Alex-Electron/ZX_BulbuLator/README.md

# ZX BulbuLator

Languages: **English** · [Русский](README.ru.md)

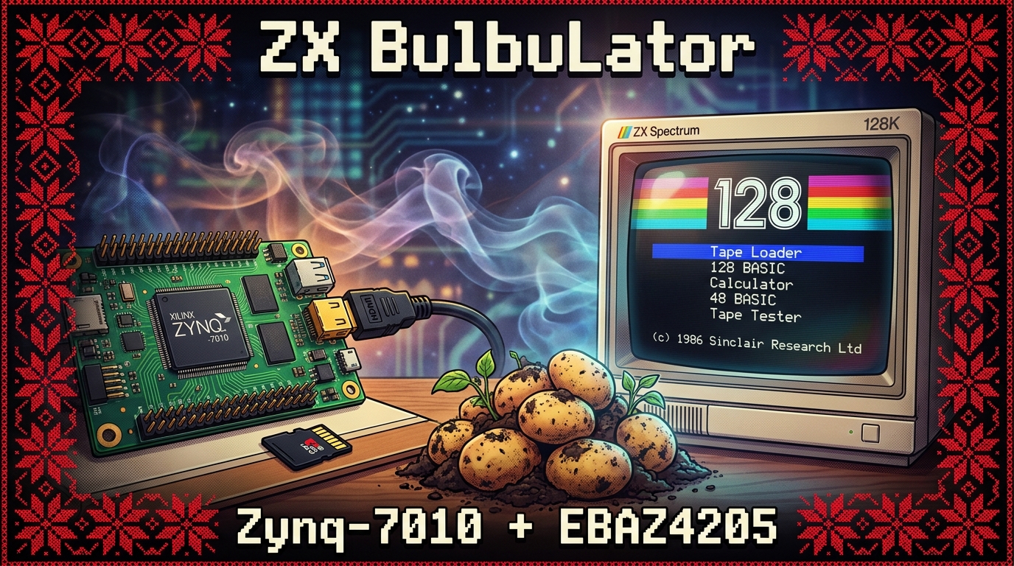
[picture p1: docs/images/splash.jpg]
ZX BulbuLator — ZX Spectrum on Zynq-7010 (EBAZ4205)


Developed by: Alexander Lavrinovich<br>
GitHub: https://github.com/Alex-Electron<br>
Email: lavrinovich.alex@gmail.com<br>
Co-author: AI<br>
Russian translation: DeepL<br>
Telegram: https://t.me/zx_bulbulator

If you've enjoyed the project, it would be really nice of you to buy me a cup of coffee:

 

A hardware ZX Spectrum emulator on a Xilinx Zynq SoC: bring up an open ZX Spectrum
core on the cheap, easy-to-find EBAZ4205 board, reworking it for the Xilinx
architecture along the way. All three Spectrum machines run on the open **Atlas `zx`**
core, reworked here; that is the core this project brings to perfection.

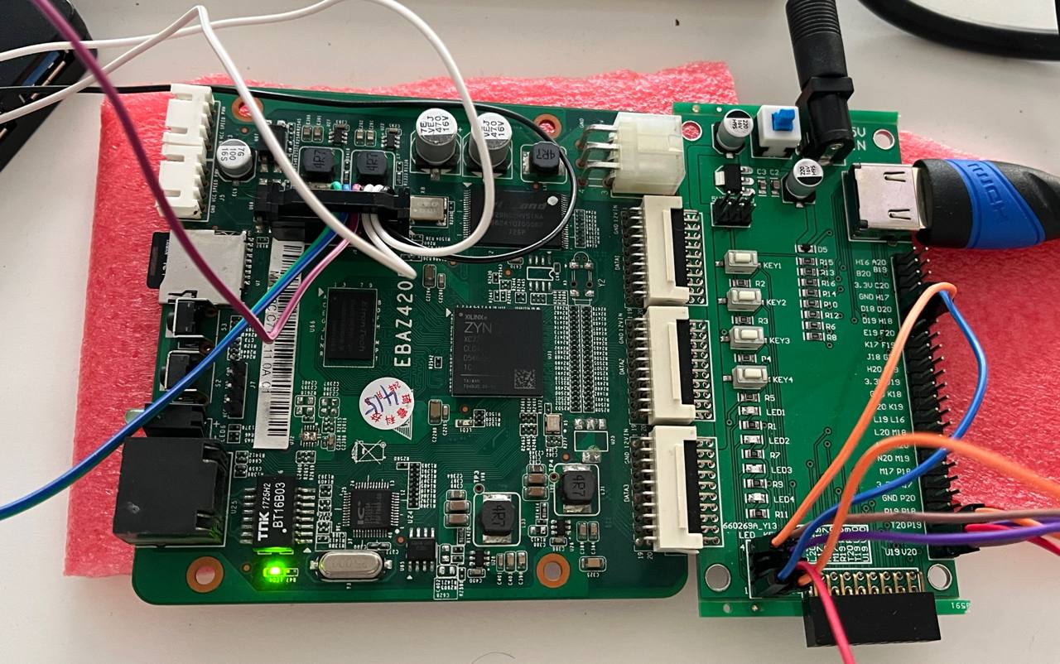
[picture p2: docs/images/board.jpg]
EBAZ4205 board wired to the HDMI/audio and buttons expansion shield


*The EBAZ4205 (Zynq-7010) next to the HDMI / audio + buttons shield, powered up
and running.*

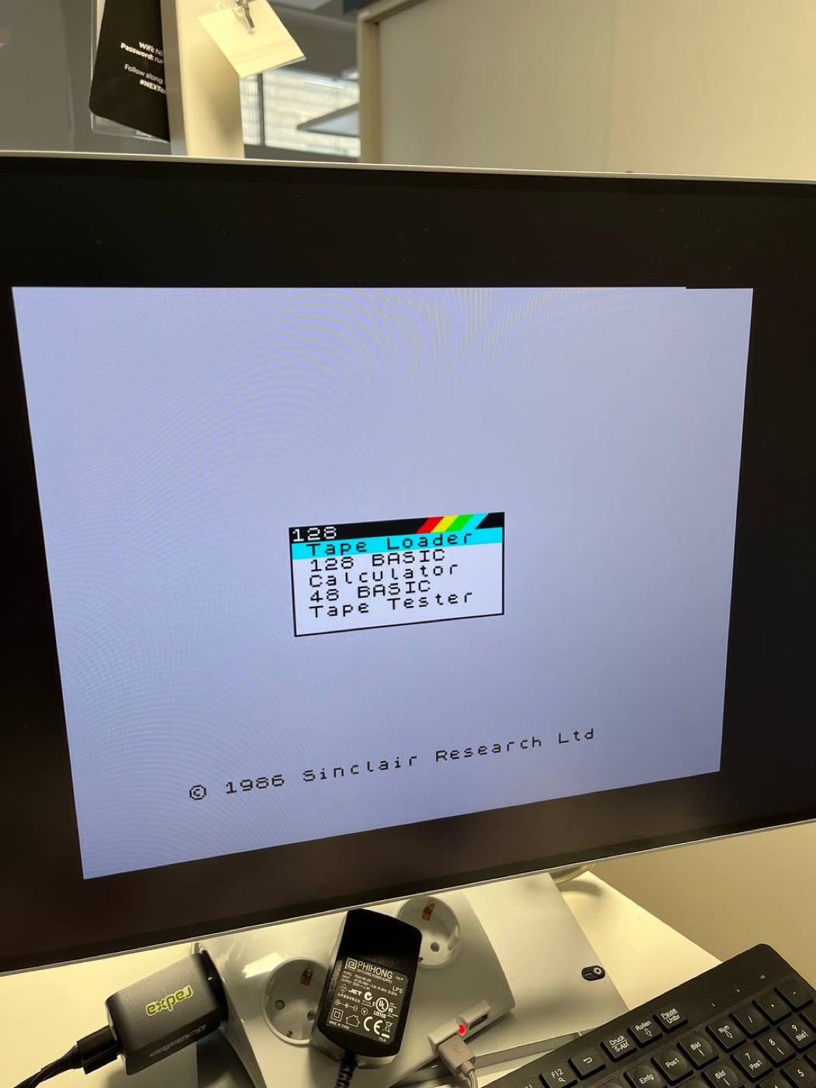
[picture p3: docs/images/spectrum-128-menu.jpg]
The ZX Spectrum 128 boot menu running on the board over HDMI


*And here it is working — the genuine © 1986 Sinclair ZX Spectrum 128 boot menu
(Tape Loader / 128 BASIC / Calculator / 48 BASIC / Tape Tester) on the EBAZ4205 over
HDMI. The full build is [Step 6](research/06-zx-spectrum-128/).*

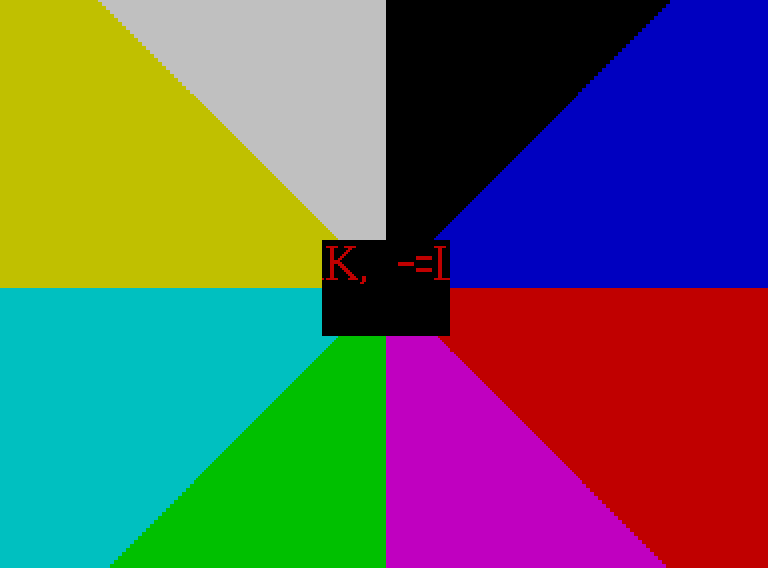
[picture p4: docs/images/demo-rage-pentagon.png]
The finale of the demo Rage on the Pentagon machine, read from the board's frame buffer


*The finale of the demo Rage on the Pentagon machine. The eight colour sectors run across the paper and the border alike, which makes this screen the check for the Pentagon's 2-pixel border step. The frame was read out of the board's frame buffer, not photographed off a monitor.*

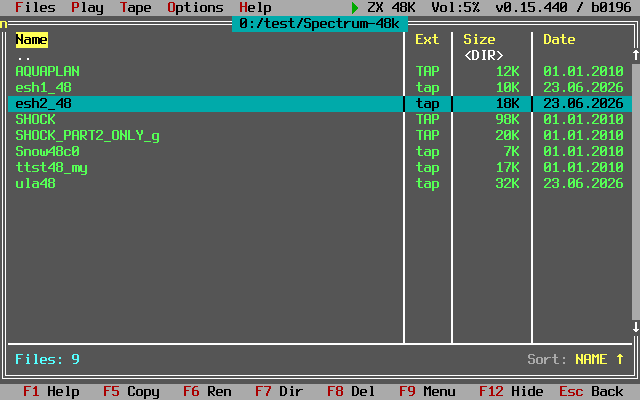
[picture p5: research/15-pentagon/images/nav-browser.png]
ZX BulbaNavigator, the file manager on the board


*ZX BulbaNavigator, the shell on the ARM side: a DOS Navigator-style file manager that loads tapes, snapshots, disk images and music from the SD card. More screenshots are in [Step 15](research/15-pentagon/).*

The biggest change from the original cores is memory. MiST drives an external
SDRAM controller; here the Spectrum's own 128 KB sits in on-chip BRAM wired straight
into the core, while the Pentagon's extended banks 8-63 live in the PS DDR3 and are
reached over AXI — which takes a lot of timing and routing pain off the table.

This repo is a working notebook and an idea record. It fills up as things get
checked on real hardware.

## Try it

You don't need to build anything to try it: the files are prebuilt in
[`research/15-pentagon/bitstreams/`](research/15-pentagon/bitstreams/). If you want to build it yourself,
the full instructions are in [`research/15-pentagon/BUILDING.md`](research/15-pentagon/BUILDING.md).

**Hardware.**

- An EBAZ4205 with the Zynq-7010, switched to boot from the microSD card. That takes one resistor, R2577.
  [Step 0](research/00-setup/) shows where it is and how to power the board (5 V or 12 V).
- HDMI and a PS/2 keyboard. The board has neither connector, so both are wired to FPGA pins; on mine they
  sit on a home-made shield. The pin map is in
  [`bulbulator_ddr.xdc`](research/15-pentagon/sources/bulbulator_ddr.xdc): HDMI TMDS on F19/F20 (clock),
  D19/D20, C20/B20 and B19/A20, PS/2 clock on G19 and data on H20. Sound goes out over HDMI.
- A microSD card formatted as FAT32.

**The card.** Only `BOOT.BIN` is required: without anything else the board boots with the ROM built into
the bitstream. The other files add machines and devices. Paths on the left are relative to
`research/15-pentagon/`.

| From the repo | To the card | What it is |
|---|---|---|
| `bitstreams/BOOT_B0200_v0.15.448.BIN` | `BOOT.BIN` | boot image: first-stage loader, ZX core and the shell firmware |
| `bitstreams/ATLAS_B0200.bit.bin` | `CORES/ATLAS.BIT.BIN` | the ZX core; the shell reloads it from here when you switch machines |
| `bitstreams/NES_CE29.bit.bin` | `CORES/NES.BIT.BIN` | NES / Dendy |
| `roms/*.ROM` | `ROMS/` | ROM sets, picked per machine with `ROM SET` |
| `roms/GS105B.ROM` | `GS/GS105B.ROM` | General Sound firmware |
| `roms/ESXMMC.ROM` | `ROMS/ESXMMC.ROM` | the DivMMC ROM; esxDOS also wants its own `SYS` and `BIN` folders from [esxdos.org](http://www.esxdos.org/) on the DivMMC card (the `DIVMMC/` folder or `DIVMMC.IMG`) |

Games, demos, disk images and music can go anywhere on the card. The full layout is in
[`docs/SDCARD.ru.md`](research/15-pentagon/docs/SDCARD.ru.md).

**First start.** Put the card in and power the board. The ZX Spectrum 128 comes up with the navigator
open over it. Pick a `.tap`, `.tzx`, `.z80`, `.sna`, `.trd`, `.scl` or a music file and press Enter.

| Key | What it does |
|---|---|
| `F12` | hide or show the navigator |
| `F9` | menu bar: machine, ROM, disks, display, tape, sound |
| `Enter` | open a folder, load a program, play music |
| `F5` / `F6` / `F7` / `F8` | copy / rename or move / make a folder / delete |
| `F10` | pause the machine |
| `F11` | hard reset, clears the RAM |
| `Ctrl+Alt+Del` | soft reset, keeps the RAM |
| `Ctrl+Alt+Ins` | NMI |
| `Num +` / `Num -` | volume |
| `Esc` | back or close |

Settings apply at once, but they reach the card only when you pick **Save config** in the menu.

## Target board

The board is the EBAZ4205 with the Zynq-7010 (`XC7Z010`), the most common version
of this board on the second-hand market. Everything here is built and tested
against it. There are also boards with a custom-soldered `XC7Z020` (more logic,
but pricier) — see [`docs/HARDWARE.md`](docs/HARDWARE.md) for details.

| | EBAZ4205 |
|---|---|
| SoC | Xilinx Zynq-7000 `XC7Z010` (`clg400`, built for the -1 speed grade) |
| Processor (PS) | dual-core ARM Cortex-A9, 666 MHz |
| FPGA fabric (PL) | Artix-7 class — 28K logic cells, 17,600 LUTs, 35,200 flip-flops, 80 DSP slices |
| Block RAM | 60 × 36 Kb = 2.1 Mb (~270 KB) on-chip |
| DDR3 (on the PS) | 256 MB |
| NAND flash | 128 MB |
| Ethernet | 10/100, IP101GA PHY |
| microSD | on-board slot — this project boots from it |
| Clocks | 33.33 MHz PS reference, 25 MHz for the Ethernet PHY; the PL runs at a 100 MHz fabric clock here |
| Power | 5–12 V |
| Factory boot | NAND; we strap it to boot from SD instead |

The memory layout is the interesting part on this board. The Spectrum's first 128 KB
lives in the on-chip Block RAM, which the current build all but fills (58.5 of 60
blocks), while the 256 MB DDR3 carries the Pentagon's extended banks and the
triple-buffered framebuffer the ARM and the video path share. The 7020 boards give
about three times the LUTs and flip-flops (53,200 LUTs, 220 DSP) but only a bit over
twice the Block RAM (140 blocks) — and Block RAM is the resource this design runs out
of first. The build still targets the 7010 everyone has.

## What works, and what is still planned

### Working on the board today

**Machines.** ZX Spectrum 48K, 128K and Pentagon 128–1024K on one core; NES/Dendy as a second platform on its own core. The two Sinclair machines are
measured rather than eyeballed — their timing suites pass in full (the 48K one with NEMO-IDE switched off, as on a real 48K: the card decodes ports loosely and answers the very ports the test probes). Pentagon's paging, ROM sets, disk
and its fine two-pixel border are all working and checked against reference screens, but its timing
acceptance has not been run yet.

**Sound.** Six sources, all of them audible: the beeper, AY-3-8912 / YM2149F, Turbo Sound (a second AY),
SAA1099 at exactly 8 MHz, SpecDrum, and **General Sound — a secondary Z80 with its own RAM and a
four-channel DAC, playing music**. Output goes out as HDMI audio, with a per-source peak meter, because
silence proves nothing. An external DAC is still on the wish list.

**Storage.** TR-DOS / Beta Disk through a WD1793 — reading, **writing** and `FORMAT` — with `.trd` and
`.scl` images; NEMO-IDE reading `.hdf` byte for byte; DivMMC / esxDOS as an image or a folder;
Z-Controller. Disk images can be browsed from the navigator.

**Input.** A PS/2 keyboard on two FPGA pins, the Kempston joystick, a Kempston mouse (including a
numeric-keypad mode for software that is mouse-only), and per-machine joystick mapping with a
button-capture wizard.

**Tape.** `.tap`, `.tzx`, `.wav` and `.mp3`. A standard 48K tape loads instantly: SMART LOAD doesn't play it at all, but reads the BASIC loader and CODE blocks from the file, builds the memory image and starts it like a snapshot. Anything else (turbo, custom loaders, 128K programs) plays as real pulses, at normal speed or 8×. On 128K and Pentagon, auto-start gets into loading through the 128 menu, `USR 0` or a locked 48 BASIC, whichever the program wants.

**Video.** HDMI 720p50 with per-machine integer upscale, per-side crop and pan, and optional CRT-style frame blending for demos that flip screens every frame.

### Planned

- **Real floppy drive** — routing the WD1793 signals out to GPIO through a 3.3 V → 5 V level shifter, so
  a physical drive can hang off the board. The part I most want to build.
- **ATM Turbo 2 and CP/M** ([Step 16](https://github.com/Alex-Electron/ZX_BulbuLator/issues/109)) — a new machine with an 80×25 text
  mode and RAM at `#0000`, so CP/M runs with a proper 80-column screen and Turbo Pascal runs on the board.
- **Networking** ([Step 17](https://github.com/Alex-Electron/ZX_BulbuLator/issues/82)) — a web remote panel with the live screen, keyboard
  and an SD file manager. The firmware side is written; this board's Ethernet hangs off FPGA pins rather
  than the processor's, so it needs a bitstream that routes the controller out to the PHY.
- **[ULAplus and the 64-colour palette](https://github.com/Alex-Electron/ZX_BulbuLator/issues/84)** —
  an exact optional replacement-ULA, isolated from the normal video path.
- **More machines** — C64 after the ATM Turbo 2.
- **More sound formats** — tracker and register-dump chiptunes, and the YM2203 of TurboSound-FM.
- **Sinclair Interface 2 and Sega / Dendy gamepads.**
- **Save states** — snapshots load today, but cannot yet be written back.

Where the references disagree with each other, the answer is a switch in the machine settings rather
than a decision made on your behalf: the SAA1099 gate on port `#FF`, the service ROM page under TR-DOS
and the port-contention phase are all switches for exactly that reason. What a Pentagon returns when
you *read* port `#FF` is next in line — the clones disagree, so it will become an option too.

The longer list, including the ideas pulled from MiST / MiSTer / TSConf (OSD
menu, save states, tape emulation, ROM switcher, soft-USB, fast-forward), is in
[`docs/CONCEPT.md`](docs/CONCEPT.md).

## Status

Where things stand right now:

The **ZX Spectrum 128 now runs on the board** ([Step 6](research/06-zx-spectrum-128/)):
the original 128 boot menu over 720p50 HDMI with sound, the four shield buttons
driving the menu, tape loading through an audio pin, and standalone SD boot — the
display checks out against ZEsarUX. It's built on the open-source Atlas `zx` core;
the dense bitstream loads over PCAP, since plain JTAG configuration trips a
`BAD_PACKET` bug on this setup. [Step 7](research/07-arm-control-plane/) then wakes up the
idle ARM with an AXI control plane — it can now **halt the Z80 and read/write the Spectrum's
memory live** (the ARM paints the screen while the CPU is frozen), the foundation for loading
games from SD. [Step 8](research/08-ddr-framebuffer/) then makes the video **tear-free** by
buffering the ZX frame in PS DDR — triple-buffered, swapped on the HDMI vblank — the first real
use of that AXI-HP path to DDR. [Step 9](research/09-ps2-keyboard/) adds a real PS/2 keyboard with
a normalised control-key map (reset / NMI, plus an Extended-mode key). [Step 10](research/10-osd-keyboard-gate/)
gives the ARM an **on-screen display over the live picture** and a **keyboard gate** — press `F1` for a
help menu while the Spectrum keeps running, `F12`/`Esc` to close. It's built machine-agnostic on purpose
(a scancode FIFO the ARM drains, a `MACHINE_ID` register), the MiSTer split where the fabric is the
machine and the ARM is the operator. [Step 11](research/11-file-browser/) builds that OSD menu out into
an SD file browser, an options menu that saves to the card, and an OSD panel you can move and fade.
[Step 12](research/12-snapshot-loader/) closes that loop: pick a `.z80` or `.sna` and the ARM cold-resets
the machine, streams the RAM in over the AXI back door, injects the whole Z80 register set, and lets the
core run from the snapshot's PC — the browser is now a real loader. [Step 13](research/13-music-player/)
adds a machine-agnostic music player and [Step 14](research/14-color-osd/) turns the OSD into a
true-colour DOS Navigator-style file manager.

[**Step 15**](research/15-pentagon/) is where the platform became a *family*: one core carries
**ZX Spectrum 48K, 128K and Pentagon 128–1024K**, and the two Sinclair machines were measured against the
real thing rather than eyeballed. Timing Tests pass in full on 48K (port tests included) and on 128K;
the Z80 passes `z80full`, `z80ccf` and `z80memptr`; contention, border timing and the interrupt
position match the hardware. Pentagon's timing acceptance is still to be run. Storage grew up — TR-DOS reads *and writes*, NEMO-IDE reads `.hdf` byte for byte, DivMMC /
esxDOS works — and General Sound plays music. Along the way four ROM dumps that have circulated for decades turned out to be corrupted — 18 bytes
rotted out of a TR-DOS page, one of which silently killed directory writes — and the sets here are
repaired, with every byte of the repair documented. Prebuilt cores ship in
[`research/15-pentagon/bitstreams/`](research/15-pentagon/bitstreams/) and the ROM sets, with full
provenance, in [`research/15-pentagon/roms/`](research/15-pentagon/roms/).

Step 15 also closed four tracker issues: [#43](https://github.com/Alex-Electron/ZX_BulbuLator/issues/43) (Pentagon 128/256/1024), [#52](https://github.com/Alex-Electron/ZX_BulbuLator/issues/52) (TR-DOS / Beta Disk), [#53](https://github.com/Alex-Electron/ZX_BulbuLator/issues/53) (esxDOS through DivMMC, `.hdf` through NEMO-IDE) and the umbrella [#51](https://github.com/Alex-Electron/ZX_BulbuLator/issues/51) (virtual disks). What's still open for the Pentagon is collected in [#96](https://github.com/Alex-Electron/ZX_BulbuLator/issues/96).

Next: **Step 16** is a new machine, the ATM Turbo 2. It has what CP/M needs and a plain Spectrum
lacks: RAM at `#0000` and an 80×25 text mode, so CP/M gets a real 80-column screen and Turbo Pascal
runs on the board. It will be a separate core, loaded from the SD card like the NES one.
**Step 17** is the network: a web remote panel with the live screen, keyboard and an SD file
manager in a browser. The firmware side already exists; the obstacle is physical, since this
board's Ethernet hangs off FPGA pins rather than the processor's, so it needs a bitstream that routes
the controller out to the PHY.

## Learning the board

I'm figuring this board out as I go — Zynq, the EBAZ4205, and FPGA work in
general are new ground for me — so this repo doubles as a lab notebook. Instead
of dropping a finished emulator, the plan is to bring the board up one small,
verified experiment at a time and write down what actually happened, dead ends
included. When something only works after three tries, that's the part worth
recording.

Each step is self-contained: sources, a ready-to-flash bitstream, and notes on
what it proves and what tripped me up. They live in [`research/`](research/).

So far:

- **[Step 0 — Setup & wiring](research/00-setup/).** Starting from a bare board:
  power, the SD boot-mode strap, hooking up a JTAG programmer (a normal cable or
  a Raspberry Pi Pico), installing Vivado, and flashing a bitstream — enough for
  someone with no FPGA background to get to a blinking LED.
- **[Step 1 — LED blink](research/01-board-bringup-blink/).** The smallest "is
  this board even alive" test: a counter on the chip's internal oscillator
  blinking two LEDs in anti-phase. It proved that power, JTAG, and PL
  configuration all work. Along the way I learned that dense bitstreams only
  flash cleanly with the patched ("soft edges") Pico firmware, and that a design
  clocked from the PS stays dark until FCLK0 is brought up over JTAG — which is
  exactly why the blink runs off the internal oscillator instead.
- **[Step 2 — Buttons drive the LEDs](research/02-buttons-and-leds/).** Adds
  input: the four shield buttons freeze the blink, force the LEDs on or off, or
  speed them up. Small lessons in active-low inputs, two-flop synchronizers, and
  gating a counter.
- **[Step 3 — Primitive HDMI: colour bars](research/03-hdmi-bars/).** First
  picture on the screen — eight 720p colour bars. The first design that needs the
  PS for a clean pixel clock, and the one where I learned FCLK0 only reaches the
  fabric after `ps7_post_config` enables the PS→PL level shifters.
- **[Step 4 — HDMI with button-switched patterns](research/04-hdmi-buttons/).** A
  bouncing square plus colour bars, gradient, and checkerboard, switched live with
  the four shield buttons.
- **[Step 5 — HDMI audio: the square beeps](research/05-hdmi-beep/).** First sound:
  the bouncing square plays a beep over HDMI audio every time it hits a wall,
  using the open-source hdl-util/hdmi core for the TMDS and audio packets.
- **[Step 6 — A ZX Spectrum 128](research/06-zx-spectrum-128/).** It all comes
  together: a real ZX Spectrum 128 on the board, built on the open-source Atlas
  `zx` core — 720p50 HDMI video and sound, the four shield buttons drive the boot
  menu, it loads games from tape through a pin, and it boots from SD on its own.
  The hard-won lessons are in the notes: an inverted keyboard `make` bit that made
  the menu run in circles, floating buttons that needed pull-ups, the original
  128 ROM (with Tape Tester) vs the +2 one, and a dense bitstream that only
  configures over PCAP, not plain JTAG.
- **[Step 7 — Waking up the ARM](research/07-arm-control-plane/).** The other half of
  the chip — the ARM — sat idle through Step 6. This adds an AXI register interface so the
  PS can **halt the Z80 and read/write the Spectrum's memory live**. Two milestones on
  hardware: the bare-metal AXI handshake (built and proven *first*, before integrating), then
  the ARM freezing the Z80 and painting its screen straight over the bus. It's the
  [speccy2010](https://github.com/mborik/speccy2010) blueprint on Zynq, and the foundation for
  loading games from SD. The bitstream is a clean superset of Step 6 — nothing regressed.
- **[Step 8 — Tear-free video](research/08-ddr-framebuffer/).** The single on-chip framebuffer
  tore on border-effect demos — the Spectrum's ~50.02 Hz and HDMI's 50.000 Hz aren't locked, so
  the read pointer drifts through the write pointer. This buffers the whole 51 KB ZX frame in PS
  DDR — a MiSTer-style triple buffer — and swaps the scanout only on the HDMI vblank, so the
  picture is tear-free everywhere, including bank-5/bank-7 shadow-screen flips. It's the first
  real use of the Step-7 AXI-HP path to PS DDR, and on-chip BRAM stays 60/60.
- **[Step 9 — A real PS/2 keyboard](research/09-ps2-keyboard/).** A PS/2 keyboard on two pins,
  muxed with the four buttons — the Atlas core already had the receiver and the matrix decoder,
  the buttons just faked the key-taps. Plus a normalised control-key map: `F11` = hard/cold reset
  (wipes RAM), `Ctrl+Alt+Del` = soft reset, `Ctrl+Alt+Ins` = NMI, plus Alt as a one-key Extended-mode shortcut.
  The lesson worth keeping: a
  reset must not reset the DDR video pipeline — an AXI-HP master reset mid-burst hangs and freezes
  the picture. The on-screen menu landed in Step 10, the file browser in Step 11, and the SD snapshot loader in Step 12.
- **[Step 10 — On-screen display + the keyboard gate](research/10-osd-keyboard-gate/).** The ARM
  finally has a voice: it draws a 1-bpp OSD panel over the live picture — a combinational mux on the
  pixel path, so the Z80 never stops — and takes the keyboard the moment the menu opens (`F1` for
  help, `F12`/`Esc` to close). The clever part is what's *not* there: the fabric decodes no function
  key. Every scancode is tapped into a clock-crossing FIFO the ARM drains, and a `MACHINE_ID`
  register tells it which core is loaded, so the same OSD and keyboard gate are meant to sit in front
  of a future NES or C64 core unchanged. A fabric deadman timer hands the keyboard back if the ARM
  ever stalls. This is the MiSTer division of labour: the fabric is the machine, the ARM is the operator.

- **[Step 11 — A file browser and a settings menu](research/11-file-browser/).** The ARM gets the SD
  card and somewhere to keep its settings. **F5** opens a file browser that reads the FAT card and walks
  its folders (sort, a scrollbar, long names that scroll); **F9** opens an options menu whose changes
  apply live and save to a `bulbulator.ini` on the card — the first time the project writes to the card
  at all. The OSD panel learned to **move and fade** from that menu, and under the hood the framebuffer
  moved off a BRAM copy to a per-line DDR reader, freeing about a dozen BRAM tiles for the colour panel
  to come. The honest gaps: the browser navigates but didn't yet load the file you pick (Step 12 closes that),
  and the ARM app now needs the SD stack (FatFs/xsdps), so it ships prebuilt while the clean-clone build
  catches up.

- **[Step 12 — Loading a snapshot](research/12-snapshot-loader/).** The browser becomes a loader. Press
  **Enter** on a `.z80` or `.sna` and the ARM parses it, cold-resets and wipes the machine, streams the
  RAM image into the core's memory over the Step-7 AXI back door, injects the whole Z80 register file into
  the T80 in one shot (a 212-bit DIRSet vector), and releases it to run from the snapshot's PC. Two things
  made it more than "write the bytes and go": every load resets+wipes first — through the same FSM as the
  F11 hard reset — so nothing leaks from the last program (no stale pages, no carried-over AY squeal), and
  the SD path is hardened to never trust the card, since the EBAZ has no card-detect line (one strike and
  it drops the volume, an **EJECT** in F9, trimmed `xsdps` timeouts). It handles `.z80` v1/v2/v3 and
  `.sna`, 48K and 128K; the format and loader detail is its own document,
  [`docs/LOADER_SPEC.md`](docs/LOADER_SPEC.md). The honest gaps: AY/TurboSound state isn't restored yet,
  only the standard 48K/128K bank maps, and the ARM app still ships prebuilt while the SD stack gets
  vendored. (`VERSION 0xB01B0009`.)
- **[Step 13 — Player: Universal ARM music synthesis over HDMI](research/13-music-player/).** A machine-agnostic 
  retro music player built into the ARM control plane. Press **Enter** on a `.psg` file in the F5 browser to play
  it over HDMI, while the ZX Spectrum core runs in the background. Uses the AYUMI soft-synth library. Requires D-Cache 
  (enabled via a custom `lscript.ld` for the Cortex-A9) for real-time 47996 Hz playback without audio underruns. 
  Audio is pushed via AXI to a new hardware FIFO in the PL, replacing the fabric audio when active.
- **[Step 14 — Colour OSD & the ZX-BulboNavigator](research/14-color-osd/).** The 1-bpp strip becomes a
  true-colour, 80×25 DOS Navigator-style file manager running on the idle ARM, over the live core: a
  browser with sort and mask-select, a full Copy/Move dialog, a machine-agnostic tape station
  (`.tap`/`.tzx`/`.wav`/`.mp3`, with a hardware tape-head reader model), the music player folded in
  (PSG/MP3/WAV, play modes, non-blocking pause), and a data-driven menu whose settings persist to
  `bulbulator.ini`.

- **[Step 15 — the Spectrum machine family, measured against the real thing](research/15-pentagon/).**
  One core carries ZX Spectrum 48K, 128K and Pentagon 128–1024K; NES/Dendy runs as a separate core. The point
  of this step is that acceptance is by numbers: Timing Tests pass in full on 48K and 128K, the Z80
  passes `z80full` / `z80ccf` / `z80memptr`, the captured frame is 384 real pixels with 64/64 borders,
  and Pentagon's border steps by 2 pixels like the real machine. Storage (TR-DOS read **and write**,
  NEMO-IDE, DivMMC/esxDOS, Z-Controller), six sound sources including a General Sound that plays music,
  and a tape station that no longer fools a demo's own 48K/128K detector. Ships with prebuilt cores and
  documented ROM sets.
- **Step 16 — ATM Turbo 2 and CP/M (planned).** A new machine for CP/M with 80-column text: the ATM
  paging with RAM at `#0000`, its 80×25 text, 640×200 and 320×200 modes, and the 7 MHz turbo. Tracked in
  [#109](https://github.com/Alex-Electron/ZX_BulbuLator/issues/109).
- **Step 17 — the network (planned).** A web remote panel for the board: live screen, keyboard and an SD
  file manager in a browser. The firmware side is written; what is missing is a bitstream that routes
  the Ethernet controller out to this board's PHY pins, because the Ethernet is wired to the FPGA rather
  than to the processor.

More steps get added as I get them working.

## Changelog
- **2026-09-25 — Pentagon checked against the real machine: core B0200, firmware v0.15.448.** The Pentagon finally has an automatic test. [PENTTEST](research/15-pentagon/tools/penttest/) is a self-checking tape in the spirit of the 48K Timing Tests, built on Jan Bobrowski's timing code: frame length, `EI`, INT length, the IM2 vector, port `#FF`, RAM size and the absence of contention in every bank. It passes 9 of 9. Two raster tapes step Bobrowski's stime and btime through T-states on their own, and a host script reads the results from frame snapshots. They agree with a real Pentagon to within half a T-state: btime 17762 (real 17762–17763), stime 17984 visible and 17985 not (the real machine flickers at 17984). Where the references disagree, the machine now has options instead of one hard-coded answer. *Pentagon INT length* is 36 T by default (Fuse, ZEsarUX), with 32 T (Sizif-512, MiSTer, Unreal) and 44 T (measured on a real board). *Port #FF read* returns `#FF` by default, like a stock Pentagon, or the current attribute like Sizif-512 and modified boards, for Sinclair games that sync on the floating bus. A frame counter tape also measured the CPU clock at 3.5416 MHz on every machine, about 1 % faster than a real 48K or Pentagon.

- **2026-09-24 — firmware v0.15.446.** *Load via (128K) = 48 LOCK* now really locks paging on the Pentagon. On a Pentagon 1024, bit 5 of `#7FFD` is a lock only in the standard 128K mode (`#EFF7` bit 2); after reset the machine is in 1024 mode, where the same bit selects a memory bank. Auto-start now switches to standard mode first and then locks, as the real machine does.

- **2026-09-24 — Step 15: frame blend, core B0198, firmware v0.15.445.** Demos that flip between the two screens every frame (the rotating shadow in Eklhaft SP2, gigascreen pictures) blend into a steady image on a CRT but flicker at 25 Hz on an LCD. *Display → Frame blend* now shows the average of the machine's last two frames on HDMI: OFF, AUTO (the default: on only while the machine flips screens almost every frame, so games and loading stripes stay sharp) or ON. The frame buffer grew from three to five, so the pair is always two consecutive machine frames, even when the 50.02 Hz machine gets a frame ahead of the 50.00 Hz HDMI. The machine and its timing are untouched: with blending off the output is pixel for pixel what it was, and Timing Tests pass 3/3 on 48K and 68/68 on 128K.

- **2026-09-23 — Step 15, firmware v0.15.444.** Switching machines in the menu now applies the new machine's own NEMO-IDE, General Sound and mouse settings. Before, they stayed as the previous machine had left them: 48K, 128K and Pentagon share one core, the switch doesn't reload the FPGA, and those three devices keep their own registers. The same hunt explained the Timing Tests 48K failures in tests 35-37. The 48K machine had NEMO-IDE switched on, and like the original card it decodes ports loosely (A1 = A2 = 0 is enough), so it answers a quarter of all ports, exactly the ones those tests read the floating bus through. With it off, the test passes three runs out of three. Tape speed is now NORMAL or FAST 8x; the 4x mode is gone, since everything loads at 8x. A new *Load via (128K)* option picks how auto-start gets into loading on 128K and Pentagon: the 128 menu, `USR 0` (48 BASIC with paging left open, for 128K demos that insist on `LOAD ""` from 48 BASIC) or a locked 48 BASIC. The copy dialog moves focus to OK once you pick a folder in the tree, and the menu calls the Pentagon just *PENTAGON*, because its memory size is a setting.

- **2026-09-18 — Step 15: the Spectrum machine family, measured against the real thing.** One core for
  ZX Spectrum 48K / 128K / Pentagon 1024. Timing Tests pass in full on 48K (ports included) and on 128K;
  `z80full` 152/152, `z80ccf` 152/152, `z80full 1.2a` 160/160, `z80memptr` all passed. Native capture
  geometry (384 real pixels, 64/64 borders) on both 48K and 128K, per-machine interrupt position,
  Pentagon's 2-pixel border step, and a frame tag that closed the top-edge artefact. Tape playback and
  CPU warp became separate permissions. Storage: TR-DOS read/write/FORMAT, NEMO-IDE byte-exact `.hdf`,
  DivMMC/esxDOS, Z-Controller. Sound: SAA1099 (which had been a stub in the bitstream) at exactly 8 MHz,
  TurboSound, SpecDrum, and General Sound playing music. The shell gained a window framework, per-side
  crop separated from pan, and a data-driven settings tree. Ships prebuilt cores
  (`research/15-pentagon/bitstreams/`) and the ROM sets with full provenance
  (`research/15-pentagon/roms/`). Core `0xB01B0196`, firmware v0.15.440.

- **2026-07-10 — Step 15 starts in dedicated tree.** All new work for multi-machine support (Pentagon first) moves to `research/15-pentagon/`. Development, builds and commits for v0.15.01+ are only in the step-15 folder. 14-color-osd is frozen.

- **2026-07-08 — Step 14: colour OSD & the ZX-BulboNavigator.** The 1-bpp strip is replaced by a true-colour 640×400 ARGB8888 DDR OSD (`osd_ddr_rd` over AXI-HP1 + a per-pixel alpha compositor), hosting a full DOS Navigator-style file manager on the idle ARM: a browser with `Ctrl+F3-6` sort, mask select, a 78×15 Copy/Move dialog (six conflict modes), rename / mkdir / recursive delete; a data-driven menu bar with options saved to `bulbulator.ini`; a machine-agnostic tape station (`.tap`/`.tzx`/`.wav`/`.mp3` with a hardware tape-head reader model, MP3/WAV-as-tape, Tape Sound, Mute-machine-on-load); the music player folded in (PSG/MP3/WAV, play modes, non-blocking pause, MP3 preload); a pause bitmask, boot-nav, and a transparent PAUSE sign. A clean clone reproduces the bitstream — the PS/2 watchdog patch is vendored in `third_party/atlas-zx-ps2-watchdog/` and overlaid at build time. (control-plane VERSION `0xB01B0017`, firmware v0.14.92).

- **2026-06-30 — Step 13: Universal ARM music player.** A machine-agnostic music player built into the ARM control plane. Press **Enter** on a `.psg` file in the F5 browser to play it over HDMI, while the ZX Spectrum core runs in the background. Uses the AYUMI soft-synth library. Requires D-Cache (enabled via custom `lscript.ld` for the Cortex-A9) for real-time 47996 Hz playback without audio underruns. Audio is pushed via AXI to a new hardware FIFO in the PL, replacing the fabric audio when active. (control-plane VERSION `0xB01B000B`).

- **2026-06-27 — Step 12: loading a snapshot.** The file browser becomes a loader: press **Enter** on a
  `.z80` or `.sna` and the ARM parses it, cold-resets and wipes the machine, streams the RAM in over the
  Step-7 AXI back door, injects the whole Z80 register file into the T80 in one shot (a 212-bit DIRSet
  vector), and runs from the snapshot's PC. Every load resets+wipes first — the same FSM as the F11 hard
  reset, on a new `CONTROL` bit 2 / `STATUS` bit 2 — so nothing leaks from the last program, and the SD
  path is hardened for a board with no card-detect (one-strike unmount, an **EJECT** in F9, trimmed
  `xsdps` timeouts). Handles `.z80` v1/v2/v3 and `.sna`, 48K and 128K; format reference in
  [`docs/LOADER_SPEC.md`](docs/LOADER_SPEC.md). Verified on hardware on the Atlas `zx` core (control-plane
  VERSION `0xB01B0009`). Not yet: AY state restore, non-standard bank maps, cycle-exact resume.
- **2026-06-25 — Step 11: a file browser and a settings menu.** The ARM gets the SD card: **F5**
  browses the FAT card (navigate, sort, scrollbar, long-name scroll), **F9** opens a data-driven options
  menu that applies live and saves to `bulbulator.ini` — the project's first write to the card. The OSD
  panel can now be moved and faded from that menu (new `OSD_POS` / `OSD_OP` registers, VERSION
  `0xB01B0008`), and the framebuffer moved to a per-line DDR reader, freeing about a dozen BRAM tiles.
  Verified on hardware on the Atlas `zx` core. The browser doesn't yet load the file you pick — that's Step 12.
- **2026-06-22 — Step 10: on-screen display + the keyboard gate.** The ARM draws a 1-bpp OSD over
  the live 720p picture without halting the Z80 (overlay, not halt), and a keyboard gate diverts the
  PS/2 keys to the ARM while the menu is open — `F1` opens a help / key-map page, `F12`/`Esc` close it.
  Built machine-agnostic on purpose: an always-tap scancode FIFO, the OSD compositor and a
  `MACHINE_ID` register, so the same control plane fits a future NES/C64 core; a fabric deadman frees
  the keyboard if the ARM stalls. Verified on hardware (control-plane VERSION `0xB01B0006`). Next: the
  navigable OSD file browser (Step 11) and the SD snapshot loader (Step 12).
- **2026-06-18 — Step 9: a real PS/2 keyboard.** A PS/2 keyboard on two pins, muxed with the four
  buttons (the Atlas core already shipped `ps2.v` + `keyboard.v`); a normalised key map — `F11`
  hard/cold reset with a RAM wipe, `Ctrl+Alt+Del` soft, `Ctrl+Alt+Ins` NMI, plus Alt for the Spectrum's Extended mode — and an SD-bootable
  image. The OSD menu (Step 10), file browser (Step 11) and SD snapshot loader (Step 12) are the next chapters.
- **2026-06-17 — Step 8: tear-free DDR framebuffer.** The ZX frame is triple-buffered in PS DDR
  over AXI-HP and swapped only on the HDMI vblank — no more tear seam on border demos or
  shadow-screen flips. Verified with the `ula128` timing test and the *Mescaline* / `esh2`
  border demos; on-chip BRAM unchanged at 60/60.
- **2026-06-16 — Step 7: waking up the ARM.** An AXI PS↔PL control plane — the ARM can now
  halt the Z80 and write the Spectrum's memory, proven live on HDMI (the ARM paints the
  screen while the CPU is frozen). The bare-metal handshake first, then halt + screen-poke.
  Zero edits to the Atlas core; the foundation for SD game loading.
- **2026-06-16 — Step 6: a ZX Spectrum 128.** The first real machine on the board —
  128 boot menu, 720p50 HDMI video + sound, the buttons driving the menu, tape
  loading through a pin, and standalone SD boot, on the Atlas `zx` core.
- **2026-06-15 — Steps 0–5: board bring-up.** Setup & wiring, LED blink, buttons,
  HDMI colour bars, button-switched patterns, and HDMI audio — the runway the
  Spectrum sits on.
- **2026-06-15 — Project start.** Idea recorded; targeting the EBAZ4205 (Zynq-7010).

## License

[GPL-2.0-or-later](LICENSE) © 2026 Alexander Lavrinovich

BulbuLator is free software under the GNU General Public License, version 2 or (at
your option) any later version. You may use, study, build, flash, modify and
redistribute it; if you distribute a modified version or a device based on it, keep
the source open under the GPL and credit the authors. For plain use and tinkering,
nothing is restricted.

It is GPL because it builds on GPL FPGA cores — the multi-board ZX 48K/128K core
(theexperimentgroup / UnAmigaReloaded, [Atlas `zx`](https://github.com/AtlasFPGA/zx)),
which bundles the JT49 AY core by Jose Tejada (GPL-3.0-or-later); linking JT49 makes
any distributed bitstream effectively GPL-3.0-or-later. Other components keep their own permissive
licences — [hdl-util/hdmi](https://github.com/hdl-util/hdmi) (Apache-2.0/MIT), AYUMI
(MIT), minimp3 (CC0), speexdsp (BSD). Full per-component attribution is in
[THIRD_PARTY.md](THIRD_PARTY.md); the pinned upstream sources fetched by `get_deps.sh`
are the corresponding source for any prebuilt binaries shipped here.

The tape input uses the *Tape Load Reader* front-end circuit from the
[Murmulator](https://murmulator.ru/) project
([schematics](https://github.com/AlexEkb4ever/MURMULATOR_classical_scheme), GPL-3.0) — an
external hardware add-on wired to the board, credited and linked here, not redistributed.
