Alex-Electron/ZX_BulbuLator/research/15-pentagon/arm/z80emu/ВЕНДОРЕНО.md

# z80emu — вендоренная копия

Источник: https://github.com/anotherlin/z80emu, версия 1.1.3, Lin Ke-Fong.
Лицензия (из шапки `z80emu.c`): «This code is free, do whatever you want with it.»
Скачано 06.08.2026 для General Sound на ARM.

Почему именно он: проходит `zexdoc` и `zexall`, эмулирует неописанные особенности Z80, и специально
сделан компактным — вместо switch по всем опкодам они приводятся к «обобщённым» инструкциям, чтобы код
влезал в кэш инструкций. Для голого ARM это существенно.

**Что мы изменили:** `z80user.h` из поставки ЗАМЕНЁН нашей привязкой (`arm/gs_z80user.h`) — штатный
сделан под тест `zexdoc` на плоской памяти CP/M, а нам нужны страничная память и внутренние порты GS.
Остальные файлы не тронуты; апстрим прямо пишет, что менять `z80emu.c` не требуется.

Не вендорим: `testfiles/` (образы zexdoc/zexall для теста на хосте).
