Alex-Electron/ZX_BulbuLator/research/15-pentagon/README.ru.md

# Шаг 15 — семейство машин Спектрума: точность по приборам

Языки: [English](README.md) · **Русский**

Боевое состояние: ядро **B0200**, прошивка **v0.15.448**. Всё, что ниже, проверено на живой плате.

ZX-BulboNavigator: файловый менеджер с полноцветным интерфейсом в стиле DOS Navigator, работающий на управляющей плоскости ARM поверх живого экрана Spectrum

*ZX-BulboNavigator поверх работающего ядра ZX Spectrum 128K. Полноцветное текстовое OSD размером 80×25, полностью отрисовываемое простаивающим ядром ARM, содержит файловый менеджер в стиле DOS Navigator, универсальную кассетную станцию и музыкальный плеер. За наложением видно собственное меню Spectrum 128 — ядро продолжает работать; OSD его не останавливает.*

Шаг 15 — это переход от «одна машина работает» к «машин несколько, и каждая ведёт себя как настоящая».
Одно ядро несёт три машины Спектрума — **48K, 128K и Пентагон 1024**, — плюс отдельными ядрами идут
MiSTer-48 и NES/Денди. Оболочка над ними машино-независима: браузер, кассетная станция и проигрыватель
про Спектрум не знают ничего и говорят с машиной через стабильный протокол на шине AXI.

Главное отличие этого шага от предыдущих — **приёмка числами, а не впечатлением**. Почти каждый пункт
ниже закрыт измерением: набором тестов таймингов, побайтовым сличением с эталоном, счётчиком в регистре
или прогоном на стенде. Там, где эталоны расходятся между собой, решение вынесено переключателем в
настройки машины, а не выбрано за владельца.

## Как это выглядит

Все снимки ниже сняты с живой платы: холст оболочки читается прямо из памяти по JTAG, поэтому это
ровно то, что видно на экране, без фотографирования монитора.

Файловый менеджер БульбаНавигатора на живой плате

*Файловый менеджер поверх работающей машины. Сверху — меню и строка состояния с машиной, громкостью
и версией ядра, снизу — подсказки клавиш. Спектрум под этим наложением продолжает исполняться.*

Диалог копирования файлов

*Диалог копирования: шесть способов разрешить совпадение имён, проверка свободного места, режим
перемещения и проверка записи. Каждое окно сохраняет свой фон в стеке — иначе за ним остаются
артефакты, и это выяснилось тремя разными жалобами, у которых была одна причина.*

Меню настроек

*Настройки описаны данными, а не кодом, и разложены по разделам: машина, ПЗУ, контроллеры дисков,
экран, навигатор, звук и лаборатория таймингов ULA.*

Настройки машины

*Настройки машины. Спорное вынесено переключателями: гейт SAA1099 на порту `#FF`, объём и частота
карты General Sound, фаза таймингов ULA, снег, интерфейс Kempston. Каждая опция объясняет, когда её
трогать, — опция без такого объяснения хуже, чем её отсутствие.*

Лаборатория таймингов ULA

*Лаборатория таймингов ULA: одиннадцать ручек прямо в меню — окна контеншена памяти и ввода-вывода,
плавающая шина, режим, фаза и задержка бордюра, задержка бумаги, фаза ULA и прерывания, источник
прерывания. Ими и подбирались числа, которые потом закреплялись в ядре.*

Кассетная станция

*Кассетная станция: три механизма загрузки разведены и вынесены наружу отдельными переключателями —
умная загрузка, разгон и синхронный загрузчик, — плюс MP3 и WAV как кассета.*

## Что сделано

### Машины и их точность

- **Timing Tests 48K проходят целиком**, включая тесты портов 35/36/37: «All Tests Complete 100% Pass».
- **Timing Tests 128K — все 34 теста.** Набор кончается на 34-м: строка 1350 содержит `STOP`, а
  приглашение «choose test 1-35» унаследовано от версии для 48K и врёт.
- **Положение прерывания у машин разное** — 48K = 4, 128K = 6. Правка, сделанная по прибору 48K,
  уехала вместе с общим ядром и на 128K валила уже тест 4.
- **Контеншен сведён с настоящей машиной:** таблица памяти каноническая `6,5,4,3,2,1,0,0`, якорь 14336,
  окно контеншена портов возвращено в ноль, прежняя фаза оставлена переключателем.
- **Запись в бордюр применяется после контеншена, а не до** — так делает настоящая машина, и это
  убирает чёрточку 8×1 точки слева от бумаги на первой строке, которой на живом 48K нет.
- **Процессор доведён до настоящего Z80:** Q-флаг и флаги прерванной блочной команды. Прогон на плате:
  `z80full` 152/152, `z80ccf` 152/152, `z80full 1.2a` 160/160, `z80memptr` — все тесты пройдены.
- **Пентагон 1024** получил настоящую страничность мегабайта: банки 0..7 в памяти ПЛИС, 8..63 в DDR.
  Объём ОЗУ стал опцией — 128, 256, 512 или 1024 КБ.
- **Штатные ПЗУ настоящих пентагонов работают:** страница адресуется парой признаков, и заводские
  наборы входят в свой файловый менеджер. Магическая кнопка вставляет сервисную страницу по NMI и
  снимает её по `RETN`, как это делает Multiface.

### Кадр

- **Родная геометрия захвата:** 384 настоящих точки, бордюры 64 и 64 — на 48K и 128K по одной формуле.
  Раньше захват брал 336 точек и добивал строку, **размножая крайнюю точку** по 24 раза с каждой стороны.
- **Правый край бумаги закрыт пиксель в пиксель** с эталоном.
- **Тонкий бордюр Пентагона:** шаг края 2 точки вместо 8. Два эталона расходятся (2 и 1), но наблюдаемо
  это одно и то же: цвет меняет `OUT (#FE),A`, а она ложится только на границу такта процессора.
- **Верхняя кромка кадра закрыта.** Две предыдущие правки убирали ровно по половине полосы, потому что
  лечили следствие. Причина была в одном такте на смене кадра: снимок адреса строки считался из ещё
  старой базы, а метку получал уже новую. Метка была честная, врал адрес.

### Накопители

- **TR-DOS / Beta Disk:** чтение и **запись**, включая `FORMAT`. Шесть дефектов закрыты; седьмым
  оказался гнилой дамп ПЗУ, а не наш код. Дисковод ускорен: оборот 200 → 10 мс, темп байта 32 → 4.6 мкс.
- **NEMO-IDE:** машина читает `.hdf` **байт в байт**.
- **DivMMC / esxDOS:** образы и режим «папка»; `.mkdir` ускорен с 35 с до 2-3 с.
- **Z-Controller:** пять программ приняты; на карте собран рабочий софт под него.
- Работа с образами прямо из навигатора: просмотр каталога дискеты, создание пустой, сведения о карте.

### Звук

Шесть источников: бипер, AY/YM, TurboSound, SAA1099, SpecDrum и **General Sound, который играет
музыку**. SAA1099 при этом оказался **заглушкой в битстриме** — в список чтения попадали два файла с
одним именем модуля, и побеждал прочитанный позже. Чипу вернули ровно 8 МГц вместо 8.0952.

### Лента

`.tap`, `.tzx`, `.wav`, `.mp3`; мгновенная загрузка стандартной ленты 48K (SMART LOAD читает файл и запускает его как снэпшот), разгон до 8× с автоматическим
выбором момента, распознавание пилот-тона в MP3 и WAV. **Разрешение проигрывать ленту отделено от
разрешения ускорять процессор** — из-за их слияния вторая часть демки SHOCK меряла между блоками чужую
длительность кадра и уходила не в ту ветвь.

### Оболочка

Холст ARGB8888 640×400 как 80×25 знакомест, шрифт CP866. Файловый менеджер в стиле DOS Navigator,
кассетная станция, проигрыватель (PSG, WAV, MP3 через один пересчётчик на 47996 Гц), настройки,
описанные данными. Каркас окон, где **каждое окно сохраняет фон в стеке** — три разные жалобы
оказались одной причиной. Кроп по сторонам разведён с панорамой: кроп режет свой край, панорама двигает
окно вывода.

### Приборы

Отдельная работа, без которой остального бы не было: честный снимок одного кадра машины по JTAG,
пик-метр звука по источникам, счётчики читателя строк, пульт к плате с хоста, стенды в симуляторе и
независимый оракул. Плюс правило, оплаченное дважды: **прибор, который меняет поведение измеряемого,
обязан быть отключаемым** — диагностическая трасса звуковой карты сама рвала музыку.

## Что в этом каталоге

| Каталог | Что внутри |
|---|---|
| [`bitstreams/`](bitstreams/) | **готовые ядра и загрузочный образ** — собирать ничего не нужно, файлы кладутся на карту |
| [`roms/`](roms/) | **наборы ПЗУ**, на которых машина проверялась, и [происхождение каждого файла](roms/PROVENANCE.md): кто автор, откуда взято, что мы меняли |
| [`docs/`](docs/) | описания: [оболочка](docs/NAVIGATOR.ru.md), [машины и каждая правка с доказательством](docs/MACHINES.ru.md), [возможности эмуляции](docs/EMULATION.ru.md), [раскладка карты памяти](docs/SDCARD.ru.md), [сверка трекера с кодом](docs/ISSUES_AUDIT.ru.md) |
| `sources/` | RTL: ядра машин, плоскость управления, видеотракт, устройства |
| `arm/` | прошивка оболочки |
| `tools/` | приборы: снимок кадра, разбор экрана, пульт к плате, заливка на карту, тест таймингов Пентагона (`tools/penttest/`) |
| `sim/` | стенды в симуляторе и измерительные программы на Z80 |
| `flash/` | сборка загрузочного образа и заливка по JTAG |

Журнал сборок с разбором каждой правки — [`BUILD_HISTORY.md`](BUILD_HISTORY.md), текущее состояние и
приборные правила — [`HANDOVER_CURRENT.md`](HANDOVER_CURRENT.md).

## Как запустить

Положить на карту памяти файлы из [`bitstreams/`](bitstreams/) и набор ПЗУ из [`roms/`](roms/).
Куда именно — в [`docs/SDCARD.ru.md`](docs/SDCARD.ru.md); там же главная мина: **обновляя ядро ZX,
менять надо оба файла** — и `0:/CORES/ATLAS.BIT.BIN`, и `0:/BOOT.BIN`, потому что у трёх машин имя
ядра одно, а холодный старт поднимает битстрим из загрузочного образа.

## Что осталось открытым

- Приёмка **Пентагона** по таймингам не прогонялась — это единственная машина без прогнанного набора.
- Не прогонялись демки на 128K.
- Ядро **MiSTer-48** на карте отстало от общего верхнего модуля.
- Порт `#FF` у Пентагона: мы отдаём `0xFF`, один из живых эталонов отдаёт атрибут. Клоны расходятся
  между собой — значит это опция машины, а не решение за нас.
- Сеть упирается не в прошивку: **Ethernet этой платы висит на выводах ПЛИС**, и нужен битстрим,
  выводящий контроллер на ноги микросхемы PHY.

Полный разбор — в [сверке трекера с кодом](docs/ISSUES_AUDIT.ru.md).

---

## OSD-холст с полным цветом

Старая панель с разрешением 1 бит на пиксель заменена на **ARGB8888-холст размером 640×400 пикселей, организованный в виде ячеек размером 80×25 символов** с VGA-шрифтом 8×16. Используется шрифт CP866 (Terminus, OFL): ASCII, полный набор символов для рисования окон в DOS и кириллица, так что навигатор может рисовать аутентичные двухстрочные рамки и русский текст.

- Холст находится в **окне DDR, выровненном по 1 МБ и не подлежащем кэшированию** по адресу `0x0F800000` (внутри области `NC_BASE`, зарезервированной файлом `lscript.ld`). Поскольку окно при запуске помечено как некешируемое, записи ARM согласуются с фабрикой без очистки кэша для каждого кадра.
- Новый считыватель фабрики, **`osd_ddr_rd`**, передаёт данные с холста по **AXI-HP1** и отдаёт пиксели **`osd_compositor`**, который выполняет альфа-смешивание пикселей с потоком HDMI в реальном времени. Тени окон полупрозрачные (альфа `0x80`), тела диалоговых окон — непрозрачные, а яркость/прозрачность и положение всего слоя можно настроить в меню «Options».
- **`OSD_CTRL`, бит 1** включает цветной слой; **F8** переключает его, а **F12** показывает/скрывает навигатор.
- Золотое правило всего OSD: **только инкрементальная перерисовка.** Полная перерисовка экрана вызывает мерцание, поэтому перерисовываются только те строки, которые изменились (`dn_draw_file_row`); полная перерисовка происходит только при закрытии модального диалога.

## Файловый браузер BulboNavigator

Браузер очень похож на DOS Navigator. Колонки: **Имя / Расширение / Размер / Дата**; в заголовке выделяется активное поле сортировки и отображается стрелка направления вверх/вниз. В правой колонке рамки находится полоса прокрутки в стиле Turbo Vision (стрелки + пропорциональный ползунок). Папки можно оформлять с помощью скобок, значка или косой черты в конце, а курсор выделяет любую строку, которая не помещается целиком.

- **Сортировка** (горячие клавиши DOS Navigator): `Ctrl+F3` — по имени, `Ctrl+F4` — по расширению, `Ctrl+F5` — по размеру, `Ctrl+F6` — по дате. Повторное нажатие на то же поле меняет порядок на обратный. В диалоге `Files → Sort` те же поля + флажок «По убыванию».
- **Навигация**: стрелки, `PgUp`/`PgDn`, `Home`/`End` (переход к первой/последней записи), строка `..` перемещает вверх. `Enter` открывает папку или запускает файл в зависимости от расширения — снэпшот `.z80`/`.sna` (загрузчик из шага 12), кассету `.tap`/`.tzx`/`.wav`/`.mp3` или мелодию `.psg`/`.mp3`/`.wav`.
- **Маркировка группы**: клавиша `Insert` помечает запись (желтым) и перемещает курсор вниз. `Пробел` зарезервирован для паузы проигрывателя, поэтому больше не используется для маркировки.
- **Выбор группы по маске** (серые клавиши `+`/`-`/`*` в DOS Navigator, здесь на `Shift`+цифровая клавиатура, чтобы основные клавиши цифровой клавиатуры оставались свободными для регулировки громкости): `Shift+KP +` добавляет теги ко всем элементам, соответствующим маске, `Shift+KP -` снимает теги, `Shift+KP *` инвертирует выделение. Механизм масок представляет собой практичный поднабор DN — `*` и `?`, без учета регистра, списки с запятыми/точками с запятой (`*.tap,*.tzx`), начальный `-` для отрицания (`*.* -*.tmp`), а `*.*` также подходит к именам без расширений.

Клавиши теперь работают надёжно: главный цикл и все диалоговые окна читают данные из одной общей таблицы состояний клавиш, а линия PS/2 имеет сторожевой таймер, который пересинхронизируется при таймауте в середине байта. Старое поведение «неотзывчивые клавиши, для горячей клавиши нужно три попытки» исчезло.

## Работа с файлами и диалог «Копировать/Переместить»

Панель выполняет реальные операции на SD-карте (FatFs, длинные имена файлов до 255 символов, D-cache включён):

- **`F5` Копировать**, **`F6` Переименовать/Переместить** (в стиле Total Commander — поле заранее заполняется полным путём выбранного элемента; измени имя, чтобы переименовать, или папку, чтобы переместить), **`F7` MkDir** (создаёт целую цепочку каталогов), **`F8` / `Delete`** (рекурсивно, с двойным подтверждением для непустой папки).
- Полное **окно диалога «Копировать/Переместить»** в стиле DOS Navigator (78×15) заменяет старый однострочный запрос: поле целевого пути, группа переключателей для разрешения конфликтов с шестью режимами (**Перезаписать / Добавить / Возобновить / Пропустить / Обновить / Спросить**) и флажки опций (проверить свободное место, удалить исходный файл = превратить «Копировать» в «Переместить», проверить запись). Одно линейное кольцо табуляции, `Пробел` устанавливает переключатель или включает/выключает флажок, `Enter` = «ОК», `Esc` = «Отмена». `Спросить» открывает поддиалог для каждого файла.
- И `F5`, и `F6` подают данные в общий механизм разрешения путей в стиле `cp`: `0:/dir/file` — абсолютный путь, `/dir` — относительный по отношению к корню диска, простое имя попадает в текущую папку; конечный символ `/`, существующий каталог или группа из нескольких файлов означают «каталог, сохранить исходные имена», в остальных случаях последний компонент становится новым именем.

Каждое диалоговое окно полностью повторяет внешний вид DOS Navigator — серый фон, белая двойная рамка, чёрные поля ввода, зелёные кнопки, красные буквы горячих клавиш и полностью непрозрачный курсор (ничто с игрового экрана не просвечивает через модальное окно, и ничего с панели под ним — например, прокручивающееся длинное имя — тоже не просвечивает). Поля ввода используют стандартную раскладку клавиатуры США, так что ты можешь вводить пути, имена и маски напрямую (`Shift`+`8` даёт `*` и так далее).

## Панель меню и система настроек

Нажатие `F9` (или щелчок по зелёному заголовку) вызывает **панель меню** DOS Navigator: **Files · Play · Tape · Options · Help** (пункты на экране английские). Стрелки влево/вправо перемещают между верхними меню; `Enter`/стрелка вправо открывает выпадающее меню; у **Options** есть вложенное подменю **Settings**. Прямо в меню живут «динамические пункты» — параметры, у которых значение показано тут же в строке. Поведение продумано:

- **Стрелки «влево»/«вправо» позволяют настраивать числовые (диапазонные) параметры на месте** — громкость, затемнение OSD, положение окна, чувствительность MP3 — с мелким шагом, при этом ты не выходишь из меню.
- **Выбор (НЕТ/ДА, режим воспроизведения и т. д.) переключается только с помощью клавиш `Пробел` или `Enter`**; клавиши «Влево»/«Вправо» при выборе перемещают тебя между верхними меню, так что ты всегда можешь выйти из него.
- **Чувствительность MP3** имеет широкий диапазон (0–4096), поэтому вместо того, чтобы пролистывать его, клавиши `Пробел`/`Enter` открывают специальный **диалог ввода чисел с встроенным пояснением** того, за что отвечает этот параметр.

Все настройки сохраняются в файле **`0:/bulbulator.ini`**, который записывается при нажатии `Options → Save`. Среди них: скорость/задержка прокрутки, стиль папок, отображение скрытых файлов, режим воспроизведения, пауза при воспроизведении музыки, поведение при запуске, навигатор при загрузке, громкость, затемнение OSD и координаты окна (X/Y).

## Кассетная станция — независимый от платформы загрузчик PULSE

На шаге 14 добавляется настоящая кассетная станция. Она загружает **`.tap` / `.tzx`** (стандартные блоки ПЗУ и турбо-/пользовательские загрузчики), а также **оцифрованные кассетные записи в форматах `.wav` и `.mp3`** — именно над этим пришлось потрудиться больше всего.

Конструкция соответствует независимому от аппаратной платформы **классу PULSE** в контракте загрузчика. ARM хранит всю информацию о форматах и отправляет поток импульсов `{уровень, продолжительность в T-состояниях}` в асинхронный FIFO; модуль фабрики **`tape_player.v`** воспроизводит их, синхронизуясь по сигналу разрешения T-состояния самого процессора (`pe3M5_core`). Поэтому лента и процессор работают в **точной синхронизации** — пауза (HALT) останавливает их обоих, так что циклы синхронизации ROM, турбо-режима или пользовательского загрузчика измеряют импульсы точно так же, как если бы они поступали с настоящей ленты. Фабрика просто измеряет фронты; она понятия не имеет, что такое «пилотный сигнал».

- **Считыватель — это точная модель физической магнитной головки**, а не эквалайзер: разделительный конденсатор (мягкий фильтр верхних частот — снимает постоянное смещение, но пропускает каждый быстрый фронт), компаратор Шмитта с гистерезисом и субсэмпловая интерполяция пересечения нуля для точного тайминга турбо. Именно это и позволяет прочитать MP3-запись кассеты, снятую хоть на телефон.
- **Автоопределение пилота** решает, кассета это или музыка, сканируя начало записи на пилот-тон. **`MP3/WAV as tape`** принудительно включает кассетный путь — для турбо-рипов или обрезанного пилота, который детектор мог бы пропустить.
- При загрузке MP3 станция сначала **пропускает разминочный кадр декодера и сводит постоянную составляющую считывателя** ещё до первого импульса, так что пилот-тон начинается чисто — без щелчка в начале.
- **`Tape Sound`** включает/выключает звук загрузки (монитор ленты). **`Mute machine on load`** — отдельная опция: глушит *собственный* звук машины на время загрузки (ULA Спектрума воспроизводит сигнал EAR через свой бипер — так и на живой машине, но теперь это можно выключить), переводя аудио-мукс на плеер. **`MP3 sens`** настраивает гистерезис детектора фронтов.
- Маркер **`T`** появляется в строке состояния (там, где находится значок режима воспроизведения музыки), как только аудио распознается как кассета.
- Быстрая остановка (`Backspace`) **очищает FIFO импульсов**, поэтому немедленный перезапуск всегда начинается с начала файла, а не с оставшегося импульса.

## Музыкальный плеер

Плеер из шага 13 был интегрирован и расширен. Он воспроизводит **`.psg`** (AYUMI с программным синтезом AY-3-8910), **`.mp3`** (minimp3) и **`.wav`** (PCM), передискретизируя их до частоты HDMI 47996 Гц (speexdsp), а также передаёт PCM в аудио-FIFO через мультиплексор плеера (`AUDIO_CTRL`).

- **Неблокирующий кольцевой буфер** обеспечивает непрерывное воспроизведение музыки даже во время длительного копирования или удаления файлов.
- **Режимы воспроизведения** (`F2` или `Play → Mode`): FOLDER, FILE, FOLDER LOOP, FILE LOOP, RANDOM.
- **Неблокирующая пауза/возобновление** работает с битовой точностью (регистры AY, огибающая и LFSR шума сохраняются во время паузы — никаких щелчков). Функция **запуска с приостановкой** возвращает мультиплексор системе, сохраняя при этом позицию трека.
- **Предварительная загрузка MP3** (в меню «Воспроизведение») загружает весь файл в DDR, благодаря чему воспроизведение не прерывается при остановках из-за сборки мусора на SD-карте.
- **Громкость** регулируется в реальном времени с помощью клавиш `+`/`-` на цифровой клавиатуре (и в меню «Options»): коэффициент усиления 0..255 на выходе HDMI, отображается как `Vol:NN%` в верхней строке.
- **Строка состояния** (строка 22) показывает воспроизводимый трек с пиктограммой воспроизведения/паузы и текущим режимом воспроизведения; в верхней панели всегда отображается тип машины и зелёный/красный индикатор работы/паузы.

## Управление машиной и координация звука

- **Пауза** (`F10` / PS/2 Pause) замораживает Spectrum, не захватывая экран. Маска остановки (ручная пауза / остановка из-за музыки / заморозка на SD-операции) владеет тактами машины и снимается только вручную.
- **`Pause on music`** останавливает машину, пока играет музыка; **`On launch (music)`** выбирает MACHINE (приглушить музыку, звук машины слышен) или MUSIC (оставить музыку, машина без звука), когда программу запускают поверх играющей музыки; **`Boot nav`** выбирает, показывать ли навигатор при включении или машина стартует сразу (войти позже — `F12`).
- Большой прозрачный знак **PAUSE** (символ-полоска и слово одной высоты, в правом верхнем углу, на прозрачном фоне, без прямоугольника позади) появляется, когда машина заморожена — на отдельном баннер-слое.
- **`F11`** — это полный сброс машины; видеосигнал не зависит от сброса ядра.

## В OSD

Встроенная справка по клавише F1: полный список горячих клавиш ZX-BulboNavigator, с возможностью прокрутки, отображаемый поверх браузера

*Нажми F1, чтобы открыть справочник встроенных горячих клавиш.*

| Клавиша | Действие |
|---|---|
| `↑ ↓ ← →`, `PgUp`/`PgDn` | Перемещение по списку / настройка числового параметра в меню |
| `Home` / `End` | Переход к первой / последней записи |
| `Enter` | Открыть папку, запустить файл или подтвердить диалог |
| `Пробел` | Приостановить/возобновить воспроизведение (заморозить/разморозить загрузку кассеты); переключать значения в меню |
| `Insert` | Пометить запись (и перейти на строку ниже) |
| `Shift`+цифровая клавиатура `+` / `-` / `*` | Выбрать / отменить выбор по маске / инвертировать выбор |
| `Backspace` | Остановить проигрыватель / кассету |
| `F1` | Справка (прокручиваемый список горячих клавиш) |
| `F2` | Диалог режима воспроизведения |
| `Ctrl`+`F3…F6` | Сортировка по имени / расширению / размеру / дате (повтор — в обратном порядке) |
| `F5` | Копировать |
| `F6` | Переименовать / Переместить |
| `F7` | Создать папку |
| `F8` / `Delete` | Удалить (рекурсивно) |
| `F9` | Панель меню |
| `F10` / Пауза | Поставить машину на паузу |
| `F11` | Жесткий сброс машины |
| `F12` | Показать / скрыть навигатор |
| `Esc` | Назад / закрыть диалоговое окно |
| цифровая клавиатура `+` / `-` | Громкость |

## Регистры плоскости управления

Управляющая плоскость AXI прирастает регистрами полноцветного OSD и кассетной станции; версия фабрики поднимается до **`0xB01B0017`**:

| Адрес | Название | R/W | Значение |
|---|---|---|---|
| `0x00` | `VERSION` | R | `0xB01B0017` |
| `0x04` | `IJ_CTRL` | W | бит 0 = HALT (заморозка тактов машины) |
| `0x08` | `IJ_STAT` | R | бит 0 = HALT_ACK, бит 1 = RAM_BUSY |
| `0x48` | `OSD_CTRL` | W | бит 0 = включение OSD с разрешением 1 бит на пиксель, бит 1 = включение цветного OSD с DDR |
| `0x54` | `KBD_DATA` | R | `{break[9], empty[8], code[7:0]}`; чтение опустошает FIFO PS/2 |
| `0x5C` | `KBD_HB` | W | сигнал «deadman» (любая запись); шлюз перенаправляет нажатия клавиш на Z80, если ARM перестаёт реагировать |
| `0x60` | `MACHINE_ID` | R | идентификатор загруженного ядра |
| `0x6C` / `0x70` | `OSD_OP` / `OSD_POS` | W | непрозрачность / положение OSD (1 бит на пиксель) |
| `0x74` | `VOL` | W | коэффициент усиления громкости на выходе HDMI 0..255 |
| `0x78` | `AUDIO_CTRL` | W | бит 0 = 1 — мультиплексировать PCM с ARM-плеера на HDMI, 0 = аудио из фабрики/машины |
| `0x7C` / `0x80` | `AUDIO_FIFO` / `AUDIO_STAT` | W/R | отправка образца PCM `{R,L}` / флаги «пусто» и «заполнено» |
| `0x84`–`0x90` | `BANNER_*` | W | наложение независимого баннера состояния/PAUSE (включение / адрес / данные / позиция) |
| `0x94` | `OSD_DDR_BASE` | W | байтовый адрес DDR для цветового холста ARGB8888 |
| `0x98` | `DDR_OSD_POS` | W | положение цветного холста OSD (независимо от `OSD_POS`) |
| `0x9C` | `TAPE_CTRL` | W | бит 0 — воспроизведение, бит 1 — ear_mux, бит 2 — отключение звука |
| `0xA0` | `TAPE_FIFO` | W | добавление `{level[31], duration[23:0] в T-состояниях}` |
| `0xA4` | `TAPE_STATUS` | R | бит 0 = FIFO заполнен, бит 1 = воспроизведение |

## Сборка, прошивка, запуск

Готовые файлы лежат в [`bitstreams/`](bitstreams/); куда их класть на карту, написано в главном
[README](../../README.ru.md#как-попробовать). Чтобы собрать всё самостоятельно и поставить на плату, следуй инструкции
[`BUILDING.ru.md`](BUILDING.ru.md), проверенной целиком на чистом клоне. Вкратце, из корня репозитория:

```sh
./get_deps.sh                                              # third-party cores, pinned commits
research/15-pentagon/build.sh                              # ZX core -> sources/build/bulbulator_zx_loader.bit
research/15-pentagon/flash/bit2bin.sh <core.bit>           # .bit.bin for 0:/CORES/
research/15-pentagon/arm/bsp/make_bsp.sh                   # Vitis platform + BSPs (once)
research/15-pentagon/arm/build_loader.sh                   # ARM shell -> arm/loader.elf
research/15-pentagon/flash/mkboot_zx.sh <core.bit> BOOT.BIN
```

Ядро ZX и прошивка, собранные таким образом, совпадают с опубликованными байт в байт.

## Файлы

```
sources/osd_ddr_rd.v               DDR->HDMI true-colour OSD reader (AXI-HP1)
sources/osd_compositor.v           per-pixel alpha compositor + independent banner (transparent PAUSE)
sources/tape_player.v              machine-agnostic PULSE tape replay (T-state lock-step, FIFO drain-on-stop)
sources/bulbulator_zx_ddr_top.v    top level: shell + machine wiring (VERSION 0xB01B0200)
sources/axi_ctl.v                  control plane: DDR-OSD, tape, machine and video registers
arm/loader_main.c                  the ZX-BulboNavigator (browser, dialogs, menus, tape station, options)
arm/player.c                       universal music player (AY/PCM, mux, non-blocking ring)
arm/mp3dec.c                       shared MP3 source (music + tape), with whole-file RAM preload
arm/vga866.h                       CP866 VGA 8x16 font (ASCII + box-drawing + Cyrillic)
arm/lscript.ld                     linker script: D-cache + non-cacheable DDR canvas window
arm/loader.elf                     prebuilt ARM app (firmware tag v0.15.448)
BUILDING.md                        how to build everything from source and put it on the board
bitstreams/                        prebuilt cores and the boot image
arm/tv_ui.c                        declarative Turbo Vision / DOS Navigator window framework
arm/gs_arm.c                       General Sound: secondary Z80 card service
arm/divmmc_card.c                  DivMMC / esxDOS card and folder mode
arm/nes_rom.c                      NES cartridge parser
arm/rom_ident.c                    ROM set identification by page content
arm/net_kvm.c                      web remote panel (blocked on Ethernet pinout)
sources/atlas_core/video.v         machine video: frame geometry, blanking, border latch, INT position
sources/fb_line_disp.v             HDMI line reader with the frame tag (top-edge fix)
docs/NAVIGATOR.ru.md               shell: full feature description
docs/MACHINES.ru.md                machines: every fix with its evidence
docs/EMULATION.ru.md               what the emulation can do today
docs/ISSUES_AUDIT.ru.md            tracker vs. code
flash/mkboot_zx.sh                 boot image: FSBL + bitstream + firmware -> BOOT.BIN
flash/bit2bin.sh                   .bit -> .bit.bin for 0:/CORES/
flash/fsbl.bin                     first-stage boot loader (same as Step 14)
tools/put_retry.tcl                safe file upload to the card over JTAG
tools/card_ls.tcl                  card directory listing over JTAG (size check)
tools/card_mv.tcl                  rename on the card over JTAG
tools/penttest/                    Pentagon timing test tapes (PENTTEST, stime/btime sweeps, frame rate) + host scripts
```

## Благодарности

- **AYUMI** — точная эмуляция AY-3-8910 / YM2149 от **Peter Sovietov** ([true-grue/ayumi](https://github.com/true-grue/ayumi), MIT).
- **minimp3** — MP3-декодер, находящийся в общественном достоянии, автор **lieff** ([lieff/minimp3](https://github.com/lieff/minimp3), CC0).
- **speexdsp** — ресамплер от Xiph.Org / Жан-Марка Валина (BSD).
- **zxtests** — точный до такта замерный код в тестовых лентах Пентагона написал **Ян Бобровский** (GPL/LGPL).
- Внешний вид OSD, диалоговые окна и клавиатура повторяют стиль **DOS Navigator** (RIT Research Labs); шрифт CP866 — **Terminus** (OFL).
