Alex-Electron/ZX_BulbuLator/research/02-buttons-and-leds/README.ru.md

# Шаг 2 — Кнопки управляют светодиодами

Languages: [English](README.md) · **Русский**

В шаге 1 мы убедились, что поток битов проходит по плате. В этом шаге добавляем *вход*: четыре кнопки на шилде теперь управляют работой двух светодиодов. Принцип тот же, что и раньше — тактовая частота поступает от внутреннего генератора микросхемы (`STARTUPE2` / `CFGMCLK`), без PS и внешнего тактового сигнала — так что светодиоды мигают и работают точно так же, как в шаге 1.

## Как работают кнопки

Кнопки имеют режим **активного низкого уровня** с внутренними подтяжками: в ненажатом состоянии читается как 1, при нажатии вывод переходит в состояние 0. Битпоток привязывает каждый **вывод FPGA** к определённой функции; удержи кнопку, и:

| Вывод FPGA | Сеть  | Удержи и… |
|---|---|---|
| P19 | btn0 | мигание **зависает** (счётчик останавливается, светодиоды сохраняют своё состояние) |
| T19 | btn1 | **оба светодиода горят** |
| U20 | btn2 | **оба светодиода гаснут** |
| U19 | btn3 | мигание происходит **быстрее** |

Если ничего не нажато, светодиоды мигают в противофазе, как в шаге 1. Это светодиоды D18 и H18 — те же два, что и в шаге 1.

> **Примечание.** Вышеуказанное сопоставление сделано по **контактам FPGA**, именно это и фиксирует битстрим
> . Какая физическая кнопка (с надписью KEY1–KEY4) подключена к какому выводу,
> зависит от того, как подключена твоя плата расширения, поэтому ориентируйся по выводам — подключи
> кнопки к P19/T19/U20/U19, и они будут вести себя так, как указано.

## Как это работает

Несколько мелких моментов, о которых стоит знать:

- **Вход с активным низким уровнем.** Нажатие — это 0, поэтому код переводит каждый вывод в
  сигнал «нажато» с активным высоким уровнем (`~btn`).
- **Синхронизаторы с двумя триггерами.** Кнопки работают асинхронно по отношению к тактовому сигналу, поэтому каждая
  из них проходит через два триггера, прежде чем будет использована. Это стандартная мера защиты
  от метастабильности.
- **Управление счетчиком.** «Заморозка» — это не отдельный режим: KEY1 просто останавливает
  инкрементацию счетчика мигания (`if (!k1) cnt <= cnt + 1`), поэтому светодиоды остаются
  в том положении, в котором были.
- **Мультиплексор приоритетов** определяет выходной сигнал: приоритет «ВКЛ» преобладает, затем — «ВЫКЛ»,
  в остальных случаях (возможно, «замороженный») сигнал мигания управляет светодиодами.

Здесь намеренно **не предусмотрена дебаунс-обработка**. Каждое действие активируется при удержании кнопки, поэтому несколько миллисекунд дребезга при нажатии или отпускании вызывают лишь кратковременное мерцание и не имеют значения. Для действий с пограничным запуском (переключение при каждом нажатии) понадобится подавление дребезга — это стоит добавить на более позднем этапе.

См. [`buttons_leds.v`](buttons_leds.v) и [`buttons_leds.xdc`](buttons_leds.xdc).

## Сборка

Vivado 2023.1, компонент `xc7z010clg400-1`:

```
vivado -mode batch -source build_buttons_z010.tcl
```

Ты получишь файл `buttons_leds_z010.bit` размером примерно 2 083 863 байт — это фиксированная длина конфигурации микроконтроллера 7010, такая же, как в шаге 1. Готовая копия прилагается здесь.

## Прошивка

Всё точно так же, как в шаге 1 — полную инструкцию смотри в [шаге 0](../00-setup/). Самый быстрый способ: открой битстрим в Vivado Hardware Manager и запрограммируй `xc7z010`, либо воспользуйся вспомогательным скриптом:

```
bash ../01-board-bringup-blink/jtag_flash.sh buttons_leds_z010.bit
```

Ищи `Состояние по завершении запуска: HIGH`.

## Ожидаемый результат

Если ничего не нажимать, D18 и H18 будут мигать поочерёдно. Удержи KEY1 — они застынут; KEY2 заставит оба загореться; KEY3 заставит оба погаснуть; KEY4 ускорит мигание. Сигналы поступают в фабрику и меняют её поведение — это следующий шаг, чтобы плата стала полезной.
