Alex-Electron/ZX_BulbuLator/research/03-hdmi-bars/README.ru.md

# Шаг 3 — Простой HDMI: цветные полосы

Languages: [English](README.md) · **Русский**

Первое изображение на экране. Восемь статичных вертикальных цветных полос с разрешением 1280x720, выводимых через HDMI. Никакой анимации, никакого меню — самое простое, что доказывает, что весь видеотракт работает.

Это первый шаг, для которого нужен **PS** (сторона ARM), и именно он оказался самым сложным. Шаги 1 и 2 полностью выполнялись в PL на внутреннем генераторе чипа. HDMI требует чистого и точного тактового сигнала пикселей (74,25 МГц для 720p), а единственный стабильный тактовый сигнал на этой плате поступает из PS, генерируемый кварцем 33,333 МГц.

**Почему бы не подключить кварц напрямую?** На EBAZ4205 кварц 33,333 МГц подключён только к тактовому входу PS — от него нет трассы на плате к выводу PL, способному принимать тактовый сигнал. PLL-цепи PS генерируют все тактовые сигналы, а PL получает их по линиям FCLK0–3. Так что «тактовая частота от кварца» *и есть* то, что здесь происходит: кварц → IO-PLL → FCLK0 → PL. Внутренний генератор (CFGMCLK), используемый на шагах 1–2, не нуждается в кварце, но для видеосигнала он слишком сильно дрейфует. Единственный способ подать на PL чистый тактовый сигнал от кварца без использования PS — подключить внешний генератор к выводу PL, поддерживающему тактовую частоту (некоторые выводы разъема DATA являются MRCC) — это аппаратная модификация.

## Как устроено видео

```
crystal 33.333 MHz → PS (IO-PLL) → FCLK0 100 MHz
   → PS7 stub (clkgen.v) → clk_wiz / MMCM
       ├─ 74.25 MHz  (pixel)  → pattern_gen (bars) + rgb2dvi
       └─ 371.25 MHz (×5)     → rgb2dvi (TMDS serialiser)
   → TMDS out → HDMI → monitor
```

- [`pattern_bars.v`](pattern_bars.v) — синхронизация 720p и восемь цветных полос фиксированных цветов
  (белый, желтый, голубой, зеленый, пурпурный, красный, синий, черный). Также мигает
  `led_heart` (H18) синхронно с тактовой частотой пикселей, ~1 Гц, как знак того, что «часы работают».
- [`clkgen2.v`](clkgen2.v) — простой примитив `PS7`, который просто отводит сигнал FCLK0.
- MMCM `clk_wiz` и `rgb2dvi` от Digilent взяты из IP (см. раздел «Сборка»).

Контакты TMDS подключены по схеме **«семейства B»** для этого щитка — тактовый сигнал на **F19/F20**. Другая распиновка, встречающаяся в природе («семейство A», H16/H17), в данном случае приводит к появлению пустого экрана, так как H16/H17 на этой плате занимает UART. Полная распиновка и нюансы описаны в [справочнике по расширительной плате — шаг 0](../00-setup/#expansion-board-reference).

## Урок: для FCLK0 нужны преобразователи уровней

На это ушло несколько попыток. Прошивка PL и даже установка FCLK0 на 100 МГц с помощью `ps7_init` приводила к **пустому экрану** — тактовый сигнал пикселей просто не доходил до фабрики (индикатор H18 оставался тёмным).

Не хватало **`ps7_post_config`**, который включает **преобразователи уровней** PS→PL (`LVL_SHFTR_EN`). FCLK0 генерировался всё это время, но без включённых преобразователей уровней он так и не переходил из PS в PL. Порядок действий такой же, как и у FSBL при загрузке: запустить тактовые сигналы, загрузить PL, а потом включить преобразователи уровней.

[`flash_stripes.sh`](flash_stripes.sh) делает это через JTAG в два надежных этапа:

1. **Запрограммируй PL с помощью `vivado_lab`** (`program_hw_devices`, с повторными попытками). Это
   самый надёжный способ. В более ранней версии использовалась команда xsdb `fpga -file`, но она
   периодически давала сбой при работе с плотным битстримом (`DONE PIN is not HIGH`), поэтому её убрали.
2. **Запусти такт PS с помощью `xsdb`:** `ps7_init` (FCLK0 = 100 МГц из
   [`ps7_init_fclk.tcl`](ps7_init_fclk.tcl)), а затем `ps7_post_config` (преобразователи
   уровня). Уже загруженный MMCM перенастраивается на новый тактовый сигнал, и на экране
   появляются полосы.

При обычной загрузке с SD-карты FSBL сам выполняет всю часть 2 за тебя, так что тебе останется только загрузить PL.

## Сборка

Требуется Vivado 2023.1 и IP-блок **rgb2dvi** от Digilent. Сначала загрузи все зависимости из корневого каталога репозитория, а затем запусти сборку:

```
../../get_deps.sh        # fetches rgb2dvi into deps/vivado-library, pinned (once for the whole repo)
./build.sh               # → hdmi_stripes_z010.bit
```

Скрипт `build.sh` указывает Vivado на загруженную папку `deps/vivado-library` и запускает сборку. Целевой чип `xc7z010clg400-1`, размер выходного файла — около 2 083 867 байт. В комплект входит готовый файл `hdmi_stripes_z010.bit`.

## Прошивка

```
bash flash_stripes.sh hdmi_stripes_z010.bit
```

Ты должен увидеть сообщение `End of startup status: HIGH` из части 1, а затем `PS7_INIT_DONE` и `PS7_POST_CONFIG_DONE` из части 2. (Подойдет любой JTAG-кабель, поддерживаемый Vivado; смотри [Шаг 0](../00-setup/). Скрипт написан для настройки Pico/xvc-pico.)

## Ожидаемый результат

Экран заполняют восемь вертикальных цветных полос, которые стоят ровно (тактовая частота генерируется кварцем, поэтому монитор синхронизируется четко). **H18 мигает с частотой ~1 Гц** — это пульс пиксельного тактового генератора, самый явный признак того, что тактовая частота прошла в структуру.

> На тестовой плате светодиод синхронизации **D18** оставался погасшим, хотя всё остальное
> работало — это просто косметическая особенность этого выхода, а не проблема с тактовой частотой (стабильное,
> синхронизированное изображение и мигающий H18 уже доказывают, что MMCM синхронизирован).
