Alex-Electron/ZX_BulbuLator/research/11-file-browser/README.ru.md

# Шаг 11 — Чтение SD-карты: файловый браузер

Languages: [English](README.md) · **Русский**

Файловый браузер F5, отображающий содержимое карты на работающем Spectrum

*Браузер F5, отображающий содержимое SD-карты. Прокрутка вверх/вниз, Enter открывает папку, `..` возвращает назад; длинные имена прокручиваются, папки выделяются, а полоска справа показывает, где ты находишься в длинном списке.*

Цель этого шага — то, что нужно каждому загрузчику в первую очередь: смонтировать настоящую файловую систему с SD-карты и вывести её файлы на экран. На шаге 10 мы дали ARM голос (OSD поверх живого изображения) и руку на клавиатуре, но нечего было читать. На этом этапе он получает доступ к карте: **файловый браузер F5**, который монтирует карту FAT и просматривает её папки; **меню настроек F9**, изменения в котором применяются в режиме реального времени и сохраняются обратно в файл конфигурации на карте; а также панель OSD, которую теперь можно **перемещать и делать полупрозрачной** из этого меню.

Это по-прежнему браузер, а не загрузчик. Ты можешь перемещаться по карте и читать её содержимое; сама загрузка файла, на котором ты остановился (`.z80` / `.sna` через плоскость управления AXI), — это следующий шаг. Суть этого шага — в «обвязке» под капотом: стек SD, переиспользуемое меню и файл конфигурации, на основе которого проект может развиваться.

## Браузер файлов

Нажми **F5** — и на экране появится корневой каталог карты. ARM считывает файловую систему FAT через библиотеку FatFs от ChaN, работающую поверх драйвера SD `xsdps` от Xilinx, и перемещается по ней с помощью `f_opendir` / `f_readdir`:

- **Навигация.** Клавиши «Вверх»/«Вниз» перемещают курсор, Enter открывает папку, `..` возвращает на уровень выше. (Исправлена ошибка, из-за которой
  не удавалось выйти из папки — раньше при переходе на уровень выше в конце пути оставалась косая черта, и
  следующее чтение застревало на ней.)
- **Сортировка** с помощью **F3**: по имени, дате, размеру или расширению. Папки всегда сортируются в начало списка, `..`
  закреплён первым, а порядок сортировки логичен для каждой ключевой категории — от A до Z для имён и расширений,
  по дате — от самой новой к старой, по размеру — от самого большого к самому малому. Текущий режим отображается в заголовке.
- **Длинные имена** прокручиваются (в виде бегущей строки), как только курсор на них наводится, после короткой настраиваемой паузы, чтобы
  список не дергался.
- **Полоса прокрутки** справа показывает твое положение в списке, если он длиннее панели.
- **Папки помечены** так, чтобы их можно было сразу распознать — в стиле Total Commander `[в скобках]`,
  с помощью значка папки или конечного символа `/`, что можно настроить в параметрах.

Браузер работает **только в режиме чтения**: он отображает список и позволяет перемещаться по нему, но никогда не открывает файлы для записи, поэтому физически не может повредить карту, пока ты в ней копаешься. (Единственное, что всё-таки записывает данные — сохранение настроек — описано ниже.)

## Подключение SD-карты

Браузер считывает карту через **FatFs** от ChaN, работающий на драйвере SD-хоста **`xsdps`** от Xilinx — оба на «голом железе», без ОС. Об этом стеке стоит сказать пару слов: это первый раз, когда проект сталкивается с хранилищем, и тут было немало сложностей.

`xsdps` управляет SD-контроллером Zynq (слот microSD на EBAZ) и перемещает секторы с помощью DMA по стандарту ADMA2; FatFs работает поверх него и преобразует эти секторы в файловую систему FAT. Приложение монтирует диск `0:` один раз при загрузке (`f_mount`), просматривает каталоги с помощью `f_opendir` / `f_readdir` и читает или записывает файл конфигурации с помощью `f_open` / `f_read` / `f_write` / `f_close`. Ничего сложного.

**D-кеш специально отключен — именно этот нюанс обошёлся дороже всего.** Операции чтения `xsdps` проходят через ADMA2: SD-контроллер с помощью DMA копирует секторы прямо в буфер ОЗУ, минуя процессор. Если D-кеш ARM включен, драйверу приходится аннулировать строки кеша, охватывающие этот буфер, чтобы процессор видел байты, переданные по DMA, а не устаревшую копию, а стандартная процедура аннулирования округляет длину таким образом, что повреждает байты в конце буфера. Вместо того чтобы исправлять драйвер, приложение запускается с **отключенным D-кешем** (`Xil_DCacheDisable()` — это первое, что делает `main`). Это действительно снижает производительность ARM, но делает работу с SD-картами корректной и предсказуемой, а браузер не ограничивается пропускной способностью. (Именно поэтому вопрос «может ли ARM эмулировать целую машину» имеет предварительное условие, связанное с кэшем — это отдельная тема.)

**FAT32 и почему.** BootROM Zynq загружается только с FAT16/FAT32, так что загрузочная карта в любом случае должна быть в формате FAT32. FatFs скомпилирован с поддержкой длинных имён файлов и кодовой страницы 437, чтобы настоящие имена файлов игр отображались читаемо. exFAT встроен для *чтения* больших карт, но правило такое: **читать exFAT, записывать только на FAT32**: exFAT не ведёт зеркальную FAT, поэтому запись, прерванная из-за выдернутого шнура питания, с гораздо большей вероятностью приведёт к повреждению тома, а всё, что записывает проект, всегда попадает только на FAT32.

**Только чтение при просмотре.** При просмотре карты файлы никогда не открываются для записи (только `f_opendir` / `f_readdir`), поэтому браузер физически не может повредить карту, что бы ты в нём ни делал. Единственное исключение — **SAVE** в меню настроек: он открывает `0:/bulbulator.ini` с параметрами `FA_CREATE_ALWAYS | FA_WRITE`, записывает несколько строк и закрывает файл. Это первая и единственная запись на карту в рамках проекта, и именно поэтому FatFs собирается с параметром `FF_FS_READONLY=0`. Если карты нет, она заполнена или защищена от записи, открытие завершается сбоем, приложение переходит в режим «не смонтировано», а в меню отображается `FAIL` вместо `SAVED` — оно никогда не зависает.

**Сборка — это самая сложная часть.** Стек SD — первое, что тянет за собой BSP от Xilinx, а команда `platform-generate`, которая должна архивировать FatFs + `xsdps` в `libxil.a`, не работает в этой цепочке инструментов, поэтому приложение напрямую линкует объекты BSP и поставляется в готовом виде. Следующий шаг — добавление `xsdps` + FatFs в список зависимостей для сборки с чистым клоном `gcc` (см. честное примечание в разделе о сборке).

## Меню настроек

Меню настроек F9 — сортировка, прокрутка, стиль папок, а также размер и яркость самой панели OSD, с кнопкой SAVE

*Меню настроек F9. Ключ сортировки, скорость и задержка выделения, способ маркировки папок, а также положение и прозрачность самой панели OSD — всё это можно менять в режиме реального времени, а изменения сохраняются на карту с помощью кнопки SAVE.*

Нажми **F9** — откроется меню настроек. В его основе лежит небольшой **механизм меню, управляемый данными**: меню представляет собой таблицу элементов `menu_item` с типом (выбор из нескольких вариантов, действие, числовой диапазон), а один фрагмент кода отвечает за отображение и навигацию по этой таблице. Он призван поддерживать все будущие страницы настроек без написания нового кода для рисования. (Обзор файлов — это отдельный, написанный вручную список; он лишь заимствует ту же идею прокрутки и курсора.)

На данный момент доступны следующие пункты:

- **SORT** — ключ сортировки в обзоре (тот же, что переключается с помощью F3).
- **SCROLL** / **SCRL DLY** — скорость прокрутки длинного названия и время ожидания перед началом прокрутки.
- **FOLDERS** — как помечаются папки (`[скобки]` / символ / `/`).
- **OSD DIM**, **OSD X**, **OSD Y** — сама панель OSD (см. ниже).
- **SAVE** — запись настроек на карту.

Кнопки «Влево/Вправо» или «Enter» изменяют значение, и изменения вступают в силу **мгновенно** — ты видишь их сразу. Ничего не записывается на карту, пока ты не нажмёшь **SAVE**, что записывает файл `bulbulator.ini` в корневую папку карты и показывает `SAVED` или `FAIL`. Это первый раз, когда проект вообще записывает что-либо на SD-карту: FatFs переходит из режима «только для чтения» в режим «чтение-запись» (`FF_FS_READONLY=0`) именно для этого одного файла. Конфигурация считывается при загрузке, поэтому компьютер запускается в том состоянии, в котором ты его оставил. Файл специально сделан небольшим, чтобы в будущем можно было добавить больше ключей и разделов.

## OSD, которое можно перемещать и затемнять

Панель браузера, наложенная на загрузочное меню работающего ZX Spectrum 128 — это наложение, а не остановка

*Панель, наложенная на загрузочное меню работающего 128. Spectrum продолжает работать под ней — панель представляет собой полупрозрачное темно-синее окно, которое ты можешь перемещать и делать полупрозрачным прямо из меню, а не экран, для рисования которого компьютер был остановлен.*

Три из этих пунктов меню управляют самой панелью OSD в режиме реального времени через новые регистры управляющей плоскости:

- **OSD X** / **OSD Y** перемещают панель в любую точку экрана (`OSD_POS`, регистр `0x70`).
- **OSD DIM** задаёт степень прозрачности (`OSD_OP`, регистр `0x6C`) — от едва заметной дымки, сквозь которую можно разглядеть
  игру, до полностью непрозрачной панели.

Композитор делает это, смешивая цвет фона с видеосигналом в реальном времени с помощью альфа-коэффициента: `bg·a + video·(255−a)` для каждого пикселя, комбинационно на пути вывода, так что Z80 ни на секунду не останавливается, а синхронизация изображения не меняется. Аппаратный фиксатор удерживает панель в пределах кадра 1280×720 независимо от значения в регистре, поэтому неверная координата не сможет вытолкнуть её за пределы экрана. Положение представляет собой многобитовое значение, переходящее от тактовой частоты ARM к тактовой частоте пикселей, поэтому композитор фиксирует его только после совпадения двух отсчётов. Это не даёт полуобновлённой координате мигать мусорным положением в течение одного цикла.

Это по-прежнему **текстовая панель с разрешением 1 бит на пиксель** (кремовый текст на полупрозрачном темно-синем поле), но она в два раза выше, чем в шаге 10 (256×128 вместо 256×64), так что туда помещается браузер или меню из 15 строк. Цвет и скины специально оставлены на потом; здесь панель учится перемещаться и менять прозрачность, а не рисовать в цвете.

## Освобождаем место: фреймбуфер перемещен в линейный буфер

В этом битстриме есть ещё одно, менее заметное изменение, на которое опирается браузер. Начиная с шага 8, весь кадр ZX масштабировался из копии кадра в BRAM. Этой копии больше нет: `fb_line_disp` теперь считывает кадр из PS DDR **по одной исходной строке за раз** в пару крошечных строчных буферов LUTRAM и выводит их с разрешением 720p50. Выход ZX байт за байтом идентичен старому пути, но освобождает около дюжины тайлов BRAM — это запас, который понадобится позже для цветного OSD.

Он также реализован как **параметрический** масштабатор — геометрия, масштаб, кадрирование и количество бит на пиксель являются параметрами, а палитра — единственный этап, зависящий от конкретного ядра. Это сделано специально: тот же путь вывода должен будет выводить изображение будущего ядра NES или C64, а не только этого Spectrum.

У считывателя DDR построчно установлен жесткий срок в реальном времени: одна строка каждые 26,7 мкс, в то время как сторона захвата записывает следующий кадр в тот же DDR. Поэтому перед фиксацией конфигурации путь AXI-HP был протестирован на аппаратном обеспечении в условиях полной нагрузки записью. Задержка чтения в худшем случае не превышала ~770 нс, а выборка всей строки легко укладывается в лимит 26,7 мкс (примерно 10-кратный запас по времени выборки). Именно эти результаты позволили приступить к работе над цветным OSD.

## Согласование рамки с ZEsarUX

Область символов на Spectrum составляет 256×192, но картинка, которую люди запоминают, включает в себя **рамку** вокруг неё — а демо-ролики с рамкой полностью разворачиваются именно там. Чтобы передать полную рамку по HDMI, совместимую с ZEsarUX в качестве эталона, потребовалось несколько взаимосвязанных исправлений.

**Сначала исправили прокрутку.** Для потоковой передачи кадра в DDR требуется одинаковое количество слов в каждом кадре, в растровом порядке. Строки vblank в ULA не содержат видимых пикселей, поэтому простой упаковщик выдаёт меньше слов в этих строках, и всё изображение медленно **прокручивается**. `fb_capture_rr` исправляет это с помощью буфера строк типа «пинг-понг»: он захватывает реальные пиксели каждой строки, а затем выдает **ровно 360 пикселей на строку** (захваченные пиксели, дополненные чёрным цветом). В результате каждый кадр состоит ровно из `lines × 360` слов с фиксированной геометрией — никакой прокрутки, что бы ни делала демо-программа с краями.

**Измерение реального кадра.** Чтобы обрезать края, нужно знать, где они на самом деле находятся, а это зависит от конкретной машины и синхронизации. Поэтому крошечный **`cap_geom`-зонд** (считывается по AXI `0x64`) в каждом кадре подсчитывает общее количество строк, а также первую и последнюю *видимую* (непустую) строку. При считывании через JTAG в ZEsarUX он показал реальный PAL-кадр: 311 строк, причём изображение с рамкой начинается со 8-й строки.

**Обрезка, которая поставляется.** Захват отбрасывает первые 8 строк после vsync (`SKIP = 8`) — это хвост vsync, и при повторной растризации там появляется смещённый мусор — а затем захватывает 302 строки (`FB_H = 302`, видеостроки 8…309). Это полная радужная рамка сверху и снизу, центрированная в кадре 720p, без полосы мусора вверху. По горизонтали захват имеет ширину 360, но последний *исправный* столбец — 356: комбинационное гашение ULA на фоне его регистрового цвета оставляет пару случайных белых пикселей на крайнем правом крае (столбцы 357–358) плюс чёрный заполнитель на 359, поэтому обрезка изображения заканчивается на столбце 356, а остальное остаётся в зоне оверскана.

**Кадр, длина которого не является целым числом.** 302 строки × 360 ÷ 16 = **6795 слов**, что не кратно 16-тактному бёрсту AXI. Поэтому `fb_wr_axi` записывает кадр в виде 424 полных 16-тактных бёрста плюс **один заключительный неполный бёрст из 11 тактов** — именно это и позволяет кадру состоять из 302 строк, а не быть принудительно сведённым к кратному числу 32.

## Регистры плоскости управления

Файл регистров AXI (`axi_ctl.v`, в `M_AXI_GP0` по адресу `0x4000_0000`) пополнился четырьмя записями с 10-го шага, а версия изменилась на `0xB01B0008`:

| Адрес | Название | Ч/З | Значение |
|---|---|---|---|
| `0x64` | `cap_geom` | Ч | зонд геометрии кадра: количество строк в захваченном кадре и первая/последняя видимая строка — используется для настройки кадрирования по эталону |
| `0x68` | `OSD_BG` | Ч/З | Цвет фона панели OSD (RGB). Он используется при наложении; выбор цвета для него — это более поздний шаг, посвящённый цветам |
| `0x6C` | `OSD_OP` | Ч/З | Прозрачность панели OSD, альфа `0..255` (255 = полностью непрозрачно, 0 = полностью прозрачно). Управляется **OSD DIM** |
| `0x70` | `OSD_POS` | Ч/З | Положение панели OSD, `[10:0]` = X0, `[26:16]` = Y0. Управляется **OSD X** / **OSD Y** |

(`0x54`–`0x60` остались без изменений по сравнению с шагом 10: FIFO сканирующих кодов, сигнал «deadman» и `MACHINE_ID`. Регистры OSD по адресам `0x48`–`0x50` остались на прежних адресах, но буфер за ними увеличился: панель удвоилась до 256×128, поэтому буфер пикселей теперь составляет 1024 слова, а `OSD_ADDR` — это 10-битный указатель.)

## Как всё это устроено

```mermaid
flowchart LR
    SD["microSD card"] --> XSDPS["xsdps + FatFs<br/>(ARM)"]
    XSDPS --> APP["ARM browser_main.c<br/>F5 browser / F9 options<br/>config on the card"]
    KBD["PS/2 keyboard"] -->|"scancode FIFO"| AXI["axi_ctl<br/>GP0 0x4000_0000"]
    AXI <--> APP
    APP -->|"OSD pixels + enable"| COMP["osd_compositor<br/>+ position / opacity"]
    APP -->|"OSD_POS / OSD_OP"| COMP
    CORE["Atlas ZX core"] --> CAP["fb_capture + DDR<br/>triple buffer"]
    CAP --> DISP["fb_line_disp<br/>per-line DDR read"]
    DISP --> COMP
    COMP --> HDMI["HDMI 720p"]
```

## Сборка, прошивка, запуск

Есть три способа, как и в предыдущих шагах: собрать всё с исходников, записать готовый битстрим через JTAG или просто загрузить готовый образ с SD-карты.

**Сборка битстрима.** Сначала загрузи ядра из корня репозитория (`../../get_deps.sh`), а затем запусти `./build.sh`. RTL-изменения для этого шага находятся в `sources/`: `osd_compositor.v` (позиция + прозрачность), новый файл `fb_line_disp.v` (отображение линейного буфера), переработанные файлы `fb_capture_rr.v` / `fb_wr_axi.v`, `axi_ctl.v` с четырьмя новыми регистрами, верхний уровень и ограничения. Скрипт `sources/assemble.sh` подбирает неизменённый связующий код из шага 6 и цепочку DDR из шага 8 вокруг него, а Vivado записывает файл `bulbulator_zx_browser.bit`.

**Прошивка через JTAG и запуск.** Скрипт `./browser_run.sh` настраивает битстрим через PCAP (это тот самый «бронированный поезд», как в шагах 6–10), а затем загружает и запускает готовое приложение-браузер на Cortex-A9 № 0. Spectrum включается через HDMI, и клавиши F5, F9 и F1 работают сразу же.

**Загрузка с SD-карты (без хоста, без JTAG).** Скопируй `flash/BOOT.BIN` в раздел `boot` файловой системы FAT на карте, переключи плату на загрузку с SD (перемычка R2577 — см. шаг 0) и включи питание. FSBL загружает битстрим и запускает браузерное приложение; нажатие F5 выводит список с этой же картой. Чтобы самостоятельно пересобрать этот образ, скрипт `flash/build_boot.sh` объединяет FSBL, битстрим этого шага и браузерное приложение в новый файл `BOOT.BIN` без виртуальной машины (см. заголовок скрипта для обходного решения bootgen-on-modern-glibc).

**Приложение для ARM — честное замечание по поводу его сборки.** До шага 10 приложение для ARM было написано на «голом» C и скомпилировано с помощью простого `arm-none-eabi-gcc` без каких-либо дополнительных инструментов, полностью из чистого клона. Шаг 11 — первый, для которого нужна SD-карта, поэтому приложение подключает драйвер SD от Xilinx `xsdps` и FatFs от ChaN. Сейчас оно собирается под Vitis BSP (скрипт `build_browser.sh` напрямую подключает объекты FatFs и `xsdps`, так как неработающий `platform-generate` не архивирует их в `libxil.a`), поэтому сборки приложения с помощью `gcc` из чистого клона пока нет — для этого нужно, чтобы `xsdps` и FatFs были добавлены в репозиторий в качестве внешних библиотек, что и станет следующим шагом (работа над файловой системой SD). Поэтому на этом этапе поставляются **исходный код** приложения (`arm/browser_main.c`), его **скрипт сборки** и **готовый файл `arm/browser.elf`**; файл `BOOT.BIN` для SD и битстрим собираются и запускаются так же, как описано выше.

## Файлы

```
sources/osd_compositor.v          1-bpp OSD panel + live position/opacity blend (CHANGED)
sources/fb_line_disp.v            per-line DDR display, replaces the whole-frame BRAM (NEW)
sources/fb_capture_rr.v           frame capture, crop tuned vs ZEsarUX (CHANGED)
sources/fb_wr_axi.v               DDR frame writer, partial final burst for the new crop height (CHANGED)
sources/axi_ctl.v                 control plane + OSD position/opacity/bg + cap_geom (VERSION 0xB01B0008)
sources/bulbulator_zx_ddr_top.v   full top: the Step 10 design with fb_line_disp + the new registers
sources/bulbulator_ddr.xdc        constraints (CDC false-paths for the new line-disp need_row crossing)
sources/assemble.sh + build.tcl   gather the delta + the Step 6/8 sources into build/, then synth
arm/browser_main.c                the ARM app: F5 browser + F9 options + config (FatFs/xsdps)
arm/build_browser.sh              builds browser.elf against the Vitis BSP (see the honest note above)
arm/browser.elf                   prebuilt ARM app
build.sh                          build the bitstream
browser_run.sh                    PCAP-flash the bitstream + load/run the browser app over JTAG
flash/BOOT.BIN                    ready SD image (FSBL + this step's bitstream + the browser app)
flash/build_boot.sh + bif + fsbl.bin + browser.bin   rebuild BOOT.BIN yourself
flash/pcap_load.tcl + ps7_init_fclk.tcl              PCAP loader + PS7/FCLK/level-shifter init (reused since Step 8)
bulbulator_zx_browser.bit         prebuilt bitstream — flash over JTAG
```

## Что ещё не сделано

Это же записная книжка, так что незавершённые моменты — часть записи:

- **Следующий шаг — загрузка файла.** Браузер переходит по ссылке, но пока не вставляет файл `.z80` /
  `.sna`, на который ты попадаешь. Путь в плоскости управления для этого уже есть (шаг 7), так что осталось только соединить их.
- **На клавиатуре по-прежнему иногда пропадают нажатия** — иногда нажатие не регистрируется с первого
  раза, как в меню, так и в играх, что указывает на общий PS/2-приёмник, а не на ARM.
  Сторожевой таймер для пересинхронизации уже есть, но основной причиной, скорее всего, является пропущенный кадр make/break; эту проблему
  ещё пытаются устранить.
- **Цвет и скины отложены на потом.** OSD может перемещаться и менять прозрачность, но пока это однобитовый кремовый текст на тёмно-синем фоне.
  Указанное выше изменение линейного буфера — это основа, которая освобождает BRAM, необходимую для цветовой панели.

Стек SD — это [FatFs](http://elm-chan.org/fsw/ff/) от ChaN на `xsdps` от Xilinx; ядро ZX — это ядро [Atlas `zx`](https://github.com/AtlasFPGA/zx), а композитор OSD, шлюз клавиатуры и цепочка отображения DDR — это работа Step 8/10, на которой всё это основано.
