Alex-Electron/ZX_BulbuLator/research/09-ps2-keyboard/README.ru.md

# Шаг 9 — Настоящая клавиатура PS/2

Languages: [English](README.md) · **Русский**

Набор текста на работающем ZX Spectrum 128 с помощью клавиатуры PS/2

*`VSEM PRIVET OT BulbuLatora`, набрано на работающем 128 с помощью настоящей клавиатуры PS/2, подключённой к плате.*

В шагах 6–8 мы настроили управление меню загрузки с помощью четырёх кнопок на щитке. Этого хватало для выбора пункта меню, но *печатать* было нельзя. В этом шаге мы подключаем настоящую **клавиатуру PS/2** к плате, чтобы Spectrum вел себя как настоящий Spectrum. Кроме того, здесь назначаются управляющие клавиши (reset, NMI) в соответствии с де-факто раскладкой эмуляторов Speccy, а неудобная комбинация клавиш расширенного режима Spectrum сводится к одной клавише: Alt.

## Клавиатура уже была наполовину готова

Ядро Atlas уже поставляется с готовым трактом клавиатуры. `ps2.v` — это PS/2-приёмник (он синхронизируется по 11-битному фрейму и проверяет четность), а `keyboard.v` сопоставляет сканирующие коды набора 2 PS/2 с матрицей клавиш ZX 8×5. На этапах 6–8 просто не использовался файл `ps2.v` — вместо этого четыре кнопки синтезировали фиктивные нажатия клавиш прямо в `keyboard.v`. Так что до настоящей клавиатуры оставалось всего два контакта и один мультиплексор.

## Подключение — что к чему подключается

Клавиатура PS/2 использует 6-контактный разъём mini-DIN. Входная часть — от **Murmulator**: каждая линия подтянута к 3,3 В через резистор 4,7 кОм, а +5 В — для питания клавиатуры. Это тот же проект, чью схему загрузки с ленты использовали в шаге 6. Схема: [murmulator.ru/mm2-0](https://murmulator.ru/mm2-0).

| Контакт разъёма PS/2 mini-DIN | Линия | Подключается к |
|---|---|---|
| **5** | **CLK**  | Подтяжка на 3,3 В через резистор 4,7 кОм → FPGA **G19** (разъём DATA2-07) |
| **1** | **DATA** | Подтяжка 4,7 кОм до 3,3 В → FPGA **H20** (разъём DATA2-08) |
| **4** | VCC | **+5 В** |
| **3** | GND | GND |
| 2, 6 | CLK / DATA мыши | пока не используется — зарезервировано для будущей мыши PS/2 (разъём Murmulator — это клавиатура **+** мышь) |

Фронт-энд клавиатуры и мыши PS/2 (Murmulator)

*Фронт-энд PS/2 из проекта [Murmulator](https://murmulator.ru/mm2-0). Мы используем пару для клавиатуры — CLK KBD (контакт 5) → G19, DATA KBD (контакт 1) → H20 — а пару для мыши оставляем свободной на будущее.*

Короче говоря: тактовая частота PS/2 **→ G19**, **данные → H20** (оба вывода подтянуты резистором 4k7 до 3,3 В), с +5 В и землёй от платы. Тактовая частота PS/2 низкая (~12 кГц), поэтому ни одной из линий не нужен специальный тактовый вывод (clock-capable) — обе проходят через синхронизатор с двумя триггерами в тактовую линию Spectrum и передаются в `ps2.v`, чей выход `{strb, make, code}` мультиплексируется с четырьмя кнопками щитка (при одновременном нажатии приоритет у PS/2) в ядро. Таким образом, кнопки продолжают нормально работать параллельно с клавиатурой.

## Сначала запустим изолированно

Тот же подход, что и при установке связи на этапе 7 и фазах DDR на этапе 8: прежде чем приступать к полному проекту объёмом 1,1 МБ, небольшой автономный битстрим подтвердил, что клавиатура считывается. `standalone-tests/` — это `PS7 (FCLK0 + GP0)` + файл ядра `ps2.v` + небольшой AXI-ведомый в режиме «только чтение», который фиксирует последний сканирующий код и счетчик байтов в регистре. Прошей его, нажми клавиши, прочитай регистр через JTAG с помощью `xsdb`:

```
VERSION 0xB01B0009
PS2 scancode=0x29   <- Space
PS2 scancode=0x1C   <- A
PS2 scancode=0x5A   <- Enter
```

Пробел = `0x29`, A = `0x1C`, Enter = `0x5A` — именно те коды из набора 2, которые ожидает файл `keyboard.v`. Стоит обратить внимание на одну особенность: по умолчанию `xsdb` блокирует чтение адресного пространства PL / GP0, поэтому тебе понадобится `configparams force-mem-accesses 1` (та же строка, что использует загрузчик PCAP), прежде чем `mrd` сможет обратиться к `0x4000_0000`.

## Раскладка клавиш

Набор текста, курсор и две клавиши сдвига взяты прямо из `keyboard.v`:

- буквы, цифры, **Enter**, **Пробел**, **Backspace** (= DELETE), **Esc** (= BREAK) и
  клавиши курсора **↑ ↓ ← →**;
- **Shift** = Caps Shift (CS), **Ctrl** = Symbol Shift (SS) — то есть `Ctrl`+клавиша вызывает красные
  символы и токены BASIC;
- **Alt** = одноклавишное сочетание для расширенного режима Spectrum (зелёные и красные ключевые
  токены) — смотри ниже.

Клавиши управления соответствуют де-факто стандарту эмуляторов Speccy (Murmulator / ESPectrum / MiSTer):

| Клавиша | Действие |
|---|---|
| **`F11`** | жёсткий / холодный сброс — очищает все 128 КБ ОЗУ, затем перезагружается (настоящая загрузка с включением питания) |
| **`Ctrl`+`Alt`+`Del`** | мягкий сброс — перезагрузка в меню, ОЗУ сохраняется |
| **`Ctrl`+`Alt`+`Ins`** | NMI |

Зарезервировано для шагов OSD / загрузчика, пока не подключено: `F1` = справка, `F5` = загрузчик файлов, `F12` = меню OSD, `Ctrl`/`Shift`+`F1…F10` = слоты для снимков.

## Alt — клавиша расширенного режима

Зелёные и красные токены, напечатанные над и под каждой клавишей Spectrum, относятся к «расширенному режиму». На реальном оборудовании в него попадаешь с помощью комбинации двух сдвигов: удерживай Caps Shift и Symbol Shift одновременно, пока курсор не станет `E`, отпусти, а затем нажми любую клавишу. Alt выполняет всю эту комбинацию одним движением: удержи её и нажми любую клавишу для красного токена под клавишей, или нажми Alt отдельно, а затем любую клавишу для зелёного токена над ней.

Это не переназначение клавиш. Когда нажимается Alt, ПЛИС посылает в поток клавиатуры короткий синтетический аккорд Caps+Symbol Shift, который активирует режим `E` в ПЗУ, а затем удерживает Symbol Shift до тех пор, пока Alt остаётся нажатой, так что следующая клавиша регистрируется как красный расширенный токен. Аккорд длится около 60 мс — этого достаточно, чтобы сканирование клавиатуры ПЗУ с частотой 50 Гц успело его уловить. Ничто из этого не затрагивает ядро Atlas: синтетические коды проходят через тот же мультиплексор `{strb, make, code}`, что и клавиши с кнопками, поэтому `Ctrl+Alt+Del` и остальные комбинации по-прежнему декодируются точно так же, как и раньше.

## Два уровня сброса

Два уровня сброса и несколько моментов, о которых стоит упомянуть:

- **Мягкий сброс (`Ctrl+Alt+Del`)** подаёт импульс на сброс ядра → 128 перезагружается в своё меню, ОЗУ остаётся нетронутым.
  **Жёсткий (`F11`)** дополнительно обнуляет все 128 КБ ОЗУ (небольшая машина состояний,
  которая замораживает Z80, записывает 0 по всей ОЗУ и в теневую область экрана, а затем выполняет сброс) — это
  настоящая «холодная» перезагрузка.
- На 128 то, что на самом деле делает сброс «полным», — это очистка защелки страничной организации памяти `0x7FFD`,
  включая её бит блокировки, и `main.reset` уже это делает — так что даже мягкий сброс — это полноценный
  сброс, и ты не застрянешь в режиме 48K. Очистка ОЗУ — это дополнительная функция, благодаря которой жёсткий сброс
  ощущается как нажатие на выключатель питания.
- **Ловушка, из-за которой пришлось переделывать код:** сброс во время работы *не* должен сбрасывать видеоконвейер DDR.
  При первой попытке сброс затронул всю цепочку «захват → DDR → загрузчик» вместе с ядром; мастер AXI-HP
  был сброшен посреди передачи, порт PS DDR завис в ожидании оставшейся части передачи, и
  изображение зависло навсегда. Решение: оставлять видеоконвейер включенным только при сбросе при включении питания и подавать импульс
  *только ядро* при нажатии горячей клавиши — модуль захвата самостоятельно синхронизируется с видеосигналом ядра, поэтому
  изображение остаётся на месте. (Кстати: как и на любом настоящем Spectrum, сброс в любом случае
  гасит экран (делает его чёрным) — программный и аппаратный сброс выглядят одинаково; разница только в ОЗУ.)

**NMI** (`Ctrl+Alt+Ins`) генерирует импульс на `/NMI` Z80. На «голом» 128 с заводской ПЗУ (без Multiface или ПЗУ-фризера Gluk) обработчик NMI просто переключается на 48 BASIC — это аутентичное поведение «голой» машины. Полезная версия (заморозка / мгновенный снимок) появится позже, как только ARM перехватит NMI или будет загружена ПЗУ в стиле Multiface.

## Чего *нет* в этом шаге

Здесь речь идёт только о клавиатуре и раскладке клавиш — и ничего больше. Экранное меню (`F12`), загрузчик файлов/снимков с SD-карты (`F5` + слоты для сохранения/загрузки) и сохранение состояний — это тема следующей главы: ARM выводит OSD на экран и загружает игры с карты, как в MiSTer. Эта архитектура уже проработана, но это отдельный этап.

## Как клавиатура подключается к матрице

```mermaid
flowchart LR
    KBD["PS/2 keyboard<br/>Murmulator front-end<br/>(4k7 pull-ups, +5V)"] --> PINS["G19 / H20<br/>DATA2 header"]
    PINS --> SYNC["2-flop sync<br/>to spclk"]
    SYNC --> PS2["ps2.v<br/>11-bit frame + parity<br/>to {strb,make,code}"]
    BTN["4 shield buttons<br/>kbd_buttons.v"] --> MUX{"key mux<br/>synthetic / PS/2 / buttons"}
    PS2 --> MUX
    PS2 --> ALT["Alt chord gen<br/>synthetic Caps+Symbol Shift<br/>(Extended mode)"]
    ALT --> MUX
    MUX --> KEYB["keyboard.v<br/>scan-code to 8x5 matrix"]
    KEYB --> CORE["Atlas core (main)"]
    PS2 --> HOT["hotkey decoder<br/>F11 / Ctrl+Alt+Del / Ctrl+Alt+Ins"]
    HOT --> RST["reset / cold-wipe / NMI"]
    RST --> CORE
```

## Сборка, прошивка, запуск

Есть три способа использовать это, в зависимости от того, сколько ты хочешь сделать сам.

**Скомпилируй битстрим.** Алгоритм такой же, как в шаге 8 — это проект из шага 8 плюс клавиатура. Сначала загрузи ядра из корня репозитория (`../../get_deps.sh`), а потом запусти `./build.sh` (или `./build.sh nosnow`). Единственное изменение на этом этапе — верхний уровень (`bulbulator_zx_ddr_top.v`) и его ограничения; `sources/assemble.sh` извлекает цепочку DDR из шага 8 и базовый связующий модуль из шага 6, собирает всё в `sources/build/`, а Vivado записывает туда файл `bulbulator_zx_kbd.bit` (то же имя, что и у готового битстрима, который прошивает этот шаг). Автономный тест чтения собирается самостоятельно из папки `standalone-tests/`.

**Прошивка через JTAG.** PCAP «бронированный поезд», как в шагах 6–8: настройте `bulbulator_zx_kbd.bit` через PCAP (он устойчив к BAD_PACKET, в отличие от обычного JTAG на этой плате). На HDMI появится меню 128, и клавиатура сразу же заработает.

**Прошивка с SD-карты (без JTAG, без хоста).** Скопируй `flash/BOOT.BIN` в раздел `boot` с файловой системой FAT на карте, настрой плату на загрузку с SD (перемычка R2577 — см. шаг 0), включи питание — и keyboard-128 загрузится самостоятельно. Чтобы самостоятельно собрать этот образ, воспользуйся скриптом `flash/build_boot.sh`, который собирает его (FSBL + файл клавиатуры `bulbulator_zx_kbd.bit` + режим ожидания) без использования VM — смотри заголовок скрипта, там описан обходной путь для bootgen на современной glibc; `fsbl.bin` / `idle.bin` — это готовые загрузочные разделы, взятые без изменений из шага 8.

## Файлы

```
sources/bulbulator_zx_ddr_top.v   full top: Step-8 design + ps2 + key mux + hotkey decoder + Alt Extended-mode chord + reset logic
sources/bulbulator_ddr.xdc        the .xdc, now with PS2_CLK=G19 and PS2_DATA=H20
standalone-tests/                 the PS/2 read-test: ps2_test_top.v + ps2_axi.v + .xdc + build_ps2_test.tcl + ps2_test_run.sh (flash+read) / ps2_read_only.sh (re-read)
bulbulator_zx_kbd.bit             prebuilt bitstream (keyboard + the normalised key map) — flash over JTAG
flash/BOOT.BIN                    ready SD-card image (FSBL + this step's keyboard bitstream + idle) — copy to the card's FAT boot partition
flash/build_boot.sh + bulb_ddr_*.bif + fsbl.bin + idle.bin   rebuild BOOT.BIN yourself (the .bif packages bulbulator_zx_kbd.bit)
flash/pcap_load.tcl + ps7_init_fclk.tcl   PCAP loader + PS7/FCLK/level-shifter init (reused from Step 8; used by JTAG and SD boot)
images/                           the board typing on the live 128 + the PS/2 wiring (Murmulator)
```

PS/2-приёмник (`ps2.v`) и матричный преобразователь (`keyboard.v`) взяты из ядра [Atlas `zx`](https://github.com/AtlasFPGA/zx). Схема интерфейса клавиатуры взята из проекта [Murmulator](https://murmulator.ru/mm2-0) — это внешнее аппаратное дополнение, ссылка на которое приведена здесь с указанием авторства; оно не распространяется.
