Alex-Electron/ZX_BulbuLator/research/15-pentagon/bitstreams/README.md

# Готовые битстримы

Здесь лежит то, что реально работает на плате на момент публикации шага 15. Собирать ничего не
нужно: файлы кладутся на карту памяти и поднимаются сами. Как собрать всё это из исходников — в
[`../BUILDING.md`](../BUILDING.md).

| Файл | Куда класть | Что это |
|---|---|---|
| `BOOT_B0200_v0.15.448.BIN` | `0:/BOOT.BIN` | загрузочный образ: начальный загрузчик, ядро ZX и прошивка оболочки. Этим плата поднимается с холодного старта |
| `ATLAS_B0200.bit.bin` | `0:/CORES/ATLAS.BIT.BIN` | ядро ZX: **одно на три машины** — Spectrum 48K, Spectrum 128K и Пентагон 1024. Оболочка перезагружает его с карты при смене машины в меню |
| `ATLAS_B0200.bit` | — | то же ядро в исходном формате Vivado, для заливки по JTAG |
| `NES_CE29.bit.bin` | `0:/CORES/NES.BIT.BIN` | ядро NES / Денди |

## Тонкость, которая стоила полдня

Оболочка перезагружает ПЛИС с карты **только при смене ИМЕНИ ядра**, а у 48K, 128K и Пентагона имя
одно — `ATLAS`. Холодный старт вообще поднимает битстрим из `BOOT.BIN` и перезагрузку ПЛИС не делает.
Значит при обновлении ядра ZX надо менять **оба** файла: иначе либо холодный старт останется на
старом ядре, либо поход в другую машину и обратно молча вернёт прежний `ATLAS.BIT.BIN`.

Полная раскладка карты памяти — в [`../docs/SDCARD.ru.md`](../docs/SDCARD.ru.md).

## Запись на карту

Проще всего — кардридером. Если писать с хоста через почтовый ящик прошивки, обязательны три
правила, оплаченные испорченным загрузочным образом и незагружающейся платой:

1. писать во **временный** файл;
2. сверять его размер **листингом каталога**, а не полем «записано» и тем более не признаком
   «готово»: при нехватке места служба отчитается успехом, записав обрезок;
3. только потом переименовывать поверх боевого.

## Что в этом ядре

`B0200` = B0198 плюс две опции машины Пентагон: длина INT (36/32/44 T) и чтение порта `#FF` (`#FF` или атрибут, как у Sizif-512). При умолчаниях машина ведёт себя как B0198.

`B0198` = B0196 плюс смешение кадров на выводе (Display → Frame blend, пять буферов кадра; машина и её тайминги не тронуты). B0196 несёт накопительно: родная геометрия захвата 48K и 128K (384 настоящих точки, бордюры 64/64),
раздельное положение прерывания по машинам (48K — 4, 128K — 6), тонкий бордюр Пентагона с шагом
2 точки, разведённые разрешения «проигрывать ленту» и «ускорять процессор», метку кадра у строк
читателя и у снимка адреса строки (верхняя кромка кадра).

Разбор каждой правки с числами — в `../BUILD_HISTORY.md`, текущее состояние — в
`../HANDOVER_CURRENT.md`, описания — в `../docs/`.
