Alex-Electron/ZX_BulbuLator/research/15-pentagon/roms/README.md

# Наборы ПЗУ

Здесь лежат наборы ПЗУ, на которых машина проверялась, и описание того, как они устроены.

**Ничего из этого не написано нами.** Кто автор каждого файла, что в нём внутри и что именно мы в
нём меняли — в [`PROVENANCE.md`](PROVENANCE.md). Там же контрольные суммы и команды, которыми любое
утверждение оттуда проверяется за минуту.

## Что нужно машине

ПЗУ грузится **с карты памяти**, а не зашито в битстрим: четыре страницы по 16 КБ пишет процессор
платы во внутреннюю память ПЛИС вторым портом. Наборы кладутся в `0:/ROMS/`, выбор — опция машины
`ROM SET`, ключи файла настроек `<тег>.romset` (строка) и `<тег>.svcrom`.

Размер файла набора: **65 536** Б (четыре страницы), либо 49 152 (три), 32 768 (две), 16 384 (одна).

### Каноническая раскладка страниц — наша, а не общепринятая

| Слот | Что в нём |
|---|---|
| 0 | меню 128 |
| 1 | 48 BASIC |
| 2 | TR-DOS |
| 3 | сервисная страница |

**Порядок страниц в самом файле — любой.** Прошивка раскладывает их **по содержимому**: у
пентагоновских заводских наборов порядок обычно `[сервис, TR-DOS, 128, 48]`, и он тоже понимается.

Распознаватель — `../arm/rom_ident.c`. Подписи не придуманы, а сняты с реальных файлов: пять наборов
PentoGraf, четыре одиночных ПЗУ с карты Z-Controller и корпус Sizif-512. Прогон-доказательство —
`../arm/rom_ident_host_test.c`.

**Гоча, которая стоила бы половины подписей:** у строк в ПЗУ Спектрума последний знак слова помечен
битом 7 (так устроены таблицы токенов и сообщений у Sinclair), а сервисные ПЗУ печатают свои строки
то так, то так. Поэтому сравнение байт-в-байт ловит подпись через раз — искать надо с допуском на
старший бит в любом знаке.

**Подпись TR-DOS обязана быть строгой — `TR-DOS Ver`.** Слово `TR-DOS` встречается и в сервисных ПЗУ
(сообщения вида «No disk»), и по слабой подписи в слот TR-DOS уезжает сервисная страница. На этом
однажды был поставлен ложный диагноз целому набору.

## Как отличить гнилой дамп

Признак деградации, а не чьего-то патча: **одиночные не-`FF` байты внутри длинных прогонов `FF`** в
неиспользуемых областях. Патч так не выглядит — он лежит в коде, а не в заполнителе.

### Дамп «TR-DOS 5.04 / 1990» — это испорченная 5.03

Разбор со всеми смещениями, доказательствами и тем, что мы восстановили, — в
[`PROVENANCE.md`](PROVENANCE.md).

## Если карта пуста

Плата поднимется и без файлов: в битстрим зашит запасной набор (`ROM SET = BUILT-IN`). Но **залитое с
карты ПЗУ не восстанавливается ни железным сбросом, ни пунктом RESET в меню** — вайп трогает только
ОЗУ машины. Вернуть встроенное можно только перезагрузкой ядра, то есть выбором `ROM SET = BUILT-IN`.

## Сервисная страница

У настоящего Пентагона страница ПЗУ адресуется **парой** признаков: трап дискеты и бит порта. В нашей
нумерации `{DOS=1, порт=1}` — TR-DOS, а `{DOS=1, порт=0}` — **сервисная страница**; именно этим
заводские наборы входят в свой файловый менеджер. Это опция машины `Service page under TR-DOS` с
умолчанием «автоматически»: признак поднимается только когда в наборе действительно найден механизм
входа, иначе окно уехало бы в незаписанную память.

Проверять пару можно **только кодом, который остаётся в окне ПЗУ**: тест, возвращающийся в ОЗУ, сам
снимает защёлку и врёт.

## Чего у нас нет

Часов. Сервисные ПЗУ Gluk обращаются к микросхеме часов по портам с младшим байтом `#F7`, а у нас из
всех таких декодируется только один порт страничности. Чтения возвращают плавающую шину, отсюда мусор
в верхней строке, где у Gluk статус и часы. Это отсутствующая возможность, а не поломка ПЗУ: батарейки
на плате нет вовсе.
