Alex-Electron/ZX_BulbuLator/research/15-pentagon/tools/penttest/README.ru.md

# PENTTEST: тест таймингов Пентагона

Языки: [English](README.md) · **Русский**

Самопроверяющийся тест для машины Пентагон 128/1024 в духе Timing Tests 48K. Каждая строка печатает
измеренное значение, а за ним PASS или FAIL, последняя строка — итог. Тест запускается на BulbuLator,
но ничего своего для BulbuLator в нём нет, поэтому той же лентой можно проверить любой Пентагон или
его эмулятор.

Части, которым нужна точность до такта, взяты из zxtests Яна Бобровского (`minfo`): `DELAY`,
`ALIGNINT`, `FRAME_TIME`, `INT_TIME` и `EI_PREFIX`, лицензия GPL/LGPL. Единственное изменение — где
лежат таблица IM2 и обработчик (`instint.asm`): тест подключает по адресу #C000 другие банки.

## Запуск

Загрузи `penttest.tap` из 128 BASIC или 48 BASIC и дай ему поработать. Это несколько секунд, в конце
печатается `Result: N passed, M failed`. Программа занимает память начиная с #6000, поэтому
загрузчик на BASIC делает `CLEAR 24575`.

## Что проверяется

| Строка | Что должно быть у Пентагона | Откуда число |
|---|---|---|
| Frame time | 71680 T (320 строк × 224 T) | Sizif-512, MiSTer, Unreal и Fuse сходятся |
| Stable | восемь кадров подряд одинаковой длины | |
| EI is prefix | yes: INT не срабатывает сразу после `EI` | поведение Z80, `minfo` |
| INT time | 32, 36 или 44 T | это опция машины, см. ниже |
| IM2 vector #FF | во время подтверждения прерывания на шине данных #FF | у Пентагона нет плавающей шины |
| Port #FF | `always #FF` или `attributes N` в режиме ATTRIBUTE | опция машины, см. ниже |
| RAM banks | 128K, 256K, 512K или 1024K — как выставлено | страничность `{7FFD[5], 7FFD[7], 7FFD[6], 7FFD[2:0]}` |
| No contention @6000 | 71680 | `FRAME_TIME` работает из банка 5 |
| Banks @C000 | all 71680 | `FRAME_TIME` копируется в каждый банк по #C000, кроме 2 и 5 |

Тест ОЗУ пишет подпись сначала в банк 63, а последней — в банк 0. На машине с меньшей памятью верхние
банки зеркалят нижние, поэтому настоящий банк всегда записывается последним. Объём — это первый
банк, который прочитал чужую подпись. Каждый банк выше него обязан в точности повторять банк
`k & (N-1)`, иначе тест не проходит.

## Почему в двух строках годится больше одного ответа

Эталоны расходятся, и софт писали под каждый из них. Поэтому в BulbuLator это опции машины, а не
один выбранный за пользователя ответ.

Длина INT: 36 T — у Fuse, ZEsarUX и ep4spectrum Потапова, это наше умолчание. Sizif-512, MiSTer,
Unreal Speccy, ZX-Evo и TS-Conf используют 32 T. `minfo` намерил 44 T на живой плате: там длину
задаёт RC-цепочка, и от платы к плате она разная. Тест проходит на любом из трёх значений и печатает
то, что увидел, так что видно, сработала ли настройка.

Порт #FF: MiSTer и наше умолчание отдают #FF, потому что плавающей шины у Пентагона нет. Sizif-512
(`cpld/rtl/video.sv`) отдаёт последний выбранный атрибут, пока рисуется бумага, и часть живых клонов
ведёт себя так же. Синклеровские игры, которые синхронизируются по плавающей шине через `IN A,(#FF)`
(Arkanoid, Cobra и похожие), без этого виснут или мерцают. В режиме ATTRIBUTE тест сначала строит
таблицу всех значений атрибутов на экране. Затем требует, чтобы каждое чтение, давшее не #FF,
совпало с одним из них, и печатает, сколько чтений вернули атрибут.

## Растровые тесты: rastime и rasbord

PENTTEST растр не видит, поэтому на вопрос «где INT относительно картинки» отвечают ещё две ленты.
Это `stime` и `btime` Бобровского, тело кадра в них сохранено байт в байт, так что `T` значит ровно то
же, что там. Разница одна: программа перебирает `T` сама, а не ждёт Q/A.

- `rastime.tap` (stime): каждый кадр пишет #00 в 16384, а затем #FF на такте `T`. Клетка (0,0) —
  красные чернила на жёлтой бумаге, так что красное значит: запись успела раньше, чем ULA выбрала байт.
- `rasbord.tap` (btime): на такте `T` бордюр становится красным, а через 12 T — снова белым.

На каждое `T` приходится 16 кадров и свежий `ALIGNINT`. Текущее `T` рисуется 16-битной полоской в
строках знакомест 1 и 22, рядом с флажком, который помечает кадр как измерительный. Хост читает их по
снимкам кадра (`host/rsweep.py`, команда мейлбокса 14). Кадр засчитывается, только если обе полоски
совпали и флажок стоит: так отсеиваются рваные буферы и кадры между двумя значениями `T`.

Намерено на BulbuLator B0200 (Пентагон, INT H 327), в сравнении с живым Пентагоном:

| Тест | BulbuLator | Живой Пентагон |
|---|---|---|
| stime | 17984 виден, 17985 нет | 17983 виден, 17984 мерцает с частотой 25 Гц, 17985 нет |
| btime | 17762 | 17762–17763 |

Живая машина стоит ровно на полтакта между двумя нашими ближайшими настройками. При INT H 328 stime
становится 17983/17984, зато btime опускается до 17761. Процессор видит INT только на границе такта,
поэтому две единицы INT H составляют один такт, и из двух значений 327 лучше. Оставшиеся полтакта
меньше разброса между живыми платами.

## Частота кадров: fcount

`framerate/fcount.tap` раз в кадр копирует системную переменную FRAMES в верх экрана.
`host/frate.py <секунд> <тактов в кадре>` дважды читает её вместе с глобальным таймером ARM. На
BulbuLator процессор любой машины работает на 56,667 МГц / 16 = 3,5416 МГц: замер дал 50,673 Гц на
48K и 49,409 Гц на Пентагоне. Настоящие 48K и Пентагон работают на 3,5000 МГц, так что наши
быстрее на 1,2 %. На слух этого никто не заметит. Но машина и HDMI с его ровными 50,00 Гц расходятся,
поэтому раз в 1,5–1,7 секунды один кадр пропускается или повторяется.

## Сборка

`build.sh` нужны `pasmo` (с `--alocal`, чтобы метки, начинающиеся с `_`, были локальными) и Python 3:

```
./build.sh      # -> penttest.tap, rastime.tap, rasbord.tap, framerate/fcount.tap
```

`mktap.py` пишет однострочный загрузчик на BASIC и блок кода по адресу 32768.
