Alex-Electron/ZX_BulbuLator/docs/LOADER_SPEC.ru.md

# Форматы файлов снэпшотов (.z80 / .sna) и как BulbuLator их загружает

Languages: [English](LOADER_SPEC.md) · **Русский**

Этот документ — полное руководство по двум форматам снэпшотов ZX Spectrum, которые может загружать BulbuLator — `.z80` и `.sna` — и о том, как именно прошивка BulbuLator с ними работает. Он написан так, чтобы быть самостоятельным руководством: ты можешь использовать его, чтобы изучить оба формата с нуля, а также понять, отладить или переписать загрузчик BulbuLator. Если опубликованный формат допускает что-то, чего реализация BulbuLator *не* делает, оба варианта явно указываются: **«формат допускает X; BulbuLator делает Y».**

---

## 1. Введение

### 1.1 Что такое снэпшот

*Снэпшот* — это «замороженная» копия работающего ZX Spectrum: всё содержимое ОЗУ плюс полное состояние процессора (все регистры Z80, триггеры прерываний, режим прерываний), а также небольшая часть состояния системы, находящаяся за пределами процессора и ОЗУ — цвет бордюра и, на машине с 128K, защелка страничной организации памяти (порт `0x7FFD`). Восстановление снэпшота означает запись всего этого обратно в компьютер и продолжение работы процессора с той самой инструкции, которую он собирался выполнить. В отличие от кассеты (`.tap`/`.tzx`), снэпшот не «загружается» через загрузчик из ПЗУ; он вводится целиком и возобновляет работу.

Два формата, о которых здесь идёт речь, — это те, что важны на практике:

* **`.sna`** — более старый, простой формат. Фиксированный размер, без сжатия и с
  известной особенностью: в 48K-версии *нет поля PC*, и программный
  счётчик восстанавливается путём извлечения его из сохранённого стека. Существует в вариантах на 48K и 128K.
* **`.z80`** — де-факто стандарт, более функциональный формат. Три версии заголовка
  (v1/v2/v3), опциональное сжатие RLE, явный байт режима аппаратного управления и
  страничная организация памяти, масштабируемая от 48K до 128K и далее.

### 1.2 Как BulbuLator с ними работает

BulbuLator запускает настоящее ядро ZX Spectrum (Atlas, клон T80 / Z80) в PL (структуре FPGA) Zynq-7000, при этом ARM (PS) выступает в роли управляющей плоскости — OSD, файловая служба SD-карты, шлюз клавиатуры и загрузчик снэпшотов. Загрузчик — это C-программа, работающая «с нуля» на ARM (`arm/loader_main.c`). Когда пользователь выбирает файл `.z80` или `.sna` в файловом браузере, ARM:

1. **Выполняет полный сброс и очистку** всей системы (Z80, AY, ULA, страничную память, всю ОЗУ).
2. Анализирует заголовок снэпшота в DRAM.
3. **Распаковывает и передаёт** образ ОЗУ в память ядра через
   «бэкдор» AXI, по одному банку объёмом 16 КиБ за раз.
4. Устанавливает защелку страничной организации (`0x7FFD`) и бордюр, а затем фиксирует их.
5. Вставляет полный файл регистров Z80 прямо в ядро T80 через
   специальный вектор «DIRSet».
6. Освобождает ядро, которое возобновляет работу с точки выполнения (PC) снэпшота.

Это намеренно *деструктивная* загрузка: предыдущее состояние машины теряется. Это сделано специально и лежит в основе одного из важнейших поведений загрузчика (холодный сброс, см. §7.2).

### 1.3 Целевое оборудование и спецификация

* SoC: Zynq-7000 (EBAZ4205, XC7Z010).
* Ядро: Atlas ZX Spectrum 128 (процессор T80).
* Канал управления: AXI GP0, карта регистров в `sources/axi_ctl.v`.
* Регистр AXI `VERSION` для сборки, описанной в данной спецификации, принимает значение `0xB01B0009`.
* Регистр AXI `MACHINE_ID` принимает значение `0x00805A58` (метка «ZX»).

Все многобайтовые значения в обоих форматах файлов имеют порядок **little-endian (младший байт первым)**, если явно не указано иное. Исключением являются пары регистров `AF` и `AF'` в формате `.z80`, которые хранятся в порядке *A, затем F* (см. §2.2).

---

## 2. Формат `.z80`

Файл `.z80` состоит из заголовка, за которым следует память. Существует три версии заголовка. Важно помнить, что **исходный 30-байтовый заголовок версии v1 предшествует всем остальным версиям** — v2 и v3 не заменяют его, а *дополняют*. Поэтому сначала всегда нужно проанализировать базовый 30-байтовый заголовок, а уже потом решать, следует ли за ним ещё какой-то заголовок.

```
            ┌─────────────────────────────┐  offset 0
            │  30-byte base header (v1)    │
            ├─────────────────────────────┤  offset 30
  v1 only ─▶│  memory (raw or RLE, 48K)    │
            └─────────────────────────────┘

            ┌─────────────────────────────┐  offset 0
            │  30-byte base header         │
            ├─────────────────────────────┤  offset 30
            │  2-byte extended-header len  │  (= 23 / 54 / 55)
            ├─────────────────────────────┤  offset 32
  v2/v3  ──▶│  extended header (len bytes) │
            ├─────────────────────────────┤  offset 32 + len
            │  memory blocks (paged, RLE)  │  repeat to EOF
            └─────────────────────────────┘
```

### 2.1 Определение версии — правило «PC по смещению 6»

> Прочитай 16-битное слово по **смещению 6** (поле PC базового заголовка).
> * **PC ≠ 0** → это файл **v1**. Память начинается сразу по смещению 30.
> * **PC == 0** → это **расширенный** (v2 или v3) файл. Настоящий PC находится по
>   смещению 32, а 2-байтовое слово *длины расширенного заголовка* по смещению 30 указывает,
>   какой именно: **23 → v2.01**, **54 → v3.0**, **55 → v3.0x** (вариант +3
>   с одним дополнительным байтом).

Это самый важный этап определения, и он однозначен: PC версии v1 никогда не может быть равным нулю в настоящем снэпшоте.

**BulbuLator делает именно это:** `pc0 = d[6] | d[7]<<8`. Если значение не равно нулю, программа переходит по пути v1/48K; если равно нулю, она считывает `extlen = d[30] | d[31]<<8`, а настоящий PC — из `d[32]|d[33]<<8`.

### 2.2 30-байтовый базовый заголовок (v1) — полная таблица байтов

| Позиция | Длина | Поле | Примечания |
|----:|----:|---|---|
| 0  | 1 | **A** | Старший байт AF, сохраняется *первым*. |
| 1  | 1 | **F** | Так что байты 0–1 — это **A,F** — *не* слово AF в формате little-endian. |
| 2  | 2 | **BC** | Сначала младший бит (C на 2-м, B на 3-м). |
| 4  | 2 | **HL** | L на 4-м, H на 5-м. |
| 6  | 2 | **PC** | Сначала младший бит. **== 0 ⇒ v2/v3**, тогда реальный PC находится со смещением 32. |
| 8  | 2 | **SP** | Сначала младший бит. |
| 10 | 1 | **I** | Регистр вектора прерываний. |
| 11 | 1 | **R** | Регистр обновления — **здесь действительны только биты 0–6**; бит 7 берётся из бита 0 байта 12. |
| 12 | 1 | **FLAGS / информационный байт** | Поле битов, см. ниже. **Действует особенность 0xFF.** |
| 13 | 2 | **DE** | E @13, D @14. |
| 15 | 2 | **BC'** | теневая копия, C' @15, B' @16. |
| 17 | 2 | **DE'** | теневая копия. |
| 19 | 2 | **HL'** | тень. |
| 21 | 1 | **A'** | тень A. |
| 22 | 1 | **F'** | тень F (то есть 21–22 — это A', F'). |
| 23 | 2 | **IY** | Сначала младший бит. |
| 25 | 2 | **IX** | Сначала младший бит. |
| 27 | 1 | **IFF1** | 0 = DI (прерывания отключены), не нуль = EI. |
| 28 | 1 | **IFF2** | сам по себе редко имеет значение. |
| 29 | 1 | **FLAGS2** | Поле битов, см. ниже. |

**Конец заголовка v1 находится по смещению 30.** В файле v1 сразу же следуют 48 КиБ ОЗУ (`0x4000`–`0xFFFF`, 49152 байта) — в исходном виде или сжатые, в зависимости от бита 5 байта 12.

#### 12-й байт — битовое поле информации/флагов

| Бит(ы) | Значение |
|---|---|
| 0 | **7-й бит регистра R** (т. н. «трюк с 7-м битом R»). |
| 1–3 | Цвет бордюра (0–7). |
| 4 | 1 = включена базовая SamRom. |
| 5 | 1 = блок данных в памяти **сжат** (v1 RLE). |
| 6–7 | Без значения. |

**Особенность 0xFF:** если *весь* байт 12 равен `0xFF`, перед декодированием битов рассматривай его как `0x01`. Это нужно исключительно для совместимости с очень старыми файлами. Применяй это *в первую очередь*. (Результирующее состояние: бордюр 0, R-бит 7 установлен, несжато.)

#### Байт 29 — битовое поле FLAGS2

| Бит(ы) | Значение |
|---|---|
| 0–1 | Режим прерываний (IM 0, 1 или 2). |
| 2 | 1 = эмуляция Issue-2. |
| 3 | 1 = удвоенная частота прерываний. |
| 4–5 | Видеосинхронизация (1 = высокая, 3 = низкая, 0/2 = нормальная). |
| 6–7 | Джойстик: 0 = Cursor/Protek/AGF, 1 = Kempston, 2 = Sinclair-2-Left / пользовательский (v3), 3 = Sinclair-2-Right. |

#### Восстановление 7-го бита регистра R

7-й бит регистра R *не* хранится в байте 11. Восстанови полное значение:

```
R = (byte11 & 0x7F) | ((byte12 & 0x01) << 7)
```

Если использовать только 11-й байт, то примерно в половине всех снэпшотов получается неверное значение R (с погрешностью `0x80`). **BulbuLator делает это правильно:** `R = (d[11]&0x7F) | ((d[12]&1)<<7)`.

#### Что BulbuLator считывает из заголовка v1

`A=d0, F=d1, BC=d2/3, HL=d4/5, PC=d6/7, SP=d8/9, I=d10`, `R=(d11&0x7F)|((d12&1)<<7)`, `бордюр=(d12>>1)&7`, `DE=d13/14, BC'=d15/16, DE'=d17/18, HL'=d19/20, A'=d21, F'=d22, IY=d23/24, IX=d25/26`, `IFF1 = d27?1:0`, `IFF2 = d28?1:0`, `IM = d29 & 3`.

Обрати внимание: BulbuLator считывает `IFF1` и `IFF2` **независимо** из байтов 27 и 28 (в отличие от `.sna`, где есть только IFF2 — см. §3). BulbuLator **не** считывает бит SamRom, поля issue-2/double-interrupt/video-sync/joystick, а также не применяет ограничение `0xFF`→`0x01` к байту 12 (он считывает биты бордюра и сжатия напрямую; на практике байт 12 == 0xFF в современных файлах практически никогда не встречается, но это отклонение от строгой спецификации).

### 2.3 Сжатие памяти версии 1 (RLE)

Оперативная память версии 1 представляет собой либо необработанные 49152 байта (бит 5 в 12-м байте сброшен), либо сжатые по алгоритму RLE (бит 5 установлен). Схема RLE:

* Последовательность из **≥ 5 одинаковых байтов** кодируется как 4-байтовая последовательность
  **`ED ED xx yy`** = «байт `yy`, повторяющийся `xx` раз» (`xx` = количество, `yy` =
  значение).
* `xx` — это один байт, поэтому **максимальная длина последовательности на один код — 255**; для более длинных последовательностей
  требуется несколько кодов `ED ED`.
* **Исключение для ED:** последовательность даже из **двух** байтов `0xED` кодируется
  (`ED ED 02 ED`), так как в противном случае буквальная пара `ED ED` могла бы быть ошибочно
  принята за префикс экранирования.
* **Пропуск одиночного `ED`:** байт, следующий сразу за *одиночным* (неэкранированным)
  `0xED` никогда не объединяется в последовательность. Пример: `ED`, за которым следуют шесть `0x00`,
  кодируется как `ED 00` (буквальный ED, буквальный 00), а затем `ED ED 05 00` (остальные
  пять нулей) — т. е. `ED 00 ED ED 05 00`, **а не** `ED ED ED 06 00`. Декодер
  должен учитывать это, иначе у него возникнут проблемы с синхронизацией.
* **Маркер конца:** сжатый блок версии v1 заканчивается 4-байтовым маркером
  **`00 ED ED 00`**. Этот маркер есть **только в v1**.

**Путь v1 в BulbuLator:** один блок, начиная со смещения 30; сжимается, если `d[12] & 0x20`, в противном случае копируется без сжатия. Он распаковывается в буфер размером 49152 байта, а затем этот плоский буфер записывается в банки 5, 2, 0 в таком порядке (§5).

### 2.4 Расширенный заголовок версий v2/v3

После базового заголовка длиной 30 байт начинается расширенный заголовок:

| Смещение | Длина | Поле | Примечания |
|----:|----:|---|---|
| 30 | 2 | **Длина расширенного заголовка** | Подсчитывает байты, **начиная со смещения 32**; не включает слово длины и первые 30 байт. **23 → v2.01, 54 → v3.0, 55 → v3.0x (+3).** |
| 32 | 2 | **PC** (реальный) | Сначала младший бит. |
| 34 | 1 | **Аппаратный режим** | См. таблицу в §2.5. |
| 35 | 1 | **Порт 0x7FFD** (128K) / защелка 74LS259 (SamRam) / порт 245 (Timex). | Последнее значение, выведенное на порт страничной организации памяти 128K. |
| 36 | 1 | `0xFF`, если ПЗУ интерфейса I работает в режиме страничной организации памяти. (Timex: последнее значение, выведенное в порт 255.) |
| 37 | 1 | **FLAGS3** — смотри ниже. |
| 38 | 1 | Последнее значение, выведенное в порт `0xFFFD` = выбранный номер регистра AY (0–15). |
| 39 | 16 | **Дамп регистров AY** — регистры 0–15, так что регистр AY N находится по смещению 39+N (смещения 39–54). |

**v2 заканчивается здесь** (23 байта от смещения 32 = смещения 32–54). Для v2 блоки памяти начинаются со смещения **55**.

v3 продолжается:

| Смещение | Длина | Поле |
|----:|----:|---|
| 55 | 2 | Счётчик нижнего T-состояния (только v3). |
| 57 | 1 | Счётчик верхнего T-состояния (mod 4) (только v3). |
| 58 | 1 | Флаг «зрителя» (эмулятор QL) — игнорируется при загрузке, записывается как 0. |
| 59 | 1 | `0xFF`, если ПЗУ MGT (DISCiPLE/Plus-D) странично организовано. |
| 60 | 1 | `0xFF`, если ПЗУ Multiface странично организовано. **Должно всегда быть 0** — ОЗУ Multiface не сохраняется, и снэпшот, сделанный при его страничной организации, скорее всего, приведёт к сбою при возобновлении работы. |
| 61 | 1 | `0xFF`, если `0x0000`–`0x1FFF` — это ПЗУ, `0`, если ОЗУ. |
| 62 | 1 | `0xFF`, если `0x2000`–`0x3FFF` — это ROM, `0`, если RAM. (Байты 61/62 зависят от байтов 34, 59, 60, 83.) |
| 63 | 10 | 5 СЛОВ пользовательского сопоставления джойстика с клавиатурой (младший байт = строка 0–7, старший = маска столбца). |
| 73 | 10 | 5 ASCII-слов (старший байт = 0), определяющих названия клавиш «Влево», «Вправо», «Вниз», «Вверх», «Огонь». |
| 83 | 1 | Тип MGT: 0 = DISCiPLE+Epson, 1 = DISCiPLE+HP, 16 = Plus-D. |
| 84 | 1 | Состояние кнопки блокировки DISCiPLE (0 = отключено, 0xFF = включено). |
| 85 | 1 | Флаг блокировки DISCiPLE (0 = страница ROM доступна, 0xFF = недоступна). **Последний байт 54-байтового заголовка версии 3.0.** |
| 86 | 1 | **(только если длина слова == 55)** Последний выходной сигнал на порт `0x1FFD` — вторичный порт страничной организации памяти +3/+2A. Добавлено XZX-Pro. |

Для версии v3.0 (длина 54) память начинается со смещения `32 + 54 = 86`; для версии v3.0x (длина 55) — со смещения `32 + 55 = 87`. Некоторые эмуляторы не принимают 55-байтовые заголовки.

> **Расчёт начала заголовка, в общем случае:** общее количество байтов до первого блока памяти
> = `30 (база) + 2 (слово длины) + extlen` = `32 + extlen`. Слово длины
> со смещением 30 является частью *расширенного* заголовка, который находится после базового
> 30 байтов; никогда не пропускай базовый заголовок.

#### Байт 37 — битовое поле FLAGS3

| Бит(ы) | Значение |
|---|---|
| 0 | Эмуляция R-регистров включена. |
| 1 | Эмуляция LDIR включена. |
| 2 | Регистры AY используются / всегда сохраняются (даже на 48K, по соглашению XZX-Pro/Fuller). |
| 6 | (вместе с битом 2) Эмуляция Fuller Box. |
| 7 | **Флаг «Модифицированное аппаратное обеспечение»** — переинтерпретация байта 34: 48K→16K, 128K→+2, +3→+2A (Spectaculator). |

#### Что BulbuLator считывает из расширенного заголовка

Только `extlen` (d[30]/d[31]), `PC` (d[32]/d[33]), `hw` (d[34]) и `p7ffd` из источника `d[35]`. **Всё остальное игнорируется** — счётчики T-состояний, дамп регистра AY (d38–54), поля джойстика/раскладки клавиш, флаг модифицированного аппаратного обеспечения, SamRam, флаги Interface I / MGT / Multiface. См. §8, чтобы узнать, к чему это приводит (самое заметное: состояние звука AY не восстанавливается).

### 2.5 Байт 34 в аппаратном режиме — полная таблица

> **Значение байтов 3–6 МЕНЯЕТСЯ между версиями v2 и v3.** Перед интерпретацией байта 34 нужно знать
> версию (по слову длины).

| Значение | Значение в v2.01 | Значение в v3.0x |
|---:|---|---|
| 0 | 48K | 48K |
| 1 | 48K + IF1 | 48K + IF1 |
| 2 | SamRam | **48K + MGT** |
| 3 | **128K** | **SamRam** |
| 4 | **128K + IF1** | **128K** |
| 5 | (не используется) | **128K + IF1** |
| 6 | (не используется) | **128K + MGT** |

Расширенные коды / коды, установленные эмуляторами (де-факто в эпоху v3):

| Значение | Машина |
|---:|---|
| 7 | Spectrum +3 (XZX-Pro записывает 7 и добавляет байт 86 #1FFD) |
| 8 | тоже +3 (особенность XZX-Pro — рассматривается как +3) |
| 9 | Pentagon 128K (страничная организация памяти ≈ стандартный 128K) |
| 10 | Scorpion 256K (снэпшот имеет **16** страниц ОЗУ) |
| 11 | Didaktik-Kompakt |
| 12 | Spectrum +2 |
| 13 | Spectrum +2A |
| 14 | Timex TC2048 |
| 128 (0x80) | Timex TS2068 (Warajevo) |

**Вариант с модифицированным аппаратным обеспечением (бит 7 байта 37 установлен):** интерпретируй идентификатор 48K как 16K, идентификатор 128K как +2, а идентификатор +3 (7/8) как +2A.

**Сдвиг с v2 на v3 (коды 2–4):** в v3 на код 2 вставляется **48K+MGT**, из-за чего SamRam сдвигается на код 3, а 128K — на код 4; в v2 SamRam остаётся на 2, а 128K — на 3. Канонический порядок nvg / FUSE в v3: `2 = 48K+MGT, 3 = SamRam` — так что всегда читай байт 34 вместе с версией. (Байты 61/62 тоже были неправильно описаны в документации до версии v3.04.)

#### Решение BulbuLator по поводу 128K против 48K (зависит от версии!)

```c
is128 = (extlen == 23) ? (hw >= 3) : (hw >= 4);
p7ffd = is128 ? (d[35] & 0x3F) : 0x30;
```

Это соответствует таблице: в файле **v2** (extlen 23) режимы 128K начинаются с кода 3; в файле **v3** (extlen 54/55) они начинаются с кода 4 (коды 2 и 3 — это 48K+MGT и SamRam, оба относятся к классу 48K). Поэтому `hw == 3` в файле v3 трактуется как **48K**, что правильно. Обрати внимание на `& 0x3F`: BulbuLator маскирует сохраненное значение 7FFD до 6 битов, потому что аппаратный регистр `PORT_7FFD` имеет разряды только `[5:0]` (см. §6/§7). Для режима 48K он принудительно устанавливает `0x30` (банк 0 по адресу `0xC000`, выбран 48K ROM, экран = банк 5, страничная организация памяти заблокирована).

> **Предупреждение:** BulbuLator *не* учитывает особые случаи для Scorpion (16 страниц → банки
> 8–15), страничной организации дисков +2/+2A/+3 или Timex. Любой из кодов 7–14/128 просто выбирает
> путь 128K с `hw >= 4` и отображается по *стандартной* схеме банков 128K
> (§5). Для подлинного контента Pentagon-128 / стандартного 128K это верно; для
> Scorpion или специфической для +3 страничной организации памяти — нет. См. §8.

### 2.6 Формат блоков памяти v2/v3

В v2/v3 память представляет собой последовательность блоков, **повторяющихся до конца файла (EOF) без поля счёта и без маркера конца.** Каждый блок:

```
byte 0–1 : length of the (possibly compressed) data, WORD, LSB first
           — NOT counting this 3-byte header.
byte 2   : page number (which logical 16 KiB page this is).
byte 3.. : the data.
```

* **Специальный маркер:** если слово длины == **`0xFFFF`**, то объем данных составляет ровно
  **16384 байта в несжатом виде (raw)**.
* В противном случае данные сжаты по алгоритму RLE с использованием **той же схемы `ED ED xx yy`, что и
  в версии v1, но БЕЗ конечного маркера `00 ED ED 00`** — их границей служит слово длины.
* Каждый блок всегда распаковывается в полную **страницу размером 16 КиБ (16384 байта)**.

Парсер считывает `(3-байтовый заголовок + данные)` повторно до конца файла (EOF). Парсер версий v2/v3, ищущий маркер конца v1, переполнит память; парсер v1, игнорирующий длину и считающий до 49152, неправильно обработает v2/v3.

**Цикл страниц от BulbuLator:**

```c
off = 32 + extlen;
while (more) {
    clen = d[off] | d[off+1]<<8;
    pg   = d[off+2];
    data = &d[off+3];
    if (clen == 0xFFFF) { raw 16384 } else { z80_unrle(...) }
    // map pg -> bank (see §5), wr_bank if bank != -1
    off += 3 + (clen == 0xFFFF ? 16384 : clen);
}
```

`z80_unrle` распознает экранирующую последовательность `ED ED`, считывает сначала счетчик, а затем значение, расширяет последовательность и дополняет любой недостающий хвост до 16384 нулями. Сентинел `0xFFFF` копирует 16384 байта в исходном виде.

### 2.7 Сопоставление идентификатора страницы → логического блока

Номер страницы в 2-м байте **имеет разное значение в разных режимах работы машины.** Вот в чём заключается тонкость.

**«Режим 48»** (идентификатор страницы → область адресов или ПЗУ):

| Страница | Значение |
|---:|---|
| 0 | 48K ПЗУ |
| 1 | ПЗУ IF1 / DISCiPLE / Plus-D |
| 4 | `0x8000`–`0xBFFF` |
| 5 | `0xC000`–`0xFFFF` |
| 8 | `0x4000`–`0x7FFF` |
| 11 | ПЗУ Multiface |

**Режим «128»** (идентификатор страницы → **номер банка** 128K ОЗУ, по формуле `банк = страница − 3`):

| Страница | Значение | Страница | Значение |
|---:|---|---:|---|
| 0 | ПЗУ (Basic/редактор) | 7 | Банк ОЗУ 4 |
| 1 | ПЗУ IF1/DISCiPLE/PlusD | 8 | Банк ОЗУ 5 |
| 2 | ПЗУ (сброс/48-Basic) | 9 | Банк ОЗУ 6 |
| 3 | Банк ОЗУ 0 | 10 | Банк ОЗУ 7 |
| 4 | Банк ОЗУ 1 | 11 | ПЗУ Multiface |
| 5 | Банк ОЗУ 2 | | |
| 6 | Банк ОЗУ 3 | | |

**Режим SamRam:** страница 0 = 48K ROM, 2 = SamRam ROM (Basic), 3 = ПЗУ SamRam (монитор), 4 = обычный `0x8000`–`0xBFFF`, 5 = обычный `0xC000`–`0xFFFF`, 6 = теневой `0x8000`–`0xBFFF`, 7 = теневой `0xC000`–`0xFFFF`, 8 = `0x4000`–`0x7FFF`.

**Какие страницы сохраняются:**

| Режим | Сохраняемые страницы | Блоки |
|---|---|---:|
| 48K | 4, 5, 8 | 3 |
| SamRam | 4–8 | 5 |
| 128K | 3–10 (все 8 банков ОЗУ 0–7) | 8 |
| Scorpion 256K | (16 страниц) | 16 |

> **Ключевое семантическое различие:** *один и тот же числовой идентификатор страницы* означает разные
> вещи в режимах 48K и 128K. Страница 8 — это «адрес `0x4000`–`0x7FFF`» в 48K, но «банк ОЗУ
> 5» в 128K. Страница 4 — это «`0x8000`–`0xBFFF`» в 48K, но «банк ОЗУ 1» в
> 128K. Загрузчик должен перейти в машинный режим перед отображением. См. §5, чтобы узнать, как
> BulbuLator справляется с этим и с **предупреждением о коллизии**.

---

## 3. Формат `.sna`

`.sna` — более старый и простой формат: фиксированный 27-байтовый заголовок регистров, а затем необработанный (несжатый) дамп ОЗУ. Сжатия нет, поэтому размер файла фиксирован, а сортировка по размеру работает надёжно. Все значения в формате little-endian; `AF` и `AF'` хранят **F в младшем байте, A — в старшем** (частая причина ошибок «off-by-one»).

### 3.1 48K `.sna` — ровно 49179 байт

`49179 = 27 (заголовок) + 49152 (RAM)`.

| Смещение | Длина | Поле | Примечания |
|----:|----:|---|---|
| 0x00 | 1 | **I** | |
| 0x01 | 2 | **HL'** | тень |
| 0x03 | 2 | **DE'** | тень |
| 0x05 | 2 | **BC'** | тень |
| 0x07 | 2 | **AF'** | F' @0x07, A' @0x08 |
| 0x09 | 2 | **HL** | |
| 0x0B | 2 | **DE** | |
| 0x0D | 2 | **BC** | |
| 0x0F | 2 | **IY** | |
| 0x11 | 2 | **IX** | |
| 0x13 | 1 | **Байт прерывания** | **Определен только бит 2 = IFF2** (1 = EI, 0 = DI). Маскируй с помощью `& 0x04`; не проверяй весь байт. |
| 0x14 | 1 | **R** | все 8 битов |
| 0x15 | 2 | **AF** | F @0x15, A @0x16 |
| 0x17 | 2 | **SP** | как сохранено — указывает на PC, помещённый в стек (см. ниже) |
| 0x19 | 1 | **IM** | 0/1/2 |
| 0x1A | 1 | **Бордюр** | 0–7, младшие 3 бита |

Область ОЗУ: байты **27..49178** (49152 байта) = плоская дампа `0x4000`–`0xFFFF`. Первые `0x4000` → **банк 5** ОЗУ (`0x4000`–`0x7FFF`, содержит экран в диапазоне `0x4000`–`0x5AFF`, т. е. смещение файла 27..27+0x1AFF). Следующие `0x4000` → банк 2 (`0x8000`–`0xBFFF`). Последние `0x4000` → банк, страничный доступ к которому начинается с `0xC000` (банк 0 на обычном 48K).

#### Хитрость с PC в стеке (характерная особенность файла `.sna`)

В файле `.sna` для 48K **нет поля PC.** При сохранении эмулятор фактически выполняет команду `PUSH PC`: он уменьшает SP на 2 и записывает два байта PC в `[SP]` (младший) и `[SP+1]` (старший). Поэтому сохранённый SP указывает на это помещённое в стек значение.

**Процедура загрузчика для восстановления PC:**

```
PC_low  = memory[SP]
PC_high = memory[SP+1]
PC      = PC_low | (PC_high << 8)
SP      = SP + 2          // pop it back off
```

**Почему это работает — RETN:** исходный снэпшот памяти объёмом 48K был сделан из подпрограммы, работающей в режиме NMI. Этот снэпшот предназначен для возобновления работы с помощью команды `RETN` («возврат из немаскируемого прерывания»), которая одновременно извлекает адрес возврата (реальный PC) *и* восстанавливает IFF1 из IFF2. Именно поэтому сохраняется только **IFF2**: `RETN` восстанавливает IFF1 на его основе.

**Последствия (неизбежные, заложенные в конструкции, а не ошибки):**

* Два байта, расположенные непосредственно ниже исходного SP в образе ОЗУ,
  **перезаписываются** на сброшенный PC. После загрузки + RETN SP восстанавливается, но
  эти два байта остаются перезаписанными. Это соответствует реальному аппаратному обеспечению на момент создания снэпшота
  и неизбежно в 48K `.sna`.
* IFF1 не сохраняется; стандартная практика — **IFF1 := IFF2**.

#### Крайний случай со стеком в ПЗУ

Если сохраненный `SP < 0x4000`, байты PC, помещённые в стек, оказались в пространстве ROM (`0x0000`–`0x3FFF`), которое `.sna` **не** сохраняет — поэтому PC невозможно восстановить из файла, и снэпшот для этого пути будет некорректным. `SP = 0xFFFF` тоже вызывает проблемы (`SP+1` переходит в `0x0000`, ROM). Чтобы всё работало надёжно, и `[SP]`, и `[SP+1]` должны находиться в сохранённой RAM, т. е. **`0x4002 ≤ SP ≤ 0xFFFE`** (некоторые реализации допускают диапазон `0x4000`–`0xFFFE`).

**BulbuLator** контролирует это: он извлекает PC из `ram[SP-0x4000] | ram[SP-0x4000+1]<<8` **только когда `SP` находится в диапазоне `0x4000..0xFFFE`**, тогда `SP = (SP+2) & 0xFFFF`, и страничная организация памяти 48K принудительно устанавливается на `0x30`. Если защита сбивается, PC детерминированно возвращается к **0** — оба байта PC предварительно инициализированы на 0 *и* структура регистров инициализирована нулями (`zregs z = {0}`). Правильно сформированный файл `.sna` для 48K всегда имеет SP, указывающий в ОЗУ, поэтому на практике проверка никогда не срабатывает.

### 3.2 Файл `.sna` для 128K — 131103 или 147487 байт

Передний блок (байты 0..49178) имеет **идентичную структуру** с файлом `.sna` размером 48K: 27-байтовый заголовок + 49152 байта. Но три блока по 16 KiB со смещением 27 — это: **банк 5, затем банк 2, затем банк, который в данный момент находится в памяти по адресу `0xC000`** (согласно битам 0–2 кода `7FFD`) — даже если этот банк сам по себе является банком 5 или 2.

Затем **4-байтовый трейлер** со смещением 49179:

| Смещение | Длина | Поле |
|----:|----:|---|
| 49179 | 2 | **PC** (явно указан — 128K **не** использует трюк со стеком) |
| 49181 | 1 | Последнее значение, записанное в порт `0x7FFD` |
| 49182 | 1 | Флаг страничной организации TR-DOS / Beta-disk ROM (1 = страничная) — расширение Pentagon/Beta |

Затем **остальные пять банков**, начиная со смещения 49183: остальные банки по 16 КиБ в **восходящем порядке (0, 1, 2, ..., 7)**, *пропуская* три, уже записанных в первом блоке (банк 5, банк 2 и банк с страничной организацией `7FFD`). Это `5 × 16384 = 81920` байт.

Расчёт размера: `49179 + 4 + 5×16384 = 131103 байт` — канонический файл `.sna` размером 128K.

```
 offset 0       27                       49179  49181  49183                131103
 ┌────────────┬───────────────────────┬──────┬─────┬─┬───────────────────────┐
 │ 27-byte    │ 49152 bytes:          │ PC   │7FFD │T│ 5 remaining banks      │
 │ register   │ bank5, bank2, paged   │ (2B) │(1B) │R│ ascending 0..7,        │
 │ header     │ (3×16 KiB)            │      │     │D│ skipping {5,2,paged}   │
 │            │                       │      │     │S│ (5×16 KiB = 81920)     │
 └────────────┴───────────────────────┴──────┴─────┴─┴───────────────────────┘
                                       └──── 4-byte trailer ────┘
```

#### Вариант размером 147487 байт

`147487 = 131103 + 16384` — ровно **один дополнительный банк по 16 КиБ** (шесть конечных банков вместо пяти). Это происходит, когда банк, выгруженный по адресу `0xC000`, сам является **банком 5 или банком 2**: тогда в первом блоке размером 49152 находятся только **два разных** банка (5 и 2, а третий фрагмент — дубликат), поэтому в конечной списке идут **шесть** банков — все, кроме 5 и 2 — вместо пяти. (Список всех *восьми* банков в конце должен был бы составлять `27 + 49152 + 4 + 8×16384 = 180255`, а не 147487, так что «все 8 в списке» — это ошибка в прочтении.) Дополнительные 16 КиБ — это **не** образ ПЗУ TR-DOS. Внимательный читатель возьмёт `8 − (количество уникальных передних банков)` конечных банков; смотри §5.2, чтобы узнать, как именно BulbuLator это делает.

#### Страничная организация памяти объёмом 128K, начиная с байта `7FFD` в конце списка (смещение 49181)

| Бит(ы) | Значение |
|---|---|
| 0–2 | Банк ОЗУ, страничный при `0xC000` |
| 3 | Отображаемый экран: 0 → банк 5 (обычный), 1 → банк 7 (теневой) |
| 4 | Выбор ПЗУ: 0 = 128K ПЗУ редактора, 1 = 48K ПЗУ BASIC |
| 5 | Отключение страничной организации / фиксация блокировки |

> **Отображаемый экран не зависит** от банка, странично организованного по адресу `0xC000`: он определяется
> битом 3 (банк 5 или банк 7), а биты 0–2 выбирают только то, что сопоставлено по адресу
> `0xC000`. Рендерер должен считывать банк 5 или банк 7 в зависимости от бита 3, а не страничный банк.

#### Что BulbuLator считывает из `.sna`

Заголовок: `I=d0, HL'=d1/2, DE'=d3/4, BC'=d5/6, F'=d7, A'=d8, HL=d9/10, DE=d11/12, BC=d13/14, IY=d15/16, IX=d17/18`, `IFF2 = (d19 & 0x04)?1:0` **где `IFF1 := IFF2`**, `R=d20, F=d21, A=d22, SP=d23/24, IM = d25 & 3, бордюр = d26 & 7`.

* **48K-путь** (`len < 131000`): банки 5, 2, 0 из 49152 байт после
  заголовка; PC снят со стека (с проверкой, §3.1); `p7ffd = 0x30`.
* **Путь 128K** (`len >= 131000`): `PC = ram[49152] | ram[49153]<<8`,
  `p7 = ram[49154]`, `paged = p7 & 7`; банки 5, 2, `paged` из первых 49152;
  остальные банки 0..7 пропускают `{5, 2, paged}`, начиная со смещения
  `27 + 49152 + 4`; `p7ffd = p7 & 0x3F`. `+4` — это конечный фрагмент (PC 2B + 7FFD
  1B + 1 байт TR-DOS).

> BulbuLator выполняет обработку исключительно по пороговому значению `len < 131000` — **а не** по
> точным размерам 49179/131103/147487. Флаг TR-DOS в формате на 49182 считывается как
> часть 4-байтового промежутка, но никак не обрабатывается. Затем он считывает ровно **пять**
> конечных банков — цикл проходит по `b = 0..7`, пропуская `{5, 2, paged}`, по одному блоку размером 16 КиБ
> фрагмент на каждый не пропущенный банк — что точно соответствует схеме 131103, поэтому **131103
> обрабатывается правильно**. Однако файл **147487** хранит *все восемь* банков в
> конечной части списка (банк с страничной организацией дублируется, а не пропускается); чтение только пяти
> фрагментов со смещениями 131103 приводит к тому, что неправильные 16 КиБ попадают в неправильные банки,
> **повреждая верхнюю часть ОЗУ**. Так что формат 147487 *не* поддерживается правильно, несмотря на то, что
> он проходит проверку `len >= 131000`. См. §8.

---

## 4. Программное распознавание — формальные правила и как работает BulbuLator

### 4.1 Формальное распознавание

* **Формат:** `.z80` и `.sna` обычно определяются по расширению файла (ни один из форматов
  не имеет магического числа; `.sna` распознаётся по фиксированным размерам, а `.z80` — по
  правилу «PC-at-6»).
* **Распределение по размеру `.sna`:** `49179` → 48K; `131103` или `147487` → 128K;
  всё остальное → не `.sna`.
* **Версия `.z80`:** PC со смещением 6 ≠ 0 → v1; == 0 → расширенная, затем слово длины
  23/54/55 → v2.01/v3.0/v3.0x.
* **Машина `.z80`:** байт 34, интерпретируется в зависимости от версии (§2.5).

### 4.2 Что на самом деле делает BulbuLator

Вызов осуществляется **исключительно по расширению файла без учёта регистра** — `.sna` → `load_sna`, **всё остальное** → `load_z80`. Анализ содержимого не производится. Внутри каждого:

```
                       ┌───────────────────────────┐
                       │ file extension (lowercased)│
                       └─────────────┬──────────────┘
                          ".sna"?     │   else
                  ┌──────────────────┘└────────────────────┐
                  ▼                                          ▼
          ┌───────────────┐                          ┌───────────────┐
          │   load_sna    │                          │   load_z80    │
          └──────┬────────┘                          └──────┬────────┘
       len<131000│  len>=131000                  pc0=d[6|7]  │
        (48K)    │   (128K)                    pc0!=0│  pc0==0│
        ┌────────┘└────────┐                  (v1)  │  (v2/v3)
        ▼                  ▼                   ┌─────┘└──────────┐
  stack-pop PC       explicit PC               ▼                ▼
  banks 5,2,0        banks 5,2,paged     48K flat block   extlen=d[30|31]
  p7ffd=0x30         + remaining 0..7    banks 5,2,0      PC=d[32|33] hw=d[34]
                     p7ffd=p7&0x3F       p7ffd=0x30       is128 = (extlen==23)
                                                            ? hw>=3 : hw>=4
                                                          p7ffd = is128
                                                            ? d[35]&0x3F : 0x30
                                                          page loop (§2.6)
```

Два особенности BulbuLator, которые не учитываются в формальных правилах:

* **Разделение файлов `.sna` на 48K и 128K определяется пороговым значением `len < 131000`**, а не точными
  размерами. Файл размером 49179 байт и любой другой файл меньше 131000 обрабатываются как
  48K; 131103 и 147487 — оба считаются 128K.
* **Тест `.z80` на 128K зависит от версии:** `(extlen==23) ? (hw>=3) : (hw>=4)`.
  Правило «hw 3 или 4 → 128K независимо от версии» **неверно** для v3,
  где hw 3 — это SamRam (машина класса 48K), а не 128K.

---

## 5. Сопоставление памяти / страницы → физический банк

Ядро имеет 8 банков ОЗУ по 16 KiB (0–7). Загрузчик записывает каждый банк, устанавливая `RAM_ADDR = bank << 14` и передавая 16384 байта (§7.3).

### 5.1 Сопоставление для конкретной машины (формальное)

* **Идентификатор страницы 48K → область адресов:** страница 8 → `0x4000`, страница 4 → `0x8000`,
  страница 5 → `0xC000` (а страницы 0/1/11 — это ПЗУ). На машине с 128K-банками эти
  три области адресов соответствуют **банкам 5, 2, 0** соответственно.
* **Идентификатор страницы 128K → номер банка:** `банк = страница − 3` (страница 3 → банк 0 … страница 10
  → банк 7).

### 5.2 Точное сопоставление BulbuLator

| Источник | Сопоставление |
|---|---|
| `.z80` v1 / плоский образ 48K | последовательное разделение: байты 0..16383 → **банк 5**, 16384..32767 → **банк 2**, 32768..49151 → **банк 0**. |
| `.z80` v2/v3 **128K** | `pg` в диапазоне `[3..10]` → банк `pg-3`; **любая другая страница без предупреждения отбрасывается** (`банк = -1`, запись не выполняется). |
| `.z80` v2/v3 **48K** | `pg5 → банк 5`, `pg4 → банк 2`, `pg8 → банк 0`; **все остальные страницы без предупреждения игнорируются**. |
| `.sna` 48K | банки 5, 2, 0 из 49152 байт после 27-байтового заголовка. |
| `.sna` 128K | банки 5, 2, `paged(=p7&7)` из первых 49152; остальные банки 0..7, исключая `{5,2,paged}`, в порядке возрастания, начиная со смещения `27+49152+4`. |

### 5.3 Предупреждение о коллизии — не делай слепо `pg − 3`

Пространства идентификаторов страниц `.z80` для 48K и 128K пересекаются числово, но означают разное (§2.7). BulbuLator использует **правильное** сопоставление для каждого режима — для 48K он сопоставляет страницы 4/5/8 банкам 2/5/0, *а не* `pg-3` (что дало бы банки 1/2/5 и повредило бы образ). Урок для любой повторной реализации: **сначала выбери режим машины**, а потом уже делай сопоставление. Применение `pg − 3` к странице 8 снэпшота в режиме 48K приведёт к записи в банк 5 вместо банка 0; применение адресной таблицы 48K к снэпшоту в режиме 128K приведёт к его искажению.

Также обратите внимание на поведение **page-drop** в BulbuLator: в режиме 128K любая страница за пределами диапазона 3–10 (например, страницы ПЗУ 0/1/2, Multiface 11 или страница Scorpion с номером > 10) игнорируется; в режиме 48K игнорируются все страницы, кроме 4/5/8. Для стандартного содержимого это правильно (страницы ПЗУ не загружаются в банки ОЗУ), но означает, что банки Scorpion с 8 по 15 никогда не записываются (§8).

---

## 6. Восстановление регистров и состояния процессора

### 6.1 Полный набор восстанавливаемых данных

Из снэпшота BulbuLator восстанавливает: `AF, BC, DE, HL` и их теневые копии `AF', BC', DE', HL'`, `IX, IY, SP, PC, I, R`, режим прерываний `IM`, оба триггера прерываний `IFF1`/`IFF2`, цвет бордюра и защелку страничной организации памяти объёмом 128K `0x7FFD`. Он **не** восстанавливает регистры AY и положение T-состояния (§8).

* `.z80` считывает IFF1 и IFF2 по отдельности (байты 27/28).
* `.sna` сохраняет только IFF2 (байт 0x13, бит 2) и **устанавливает IFF1 := IFF2**.
* `.sna` 48K восстанавливает PC с помощью трюка со сбросом стека (§3.1, с проверкой);
  `.sna` 128K и все файлы `.z80` имеют явный PC.

### 6.2 Вектор DIR T80 — слово за словом

Регистры вставляются прямо в ядро T80 с помощью механизма «DIRSet»: загрузчик записывает широкий вектор состояния регистров в `DIR0..DIR6` (смещения AXI `0x20..0x38`), а затем подаёт импульс на 1-й бит `COMMIT`, чтобы зафиксировать весь вектор во внутренних регистрах T80 за один раз. Вектор имеет **ширину 212 бит**; он передаётся **7 словами**. Седьмое слово (DIR6) соответствует **верхним 20 битам 212-битного вектора**: фабрика фиксирует `ctl_dir[211:192] <= s_wdata[19:0]` и игнорирует верхние 12 битов записываемого слова. Загрузчик записывает обычное 32-битное слово для DIR6, в котором заполнены только нижние 20 битов (верхние биты равны нулю), что не представляет опасности.

| Слово | Смещ. AXI | Упаковка (битовые поля в пределах 32-битной записи) |
|---|---|---|
| DIR0 | 0x20 | `A \| F<<8 \| A'<<16 \| F'<<24` |
| DIR1 | 0x24 | `I \| R<<8 \| SP<<16` |
| DIR2 | 0x28 | `PC \| BC<<16` |
| DIR3 | 0x2C | `DE \| HL<<16` |
| DIR4 | 0x30 | `IX \| BC'<<16` |
| DIR5 | 0x34 | `DE' \| HL'<<16` |
| DIR6 | 0x38 | `IY \| IM<<16 \| IFF1<<18 \| IFF2<<19` (используются только младшие ~20 бит) |

Итак, расположение битов в DIR6 таково: биты 0–15 = IY, биты 16–17 = IM, бит 18 = IFF1, бит 19 = IFF2.

### 6.3 Как остальные биты соотносятся с записью в AXI

* **Бордюр** → `PORT_FE` (`[2:0]`). Источник: `.z80` v1 `(d[12]>>1)&7`; `.sna`
  `d[26]&7`.
* **Страничная организация** → `PORT_7FFD` (`[5:0]`). Источник: маскированное значение `p7ffd`, вычисленное в
  §2.5 / §3.2 (`0x30` для 48K).
* Оба порта фиксируются битом 0 `COMMIT` (port-commit) *до* того, как
  вектор DIR будет зафиксирован.

---

## 7. Аппаратный конвейер загрузки BulbuLator

### 7.1 Таблица регистров AXI GP0 (важно для загрузчика)

| Офф | Название | Используемые биты | Значение |
|----:|---|---|---|
| 0x00 | VERSION | r/o | `0xB01B0009` |
| 0x04 | CONTROL | бит 0 HALT, **бит 2 RESET+wipe** | управление FSM ядра |
| 0x08 | STATUS | бит 0 — HALT_ACK, бит 1 — RAM_BUSY, **бит 2 — reset_busy** | состояние ядра |
| 0x0C | COUNTER | — | (диагностика) |
| 0x10 | RAM_ADDR | 17-битный, автоинкремент | адрес записи в «бэкдор»-ОЗУ |
| 0x14 | RAM_DATA | байт | данные записи в «бэкдор»-ОЗУ (адрес автоинкрементируется) |
| 0x18 | SCRATCH | — | (диагностика) |
| 0x20–0x38 | DIR0..DIR6 | 212-битный вектор (DIR6 = верхние 20 бит) | ввод данных в регистр T80 |
| 0x3C | PORT_7FFD | `[5:0]` | защелка страничной организации памяти на 128 К |
| 0x40 | PORT_FE | `[2:0]` | бордюр |
| 0x44 | COMMIT | бит 0 — подтверждение порта, бит 1 — DIRSet | импульсы защелки |
| 0x60 | MACHINE_ID | r/o | `0x00805A58` |

> **Примечание к комментарию в заголовке Verilog:** комментарий к карте регистров в файле `axi_ctl.v`
> описывает только CONTROL bit0 / STATUS bit0/bit1. **Бит 2 в обоих регистрах
> используется функцией `machine_reset()`, но не упомянут в этом комментарии** — он действительно
> существует и играет важную роль (ФСМ холодного сброса/очистки). (Регистры OSD/клавиатуры
> 0x48–0x5C тоже есть, но они здесь не рассматриваются.)

### 7.2 Фаза 1 — сброс при загрузке (очистка), затем HALT

Это выполняется в **начале как** `load_z80`, так и `load_sna`, *до* любых записей, зависящих от синтаксического анализа. `machine_reset()`:

```
1. CONTROL = 0x4              // pulse RESET+wipe (the F11 cold-reset FSM)
2. wait STATUS bit2 == 1      // reset_busy ASSERTS  (up to 500000 iters)
3. wait STATUS bit2 == 0      // reset_busy CLEARS   (up to 8000000 iters)
                              //   — the wipe+reset is now complete
4. CONTROL = 1                // assert HALT to the T80 core
5. wait STATUS bit0 == 1      // HALT_ACK
```

Ожидание **0 → 1 → 0** на сигнале `reset_busy` сделано специально: загрузчик сначала ждет, пока сигнал `busy` *поднимется*, и никогда не считает начальное значение 0 как «завершено». На старых битстримах, где отсутствует бит 2 CONTROL, это сводится к небольшой задержке + HALT (без аппаратной очистки).

**Почему важен полный сброс с очисткой.** Без него ядро по-прежнему будет хранить *прежнюю* программу в ОЗУ, состояние AY, состояние ULA и настройки страничной организации памяти. Наложение нового снэпшота поверх этого оставляет устаревшие байты в страницах, в которые снэпшот не записывается, и — что особенно заметно — приводит к тому, что **AY-3-8912 продолжает издавать тот тон, на который он был запрограммирован в последний раз**, так что новая загрузка может начаться с непрерывного визга. «Холодный» сброс обнуляет ОЗУ, сбрасывает AY/ULA и возвращает страничную организацию в известное состояние, давая каждой загрузке чистый лист. (Обратная сторона: см. §8 — поскольку AY сбрасывается, а регистры AY из снэпшота *не* перезаписываются, музыка объёмом 128K может звучать неверно, пока запущенная программа не инициализирует AY заново.)

### 7.3 Этап 2 — Потоковая запись в ОЗУ

Для каждого банка, в который нужно записывать (согласно §5):

```
RAM_ADDR = bank << 14;             // 16 KiB-aligned
for (i = 0; i < 16384; i++) {
    RAM_DATA = data[i];            // write byte; address auto-increments
    while (STATUS & 0x2) {}        // poll RAM_BUSY AFTER the write, spin until clear
}
```

> Опрос RAM_BUSY происходит только **после** записи каждого байта — опроса перед записью
> нет.

### 7.4 Этап 3 — инициализация порта и фиксация состояния порта

```
PORT_7FFD = p7ffd;     // §2.5 / §3.2 (masked to [5:0]; 0x30 for 48K)
PORT_FE   = border;    // [2:0]
COMMIT    = 0x1;       // port-commit pulse — latches 7FFD + FE
```

### 7.5 Этап 4 — запись в регистр (DIRSet)

```
write DIR0..DIR6 (7 words) to GP0 + IJ_DIR0 + 4*k   // §6.2
COMMIT = 0x2;          // DIRSet pulse — latches the whole 212-bit vector
                       //   into the T80's registers
```

### 7.6 Этап 5 — продолжение

```
CONTROL = 0;           // release HALT; the core runs from the injected PC
```

Отдельного шага «сброса» нет — `CONTROL = 0` *и есть* возобновление работы. Порядок действий между фазами **обязателен**: порты должны быть зафиксированы (бит 0) до того, как будет зафиксирован вектор DIR (бит 1), а `CONTROL = 0` — это заключительное действие.

### 7.7 Фактические данные

* Браузер запускает `load_snapshot` только для файлов с расширениями `.z80`/`.sna`.
* `load_snapshot` считывает в DRAM не более `sizeof(snapbuf)` = **160 КиБ (163840 байт)**
  и **отбрасывает файлы короче 30 байт**.
* Перед вставкой OSD отключается, а управление экраном передаётся игре
  (чтобы пользователь видел снэпшот, а не меню, когда ядро возобновит работу).

---

## 8. Нюансы, крайние случаи и ограничения

В этом разделе перечислены реальные, заметные пользователю ограничения текущей реализации. Некоторые из них важны при повседневном использовании; другие дают сбой только при некорректных данных.

### 8.1 Нюансы форматирования, которые должен учитывать каждый парсер

* **7-й бит R** находится в бите 0 байта 12 заголовка `.z80`, а не в байте 11.
  Объедини их. BulbuLator так и делает.
* **`.z80` AF / AF'** хранятся в порядке A-F, *а не* как слово в формате little-endian.
* **Ограничение значения байта 12 == 0xFF до 0x01** — это настоящая историческая особенность `.z80`;
  BulbuLator её не применяет (в современных файлах это несущественно, но является строгим
  отклонением).
* **Маркер окончания RLE в v1 и v2/v3:** в v1 — `00 ED ED 00`; в v2/v3 его нет (разделителем служит
  слово длины). Если их перепутать, произойдёт переполнение или усечение.
* **Пропуск одиночного ED** и **2-байтовый сеанс ED** — самые тонкие
  правила сжатия; декодер, игнорирующий их, теряет синхронизацию.
* **Счётчик RLE занимает один байт** (максимальный сеанс — 255 на код).
* **12-битовые биты 4 и 5 в первом байте файлов `.z80` версий v2/v3 (SamRom/сжатые) не имеют значения** —
  сжатие по блокам подразумевается словом длины блока (`0xFFFF` = необработанные данные).
* **55-байтовые заголовки `.z80` версии 3.0x** (с байтом 86 #1FFD) отклоняются некоторыми
  эмуляторами; только слово длины (23/54/55) надёжно указывает на вариант.
* **Сдвиг аппаратных кодов на 3–6 между v2 и v3** (§2.5). Коды 7 и 8 оба означают
  +3; код 9 = Pentagon; код 10 = Scorpion (16 страниц, а не 8).
* **Счётчики T-состояний `.z80`:** младший счётчик отсчитывает *вниз* от 17471 (17726 в версии 128K), старший
  отсчитывает *вверх* по модулю 4; вместе они определяют твоё положение в пределах 69888 (70908 в 128K)
  T-состояний кадра. (В старом тексте nvg было указано 17472 — исправлено на 17471.)
* **Байт прерывания `.sna`:** определён только бит 2 (IFF2) — маска `& 0x04`.
* **`.sna` не сжимается**, поэтому работает диспетчеризация по размеру.

### 8.2 Крайний случай со стеком `.sna` в 48K (с защитой)

Если `SP` не находится в диапазоне `0x4000..0xFFFE`, то байты PC, помещённые в стек, отсутствуют в сохраненной ОЗУ (они были в ПЗУ или произошёл перенос `SP+1`). **BulbuLator защищает чтение**, поэтому он никогда не извлекает PC из-за пределов образа ОЗУ, и PC детерминированно возвращается к **0** (байты PC заранее обнулены, а `zregs z = {0}` инициализирует структуру регистра нулями). Для любого корректно сформированного 48K-файла `.sna` эта защита никогда не срабатывает. Кроме того, два байта, расположенные непосредственно ниже исходного SP, действительно перезаписываются помещённым в стек PC в каждом 48K-образе ОЗУ `.sna` — это сделано специально, а не является ошибкой.

### 8.3 Блокировка страничной организации памяти 48K

При любой загрузке 48K BulbuLator принудительно устанавливает `p7ffd = 0x30`: банк 0 по адресу `0xC000`, 48K BASIC ROM (бит 4 = 1), экран = банк 5, **страничная организация памяти заблокирована (бит 5 = 1)**. Это эмулирует фиксированную карту памяти объёмом 48K и не даёт запущенной программе случайно перенастроить страничную организацию.

### 8.4 Состояние AY / TurboSound НЕ восстанавливается

Это самое важное ограничение, заметное пользователю. `inject_finish` **не записывает регистры AY**, а `machine_reset` **выполняет полный сброс AY** перед каждой загрузкой. Расширенный заголовок `.z80` *действительно* содержит 16 регистров AY (смещения 39–54) и выбранный регистр (смещение 38), но BulbuLator их игнорирует. **Последствие:** на снэпшоте объёмом 128K, где раньше играла музыка или звуковые эффекты, AY запускается в тихом состоянии/сброшенным; звук будет неверным, **пока запущенная программа сама не инициализирует AY заново** (большинство программ это делают в течение одного-двух фреймов, так как перезаписывают AY при каждом прерывании). Программы, которые настраивают AY один раз и больше не возвращаются к этому, потеряют звук.

### 8.5 Нереализованные / планируемые режимы работы

BulbuLator реализует ровно две схемы банков: **стандартная 48K** (страницы 4/5/8 → банки 2/5/0) и **стандартная 128K** (страницы 3–10 → банки 0–7). Всё остальное подпадает под схему 128K без каких-либо исключений:

* **Scorpion 256K (hw 10):** имеет 16 страниц → банки 8–15. BulbuLator **не**
  поддерживает страницы выше 10; эти банки просто игнорируются. Не поддерживается.
* **+2 / +2A / +3 (hw 7/8/12/13):** вторичный порт страничной организации памяти +3/+2A `0x1FFD`
  (байт 86) никогда не считывается; страничная организация памяти для диска и специальных устройств не моделируется. Рассматривается как
  общий 128K.
* **Interface I / DISCiPLE / Plus-D / Multiface:** их флаги страничной организации ПЗУ и страницы ПЗУ
  страницы игнорируются (правильно — это не ОЗУ — но снэпшот, зависящий от IF1,
  не будет отражать состояние IF1).
* **Pentagon 128 (hw 9):** страничная организация памяти ≈ стандартная 128K, так что в целом всё работает.
* **Timex (hw 14/128):** не моделируется.

### 8.6 `.sna` 131103 и 147487 оба загружаются правильно (ограниченное чтение)

Загрузчик на 128K проходит по `b = 0..7`, пропускает `{5, 2, paged}` и записывает по одному конечному банку размером 16 KiB на каждый не пропущенный индекс — т. е. `8 − (количество уникальных начальных банков)` банков. Это **5** для файла 131103 (paged ∉ {2,5}) и **6** для файла 147487 (paged ∈ {2,5}), что точно соответствует нужному количеству для каждого, поэтому оба размера загружаются правильно. Каждое последующее чтение теперь **ограничено длиной файла** (`if (ex+16384 > d+len) break;`), поэтому короткий или некорректно сформированный файл никогда не заставит цикл читать данные за пределами снэпшота. (Это ограничение отсутствовало в более ранней версии — см. §8.11.)

### 8.7 Игнорируемые расширенные поля `.z80`

За пределами `p7ffd` (d[35]) BulbuLator не считывает ни одного из следующих полей: T-состояние lo/hi (d55–58), флаги Spectator/MGT (d58–60), регистр выбора AY/звукового чипа (d38) и дамп AY (d39–54), слова джойстика/раскладки клавиш (d63–82), байты DISCiPLE (d83–85), байт +3 #1FFD (d86), флаг модифицированного оборудования (бит 7 в d37) или SamRom.

### 8.8 Ограничение по размеру и отклонение файлов

* Файлы **больше 160 KiB без предупреждения обрезаются** до размера `snapbuf` (163840 байт). Канонический
  файл `.sna` размером 147487 байт (128K) помещается; гипотетический снэпшот большего размера —
  нет. Пользователь об этом не узнает.
* Файлы **меньше 30 байт отбраковываются**.

### 8.9 Отсутствие возобновления с точностью до цикла

PC вставляется, а ядро сразу же освобождается. **Отсутствует выравнивание по T-состоянию, синхронизация с конкурентной памятью и точное до цикла положение кадра**. Счётчики T-состояний `.z80` v3 не используются. Для подавляющего большинства игр и демо это незаметно; для редких эффектов с точным растровым отображением, которые зависят от положения T-состояния в пределах подкадра на момент создания снэпшота, первый кадр может отличаться.

### 8.10 Загрузка является деструктивной (по замыслу)

Каждая загрузка — это полный холодный сброс + очистка + повторная инжекция. Нет ни «слияния», ни «возобновления работы предыдущей машины». Это сделано специально и именно благодаря этому загрузки повторяются и не содержат устаревших состояний.

### 8.11 Чрезмерное считывание 128K `.sna` в страничном банке 5/2 — ИСПРАВЛЕНО

Когда биты `[2:0]` кода `7FFD` выбирают банк **5 или 2** в качестве страничного банка `0xC000`, набор пропусков `{5, 2, paged}` сводится к двум различным значениям, поэтому цикл записи в конце файла записывает **шесть** банков — это правильно для настоящего файла 147487 (который содержит шесть конечных банков). Прежний код считывал эти шесть фрагментов без условий, поэтому файл *131103*, в котором страничный банк ∈ {2,5} (короткий/некорректно сформированный файл), считывал 16 КиБ за пределами его данных. Теперь цикл **ограничивает каждое чтение длиной файла** и вызывает `break`, если банк выходит за пределы EOF, поэтому он загружает только то, что есть, и никогда не считывает лишнего.

### 8.12 Ограничения декодера RLE — ИСПРАВЛЕНО

Встроенный декомпрессор версии v1 и `z80_unrle` ранее проверяли границы только для пары экранирующих символов `ED ED` (`i+1 < len`), а затем считывали байты счётчика и значения (`d[i+2]`, `d[i+3]`) без их проверки — поэтому урезанный блок, у которого заключительная пара `ED ED` находилась в самом конце, мог считывать до двух байтов за пределами проанализированной области. Теперь проверка эскейпа выполняется по условию `i+3 < len` (а в `z80_unrle` — `i+3 < clen`), что гарантирует, что байты счисления и значения находятся в допустимом диапазоне. В корректном блоке всегда присутствуют все четыре байта, поэтому на правильно сформированные файлы это не влияет.

### 8.13 Сброс/очистка тихо пропускаются при работе со старым битстримом

`machine_reset` ждёт сигнала `reset_busy` (бит 2 STATUS) с ограниченным количеством повторений (≈500 тыс., затем ≈8 млн итераций), а затем продолжает работу независимо от результата. На битстриме, где не реализован бит 2 CONTROL/STATUS, `reset_busy` никогда не активируется: первый цикл заканчивается таймаутом, второй сразу завершается, и загрузка **незаметно ухудшается до «кратковременной задержки + HALT» без очистки ОЗУ и сброса AY/ULA**. В сборке `0xB01B0009`, о которой идёт речь в этом документе, бит 2 реализован, и полная очистка выполняется; ухудшение качества работы имеет значение только в том случае, если этот образ загрузчика запускается на более старом ядре.

---

## 9. Матрица верификации / тестирования

| № | Формат / режим | Свойства файла | Что проверять |
|--:|---|---|---|
| 1 | `.z80` v1, 48K, raw | PC@6≠0, байт 12, бит 5=0 | Загружается; бордюр = `(d12>>1)&7`; банки 5/2/0 верны; PC возобновляет работу. |
| 2 | `.z80` v1, 48K, RLE | байт 12, бит 5 = 1, маркер конца `00 ED ED 00` | Распаковывается ровно до 49152; обрабатываются последовательности ED и одиночный проход ED. |
| 3 | `.z80` v1, R-бит7 установлен | байт12 бит0 = 1 | Восстановленное R имеет установленный бит 7 (проверь с помощью программы, которая считывает R). |
| 4 | `.z80` v2, 48K | extlen=23, hw=0 | 3 блока (страницы 4/5/8 → банки 2/5/0); обработан необработанный блок `0xFFFF`. |
| 5 | `.z80` v2, 128K | extlen=23, hw=3 | `is128` true (hw≥3 для v2); 8 блоков (страницы 3–10 → банки 0–7); 7FFD = `d[35]&0x3F`. |
| 6 | `.z80` v3, hw=3 | extlen=54, hw=3 | Рассматривается как **48K** (v3 hw=3 = SamRam, класс 48K) — `is128` false (hw≥4 для v3). Подтверждает тест, зависящий от версии. |
| 7 | `.z80` v3, 128K | extlen=54, hw=4 | `is128` true; 8 банков; страничная организация памяти от `d[35]`. |
| 8 | `.z80` v3.0x | extlen=55 (+3) | Загружается по общему пути 128K; байт-86 #1FFD игнорируется (в документации указано такое отклонение). |
| 9 | `.z80` Scorpion | hw=10, 16 страниц | Банки 8–15 отброшены — **известно, что не поддерживаются**; убедись, что программа хотя бы не вылетает. |
| 10 | `.sna` 48K | размер 49179 | `len<131000` → 48K; PC снят со стека; SP += 2; два байта на старом SP — это байты PC. |
| 11 | `.sna` 48K, SP в ROM | SP < 0x4000 | Срабатывает защита → чтение за пределами RAM не происходит; PC детерминированно возвращается к **0** (инициализация нулем). |
| 12 | `.sna` 128K | размер 131103 | `len≥131000`; явное значение PC@49179; 7FFD@49181 с маской `&0x3F`; банки 5/2/страничный + оставшиеся пропускаются по возрастанию {5,2,страничный}. |
| 13 | `.sna` 128K, страничная организация∈{2,5} | размер 147487 | Загружается правильно: шесть конечных банков (8 − {5,2}) считываются в порядке возрастания, ограниченном длиной файла. |
| 14 | 128K теневой экран | 7FFD бит 3 = 1 | Отображается экран из банка 7, независимо от страничного банка `0xC000`. |
| 15 | Снэпшот музыки AY | 128K с воспроизведением AY | Звук отсутствует/искажён при возобновлении **до тех пор, пока программа не инициализирует AY заново** — подтверждает §8.4. |
| 16 | Холодный сброс/очистка | загрузка на фоне шума и визга AY | Визг прекращается при загрузке (machine_reset сбрасывает AY); страницы ОЗУ, не входящие в снэпшот, считываются как 0. |
| 17 | Отказ/усечение | файл <30 байт; файл >160 КиБ | файл <30 байт отклоняется; файл >160 КиБ усекается (документ, не обязательно исправлен). |
| 18 | Бордюр + IFF | любой снэпшот с EI и цветным бордюром | Бордюр совпадает; прерывания включены (`.sna`: IFF1 = IFF2). |

---

*В этом документе описана сборка BulbuLator `VERSION 0xB01B0009`. Если форматы файлов допускают поведение, которое BulbuLator не реализует (банки Scorpion, страничная организация диска +3, восстановление AY, точное по циклам синхронизация, ограничение 0xFF в 12-м байте, SamRom, Timex), то это отмечено выше как отклонения или ограничения, а не просто молчаливо опущено.*
