Alex-Electron/ZX_BulbuLator/docs/CONCEPT.ru.md

# Концепция

Languages: [English](CONCEPT.md) · **Русский**

> Разработчик: Александр Лавринович · GitHub: https://github.com/Alex-Electron · Электронная почта: lavrinovich.alex@gmail.com

BulbuLator запускает открытое ядро ZX Spectrum на плате EBAZ4205 (Zynq-7000). Опубликованная сборка работает на ядре Atlas `zx`; ядра MiST / MiSTer остаются в качестве резервного варианта для машин, которые не поддерживает Atlas. Главное архитектурное отличие от оригинальных ядер — это память: вместо внешнего контроллера SDRAM оперативная память Spectrum размещена в встроенной BRAM и доступна через AXI. Уже одно это устраняет целый ряд проблем с синхронизацией и трассировкой на этой плате.

## Ядра

Для начала три: ZX Spectrum 48K, ZX Spectrum 128K и Pentagon 128. Для Pentagon требуется точная синхронизация INT, а это значит — 320 строк на кадр.

## Устройства ввода

Сначала клавиатура PS/2. Она подключается к двум выводам FPGA с диодами 1N4148 и подтяжкой 10 кОм до 3,3 В. Далее идут джойстики (Kempston на разъёме DB9, Sinclair) и геймпады Dendy / Sega, считываемые либо через сдвиговые регистры 74HC165, либо напрямую.

## Звук

Четыре источника. AY-3-8912 / YM2149F — это стандартный чип на 128K. Turbo Sound добавляет второй AY для FM. General Sound может работать либо как эмулированный GS Z80 с памятью сэмплов внутри FPGA, либо переключаться на ARM Cortex-A9 с выводом через I²S. Звуковой сигнал — это обычный 48K-динамик.

## Хранение данных и файловая система

Сначала виртуальные диски: VG93 / WD1793 TR-DOS, где ARM считывает образы `.trd` и `.scl` с SD-карты и передаёт их в FPGA по AXI. DivMMC / ESXDOS обеспечивает современный путь загрузки с эмулируемой внутри SD-картой.

Часть, которую я больше всего хочу собрать, — это физический дисковод для дискет. Если вывести сигналы WD1793 (`STEP`, `DIR`, `WDATA`, `WGATE` и остальные) на GPIO через преобразователь уровней 3,3 В → 5 В, то можно будет напрямую подключить настоящий 3,5-дюймовый или 5,25-дюймовый дисковод.

## Видео

VGA и HDMI. Расширительная плата для этого уже собрана и работает. Сканирующие линии воспроизводят вид ЭЛТ-монитора.

## Масштабируемость

Расширительная плата с кросс-шиной (ZX BUS / Nemo Bus), чтобы можно было использовать физические периферийные карты Spectrum.

## Идеи, заимствованные из MiST / MiSTer / TSConf

1. Меню OSD. Полупрозрачный файловый выборщик, накладываемый на изображение Spectrum. FPGA
   его рисует; ARM отправляет текст меню по AXI.
2. Сохранение состояний. Останови игру, сохрани состояние Z80 и всю оперативную память на SD-карту
   через ARM, а потом продолжи с того места, где остановился.
3. Эмуляция кассеты. Загружай файлы `.tap` / `.tzx`, перехватывая процедуры загрузки из ПЗУ
   или воспроизводя аудиосигнал в порт кассеты. Вывод аудиовхода позволяет
   подключить телефон или кассетный плеер для подачи реального сигнала.
4. Переключатель ПЗУ. Переключай ПЗУ на лету: Classic 48, 128, +3e, OpenSE BASIC, Gluk
   Reset Service.
5. Soft-USB. Если PS/2 окажется слишком ограничивающим, встройте хост-контроллер USB 1.1
   в логику FPGA без дополнительного PHY-чипа и считывай современные клавиатуры и геймпады
   таким образом.
6. Ускорение. Сними ограничение на частоту Z80 в 3,5 МГц и запусти FPGA на частоте до 56 МГц, чтобы
   пропускать экраны загрузки и длительные вычисления.
7. Сеть. На плате есть физический Ethernet, так что запусти FTP-сервер на ARM
   и копируй игры по сети, не прикасаясь к SD-карте.
