Alex-Electron/ZX_BulbuLator/PROJECT_RULES.md

# BulbuLator / EBAZ4205 — правила проекта

> Этот файл — свод постоянных правил и «гоч», каждая из которых оплачена временем: ложным
> диагнозом, испорченным файлом или сорванной сборкой. Он писался как рабочая памятка, а не
> как документация, поэтому тон резкий и местами повторяющийся — так надёжнее. Ссылки вида
> `файл:строка` указывают на исходники в этом же репозитории.

## Где что живёт

| Что | Где |
|-----|-----|
| **Истина по коду** | ThinkPad `~/bulb-v13`, ветка `master` (гранулярная история) |
| Mac-репозиторий | `BulbuLator/`, ветка `step-15-wip` — **отстаёт**, не пушить без владельца |
| Хэндовер (читать первым) | `research/15-pentagon/HANDOVER_CURRENT.md` |
| Сборка, прошивка, JTAG | только ThinkPad: `ssh thinkpad`, `hw_server` на `:3121` |
| **Тестовый софт и дампы** | `~/Yandex.Disk.localized/DIY/ZX/ZX-Soft/` (в т.ч. `tests/`, `Border/`, `Sinclair/`) |
| Заливка на SD по JTAG | ThinkPad: `research/15-pentagon/tools/put_files.tcl` и `put_big.tcl` |

## 🥇 Точность машин: спорное — в опцию, а не в спор (задание владельца 12.08.2026)

Приоритет номер один — **довести Пентагон до идеала**, то есть убрать расхождения с настоящей машиной.
Правило на все такие работы:

**Если эталоны противоречат друг другу — не выбирать за владельца, а выносить ПЕРЕКЛЮЧАТЕЛЬ в настройки
машины.** И обязательно записывать, ГДЕ и В КАКОЙ СИТУАЦИИ каждая опция нужна: опция без объяснения,
когда её трогать, бесполезна и хуже отсутствия опции.

Живой пример: порт `#FF` у Пентагона. У нас `atlas_core/main.v:883` отдаёт `0xFF` (вслед за MiSTer
`mZX ? ff_data : 8'hFF`), а Sizif-512 `cpld/rtl/video.sv:255-260` отдаёт **атрибут**. Правильного
ответа «вообще» нет — клоны Пентагона расходятся между собой, и софт бывает написан под оба. Значит
это опция машины, а не решение агента.

**Куда класть:** слово `MACHINE_CFG` (`0xBC`). Заняты биты 0-2 (модель, фаза ULA), 4 (снег), 8 (трап
TR-DOS), 9 (сервисная страница), 10, 11-12 (гейт SAA), 13 (NMI), 14-16 (объём ОЗУ). **Биты 0..6
занимать НЕЛЬЗЯ** — у NES там region/palette/sprlimit того же слова. Свободны **17..31**.

**Эталоны для сверки** (правило «сверяться с ЖИВЫМ апстримом» действует и здесь):
- Sizif-512 — `github.com/UzixLS/zx-sizif-512`, каталог `cpld/rtl/` (Pentagon/128/48/+3e, ULAplus,
  всё влезает в CPLD на 1270 макроячеек, то есть по ресурсам он нам не помеха);
- MiSTer ZX-Spectrum — `cores/zx-mister/rtl/`, но копия СТАРШЕ живого апстрима.

## Гочи по железу (оплачены временем)

- **🥇 `stop` по JTAG БЕЗ гарантированного `con` = «оболочка зависла» на ровном месте (оплачено ложным
  диагнозом 20.08).** Мой диагностический скрипт остановил Cortex-A9, упал на неверной команде и до
  `con` не дошёл — процессор остался стоять. Машина в ПЛИС продолжала работать (она тактируется сама),
  поэтому картина была ровно как у зависшей прошивки: интерфейс не отзывается, мейлбокс молчит,
  счётчики главного цикла не растут, а звук и видео живы. Признак, отличающий это от настоящего
  отказа: `stop` отвечает **`Already stopped`**. Правила: состояние читать НЕРАЗРУШАЮЩЕ (`mrd -force`
  работает на живом ядре, останавливать незачем); если `stop` всё же нужен — только `catch {stop}` и
  `con` в конце скрипта, включая пути с ошибкой. Не путать с полуоткрытым бёрстом в S_AXI_HP0
  (замёрзший кадр при живом звуке) — там нужен настоящий POR, это другой отказ.
- **🥇 БУФЕР МЕЙЛБОКСА `FS_BUF (0x0F900000)` — ОБЩИЙ С ФАЙЛОВОЙ СЛУЖБОЙ ПРОШИВКИ; данные в нём живут
  до первой же её операции (оплачено испорченным `BOOT.BIN` и незагружающейся платой 20.08).**
  `dow` образа идёт минуты, потом команда записи может ждать свободного интерфейса ещё минуты — и за
  это время прошивка читает в ТОТ ЖЕ буфер свой файл. У меня это был набор ПЗУ (ровно 65536 Б,
  читается при сбросе машины и смене набора): на карту легли 64 КБ кода Z80 плюс остаток образа.
  **Размер файла правильный, `done=1`, `n` = полный размер — и при этом файл негодный.** BootROM
  такой заголовок не принимает: плата не грузится И запирает отладочный доступ (ядра видны как
  `Running`, но память по JTAG не читается вовсе, включая SLCR; лечится только холодным старом, а
  дальше — только кардридером). Правила: заливать `tools/put_retry.tcl` (он сверяет буфер по точкам,
  включая НАЧАЛО, перед КАЖДОЙ попыткой, а после записи читает файл обратно командой 12 и сверяет);
  никогда не считать буфер своим, пока команда не принята; размер сверять листингом каталога.
  **Признак этой порчи:** первые 65536 байт не совпадают, дальше файл верен; начало выглядит как
  `f3 c3 …` (`DI : JP` — код Z80), а не как таблица векторов ARM (`fe ff ff ea …`).
- **Каждое окно оболочки обязано сохранять свой фон в СТЕКЕ (`box_push`/`box_pop`), исключений быть
  не должно.** Слоты, расписанные по договорённости, дважды дали артефакты (подменю, оставшееся на
  фоне; обрывки настроек от визарда), а окно копирования, закрывавшееся полной перерисовкой канвы,
  дало «окно исчезло, а прогрессбар бежал» — через раз, потому что это вопрос момента. Сторож:
  `tools/audit_boxes.py` (запускать после добавления любого окна). Диагностика на плате — счётчики
  `g_bst_leak` (каркас починил сам), `g_bst_over` (глубже стека), `g_bst_under` (лишнее закрытие).
- **Мейлбокс молчит, пока владелец работает в интерфейсе, и это НЕ поломка.** `fs_service` зовётся
  только из главного цикла, а открытое меню или модальное окно до него не доходят (bg_pump под
  модальным намеренно не трогает файловую службу). Одиночная попытка заливки в такой момент даёт
  `done=0, err=0` — то же, что при настоящем отказе. Заливать `tools/put_retry.tcl`: данные уходят
  ОДИН раз (`dow` больших образов идёт минуты, терять их нельзя), а команда повторяется, пока
  прошивка её не возьмёт. Перед долгой заливкой просить владельца выйти в навигатор.
- **НИКОГДА не делать `rst -system` на живой плате.** Работающий PL продолжает писать в S_AXI_HP0,
  пока PS в сбросе → полуоткрытый бёрст залипает в PS-овом AFI-FIFO → `hpw` (0x43C000AC, старшие 16 бит)
  застревает на 1, кадр в DDR замерзает при живом звуке. Не лечится ни PCAP-перепрошивкой, ни
  `FPGA_RST_CTRL`, ни level-shifter'ами — **только холодный старт (POR)**.
- Смена ядра — штатным `pl_reload` (fs cmd 9): он делает QUIESCE (`GP0+0x114`, ждёт STATUS bit3) и
  изоляцию `SLCR_LVLSHFT=0`. QUIESCE спасает только пока PL-мастера живы.
- Горячий ARM по JTAG: **только** `rst -system` + `ps7_init` + `ps7_post_config` + `dow` + `con`
  (тёплый `dow` ненадёжен) — и помнить про гочу выше.
- **Ввод NES:** `joypad_clock` (`nes.v:387`) — это УРОВЕНЬ на весь такт чтения CPU, а не импульс.
  Сдвигать регистр джойпада **только по спаду** (как `nestang_top.sv:452`). Сдвиг по фронту = процессор
  получает уже сдвинутое значение: все кнопки съезжают на бит, а 8-е чтение отдаёт вдвинутую `1'b1` =
  фантомная зажатая кнопка (в меню мультикарта = вечное листание). Исправлено в CE20.
- **Нельзя проверять ввод по SMB после титульника** — аттракт-демо само ведёт Марио вправо по 1-1
  с обычным HUD. Проверять тем, чего в демо не бывает: Select на титуле (курсор 1P↔2P) или пауза.
- fs-мейлбокс `0x0F700000`: `cmd` +4, `done` +8, `err` +C, `len` +10, `n` +14, путь +0x200, путь2 +0x400,
  вывод +0x800, буфер `0x0F900000`.
  Команды: 1 LIST, 2 WRITE, 3 DELETE, 4 RENAME, 5 MKDIR, 6 COPY, 7 APPEND, 9 PL RELOAD, 10 NES LOAD,
  11 KEY INJECT (обслуживается даже из модального ожидания клавиши), **12 READ файла → буфер** (v0.15.170), 13 WRITE-AT (v0.15.428), **14 FRAME SNAPSHOT (v0.15.435): три буфера кадра машины → FS_BUF с шагом 0x10000 за ~3 мс** — единственный честный способ получить ОДИН кадр по JTAG: прямое чтение `0x0FF00000` длится ~15 с и даёт смесь сотен кадров (тройной буфер вращает роли каждый кадр), а `CONTROL bit0 HALT` морозит только процессор, не ULA. Инструмент `snap14.py`.
- **🥇 `mrd -force -value` ОТДАЁТ ДЕСЯТИЧНОЕ ЧИСЛО, а не шестнадцатеричное (оплачено 18.09 ложным
  «в ПЛИС не B0196»).** Разбор вывода через `int(x, 16)` даёт правдоподобный мусор: `2954559894` —
  это `0xB01B0196`, а не `0x2954559893`. Признак промаха: значение версии длиннее 32 бит или
  `MACHINE_CFG` не похож на известный. Разбирать `int(x, 10) & 0xFFFFFFFF`.
- **🥇 ПУТЬ В МЕЙЛБОКС ПИСАТЬ ТОЛЬКО БАЙТАМИ (`mwr -force -size b`), и это НЕ косметика.** По умолчанию
  `mwr` пишет СЛОВО; запись слова по невыровненному адресу xsdb округляет к выровненному, поэтому все
  символы ложатся в одно слово и в буфер уходит ПУСТОЙ путь. Пустой путь FatFs читает как корень —
  значит сломанный инструмент «работает» на `0:/` и падает с `err=5` (FR_NO_PATH) на КАЖДОМ
  подкаталоге. Образец верной записи — `proc wstr` в `tools/put_retry.tcl`.
- **Сборки ядер живут в `/tmp/bNNNN-build/`** (самодостаточная копия `sources/build` со ссылками на
  `cores/zx` и `cores/hdmi`), а НЕ в `sources/build` — там дерево от 11.09. Заводить новую так:
  `cp -a /tmp/b<прошлая>-build /tmp/b<новая>-build`, снести `*.bit *.log *.jou`, положить правленые
  файлы, `vivado -mode batch -source build.tcl`. ⚠ **`research/15-pentagon/assemble.sh` — ОСТАТОК ОТ
  ШАГА 13 и не работает** (считает корень репозитория на уровень выше, падает «Cores missing. Run:
  /home/<пользователь>/get_deps.sh»). Боевой — `research/15-pentagon/sources/assemble.sh`. И помнить:
  он делает `rm -rf build`, то есть затирает дерево сборки.
- **Регистры дисплея только на запись:** `SCR_POS` (0xD0) и `SCR_SCALE` (0x118) читаются как `DEADBEEF`.
  Живые значения смотреть по символам ELF: `arm-none-eabi-nm loader.elf | grep opt_mscr` → `mrd` по адресу.
  Адреса символов **сдвигаются при каждой сборке** — брать из свежего elf, иначе прочитаешь мусор.
- **fs cmd 12 (READ): `len` — это ЗАПРОШЕННЫЙ ЛИМИТ, а не размер файла** (в прошивке: «up to g_fs_len
  bytes»). Не выставил — прочитаешь столько, сколько осталось в поле с прошлой операции, и получишь
  ОБРЕЗАННЫЙ файл; возвращаемый `len` тоже равен лимиту, а не числу прочитанных байт. Перед чтением
  писать `len` = 65536 (или 0 — тогда прошивка сама возьмёт 65536). **Сколько байт прочитано
  ФАКТИЧЕСКИ — лежит в поле `n` (+0x14)**, гадать по содержимому не нужно (это уточнение снято
  советом 02.08; именно гадание испортило `bulbulator.ini` 31.07: прочитал 630 Б из 2 КБ и записал
  обрезок назад).
- ❌ **ОТМЕНЕНО 02.08: «`err` не обнуляется при успехе» — ЭТО НЕВЕРНО.** Прошивка ставит `g_fs_err = 0`
  в начале КАЖДОЙ команды (`loader_main.c:1463`, с 25.07). Я записал эту гочу 31.07 по ложному следу:
  «пропавшие» 20 файлов на самом деле записались, а ложный FAIL давал таймаут поллинга в 45 с на
  многомегабайтной записи — то есть лечится увеличением таймаута по размеру, а не обнулением `err`.
  Обнулять самому не вредно, но искать причину надо в таймауте и в гонке на `done`.
- **🥇 Состояние клавиатуры НЕ проверять на плате после тёплой перезагрузки.** Клавиатура питается
  независимо от ПЛИС (свои 4k7 и +5 В), поэтому `rst -system` / загрузка с карты перезапускают плату,
  но НЕ её — лампы и внутреннее состояние переживают перезагрузку. Симптом (07.08): NumLock «срабатывал
  только со второго раза»; после ХОЛОДНОГО старта лампа загорелась сама и всё пошло с первого нажатия,
  то есть дефекта в прошивке не было. Сам переключатель (`loader_main.c:9438`) верен, и стартовое
  зеркалирование лампы из ini уже сделано в v0.15.215. Правило: любые странности ввода сначала
  перепроверять НА ХОЛОДНОМ СТАРТЕ, иначе диагноз ставится по чужому состоянию. (Тем же может
  объясняться и невоспроизведённый отказ загрузки TAP от 06.08 — не доказано, но правдоподобно.)
- **Имя файла в мейлбоксе и в браузере обрезается на 96 символах (`NAMELEN`), МОЛЧА.** Файл при этом
  записывается с ПОЛНЫМ именем и читается по нему нормально (проверено: имя 99 символов, cmd 12 отдаёт
  ровно те же байты), но в листинге (cmd 1) видно только 96 знаков — у TOSEC-имён отрезает как раз
  расширение, и вывод выглядит как «файла нет». Я на этом уже построил ложный диагноз. Следствие: длинные
  имена **непригодны в навигаторе** (открывать он будет обрезанное имя) — такие файлы переименовывать
  (cmd 4) при заливке. Не путать с `FF_MAX_LFN`: у FatFs предел 255, обрезает НАШ буфер.
- **Правка ini с хоста только целиком и с проверками:** склеивать «прочитанное + своя строка» нельзя —
  обрезок без перевода строки слипается с твоим ключом (`pent10\0\0region=2`, прошивка законно
  игнорирует). Разбирать в ключ=значение, отбрасывать строки без `=` и байты вне ASCII, проверять
  число ключей и размер, писать целиком, читать обратно и сверять байт-в-байт.
- **🥇 ПОСЛЕ ЗАГРУЗКИ С КАРТЫ НАВИГАТОР УЖЕ ОТКРЫТ (`showbrowser at boot` = YES по умолчанию), а канва
  `0x0F800000` после тёплой перезагрузки НЕСВЕЖАЯ — показывает прошлый сеанс.** Оплачено 11.09: «первый F12
  не срабатывает» — на деле он ЗАКРЫВАЛ навигатор, стрелки уходили в машину, а снимок канвы врал. Состояние
  оболочки читать по её переменным через `arm-none-eabi-nm loader.elf` + `mrd`: `browser_on`, `osd_on`,
  `bcursor`, `fcount`, имя под курсором `flist[bcursor]` (шаг `NAMELEN+1`, адрес выравнивать по 4 — `mrd -bin`
  с невыровненного адреса отдаёт пустоту). Инструменты на ThinkPad: `/tmp/nav.py <клавиши>` (нажать и доложить
  состояние), `/tmp/open_nav.py` (открыть навигатор с проверкой, не жать F12 вслепую).
- **Не инжектить клавиши (cmd 11), пока владелец работает в интерфейсе:** в режиме захвата визарда
  маппинга ЛЮБАЯ клавиша = назначение кнопки, то есть инжект молча перепишет его настройку.
- **С ядра CE28 кадр клавиатуры собирает ФАБРИКА, а не ARM.** `KBD_DATA` бит10 = «расширенная» (была
  последовательность `E0`), префиксы `E0`/`F0` наружу не идут (`E1` идёт — на нём матчер Pause), а
  байты-ответы устройства (`FA` ACK, `AA` BAT, `EE`, `FE`) в FIFO скан-кодов не попадают вовсе: они
  уходят в ящик `0x13C`. Признак умения — `LOAD_CAPS` бит3; прошивка держит старый программный путь
  для ядер без него, поэтому **кэш возможностей обязан сбрасываться при каждой смене ядра**.
- **`0x13C` = собственный регистр диагностики PS/2 оболочки** (машино-независимый):
  `{счётчик ответов[31:24], последний ответ[23:16], ошибки чётности[15:0]}`. Читать PS/2-диагностику
  ТОЛЬКО отсюда. `0xB8` остаётся сырым машинно-зависимым словом (на NES там отладка памяти ядра) —
  на нём уже дважды строились неверные выводы.
- **Инжект (cmd 11) идёт В ОБХОД свёртки префиксов PS/2:** `kbd_data_read` отдаёт значение из очереди
  ДО разбора `E0`/`F0`. Инжектить надо уже свёрнутый код (`0xF4` = стрелка вправо), а не пару
  `E0`+`0x74` — иначе в таблицу зажатых лягут две отдельные «клавиши» `E0` и `74`. Следствие:
  **свёртку префиксов инжектом проверить нельзя в принципе**, только настоящей клавиатурой.
- **cmd 10 (NES LOAD) = `nes_load()`, а не `nes_launch()`:** он только стримит ром в BRAM и НЕ отдаёт
  экран машине (`OSD_CTRL&=~3; osd_on=browser_on=0`) и **не чистит ОЗУ консоли**. При открытом
  навигаторе `joymap_eval` законно держит джойстик в нуле — со стороны выглядит как «игра висит,
  Start не работает». Состояние прошлого запуска (режим 2 игроков, позиция курсора) переживает
  перезагрузку рома. Чистый старт = `cmd 9` (PCAP-перезагрузка ядра) → `cmd 10`.
- **Ввод проверять только тем, чего не делает аттракт-демо.** «Кадр изменился» не доказывает ничего:
  у Tank 1990 за 1.5 с покоя БЕЗ ввода накопилось 8219 различающихся байт. Доказывает курсор меню
  (Select двигает его на строку — видно как сдвиг диапазона строк в дампе кадра).
- **Кадр ZX в DDR — 4bpp, 384×302** (у NES 8bpp, 256×240): один байт = ДВА пикселя, палитра ZX 16 цветов.
  Общий адрес тот же `0x0FF00000`. Перепутать форматы = «каша» вместо картинки.
- **ini пишется ТОЛЬКО ручным «Save config»** (единственный вызов `config_save`) — ручной сейв владельца
  перетирает правки хоста. Править конфиг с хоста: cmd 12 (прочитать) → патч → cmd 2 (записать).
- **FatFs регистронезависим:** `smb.nes` откроет `SMB.NES`. Имена ромов на карте сверять листингом
  (cmd 1), а не додумывать — иначе ложный `err=0xC3` (bad `NES\x1A`) на «отсутствующем» файле.
  Мейлбокс молчит, если процессор не дошёл до главного цикла (открытое OSD-меню, крэш) — проверять
  `state`/`PC` через xsdb: `Xil_ExceptionNullHandler` = ARM упал в исключение.
- Диагностика видео: `0x43C000AC` = `{hpw, nes_act}` (hpw растёт = запись в DDR доходит),
  `0x43C000B8` = счётчик nametable-записей + sticky-биты. Кадр NES: 61440 Б (256×240, 8bpp) @ `0x0FF00000`.
- **🥇 ДВА ФАЙЛА С ОДНИМ ИМЕНЕМ МОДУЛЯ = МОЛЧАЛИВАЯ ПОДМЕНА (оплачено немым SAA1099 много сборок).**
  В `build.tcl` читались и настоящий `zx/src/saa1099.sv`, и `zx/src/saa.v` — ЗАГЛУШКА с тем же именем
  (`out_l=out_r=0`). Побеждает прочитанный ПОЗЖЕ, и звук был выведен в ноль. Лог не молчал:
  `CRITICAL WARNING [Synth 8-9873] overwriting previous definition of module` плюс у всех портов чипа
  `unconnected or has no load`. **После КАЖДОЙ сборки грепать лог на `8-9873` и на `has no load` у
  портов.** Правку общего файла из `cores/` (его копируют шаги 06-14) делать только форком в
  `sources/` (образец — `turbosound_bulb.v`) И выкидывать апстримный из списка чтения, иначе получится
  ровно эта же подмена.
- **🥇 «Софт ведёт себя странно» — СНАЧАЛА проверить режим машины, а не железо.** «Щелчки и обрывы в
  SAA-тесте» и «ETUNES показывает квадраты и висит» объяснялись тем, что машина стояла в **ZX 128K**,
  а софту нужен мегабайт (ETUNES пишет это своим же скроллом). Приборный признак: `MACHINE_CFG` бит0 = 0
  и в `MACH_DBG` «запросов в DDR» = 0. A/B двух ядер снял ложный след до того, как я начал его копать.
- **SAA1099 сидит на `#FF`, где A8 выбирает регистр:** `#01FF` = адресный, `#00FF` = данные (проверено
  по коду ETUNES: `OUT #01FF,#1C` затем `OUT #00FF,#02` = регистр 0x1C Sound enable/Reset). Тот же
  младший байт — системный регистр Beta Disk, поэтому порт делится ПО ВРЕМЕНИ: опция машины
  `MACHINE_CFG [12:11]` AUTO/ON/OFF, и AUTO глушит SAA только при вставленной странице ПЗУ TR-DOS ИЛИ
  живой активности дисковода. **Глушить по липкой `bdi_session` НЕЛЬЗЯ** — она держится до сброса, и
  любой SAA-пак, загруженный с дискеты, замолчал бы на весь сеанс. Чтения `#FF` конфликта не имеют:
  SAA write-only. И **`wd_prepare` в признак активности брать нельзя**: при `EDSK=0` это `img_mounted`,
  уровень на всё время вставленного образа.
- **SAA1099 хочет РОВНО 8 МГц** (на них сходится и формула тона `f = 15625·2^oct/(511−freq)`). Деление
  `spclk 56.6667/7` давало 8.0952 = +20.3 цента на всём. Сделано фазовым аккумулятором. Сам чип
  (`saa1099.sv`, Sorgelig по SAASound) сверен с datasheet в xsim и ВЕРЕН — стенд `tb_saa1099.sv`.
- **Селект чипа TurboSound — только значения `#F8..#FF`** (`d[7:3]` все единицы), как в эталоне
  `cores/zx-mister/rtl/turbosound.sv`. Условие «есть бит `d[4]`» ловило лишнее: ETUNES делает
  `OUT #FFFD,#F6` и уводил второй AY без ведома программы.
- **`0x170 AUD_DBG`** — пики звука по источникам: `{SAA[31:24], AY2[23:16], AY1[15:8], SpecDrum[7:2],
  бипер[1]}`, окно 74 мс. Правило владельца: **не объявлять музыку рабочей без пик-метра.** Ноль на
  тишине ничего не доказывает — нужен положительный отсчёт.
- **TS-FM у нас ЕСТЬ, и это YM2203 (OPN), а не OPL3:** `cores/zx-mister/rtl/turbosound.sv` +
  дерево `jt12/` с `jt03.v`. Не влезает по LUT — сначала пункт бэклога «буферы оболочки LUTRAM→BRAM».
- **Формат SCL** (проверен на 400 образах): `"SINCLAIR"`, байт числа файлов N, N записей по 14 байт
  (имя[8], тип, адрес[2], длина[2], **секторов**[1]), затем данные подряд, хвост 0/4/8 байт.
  Число секторов брать ТОЛЬКО из каталога — по размеру файла проверять нельзя, часть образов имеет
  лишний хвост. SCL = дефрагментированный TRD: каталог синтезируется, данные читаются из файла.
- **Страничность Пентагона 1024:** `банк[5:0] = {7FFD[5], 7FFD[7], 7FFD[6], 7FFD[2:0]}`. Расширенные
  биты — ОТДЕЛЬНАЯ защёлка: уход в стандартный режим (`EFF7[2]=1`) её НЕ обнуляет. Бит 5 блокирует
  страничность только при `EFF7[2]=1`. `EFF7` сбрасывается в 0 → машина стартует в мегабайтном режиме;
  его декодирование неполное (`A15..A12=1110`, `A3=0`). Банки 0..7 в BRAM, 8..63 в PS DDR (`0x0FE00000`).
- **Такты ожидания памяти вставлять в `pc3M5`/`nc3M5` (обе фазы), а НЕ в `cpu_ten`:** `cpu_ten` — только
  экспорт наружу для тейпового счётчика, T80 тактируется от `pc3M5`/`nc3M5`. Проверка правильности:
  `VGEOM` старшие 12 бит остаются 320 при активной работе с DDR (стоит процессор, а не ядро).
- **🥇 CDC-правило (оплачено битой памятью Пентагона, ядро B0074): нагрузку ДЕРЖАТЬ, синхронизировать
  ТОЛЬКО флаг, и флаг отдавать НА ТАКТ-ДВА ПОЗЖЕ данных.** Если данные и тоггл меняются одним фронтом, а
  у флага 3 триггера против конвейера данных из 2, у флага остаётся ОДИН такт запаса — совпадение фронтов
  (окно ~0.5 нс на 10 нс ≈ 5 %) его съедает, и приёмник берёт значение ПРЕДЫДУЩЕЙ транзакции. Так
  машина получала чужой байт в 5-10 % чтений расширенных банков; измеренный перекос на пути запроса был
  0.572 нс при шаге фазовой сетки 0.588 нс. Эталон приёма — `inject_cdc.v` (нагрузка держится, берётся
  напрямую). Однотактовый импульс запроса ещё и ЗАЩЁЛКИВАТЬ: потерянный вне `S_IDLE`, он оставлял
  `mwait` поднятым и морозил Z80 насмерть.
- **🥇 Приёмку памяти машины проходит САМА МАШИНА, а не ARM.** В приёмке Пентагона 1024 писала машина, а
  читал и сверял ARM — у ARM-овской стороны мастера CDC нет вовсе, поэтому она была чиста, а машинный
  путь чтения не проверялся ни разу. И читать надо ВСЕ восемь байтовых линий (два крайних байта банка —
  это линии 0 и 7) в темпе настоящего софта (`PUSH`/`LDIR`), а не по одному байту с паузами.
- **Тест, который затирает банк со своим же кодом, даёт ложные числа.** Инжектируемый код живёт в банке 2
  (окно 0x8000) — заливать банк 2 нельзя, иначе программа сходит с рельсов и печатает «ошибки» на
  исправном железе (у меня дважды: «56 расхождений в каждом банке»). UMT по той же причине щадит банк 5.
- **`MEM_STAT` (0x14C) до B0074 собирался из 34 бит в 32-битный провод** — старшие два срезались молча,
  и все поля читались со сдвигом на 2. Расшифровки диагностики до B0074 недостоверны.
- **Мина: окно памяти машины `0x0FE00000` лежит ВНУТРИ 6-МБ диапазона fs-буфера (`FS_BUF 0x0F900000`).**
  Файл больше ~5 МБ, прочитанный мейлбоксом, затрёт расширенные банки Пентагона.
- **Тест памяти без ЗАТРАВКИ не доказывает ничего:** если записать то же значение, что уже лежит,
  «прочитал верно» не отличить от «прочитал старое». Перед каждым прогоном писать заведомо другой байт.
  Оплачено ложным «отказом», который потом не воспроизвёлся.
- **`0x150 MACH_DBG`** — машино-агностичный слот отладки (оболочка даёт слот, машина наполняет).
  ZX/Пентагон: `{запросов в DDR[31:24], EFF7[21:14], 7FFD[11:6], банк[5:0]}`. Счётчик запросов
  8-битный и НАСЫЩАЕТСЯ на 255 — дельту по нему после этого не мерить.
- **Исполнить свой код на Z80 по JTAG** (без файлов и без набора клавиш): `CONTROL=4` (сброс+очистка,
  ждать ~2 с) → `CONTROL=1` (HALT) → `RAMADDR 0x10` = адрес, байты в `RAMDATA 0x14` (автоинкремент) →
  `P7FFD 0x3C` + `PFE 0x40` + `COMMIT 0x44 = 1` → слова `DIR0..DIR6` (`0x20..0x38`) + `COMMIT = 2` →
  `CONTROL=0`. Раскладка DIR — как в `inject_finish` прошивки. RAM-адрес 17 бит = `банк*16384 + смещение`.
- **Читать ТЕКСТ с экрана машины:** зеркало экрана по JTAG (`mrd -bin -file 0x40008000 1728`), клетки
  8×8 сверить со шрифтом ПЗУ (`rom128.hex`, смещение `0x7D00`) — видно, какое меню открыто. Инжект в
  матрицу Z80 — регистр `0xA8` `{отпускание(бит8), скан-код}`, он минует гейт OSD. В 128-меню курсор
  двигает скан-код `0x72` (ядро мапит его в CS+6), а клавиша «6» — НЕ двигает.
- **ПЗУ ГРУЗИТСЯ С КАРТЫ (ядро ZX B0073, прошивка v0.15.207).** 4 страницы по 16 КБ в BRAM, вторым
  портом их пишет ARM. **Каноническая раскладка задана НАМИ: 0 = 128-меню, 1 = 48 BASIC, 2 = TR-DOS,
  3 = сервисное.** Порядок страниц В ФАЙЛЕ любой — ARM раскладывает ПО СОДЕРЖИМОМУ (у пентагоновских
  BIOS порядок `[сервис, TR-DOS, 128, 48]`). Наборы лежат в `0:/ROMS/`, выбор — опция машины `ROM SET`,
  ini-ключи `<тег>.romset` (строка!) и `<тег>.svcrom`.
  - Регистры: `0x154` ROM_LD (байт + addr++), `0x158` ROM_LDCTL (bit0 loading = машина в СБРОСЕ,
    bit3 rewind), `0x15C` ROM_LDADDR (R/W), **`0x144` ROM_LDCNT = сколько байт ФАКТИЧЕСКИ легло в BRAM**.
    Сверять заливку по `0x144`, а НЕ по адресу: адрес — намерение, счётчик — факт.
  - `LOAD_CAPS` (0xC0) **бит4** = порт заливки есть. Кэш возможностей сбрасывать при смене ядра.
  - `MACHINE_CFG` (0xBC): **бит8 = трап TR-DOS, бит9 = сервисная страница.** Биты 0..6 занимать нельзя —
    у NES там region/palette/sprlimit того же слова. Чтение 0xBC теперь отдаёт ЦЕЛОЕ слово.
  - **`$readmemh("rom128.hex")` остаётся дефолтом** — без файлов на карте плата поднимается. НО:
    залитое ПЗУ **не восстанавливает ни F11, ни RESET из меню** (вайп трогает только ОЗУ) — только
    перезагрузка ядра через PCAP (`pl_reload`, в меню это выбор `ROM SET = BUILT-IN`).
  - **`mem_zx.v` — ОБЩИЙ файл**, его копируют себе assemble.sh шагов 06..14, где топ инстанцирует его
    БЕЗ параметра. Поэтому `parameter ROM_PAGES = 2` (старое поведение) — дефолт, а 4 страницы шаг 15
    запрашивает ЯВНО. Менять дефолт нельзя: у тех деревьев своя страничность и ПЗУ уедет в нули.
  - Трап Beta Disk: M1 по `0x3Dxx` при вставленной странице 48 BASIC → страница 2; выход — M1 вне окна
    ПЗУ. Гейт ОБНУЛЯЕТ защёлку (иначе снятие бита8 при вставленном TR-DOS морозит окно на странице 2).
  - **Подпись TR-DOS обязана быть строгой — `"TR-DOS Ver"`**: слово `TR-DOS` есть и в сервисных ПЗУ
    (сообщения «No disk»), по слабой подписи в слот TR-DOS уезжает сервисная страница.
  - `MACH_DBG` (0x150) у ZX теперь: `{запросов в DDR[31:24], страница ПЗУ[23:22], EFF7[21:14],
    DOS[13], 0[12], 7FFD[11:6], банк[5:0]}`. Защёлку DOS опросом не поймать (у промпта TR-DOS
    исполняется 48 BASIC) — доказывать содержимым экрана.
  - На старте прошивка СЛЕДУЕТ за прошитым в BOOT.BIN ядром (`loader_main.c` ~8016) — для проверок ZX
    нужен ЗАГРУЗОЧНЫЙ ОБРАЗ С ZX-ЯДРОМ, иначе `defmachine=pent1024` молча исправится на NES.
  - Сервисное ПЗУ Gluk на холодном старте экран НЕ рисует (его вход — NMI/«магия»); из холодного
    старта работают только образы вида ZX Diagnostics.
  - **NMI проверять ТОЛЬКО на `PENTDIAG.ROM`** (`SERVICE ROM = YES` → сброс → `Ctrl+Alt+Ins` даёт тест
    клавиатуры; без NMI — обычный тест). Gluk для этого не годится: его сервисная страница лезет к
    CMOS-часам Mr Gluk по портам с младшим байтом `#F7` (`0x11AE LD BC,#DFF7 : OUT (C),H`, плюс
    `#0FF7`/`#3FF7`), а у нас из всех `#xxF7` декодируется только `EFF7`, и то по `A15..A12=1110`,
    `A3=0`. Чтения возвращают плавающую шину → мусор в верхней строке, где у Gluk статус и часы.
    У `PENT611Q` страница 0 такая же: четыре прямых `IN/OUT (#F7)` в никуда. Часов у нас нет вообще
    (у Zynq нет батарейки) — это отдельная фича, а не поломка ПЗУ.
  - **NMI в фабрике — только импульс на вход Z80** (`bulbulator_zx_ddr_top.v:190`), страницу ПЗУ он не
    меняет. Поэтому в 128-меню и 48 BASIC он попадает в заглушку на `0x0066` и выглядит как «просто
    перезагрузка». Настоящая магическая кнопка = вставить сервисную страницу по M1 на `0x0066` и снять
    по опкоду `RETN` (`ED 45`), как это делает Multiface. Правило трапа TR-DOS («снять по M1 вне окна
    ПЗУ») здесь НЕ работает: фризер и возвращается в ПЗУ, флаг не снялся бы никогда.
- **Приём «читать текст с экрана по шрифту из `rom128.hex`» верен, только пока в странице 1 стоит
  48 BASIC.** После заливки чужого набора шрифт брать из файла набора (смещение страницы 1 + `0x3D00`).
- **🥇 ОЖИВЛЕНИЕ ПЛАТЫ, когда ядра исчезли из JTAG (без снятия питания).** Признак: `targets` отдаёт
  только `DAP (APB AP transaction error, DAP status 0x30000021)` и `xc7z010`, Cortex-ов нет, память
  через DAP не читается («Context does not support memory read»), то есть и QUIESCE не записать.
  Помогает **`rst -system`, поданный на цель `DAP`** → ядра возвращаются, BootROM берёт образ с карты
  (`sources/jtag_revive_dap.tcl`). НЕ работают: `rst -por` («por not supported for target» — на
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
