Alex-Electron/ZX_BulbuLator/research/15-pentagon/BUILD_HISTORY.md

# История сборок

## 2026-09-11 вечер — B0184 irqBeg 4/8 (лаборатория, не боевой)

| дата | что | сборка | суть |
|---|---|---|---|
| 2026-09-11 | Ядро **B0184** (`/tmp/atlas_b0184.bit.bin` 1 160 992 Б; на карте `0:/CORES/ATL184T.BIN` PCAP; боевой `ATLAS.BIT.BIN` остался B0181) | 0 ERROR, тайминг закрыт **WNS +0.051 нс**, настоящих `8-9873` нет. На плате `VERSION=0xB01B0184`. | 🥇 **`irqBeg` 2/6 → 4/8** (MiSTer `hc_next==4/8`). На живой плате Timing Tests: занятые 2, 3, 17, 18, 22, 27 и RST 18 (34) — эталон. Тест сам «3 tests failed» вместо 10. Остаток 35_0 / 36_1 / 37_1 — плавающая шина (стенд с тем же RTL их проходит; 36 на плате даёт тройку 35). Боевой файл не обновлять. |

## 2026-09-02 — исправление provenance B0157; B0158 только подготовлена

| Дата/время | Вариант | Проверенные артефакты и результат |
|---|---|---|
| 01.09 ~15:29 | **B0157 SAFE LAB**, v0.15.433 | `sources/build/bulbulator_zx_loader.bit`: 1 167 063 Б, SHA-256 `1a7878d3ef771d23238ad9e0d235029eeb37014aa72426fc74b0c3bc4764b084`; PCAP на момент создания: 1 166 944 Б, SHA-256 `1d621a0d3b72caa29bee83390d28bc42c5f1737cd3d9854c093c220ca3a21930`. Vivado ERROR/CRITICAL=0, WNS +0.242, WHS +0.026, LUT 15116, FF 12715, BRAM 58.5/60. Волатильная загрузка и write/readback `0x1C0/0x1C4` прошли. Обычный PCAP-файл позднее перезаписан. |
| 01.09 16:59 | **B0157 AGENT POTAPOV DEFAULTS**, без INTACK-правки | Текущие обычные имена: `.bit` 1 167 063 Б, SHA-256 `ca7b2375c5ef7849d9d1310d269f8d2ed9719ca1a3ae32fe0702ba4b46294fb2`; `.bit.bin` 1 172 832 Б, SHA-256 `cdd6e1b0609c115908df9c9b4a4a58d0b0dec49f5dbfc09d8e0d278bd49422e1`; BOOT 1 811 924 Б, SHA-256 `20d8ac8cf9171de185adde0d05532b65bb4c5313dc8a6943630eebcce923698a`. В source baked paper=9/border-delay=3/phase=4. |
| 01.09 17:17 | **B0157 AGENT POTAPOV+INTACK+NO_SNOW** | `sources/build/bulbulator_zx_loader_nosnow.bit`: 1 167 063 Б, SHA-256 `410f60114cc01674bf4f3ac23c9af2abdba1ee596136ec819ce983af87ac80ad`. Включает более поздние `m1`-гейты INTACK; не совпадает с двумя вариантами выше. |
| 01.09 17:31 | **research/17-ep4potapov**, также VERSION B0157 | `bulb_zx_potapov.bit` 1 032 167 Б; `.bit.bin` 1 032 064 Б. Отдельный core, но VERSION не уникален, поэтому чтение `0xB01B0157` не идентифицирует PL. |
| 02.09 | **B0158 / v0.15.434 — только staging** | `/private/tmp/b0158-work`: ранняя SAFE LAB + `m1`-гейты INTACK, версия повышена. Ещё не перенесена на ThinkPad, не собрана, не загружена. Архивирующая shell-команда упала до первой копии; состояние файлов не менялось. |

**Стоп-гейт:** не проводить и не записывать визуальные выводы ESH/SHOCK на текущей
`VERSION=B0157`, пока PL не заменена однозначной B0158. Не менять постоянный BOOT до CPU +
визуальной приёмки.

## 2026-09-01 — аудит параллельных B0155/B0156

| Дата | Сборка | Проверки | Результат |
|---|---|---|---|
| 2026-09-01 | Ядро **B0157** (Atlas) + прошивка **v0.15.433** | Артефакты: `.bit` 1 167 063 Б, `.bit.bin` 1 166 944 Б, `BOOT_B0157_v433.BIN` 1 811 924 Б. Записан в `0:/BOOT.BIN` и `0:/CORES/ATLAS.BIT.BIN` через put_retry.tcl, тёплый ребут warm_sd_reboot.tcl: POST VERSION=0xB01B0157, FIFO_OVERFLOW=0 | Внедрён аппаратный эталон Потапова (ep4spectrum beedeb5): pap_delay=9 px, bord_delay=3 px, bord_phase=4/8 по умолчанию для 48K/128K. Регистры ULA_TUNE (0x43C001C0) и ULA_TUNE2 (0x43C001C4) активны для оверрайда. Зашит в 0:/BOOT.BIN и 0:/CORES/ATLAS.BIT.BIN. **ГОТОВО К ПРИЁМКЕ ТЕСТОВ И SHOCK.** |
| 2026-09-01 | Ядро **B0155** (только Atlas), создано параллельным агентом; прошивка не повышена | Артефакты: `.bit` 1 132 483 Б, `.bit.bin` 1 132 352 Б. Отчёты синтеза/тайминга, CPU-тесты и визуальная приёмка не приложены | Фиксированные `pap_tap=9` для Sinclair и прежняя ранняя I/O contention-фаза по умолчанию. Промежуточная, **невалидированная** сборка; не использовать как базу. |
| 2026-09-01 | Ядро **B0156** (только Atlas) + оболочка **v0.15.432**, созданы параллельным агентом | Артефакты: `.bit` 1 130 115 Б, `.bit.bin` 1 129 984 Б; `loader.elf`/`BOOT.BIN` собраны. Волатильная загрузка: `VERSION=b01b0156`, `MACHINE_CFG=0001c002`. Запись `0x80000005` в `GP0+0x114` читается как `DEADBEEF`; полных отчётов и приёмки нет | Добавлены пять live-ручек ULA в BulbaNavigator, но `IDX_ULATUNE=7'h45` конфликтует с `IDX_QUIESCE=7'h45` на том же `0x114`; ручки не работают и запись может задеть safe reload. Fallback также перевернул смысл bit27. **Сборка отвергнута для экспериментов.** Следующая исправляющая версия — B0157/v0.15.433. |

## 2026-08-12 ночь: ГЕОМЕТРИЯ ПЕНТАГОНА СОШЛАСЬ (ядро **B0126** на плате, **B0127** собран)

🥇 **ПОДТВЕРЖДЕНО ВЛАДЕЛЬЦЕМ: `PENT INT H = 326` + `PAPER H OFF = 2` — бордюр сошёлся с центральным
экраном, разрыв полоски в тайминговой демке ушёл. «Теперь у меня всё на этой прошивке хорошо».**
Оба числа запечены значениями по умолчанию (`arm/loader_main.c:1612,1613`).

**326 — это ЭТАЛОННОЕ число** (MiSTer `ula.sv:170`, Sizif то же). Прежние 318 = 326 − 8, ровно один
старый восьмипиксельный квант бордюра: значение когда-то подбиралось под грубую сетку, которой после
B0121 больше нет. И важное: **до правки геометрии эталонное 326 НЕ работало** — владелец прошёл свип
и подходящего значения не нашёл вовсе. Работать оно стало только после B0126.

### B0126 — центровка кадра

Жалоба: «левый бордюр шире правого, всё сдвинуто вправо». Измерено по кадру в DDR: бумага на
столбцах 77..332, слева 77 px, справа 51 — картинка на 13 px правее центра.
Причина: гашение стояло по СЫРОЙ растровой координате, без поправки на конвейер ULA (бумага
ВЫВОДИТСЯ на hUla 12..267). Sizif компенсирует это явной константой `SCREEN_DELAY = 13`.

Сдвинуты `hBlank` и `hsync` на **+12** (не +13): `hBlank` 332..395, `hsync` 332..363. Ширина гашения
не изменилась, в строку по-прежнему набирается ровно 384 пикселя, `CAP_W` не тронут.
**Почему +12, а не +13:** видимая область 384 минус бумага 256 = 128, число ЧЁТНОЕ, поэтому достижимы
ровные 64/64. У Sizif остаток нечётный (363−256 = 107), и там симметрия только до пикселя: константы
`54 − SCREEN_DELAY` и `53 + SCREEN_DELAY` дают на экране 54 слева и 53 справа — то есть эталон тоже
предкомпенсирует задержку, просто его геометрия не позволяет сойтись в ноль. Поймано вопросом
владельца «а идеальная ли симметрия у Sizif?» — до него было записано +13.

### B0127 — Pan X / Pan Y стали круговыми (собран, на плату не ставился)

Положение бумаги считается ОТНОСИТЕЛЬНО её начала **по модулю длины строки** (`hCountEnd`), а не
прямым сравнением `hUla >= start && hUla < start+256`, которое переполнялось и схлопывало окно в
пустоту. Ловушка: 9-битное вычитание завернулось бы по 512, а строка 448 — наивный вариант нарисовал
бы бумагу в двух местах сразу. Диапазоны в меню расширены до 0..447 и 0..319, пункты заворачиваются
на границах (`loader_main.c`, гейт по `onchange == apply_paper`; остальные пункты по-прежнему
упираются — у них края это настоящие пределы).
Владельцу отрицательный сдвиг в итоге НЕ понадобился (хватило +2), но ручка теперь двусторонняя.

### Гоча дня по сборкам

🥇 **Лесенка директив выбирает первую, которая РАЗЛОЖИЛА, а не ту, что закрывает тайминг.**
На одном нетлисте `ExtraTimingOpt` даёт **+0.095**, а `Explore` — **−0.421**. Логика идентична,
разница только в раскладке. Порядок в `build.tcl` возвращён: `ExtraTimingOpt` первым, остальные —
спасение от «не разложилось вовсе». Правильное решение (не сделано): проверять тайминг после
трассировки и брать следующую директиву при минусе.

**Итоги сборок:** B0126 WNS +0.026, B0127 WNS **+0.104**, LUT 89.54 %, BRAM без перебора.

## 2026-08-12 вечер: РАЗГРУЗКА КРИСТАЛЛА, тайминг закрыт (ядра **B0122..B0125**, на плате B0125 + v0.15.332)

`BOOT_B0125_v332.BIN` и `B0125.bit.bin` записаны на карту со сверкой (второе — в `0:/CORES/ATLAS.BIT.BIN`),
тёплая перезагрузка прошла, `PL VERSION = 0xB01B0125`. Владелец: «вроде бы сейчас всё хорошо идёт».
Резервы на карте: `BOOT_B0121_V332.BAK`, `CORES/ATLAS_B0119.BAK`.

**Итог: WNS +0.095, ноль нарушенных путей, LUT 89.69 % (было 91.09), BRAM без перебора.**
Путь дня: −0.654 → −0.319 → −0.099 → **+0.095**, каждый шаг предсказан числами.

### 🥇 Главный урок дня: на забитом кристалле директивы не работают, потому что виноваты ПРОВОДА

Разведённый критический путь целиком: **9.405 нс, из них логика 2.365 нс (25 %), трассировка
7.040 нс (75 %)**, 9 уровней. Отсюда: `phys_opt` четырьмя директивами и переразводка не сдвинули
−0.219 нс **ни на пикосекунду** — двигать нечего. Лечится ТОЛЬКО сокращением числа уровней.
Потеряно на этом полтора часа и один трёхчасовой тупик (`SpreadLogic_high` разместил, но развести
оказалось нельзя: перекрытия колебались 25..49 тысяч вместо схождения к нулю).

### Что сделано

- **B0122** — гейт тонкого бордюра Пентагона переведён с флага `videoEnable` на КООРДИНАТНОЕ окно
  (`video.v:184`), буквально условие MiSTer `hc<12 | hc>267 | vc>=192`. Прежний гейт брал окно
  ВЫБОРКИ вместо окна ПОКАЗА и красил цветом бордюра последние 3 колонки бумаги в каждой строке.
- **B0123** — тождество альфа-смешивания `bg*a + video*(255−a)` → `video*255 + a*(bg−video)`:
  шесть умножителей 8×8 вместо двенадцати, результат бит-в-бит прежний. Плюс FIFO ленты 4096→2048
  дескрипторов (две плитки BRAM вместо четырёх) — этим снят перебор `Used=121, Available=120`,
  из-за которого синтезатор выдавливал буферы в LUT-RAM.
- **B0124** — адрес строки у `ddrdisp` в регистр вместе с тегом (`fb_line_disp.v`): сняты два
  последовательных сумматора из комбинационного пути (отчётные `CARRY4=5`). −0.319 → −0.099.
- **B0125** — разрез конуса решения `RD_IDLE` у `osddr`: желаемые строки и биты попадания тега в
  регистры, 9 уровней → 2-3. Добавлен **счётчик покоя** (в разборе его не было): регистровые биты
  попадания отстают на такт от `buf_valid`/`buf_row`, и без него автомат затребовал бы только что
  заполненную строку повторно. −0.099 → **+0.095**.

### Гочи, оплаченные этой пачкой

- 🥇 **Параметр правится там, где ЗАДАН, а не там, где объявлен дефолт.** `AW` у тейпового FIFO
  задаётся в `bulbulator_zx_ddr_top.v` при подключении `tape_player`, а не дефолтом в
  `tape_bram_fifo.v`. Правка дефолта компилируется, выглядит применённой и не делает НИЧЕГО —
  поймано только по строке перебора BRAM, а не по факту «сборка прошла».
- 🥇 **`0:/CORES/ATLAS.BIT.BIN` надо обновлять ВМЕСТЕ с `BOOT.BIN`.** Смена машины в меню
  перезагружает ПЛИС ядром С КАРТЫ; там лежал B0119, и часть тестов владельца шла на ядре БЕЗ
  наших правок. Обнаружено случайно, по `PL VERSION = 0xB01B0119` при записи файла.
- **Лесенка директив размещения** в `build.tcl` (`Explore`, `ExtraTimingOpt`, `AltSpreadLogic_high`,
  `SpreadLogic_high`) плюс контрольная точка после трассировки и откат при отказе битстрима.
  Признак больной трассировки: перекрытия не падают, а колеблются и растут — снимать сразу.

### Не сделано (следующая сборка)

Сдвиг гашения на +13 (картинка на 13 px правее центра, справа срезается ~2 px), круговые Pan X/Y,
ручка длины импульса `/INT` (задача #64), удержание бордюра на паузе (#60), перенос трёх буферов
оболочки в BRAM (ещё ~1900 LUT, нужен упреждающий адрес).

## 2026-08-12: тонкий бордюр Пентагона (ядро **B0121** + прошивка v0.15.332) — НА ПЛАТЕ

`BOOT_B0121_v332.BIN` (1 806 036 Б) записан на карту со сверкой, тёплая перезагрузка прошла,
`PL VERSION = 0xB01B0121`, переполнений очереди нет. Прошлый образ сохранён на карте как
`0:/BOOT_B0120_V330.BAK`.

**Что исправлено.** `sources/atlas_core/video.v`: цвет бордюра защёлкивался вместе с атрибутом, по
`h_addr[2:0]==4`, то есть раз в 8 пикселей (4 такта Z80). Для Синклера это верно, у Пентагона нет —
любой бордюрный эффект рассыпался на блоки. Наследие Atlas, не наша регрессия: та же строка в
`cores/zx/atlas.cyc`, `atlas.max`, `zx/src`. Теперь у Пентагона бордюр обновляется каждый пиксель,
цвет кладётся в ОБА поля (бумага и чернила), как делают оба эталона:
MiSTer `rtl/ula.sv:184` («1T update for border in Pentagon mode») и
Sizif-512 `cpld/rtl/video.sv:186` (`border_update = screen_update || (machine == MACHINE_PENT && ck7)`).

**Итог сборки:** WNS **+0.092**, все ограничения выполнены, 0 нарушенных концов из 50073,
LUT 91.12 % (без роста), BRAM 60/60, дублей модулей 0.

🥇 **ГОЧА, ОПЛАЧЕННАЯ ДВУМЯ ПРОГОНАМИ ПО 35 МИНУТ: форма записи решает.** Сначала правка была
написана двумя присваиваниями подряд в одном `always` с расчётом на «последнее побеждает»:

    always @(posedge clock) if(ce) begin
        if(attrOutputLoad)           attrOutput <= ...;
        if(pentagon && !videoEnable) attrOutput <= ...;   // так НЕЛЬЗЯ
    end

Логически верно, но два прогона подряд дали разводку с недотрассированной цепью питания
(`Vcc Source -> SLICEL.CLK`, 4 открытых связи) → `ERROR: [DRC RTSTAT-9] Partially routed
physical-only nets ... GLOBAL_LOGIC1` → битстрим не пишется. У B0120 такого не было ни в одном из
трёх прогонов, то есть виновата была именно форма. Починить `route_design -physical_nets` НЕЛЬЗЯ по
построению: тактовый вход не проводят по сети VCC. Переписано ОДНИМ присваиванием с явным
разрешением (`wire borderFine`) — собралось с первого раза.

**Заодно в `sources/build.tcl`:** контрольная точка `bulbulator_zx_loader_routed_prephys.dcp` сразу
после трассировки и `catch` вокруг `write_bitstream` с откатом на неё. Полировка после трассировки —
это только тайминг, а он сходится и до неё; терять 35 минут сборки из-за неё больше не будем.

**ПОДТВЕРЖДЕНО ВЛАДЕЛЬЦЕМ 12.08 на B0121: гладкость бордюрной волны ЕСТЬ.** Восьмипиксельная
лесенка ушла, то есть диагноз (квантование цвета бордюра раз в 8 пикселей) и оба эталона верны.
Правый край на B0121 судить нельзя - там живёт дефект гейта, чинится в B0122.

**Было не проверено:** гладкость бордюрной волны. Тест — `0:/test/Pentagon/across_the_edge_by_demarche_fix_0.trd`.

## 2026-08-12: прибор «где карта теряет звук» (прошивка **v0.15.332**, ядро B0120 без изменений)

Собрано: `flash/BOOT_B0120_v332.BIN` (1 901 332 Б). На плате НЕ проверено.

**Что это.** Счётчики исполнения ключевых мест прошивки карты gs105b, повешенные на выборку опкода
в `z80emu.c` (все 8 мест: основной цикл + продолжения префиксов). Адреса сняты СКАНОМ
`assets_gs105b.rom` по сигнатурам из исходников прошивки, а не по догадке:

| место | Z80-адрес | что значит |
|---|---|---|
| `HSEND`  | `0xC25D` | карта ждёт, пока машина ЗАБЕРЁТ байт; главный цикл стоит, `ENGINE` не зовётся |
| `HGET` | `0xC251` | карта ждёт байт ОТ машины |
| `HTAIL2` | `0xC26B` | хвост обмена |
| `QTFAULT`| `0x13B9` (и `0x93B9`) | кольцо квантов пусто, `RET` БЕЗ `EI` — сэмплы не защёлкиваются |
| `QTPLAY` | `0x14CC` (и `0x94CC`) | проигрывание возобновлено (`IM 1`/`EI`) |

ПЗУ карты видно в двух окнах: нижние 16 КБ по `0x0000` (там прерывание) и страница 0 по `0x8000`
(там главный цикл), поэтому у мест из нижней половины проверяются оба адреса.

Мейлбокс `KMB+0x5A64..0x5A88`: HSEND/HGET/HTAIL2/QTFAULT/QTPLAY, число дыр, **самая длинная дыра
в сэмплах ЦАП** (делить на 47.996 = мс), сумма дыр, выдано сэмплов, слово обнуления. Снятие —
`arm/gs_diag2.tcl` (`gs2_reset` / `gs2_read`).

**Что уже доказано этим прибором НА ХОСТЕ** (`gs_host_fx_test.c`, `GS_ZP=1`, плата не нужна):
имитация окна трекера Z-Player 50 Гц (`#62` + `#63` + `#64`; последние две отдают по 4 байта и после
каждого зовут `HSEND`) при разной цене круга рукопожатия, модуль `2-3song6`:

| круг, мкс | дыра max, мс | времени в дырах |
|---:|---:|---:|
| без опроса (контроль = игра/TR-DOS) | 0.0 | 0.0 % |
| 25 (≈ настоящая GS) | 0.0 | 0.0 % |
| 100 | 0.0 | 0.0 % |
| 250 | 0.4 | 2.4 % |
| 1000 | 4.9 | 7.6 % |
| 2000 | 9.9 | 29.2 % |
| 5000 | 39.0 | 52.6 % |

То есть опрос плеера сам по себе безвреден, а дыру создаёт ЦЕНА НАШЕГО КРУГА. Порог здоровья —
около **100 мкс**; замеренный хвост главного цикла оболочки (1077 проходов >1 мс, худший 134 мс)
лежит на три порядка выше, и липкий `sgap` 1.74e6 тактов ≈ 145 мс с платы этому соответствует.

**Побочно найден латентный тупик:** восемь невычерпанных байт данных во входной очереди держат бит7
внутреннего порта карты (`gs_inq_head_is_data() || gs_outp`, `gs_arm.c`), и `HSEND` перестаёт
выходить вовсе — на стенде карта встала на 12 с, плеер не дождался ответа. На плате не проверено.

**Дерево:** исходники `arm/` возвращены к состоянию `b00a13c` (v0.15.331 — то, что соответствует
плате), AMP-хак v0.15.350 сохранён в `~/amp-v350-backup-20260812/`, ничего не коммичено.

## 2026-08-08: READ TRACK и трап NEMO-IDE (ядра **B0111**, **B0112**)

**B0112** - NEMO-IDE в машине: трап портов (`sources/nemo_ide.v`), регистры AXI 0x184/0x188, буфер
сектора 512 Б. Стоит РАНЬШЕ kempston в мультиплексоре шины данных (тот ловит `a[5]==0`) и давит
запись в `#FE` на всё окно `ebl` (все командные порты NEMO чётные, иначе `OUT (#10)` мигает
бордюром). Выключен, пока оболочка не поднимет бит разрешения.
WNS +0.181, ноль несошедшихся точек, LUT 89.89%, **BRAM 60/60 - занят последний блок**.
Регрессии нет: General Sound играет, звук через 0.8 с после выбора модуля.

**B0111** - READ TRACK (команда 0xE): дорожка синтезируется пофазно, данные секторов идут штатной
выборкой. WNS +0.090. Реализована, но НЕ проверена: софта, который её выдаёт, не нашли - кольцо
трассировки BDI показало, что Z-Player её не использует вовсе.

**Прошивки v0.15.281-282**: опция `GS memory` (128K/512K/1M/4M) и прибор «снять кольцо BDI»
(команда мейлбокса 4, результат в `KMB+0x3100/0x3140`).

## 2026-08-08 ночь: GENERAL SOUND ИГРАЕТ МУЗЫКУ (ядро **B0110** + прошивка **v0.15.279**)

Защёлкиваний сэмплов ~145 тыс/с (ровно 4 канала на 37480 Гц), пик 44..58 из 127 и меняется по
музыке, громкости живут по нотам, принятый поток модуля **байт-в-байт равен файлу**.

**B0110** - извлечение из FIFO гейтится тем же признаком «пусто», который ушёл в данные. Байт,
пришедший в окно между защёлкиванием `s_rdata` и импульсом извлечения, пропадал БЕССЛЕДНО: 71
одиночная потеря на 22 КБ потока, длина потока плавала от прогона к прогону. Та же болезнь была у
клавиатурного FIFO («пропала клавиша» без следов) - вылечена той же правкой.
Тайминг: WNS +0.257, ноль несошедшихся точек, `8-9873` нет.

**v0.15.275** - команда не обгоняет данные (найдено на хостовом стенде за секунды).
**v0.15.276..279** - трасса протокола, целостность потока, дамп потока в память, приборы карты.

## 2026-08-07/08: GENERAL SOUND - обмен закрыт, заливка без потерь (ядра **B0107-B0109**, прошивки **v0.15.265-274**)

Итог честный: **рукопожатие и передача данных работают, музыка ещё не играет** (счётчик защёлкиваний
сэмплов после загрузки модуля замирает - подробности в HANDOVER_CURRENT.md, раздел 23).

| Сборка | Что | Итог |
|---|---|---|
| **B0107** | флаг ОДИН, фабрика ЗЕРКАЛИТ состояние эмулятора (было: снимала флаг за карту, софт вис на `WC`); байт отдаётся на 2 такта раньше флага (0x174 идёт в AXI без синхронизатора); суммирование ARM-ноги с машиной (0x78 бит1); свой пик-метр 0x17C | тайминг закрыт, WNS +0.024, LUT 89.7% |
| **B0108** | упругая очередь записей #B3 на 256 байт + точный пик-метр | **ПРОВАЛИЛ setup пиксельного домена (WNS -0.223, 22 точки), на плату НЕ ставился** |
| **B0109** | то же, но очередь 32 байта и дешёвый пик-метр (старший байт и обратный код вместо четырёх 16-битных сумматоров) | **WNS +0.112, ноль несошедшихся точек**, LUT 15696 (89.18%), BRAM 59/60, `8-9873` нет |

| Прошивка | Что |
|---|---|
| v265 | насос флагов на зеркале + очередь GS в звуковом тракте + опция `Machine → General Sound` + приборы в мейлбоксе |
| v266 | вычерпывание упругой очереди, продолжение очереди 32 КБ на стороне ARM |
| v267 | 🥇 обращение к внутреннему порту #02 ГАСИТ и «есть байт от карты» - я разнёс один флаг апстрима на два и потерял связь; X-Player вис на `WD` после команды 0xD1 |
| v268 | объём ОЗУ карты 2 МБ -> 512 КБ (штатная база); от объёма зависит и ответ команды #23, и длительность цикла пересчёта сэмплов |
| v269-v272 | приборы: переключения страниц, регистры процессора карты, `NUMPG`, `SMPS`, защёлкивания сэмплов, громкости, каналы |
| v273 | проба базовых 128 КБ (`NUMPG=3`, как в руководстве и как требует Mod Player) |
| v274 | возврат 512 КБ: X-Player адресует сэмплы индексом 3, которого у 128 КБ нет - на них в микшер идёт шум |

### 🥇 Урок: строка «All user specified timing constraints are met» бывает ТОЛЬКО ПРО HOLD

В логе B0108 она есть - и относится к `report_timing_summary -delay_type min` (в шапке той таблицы
нет колонок WNS/TNS). Настоящий setup-итог в том же логе: `Timing constraints are not met`.
Правило: искать ПЕРВЫЙ `Design Timing Summary` и смотреть колонку WNS.

### 🥇 Урок: один прибор не доказывает работу

«GS играет» было объявлено по положительному отсчёту пик-метра. Счётчик ЗАЩЁЛКИВАНИЙ сэмплов
показал, что пик 31 - это залипший постоянный уровень (-128 x 63 = -8064), а не музыка. Мерить надо
ПРОЦЕСС (чтения окна 0x6000..0x7FFF), а не следствие.

## 2026-08-07: КЛАВИША БОЛЬШЕ НЕ ЗАЛИПАЕТ В МАШИНЕ (ядра **B0102-B0104**)

Владелец: «все хорошо, теперь все работает» — **проверено на железе** по трём пунктам: зажатая стрелка
при открытии навигатора, стрелки внутри навигатора, загрузка ленты.

Симптом был такой: работаешь в навигаторе, а машина в фоне листает своё меню, как от зажатой клавиши.

**Где живёт состояние — установил ВЛАДЕЛЕЦ, а не я.** Его наблюдение «залипание уходит, если закрыть
навигатор и нажать любую клавишу» доказало, что матрицу держит ФАБРИКА и машина хранит ПОСЛЕДНЕЕ
состояние, пока гейт закрыт. До этого я потратил попытку на прошивку (v0.15.256, `zx_release_all()`
через `KBD_INJECT`) — эффекта ноль, потому что однократная запись перекрывается фабрикой.

Понадобились ДВЕ связанные правки, а не одна:

- **B0102** — гейт OSD подавляет только НАЖАТИЯ, отпускания идут в матрицу всегда. Лечит залипание
  после отпускания. 🥇 Правильное поведение уже было в этом же файле, но применено только к гейту
  NumLock, и над строкой стоял комментарий «Always pass BREAK data to the matrix» — у гейта OSD его
  просто не применили.
- **B0103** — по фронту ЗАКРЫТИЯ гейта матрица очищается: счётчик прогоняет отпускание по всем 256
  кодам за ~73 мкс, то есть заведомо раньше следующего скана ПЗУ на 50 Гц. Лечит случай «клавиша зажата
  физически в момент открытия навигатора» — именно его владелец и просил.
- **B0104** — исправлена МОЯ перевёрнутая полярность в B0102.

### 🥇 Урок: полярность сверять по ДВУМ независимым местам, а не по имени сигнала

`make` здесь ИНВЕРТИРОВАН: 0 = нажата, 1 = отпущена. Я написал `~ps2_make`, имея в виду «пропускать
отпускания», и получил обратное — гейт пропускал НАЖАТИЯ. Следствия: стрелки навигатора залипали в
машине, лента перестала грузиться, оболочка застревала в модальном окне и мейлбокс молчал. Обе
подсказки о полярности лежали в том же файле в двадцати строках друг от друга (эмиттер аккорда Alt:
`syn_make=0` это down; гейт NumLock: подавление при `~ps2_make`). Владелец нашёл ошибку за одну
попытку, потому что проверял ПОВЕДЕНИЕМ; я её написал, потому что доверился НАЗВАНИЮ.

Тайминг закрыт во всех трёх сборках, `8-9873` нет, LUT 15539 (88.3%), BRAM 59/60 — без роста.

## 2026-08-07: переключение ПЗУ больше не перезагружает ядро (прошивка **v0.15.254**)

Владелец: «перехожу на встроенный ром без ребута платы» - **проверено на железе**.

Асимметрия была физической: заводское ПЗУ жило ТОЛЬКО в битстриме (`$readmemh`), и вернуть его можно
было лишь перезаливкой ядра через PCAP, то есть перезагрузкой всего. Теперь оно лежит на карте файлом
`0:/ROMS/BUILTIN.ROM` (32 КБ, две страницы) и грузится тем же портом заливки, что любой набор - ядро не
трогается вовсе. PCAP остался ЗАПАСНЫМ путём: файла нет - поведение прежнее, плата поднимается без карты.

Страницы раскладывает существующий классификатор по подписям: `1986 Sinclair` в слот 0 (128-меню),
`1982 Sinclair` в слот 1 (48 BASIC). TR-DOS и сервисной страницы у заводского набора нет физически -
это свойство самого ПЗУ, а не способа загрузки.

## 2026-08-06: МАГИЧЕСКАЯ КНОПКА (ядро **B0101** + прошивка **v0.15.252**)

NMI в фабрике был только импульсом на вход Z80 и страницу ПЗУ не менял, поэтому на обычном ПЗУ он
попадал в заглушку `0x0066`, прыгал по адресу из `NMIADD` и выглядел как «просто перезагрузка с
артефактами». Теперь сервисная страница вставляется по NMI и снимается по опкоду `RETN` (`ED 45`) -
так пейджится наружу настоящий Multiface.

**Ключевое решение: защёлку ставит САМ ИМПУЛЬС, а не выборка команды по `0x0066`.** По адресу страница
переключилась бы уже ПОСЛЕ этой выборки: машина исполнила бы один опкод из обычного ПЗУ (в 48К там
`PUSH AF`), а следующая выборка пришла бы из сервисной страницы - в середину чужой инструкции. Импульс
приходит заметно раньше (держится 31 такт 56 МГц, а процессору до `0x0066` нужно дожить текущую
инструкцию плюс 11 T-состояний). Правило выхода трапа TR-DOS («снять по M1 вне окна ПЗУ») здесь не
годится: фризер возвращается тоже в ПЗУ, и защёлка не снялась бы никогда.

`MACHINE_CFG` **бит13** = магическая кнопка (8 трап TR-DOS, 9 сервисная страница, 10 BDI A/B, 11-12
SAA). Опция `SERVICE ROM` стала трёхпозиционной: **OFF / NMI / ALWAYS**. `ALWAYS` - прежнее поведение,
и оно честно нужно диагностическим ПЗУ: `PENTDIAG` рисует свой тест с холодного старта только так.

Тайминг закрыт: «All user specified timing constraints are met», WNS +0.069 нс, WHS +0.031, ноль
отказавших точек. Ресурсы не выросли: LUT 15554 (88.4%), BRAM 59/60 - как в B0100.

### Заодно закрыты четыре дефекта, найденных прибором

1. **Alt+буква съедала нажатие**, даже когда меню по этой букве нет (моя правка v249: `continue` стоял
   безусловно). Пока Alt зажат, любая буква молча пропадала.
2. **`opt_snow` и `g_dbg_ferate` сидели на одном адресе** `KMB+0x38` - классификатор ленты писал свой
   счётчик поверх настройки снега. Счётчик уехал на `KMB+0x40`.
3. **Набор ПЗУ без страницы 128-меню молча уезжал в слот 0.** Слот 0 - загрузочный (в режиме 128/1024
   машина стартует из него), а «остаток в порядке файла» ставил туда неопознанную страницу: машина
   грузилась не в BASIC и молчала. Теперь слот 0 заполняется ТОЛЬКО по содержимому, а в статус идёт
   `ROM SET HAS NO 128 MENU`.
4. **`SMP_CNT` (0xB0) читается как `DEADBEEF`** - счётчик чтений порта FE в этом ядре недоступен, то
   есть авто-определение кастомного загрузчика по темпу слепо. Зафиксировано, не исправлено.

### Что доказано на железе

`VERSION = 0xB01B0101`, тёплая перезагрузка с карты прошла, мейлбокс отвечает (`LIST` 46 файлов),
тракт бита13 живой (запись `MACHINE_CFG|0x2000` читается назад). Сам вход по NMI приборно проверить
нельзя: комбинацию `Ctrl+Alt+Ins` декодирует ФАБРИКА из потока PS/2, до ARM она не доходит, поэтому
инжектом (cmd 11) её не подать - нужна настоящая клавиатура.

### Проверено владельцем

**06.08: работает** (владелец: «вроде работает»). Порядок проверки:
`ROM SET = PENTDIAG.ROM`, `SERVICE ROM = NMI`, сброс - на экране обычный BASIC (не тест!), дальше
`Ctrl+Alt+Ins` даёт тест клавиатуры ZX Diagnostics. Это и есть разница с `ALWAYS`, где тест стоял в
окне постоянно и 48 BASIC был выбит.

## 2026-08-06: навигатор - Alt и сортировка по-DN'овски (ядро **B0100** + прошивка **v0.15.250**)

Три просьбы владельца по навигатору, все по следам его же наблюдений.

- **v248** - убрана метка примонтированного образа из правого нижнего угла: строка подсказок снова
  занята целиком подсказками. Имя образа и так видно на экране машины рядом со значком дисковода.
- **v249** - **Alt в навигаторе ожил.** Режим подсказок был описан в комментарии как «0 обычный,
  1 Ctrl, 2 Alt», но переключатель читал только Ctrl, а ветки для режима 2 не было вовсе: переменная
  `kb_alt` присваивалась и нигде не читалась. Отсюда же не работал `Ctrl+Alt+Ins` (NMI) - владелец
  описал это как «нажатие NMI тоже как-то странно». Теперь удержание Alt показывает буквы меню, а
  `Alt+буква` его открывает; буквы берутся из разметки самих заголовков (`~F~iles`), поэтому подсказка
  не может разойтись с делом.
- **v250** - **буква режима сортировки в левом верхнем углу рамки панели**, как в DOS Navigator 2.11:
  строчная = прямой порядок, ЗАГЛАВНАЯ = обратный (`n` имя, `e` расширение, `s` размер, `d` дата).
  Плюс `Alt+B` открывает диалог сортировки - в DN эта же комбинация. Переключатели не тронуты: поле
  на `Ctrl+F3..F6`, направление повторным нажатием той же клавиши.

Буквы в документации DN не расписаны, поэтому взяты по названиям НАШИХ полей - буква совпадает с
подсвеченным заголовком колонки, и цвет у неё тот же (жёлтый заголовочный).

Открыто к проверке владельцем: расширенная матрица на B0100 + v250 (подсказки Alt, `Alt+буква`,
`Alt+B`, `Ctrl+Alt+Ins`, многосекторная запись `SAVE "big" CODE 32768,20000`).

## 🏁 2026-08-06: ДИСКОВОД РАБОТАЕТ И ПРОХОДИТ МАТРИЦУ (ядро **B0099** + прошивка **v0.15.246**)

Проверено владельцем на железе: `CAT` многократно, `SAVE`, `CAT`+`LIST`, повторное имя
(«File exists»), `ERASE`, `LOAD`+`RUN` записанного - **всё прошло, проблем не было**. Полный цикл
сохранения даёт корректные поля (свободно 2544→2543→2542, тип `0x16`, метка не портится, печатается
«OK»), а **Элизиум с нештатным трек-загрузчиком проходит целиком** - открытый пункт с начала работы
над дисководом.

### Шесть дефектов этого дня

| # | Дефект | Где | Как нашли |
|---|---|---|---|
| 1 | номер сектора для Read Address не связан с запросом машины → неверная геометрия («свободных 0») | B0095 | построчная сверка с ЖИВЫМ апстримом |
| 2 | записи процессора не доходили до буфера контроллера | B0094 | затравка `0xA5`: вычитанное = поданному байт-в-байт |
| 3 | в файл уходил ВЕСЬ буфер, примесь чужого сектора портила поля служебного блока | B0097 | журнал запросов + `SEEDTEST` найден внутри сектора данных |
| 4 | фантомные запросы переживали конец команды → запись по ЧУЖОМУ адресу | B0098 | консул (ревью RTL и обвязки) |
| 5 | Force Interrupt не поднимал INTRQ по биту «немедленно» → повторный `CAT` вешал машину | B0099 | кольцо BDI: команда `0xDF`, `PC=0x3D9C`, INTRQ=0 |
| 6 | неудача чтения блока превращалась в порчу (писали нули или прошлый сектор) | v246 | код-ревью своей же правки |

Дефекты 5 и 6 - не расхождения с эталоном: **в MiSTer бита I3 тоже нет**, это исправление по
документации на чип. Мы наткнулись раньше апстрима потому, что секторы подаёт ARM и TR-DOS чаще
выходит по своему таймауту на этот путь.

### Ускорение (B0098): тайминги у нас софтовые, физику вращения эмулировать незачем

Мысль владельца. Оборот диска 200 мс → **10 мс** (как в эталоне), темп байта 32 мкс → **4.6 мкс**,
медленный сохранён опцией `slow_disk` для трек-загрузчиков в ОЗУ. Приборы разбора убраны из горячего
пути (стоили 5-25 мс на сектор и САМИ провоцировали Force Interrupt), сброс метаданных FAT перенесён в
простой. Элизиум на быстрых таймингах прошёл - причём при ОТКЛЮЧЁННОМ побочном эффекте Read Address,
который когда-то добавляли «ради Элизиума»: значит та надстройка маскировала дефекты 1 и 4.

### 🥇 Четыре гнилых дампа ПЗУ (не наш дефект, но наша задержка на полдня)

`PENT128_504.ROM`, `ZX128_504.ROM`, `ZX48_504.ROM`, `TRDOS504.ROM` несли ОДНУ И ТУ ЖЕ испорченную
страницу TR-DOS: **18 байт**, осыпавшихся из единиц в нули, пять из них - в областях-заполнителях
`0xFF` (это и отличает деградацию дампа от чьего-то патча). Файл - дамп **5.03** с переписанной
строкой версии, выданный за «5.04 / 1990».

* `0x1BB7` `INC (HL)` → `JR NC` - **молча** убивал запись каталога (пропадал `PUSH HL`, парный `POP`
  снимал адрес возврата, переход на запись дескриптора не исполнялся; «OK» не печаталось);
* `0x03AE` - ломал путь `CAT`; `0x3FDE` - цикл ожидания DRQ писал байт в буфер на каждом опросе
  (источник мусора в служебном блоке); `0x17F6` - вешал каталог с 17-го файла; `0x07EA` - портил `ERASE`.

Все четыре починены из чистого `TRDOS503.ROM` и перезаписаны на карте под своими именами, дубли
удалены. Проверены ВСЕ десять наборов: остальные шесть целы. ⚠ Моя ошибка в самой проверке: первый
прогон объявил `PENT611Q.ROM` сломанным, потому что искал слабую подпись «TR-DOS», а она есть и в
сервисных ПЗУ - у нас на это записано правило про строгую `"TR-DOS Ver"`.

### Остаётся

* **Многосекторная запись** (`SAVE ... CODE` большого блока): диапазон `cpu_min`/`cpu_max` сбрасывается
  записью команды в `#1F`, а внутри многосекторной команды новой команды нет - диапазон НАКАПЛИВАЕТСЯ.
  Чинить ДО теста: сбрасывать ещё и по фронту `sd_wr`.
* Привод B на запись, защита от записи, запись на настоящий (не затравленный) образ.
* Мелкое: монтирование должно предлагать привод A, когда он свободен; автостарт жмёт ENTER вслепую и
  оставляет клавишу зажатой; у встроенного набора на странице TR-DOS не TR-DOS.

### 🥇 ГЛАВНОЕ 06.08: два дефекта записи закрыты сверкой с ЖИВЫМ апстримом

**Урок методики (стоил половины дня):** я сверял наш `wd1793.sv` с **вендоренной копией** в
`cores/zx-mister/` - а она СТАРШЕ живого апстрима, и нужной строки в ней уже нет. Скачал
`raw.githubusercontent.com/MiSTer-devel/ZX-Spectrum_MiSTer/master/rtl/wd1793.sv`, прогнал построчную
сверку - дефект нашёлся за минуты. **Правило: сверяться с живым апстримом, а не с копией в дереве.**

#### Дефект 1 (ядро B0095): геометрия дискеты - несвязанный номер сектора для Read Address

```
эталон:   A_SECTOR: if (!s_busy) {ra_sector, wdreg_sector} <= {din, din};
наш форк: A_SECTOR: if (!s_busy)             wdreg_sector  <= din;
```

Процессор записью регистра сектора задаёт И номер, который контроллер вернёт в ответе на **Read
Address**. У нас этот номер (`rot_id_sector`) вращался по таймеру и с запросом процессора не
связывался НИКОГДА. TR-DOS ищет сектор именно Read Address и по ответу считает геометрию.

**На железе:** до правки `LIST` показывал «свободных секторов 0» и мусорную метку; после -
**2544 и `SEEDTEST`**. Правка одним драйвером (предустановка в том же блоке, где вращение - из блока
портов был бы второй драйвер, Vivado законно не примет).

Заодно наша надстройка «после Read Address класть байт дорожки в регистр сектора» (добавлена ради
загрузчика Elysium) уведена под опцию `ra_trk_to_sec` и по умолчанию ВЫКЛЮЧЕНА, как в эталоне: на
дорожке 0 она делает регистр сектора нулём, а в расчёте смещения стоит `сектор - 1`.

#### Дефект 2 (ядро B0094): байты записи терялись в общем буфере

Записи процессора не доходили до памяти буфера контроллера (доказано: вычитанный сектор равнялся
поданному байт-в-байт при затравке `0xA5`). Лечение по построению: в обвязке своя **исходящая
память** 512 байт (LUTRAM, +117 LUT), в неё пишет и хост при подаче сектора, и процессор при записи
байтов; ARM забирает сектор оттуда.

**На железе:** программа владельца легла в образ побайтно верно (`10 PRINT "hello"`), а вторая
половина блока сохранила затравку - значит примесей нет.

#### Что осталось (сужено до факта)

TR-DOS просит запись только на **дорожку 0 сектор 9** (служебный блок) и на дорожку данных;
**записи в каталог он не просит вовсе** (доказано кольцом с номерами дорожки/сектора и журналом
отданных секторов). Записанный служебный блок структурно ПРАВИЛЬНЫЙ (нули в области каталога,
признак `0x10` на месте), но поля неверны: тип `0x80` вместо `0x16`, число свободных мусорное и
меняется, число файлов не увеличено, а на месте метки - имя файла. Следующая проверка по правилам
проекта - не приборы, а КОНФИГУРАЦИЯ: ПЗУ грузится с карты, и TR-DOS в чужом наборе может быть
другой версии. Проверить на `ROM SET = BUILT-IN`.

#### Наши отличия от эталона (список нужен: каждое - место возможного расхождения)

1. своя реализация Read Address с настоящим CRC (ради Elysium; в эталоне CRC = нули);
2. побочный эффект «дорожка в регистр сектора» - теперь под опцией, по умолчанию выкл;
3. темп DRQ 112 такта CE (~32 мкс/байт) вместо эталонных 15 - ради трек-загрузчиков в ОЗУ;
4. сторожевой таймер 28000 вместо 4096 (мягче);
5. своя эмуляция оборота диска (индексный импульс + вращающийся номер) вместо простого счётчика;
6. `buff_wr` и `spt_addr` вынесены из `generate`-блоков (Quartus терпит, Vivado - нет).

#### Свои ошибки методики за этот разбор

* **Первая находка вообще не про запись:** образ был в приводе **B**, а TR-DOS всегда начинает с
  **A** - отсюда «зависание с красными полосами» и бесконечные Seek с ответом «диска нет». Опция
  `MOUNT TO DRIVE` помнит прошлую букву; при свободном A она обязана предлагать A (в бэклог).
* Счётчик срабатываний записи мерил **копию выражения**, а не сам провод в память - «255
  срабатываний» ничего не доказывали. Теперь в память и наружу идёт один провод.
* Петлевая проверка буфера утроила время обслуживания сектора и подвешивала `CAT`; снята.
  ⚠ Но `CAT` подвисает и без неё - отдельная задача (владелец штатно пользуется `LIST`).
* Тест без затравки не доказывает ничего: первая петля сравнивала нули с нулями на пустом образе
  (заметил владелец). Сделан затравленный образ `0:/DISKS/SEED.TRD` (дорожка 0 - валидная пустая
  дискета с меткой `SEEDTEST`, остальное `0xA5`).
* `f_sync` после КАЖДОГО сектора (v236) - это десятки миллисекунд, TR-DOS может не дождаться
  завершения команды. Возвращено к каждому четвёртому (v242).

## 2026-08-06: ЗАПИСЬ НА ДИСКЕТУ - приборный разбор (ядра B0092/B0093, прошивки v235..v239)

Владелец у платы. Разбор шёл заменой догадок на замеры; ниже - что ДОКАЗАНО и что СНЯТО.

### 🥇 Первая находка: запись вообще не начиналась - TR-DOS говорил с ПУСТЫМ приводом

Образ был примонтирован в привод **B** (опция `MOUNT TO DRIVE` запоминает прошлую букву), а TR-DOS
всегда начинает с **A**. Кольцо BDI показало бесконечные Seek и Read Address по приводу A со статусом
`0x90` (не готов + ошибка поиска), команды записи `0xA0` не было ни одной, и в конце машина сорвалась
в чёрный экран с красными полосами. **Гоча: при свободном приводе A диалог монтирования обязан
предлагать A, а не помнить прошлую букву** (в бэклог).

### Что доказано приборно (после того, как образ поставили в A)

| Замер | Результат | Вывод |
|---|---|---|
| сверка записи файла перечитыванием ТЕМ ЖЕ дескриптором | **0 расхождений** | запись на карту исправна |
| счётчик `wren_b` в ПЛИС (B0092) | **255+ за команду** | запись процессора в буфер СРАБАТЫВАЕТ на каждый байт |
| кольцо BDI на записи | имя `test1` в порту `#7F`, длина убывает по 1, DRQ=1, потери данных нет | передачу двигает процессор, а не сторожевой таймер |
| сравнение поданного в буфер с вычитанным (затравка `0xA5`) | **0 отличий** при 512 ненулевых | вычитывание отдаёт РОВНО поданное хостом; записи процессора для него невидимы |
| лог синтеза о буфере | «recognized as a true dual port RAM template», Block RAM 2K x 8, W+R на обоих портах | память общая, порт процессора писать может |

### Снято с подозрения (проверено, не подтвердилось)

* **Размер сектора** - прошивка выставляет код 1 (256 Б) при монтировании, дефолт в ПЛИС тот же,
  а вычисленные LBA сходятся с логикой TR-DOS (LBA 8 = логическая дорожка 1, LBA 4 = служебный блок).
* **`wren_b`, защёлка адреса, `scan_active`, параметры экземпляра** - совпадают с апстримом побайтно.
  ⚠ И выяснилось, что **рабочего примера использования у нас нет**: в `cores/zx-mister/` модуль
  `wd1793.sv` лежит, но НИГДЕ не инстанцируется - вся обвязка (`beta_disk.v`) наша.
* **Два драйвера массива и потерянная запись в Vivado** - опровергнуто логом синтеза (см. таблицу).
* **Отложенная запись FatFs** - `f_sync` теперь после каждого сектора, картина не изменилась.
* **Невыровненные буферы** - буферы сектора сделаны статическими и выровненными на 32 (в шапке файла
  записано, что порча данных уже была вызвана этим), картина не изменилась.

### Твёрдый необъяснённый факт

Записей в **LBA 0**, то есть в сам каталог, **не было ни одной** - только данные файла (LBA 8) и
служебный блок (LBA 4). Поэтому `LIST` пуст при отсутствии ошибок, а TR-DOS показывает «0/0».

### Что мерит B0093

Последнее неизвестное - АДРЕСА двух сторон буфера: `{sd_block[1:0], byte_addr[10:0]}` уходят в слово
вычитывания. Если `sd_block` в момент отдачи сектора не ноль, ARM читает другую половину памяти -
это и объясняло бы всё при исправных обеих сторонах.

### Ошибки методики, свои (записаны, чтобы не повторять)

* **Петлевая проверка утроила время обслуживания сектора** (лишние ~1024 обращения по шине на сектор)
  и была снята. ⚠ НО: подвисание `CAT` осталось и БЕЗ неё, значит прибор тут не виноват - это
  отдельная задача (владелец штатно пользуется `LIST`, он работает).
* **Тест без затравки не доказывает ничего**: первая петля сравнивала нули с нулями на пустом образе.
  Владелец это заметил. Сделан затравленный образ `0:/DISKS/SEED.TRD` (дорожка 0 - валидная пустая
  дискета с меткой `SEEDTEST`, остальное залито `0xA5`).
* Статическая переменная, в которую только пишут и не читают, при `-O2` законно выбрасывается -
  все приборные счётчики обязаны быть `volatile` (потерян один цикл прошивки).

## 2026-08-05 (вечер): веб-КВМ на плате — сервер готов, провода нет

| Версия | Что | Состояние на железе |
|---|---|---|
| v0.15.233 | веб-КВМ `net_kvm.c` (страница, `/frame`, `/osd`, `/api/key`, `/info`), lwIP 2.1.3 из BSP второго ядра слинкован в образ нулевого; Ethernet ОПРОСОМ из главного цикла (`emacps_recv_handler`/`emacps_send_handler` вместо ISR) — ленточный ISR не тронут; `net_init` вызывался В ЗАГРУЗКЕ | ⛔ НЕ ПРОВЕРЕНА: тёплая загрузка по JTAG утащила отладочный APB, ядра исчезли из целей |
| v0.15.234 | то же, но сеть поднимается **только по fs-команде 13 (NET START)**, из загрузки убрана; + `emac_disable_intr()` (порт сам включает линию GEM0 в GIC, а обработчика нет → `Xil_ExceptionNullHandler`); + починка раздачи (`/frame` закрывал соединение после заголовка) | ✅ на карте, грузится, cmd 13 отдаёт `done=1`, порт 80 слушает, плата НЕ падает. ❌ адреса по DHCP нет — см. ниже |

**ПОЧЕМУ СЕТИ НЕТ (измерено, не угадано).** `frames_tx=0`, `frames_rx=0` при включённых приёме и
передаче; MDIO молчит на всех 32 адресах; живые MIO 16..27 и 52/53 стоят как GPIO; такты GEM0 идут из
EMIO. В проекте ПЛИС прежнего веб-КВМ (`ws/ebaz_kvm/hw/design_4_wrapper.xsa`) — `C_EN_EMIO_ENET0` и
выведенные наружу `ENET0_GMII_*`/`ENET0_MDIO_*` в наборе MII. **PHY платы висит на выводах ПЛИС**,
поэтому сеть невозможно поднять одной прошивкой: нужен битстрим. Разбор: `webkvm/WEBKVM_ONBOARD.md`.

**ТУПИК (не повторять).** Замуксовать MIO 16..27 на GEM0 и MDIO на 52/53 из ARM можно, `frames_tx`
даже становится 1, MDIO начинает читать `0xFFFF` вместо нулей — но провода не появляется, а MIO 24/25
это UART платы, и правка его ломает. Откатано, в прошивке этого кода нет.

**Плата оживлена дважды без снятия питания:** `rst -system` на цель `DAP` (`sources/jtag_revive_dap.tcl`).
`rst -por` на Zynq-7000 через xsdb не поддерживается. Отсюда правило: прошивку проверять с карты, а не
тёплым `dow`.

# BUILD HISTORY — Шаг 15 (Pentagon)

Строка на каждый билд: версия / что менялось / бит FPGA / статус на железе.

| Дата | ARM FW | FPGA VER | Что менялось | Статус на железе |
|---|---|---|---|---|
| 2026-07-15 | v0.15.112 | 0xB01B0039 | cpu_starve & warp_latch (инертен на 1×); memory.v force_7ffd&&model (48К); MACHCFG readback | CM 1× — СРЫВ (R Tape loading error); 48К — мусор. Оба фикса не решили |
| 2026-07-15 | v0.15.112 | 0xB01B003A | warp_nc = cpuw_active \| (trun_s[1]&tem_s[1]) — глушить 128К-контеншн на время загрузки ленты | CM 1× — СРЫВ (R Tape loading error 10:13). Контеншн-дрейф не причина. Полная доставка 805468, кастом-загрузчик отработал, финал в ROM |
| 2026-07-15 | v0.15.113 | 0xB01B003A | ARM: case 5 (пауза между блоками) откат push_pause→push_pulse (Шаг-14 поведение); FPGA без изменений | CM — СРЫВ; AUTO-START исключён как причина |
| 2026-07-15 | v0.15.124 | 0xB01B003F | EOT: EAR освобождается до UI; progress обновляется во время drain; block metadata + `sync_wait_popped`; восстановлен штатный contention; отключён ложный `cpu_starve` по raw FIFO empty | PASS: Critical Mass / BigThings / Deflektor, FAST 8× + SYNC, точные count/hash, GAPS=1, RESUMES=0, PC в RAM |
| 2026-07-16 | v0.15.124 | 0xB01B0040 | 4K×32 BRAM dual-clock tape FIFO + 4-word FWFT prefetch; Gray CDC / common POR; MP3 internal-pilot preflight RAW fallback; SD `FR_NO_FILE/FR_NO_PATH` больше не делают unmount | PASS: BigThings TAP FAST8+SYNC `492500/C84A8304`; Aliens MP3 FAST8 quant `606691/15983522`; Arkanoid2 MP3 FAST8 raw fallback `213832/AFD3C49C`; PCM WAV FAST8 `606048/0E676071`. Во всех GAPS=1, RESUMES=0, PC в RAM. QSPI не менялся |
| 2026-07-20 | v0.15.124 | 0xB01B0043 | FAST8 AUTO-ROM: exact existing `PC=056B` demand gate is automatic only for marked standard ROM blocks; removed failed B0042 CPU re-arm experiment. Turbo/custom/WAV/MP3 remain continuous. | Volatile PCAP only. CM FAST8 raw-SYNC-off AUTO-ROM R3/3 `805460/70C5A7AA`, PC `E724,E179,E721`; BigThings R3/3 `492500/C84A8304`, PC `BE63,BCEB,BCA0`; Deflektor R3/3 `958894/6FC55821`, PC `ADA8,ADA8,ADC9`. All gaps=1/resumes=0; screen=PEND; QSPI unchanged. |
| 2026-07-21 | v0.15.124 | 0xB01B0044 | Experimental WAV AUTO 8→4 (fmode=3): CPU-only FAST8 in ROM, phase-safe one-way whole-core SAFE4 after first RAM PC. Existing FAST/SAFE and TAP/TZX/MP3 unchanged. | Volatile PCAP only. EXOLON.wav R3/3 `245141/FA182E93`, gaps=1/resumes=0, PC `5B21,5B21,5B42`; owner visually confirmed game. QSPI unchanged. |
| 2026-07-21 | v0.15.127 | 0xB01B0045 | WAV FAST choice is a whole-core SAFE4 alias from tape start (no CPU-only prefix); MP3 quant policy is calibrated AUTO: force RAW / force quant / known-recording AUTO. MP3 FNV now reseeds per load; AUTO matches a name plus complete raw descriptor identity, never a global heuristic. | **ARM-only, volatile.** Aliens MP3 FAST8 AUTO R3/3: `606691/15983522`, gaps=1/resumes=0, qdbg `2/2`, PC `617B,6137,3C70`; prior forced-quant run owner-visible PASS, final AUTO screen=PEND. Raw Aliens had one owner-visible FAIL despite clean transport, so it is not a candidate default. `Ark2recon.mp3` remains a separate RAW/ROM-error investigation. QSPI unchanged. |

| 2026-07-20/21 | v0.15.12x | 0xB01B0046 | SAFE4: локальный EOT-выход (расследование SAFE4 FAIL на границе FAST/OFF re-arm) | Волатильный; следы top.v:627/634/644/789/936. Снапшот исходников НЕ сохранён (перезаписан). B0046 SAFE4 давал owner-FAIL → устранено в линии до 0x49 |
| 2026-07-20/21 | v0.15.12x | 0xB01B0047 | Диагностический whole-core 2× (`warp_safe2`) | Отвергнут как дефолт; логика в дереве, но выключена (`warp_safe2_active=1'b0` в B0049) |
| 2026-07-21 | v0.15.12x | 0xB01B0048 | Возврат whole-4×; IN-FE trace (fe_trace_count/hash/last на REG4-6 при ROMTRAP=off); map/ula-диагностика | Волатильный; следы top.v:656,1067-1068,1166; axi_ctl.v:126,439. Снапшот не сохранён |
| 2026-07-21 | **v0.15.127** | **0xB01B0049 (ФИНАЛ ночи)** | Кумулятив: BRAM PL4K (0x40) + AUTO-ROM (0x43, `sync_effective` top.v:602) + WAV-AUTO fmode3 (0x45) + fe-trace (0x48); финальная пересборка restored-дерева 21.07 14:36 | **ПРОВЕНАНС ЧИСТ: пересобирается из текущего sources/ (ThinkPad ≡ Мак байт-в-байт; routed DCP в sources/build/). `.bit.bin` SHA `5fa58f3d…ada991`, ARM `9faab201…d957e4`. HW 21.07 (verdict-протокол transport+PC+скрин, по 3 fresh): CM F8-OFF/F8-ON/S4-OFF, BigThings F8-OFF/S4-OFF, Deflektor F8-OFF/S4-OFF — все ✅ FULL PASS с побайтно детерминированными экранами; батч закрывает остальные ячейки. QSPI не менялся (0.14.92)** |
| 2026-07-21 | v0.15.127 | 0xB01B0050/0051 (отвергнуты) | Эксперименты phase-hold после ночи | ОТВЕРГНУТЫ; исходники откачены restore'ом до B0049 (13:53). Логи в `buildlogs/night-2026-07-20/` |

| 2026-07-21/22 | **v0.15.128→129** | 0xB01B0049 (PL без изменений) | **v128:** fs-мейлбокс cmd 7 = APPEND (чанковая дозапись на SD; снимает 7МБ-лимит WRITE — FS_BUF упирается в конец 256МБ DDR); проверен на железе (4 WAV 17-38МБ записаны байт-в-байт). **v129:** MP3-фикс по директиве владельца «MP3 на 8× как WAV» — гибрид-промоция `wavfast==1 → fmode3` распространена с WAV на MP3 (cur_fmode, 1 строка): скрин-верифицировано, что MP3 с кастом-загрузчиками на голом CPU-FAST8 залипают (ARKANOID2 0/3, PC=FF8x в собственном загрузчике) или флейкают (ALIENS ~2/3), а на гибриде проходят (ARK2 3/3+6/6, ALIENS 6/6+8/9). «MP3 remains true FAST8» эпохи B0045 признано ошибкой — прежние MP3-8× PASS были transport-only | ELF v129 `9ccd84ad…68c27`. Валидация 14/14: ARK2-детектор 3/3, ALIENS 6/6, dizzy-стандарт, TAP-регрессия CM/BT эталонные. Свип 199 MP3 на «8×» — batch6. QSPI/BOOT.BIN не менялись; persist-кандидат будет пересобран на v129 после зелёного свипа |

| 2026-07-23 | **v0.15.131 → ПРОШИТА** | 0xB01B0049 | Релиз эстафеты: v129 (MP3-гибрид) + меню NORMAL/FAST + бут-санация тейп-FIFO (60мс; хвосты убитых прогонов не переживают ресет); маркировка v130 выключена if(0) | **PERSIST: 0:/BOOT.BIN (бэкап 0.14.92=BOOT0148.BAK); холодный старт с SD + cold-smoke 4/4 байт-в-байт эталон (CM/BT/ALIENS/EXOLON)** |
| 2026-07-23 | **v0.15.132 → ПЕРЕПРОШИТА** | 0xB01B0049 | Единый SYNC по директиве владельца: AUTO/ON/OFF (дефолт AUTO = demand-гейт ВЕЗДЕ, все скорости/форматы; OFF = аварийный люк на NORMAL/4×, на 8× гейт зашит в бите) | Батарея 10/10: регрессия чистая; STARQUAK NORMAL+AUTO замирает на PAUSE (count=134873), +OFF проезжает (173341+) — семантика доказана счётчиками. BOOT_B0049_v132 → 0:/BOOT.BIN |
| 2026-07-23 | v0.15.133-134c | 0xB01B0049 | **SMART-фаза:** (v133) pd_decode_tap — декод g_pd-фронтов в байты с чексум-верификацией → виртуальный TAP (прототип: dizzy 6/6 блоков OK из PCM И lossy MP3; попутно раскрыт v130-фриз: ран 0xFF-данных = псевдо-пилот @537435). (v134) **Tier-0 «как снапшот»**: парсер TAP/TZX-структуры (хедеры→адреса, BASIC→CLEAR/USR/POKE, VAL "n"-идиома) → прямой инжект через снапшот-машинерию (machine_reset+wr_bank+inject_finish); мульти-USR отвергается (цепочки инициализации, BigThings). g_tier0_diag — телеметрия отказов | **HW: CAVE48K инжект ~1с (PC=C8xx, скрин-эталон 1d03cbb3); BigThings diag=0xB→пульсы+анимация; CM/dizzy/ALIENS фолбэк эталонный. НАХОДКА: fabric byte-feed (Tier-1) МЁРТВ на B0049 — smart-RTL был только в бите 0x3E; вызовы запаркованы (g_bytefeed_en=0). Идёт корпусной замер 199 MP3. Волатильно, в прошивку НЕ шито** |

| 2026-07-23 | v0.15.135-135d | 0xB01B0049 | Dizzy-класс: статический эмулятор цепочки загрузчиков (tier0_scan_loader: оп-таблица, DE/IX/BC/A/SP/OUT-7FFD, CALL 0556→блок, «первый JP после последнего CALL», рекурсия по вторичным лоадерам, банки 128К) + sysvars-донор 0x5B00-0x5CFF + last-bit recovery декодера | Скан ВЕРЕН по данным (dizzy: 4 блока/bank3/вход 0x6100 — сверено дизасмом), но рантайм-записи лоадеров статически невоспроизводимы (машинодетект 0x5C4B) → dizzy-инжект даёт чёрный экран → **ЗАПАРКОВАН диаг=17**, фолбэк в пульсы чист (эталон-меню). Дорога: bounded Z80-интерпретатор / fabric-трап |
| 2026-07-23 | **v0.15.136 → НА SD** | 0xB01B0049 | **«СПАСТИ КАК TAP»**: pd_rescue_tap — при SMART=YES чистый декод пишет `<имя>.res.tap` рядом с исходником (CREATE_NEW; диаг 1/2/3) | HW: dizzy3_cbr_pilot.mp3 → **dizzy3_cbr_pilot.res.tap 64845Б на SD** (реставрация 20-летней оцифровки!), повтор=exists-skip. Записана в 0:/BOOT.BIN (кандидат 27dbdda1…, бэкап цел); **ЖДЁТ power-cycle владельца + cold-smoke**. SMART остался опцией (дефолт NO — до корпусной статистики свипа) |

**Провенанс-аудит 21.07 (read-only агент):** ночные билды собирались в ОДНОМ дереве `sources/` с правкой VERSION на месте → снапшоты B0041–B0048/50/51 уничтожены перезаписью; воспроизводим полностью только B0049 (+ частично B0040 — базлайн-копия top.v в корне шага). Заявление «AUTO-ROM-слой не воспроизводим» неверно для финала: слой живёт в B0049-дереве. Хрупкие /tmp-логи заархивированы в `buildlogs/night-2026-07-20/`. Урок: перед persist каждого релиза фиксировать снапшот sources/ (или завести git).

## Ключевые находки CM (регрессия 14→15)

- CM грузит **99%**: стандартные блоки (ROM LD-BYTES), кастом-загрузчик (0xFB.., старт ~0xFA24), турбо-блоки, финальный 36818-байтный блок — вся доставка 805468 импульсов проходит, потом срыв.
- **НЕ широкая регрессия** — большинство лент грузится. Специфика тугого турбо CM.
- FPGA-тейп-путь 128К/1× исчерпывающе доказан идентичным Шагу 14 (ядро сводится к базе при pentagon=0/warp_nc=0; tape_player-consume не менялся; clocking MMCM идентичен).
- **Настоящее расхождение — в ARM** (v0.15.17 vs v112, 95 версий). `tape_pump` case 5 (пауза): Шаг 14 `push_pulse` (один фронт+toggle) → Шаг 15 `push_pause` (1мс + LOW, конец на LOW). Биты данных (case 1-4,6) идентичны. Гипотеза: пауза push_pause заканчивается LOW и сливается с первым LOW-пилот-импульсом следующего блока (нет граничного фронта) → тугой Durell-загрузчик теряет синк блока после паузы.
| 2026-07-30 | NES CE19 | nes_ce19.bit.bin | CHR 8К→32К + отдельный WRAM 8К (закрыта закладка MMC1/MMC3 «сейв затирает PRG-банк 0») | на железе: SMB/Tank/Contra OK, sticky «запись в PRG»=0 |
| 2026-07-30 | NES CE20 | nes_ce20.bit.bin | шифтер джойпада по СПАДУ joypad_clock (фронт = все кнопки съехали на бит, вечное «вправо») | на железе: меню мультикарта стоит, Select двигает курсор SMB |
| 2026-07-30 | NES CE21 | nes_ce21.bit.bin | SCR_SCALE 0x118: живой целочисленный масштаб (реципрок 14 бит), DSP 7→9 | на железе: NES ×3/×3=768×720, ZX не тронут |
| 2026-07-30 | NES CE22 | nes_ce22.bit.bin | ЕДИНЫЙ порядок бит джойпада для всех ядер (nes_order() — единственный адаптер) | на железе: bit6=Select, bit7=Start, bit0=Right подтверждены |
| 2026-07-30 | NES CE23 | nes_ce23.bit.bin | ps2_tx перенесён в NES-топ (INHIBIT пересчитан под 100 МГц): команды клавиатуре/лампочка NumLock | на железе: KBD_TXSTAT ACK=1 |
| 2026-07-30 | ZX ATLAS A (B01B0061) | atlas_base_a.bit.bin | ЭТАЛОН «до» для выноса control_plane (текущее дерево, без рефакторинга) | на железе: 128-меню, кадр md5 360a1b36, три буфера идентичны, TX ACK=1 |
| 2026-07-30 | ZX B01B0062 | atlas_cplane_b.bit.bin | ВЫНОС control_plane.v: оболочка одним модулем (топ 1715→1224 строк) | на железе: кадр 128-меню БАЙТ-В-БАЙТ с эталоном A во всех 3 буферах DDR, cap_geom совпал, TX ACK, LUT 72.60→73.04% |
| 2026-07-30 | NES CE24 | nes_ce24.bit.bin | тот же вынос со стороны NES (топ 500→~200 строк) | на железе: TV.NES байт-в-байт с CE23 на одной загрузке, LUT 81.25→80.98%, numpad/Space/NumLock проверены |
| 2026-08-03 | ZX B0071 | (не деплоилось) | ПЗУ 4 страницы + порт заливки от ARM, первая версия | СНЯТ состязательной проверкой до железа: дефолт ROM_PAGES=4 ломал сборки шагов 06-14, инкремент адреса не был загейтен по loading |
| 2026-08-03 | ZX B0072 | (не деплоилось) | + гейт инкремента, счётчик фактов 0x144, сторож заливки, бит8 вместо бита5, полное чтение 0xBC | СНЯТ: не хватало достижимости страницы 3 и $clog2 у ширины индекса |
| 2026-08-03 | ZX **B0073** | atlas_b0073.bit.bin | ПЗУ = 4 страницы по 16 КБ, записываемые ARM-ом с карты (0x154/0x158/0x15C + счётчик фактов 0x144 + сторож), трап входа в TR-DOS (MACHINE_CFG бит8), сервисная страница (бит9), LOAD_CAPS бит4 | **на железе:** кадр байт-в-байт с B0070 на ПЗУ по умолчанию (md5 4c33f177), пентагоновское ПЗУ исполняется (пункт TR-DOS в меню), TR-DOS 6.11Q поднялся и увидел мегабайт, ROM_LDCNT=65536; LUT 13438 (76.35 %), BRAM 58.5/60, тайминг закрыт |
| 2026-08-03 | ARM **v0.15.207** | loader.elf | ROM SET + SERVICE ROM в опциях машины (рантайм-список из 0:/ROMS/), раскладка страниц ПО СОДЕРЖИМОМУ, ini `<тег>.romset`/`<тег>.svcrom`, перезаливка набора после PCAP-смены ядра, попутно закрыта утечка `loading` в `nes_load` на путях ошибки | на железе: см. строку B0073 |
| 2026-08-03 | ZX **B0074** | atlas_b0074.bit.bin | 🔴 ПОЧИНЕНО ЧТЕНИЕ РАСШИРЕННЫХ БАНКОВ: в CDC мастера памяти флаг подтверждения обгонял данные (машина получала байт ПРЕДЫДУЩЕЙ транзакции в 5-10 % чтений) - подтверждение отдаётся через 2 такта после данных, байт снимается напрямую, `rd_byte` только для машины, запрос машины защёлкивается (потерянный импульс морозил Z80 насмерть), тоггл запроса тоже с форсажем; `MEM_STAT` собирался из 34 бит в 32-битный провод | **на железе:** свой тест на живом Z80 - было 14-26 расхождений в каждом из 56 расширенных банков, стало **0 из 14336**; заливка 16 КБ шаблоном `PUSH HL` (как у UMT) - **0 из 16384**, дважды; LUT 13432 (76.32 %), BRAM 58.5/60, тайминг закрыт |
| 2026-08-03 | ZX **B0075..B0077** | atlas_b0077.bit.bin | ДИСКОВОД: Beta Disk + WD1793 (наш экземпляр, RWMODE=1/EDSK=0) внутри ядра, порты #1F/#3F/#5F/#7F/#FF под гейтом страницы ПЗУ TR-DOS, мост подачи секторов от ARM (0x160/0x164/0x168) + перехват команд TR-DOS (0x16C). B0076 = фикс сдвига сектора на байт | **на железе:** TR-DOS читает каталог TRD, запускает boot (MAXBOOT v9.1), с образа загрузился и пошёл музыкальный пак ETUNES 7 (592 сектора); Elysium показывает титул (155 секторов) и встаёт - открыто. LUT 13980 (79.4 %), BRAM 59/60, тайминг закрыт |
| 2026-08-03 | ARM **v0.15.208/209** | loader.elf | монтирование TRD (`.trd` в навигаторе и в JTAG-автозапуске), служба подачи секторов из главного цикла, журнал последних 12 LBA в мейлбоксе. v209 = уровни FDC_CTL в теневой копии (команда больше не обнуляет «дискета готова») | на железе: см. строку B0077 |
| 2026-08-04 | ZX **B0082** (volatile) | atlas_b0082.bit.bin | `READ ADDRESS` переведён с синтетического `ra_sector` на свободно бегущую фазу 300 rpm / 16 ID; запись Sector Register больше не выбирает возвращаемый ID | на железе: прежний цикл SEEK↔READ ADDRESS после 25 секторов устранён, Elysium грузит 671–677 обслуживаний и иногда проходит лицо, но фазозависимо теряет звук/уходит в ROM либо глючит на второй точке; `MACHINE_CFG=0x101` неизменен |
| 2026-08-04 | ZX **B0083** (volatile PCAP, live) | atlas_b0083.bit.bin | Диагностическое кольцо 12 значимых BDI-событий в `beta_disk.v`; WD1793 функционально идентичен B0082. Dump: `/tmp/dump_b0083_ring.tcl` | PCAP done=1/err=0, VERSION B01B0083, MACHINE_CFG=0x101, ARM v214 жив. Первый живой прогон не был Elysium: read-only строки мейлбокса подтвердили `0:/loadtest/aliens.mp3`; экран `CRC summ of R0...R13 OK` относится к нему и не является результатом BDI. Ранний dump содержал `READ ADDRESS C0`, но не является crash-снимком; HOST во время/после dump изменился 6→584, поэтому путь выборки кольца ещё проверить на невмешательство. SHA `2d1af67a…7bbee8e`, 1,167,616 Б; LUT 14314 (81.33%), FF 13482, BRAM 59/60, WNS +0.377 нс, WHS +0.026 нс, 0 errors |
| 2026-08-04 | ZX **B0083 face-hang** | без новой сборки | Первый валидный crash-ring Elysium: `READ SECTOR` → Data=0F → `SEEK 18` → `READ ADDRESS C0` → одно чтение `#FF=3F`, затем ни одного Data `#7F` | Лицо зависло, `HOST=483`, `MEMWR` неподвижен, конечный FDC `INTRQ=1/DRQ=0/BUSY=0`. Артефакты `buildlogs/bdi-2026-08-04/{face_hang.png,face_hang_ring.log}`. Короткий следующий A/B без build: MACHINE_CFG bit10 (`bdi_always`), 0x101→0x501; если не поможет — логировать завершение READ ADDRESS/ready/lost-data/state |
| 2026-08-04 | ZX **B0083 bdi_always A/B** | без новой сборки | Выставлен существующий `MACHINE_CFG bit10`: `0x101→0x501`, BDI виден вне защёлки TR-DOS | Уже зависшее лицо за 15 с не ожило (`MEMWR=01D0E77C`, HOST=483), что не является verdict: C0 уже закончилась. Текущее железо оставлено на B0083/cfg501; нужен один свежий запуск Elysium, лицо + кубы |
| 2026-08-04 | ZX **B0083 fresh bdi_always A/B** | без новой сборки | Выявлено: cfg501 ломает ZX-клавиатуру, потому что частичный `sys_sel` BDI алиасит `#FE`; запуск поэтому выполнен при cfg101, после начала секторного потока переключено на cfg501 | `/tmp/start_elysium_then_bdi_always.tcl`: TR-DOS вошёл, RUN принят, новый host-counter=13, затем cfg501, MACH=FF802400. Владелец наблюдает лицо/звук/кубы; это чистый текущий A/B |
| 2026-08-04 | ZX **B0083 bdi_always REJECTED** | без новой сборки | cfg501 дал немедленный чёрный экран: частичный System decode алиасит каждый IN/OUT #FE, поэтому порт бордера/бипера меняет BDI sysreg | Тест невалиден как проверка WD1793. Немедленный откат cfg501→101 подтверждён (B0083, MACH=FF802441, HOST=38). Следующий B0084: точные #1F/#3F/#5F/#7F/#FF + отдельный bdi_session до reset; Kempston остаётся при session=0 |
| 2026-08-04 | ZX **B0084** (volatile PCAP, live) | atlas_b0084.bit.bin | Exact BDI decode #1F/#3F/#5F/#7F/#FF; bdi_session until reset; img_mounted level handshake; WD1793 unified rotation+index, READ ADDRESS CRC, HLT pin | VERSION B01B0084 CFG=101. session=1 after trdos=0 confirmed. ELYSIUM.TRD → title host~155. ELYSTATE.TRD → host~407 with READ ADDRESS C0 in ring; hang on READ SECTOR trk0 sec8 zero data; sometimes later BASIC. SHA bit.bin `f5fb7e03…4487b6` 1154720 B. timing OK. NOT full demo yet |
| 2026-08-04 | ZX **B0085** (volatile PCAP, live) | atlas_b0085.bit.bin | #FF readback SIDE/HLT/DS; DRQ ~32us; lost-data 8ms; sticky HLT; B0084 session+decode+CRC | ELYSTATE host=671 full load; demo runs MEMWR+Stardust OCR; pause@407 then continues; LBA OK. SHA b48e2730 1151488B. timing OK |
| 2026-08-04 | ZX **B0086** (volatile PCAP, live) | atlas_b0086.bit.bin | HDMI bottom-right BDI floppy activity icon (bdi_activity_icon.v); FDC_STAT busy/DRQ/sd_rd/sd_wr/sd_ack; hold 150ms blink LED R/W colours; outside machine window | VERSION B01B0086. SHA cd4d30e5…eb4f00 size bit.bin 1204288. timing met. night task also started: ROM audit + GS/OPL3/MIDI plan in notes Lichnoe/BulbuLator |
| 2026-08-05 | ZX **B0087** (volatile PCAP, live) | atlas_b0087.bit.bin | 🔴 SAA1099 В БИТСТРИМЕ БЫЛ ЗАГЛУШКОЙ: build.tcl читал ДВА модуля с именем saa1099 - настоящий zx/src/saa1099.sv и пустой zx/src/saa.v (out_l=out_r=0), второй перекрывал первый (лог B0086: CRITICAL WARNING [Synth 8-9873] + все порты чипа без нагрузки). Поэтому молчала ВСЯ SAA-музыка, в том числе ETUNES 7 (по коду образа доказано: OUT #01FF,#1C / OUT #00FF,#02 = регистр 0x1C SAA1099, а не TurboSound). Заглушка убрана. Арбитраж #FF между SAA и Beta Disk - опция машины MACHINE_CFG [12:11] AUTO/ON/OFF; AUTO глушит SAA только при вставленной странице ПЗУ TR-DOS ИЛИ живой активности дисковода (новый выход bdi_busy, хвост ~4.6 мс) - НЕ по липкой bdi_session, иначе пак с дискеты молчал бы весь сеанс. Селект TurboSound приведён к эталону (#F8..#FF вместо одного бита d[4]): ETUNES делает OUT #FFFD,#F6 и уводил второй AY. turbosound форкнут в sources/turbosound_bulb.v, чтобы не задеть шаги 06-14 | **на железе:** PCAP done=1/err=0, VERSION B01B0087, MACHINE_CFG=0x101 (AUTO), ARM v216 жив. SHA256 `21b89a25...cf471c`, 1161696 Б. LUT **15284 (86.84 %)** (+887 за настоящий SAA), FF 13911, BRAM 59/60, DSP 13, **WNS +0.328 / WHS +0.017, все констрейнты met**, 0 ERROR, 0 CRITICAL WARNING. ⏳ ЖДЁТ УШЕЙ ВЛАДЕЛЬЦА на ETUNES7.TRD - без пик-метра звук не объявляю рабочим |
| 2026-08-05 | ZX **B0088** (на карте, рабочее) | atlas_b0088.bit.bin | SAA1099 получает РОВНО 8 МГц: деление spclk 56.6667/7 давало 8.0952 МГц, то есть чип звучал на +1.19 % = +20.3 цента выше нормы. Замерено в xsim (стенд tb_saa1099.sv): 8 094 500 Гц против эталонных 8 000 000. Заменено фазовым аккумулятором inc=2368548/2^24 -> 7 999 995 Гц (-0.6 ppm). Арифметика САМОГО чипа сверена с datasheet и ВЕРНА: полупериод тона в тактах ce совпал до единицы на freq/oct = 0/3, 255/4, 200/5, 128/2; темпы шума 31248/15624/7812 против 31250/15625/7812.5; 0x1C бит0 глушит выход, бит1 замораживает генераторы. + новый машинно-агностичный слот **0x170 AUD_DBG**: пики по источникам {SAA[31:24], AY2[23:16], AY1[15:8], SpecDrum[7:2], бипер[1]}, окно 74 мс (бипер однобитный - мерим переключения). Ставилось ради правила владельца «не объявлять музыку рабочей без пик-метра» и как основа под General Sound | **на железе:** VERSION B01B0088, SHA `bf65db08...`, 1161728 Б. LUT **15340 (87.16 %)** (+56 к B0087), FF 13911, BRAM 59/60, DSP 13, **WNS +0.137 / WHS +0.024, все констрейнты met**, 0 ERROR, 0 CRITICAL WARNING. Закреплено как `0:/CORES/ATLAS.BIT.BIN` (откат `ATLASB78.BIN`); карта вычищена - в CORES ровно 4 файла. **ПРИЁМКА ЗВУКА ПРОЙДЕНА ПРИБОРНО:** на SAM-музыке (`SAMMUS1.TRD`) AUD_DBG даёт SAA=59..113 при AY1=AY2=0, экран машины по зеркалу цел (SAM coupe MUSIC, MELODY 04). A/B B0087 vs B0088 показал, что артефакты на 1099TEST от такта НЕ зависели - у них была другая причина (машина стояла в ZX 128K, а паку нужен мегабайт) | 
| 2026-08-05 | ARM **v0.15.217** | loader.elf | Опция машины **SAA1099 = AUTO / ON / OFF** (MACHINE_CFG биты 12:11) + ini-ключ `<тег>.saa` + пер-машинное хранение. Живая правка: меняются только биты 12:11 того же слова, ни ПЗУ, ни страничность, ни сброс не трогаются. Строка меню добавлена ТОЛЬКО В КОНЕЦ таблицы (индекс 52) и в сторож MENU_IX_EXPECT | собрана BUILD_OK; вошла в BOOT_ZX_B0088_V217.BIN, но на карте её заменил v218 (одного холодного старта хватит на обе фичи) |
| 2026-08-05 | ARM **v0.15.218** | loader.elf + BOOT_ZX_B0088_V218.BIN | **МОНТИРОВАНИЕ SCL** в тот же дисковод, БЕЗ правок RTL. SCL - это дефрагментированный TRD, поэтому дорожка 0 (каталог + инфо диска) синтезируется в ОЗУ (`scl_build`, буфер 4 КБ), а данные читаются прямо из файла со сдвигом на упакованный каталог (`disk_read_lba`); чтение за концом данных даёт нули = пустая часть дискеты. Образ опознаётся ПО СОДЕРЖИМОМУ (подпись `SINCLAIR`), а не по расширению. Число секторов берётся ТОЛЬКО из каталога: у 11 образов из 400 есть лишний хвост 4/8 байт, и проверка по размеру файла отвергла бы их зря. Контроллеру показывается полная дискета 80T/DS (655360), запись запрещена (формат упакованный). `.scl` добавлено в обе точки разбора расширений | **САМОПРОВЕРКА ДО ЖЕЛЕЗА:** из заведомо верного `1099test.trd` собран SCL, прогнан тот же алгоритм синтеза и сверен с ОРИГИНАЛЬНОЙ дорожкой 0 - все записи каталога и все 7 полей инфо-сектора (первый свободный 6/8, тип 0x16, файлов 2, свободно 2426, признак 0x10) совпали, первый сектор данных тоже. На карту положены `1099TEST.SCL` (тот же контент, что у TRD = идеальный A/B) и `GENS4.SCL` (сторонний упаковщик, хвост 4 Б). ⏳ ждёт холодного старта владельца |
| 2026-08-05 | ARM **v0.15.219** | loader.elf | **Имя вставленного образа видно в двух местах.** (1) У аппаратной иконки дисковода поверх работающей машины - через баннерный слой 256x64, который ARM растеризует сам; позиция (976,660), то есть правый край плоскости 1232 при иконке с 1240. Второй слой в фабрику НЕ добавлялся: баннер один, а паузы и вставленной дискеты одновременно не бывает - решает приоритет (пауза/глушение/лента важнее). (2) В нижней строке навигатора справа; чтобы подсказки F-клавиш не залезали под метку, в раскладку добавлен резерв колонок ДО расчёта, а не после | собрана BUILD_OK |
| 2026-08-05 | ARM **v0.15.220** | loader.elf + BOOT_ZX_B0088_V220.BIN | **ЧЕТЫРЕ ПРИВОДА Beta Disk (A/B/C/D)** - владелец верно заметил, что при живом BDI приводов должно быть несколько. RTL не тронут: номер выбранного привода фабрика уже отдаёт в `FDC_STAT[1:0]` (`sysreg[1:0]`). Состояние стало пер-приводным (`g_dfil/g_dopen/g_dnm/g_dsz/g_dscl/g_dlv` + своя синтезированная дорожка 0 на привод), служба секторов читает номер привода из статуса и при смене перетолкивает ЕГО уровни (готовность/защита/геометрия) - у образов разный размер. Пустой привод отвечает пустым сектором, а не морозит контроллер. Опция меню **MOUNT TO DRIVE = A/B/C/D** (индекс 53, добавлена в конец таблицы и в сторож MENU_IX_EXPECT), метка в навигаторе показывает ВСЕ приводы (`A:ИМЯ B:ИМЯ`, длина имени сжимается под их число), у иконки - последний обслуженный привод с буквой. Одиночные `g_disk/g_disk_open/g_disk_name/g_disk_size` УБРАНЫ намеренно: компилятор их возврат не поймает, а чтение молча давало бы нули | собрана BUILD_OK, BOOT.BIN на карте сверен байт-в-байт (1626452 Б). **ПРОВЕРЕНО НА ЖЕЛЕЗЕ:** владелец смонтировал образы в A и B, оба обслужены. Доказательство из журнала мейлбокса, а не со слов: на один и тот же `LBA 8` (ПЕРВЫЙ БЛОК ДАННЫХ - инфо-сектор дискеты лежит в LBA 4, это моя неточность в первой редакции строки) контроллер получил РАЗНОЕ содержимое в двух наборах обращений (`b511=0x7F` против `0x36`), дальше читались разные места образов (LBA 135 против 66), 146 секторов отдано, зависаний нет. Риск, заявленный до проверки (импульс «образ вставлен» при смене привода может сбить контроллер, если TR-DOS переключится посреди операции), НЕ подтвердился. Дублирование записей в журнале - норма: сектор TRD 256 Б, блок LBA 512 Б, на два соседних сектора один запрос |
| 2026-08-05 | ARM **v0.15.221** | loader.elf + BOOT_ZX_B0088_V221.BIN | **Модальный выбор привода при вставке образа** (по образцу machine_select_dialog): радио-список A..D, и в КАЖДОЙ строке показано, что в этом приводе уже вставлено (иначе букву пришлось бы выбирать по памяти). Буквы A/B/C/D на клавиатуре выбирают привод напрямую, Esc отменяет вставку целиком. Предвыбор берётся из опции `MOUNT TO DRIVE`, и она же обновляется выбранной буквой - привычный путь «выставил букву в меню и монтируй» продолжает работать. Статус после вставки говорит букву: `DISK IN A:`. Диалогу нужно предварительное объявление: он определён рядом с прочими диалогами (~6700), а вызывается из `browser_enter` (~4880) | собрана BUILD_OK, BOOT.BIN на карте сверен байт-в-байт. ⏳ ждёт холодного старта |
| 2026-08-05 | ARM **v0.15.222** | loader.elf + BOOT_ZX_B0088_V222.BIN | Владелец уточнил: имена нужны в строке ВНИЗУ ЭКРАНА у иконки дисковода, а не в интерфейсе навигатора. Сделано: в баннерном слое **каждый привод на своей строке** (было - только последний обслуженный, одной строкой). Плоскость 64 px при масштабе 2 = 16 px на строку, то есть ровно четыре привода; блок прижат к низу плоскости, а плоскость к иконке (низ 704 = низ иконки, правый край 1232 при иконке с 1240). Пустые приводы не показываются. Приоритет прежний: пауза, глушение и лента важнее имён. Версия поднята с 221, хотя правка небольшая: на карте оказался бы другой образ под тем же номером | **ПРИБОРНЫЙ ИТОГ ПО ВСЕЙ ДИСКОВОЙ АРКЕ (замер состояния прошивки по символам ELF + журнал фабрики):** `A: 1099TEST.SCL (SCL=1)`, `B: ELYSTATE.TRD`, `C: ETUNES1.TRD`, `D: GENS4.SCL (SCL=1)` - **все ЧЕТЫРЕ привода заняты одновременно**, выбран привод D (`sysreg=0x7`), 167 секторов отдано, зависаний нет. Этим же замером доказано, что **SCL работает на железе**: два образа из четырёх - SCL, и читается прямо сейчас именно SCL (синтезированный каталог в LBA 0/4 плюс последовательные данные LBA 197..203 со сдвигом на упакованный каталог). Оба формата сосуществуют в одном дисководе. FatFs это выдерживает штатно: в BSP `FF_FS_LOCK = 0`, то есть лимита на число открытых файлов нет (единственный неочевидный риск - образы держим открытыми постоянно) |
| 2026-08-05 | ZX **B0089** (на карте, рабочее) | atlas_b0089.bit.bin | **ЗАПИСЬ НА ДИСКЕТУ СТАЛА ВОЗМОЖНА.** Контроллер писать умел и раньше (`RWMODE=1` -> `s_readonly = wp`), но наша обёртка ВЫБРАСЫВАЛА провод, которым он отдаёт содержимое своего буфера наружу: `.sd_buff_din (wd_buff_din_unused)`. То есть ARM физически не мог прочитать сектор, записанный машиной - моя первая оценка «это только прошивка» была НЕВЕРНА, и я её снял до начала работы. Сделано без новых AXI-регистров: свободный **бит11 `FDC_CTL`** = режим вычитывания (строб `FDC_DATA` шагает адресом буфера НЕ записывая - иначе затёрли бы ровно те данные, которые отдаём), а `FDC_STAT2` (0x16C) в этом режиме отдаёт `{адрес[8:0], байт[7:0]}` вместо отладочного кольца (кольцо при записи не нужно). Флаг синхронизирован в домен машины 2 триггерами | **на железе НЕ проверено (ждёт холодного старта).** 0 ERROR, 0 CRITICAL WARNING, LUT **15363 (87.29 %)** (+23 к B0088), FF 14085, BRAM 59/60, DSP 13. ⚠ **ТАЙМИНГ СО ВТОРОГО ЗАХОДА:** на дефолтных директивах вышло **WNS -0.157 / TNS -0.413**, причём падали НЕ мои пути, а пиксельный тракт OSD (`osd_i/pos_q_reg[3]` -> `rgb24_osd_q`) в домене `clk_pix_raw`: из 13.2 нс задержки **9.8 нс разводка**, то есть дизайн упёрся в тесноту при 87 %. Лечится усиленными проходами в `build.tcl` (`place/route -directive Explore` + два `phys_opt_design`) -> **WNS +0.108 / WHS +0.016 / TNS 0, 0 нарушенных путей, met в обоих отчётах**. Вывод на будущее: перенос буферов оболочки LUTRAM->BRAM (~2.3k LUT) переехал из бэклога на КРИТИЧЕСКИЙ ПУТЬ - он же нужен под TS-FM |
| 2026-08-05 | ARM **v0.15.223…226** | loader.elf + BOOT_ZX_B0089_V226.BIN | **v223 запись:** опция `DISK WRITE = READ ONLY / WRITE`, дефолт только чтение и **намеренно НЕ сохраняется в ini** (защита должна заново встать на каждом включении). SCL не пишется никогда. Вопрос владельца «а как ARM отработает запись?» вскрыл настоящий баг: образ открывался `FA_READ`, и `f_write` вернул бы `FR_DENIED` - запись не работала бы ВООБЩЕ; теперь `FA_READ|FA_WRITE` с честным откатом на чтение (флаг `g_dro`, защита остаётся поднятой) + проверка границ образа, чтобы кривой LBA не удлинил файл. `f_sync` раз в 16 секторов и на извлечении. **v224 безопасное извлечение:** `disk_eject_safe` ждёт простоя контроллера (`sd_rd/sd_wr/BUSY/DRQ`), ДООБСЛУЖИВАЯ начатое, и лишь потом `f_sync`+`f_close`; за 2 с не освободился - честный отказ, образ не тронут. Диалог получил кнопку `Eject` (клавиша `E`; `K_F8` в перечислении нет) и режим управления без вставки, в меню пункт `DISK DRIVES`. Строка `Mount to drive` убрана из подменю (роль забрал диалог), но запись в таблице ОСТАВЛЕНА: индексы прибиты как `&opt_items[N]`, сдвиг сломал бы ссылки. **v225:** F1 показывает справку только при открытом навигаторе - раньше он сам открывал окно и выдёргивал работающую машину из полного экрана. **v226 (баг, найденный владельцем):** при смене машины дискеты теперь ИЗВЛЕКАЮТСЯ, и обязательно ДО перезагрузки ядра - у NES дисковода нет вовсе, и незаписанный сектор потерялся бы молча | собраны BUILD_OK. На карте `BOOT.BIN` = B0089+v226 и `ATLAS.BIT.BIN` = B0089, оба сверены байт-в-байт обратным чтением. ⏳ ждёт холодного старта: проверять запись из TR-DOS (`SAVE`), извлечение при активном обмене, F1 при закрытом навигаторе, смену машины на NES |
| 2026-08-05 | **ЗАПИСЬ НА ДИСКЕТУ: НЕ РАБОТАЕТ** (ядро B0089 + прошивка v0.15.228, на железе) | — | Итог приборной проверки: **на карту не легло ни одного значащего байта.** Прочитан ВЕСЬ образ `test.TRD` (655360 Б): ненулевых байт 13, и все — инфо-сектор, который записал `trd_create` при создании. Каталог пуст, `Free Sector 2544` не изменилось. TR-DOS при `SAVE` показывает файл с длиной `0/0` и сообщает об ошибке, второй `SAVE` подвешивает машину. **Что при этом ИСПРАВНО (проверено):** разрешение записи (`opt_diskwr=1`, `g_dro=0`), защита снята (`g_dlv[A]=0xA0000060` -> `wp=0`), запись в файл идёт (`g_disk_wrn=6`, `g_disk_err=0`), мой путь возврата буфера B0089 работает (пассивный тест: адрес в `FDC_STAT2` шагает 0..239 точно, режим бита11 доезжает, мультиплексор верен). **КОРЕНЬ:** в `RWMODE=1` команда записи СНАЧАЛА просит хост прочитать целевой блок (`sd_rd`), мы отдаём его из файла (пустой образ = нули), затем процессор должен вписать свои байты через порт B (`wren_b = wre & buff_wr & (addr==A_DATA) & ~scan_active`), и лишь потом блок возвращается нам по `sd_wr`. Байты процессора в буфер НЕ попадают, поэтому мы возвращаем на карту тот же сектор, что сами подсунули - на пустом образе это выглядит как «ничего не произошло». Согласуется с `drq=0` в замере и с тем, что темп DRQ в B0085 настраивался ТОЛЬКО под чтение. **Следующий шаг:** кольцо отладки BDI (B0083, доступно при снятом бите11) во время `SAVE` -> увидеть, чем кончается команда (`s_lostdata` / `s_wrfault`), затем править путь записи в wd1793/beta_disk и пересобирать. | ⚠ **ЧЕТЫРЕ МОИХ ТУПИКА, НЕ ПРОХОДИТЬ ЗАНОВО:** (1) «`sd_wr` не появляется, значит защита» — НЕВЕРНО, опрос раз в 50 мс пропускает запросы, которые ARM обслуживает за микросекунды; (2) «гонка на входе в режим вычитывания» — НЕВЕРНО, тест показал точный шаг адреса; (3) «`sd_block` уезжает под нами во время вычитывания» — НЕВЕРНО, `sd_busy` снимается по СПАДУ `sd_ack` (`if(ack[5:4]=='b10)`), то есть блок инкрементируется только после закрытия окна; (4) мой первый пассивный тест буфера дал нули не из-за поломки, а потому что окно открывалось ВНЕ реальной передачи, когда `sd_block` остался единицей после прошлой операции - тест был поставлен неверно. **Безопасность:** `DISK WRITE` держать в `READ ONLY` до закрытия бага; запись возвращает в сектор его прежнее содержимое, и `err=0` об этом не предупреждает |
**Гоча записи на карту: НИКОГДА не запускать два мейлбокс-писателя одновременно.** Я оставил висеть
второй прогон `put_card.tcl` на тот же файл - он отчитался «прочитано 0, РАСХОЖДЕНИЕ», и состояние
файла стало недостоверным. Мейлбокс один, очереди у него нет. Вылечено одним чистым прогоном с
побайтной сверкой обратного дампа против эталона (`cmp`), а не только сверкой длины.

**⚠ B0091 НА ЖЕЛЕЗЕ НЕ ПРОВЕРЕНО.** Смена ядра через PCAP не состоялась: `cmd 9` с путём
`0:/CORES/ATLAS.BIT.BIN` не выставил `done` за 90 с, `VERSION` остался `B01B0090`. Файл на карту
записан и сверен обратным чтением (1206176 Б), то есть дело не в записи. Карта возвращена в безопасное
состояние (`ATLAS.BIT.BIN` = B0090), B0091 лежит рядом отдельным файлом. Плата после этого здорова
(VERSION B0090, кадр живой). Разбираться в следующий заход: почему `pl_reload` не завершается на этом
файле - смотреть, доходит ли он до PCAP (счётчики DevC) или встаёт раньше, на чтении с карты или на
QUIESCE. Первая попытка того же теста провалилась по МОЕЙ ошибке (не записал путь в мейлбокс, получил
`err=0xB004` = `0xB000|FR_NO_FILE`) - это уже исправлено и не является причиной второго отказа.

| 2026-08-05 | ZX **B0091** | atlas_b0091.bit(.bin) | **Ethernet процессора НАСКВОЗЬ к ногам PHY.** На этой плате PHY (IP101GA) висит на выводах ПЛИС, а не на MIO, поэтому сеть GEM0 выходит через EMIO. В ПЛИС это ПРОВОДА: 15 выводов насквозь, 2 тактовых буфера на такты от PHY, 2 триггера делителя опорных 25 МГц на U18 и один двунаправленный MDIO. Правка в `control_plane.v` (Ethernet машино-агностичен = оболочка), ноги восстановлены по документации платы - в наших файлах их не было. Программную сторону менять не пришлось: `GEM0_RCLK_CTRL`/`CLK_CTRL` уже стояли на EMIO, а порт lwIP при источнике EMIO сам не трогает делители (`if (... == SLCR_GEM_SRCSEL_EMIO) return;`) - в MII такт передачи даёт PHY | **цена: +1 LUT** (15364 -> 15365, 87.30 %), +2 триггера, +2 BUFG (5 -> 7), BRAM 59/60 без изменений. **WNS +0.014 / WHS +0.019, все ограничения выполнены** (запас упал с +0.157: добавились тактовые домены Ethernet). Подмены модулей (8-9873) нет, портов без нагрузки нет. ⚠ Поймано расстановкой: **U15 (TX_CLK) - N-сторона дифференциальной тактовой пары**, одиночным тактовым входом Vivado её не даёт (`ERROR [Place 30-876]`); лечится `set_property CLOCK_DEDICATED_ROUTE FALSE` на цепи до буфера - нога задана платой, выбора нет. И вторая: правка `sources/*` без `assemble.sh` в сборку НЕ попадает (собирается из `build/`) - потерян один прогон |
| 2026-08-05 | ZX **B0090** (на карте, рабочее) | atlas_b0090.bit.bin | Кольцо BDI инструментировано под разбор ЗАПИСИ. (1) В `word1` вместо дорожки/сектора идёт внутреннее состояние контроллера `{data_length[10:0], DRQ, BUSY, lost_data, write_fault, 0}` - дорожка и сектор НЕ потеряны, их пишет сам процессор, и эти записи попадают в кольцо как события портов `#3F`/`#5F`. (2) Повторные записи в `#FF` больше не вытесняют историю: TR-DOS дёргает системный регистр в тесном цикле (наблюдалось девять записей подряд из `PC=0x02C0` с чередованием `0x3C`/`0x34`), и за микросекунды они сжигали все 12 слотов - именно это сорвало первый замер записи. Теперь не больше двух таких записей на команду. | **на железе:** VERSION B01B0090, дамп кольца работает. LUT **15364 (87.30 %)**, BRAM 59/60, **WNS +0.157 / WHS +0.012, 0 нарушенных путей**. Закреплено как `0:/CORES/ATLAS.BIT.BIN`. ⚠ Поймано ДО синтеза: (а) `assign` попал внутрь `always`-блока (некомпилируемо), и там же выяснилось, что `write_data`/`read_data`/`sd_busy` - ЛОКАЛЬНЫЕ переменные блока и снаружи не видны (та же причина, по которой `buff_wr` и `spt_addr` в этом файле вынесены из блоков); (б) `assign` стоял выше объявления `data_length` |
| 2026-08-05 | ARM **v0.15.230** | loader.elf | **Версия ядра на экране.** Владелец: «в навигаторе есть версия, но она с битстримом не связана». Так и было: `version_str()` показывал только прошивку с комментарием «core ID never changes build-to-build» - НЕВЕРНЫМ, потому что регистр VERSION меняется на КАЖДОЙ сборке RTL (за один день B0086 -> B0090). Теперь строка вида `v0.15.231 / b0090`, ядро читается из живого регистра при каждом выводе, а не кэшируется: оно меняется на ходу (PCAP, смена машины), и кэш врал бы ровно тогда, когда это важно | собрана BUILD_OK |
| 2026-08-05 | ARM **v0.15.231** | loader.elf + BOOT_ZX_B0090_V231.BIN | 🥇 **АРТЕФАКТЫ ПОСЛЕ ЗАКРЫТИЯ ОКОН - НАЙДЕН КОРЕНЬ И ЗАКРЫТ КЛАСС.** Жалоба владельца («глюки после подменю и модальных окон») разобрана статическим аудитом всех 18 мест сохранения фона: `box_backup` **МОЛЧА обрезает** область по `BOXSAVE_W/H`, без ошибки и предупреждения. Найдено, что подменю машин выросло до **21 строки** (нужно 22-25 клеток с рамкой и тенью) против предела **22**, то есть нижние строки фона не сохранялись вовсе - и это я же и создал, добавив в него за день пять пунктов. **Лечение класса, а не случая:** буфер фона теперь накрывает ВСЮ канву (`BOXSAVE_W=OSDC_W`, `BOXSAVE_H=OSDC_H`, 1 МБ на слот, три слота = 3 МБ в DDR, линкуется). «Окно не влезло в буфер» стало невозможно по построению - больше канвы окно быть не может. До этого предел поднимали ДВАЖДЫ (48 -> 64 колонки), и оба раза он выстреливал снова. **Вторая часть:** подменю из 21 строки не влезало и НА ЭКРАН (канва 25 строк, `top>=1`), последние пункты уходили за нижний край и были недосягаемы. Прокрутку в движке делать не стал (правка `menubox_size`/`menubox_render`/`MenuState`/логики курсора, проверить без глаз владельца нечем) - исправлена РАСКЛАДКА: `Disk drives` и `Disk write` переехали из подменю машины в `Files`, где уже живут `View/New disk image` и `Info about card`. Это правильнее по смыслу (свойства ОБРАЗОВ, не машины), и подменю стало 19 строк. `SAA1099` оставлен в машине - он и есть свойство машины | аудит после правки: все 11 меню влезают (машинные 19 строк -> 23 клетки, Files 17 -> 21). Собрана BUILD_OK, BOOT.BIN на карте сверен байт-в-байт. ⏳ ждёт холодного старта. **Инструмент аудита оставлен**: скрипт проходит по всем `box_backup` и всем таблицам меню - запускать после КАЖДОГО добавления пунктов |
| 2026-08-05 | ARM **v0.15.232** | loader.elf + BOOT_ZX_B0090_V232.BIN | 🥇 **КАРКАС МОДАЛЬНОГО ОКНА** - требование владельца «по принципу Turbo Vision сделать абстракцию прорисовки элементов навигатора». Виджеты в проекте были (`dn_win_draw/dn_box/dn_shadow/dn_button/dn_radio/dn_check/dn_bar`), а слоя ОКНА не было: центрирование, сохранение и возврат фона, подмена и ВОЗВРАТ строки подсказок, ряд кнопок и обход фокуса были переписаны в 18 местах - отсюда расхождение инвариантов и полное отсутствие проверки вместимости фона (артефакты v229 и v231). Введены `Dlg` + `dlg_open` / `dlg_close` / `dlg_buttons` / `dlg_nav`: центрирование, проверка «окно не больше канвы» со счётчиком `g_dlg_clip` (уменьшает окно, а не портит экран молча), свой слот `BoxSave`, рамка с заголовком, единая геометрия кнопок, Tab/Shift+Tab. На каркас переведены три новых окна: информация о карте, просмотр образа, выбор привода (у последнего кнопки условные - оставлены свои, на каркас ушли геометрия/фон/подсказки). Декларативная форма (таблица элементов, как TDialog с потомками) СОЗНАТЕЛЬНО отложена: сначала все окна должны сесть на каркас, иначе переписывать пришлось бы дважды. Старые проверенные окна (`machine_select`, `romset_select`, `mp3_sens`, `dn_confirm`, `copy_move`) переводятся отдельными шагами по одному - ломать разом восемь работающих окон без глаз владельца плохая сделка | собрана BUILD_OK, BOOT.BIN на карте сверен байт-в-байт. ⏳ ждёт холодного старта. Поймано при сборке: каркас был вставлен ПОСЛЕ окна, которое его использует - перенесён за `box_backup`/`box_restore` и до всех диалогов |
| 2026-08-08 | ZX **B0114** + ARM **v0.15.288/289** | B0114.bit + BOOT_B0114_v289.BIN | **NEMO-IDE: чтение секторов стало байт-в-байт.** Два дефекта: (1) слово ctl_nemo и его тоггл менялись одним фронтом - домен машины ловил смесь битов двух записей (адрес от одной, данные от другой); лечение: тоггл на два такта позже данных + разнесение записей в прошивке; (2) 🥇 указатель чтения буфера двигался по НАЧАЛУ обращения, а Z80 берёт байт в конце цикла - младший байт каждого слова приезжал из следующего слова (та же болезнь, что у джойпада NES: работать по спаду). Доказано своим кодом на Z80: было 502/512, стало **512/512**. zxfdisk видит раздел FAT16, 63 Мб из 64 | **WNS +0.096, 0 нарушенных путей** (при Explore -0.411, закрылось на place_design ExtraTimingOpt). ⚠ стратегию править только в sources/build.tcl - assemble.sh перетирает копию в build/ |
| 2026-08-08 | ZX **B0115** (на карте, рабочее) | atlas_b0115.bit.bin | **ARM ПОЛУЧИЛ ПРАВО ПИСАТЬ РЕГИСТРЫ ATA + аппаратный BSY.** (1) Драйверы NEMO после `0x90 EXECUTE DEVICE DIAGNOSTIC` читают СИГНАТУРУ (`#50=01, #70=01, #90=00, #B0=00`), а регистры вёл только хост - у нас там были нули, и диск считался отсутствующим. Свободных БИТ в `nemo_ctl` не осталось, занято свободное СОСТОЯНИЕ: при `buf_we=0` поля адреса и данных не значат ничего, поэтому `buf_waddr[8:3]=101010` + номер регистра в `[2:0]`. 🥇 **Одного бита различия было бы мало:** маркер 101010 = адрес 336, то есть байты 336..343 обычного сектора дают ту же комбинацию, а смаз битов соседних слов у нас ИЗМЕРЕН (B0114). Добавлен `buf_arm_owns` (заливка при 0, запись регистра при 1) - состояния расходятся ДВУМЯ битами. (2) По ATA BSY обязан подняться в том же цикле, где хост записал `#F0`; у нас его ставил ARM на следующем обходе цикла, и драйвер успевал прочитать статус ПРОШЛОЙ команды. Теперь `cmd_busy` взводится стробом команды в домене машины, снимается любым словом от ARM или `#C8` бит2, **сторож 2^23 такта ≈ 148 мс** - мёртвый ARM обязан деградировать до старого поведения, а не морозить Z80 навсегда. (3) `nemo_stat2` младший байт = счётчик секторов `#50` (был дубль LBA0). (4) `LOAD_CAPS` **бит5** = ядро умеет запись регистров ATA; кэш возможностей сбрасывать при смене ядра | **на железе:** VERSION B01B0115, Proteus/FATALL/zxfdisk видят диск и каталог. **WNS +0.068 / WHS +0.049, 0 нарушенных концов из 49658**, подмены модулей (8-9873) нет. LUT **15923 (90.47 %)**, FF 14565, **BRAM 60/60 (100 %)**, DSP 13. ⚠ Тайминг закрылся только МАРШРУТИЗАТОРОМ: промах был 24 пс на ОДНОМ пути пиксельного домена (`osd_i/pos_q -> od_r`, 9.5 нс трассировки из 13.1), прогон Б `route_design -directive NoTimingRelaxation` - met; прогон А (`AggressiveExplore` + лишний `phys_opt`) сделал ХУЖЕ (−0.080, два пути). Стратегию править ТОЛЬКО в `sources/build.tcl` - `assemble.sh` перетирает копию в `build/`. Свободных BRAM больше НЕТ |
| 2026-08-08 | ARM **v0.15.291…293** | BOOT_B0115_v291.BIN, v293 | Прошивочная сторона B0115: `nemo_reg_write` (запись регистра ATA через свободное состояние слова, с обратным чтением и гейтом по `LOADCAP_IDEREG`), сигнатура после `0x90` и приём `0x91 INIT PARAMS`. **v292:** ini вырос за 4 КБ (пять машин × 25 числовых ключей + romset + две карты кнопок) - буфер поднят; NEMO-IDE стал ОБЫЧНОЙ машинной опцией и применяется живьём, как SAA1099 и ROM SET; окно информации о винчестере (какой образ и его размер); сторож высоты меню. **v293:** новый образ проверяется, ПОКА СТАРЫЙ ЕЩЁ РАБОТАЕТ (отдельный дескриптор: сначала убеждаемся, что файл годится, и только потом снимаем работающий); винчестер обслуживается и под модальным окном - команда ATA идёт с поднятым BSY, и оставить её висеть на время диалога значит подвесить машину; размер образа печатается как 32 бита БЕЗ знака (было `int` и семь цифр) | собраны BUILD_OK, образы в `flash/` и `artifacts/ZX_CPLANE/` |
| 2026-08-08 | ARM **v0.15.294** | BOOT_B0115_v294.BIN | **ТРАССА ОБРАЩЕНИЙ К ДИСКУ** (`IDE_TRC` = KMB+0x3200, **256 событий по 8 слов**, счётчик KMB+0x74, формат KMB+0x78). Причина: Proteus печатает «Error 00» и НОВЫХ обращений при этом не делает, то есть решение принимает по УЖЕ полученным ответам - хвоста в одно слово «последняя команда» не хватает, нужна вся последовательность. Поля: монотонный номер; `{команда, счётчик #50, head #D0, флаги}` (slave / образ 8-битный / ядро умеет регистры ATA / образ открыт / многосекторное); полный LBA; НАШ ОТВЕТ `{статус, err, отдано байт}`; метка времени в мс; `rptr` фабрики на момент строба (недобор = софт бросил чтение на середине сектора); сырые `nemo_stat`/`nemo_stat2` - страховка от моей же ошибки в разборе полей | собрана BUILD_OK. Первый же снимок (8 событий) показал, что последнее обращение Proteus - EXEC-DIAGNOSTIC к slave, и дальше он молчит |
| 2026-08-08 | ARM **v0.15.295** | BOOT_B0115_v295.BIN | 🥇 **СТАТУС ОДИН, А УСТРОЙСТВ ДВА - И ЭТО ЛОМАЛО ЧУЖОЙ СОФТ.** Регистр состояния в фабрике ОДИН на весь интерфейс, а на probe slave прошивка отвечает нулём («устройства нет») - и ноль оставался в регистре НАВСЕГДА: следующее чтение статуса УЖЕ ДЛЯ MASTER отдавало 0x00, то есть DRDY снят. Измерено на Proteus (читает MBR, строит `E:hd2,0 (0:FAT32)`, щупает slave, печатает «Error 00»); восстановление статуса master прямо по JTAG (`NEMO_CTL = 0x1410`) НЕМЕДЛЕННО дало каталог диска. Лечится в прошивке: она видит выбранное устройство (бит4 регистра `#D0` в старшем байте `NEMO_STAT2`) и держит в регистре статус ИМЕННО ЕГО (`g_ide_mstat`) | **на железе: Proteus File Manager листает каталог образа.** Правило на будущее: ответ «устройства нет» - это ещё и СОСТОЯНИЕ, остающееся после команды; вернул ли ты состояние существующего устройства - проверять отдельно |
| 2026-08-08 | ARM **v0.15.296** | BOOT_B0115_v296.BIN | Разбор «Proteus не показывает чужой образ Олега `0:/HDD16.HDF`, а FATALL тот же образ читает». Поставлен ОПЫТ (в релиз не идёт, включается `gs_ctl = 8`): подменять тип раздела `0x04/0x06` (FAT16 CHS) на `0x0E` (FAT16 LBA) в MBR, который мы отдаём машине - он отличает «Proteus не умеет FAT16» от «Proteus не берёт разделы без признака LBA». Своей пометки версия в коде не оставила, поэтому дальше её содержимое читать по образу и по флагу `g_ide_pthack` | собрана BUILD_OK. Опыт оставлен выключенным по умолчанию |
| 2026-08-08 | ARM **v0.15.297** | BOOT_B0115_v297.BIN | **ПОФАЗНЫЙ СЕКУНДОМЕР ГЛАВНОГО ЦИКЛА** (`PH_M_*` = KMB+0x5400, 12 фаз: дисковод, чтение SD, f_sync, Ethernet, GS, IDE, файловая служба, плеер, лента, навигатор, клавиатура, прочее). Причина: карта General Sound тактируется тем, что успевает посчитать ARM (очередь сэмплов 4096 = 85 мс при 47996 Гц), и пока цикл занят другим, эмулятор СТОИТ - в Z-Player это «9 МГц вместо 12», на слух замирание. `g_loop_max_us` говорит только ЧТО проход был долгим, а нужно КАКАЯ фаза его съела. Меряем **тактами CCNT (одна инструкция `mrc`)**, а не `XTime_GetTime`: глобальный таймер лежит в области устройств, отметок больше десятка на проход - секундомер искажал бы то, что меряет. Делений в горячем пути нет вовсе; накопители кэшируемые, в мейлбокс таблица переливается раз в 512 проходов, кольцо провалов (64 записи) пишется сразу. Там же счётчики тишины: `g_gs_under` (сэмплов) и `g_gs_ungap` (эпизодов) - по эпизодам виден период, по сэмплам длительность | собрана BUILD_OK. Временный прибор, не фича |
| 2026-08-08 | ARM **v0.15.298** | loader.elf | 🥇 **ЧЕСТНЫЙ ПРИБОР ТЕМПА КАРТЫ + ГОРЯЧИЙ ПУТЬ БЕЗ ЛИШНЕЙ РАБОТЫ** (`gs_m_*` = KMB+0x5A00; в оболочке `Options > Machine > GS speed`). **Часы для карты - это ЦАП:** фабрика вычерпывает очередь ровно 47996 раз в секунду в прерывании, поэтому время меряется ВЫЧЕРПАННЫМИ СЛОТАМИ, а не таймером; 47996 сэмплов/с = 12 МГц ровно, значит доля номинала и есть доля 12 МГц. Окно 1 с делится на восемь долей: наружу и средний темп, и ХУДШАЯ доля (провалы иначе усредняются в ничто). **Разница слотов и сэмплов стала ДОЛГОМ:** раньше пустая очередь означала, что виртуальное время карты не идёт вообще и назад не возвращается - карта отставала навсегда; догон ограничен +25 % к темпу за сэмпл и 0.25 с долга всего, иначе после паузы музыка выстреливала бы скороговоркой. Плюс горячий путь: **страница адресуется таблицей, а не арифметикой** (`gs_map` зовётся ~3 млн раз в секунду; теперь объём памяти карты в её темпе не участвует ВООБЩЕ), **деления убраны** (у Cortex-A9 нет делителя - период прерывания 12000000/37480 = 320 тактов и остаток 6400/37480, счётчик по Брезенхэму), **позиция ближайшей команды запоминается, а не ищется** (обход всей очереди шёл на каждом вызове, 120 тыс/с, и вхолостую - как раз когда карта чистит свою память), карта качается и в опросном запасном пути (`gsb_on`), а прогон инициализации прекращается ПО ДЕЛУ (счётчик чтений порта флагов), а не по часам | собрана BUILD_OK |
| 2026-08-08 | ARM **v0.15.299** | loader.elf | 🥇 **ОПРОС СОСТОЯНИЯ ОПЛАЧИВАЛСЯ ВРЕМЕНЕМ КАРТЫ + ПРЕРЫВАНИЕ ЭТО УРОВЕНЬ + «4 МБ» БЫЛО ЛОЖЬЮ.** (1) Наблюдение владельца: «когда закрыто окно трекера - музыка идёт БЕЗ СБОЕВ». Окно опрашивает карту десятки раз в секунду (`#60..#64`), и каждый запрос шёл через машинерию ПОТОКА: при одном невзятом байте впереди он ждал 2000 тактов (166 мкс) и ещё СХЛОПЫВАЛ данные. Запросы (`#20..#2F`, `#60..#6F`) пущены мимо очереди и без стойла - в железе регистров ДВА, запрос данных не трогает, порядок потока не переставляется. 🥇 Ячейку запроса надо ВЕРНУТЬ очереди, а не пометить «съедено»: пометки освобождает только голова, а она стоит за невзятым байтом - на стенде это дало **7501 запись за 5 с**, то есть за полминуты очередь на 32 тысячи переполнилась бы. (2) 🥇 `Z80Interrupt` при `DI` молча возвращает ноль, и прежний код прерывание ТЕРЯЛ; у настоящей GS INT висит на ноге. Цена прямая: сэмплы карта отдаёт ИМЕННО в обработчике (37480 Гц), значит каждое потерянное = дырка в звуке, и теряются они тем чаще, чем дольше карта в критических секциях - то есть ровно под опросом. Держим и повторяем; 13 тактов на приём теперь считаются (без них карта шла на **4 %** быстрее: 37480 × 13 = 487 тыс. тактов из 12 млн). Приборы: `gs_d_int` = ПРИНЯТЫЕ прерывания (прежнее число росло всегда и доказывало ничего), `gs_d_intheld` = сколько шагов держали. (3) Номер страницы карта задаёт ОДНИМ портом `#00`, и он **6-битный** (апстрим `gs.v`: `reg [5:0] port_00`, адрес 21 бит) - страниц 0..63, минус ПЗУ = **2016 КБ**. Хостовой стенд (карта МЕРИТ память сама, ячейка NUMPG 0x4080): объявили 128 КБ → 3, 512 КБ → 15, 1 МБ → 31, 2 МБ → 62, **4 МБ → ТОЖЕ 62**. Пункт меню `4M` заменён на `2M`, массив ужат (вернулись 2 МБ DDR). (4) Разбор очереди идёт кусками по 512 (сплошной обход 32 тыс ≈ 30 мкс против периода ЦАП 20.8 мкс) и страховочный запас звука: ниже него оболочка не занимается ничем, кроме сэмплов | собрана BUILD_OK |
| 2026-08-08 | ARM **v0.15.300** | loader.elf | 🥇 **МНОГОСЕКТОРНОЕ ЧТЕНИЕ NEMO-IDE + винчестер включён по умолчанию.** (1) Жалоба владельца «Z-Player не может проиграть ничего с образа HDD» при живых навигаторах. Причина в коде: на 0x20/0x21 отдавался РОВНО ОДИН сектор, а регистр #50 (счётчик секторов) игнорировался - навигатор читает каталог по сектору и не замечал, а плеер грузит модуль пачками и после первого сектора вычерпывал ТОТ ЖЕ буфер по кругу (указатель чтения 9-битный). Теперь буфер ПЕРЕЗАРЯЖАЕТСЯ на каждый сектор; момент «блок вычерпан» берётся из указателя чтения фабрики (`nemo_stat` биты 29..21), а не по таймеру. Гоча прибора: запись команды в #F0 ОБНУЛЯЕТ указатель, поэтому ноль засчитывается только после увиденного ненулевого и подтверждается перечитыванием (у `nemo_stat` нет синхронизаторов). Счётчик 0 = 256 секторов, как в ATA. DRQ снимается ПОСЛЕ последнего блока и после IDENTIFY - раньше висел до следующей команды. Пока служба ждёт машину, она качает звук (gs_pump/player_pump) и выходит сразу, как машина взялась за блок; сторож 2 с на брошенную передачу плюс потолок оборотов на случай, когда CCNT ещё не запущен. (2) `opt_ide` и профили машин 0..2 (ядро Atlas) по умолчанию ON, путь из ini (ключ `<тег>.idefile`, пусто = `0:/HDD.HDF`). Нет файла - служба МОЛЧИТ и настройку не гасит: раньше первый же промах выключал интерфейс, а «Save config» закреплял это в ini. Повтор открытия раз в 3 с | **на железе (карта: B0115 + v0.15.300).** Z-Player грузит модуль с образа. **Стресс опросом состояния своим кодом на Z80, 60 с / 121 проба:** темп средний **12.00 МГц**, худшая доля окна и за всё время **12.0**, **замираний 0**, опросов **318/с** (ARM видел 19085 команд, машина насчитала 19084 - не потеряно ничего), `drop`=0, `ovr`=0, слоты ЦАП 48003..48494 при номинале 47996, защёлкиваний 177664/с, пик 22..62. 318/с - ПОТОЛОК корректного рукопожатия (его задаёт наш круг через ARM, ~3 мс на опрос), а окну трекера нужно ~250/с. Запас снят слепой стрельбой в `#BB` без ожиданий: до ARM дошло 1193 / 6104 / 12181 / 23884 / **32206** команд/с (машина выдавала до 48495/с) - на всех частотах темп 12.00, худшая доля 12.0, замираний 0, музыка играет. С ~1200/с излишек выбрасывает очередь (`drop` 16 тыс → 927 тыс, липкий `ovr`), то есть за перегруз платит ПРОТОКОЛ, а не звук. **Приёмка пройдена, запас ≥100× от нагрузки окна трекера.** ⚠ Прибор `gs_m_poll` (KMB+0x5A18) при этом показывал 0: он считает только запросы, ОБОГНАВШИЕ повисшие данные - число опросов брать из `gs_d_acc` (KMB+0xA4) |
| 2026-08-08 | ARM **v0.15.302** | loader.elf | 🥇 **ЯВНЫЕ СЛОТЫ ПЗУ (Options > ROM) + ВЫБОР СТРАНИЦЫ СТАРТА.** Две жалобы владельца: «одиночное ПЗУ на 16 КБ (FATAL) вообще не грузится» и «надо более простое, очевидное переключение банков». Причина первой в коде: единицей выбора был НАБОР целиком, одиночный файл уезжал в слот ПО ПОДПИСИ, а у FATAL нет ни одной из наших подписей - он попадал в слот 3 (сервисный), а сервисная страница без настоящей магической кнопки недостижима. Сделано: (1) четыре пункта-слота, в каждый назначается ЛЮБОЙ файл 16 КБ из `0:/ROMS/` (список - обходом каталога, показываются только ОДНОстраничные файлы; пункт «(FROM SET)» снимает назначение), ini-ключи `<тег>.rom0..rom3` (строки); (2) «Boot machine from» = AUTO / SLOT 0..3, ini `<тег>.rombus` (0 AUTO, 1..4 = слот 0..3). **Номер стартовой страницы зашит в ЯДРЕ** (`atlas_core/memory.v`: `romPage = trdos?2 : service_en?3 : (model ? {1'b0,7FFD[4]} : 2'b01)`, а 7FFD после сброса = 0 → 128/Пентагон стартуют со страницы 0, 48К - со страницы 1), поэтому выбор сделан ПЕРЕКЛАДКОЙ СОДЕРЖИМОГО: копия выбранного слота дополнительно кладётся в стартовую страницу, сам слот остаётся на месте (иначе сломались бы трап TR-DOS = страница 2 и сервисная = 3, их номера тоже зашиты); (3) «Whole ROM set» сохранён и после него слоты показывают, ЧТО РЕАЛЬНО ЛЕГЛО (`g_pg_file`, заполняется только после сверки), а не намерение; (4) заливка набора и слотов идёт ОДНИМ окном `loading=1` (каждое окно = отдельный сброс машины), проверка по ФАКТУ `ROM_LDCNT`, отказ называет НОМЕР слота. Старые ключи `romset`/`svcrom` работают как раньше. Меню: ПЗУ вынесено в собственную группу `Options > ROM` (7 строк) - третьего уровня движок не держит (menu_open_sub работает с st[0]/st[1]), подменю машины стало 10 строк | собрана BUILD_OK. Сторож: g_menu_toohigh = 0, g_menu_trunc = 0, индексы opt_items целы (62..66 дописаны в MENU_IX_EXPECT). На железе НЕ проверялась - плата занята другим прогоном |
| 2026-08-08 | ARM **v0.15.304** + ядро **B0116** | loader.elf | 🖱 **МЫШЬ KEMPSTON, УПРАВЛЯЕМАЯ ЦИФРОВОЙ КЛАВИАТУРОЙ.** Причина: браузер Z-Player 4.1 (и весь мышиный софт) без мыши не запускается, а физической мыши у нас нет. (1) RTL `sources/kempston_mouse.v`: порты #FADF (кнопки, активный ноль), #FBDF (X), #FFDF (Y) - различаются СТАРШИМИ битами A10/A9/A8 при общем младшем байте #DF. Карта сверена по ЖИВОМУ апстриму MiSTer (`rtl/mouse.v` + верхний уровень: `.addr(addr[10:8])` при `addr[5:0]==6'h1F`), а не по вендоренной копии. **Отличие от апстрима сделано сознательно:** MiSTer декодирует только `a[5:0]==6'h1F` и на время работы мыши ГЛУШИТ джойстик целиком; у нас `IN A,(#1F)` кладёт на A15..A8 содержимое A, то есть старшие биты при чтении джойстика случайны - поэтому декодируем полный младший байт #DF, и мышь с джойстиком живут одновременно. В мультиплексоре шины блок стоит СТРОГО раньше kempston (тот ловит одно условие a[5]=0) - та же мина, что у NEMO-IDE. Выход `sup` не нужен: у #DF бит A0=1 (это не окно ULA #FE) и портов Beta Disk он не задевает. Стартовые X=128, Y=0: несовпадение координат и есть признак живой мыши для драйверов. Слово от ARM (0x190) `{en[31], кнопки[18:16], Y[15:8], X[7:0]}` идёт через тоггл с флагом НА ДВА ТАКТА ПОЗЖЕ данных - правило CDC проекта. LOAD_CAPS **бит6** = ядро умеет мышь; кэш возможностей сбрасывается при смене ядра. (2) Прошивка: 8 направлений на цифровом блоке (8/2/4/6 плюс диагонали 7/9/1/3), левая кнопка KP0 и KP5, правая KP-Enter и KP-точка; координаты 8-битные со сворачиванием. **Ускорение двухфазное, как тайпматик:** короткое нажатие = РОВНО один шаг (не зависит от темпа главного цикла), удержание дольше 220 мс = повтор каждые 8 мс с шагом, растущим от 1 до 8 за 800 мс (потолок около 1000 точек/с - столько же даёт настоящая мышь). Опция машины `Kempston mouse` = OFF / ON / KEYPAD (`opt_items[67]`, ini-ключ `<тег>.kmouse`), строка добавлена в подменю zx128/pent1024/zx48. **У цифрового блока остался ОДИН владелец:** мышь старше джойстика (её раскладка жёсткая, а карта джойстика переназначаема), блок забирается только пока фокус в машине, и JOY_STATE бит31 поднимается теперь и от мыши - иначе клавиши двигали бы курсор И одновременно сыпались в матрицу Z80. KP+/KP-/KP* (громкость, мьют) не тронуты | BUILD_OK. Тайминг ЗАКРЫТ: setup WNS **+0.189 нс**, 0 нарушенных из 49836; hold WHS +0.012 нс, 0 нарушенных (стратегия без изменений: place ExtraTimingOpt + route NoTimingRelaxation). LUT 15964/17600 = **90.7 %**, регистры 14641 (41.6 %), BRAM **60/60 = 100 %**, DSP 13. 0 CRITICAL WARNING, подмены модулей (8-9873) нет, порты `kempston_mouse` все с нагрузкой. Бит `artifacts/ZX_CPLANE/B0116.bit`, образ `flash/BOOT_B0116_v302.BIN` (1817940 Б). На железе не проверялось: плата занята другим прогоном |
| 2026-08-08 | ARM **v0.15.306** + ядро **B0116** | loader.elf | 🔀 **СВЕДЕНИЕ ПАРАЛЛЕЛЬНЫХ ПРАВОК (мышь Kempston + правки по совету).** Два агента правили `arm/loader_main.c` одновременно: один добавил мышь Kempston (v304), другой - фильтр списка ПЗУ по содержимому (`rom_file_probe`), отложенное применение разрушительных пунктов по Enter (`defer` + `menu_pend_revert`/`menuitem_pending`), честные тексты и путь `0:/GS/` (v305). Сверка построчная (git HEAD = v301, бэкапы v302 и v303): все добавления v302 (четыре слота ПЗУ, `rombus`) и v303 (рецензия слотов - возврат стартовой страницы при уходе в AUTO через `g_boot_alien`, снятие мёртвого назначения, охрана порта заливки по `LOADCAP_ROM`, построчный писатель конфига) присутствуют в текущем файле, ни одна не потеряна. Шесть строк v302 отсутствуют дословно, но каждая заменена более поздней версией той же логики (`CH_ROMBUS` с живой строкой AUTO вместо константы, список слотов с метками типа ПЗУ, `defer=1` у ROM BOOT SLOT) - это не потеря, а развитие. Потеря нашлась ровно одна: пункт `[67] KEMPSTON MOUSE` был вписан в таблицу пунктов и в три подменю машин, но строки в `MENU_IX_EXPECT` не получил - сторож дрейфа индексов молчал бы при сдвиге последнего пункта. Дописана. Спорных мест при сведении не осталось | BUILD_OK. Образ `flash/BOOT_B0116_v306.BIN` (1817940 Б), бит `artifacts/ZX_CPLANE/B0116.bit` (тот же B0116, WNS +0.189 нс). На железе не проверялось |
| 2026-08-09 | ARM **v0.15.307** + ядро **B0117** | loader.elf + bit | 🥇 **DRQ СНИМАЕТ ФАБРИКА ПО ФАКТУ ВЫЧЕРПЫВАНИЯ БЛОКА, А НЕ ARM СЛОВОМ СОСТОЯНИЯ.** Измеренный дефект (свой код на Z80, два прогона): при многосекторном чтении машина забирала 512 байт и видела DRQ ВСЁ ЕЩЁ поднятым - снять его мог только ARM, а он узнаёт об окончании блока лишь на следующем обходе службы. В эту щель машина успевала прочитать НАЧАЛО СТАРОГО буфера (указатель 9-битный, за 512 байт приходит в ноль): прогон 1 - 105 битых байт (сектора 1, 17, 22, 36), прогон 2 - 87 байт (сектор 23), позиции плавают = гонка. Обход «сперва BSY, потом DRQ» давал 0 расхождений, но так читает только наш код - штатный драйвер по ATA ждёт именно DRQ. (1) `nemo_ide.v`: три состояния - `drq_hw` (в буфере лежит блок), `gap_busy` (блок вычерпан, передача не окончена: машина видит BSY, пока ARM не подложит следующий), пусто (передача окончена). DRQ снимается в ТОТ ЖЕ такт, что и последнее чтение (`blk_done = спад чтения данных & rptr==510`), щели не остаётся физически. Указатель при снятом DRQ НЕ ДВИГАЕТСЯ - иначе чужие чтения после конца блока выглядели бы для службы ARM как «машина взялась за новый блок». Заодно закрыта дыра поменьше: DRQ теперь поднимает только «чистое» слово состояния (`arm_plain`), а слова ЗАЛИВКИ несут статус 0x58 с уже поднятым DRQ - до B0117 машина имела право забрать полупустой буфер прямо посреди наполнения. (2) **Про последний блок фабрика узнаёт от ARM, а не из счётчика #50** - метка в бите 1 слова состояния (IDX, устаревший с ATA-4, машине не показывается). Счётчик не годится принципиально: его пишет хост и по ATA положено декрементировать, то есть фабрике пришлось бы вести теневой счётчик и повторять разбор команды, а у IDENTIFY регистр #50 к делу не относится вовсе - там мусор от прошлой команды, и фабрика повесила бы BSY на ровном месте. (3) Сторож 2^23 такта (148 мс) распространён и на окно между блоками и ВЗВОДИТСЯ ЗАНОВО на каждое окно: раньше счётчик обнуляла только запись команды, и второе окно начиналось бы с брошенного значения. (4) Наружу (`nemo_stat` биты 20/19) отданы DRQ и «жду блок»: прошивка узнаёт о конце блока ФАКТОМ, а не гаданием по указателю (ноль указателя означает и «вычерпано», и «только что записана команда»). (5) Прошивка: метка последнего блока (`ide_drq_st`), `ide_push_sector(lba, last)`, детект конца блока по флагам фабрики при `LOADCAP_IDEDRQ` (старый путь по указателю сохранён для ядер без бита), из запомненного статуса master вырезаны DRQ и метка - переиздать их значило бы своими руками отдать старый блок. LOAD_CAPS **бит7** | BUILD_OK. Тайминг ЗАКРЫТ: setup WNS **+0.125 нс**, hold WHS +0.035 нс, 0 нарушенных из 49839. LUT 15979/17600 = **90.8 %** (+15), регистры 14644 (+3: ровно `drq_hw`/`gap_busy`/`last_blk`), BRAM 60/60, DSP 13. 0 CRITICAL WARNING, подмены модулей (8-9873) нет. **Стенд `sources/tb_nemo_ide.sv` (xsim): 20 проверок, пройдены все; на СТАРОМ ядре тот же стенд валит 8, включая 512 расхождений во втором блоке** - то есть стенд ловит именно тот дефект, ради которого написан. Бит `artifacts/ZX_CPLANE/B0117.bit`, образ `flash/BOOT_B0117_v307.BIN` (1784020 Б). На железе НЕ проверялось |
| 2026-08-09 | ARM **v0.15.310** + ядро **B0119** | loader.elf + bit | 🥇 **БИТ7 ПОРТА #BB ЗНАЧИТ РОВНО «У КАРТЫ ЕСТЬ БАЙТ», А ОБРАТНОЕ ДАВЛЕНИЕ УШЛО В ТАКТЫ ОЖИДАНИЯ.** Концептуальный дефект B0118, найденный приёмкой: `gs_b7_m` собирался как ИЛИ из «очередь почти полна» и «у карты есть байт» - ДВА СМЫСЛА НА ОДНОМ БИТЕ. У настоящей карты этот бит - флаг одного двунаправленного регистра данных, и плеер ждёт его циклом `IN A,(#BB) / RLCA / JR NC`: наше «занято» он читал как «пришёл ОТВЕТ», забирал из #B3 протухший байт и лил дальше. То есть переполнение, от которого мы защищались, мы же и провоцировали (7 эпизодов потери данных при 88 паузах оболочки длиннее 1 мс). (1) **`gs_b7_m = gs_outp`** - только «у карты есть байт», больше ничего. (2) **Новый модуль `sources/gs_flow.v`: медленная периферия ДЕРЖИТ процессор, а не врёт ему флагами.** Байт в очередь принимаем всегда, а цикл записи в #B3 растягиваем, гася `pc3M5`/`nc3M5` (обе фазы, штатное место тактов ожидания рядом с `mem_wait`; в `cpu_ten` вставлять нельзя - это экспорт наружу). Требование удержания РЕГИСТРИРУЕТСЯ: комбинационный путь «дешифратор порта + порог очереди» в разрешение такта с его разветвлением - худший путь для тайминга, а цикл записи Z80 длится ~40 тактов 56.7 МГц, так что один такт задержки бесплатен. (3) **Сторож 2^19 тактов ПРОЦЕССОРА (~150 мс) взводится заново на каждый вынутый оболочкой байт** (`drain_w` из очереди, третья ступень синхронизатора указателя чтения): смысл - «оболочка умерла», а не «ждём слишком долго», иначе законная пауза наполнения звукового кольца (134 мс) снимала бы давление посреди работы. Сработал - давление снимается СОВСЕМ до первого признака жизни: 148 мс на байт хуже, чем деградация до старого поведения с потерей, а потеря теперь считается поштучно. (4) **ПРИБОР (0x194/0x198): потерянные БАЙТЫ, а не эпизоды** (в приёмке B0118 «7 эпизодов» не давали понять, семь это байт или семьсот), плюс число удержаний и их цена в тактах процессора - чтобы видеть, не платим ли мы корректностью за скорость машины. Прошивка читает эти слова ДВАЖДЫ и принимает только совпавшее (AXI отдаёт их из домена 56.7 МГц без синхронизатора), раз в 512 проходов службы, и говорит `GS: BYTES LOST xN  SHELL STALLED xM`. (5) **Очередь 128 -> 64, резерв 32 -> 8:** резерв держался под записи, которые гость делает БЕЗ опроса флага, а теперь таких нет вовсе - шина держит машину прямо в цикле записи. Глубина осталась только плавностью. **Стенд `sources/tb_gs_backpressure.sv` (xsim):** гость ЛЬЁТ БЕЗ ЕДИНОЙ ПРОВЕРКИ ФЛАГА (темп 4.7 мкс), оболочка вычерпывает рывками с паузами 1.25 и 2 мс. Фаза 1: **1500 из 1500 байт байт-в-байт, 0 потерь**, 26 удержаний, 118613 тактов процессора в ожидании, самое долгое удержание 169113 тактов, пик очереди ровно 56 = верхний порог. Фаза 2 (оболочка мертва): сторож сработал, машина ЖИВА, 336 байт потеряно и ПОСЧИТАНО - это и есть негативный контроль. Фаза 3: давление вернулось само после первого же вынутого байта. Стенд же поймал мой промах в его собственной настройке: сторож короче паузы оболочки снимает давление на каждом такте ожидания, и очередь переполняется ровно как без него. | BUILD_OK со второй попытки. **Первая НЕ РАЗМЕСТИЛАСЬ:** 16117 LUT (91.57 %) - не хватило 16 слайсов из 4400 («unplaced instances require 2852 slices»); широкие насыщающиеся счётчики (16/16/24 бита) урезаны до 12/12/20 без насыщения, сторож переведён на такты процессора (19 бит вместо 23), очередь ополовинена. Тайминг ЗАКРЫТ: setup WNS **+0.026 нс**, hold WHS **+0.009 нс**, **0 нарушенных из 50074** (у B0118 было +0.189 / +0.022 / 0 из 49968). Критический путь прежний и НЕ наш - пиксельный домен `shell/osd_i/pos_q -> od_g`, 74 % задержки трассировка. LUT **16032/17600 = 91.09 %** (+7 к B0118), регистры 14730 (-31), BRAM 60/60, DSP 13. Единственное CRITICAL WARNING - промежуточное [Route 35-39], снятое финальным `phys_opt_design`. Подмены модулей (8-9873) нет. Бит `artifacts/ZX_CPLANE/B0119.bit`, образ `flash/BOOT_B0119_v310.BIN` (1781268 Б). **На железе НЕ проверялось** |
| 2026-08-09 | ARM **v0.15.308** + ядро **B0118** | loader.elf + bit | 🥇 **ОБРАТНОЕ ДАВЛЕНИЕ НА ПОТОКЕ #B3 GENERAL SOUND: БАЙТ БОЛЬШЕ НЕ ТЕРЯЕТСЯ.** Дефект: Z-Player 4.1 льёт драйвер потоком OUTI, флаг проверяет ПОСЛЕ записи, а на перевороте счётчика делает ДВЕ записи подряд без проверки вовсе. Наша очередь на 32 байта = 150 мкс, а пофазный секундомер меряет паузы оболочки до 134 мс (фаза gs_service) и 1.25 мс (чтение сектора): любая длиннее 150 мкс = молчаливая потеря (срыв на 816-м байте из 4260, липкий gs_ovr7, вечное зависание машины в 0x843C). Глубиной это не закрыть в принципе - 134 мс это 28 тыс. байт. (1) **`sources/gs_wq_fifo.v` (новый модуль, своё имя: общий `async_fifo` шага 08 править нельзя):** очередь с ЗАНЯТОСТЬЮ В ДОМЕНЕ ЗАПИСИ и гистерезисным признаком «занято». `gs_b7_m` теперь = верхний порог, а не полнота: 96 из 128, резерв **32 места** под записи, которые гость делает слепо (у Z-Player их 2 - запас 16x, покрывает и развёрнутые блоки OUTI); снятие на 32, то есть после паузы гость получает пачку в 64 байта. Указатель чтения приходит через синхронизаторы, значит занятость ЗАВЫШЕНА - для обратного давления это правильный знак ошибки. (2) **Глубина 32 -> 128, а не 256:** вариант 256 собрался (91.28 % LUT) и **провалил тайминг пиксельного домена, WNS -0.081 нс** на буферах OSD - ровно как B0108. Корректность теперь держит не глубина, а порог, поэтому глубина осталась только плавностью, и ею можно торговаться. (3) **Длинные фазы:** 134 мс фазы gs_service - это наполнение пустого кольца ЦАП (4096 сэмплов = 85 мс звука); насос флагов внутри него шёл раз в 16 сэмплов, то есть раз в ~0.5 мс, и байты терялись ВНУТРИ расчёта звука, а не в файловых операциях. Шаг стал 2 сэмпла (~65 мкс), плюс `gs_wq_kick()` сразу после чтения сектора образа. Звать здесь `gs_pump` нельзя (он сам стоит десятки мс), звать только выборку данных тоже нельзя (переставит команды и данные местами) - поэтому именно насос флагов. (4) **Переполнение больше не молчит:** прошивка считает эпизоды, СНИМАЕТ липкий признак зеркалом (бит25) и говорит `GS: QUEUE OVERFLOW - BYTE LOST xN` удержанным сообщением; `gs_d_ovr` = состояние + счётчик<<8. **Стенд `sources/tb_gs_wq_fifo.sv` (xsim):** гость с темпом 4.7 мкс и слепой парой на каждом 256-м байте, оболочка рывками с паузами 1.25 и 2 мс - 1200 из 1200 байт байт-в-байт, 0 потерь, «занято» с 96, снято с 31. Негативный контроль (резерв 0) на том же стенде теряет ровно слепую пару, то есть стенд ловит именно тот дефект, ради которого написан. Он же поймал мой собственный промах: серый->двоичный через `always @(*)` не исполняется, пока указатель чтения не ИЗМЕНИТСЯ, поэтому до первого вычерпывания занятость была X и порог не срабатывал - переписано непрерывными присваиваниями | BUILD_OK. Тайминг ЗАКРЫТ: setup WNS **+0.189 нс** (у B0117 было +0.125), hold WHS +0.022, 0 нарушенных из 49968. LUT 16025/17600 = **91.05 %** (+46), регистры 14664 (+20), BRAM 60/60, DSP 13. 0 CRITICAL WARNING, подмены модулей (8-9873) нет, `gs_wq_afull` без нагрузки не висит. Бит `artifacts/ZX_CPLANE/B0118.bit`, образ `flash/BOOT_B0118_v308.BIN` (1823188 Б). **На железе НЕ проверялось** |
| 2026-08-09 | ARM: новый модуль **`arm/divmmc_fs.c`** (версия прошивки НЕ менялась) | loader.elf собран в частном APPDIR (`/tmp/dmfs_app/loader_divmmc.elf`); **`arm/loader.elf` в репозитории НЕ тронут** - на плате шла чужая приёмка | 💾 **ПЕРВЫЙ ШАГ DivMMC: СИНТЕЗ ТОМА FAT16 ИЗ ПАПКИ `0:/DIVMMC/` НА ЧТЕНИЕ.** Файловая половина проброса папки, отдельной единицей трансляции (loader_main.c не раздували, приём как у `gs_arm.c`). Отдаёт сектор по номеру: MBR (раздел типа 06), загрузочный сектор с BPB, две копии таблицы размещения, корневой каталог, данные. Ничего не хранится - всё вычисляется на лету из дерева папки; **кластеры раздаём сами и ПОДРЯД**, поэтому «сектор -> кусок файла» это двоичный поиск пробега плюс вычитание, а таблица генерируется из тех же пробегов. FAT16 выбран не по привычке: у него корень - область фиксированного размера (не нужна цепочка) и нет FSInfo, который при записи пришлось бы держать согласованным. Имена: 8.3 с флагами регистра (байт 12) там, где отличие только в регистре, иначе записи длинного имени; не-ASCII честно не переносим - такой файл виден под мангляцией. **Запись отвергается с РАЗБОРОМ причины:** MBR / загрузочный сектор / таблица - это переразметка (`DIVMMC: FOLDER SHARED - FORMAT REFUSED`), каталог и данные - `READ-ONLY FOR NOW` (там будет свой код). Форматирование ловится ПО ПОСТРОЕНИЮ: служебные структуры наши, значит запись в них не может быть сохранением файла. **Хостовой стенд `arm/divmmc_fs_host_test.c`** (обычный gcc, плата не нужна, образец - `gs_host_fx_test.c`): НЕЗАВИСИМЫЙ разборщик FAT16, написанный в нём с нуля, плюс посторонний судья `fsck.vfat`. **Стенд поймал три дефекта:** (1) хвоста `~1..~99` не хватает - у TOSEC-имён первые 8 знаков совпадают у сотен файлов, сотый получал ЧУЖОЕ имя 8.3 (`fsck` увидел «Duplicate directory entry»); сделан приём Windows NT - два знака основы + четыре шестнадцатеричных знака хэша + `~1`; (2) 512 записей корня кончаются на сотне длинных имён - поднято до 2048 (предел есть ТОЛЬКО у корня, каталог подпапки это цепочка кластеров); (3) на настоящей папке репозитория за пределом вложенности осталось 10 записей, а счётчик пропущенных показывал НОЛЬ - оболочка доложила бы «проброшено всё»; теперь брошенное поддерево пересчитывается | BUILD_OK (ARM), предупреждений у модуля нет. **Стенд: три прогона, 0 отказов.** Раскладка esxDOS 24 файла / 5 папок / 447278 Б - сверено байт-в-байт всё, потерянных цепочек 0, повторяемость 400/400, `fsck.vfat` код 0. Нагрузочная папка 302 файла с TOSEC-именами - 302 в томе, 0 пропущено, `fsck` код 0. Настоящая папка `sources/` 490 файлов / 58 папок / 14.4 МБ - сверено всё, 10 записей за пределом вложенности честно попали в «пропущено». **На железе НЕ проверялось: нет ни RTL карты SPI, ни пункта в меню - это следующие шаги** |
| 2026-08-09 | ARM **v0.15.311** + ядро **B0119** (без пересборки ядра) | loader.elf + BOOT_B0119_v311.BIN | 🩺 **ГИПОТЕЗА ПРО ПОРТ #33 NeoGS ПРОВЕРЕНА И НЕ ПОДТВЕРДИЛАСЬ + ЗАКРЫТЫ ПЯТЬ ОТСТУПЛЕНИЙ ПО ATA.** (0) Проверка гипотезы (О-14) сделана дизассемблированием САМОГО плеера, а не догадкой: в `~/gsfiles/ZPLAYER4.1_DIVMMC.TAP` (блок 3, грузится по 0x6D00, 34914 Б) во всём коде РОВНО ДВА `OUT (#33),A` - 0xE54D и 0xE55C, и значения там #10 и #00. Это рамка вокруг опознания модели карты для строки `GS:` (строки `Classic`/` ZXM-GS`/`  NeoGS` по 0xE48A/0xE492/0xE49A), причём ветка с #33 берётся, только если `IN A,(#B3)` вернул НОЛЬ. Заливки прошивки через #33 в плеере нет вовсе: последовательности NGSLOAD `LD A,#80 : OUT (#33)` в коде не встречается ни разу, а байты #55/#AA уходят не в загрузчик, а в ШТАТНУЮ команду #10 (`OUT to port` карты) - это проверка порта 3 на запись-чтение. Опознание NeoGS плеер делает своим 64-байтным кодом, который заливает в карту (0xE4AE, три записи в порт карты #0F с обратным чтением); наша карта на неизвестные внутренние порты отдаёт 0xFF (`gs_arm.c` `gs_port_read` default), поэтому вторая проверка (#DF) не сходится и мы честно опознаёмся как classic GS. Дополнительно: зависание Z-Player уже локализовано трассой Z80 в цикле `0x843C: IN A,(#BB)/RLCA/JR NC` - это порт, который мы ОБСЛУЖИВАЕМ. Прибор на живой прогон всё равно заведён и стоит даром: `gs_d_ngs` (KMB+0x5A2C) считает команды #55 и #AA, пришедшие в #BB - опознавательную пару NGSLOAD; ненулевое значение = софт всё-таки пошёл дорогой загрузчика. Счётчика обращений к самому #33 НЕТ: порт в фабрике не декодируется вовсе (`nemo_ide.v:81` `ebl` требует a[1]=0, у #33 a[1]=1), а завести его = пересборка ядра при 91.09 % LUT и запасе тайминга +0.026 нс - цена не стоит ответа, который уже получен. (1) **О-7: файл регистров ATA продвигается.** После передачи прошивка пишет в регистры адрес ПОСЛЕДНЕГО отданного сектора и остаток счётчика (`ide_regs_publish`), в LBA - разложением по #70/#90/#B0/#D0[3:0], в CHS - обратным переводом (сектор с ЕДИНИЦЫ, головка и цилиндр делением с остатком). Пишем ОДИН раз на конец передачи, а не между блоками: канал записи односторонний, каждая запись квитируется обратным чтением и требует BSY, а хост по ATA читает регистры при снятых BSY/DRQ. У IDENTIFY признак публикации снят - адреса у неё нет, и опубликовать g_ide_rd_lba от ПРОШЛОЙ команды значило бы соврать чужим адресом. (2) **О-2: режим адресации берётся из бита 6 регистра #D0** (иначе продвижение по CHS не имеет смысла). CHS считается по эталону (LSIDE ide.c:645-726) на объявленной нами же геометрии; выход за неё = ABRT|IDNF. Прежнее прощающее поведение для LBA (за концом образа - нули) НЕ тронуто. (3) **О-1: восьмибитный образ разворачивается правильно** - 256 байт из файла в чётные байты сектора, нечётные 0xFF (LSIDE ide.c:446-457). Раньше читались 512 байт подряд, то есть машина получала два сектора образа, слепленных в один. (4) **О-3: геометрия берётся из заголовка образа** (слова 1/3/6 блока IDENTIFY по 0x16), если она там ненулевая, головок ≤16, секторов ≤255 и произведение не выходит за размер файла; иначе прежний дефолт 16×63. Слова 57/58 стали ёмкостью по CHS (произведение геометрии), 60/61 остались полным числом секторов. (5) **О-13: подпись проверяется целиком** - `RS-IDE` плюс 0x1A, плюс версия и вменяемость смещения данных; та же проверка перенесена в `ide_probe`, иначе навигатор принимал бы то, что служба потом не откроет. (6) **О-9/О-10: неизвестная команда даёт ERR И ABRT**; туда же уехала 0xC6 SET MULTIPLE MODE - квитировать успехом то, чего нет, значит пригласить драйвера на 0xC4 READ MULTIPLE, которой у нас нет. Новые слова прибора: `ide_hgeom` (KMB+0x30F0) - принятая геометрия, `ide_regs` (KMB+0x30F4) - что легло в регистры, флаги трассы б5 (хост пришёл в CHS) и б6 (адрес вне геометрии) | BUILD_OK, предупреждений в изменённом коде нет. Ядро НЕ пересобиралось (B0119 без изменений). Образ `artifacts/ZX_CPLANE/BOOT_B0119_v311.BIN` (1781268 Б). **На железе НЕ проверялось: живой прогон Z-Player/Wild Player за этой правкой ещё предстоит** |
| 2026-08-10 | ARM **v0.15.312** + ядро **B0119** (без пересборки ядра) | loader.elf + BOOT_B0119_v312.BIN | 🥇🥇 **ЗАЛИПАНИЕ ТРАКТА NEMO-IDE НАЙДЕНО И ЗАКРЫТО: МЫ САМИ ЗАТИРАЛИ АДРЕС ХОЗЯИНА.** Найдено своим кодом на Z80: 12 одиночных чтений подряд, причём машина ДО каждой команды читает файл регистров ОБРАТНО. Первое чтение проходит, со второго машина, записав #70/#90/#B0/#D0, читает оттуда ЧУЖОЙ адрес (в прогоне 0x0B0021E5), он за концом образа, f_read отдаёт ноль байт, хвост обнуляется - и софт получает НУЛИ на законные адреса до перемонтирования. Виновник - `ide_regs_publish` (О-7 из v311): пять записей в файл регистров с обратным чтением, десятки микросекунд, и делались они ПОСЛЕ передачи. А конец передачи прошивка узнаёт на СЛЕДУЮЩЕМ обходе главного цикла (служба выходит, как только машина взялась за буфер), фабрика же снимает DRQ и BSY в такте последнего байта - то есть хозяин по ATA уже вправе программировать следующую команду и именно это делает. Наши пять записей ложились ровно поверх его пяти OUT-ов. **ЛЕЧИМ ОКНОМ, А НЕ ГОНКОЙ: публикация переехала в разбор команды**, где занятость держит сама фабрика (B0115 поднимает её в такте записи #F0) - в это окно хост в файл регистров не лезет и лезть не может; значение известно заранее (адрес последнего сектора пачки, остаток 0). Три записи в `ide_rd_service` (конец, отказ чтения, сторож) убраны. **(2) ЗА КОНЦОМ ОБРАЗА - ЧЕСТНАЯ ОШИБКА.** Было «512 нулей и успех» (f_lseek упирается в размер файла, f_read даёт br=0 без ошибки), то есть софт не мог отличить пустой диск от бессмысленного запроса. Стало: вся пачка проверяется в 64 битах (`lba+nsec > g_ide_secs`), ответ ERR с кодом ABRT|IDNF = 0x14 ДО первого блока - как настоящий диск (ATA-6 разрешает на выход за носитель именно ABRT; в фабрику уходит младший полубайт, машина видит ERR|ABRT, полный код виден в трассе). **(3) ПРИБОР `IDE_RW` (KMB+0x3180, 32 слова, счётчик KMB+0x7C)** - кольцо ЗАПИСЕЙ в файл регистров ATA: {регистр, попыток, что писали, что прочли обратно, вышло}. Без него спор «чья запись легла последней» не разрешить: `ide_regs` хранит только последнюю публикацию. Им и доказано, что после правки ARM пишет регистры ровно 5 раз на команду и всегда с первой попытки. | BUILD_OK. **Приёмка на железе (B0119 + v312, образ HDD.HDF, 573552 сектора):** (а) 200 одиночных чтений LBA 0..199 - **подмен адреса 0, потерь данных 0**, непустыми пришли ровно 0/63/64/69/70/95, то есть MBR, загрузочный сектор FAT32, FSInfo, их копии и начало таблицы - раскладка настоящего тома, а не мусор; (б) решающая проба на залипание: 200 чтений, ЧЕРЕДУЯ законный LBA 0 и запредельный 0x310000 - **подмен адреса 0, испорченных секторов 0, неверных ответов 0**: каждый запредельный дал ERR, каждый законный - MBR с контрольной суммой 0x3D. Сто запредельных запросов подряд не испортили ни одного следующего законного чтения. (в) Контрольные опыты, разведшие виновных ДО правки: ARM в одиночку (1024 пробы регистров без записей машины) файл регистров не портит; машина в одиночку (запись узнаваемых 5A/A5/3C/E0/11 до команды, сразу после передачи и с паузой 5 мс) читает их обратно байт-в-байт. **Смещение на два байта НЕ воспроизвелось:** MBR приходит байт-в-байт (запись раздела по 0x1BE, подпись 55 AA по 0x1FE), а 3211264 = 0x00310000 - это в точности двойное слово по MBR+0x1C8, то есть уехал ЧИТАТЕЛЬ, а не наш буфер; самое вероятное объяснение - тот же клоббер (публикация писала #50 = 0 между `OUT (#50),1` хоста и его командой, а cnt = 0 у нас значит 256 секторов). Проверять на самом Wild Player - за владельцем. **Открытый хвост:** мой ПЕРВЫЙ стенд (со стеком и таблицей в памяти) показывает подмену адреса и на v312, тогда как три других программы дают 0 подмен на 400+ командах; объяснения пока нет, ошибка теперь безопасна (честный ERR вместо нулей), лид записан |
| 2026-08-10 | ARM **v0.15.313** + ядро **B0119** (без пересборки ядра) | loader.elf + BOOT_B0119_v313.BIN | 🥇🥇 **ГОСТЬ НАЧИНАЛ КАЧАТЬ БЛОК РАНЬШЕ, ЧЕМ ОН ГОТОВ: BSY СНИМАЛСЯ В НАЧАЛЕ ЗАЛИВКИ БУФЕРА.** Заглушка перед чтением файла (`nemo_push(0x80,1,...)`) держала занятость через `buf_arm_owns`, но ПЕРВОЕ ЖЕ слово заливки сбрасывало owns в 0 и несло статус 0x58, у которого бита BSY нет. Настоящий диск снимает BSY и поднимает DRQ ОДНИМ движением, когда данные уже в буфере. Драйвер, который ждёт снятия BSY (а Wild Player делает ровно это: 9AF3 = `OUT (#F0),#20` + `JP 9C09` «ждать снятия BSY», и сразу INI-цикл), уходил качать при снятом DRQ: указатель фабрики стоит (он двигается только при DRQ), в буфер гостя ложился `sbuf[0]` вперемешку с застрявшей защёлкой старшего байта. Когда заливка кончалась и DRQ вставал, указатель шёл с нуля - сектор приезжал сдвинутым, а последние байты не приезжали вовсе, ПОДПИСЬ 55 AA ТЕРЯЛАСЬ. Отсюда и «плеер программирует LBA 573489»: разбор у него ВЕРЕН, это НАШ сдвиг, увиденный его правильным кодом. Правка на один OR: слова заливки несут статус с BSY, завершающее «чистое» слово отдаёт настоящий 0x58. | BUILD_OK. **Доказано своим кодом на Z80 (три чтения LBA 0 одной программой, до и после правки):** ДО - ждал DRQ: статус на выходе 0x58, 512/512, подпись 55 AA; ждал только снятия BSY: статус на выходе **0x50** (BSY снят, DRQ ещё нет), сдвиг **+16 байт**, совпало 496 из 496, подпись потеряна, мусор в начале `00 AA 00 AA` (= `sbuf[0]` плюс байт 511 ПРОШЛОГО сектора). ПОСЛЕ - все три чтения дают статус 0x58 и **0 расхождений из 512**, подпись на месте. **На железе:** Wild Player впервые доходит до тома - трасса `LBA 0 -> 63 (загрузочный сектор раздела) -> 64 -> 1213 x4 (корневой каталог)`, показывает `HDD:NO NAME` и открывает FAT32. Музыка играет (пик AY `0x170` с 0x00E0 до 0xFFE0, ARM-микс `0x17C` живой 0x0E..0x5C, темп 120 = 12.0 МГц, замираний 0), но модуль пришёл С ДИСКЕТЫ: в трассе IDE нет ни одного чтения данных, а 91 имя в панели - это каталог `WILDPL.SCL` (сверено по образу). Панель HDD у плеера пуста ЗАКОННО: он показывает только играбельные файлы ТЕКУЩЕГО каталога, а в корне обоих образов (`HDD.HDF` FAT32 и `HDD16.HDF` FAT16) лежат только 8 папок, музыка - в `MUSIC/`. Наш тракт до неё доходит: каталог `MUSIC` (LBA 97701..97703) читается со всеми `.stc`, а данные `Again.stc` (LBA 97709) разбираются как настоящий Sound Tracker (`SONG BY ST COMPILE`, задержка 6, указатели 1512/1557/1722 внутри 4734 Б). **Не закрыто: как в UI Wild Player спуститься в каталог образа** (Right = активировать панель дискеты, Space = вниз, Enter = играть; Down и Left роняют плеер) |

| 2026-08-10 | ARM **v0.15.314** + ядро **B0120** | loader.elf + bit + `BOOT_B0120_v314.BIN` | 🥇 **ОБЪЁМ ОЗУ СТАЛ ОПЦИЕЙ МАШИНЫ, И ЭТО НЕ ТО ЖЕ САМОЕ, ЧТО «ВЫБРАТЬ ZX 128K».** Wild Player при выборе страницы делает `OR #40`, а другим путём пишет `7FFD=#20`; у Пентагона 1024 бит5 и бит6 - это биты банка, поэтому буферы уезжали в разные банки. Очевидное лечение «снять бит0 MACHINE_CFG = честные 128К» ПРОВЕРЕНО НА ЖЕЛЕЗЕ И НЕ ГОДИТСЯ: без бита0 бит5 порта снова становится БЛОКИРОВКОЙ страничности, плеер пишет `#20` и намертво замораживает окно - 400 опросов подряд дали `7FFD=0x20` без единого изменения, картинка развалилась. Правильная модель - не блокировка, а ОТСУТСТВИЕ микросхемы: недостающего старшего бита у машины просто нет, запись проходит, банк не меняется. (1) `MACHINE_CFG [16:14]` = маска ОТСУТСТВУЮЩИХ старших бит банка, поле ИНВЕРТНОЕ (000 = все три есть = 1024К), поэтому прошивка, не знающая про поле, получает ровно прежнюю машину. (2) Маску считает ARM (`RAMSIZE_CFG`), а не фабрика: три готовых бита складываются в ту же LUT6, что и условие окна 0xC000 (`bankHi[i] = pent_ext & a15 & a14 & page_hi[i] & ~nobit[i]`), и правка ядра стоит НОЛЬ LUT. Первые две попытки собрать с мультиплексором объёма В ФАБРИКЕ (16032 и 16035 LUT) НЕ РАЗМЕСТИЛИСЬ - при 91 % занятости лишние три LUT решают. (3) Меню: «Machine -> RAM size» 128K/256K/512K/1024K (`opt_items[68]`), ini-ключ `<тег>.ramsize`, применение через холодный старт (HALT -> защёлкнуть слово -> сброс с очисткой -> отпустить): меняется КАРТА ПАМЯТИ под работающим Z80. | BUILD_OK с третьей попытки. LUT **16035/17600 = 91.11 %**, регистры 14737, BRAM 60/60, DSP 13. Тайминг ЗАКРЫТ: setup WNS **+0.027 нс**, hold WHS **+0.020 нс**, **0 нарушенных из 50073**. Подмены модулей (8-9873) нет. **Приёмка на железе (образ `0:/WPROOT.HDF`, 162 файла в корне, A/B на ОДНОМ И ТОМ ЖЕ образе):** 1024К - плеер РАЗВАЛИВАЕТСЯ на клавише панели (экран в мусор); 512К - то же; **128К - плеер жив**, панель HDD берёт фокус, счётчик показывает **162** (то есть весь корневой каталог прочитан), `7FFD` живой (0x13/0x16, не заморожен), Enter и пробелы больше не роняют плеер. **НЕ ЗАКРЫТО: ИМЕНА в панели жёсткого диска по-прежнему не рисуются** - панель пуста при верном счётчике. Кадр для приёмки брать из DDR `0x0FF00000` (4bpp, 384 пикселя, **шаг строки 192 Б**, 302 строки, на остановленном Z80 и двумя совпавшими чтениями): зеркало экрана `0x40008000` под этим плеером ЛЖЁТ - он пишет в банк 7, а зеркало сваливает банки 5 и 7 в один буфер |

| 2026-08-12 | ARM **v0.15.333** + ядро **B0128** | bit + `flash/BOOT_B0128_v333.BIN` + `artifacts/ZX_CPLANE/bulb_zx_B0128.bit.bin` | 🥇 **(1) ВАРП ОТПУСКАЕТСЯ ПО МОЛЧАНИЮ ЛЕНТЫ, А НЕ ПОРТА `#FE`.** Жалоба владельца: `SHOCK.TAP` (демка с порционной загрузкой) просит нажать пробел, чтобы продолжить, а выходит BREAK — «1 раз из 10 и только очень быстрым тычком»; окно навигатора при этом закрыто, то есть пауза транспорта ни при чём. Разбор ленты написанным ради этого инструментом `tools/tap_inspect.py`: 20 блоков, стандартный загрузчик ПЗУ, каждая часть отдаёт управление МГНОВЕННО — `LD A,$7F / IN A,($FE) / RRA / JP C,… / IM 1 / EI / RET`, ни такта на ожидание отпускания. Дальше BASIC идёт в `LOAD`, а `LD-SAMPLE` ПЗУ (0x05ED) читает ТОТ ЖЕ полуряд `0x7FFE` и ТОТ ЖЕ бит 0 — зажатый пробел рвёт загрузку на любом настоящем Спектруме, демка ни при чём. Запас у человека тут БОЛЬШОЙ: `USR 25150` — не возврат в BASIC, а `shock.0`, который делает два `HALT` и две полные очистки экрана (`LDIR` 6911 байт = 145126 тактов = 41.5 мс каждая) = **83 мс** детерминированно плюс кадровые ожидания и BASIC (четыре `VAL`, `STR$ f`, печать 32 знаков) ≈ **120 мс**. У нас он складывался вчетверо: сторож простоя варпа перевзводился по `smp_edge` — ЛЮБОМУ чтению `#FE`, а часть опрашивает пробел раз в кадр (~70000 тактов) при пороге `0xDC WARP_HOLD` = 0x200000 (~600 мс), то есть перевзводила вечно и держала 8× всю часть; 83 мс под 8× = 10 мс, плюс `HALT` (варпом не сжимается — варп процессорный) → **~30 мс вместо 120**. **Корень глубже симптома: у ВКЛЮЧЕНИЯ и ВЫКЛЮЧЕНИЯ одного латча были РАЗНЫЕ предикаты, и победил более грубый** — детектор захвата давно умный (`sampling_active` = плотный цикл ИЛИ корреляция с краями), а сторож отпускания остался грубым, поэтому умный решал только, когда включить. Правка: `tape_alive = (edge_age < 12'hFFF)`, `load_confirmed = warp_guard & sampling_active & tape_alive`, `load_activity = tape_edge \| corr_read` (было `\| smp_edge`). `corr_read` уже существовал и уже использовался захватом — критерий стал один на оба конца; во время настоящей загрузки каждое чтение таково по построению, поэтому для лент не меняется ничего. 🥇 **(2) NMI ПОДТВЕРЖДАЕТСЯ ЗА 11 ТАКТОВ, А НЕ 13** (проверка утверждений товарища владельца, симуляция xsim на файлах из битстрима). `Auto_Wait` вставляет два такта ожидания в `M1` цикла подтверждения — реальный Z80 делает это ТОЛЬКО для маскируемого прерывания (устройству нужно успеть выставить вектор), у NMI вектора нет. Наш форк Atlas тянул в то же условие `NMICycle`. Правка сделана **ФОРКОМ** `sources/t80_bulb/T80.vhd`, а `build.tcl` выкидывает одноимённый `zx/src/T80/T80.vhd` из списка чтения ПО ИМЕНИ и проверяет, что файлов ровно 6 (`zx` — симлинк на `cores/zx`, который делят шаги 06..14; правка на месте молча сменила бы процессор и им — та же болезнь, что дала немой SAA1099). **Заодно опровергнуто: IM 2 у нас 19 тактов, а не 21** — число 21 берётся из стока-T80 0242, где живы две строки `TStates <= "100"` на PUSH'ах цикла IM 2; у нас закомментированы, и трогать их НЕЛЬЗЯ. Семантика NMI вся верна (`IFF1` сброшен, `IFF2` сохранён, `RETN` восстанавливает, NMI во время `HALT` кладёт адрес следующей команды). | BUILD_OK. LUT **15784/17600 = 89.68 %**, регистры 14793 (42.03 %), BRAM **58/60** (перебора нет), DSP 13. Тайминг ЗАКРЫТ: setup WNS **+0.140 нс**, hold WHS **+0.027 нс**, **0 нарушенных из 50076**. Критических предупреждений **0**; подмены модулей (8-9873) нет — в логе `module 'T80' declared at .../t80_bulb/T80.vhd bound to instance 'u0'`, а `T80_MCode` апстримный; «has no load» ровно 100, как в B0127 (отдельные биты внутренних портов, не немой чип). **НЕ ПРОШИТО, НЕ ЗАКОММИЧЕНО** — ждём владельца. Проверять после заливки: `SHOCK.TAP` в режиме FAST обычным (не судорожным) тычком пробелом на переходе между частями — должна пойти следующая часть, а не `BREAK`; лента-регрессия (Critical Mass, Big Things, Deflektor, EXOLON) обязана остаться зелёной, правка не трогает ни дескрипторы, ни уровни EAR. Обходной приём без прошивки: режим **NORMAL (1×)** |
| 2026-08-12 | ARM **v0.15.333** + ядро **B0129** | bit + `flash/BOOT_B0129_v333.BIN` + `artifacts/ZX_CPLANE/bulb_zx_B0129.bit.bin` | 🥇 **ПОКА ЖДЁМ СЛЕДУЮЩИЙ БЛОК — МАШИНА ИДЁТ В РОДНОМ ТЕМПЕ (идея владельца, точнее моего сторожа из B0128).** В B0128 варп отпускался по СТОРОЖУ: 600 мс без краёв ленты. То есть конец загрузки УГАДЫВАЛСЯ, и оставался хвост в 600 мс — для SHOCK.TAP неважно (часть играет минуту), но у демки с короткой паузой между блоками сторож не успел бы сработать вовсе. Владелец предложил переключать явно: на время ожидания следующего блока — 1×, на блоке — снова 8×. Точный признак для этого уже был: `(~sync_effective \| ~tape_sync_rom \| sync_hold \| sync_state==SYNC_CUSTOM)` — тот самый предикат, что гейтит `tape_advance`. При демандовой ленте между блоками поток заморожен (`SYNC_WAIT`, дескриптор пилота взведён, `sync_hold` снят), машина в это время не грузится, а работает своим кодом — разгонять её там незачем. Правка: предикат вынесен из выражения на месте в именованный провод `tape_streaming` (чтобы у ленты и у скорости процессора не могло разъехаться понимание «идёт загрузка или нет» — ровно это расхождение и стоило нам SHOCK.TAP), и `cpuwarp_req` домножен на него. 🥇 **Почему это не возвращает дребезг, который когда-то давал ~50 % зависаний:** `warp_latch` НЕ тронут (он отвечает на вопрос «мы внутри загрузки» и обязан держаться через паузы), а `sync_hold` меняется ТОЛЬКО на границе блока — внутри блока `SYNC_ACTIVE` держит его поднятым («never truncate a started block»). То есть скорость переключается ровно тогда, когда лента заведомо стоит, а не между двумя чтениями бита; плюс сама смена уже защёлкивается на границе такта (`if (ne_sel) cpuw_active <= cpuwarp_req`). **Область действия узкая намеренно:** только процессорный FAST (fmode=1) на ПОМЕЧЕННЫХ стандартных блоках ПЗУ; у турбо и кастомных загрузчиков `tape_sync_rom`=0 или SYNC_CUSTOM → `tape_streaming` всегда 1, поведение не меняется. Целоядерные режимы (fmode 2/3, только через JTAG) НЕ трогаем: там смена темпа тянет за собой ULA и видеотакт и есть рукопожатие `warp_ack`. Сторож по `corr_read` из B0128 ОСТАВЛЕН — он чинит ту же асимметрию в общем виде и работает там, где демандовой ленты нет. Всё остальное из B0128 (NMI за 11 тактов форком T80) на месте. | BUILD_OK. LUT **15788/17600 = 89.70 %** (+4 к B0128), регистры 14793, BRAM **58/60**, DSP 13. Тайминг ЗАКРЫТ и ЛУЧШЕ B0128: setup WNS **+0.320 нс** (было +0.140), hold WHS **+0.042 нс**, **0 нарушенных из 50076**. Критических предупреждений **0**, подмены модулей нет, `T80` по-прежнему из `t80_bulb/`. Размер битстрима отличается от B0128 (1129343 против 1164183) — в xdc включено `BITSTREAM.GENERAL.COMPRESS`, размер зависит от содержимого, это норма. **НЕ ПРОШИТО, НЕ ЗАКОММИЧЕНО.** Проверять: SHOCK.TAP в FAST — обычный тычок пробелом на переходе между частями должен вести к следующей части, а не к `BREAK`; лента-регрессия (Critical Mass, Big Things, Deflektor, EXOLON) обязана остаться зелёной — правка не трогает ни дескрипторы, ни уровни EAR, ни латч варпа. B0128 остаётся собранным как запасной вариант |
| 2026-08-13 | ARM **v0.15.338** + ядро **B0130** | bit + `flash/BOOT_B0130_v338.BIN` + `artifacts/ZX_CPLANE/bulb_zx_B0130.bit.bin` | 🥇 **(1) ЗАТЫКИ GS ЗАКРЫТЫ: ПОРТ 3 — РЕГИСТР, А НЕ ПОТОК.** `HSEND` карты крутится, пока Спектрум не заберёт байт; у нас байт стоил ≥2 прохода главного цикла (худший 134 мс), карта не звала `ENGINE`, кольцо квантов (54.6 мс) таяло, срабатывал `QTFAULT` — а он кончается `RET` БЕЗ `EI`, поэтому ЦАП держал уровень. Первая версия очереди ответов ломала карту: прошивка законно пишет в порт 3 мусор, который никто не должен читать (следующая запись его затирает), а очередь превращала затирание в лишние записи и СДВИГАЛА поток ответов навсегда — команда объёма памяти вместо `0x07C000` отдавала `0x000F00`, номер сэмпла вместо 1 приезжал 192; за 6 с инициализации, до единой команды, карта пишет туда дважды. **Решение: байт забирается не на ЗАПИСИ, а на ПЕРВОМ ОПРОСЕ** — когда карта читает свой регистр флагов, то есть ровно когда `HSEND` начинает ждать. Мусорный байт карта либо гасит своим `IN A,(2)`, либо затирает, и флаг при этом не читает НИ РАЗУ (455 записей за сеанс, мусорных 3, опросов у них 0); настоящий ответ опрашивается следующей же инструкцией, выход из ожидания 11 тактов. Плюс **очистка очереди на любую запись в `#BB`** (обрыв выдачи новой командой штатен — `JP 026B`, сверено по байтам ПЗУ; залежавшийся хвост сдвинул бы следующий ответ и навесил бы хост в `WD`, где таймаута нет). Глубина 16: **глубина 1 НЕ достаточна** (804 QTFAULT при 1 мс — `#63`/`#64` отдают по 4 байта); глубина 0 = прежнее поведение байт-в-байт. 🥇 **(2) ЧАСТОТА КАРТЫ — ОПЦИЯ `GS CLOCK` 12/14/18/24 МГц, УМОЛЧАНИЕ 12.** Свипы, обещавшие выигрыш от 18 МГц, мерились на файле ДО очереди; после починки тот же стенд даёт 0 аварий и на 12, и на 18 — платить 31 % процессорного времени за недоказанное нельзя. Закрыта мина: потолок догона `tcy > 4000` был вшит числом и на повышенной частоте молча обрезал бы работу вдвое. 🥇 **(3) `OUT (#E3),#80` ПОДМЕНЯЛ ОКНО ПЗУ НА ЖИВОЙ МАШИНЕ.** Защёлка `#E3` не была загейтована, а `map = mapForce \|\| (mapAuto && mapper)` пускал `mapForce` при `mapper=0` (топ инстанцирует именно так): `0x0000` уезжал на 48 BASIC, `0x2000` — в мёртвый esx-регион С РАЗРЕШЁННОЙ ЗАПИСЬЮ. Стало `map = (mapForce \|\| mapAuto) && mapper` + гейт защёлки. **`OUT (#E3),#E4` в EFF7 оставлено намеренно:** у настоящего Пентагона 1024 неполная дешифрация такая же (адрес `0xE4E3` попадает в окно `EFF7`), это не наш дефект; терм `a[4]` заведён, но загейтован `mapper` — обезврежено только для будущего DivMMC. **Гейтовать порт по `!m1` НЕЛЬЗЯ** (у T80 активен нулём — порт умер бы), запрет записан в коде. **(4)** Ширина диалогов по содержимому + убраны ТРИ молчаливые обрезки (путь к образу винчестера рубился на 33 знаках, путь DivMMC на 36, имя образа в шапке каталога на 30); честные `SYNC LOADER` (форсируется режимом FAST в фабрике) и `ULA SNOW` (бит4 читает только Atlas). | BUILD_OK. LUT **15776/17600 = 89.64 %** (−12 к B0129), регистры 14788 (−5), BRAM **58/60**, DSP 13. Тайминг закрыт: setup **+0.044 нс**, hold **+0.034 нс**, **0 нарушенных из 50061**, критических **0**, подмены модулей нет, `has no load` ровно 100 как в B0129. ⚠ **Запас честно тоньше B0129 (+0.320):** проверено, что это НЕ регрессия логики (LUT меньше, критический путь в пиксельном домене и страничности не касается) и НЕ директива (пересборка способом B0129 дала +0.068) — лотерея размещения при 89.6 %. **Приёмка звука** (`arm/gs_gap_bench.c`, перепроверена лично на файле из дерева): база при задержке 2 мс — 120 дыр, худшая 5.2 мс, 6 % времени, QTFAULT 478, карта в ожидании 74 % времени; при 5 мс — 218 дыр, 18.5 мс, 40 %. **Почин: 0 дыр и 0 QTFAULT на ВСЕХ задержках вплоть до 134 мс.** На настоящем модуле база даже при НУЛЕВОЙ задержке даёт худшую дыру 2016 мс и 49 QTFAULT, почин — 3.0 мс и 0. Доказано, что карта не ждёт круга: опросов «забрали?» ровно столько же, сколько забранных байтов (16290 = 16290), у базы тех же опросов 37 314 439 и худший простой 2.17 с. Зависаний хоста в `WD` у почина 0, у базы 1. **Микростенд страничности** (xsim на самом `memory.v`, 25 утверждений): B0129 — 6 FAIL, B0130 — **0 FAIL**. **НЕ ПРОШИТО, НЕ ЗАКОММИЧЕНО.** Проверять после заливки: SHOCK.TAP в FAST обычным тычком пробелом; лента-регрессия (Critical Mass, Big Things, Deflektor, EXOLON); музыка через Z-Player на смене паттернов; запись на дискету; NEMO-IDE |
| 2026-08-13 | ядро **B0131** (MiSTer-48), прошивка не менялась | `artifacts/ZX_CPLANE/mister48_b0131.bit.bin` → на карте `0:/CORES/MISTER48.BIT.BIN` | 🥇 **ПЕРЕСБОРКА МАШИНЫ MiSTer-48 НА БАЗЕ B0130: правки ленты живут в ОБЩЕМ верхнем модуле и до этой машины просто не доезжали.** Владелец подтвердил починку пробела на Atlas (B0130), переключился на MiSTer-48 — не работает. Причина не в процессоре и не в логике: на карте лежало ядро **B0059**, отставшее на семьдесят сборок, а смена машины в меню перезагружает ПЛИС именно с карты. `bulbulator_zx_ddr_top.v` — один файл на все ZX-машины (`build.tcl` собирает Atlas / MiSTer-48 / гибрид разными `-tclargs`), поэтому отпускание варпа по молчанию ЛЕНТЫ (B0128 `load_activity = tape_edge \| corr_read`, B0129 `cpuwarp_req &= tape_streaming`) в исходнике уже было — не хватало сборки. **Процессор здесь MiSTer-овский T80pa 0250** (`build.tcl` форсирует `MISTERT80=1`, `mister_t80` — симлинк на `cores/zx-mister/rtl/T80`), и он проверен по коду: `Auto_Wait <= '1' when IntCycle = '1' and MCycle = "001"` без `or NMICycle` → **NMI 11 тактов**, обе строки `TStates <= "100"` циклов PUSH в `T80_MCode.vhd:891,897` закомментированы → **IM 2 = 19 тактов**. То есть наш форк `sources/t80_bulb/T80.vhd` сюда НЕ подставляется и не нужен. Отдельный `BUILD_VERSION` ветки `MISTER48_CORE` поднят B01B0059 → **B01B0131**. Собрано в ИЗОЛИРОВАННОЙ копии `/tmp/m48build` от чистого состояния B0130: живое дерево в этот момент правили исполнители DivMMC, и первая попытка сборки из него упала на их незаконченной строке (`ASYNC_REG=TRUE` без кавычек) — гоча на будущее: пересобирать боковые ядра только из зафиксированного снимка. | BUILD_OK. LUT **12721/17600 = 72.28 %**, BRAM 48/60, setup WNS **+0.173 нс**, **0 нарушенных из 40505**, критических предупреждений **0**. **ПОДТВЕРЖДЕНО ВЛАДЕЛЬЦЕМ НА ЖЕЛЕЗЕ 13.08: SHOCK.TAP на машине MiSTer 48К — пробел работает.** Ранее в тот же день подтверждено на Atlas (B0130): «пробел работает корректно». Заливка на карту — через временный файл со сверкой размера по каталогу и переименованием (см. аварию ниже). ⚠ **АВАРИЯ ПРИ ЗАЛИВКЕ, оплачена перезагрузкой платы:** запись B0130 поверх `ATLAS.BIT.BIN` дала `done=1, err=0`, но по полю `n` записалось **11947 байт из 1215552** — на карте кончилось место, ядро стало обрезком. Дальше JTAG потерял процессорные ядра (`DAP APB AP transaction error`), вылечилось перезагрузкой владельцем. Восстановлено: удалены `B0130.BIT.BIN`, `ATLAS_B0119.BAK`, `B0116T.BIN`; `ATLAS.BIT.BIN` = 1215552 (B0130), `MISTER48.BIT.BIN` = 1115616 (B0131), оба сверены листингом каталога |
| 2026-08-14 | ARM **v0.15.366** + ядро **B0139** | `flash/BOOT_B0139_v366.BIN` + `artifacts/ZX_CPLANE/bulb_zx_B0139.bit(.bin)` | 🥇 **(1) МУСОР У WILD PLAYER - ЭТО СНЕГ ULA, И У ПЕНТАГОНА ЕГО БЫТЬ НЕ ДОЛЖНО.** Зеркало экрана снимается С ВЫБОРКИ ULA, то есть показывает картинку: за 2 с различаются 2831 байт при снеге и 61 без него. В профиле у всех пяти машин стоял `.snow = 1`, а строки в меню Пентагона не было - снег включён, выключить нечем. Дефолт OFF, глобальный ключ `snow=` Пентагона больше не поднимает, подсказка честно называет ON отступлением от оригинала. Мина по дороге: **меню ссылаются на таблицу опций ПО НОМЕРУ, а подписи в ней сдвинуты на единицу** - я взял `[38]` вместо 39 и строка показывала EARLY/LATE от `ULA TIMING`; проверены ВСЕ ссылки счётом элементов, расхождение было одно. 🥇 **(2) ДЕМКА ВИСНЕТ С ПАПОЧНОГО ТОМА: `DMFS_ROOTENT` 2048 -> 512.** Найдено делением пополам НА ЖЕЛЕЗЕ (v345 идёт, v347 виснет, v354 виснет; B0136 и B0138 отказывают одинаково - ядро ни при чём). Откатить нельзя: 512 требует LFN-браузер. Переключатель `DivMMC root entries`, умолчание 2048. ⚠ ПОЧЕМУ 512 ломает - НЕ ДОКАЗАНО: стенд на копии структуры карты не находит ничего, `fsck.vfat` даёт 0. 🥇 **(3) FAT32 ДЛЯ ПАПОЧНОГО ТОМА** в четыре шага с проверкой FAT16 на каждом; корень стал цепочкой кластеров (узел 0 получает кластер 2), резерв 32 сектора с FSInfo и запасным загрузочным, тип раздела 0x0C. Кластер 4 КБ, а не 32: у FAT32 жёсткая граница 65525 кластеров, ниже неё том читается как FAT16. Опция `DivMMC folder FS`. 🥇 **(4) DivMMC ЗАВОДИТСЯ САМ.** Две неудачные попытки записаны в код: v356 ломала карту, потому что вместе со сбросом ПЕРЕПРОГРАММИРОВАЛА её; промежуточный вывод «метки в ОЗУ нет» был ошибкой измерения (стёр 128 КБ, проверил 8). Настоящая причина найдена отметками в памяти: признак взводился НУЛЁМ, потому что в той точке загрузки профиль машины ещё не применён. Защёлка переехала внутрь службы. **(5)** Запись в папку с хоста пересобирает том и даёт машине чистый старт. **(6)** Голый `Ins` не уходит в машину при открытом навигаторе (B0139, ноль LUT). **(7)** Своё окно Z-диска; починен `Eject`, который гасил только DivMMC. **(8)** HDF в DivMMC: работал и раньше, закрыта дыра с 8-битными образами. Мины в инструментах: `put_files.tcl` не тянет файлы больше буфера (написан `put_big.tcl`, куски 4 МБ), у `mrd` счётчик В СЛОВАХ. | BUILD_OK. LUT **14800/17600 = 84.09 %** (столько же, сколько B0138 - гейт `Ins` бесплатен), тайминг закрыт: setup WNS **+0.168 нс**, hold WHS **+0.033 нс**, 0 нарушенных. Критических предупреждений 0, подмены модулей (8-9873) нет. **Приёмка приборами:** DivMMC после перезагрузки заводится сам (51 команда, 40 чтений без вмешательства); перемонт после записи пойман на счётчиках (48/36 -> 51/40 через секунду); том FAT32 принят `fsck.vfat` (код 0) и вычитан `mtools` побайтово равным исходной папке (95 файлов, `diff -r` пуст). **НЕ ЗАКОММИЧЕНО - ждём владельца.** Проверять на железе: наборы ПЗУ PentoGraf (`PGFATALL`/`PGPROTEU` в `0:/ROMS/`), окно Z-диска, `Ins` при открытом навигаторе, Elysium State на умолчании FAT16+2048 |
| 2026-08-18 | Ядра **B0140 / B0141 / B0142 / B0143** + прошивки v0.15.379…v0.15.382 (записаны задним числом 19.08 — в истории их не было) | залиты на карту 18.08, `POST VERSION` проверялся после каждой | B0140 полярность card detect ZC (`#77` отдаёт `{7'b0, ~sd_cd}`); B0141 порт `#57` отдаёт живой сдвиговый регистр, а `#EB` сохраняет конвейер esxDOS; B0142 движок SPI переведён на `spclk` (28.33 МГц, 282 нс на байт) и у модели карты `.ce(ne7M0)` заменён на `.ce(1'b1)` — **это и внесло латентную регрессию Standard-режима**; B0143 бит20 `MACHINE_CFG` = переключатель Turbo/Standard + пункт в диалоге ZC. Ни одна из четырёх сборок Z-Controller не оживила: причина была не в SPI, а в приоритете шины (см. B0144). |
| 2026-08-19 | Ядро **B0144** (`bulb_zx_B0144.bit`, 1 120 347 Б; `.bit.bin` 1 120 224 Б) + прошивка **v0.15.383** (`loader.elf` 2 803 796 Б, образ `flash/BOOT_B0144_v383.BIN` 1 814 356 Б) | LUT **14839 / 17600 = 84.31 %**, FF 12254, BRAM **58.5 / 60**, тайминг **закрыт**: setup WNS **+0.207 нс**, hold WHS **+0.026 нс**, 0 нарушенных из 45927; 0 ERROR, ни одного `8-9873`. На плату НЕ залито (владелец работал на ней) | 🥇 **ПОЧЕМУ Z-CONTROLLER НЕ ЧИТАЛ НИЧЕГО: чтение порта `#57` перехватывал джойстик Kempston.** `atlas_core/main.v:688` декодирует кемпстон ОДНИМ условием `a[5]=0`, а `0x57 = 0101_0111` попадает в этот конус; в мультиплексоре шины В процессор ветка `joy1|joy2` стояла ВЫШЕ ветки ZC, поэтому на каждый байт данных карты машина получала ноль. Запись идёт мимо мукса, а `#77` (`0111_0111`, `a[5]=1`) не задет — отсюда наблюдаемая подпись «карта видит команды, ответов нет». Приборно на живой плате ДО правки: `DMMC_DBG` = команд **255** (насыщено) при **0** чтений, `DMMC_STAT` last_cmd = 0 (вечный CMD0), state = 3 (RESP). Владелец независимо описал то же: FATALL и Proteus читают FAT через NEMO-IDE и не читают ничего через ZC. **Та же мина уже поднимала выше кемпстона NEMO-IDE, мышь Kempston и дисковод** (в коде стоят комментарии «СТРОГО раньше kempston»); из четырёх жертв бита 5 забыли ровно ZC, а DivMMC уцелел случайно — у `#EB`/`#E7` бит5 = 1. Лечение: ветка `!ioZC ? usdQ` поднята выше `!ioDF`. **Прошивка v0.15.383:** бит20 (скорость SPI) ставился только внутри ветки ZC, поэтому конфигурация «DivMMC вкл / ZC выкл» уезжала в режим Standard, где модель карты сэмплирует УРОВЕНЬ `sck` (`.ce(1'b1)` с B0142) и байт вырождается — то есть esxDOS был под латентной регрессией с B0142. Бит передан общему движку. **Открыто:** сам режим Standard SPI неработоспособен (импульс запроса `tx/rx` промахивается мимо `cen`; xsim на настоящем RTL: 545 импульсов → **0** запусков движка, в Turbo 549/549) — правится защёлкой pending и выверкой фронта выборки в модели карты, наугад не трогал. |
| 2026-08-19 | Прошивка **v0.15.384** (`loader.elf` 2 803 964 Б, образ `flash/BOOT_B0144_v384.BIN` 1 814 356 Б; ядро прежнее **B0144**) | записана на карту поверх `0:/BOOT.BIN` (temp + сверка листингом), **тёплая перезагрузка НЕ делалась** — владелец работал на плате | 🥇 **Z-CONTROLLER ЗАРАБОТАЛ НА ЖЕЛЕЗЕ (подтвердил владелец): Proteus 2.31 видит содержимое карты, WDC 1.62 видит её и играет с неё музыку.** Приборно после B0144: команд 76, **чтений сектора 30**, рассинхронов 0, `last_cmd = 17` (CMD17) — до правки было «команд 255 при нуле чтений». **Остаточный отказ и его причина: FATALL v0.26 вис на «Find first free cluster Please wait...».** Разделение по приборам: последний запрошенный сектор `DMMC_LBA = 2049`, и за три секунды машина не запросила НИ ОДНОГО нового — то есть вис не в транспорте и не в ожидании карты, а в разборе прочитанного. Сектор 2049 — это **FSInfo** нашего тома FAT32 (раздел с LBA 2048, резерв 32, FSInfo первый), и мы отдавали в нём `0xFFFFFFFF` «неизвестно» по обоим полям. Спецификация это разрешает, но тогда чужая сторона обязана искать свободный кластер сама — FATALL на этом и встал. 🥇 Прежний комментарий в коде («считать свободные кластеры на синтезируемом томе честно нечем») был неверен ровно наоборот: **кластеры раздаём МЫ и раздаём ПОДРЯД**, поэтому и число свободных, и первый свободный известны точно. `arm/divmmc_fs.c` `sec_fsinfo` теперь отдаёт `clusters - clusters_used` и `clusters_used + 2`. **Проверено стендом, а не на глаз:** старый `divmmc_fs_host_test.c` умеет только FAT16 и FSInfo не проверяет вовсе, поэтому написан точечный стенд `arm/fsinfo_probe.c` (обычный gcc) — он читает том глазами чужой стороны: тип раздела `0x0C`, `RootClus = 2`, FSInfo найден по полю загрузочного сектора и лежит **ровно в LBA 2049** (совпало с показанием платы), подписи `RRaA`/`rrAa`/`55AA` на месте, свободных 65511 из 65600, первый свободный 91 — сошлось с тем, что синтезатор говорит про том. Регрессия FAT16 зелёная: `divmmc_fs_host_test` — отказов 0, `fsck.vfat` код 0. **ПРИНЯТО НА ЖЕЛЕЗЕ (владелец, 19.08): FATALL 0.26 загрузился и показал содержимое карты; приборно команд 46, чтений 22, рассинхронов 0, last_cmd = 17, последний запрошенный сектор 10979 - чтение ушло в область ДАННЫХ, а не встало на служебной. Итог приёмки Z-Controller: Proteus, WDC (с музыкой), FATALL - три из трёх** — нужна перезагрузка платы. Плюс в v0.15.383 бит20 (скорость SPI) передан общему движку карты. |
| 2026-08-19 | Прошивка **v0.15.386** (`loader.elf` 2 878 140 Б, образ `flash/BOOT_B0144_v386.BIN` 1 830 740 Б; ядро прежнее **B0144**) + новые модули `arm/rom_ident.c/.h`, стенды `arm/rom_ident_host_test.c` и `arm/fsinfo_probe.c` | записана поверх `0:/BOOT.BIN` (temp + сверка листингом), тёплая перезагрузка: `POST VERSION = 0xB01B0144`, `FIFO_OVERFLOW = 0`; стенд распознавателя прогнан на 9 настоящих файлах ПЗУ | 🥇 **ФОРМАТ ТОМА БРАЛСЯ НЕ У ТОГО ТРАНСПОРТА (жалоба владельца: «Proteus показал FAT16, хотя у Z-Controller стоит FAT32»; второй симптом - Wild Player не видел карту вовсе).** Носитель у ZC и DivMMC ОДИН, а `divmmc_service` открывал и пересобирал том всегда через `divmmc_open()`, то есть по настройкам DivMMC (`opt_dmmode`/`opt_dmfat32`/`opt_dmroot`, умолчание FAT16). Настройка ZC (`zc_open`, умолчание FAT32) жила ровно до первого вмешательства службы - а она монтирует том лениво при старте платы и пересобирает после правки папки. Владелец подтвердил механизм обходом: выключил и включил Z-Controller - Wild Player сразу увидел карту и заиграл. Лечение: `dm_media_open()` (`loader_main.c:8309`) выбирает путь по владельцу носителя (DivMMC главный - esxDOS стартует раньше и живёт в странице ПЗУ), служба зовёт его вместо `divmmc_open()` (`:8485`, `:8516`). **Плюс задание владельца по меню ПЗУ** («показывать какие банки или содержимое в ром файле и выбирать из разных вариантов любого ром файла»): новый распознаватель `rom_page_ident()` даёт человеческую метку страницы 16 КБ вместо четырёх видов - проверено стендом на настоящих файлах: `PGFATALL` = [FATALL v0.25, TR-DOS 6.11Q, 128 MENU, 48 BASIC], `PGPROTEU` = [PROTEUS SVC, TR-DOS 6.11Q, 128 MENU, 48 BASIC], `PGCLASSC` = [ZX ROM (?), **TR-DOS 5.03**, 128 MENU, 48 BASIC], `PENTGLUK`/`PGGLUK66` = [GLUK SERVICE, TR-DOS 6.11Q, 128 MENU, 48 BASIC], одиночные страницы `FATALL26.ROM` = FATALL v0.26, `WDC126.ROM` = WDC SETUP, `MINIBOOT.ROM` = SD BOOT. `rom_page_kind` НЕ тронут - раскладка по слотам прежняя бит-в-бит. **Приёмка Z-Controller на железе за этот день (владелец): FATALL 0.26, Proteus 2.31, WDC 1.62 (играет музыку с карты), Demeter 1.20 (видит карту, докладывает FAT32), Wild Player 0.333 (видит и играет) - пять программ.** Открыто: **Z-Player 4.1** видит диск, но содержимое не читает и висит - приборно команд 80, чтений 72, **desync 4**, `last_cmd = 18` (мультиблок), стоп на LBA 2049, дельта за 4 с нулевая; мультиблок сам по себе жив (у Wild Player тот же CMD18 при desync 0), то есть расхождение в ОБРЫВЕ мультиблока (CMD12) - разбор идёт. |
| 2026-08-19 | Ядро **B0145** (`bulb_zx_B0145.bit` 1 122 135 Б, `.bit.bin` 1 122 016 Б) + прошивка **v0.15.387** (образ `flash/BOOT_B0145_v387.BIN` 1 832 532 Б) | LUT **14877 / 17600 = 84.53 %**, BRAM 58.5 / 60, тайминг **закрыт**: WNS **+0.389 нс**, 0 нарушенных из 45964; 0 ERROR, ни одного `8-9873`. Залито на карту (temp + сверка листингом), тёплая перезагрузка: `POST VERSION = 0xB01B0145`, `FIFO_OVERFLOW = 0`. Откаты `0:/BOOTV386.BAK`, `0:/CORES/ATLAS144.BAK` | 🥇 **НАША КАРТА НЕ ОТВЕЧАЛА НА КОМАНДУ «СТОП» (вис Z-Player 4.1).** Два дефекта одного узла. (1) CMD12, пойманная в паузе между блоками (`S_MBGAP`), уводила автомат в IDLE молча — без R1b: `divmmc_card.v:593-598` не ставил ни `resp`, ни `rcnt`, ни `after`. SD Physical Layer Spec §7.2.8 прямо требует обратного: «в отличие от протокола SD-карты, в режиме SPI карта ВСЕГДА отвечает на команду», и Figure 7-5 показывает response после стоп-команды. (2) В остальных случаях ответ приходил только после ДОСДАЧИ ЦЕЛОГО блока (406 байт), поэтому драйвер принимал байт данных за R1b, считал остановку выполненной и стрелял следующей командой прямо в поток — а такой кадр у нас молча ВЫБРАСЫВАЛСЯ со `desync++`. Отсюда наблюдаемые на плате `desync = 4` при `state = 0` и нулевой дельте счётчиков. Лечение: исполнение стоп-команды вынесено в ОДНУ общую точку (`divmmc_card.v:418-443`), срабатывает на следующем байте после кадра, где бы тот ни пришёл; ветки остановки убраны из `S_TXCRC` (`:617-630`) и `S_MBGAP` (`:640-645`). `rq_rd` НЕ снимается односторонне — ack приезжает по своему `seq` (иначе получился бы полуоткрытый хэндшейк, тот же класс, что стоил нам GS и клавиатуры). Зеркало в исполняемой спеке `arm/divmmc_card.c:641-664, :723, :800-808`. 🥇 **Плюс закрыт режим Standard SPI 3.5 МГц, сломанный с B0142 (два дефекта):** стартовому импульсу `tx`/`rx` возвращён медленный гейт (`usd_bulb.v:63,65` — до правки движок не выдавал НИ ОДНОГО фронта `ck`), а модель карты переведена с выборки по УРОВНЮ `sck` на выборку по ФРОНТУ (`divmmc_card.v:265-266, 362-363`, режим 0 SPI; в Turbo поток байт-в-байт прежний). Форсаж Turbo из v383 снят (`loader_main.c`, `machine_cfg_word`) — выбор владельца снова действует. **ДОКАЗАТЕЛЬСТВА (сценарии-регрессии, падавшие ДО и проходящие ПОСЛЕ):** хостовой стенд `divmmc_card_host_test.c:212-254, :568-700` — было 10 отказов, стало 0; RTL-стенд `sources/tb_divmmc_stop.sv` (29 проверок) — было 10 отказов, стало ALL PASS, причём сценарий B воспроизвёл ПОБАЙТНО снимок с платы (стоп на LBA 2049, `last_cmd = 18`, ответа нет); `sources/tb_usd_bulb_speed.v` — turbo=0 было «ckedges 0, cmds 0», стало R1 = 01; DPI-сверка RTL против исполняемой спеки на пути esxDOS — 1 043 776 байт, расхождений 0 (она же поймала первую версию правки спеки: модель отвечала на байт раньше железа). 🥇 **Старый стенд эту дыру не видел, потому что ЗАКРЕПЛЯЛ ДЕФЕКТ КАК ТРЕБОВАНИЕ:** `tb_divmmc_card.sv` сам дотактовывал 408 байт «остатка блока» и лишь потом ждал R1 — проверка снята (`:121, :525-533`). **На плате НЕ проверено:** сам Z-Player (нужны глаза владельца), регресс FATALL/Proteus/WDC/esxDOS после смены битового движка, режим Standard на настоящем Z80. Побочно в логе: порт `ce` у `divmmc_card` остался в интерфейсе без нагрузки (выборка больше не по уровню) — убрать при следующей правке модуля. |
| 2026-08-19 | Ядро **B0146** (`artifacts/ZX_CPLANE/bulb_zx_B0146.bit` 1 162 367 Б, `.bit.bin` 1 162 240 Б) + прошивка **v0.15.388** (`arm/loader.elf` 2 881 472 Б, образ `flash/BOOT_B0146_v388.BIN` 1 872 724 Б) | LUT **14863 / 17600 = 84.45 %**, FF 12258 (34.82 %), BRAM **58.5 / 60 = 97.50 %**, DSP 13; размещение с первой директивы `ExtraTimingOpt`; тайминг **закрыт**: setup WNS **+0.229 нс** (TNS 0), hold WHS **+0.017 нс** (THS 0), «All user specified timing constraints are met»; **0 ERROR**, ни одного настоящего `8-9873` (две строки в логе - это эхо комментариев самого `build.tcl`), новых `has no load` у портов нет (прежние: `memRf`/`vmmCe` у `mem_zx`, `ce`/`bufa_in[]` у `divmmc_card`). Лог `/tmp/b0146_atlas.log`. **НА КАРТУ НЕ ЗАЛИТО, плата не перезагружалась** - владелец в это время гонял на ней регресс B0145 | 🥇 **НАБОРЫ ПЗУ С НАСТОЯЩИХ ПЕНТАГОНОВ (FATALL, Proteus) «НЕ ГРУЗИЛИСЬ» ИЗ-ЗА ОДНОГО БИТА В ВЫБОРЕ СТРАНИЦЫ ПЗУ.** У Пентагона-1024 с 64-КБ BIOS блок ПЗУ адресуется **парой** `{A15,A14} = {~DOS, 7FFD[4]}` при порядке блоков `[сервис, TR-DOS, 128, 48]` - это доказано самими дампами пяти наборов с живых машин (`/tmp/romget/`: у всех пяти порядок страниц в файле совпал с формулой 4/4). Значит `{DOS=1, 7FFD[4]=0}` даёт **сервисную** страницу, и именно этим штатный BIOS входит в свой файловый менеджер: пункт меню → `0x2831` → стаб в ОЗУ `0x4000` (`F3 3E 10 01 FD 7F ED 79 …`) ставит 7FFD[4]=1 → `JP #3D30` → трап Beta Disk вставляет TR-DOS → `0x3D30 = C9 RET` → помощник `0x3FF0` в странице TR-DOS = `ED 79` (`OUT (#7FFD),A` при A=0) → бит4 падает при DOS=1 → окно уходит на менеджера, где по `0x3FF0` стоит поле из 12 нулей, а `0x3FFC` = `DI; JP <вход>`. У нас `atlas_core/memory.v` при взведённой защёлке отдавал страницу 2 **безусловно**, поэтому машина исполняла третий байт помощника (`C9`) и делала RET по чужому стеку - со стороны «поднялось 128-меню, менеджер не открывается». **Правка (одна строка + один вход):** `memory.v:228` `romPage = trdos ? {1'b1, dos_svc_en & ~rom48} : …`; `rom48` уже учитывает модель, поэтому 48К не меняется вообще, а при `dos_svc_en = 0` выражение сворачивается в `2'd2` - **бит-в-бит B0145**. Цена - один терм в `romPage[0]`, `romPage[1]` не тронут (конус `memA` тесный). **⚠ Сделано ОПЦИЕЙ, а не молча** (правило «спорное - в переключатель»): у двухстраничных наборов и у заводского `rom128.hex` слота 3 нет вовсе, и тот же сброс 7FFD[4] увёл бы окно в незаписанную BRAM - поле `0x00` = NOP-склон вместо машины. Новый бит **MACHINE_CFG 25** (свободен по счёту: в топе слово разбирается только в строках 295-302, 319, 325, 328, 337-342 - заняты 0-4 в `axi_ctl`, 5/6 у NES, 8-24 и 26 у нас; 27..31 сознательно оставлены целым диапазоном под будущие поля). CDC - свой двухтриггерный конвейер `dossvc_s` (`bulbulator_zx_ddr_top.v:290,303,316`), подключение внутри `ifndef MISTER48_CORE`/`ifndef HYBRID_CORE` (`:1483`); у гибрида новый вход прибит в ноль (`hybrid_zx_core.sv:126`) тем же приёмом, что `svc_nmi_en` - висящий вход пустил бы X в номер страницы. **Прошивка v0.15.388:** пункт машины `SVC PAGE UNDER TR-DOS` (OFF / AUTO / **ON**), `opt_items[77]` (добавлен В КОНЕЦ, сторож `MENU_IX_EXPECT` заодно закрыт на хвосте 73..77 - раньше он не проверял вовсе), строки в меню Пентагона и в подменю ROM, per-machine ключ ini `<тег>.dossvc`, поле `mach_params.dossvc` (дефолт задан ИМЕНОВАННО `.dossvc = 1` - позиционные инициализаторы `g_mp[]` до него не доходят), `apply_dossvc` (сброс машины: меняется карта ПЗУ под живым PC), бит ставится в `machine_cfg_word` только при `g_trdos_ok && g_svc_ok` (тот же сторож, что у битов 9 и 13) и гасится вместе с ними при DivMMC. **Дефолт AUTO обоснован признаком МЕХАНИЗМА, а не именем программы:** `rom_load_set` замеряет в слоте 3 поле из 12 нулей `0x3FF0..0x3FFB` и вход `0x3FFC = F3 C3` (`g_svc_entry`), а он есть ровно у FATALL и Proteus; у Gluk/PGCLASSC/двухстраничных наборов и у заводского ПЗУ там `FF` или страницы 3 нет - значит на всём прежнем содержимом карты поведение остаётся прежним, а наборы с настоящих пентагонов начинают работать сами. **Проверка на плате (ещё НЕ делалась):** `MACH_DBG 0x43C00150` - при `[13]=1` (DOS) и упавшем бите 10 (7FFD[4]) поле `[23:22]` обязано стать **3** (было 2). Проверять НЕЛЬЗЯ при включённом DivMMC: `memory.v` `trdos_en_eff = trdos_en & ~mapper` гасит трап, а слот 2 занят `ESXMMC.ROM`. **Побочно найдено (НЕ мною сломано, НЕ правил):** цели `MISTER48_CORE` и `HYBRID_CORE` не синтезируются с работ по Z-Controller/DivMMC - в топе связи `.zc_en`, `.zc_turbo`, `.dm_opt`, `.dm_pagein_off` (`:1511-1515`) стоят ВНЕ `ifndef`, а у `mister48_core`/`hybrid_zx_core` таких портов нет: `ERROR: [Synth 8-11365] … named port connection 'zc_en' does not exist` (логи `/tmp/b0146_mister48.log`, `/tmp/b0146_hybrid.log`). Новый бит до этих целей не доходит по построению (у них `ROM_PAGES=2` и своя память; `mister48_core` модуль `memory` вообще не инстанцирует), но сама сборка обеих ветвей сломана и это отдельный пункт бэклога. |
| 2026-08-19 | Ядро **B0146** без изменений (`artifacts/ZX_CPLANE/bulb_zx_B0146.bit.bin`) + прошивка **v0.15.389** (`arm/loader.elf` 2 880 860 Б, образ `flash/BOOT_B0146_v389.BIN` 1 872 724 Б) | Только ARM, ядро НЕ пересобиралось (числа сборки — строка B0146 выше). `BUILD_OK`, в образе есть `v0.15.389`, `SVC PAGE UNDER TR-DOS`, `SD CARD: DIVMMC / Z-DISK`. Сторож меню теперь проходит все 76 проверенных индексов из 78 без расхождений (скрипт-сверка ярлыков). НА ПЛАТУ НЕ ЗАЛИВАЛОСЬ. | 🥇 **СОСТЯЗАТЕЛЬНОЕ РЕВЬЮ B0146/v388 — пять правок, все в прошивке.** (1) 🥇 **Подсказки пунктов меню и отказы `apply_*` с v0.15.369 НЕ РИСОВАЛИСЬ ВООБЩЕ.** v369 добавил в пять рисовальщиков строки 22 общий запрет `g_modal_level || g_menu_open` — чтобы фоновые маляры не лезли под открытый диалог, — и заодно погасил два переднеплановых: `dn_status_msg` (все `vwhy` механизма v0.15.334, «ENTER = APPLY» и КАЖДЫЙ отказ `apply_*`, потому что Enter жмут внутри выпадашки) и `dn_draw_status`, которым меню возвращает строке обычное содержимое. То есть требование владельца «опция обязана говорить, КОГДА её трогать» с v369 на экран не попадало ни разу, а новый пункт `SVC PAGE UNDER TR-DOS` уехал бы туда же. Из `dn_status_msg` условие `g_menu_open` снято (это НЕ периодический маляр), у `dn_draw_status` добавлен обход `g_status_force`, который ставит сам движок меню в двух своих местах. (2) **Сторож `MENU_IX_EXPECT` ломался на индексе 71 и хвост не проверял.** Ярлык `[71]` переименован в v353 в `SD CARD: DIVMMC / Z-DISK`, а в таблице ожиданий осталось `DIVMMC CARD`: сравнение строгое, цикл выходит по `break` — то есть на каждом старте висело ложное `!!! MENU INDEX DRIFT`, а дописанные в v388 проверки 72..77 не исполнялись НИ РАЗУ. Ярлык исправлен, теперь сверка доходит до конца. (3) **`apply_dossvc` переписывал выбор владельца на OFF.** У `apply_svcrom` такой откат безобиден (там OFF и есть дефолт), а у этого пункта дефолт AUTO: один Enter при `ROM SET = BUILT-IN` или на двухстраничном наборе оставлял в профиле `dossvc=0` навсегда, а «Save config» уносил нуль в ini — после чего FATALL/Proteus снова «не грузятся», причём молча (сообщение об отказе, см. пункт 1, тоже не рисовалось). Слово владельца теперь сохраняется, а безопасность держит то место, которое её и держало: бит25 поднимается в `machine_cfg_word` только при `g_trdos_ok && g_svc_ok`. Машина в этой ветке больше не сбрасывается — слово `MACHINE_CFG` от такой правки не меняется. (4) **Пометка пункта врала на ядре без DivMMC.** `note_dossvc`/`why_dossvc` смотрели на голый `opt_divmmc`, а трап гасит `machine_cfg_word` только при `opt_divmmc && opt_defmachine != 4 && (LOAD_CAPS_R & LOADCAP_DIVMMC)`: на MiSTer-48 с оставленной галкой пометка обещала «trap off» там, где трап жив и бит25 никто не гасил. Условие сведено к одному предикату `dossvc_dm_gates()`, порядок причин исправлен — сначала «набора нет». (5) `rom_msg_set("ROM: BUILT-IN (с карты)")` — UTF-8 кириллица в строке состояния при шрифте оболочки CP866, на экране каша; заменено на `ROM: BUILT-IN (FROM CARD)`. **Проверено чисто и подтверждено по коду/логу, а не по отчёту:** при `dos_svc_en = 0` выражение `romPage` сворачивается в `2'd2` (бит-в-бит B0145); `rom48 = model ? port7FFD[4] : 1'b1`, поэтому 48К не меняется; бит25 действительно свободен (счёт по `bulbulator_zx_ddr_top.v:295-348` = 8..24,26, `axi_ctl.v:244-248` = 0..4, у NES слово собирается заново); `opt_items` = 78 элементов, все ссылки `&opt_items[N]` из всех меню бьются с ярлыками; отпечаток входа менеджера (12 нулей `0x3FF0` + `F3 C3` по `0x3FFC`) независимо проверен по пяти дампам `/tmp/romget/` — есть ровно у `PGFATALL`/`PGPROTEU`, страница 0 файла уезжает в слот 3 у всех пяти; лог `/tmp/b0146_atlas.log`: LUT 14863/17600, BRAM 58.5/60, WNS +0.229 / WHS +0.017, 0 CRITICAL WARNING, набор предупреждений `has no load` **побайтно совпадает** с B0145 (новых висящих цепей нет). |
| 2026-08-19 | Ядро **B0147** (`bulb_zx_B0147.bit` 1 206 519 Б, `.bit.bin` 1 206 400 Б) + прошивка **v0.15.389**, образ `flash/BOOT_B0147_v389.BIN` 1 916 884 Б | LUT **14878 / 17600 = 84.53 %**, BRAM 58.5 / 60, тайминг **закрыт** («All user specified timing constraints are met»), 0 ERROR, ни одного `8-9873`. Залито, `POST VERSION = 0xB01B0147`. Откаты `0:/BOOTV387.BAK`, `0:/CORES/ATLAS145.BAK` | 🏁 **ШТАТНЫЕ ПЗУ НАСТОЯЩИХ ПЕНТАГОНОВ РАБОТАЮТ: FATALL и Proteus запускаются ИЗ ПЗУ и видят карту.** Проверено мной на плате без владельца, двумя способами и с повторами. **FATALL (`PGFATALL.ROM`)**: 128-меню → пункт «Fatall 0.25» → Enter → менеджер рисует обе панели, слева `A:TR-DOS` («Disk error» — дискеты нет), справа **`E:ZC SDC:FAT32` со содержимым нашего тома** (BIN, GAMES, MUSIC, PLAYERS, SYS, TMP, TRD). Два прогона из двух — воспроизводимо. **Proteus (`PGPROTEU.ROM`)**: тот же путь → диалог «Select drive» с A:FDD…D:FDD и **`E:sd6,0 (1:FAT32)`**. Экраны снимались зеркалом `0x40008000` и рендерились в PNG (`tools/zxscr.py`) — то есть смотрел ГЛАЗАМИ, а не текстовой сверкой по шрифту: у менеджеров свои шрифты, и текстовое чтение там слепо. 🥇 **ПРИБОР, без которого разбор стоял: липкие счётчики трапа Beta Disk в новом регистре `0x1BC ROM_DBG` = {взводов[31:24], снятий[23:16], адрес последнего взвода[15:0]} плюс липкий бит12 в `MACH_DBG` («слот 3 хоть раз стоял в окне»).** Мгновенный `DOS` (бит13) на вопрос «взводился ли трап» не отвечает: защёлка уходит на первом же M1 за окном ПЗУ, а софт из ОЗУ такой M1 делает сразу, поэтому опрос почти всегда попадает ПОСЛЕ снятия — на этом два моих опыта дали противоречащие выводы. Прибор сразу показал `взводов=39, снятий=39, адрес=0x3D2F, слот3 был=1`, то есть пара {DOS, 7FFD[4]} из B0146 работает, а машина просто ушла дальше. Счётчики НАСЫЩАЮТСЯ на 255. Тракт: `memory.v` → `main.v` → топ → `control_plane.v` (два триггера CDC) → `axi_ctl.v` (`IDX_ROMDBG = 7'h6F`). 🥇 **Метод, который закрыл задачу: воспроизвести отказ СВОИМ кодом на Z80 по JTAG.** Инжектом (`CONTROL=4` → `HALT` → `RAMADDR/RAMDATA` в банк 2 → `DIR0..DIR6` → `CONTROL=0`) я исполнил точную копию стаба BIOS (`OUT #7FFD,#10; XOR A; LD HL,#3FF0; PUSH HL; JP #3D30`) и получил БИТ-В-БИТ то же состояние, что при нажатии Enter в меню (`romPage=1, DOS=0, 7FFD=0x10`) — то есть управляемый эксперимент вместо гадания по одному нажатию. Первая версия теста возвращалась в ОЗУ и тем самым САМА снимала защёлку — из-за этого дала ложный вывод; урок: проверять пару {DOS, 7FFD[4]} можно только кодом, который остаётся В ОКНЕ ПЗУ. **Что оказалось причиной «чёрных экранов» владельца:** вход в менеджер (B0146, пара защёлок) плюс формат тома. Пока служба носителя монтировала том по настройкам DivMMC (FAT16), FATALL 0.25 из ПЗУ вис на «Поиск первого свободного кластера»; после правки службы (v0.15.386, `dm_media_open`) том поднимается FAT32 по настройке Z-Controller, и менеджер читает каталог. **Опровергнуто, копать не надо:** «трап опаздывает на такт и первый байт берётся из 48 BASIC» — защёлка успевает в том же цикле выборки (прибор: 39 взводов при живом TR-DOS), и вход по 0x3D2F работает; «старт прямо со слота 3» (`ROM BOOT SLOT = SLOT 3`) как обход НЕ годится в принципе — экран пуст целиком (0 ненулевых байт из 6912), менеджер рассчитан на вызов из поднявшегося 128-меню, своего обработчика прерываний у этой страницы нет. **Открыто:** ветви `MISTER48_CORE` и `HYBRID_CORE` не синтезируются с 14.08 (порты `.zc_en`, `.zc_turbo`, `.dm_opt`, `.dm_pagein_off` в топе стоят ВНЕ `ifndef`, а у этих ядер таких портов нет) — на карте лежит ядро MiSTer-48, отставшее на девять сборок. |
| 2026-08-20 | Прошивка **v0.15.391** (счётчики команд GS + фильтр опроса #60..#6F) и **v0.15.392** (выключатель трассы, умолчание ВЫКЛ); ядро прежнее **B0147** | образы `flash/BOOT_B0147_v391.BIN` и `BOOT_B0147_v392.BIN` по 1 916 884 Б, залито поверх `0:/BOOT.BIN` со сверкой листингом, `POST VERSION = 0xB01B0147` | 🥇 **ПРИБОР САМ БЫЛ ТОРМОЗОМ: диагностическая трасса GS ломала Z-Player.** Жалоба владельца: плеер начинает трек и через доли секунды перескакивает на следующий, и так до последнего (тот играет нормально); плюс рвётся его интерфейс полосами. **Опровергнуто приборно:** залипшая клавиша (таблица зажатых пуста все 90 с, единственный код 0x15 — живое нажатие), джойстик (`JOY_STATE` = 0 всё время), мышь Kempston (выключена, `KMOUSE=0x00000080`, значение стабильно) — и главное, ОПЫТ ВЛАДЕЛЬЦА: отказ был при выключенной мыши и пропал тоже при выключенной, то есть мышь не переменная. Моя версия про конус джойстика на адресах мыши (`#FADF` имеет `a[5]=0`) осталась ВЕРНОЙ ПО МЕХАНИЗМУ, но этот отказ объясняет не она. **Настоящая причина:** каждое событие протокола GS писалось в НЕКЭШИРУЕМУЮ память мейлбокса (кольцо трассы + счётчик событий, две записи по сотни наносекунд), а фильтр опроса ловил только `#60..#64`, тогда как плеер зовёт и `#67..#69` — их ответы шли в кольцо. Эти записи стоят в горячем цикле эмуляции карты, то есть крадут время у наполнения звуковых квантов. Расширение фильтра до `#60..#6F` (v391) прекратило перескоки НЕМЕДЛЕННО — владелец подтвердил, что это случилось ДО того, как он тронул мышь. Лечение по построению (v392): трасса включается флагом `gs_trc_en` (`KMB+0x4408`), умолчание НОЛЬ — ни одной записи в мейлбокс из горячего цикла; включённый флаг обязан возвращать отказ, это и есть A/B. **Заодно намерено приборами:** плеер НЕ пользуется быстрым потоком (`#D1 Open Stream` ни разу, `#D2` дважды — закрытие без открытия), модуль льёт `#19`/`#1B` (2060 пар) и нетабличными `#EE`/`#FF` (по ~1025 раз, в официальном описании GS их нет — расширение NeoGS); всего 68 154 байта данных в карту и 31 535 байт ответов машине; `#31 Play module` один раз. Ещё одна мина, найденная на себе: **чтение регистра `0x180 GS_RQ` ИЗВЛЕКАЕТ байт из очереди** — мой прибор украл три байта и рассинхронизировал протокол («GS не найден»); в приборы этот регистр больше не брать. |
| 2026-08-20 | Прошивка **v0.15.393** (снимок данных GS под битом 1 того же флага; ядро прежнее **B0147**) | образ `flash/BOOT_B0147_v393.BIN` 1 916 884 Б, залито со сверкой листингом, `POST VERSION = 0xB01B0147` | 🏁 **Z-PLAYER ИГРАЕТ ТРЕК ДО КОНЦА - ПРИНЯТО ВЛАДЕЛЬЦЕМ 20.08: «сейчас доиграл трек до конца, слушаю следующий», то есть плейлист идёт штатно, по естественному окончанию песни. Причина обрыва треков доказана ЗАВИСИМОСТЬЮ ОТ ДОЗЫ: виновата была диагностическая трасса GS.** v390 и раньше (трасса включена, фильтр опроса `#60..#64`) - обрыв через доли секунды; v391 (трасса включена, фильтр расширен до `#60..#6F`) - «играет намного дольше»; v392/v393 (трасса ВЫКЛЮЧЕНА по умолчанию) - трек проходит целиком. Механизм: каждое событие протокола писалось в НЕКЭШИРУЕМУЮ память мейлбокса (кольцо + счётчик, две записи по сотни наносекунд) прямо в горячем цикле эмуляции карты, который наполняет звуковые кванты; плеер опрашивает анализатор сотни раз в секунду, и на этом карта голодала. **Приборно после лечения:** позиция в песне идёт ровно (~4 с на позицию, 43 позиции ≈ 170 с), удержаний прерываний 0, худший разрыв 520 виртуальных тактов, пики звука 0x0D..0x33, простой процессора из-за карты 0 тактов за 3 с. 🥇 **Опровергнуто по дороге, копать не надо:** залипшая клавиша (таблица зажатых пуста), джойстик (`JOY_STATE`=0), мышь Kempston (отказ был и пропал при ОДНОМ и том же выключенном состоянии мыши - владелец проверил сам), потеря модуля при заливке (снимок 68 154 байт разобран по формату: модуль `2-3song6`, 43 позиции, 22 паттерна, 6 сэмплов, по заголовку обязан быть 55 466 Б - принято 57 334 Б, то есть ЦЕЛИКОМ), и «побайтная заливка `#19`/`#1B` как узкое место» (это донастройка, а модуль идёт пачками `#EE`/`#FF`). 🥇 **Две мины в своих же приборах:** чтение `0x180 GS_RQ` ИЗВЛЕКАЕТ байт из очереди (украл три байта, получил «GS не найден»); и слово позиции `gs_ram4(0x415A)` надо разбирать по байтам (`0x415A` строка 0..63, `0x415B` позиция в песне) - я сложил два байта в одно число и получил три ложных «смены трека» через ровные 45 с. **Открыто:** нетабличные команды `#EE` (отдаёт ~11 байт состояния) и `#FF` - в официальном описании GS их нет, что мы на них отвечаем, не выверено. |
| 2026-08-20 | Прошивка **v0.15.394** (ядро прежнее **B0147**) | образ `flash/BOOT_B0147_v394.BIN` 1 916 884 Б, залито со сверкой листингом, `POST VERSION = 0xB01B0147`; проверено мной инжектом клавиши и чтением канвы оболочки, затем **ПРИНЯТО ВЛАДЕЛЬЦЕМ** («ф11 теперь и генерал саунд ребутит») | 🥇 **ДВЕ КЛАВИШИ СБРОСА, И РАЗНИЦА МЕЖДУ НИМИ ТЕПЕРЬ ЧЕСТНАЯ (просьба владельца).** F11 = «железная кнопка»: фабрика сбрасывает машину с очисткой ОЗУ (`hard_combo = f11_h`), а прошивка добивает то, до чего фабрика не достаёт - ВИРТУАЛЬНЫЕ приборы: карта General Sound перезапускается штатным `gs_boot()` + `gs_meter_reset()`. До этого карта переживала F11 со своим прежним состоянием, а её драйвер в машине начинал с нуля - расхождение, которое выглядело как «GS не найден» или как молчащая музыка. Ctrl+Alt+Del = «мягкая»: фабрика даёт короткий сброс с СОХРАНЕНИЕМ ОЗУ (`soft_combo = ctrl&alt&del`), виртуальные приборы прошивка НЕ трогает намеренно - в этом и смысл аккорда. Разделение уже было в ЖЕЛЕЗЕ (обе комбинации декодирует фабрика по отдельным условиям), не хватало только прошивочной половины - RTL не тронут. Сделано СЛУЖБОЙ главного цикла (`hard_reset_service`), а не обработчиком клавиши: `gs_boot()` читает ПЗУ карты с SD, а `kbd_note` зовут из любого контекста, включая ожидание клавиши внутри модального окна (то же правило, по которому том DivMMC пересобирает служба, а не обработчик команды мейлбокса). Приборная проверка без владельца: `g_gs_live = 1`, инжект F11 командой мейлбокса 11, флаг `g_hard_rst_req` снят службой, на канве оболочки прочитано её сообщение «F11: GENERAL SOUND RESTARTED WITH THE MACHINE». **Открыто:** добавить в F11 перепрограммирование SD-карты (DivMMC/Z-Controller) и переоткрытие образа NEMO-IDE - решение владельца, потому что это стирает ОЗУ карты и заставляет esxDOS инициализироваться заново. |
| 2026-08-20 | Прошивка **v0.15.395 → v0.15.396** (ядро прежнее **B0147**) | образы `flash/BOOT_B0147_v395.BIN` и `BOOT_B0147_v396.BIN` по 1 916 884 Б, залито со сверкой листингом, `POST VERSION = 0xB01B0147`; сторож `tools/audit_tv_dialogs.py` — все диалоги влезают; **ПРИНЯТО ВЛАДЕЛЬЦЕМ** («теперь всё хорошо») | 🥇 **ДЕРЕВО КАТАЛОГОВ НЕ ДОРИСОВЫВАЛОСЬ ДО КОНЦА — ЭТО БЫЛ МОЛЧАЛИВЫЙ ПРЕДЕЛ КЭША, А НЕ ОТРИСОВКА.** Жалоба владельца: «сканирование проходит, дерево показано полностью раскрытым, но не выводится целиком». В коде: дерево сканировалось РЕКУРСИВНО и целиком в массив `TREE_MAX = 128` (`tv_ui.c`), каталогов на карте больше — сканер добирал до предела и МОЛЧА останавливался. Плюс он платил окном ожидания при каждом открытии и тащил кэш со счётчиком мутаций ФС. **Решение владельца («не сканировать заранее, а сделать навигацию»), сделано в два шага:** v395 — чтение только текущего уровня (как файловый режим этого же диалога делал всегда); v396 — по просьбе владельца полноценное ДЕРЕВО С ЛЕНИВЫМ РАСКРЫТИЕМ: **вправо** раскрывает ветку и читает её каталог ИМЕННО В ЭТОТ МОМЕНТ, **влево** сворачивает; на раскрытом вправо — к первому ребёнку, на свёрнутом влево — к родителю; Enter/пробел берут подсвеченную папку. Метки ветки `+` / `-` / пробел («детей нет, уже смотрели»), настоящие линии дерева по признаку `is_last` предков. Предела на дерево больше нет — в памяти живёт только раскрытое; остался предел на число раскрытых узлов (512) и он **НЕ МОЛЧИТ** (строка «tree limit reached» под списком). 🥇 Полный путь хранится У КАЖДОГО узла намеренно: индексы родителей уехали бы при сдвиге массива на вставке/удалении ветки — классический источник тихих дефектов. Удалены как мёртвые: рекурсивный сканер, окно прогресса сканирования, кэш дерева (счётчик мутаций ФС оставлен — он машино-агностичный признак «на карте что-то изменилось»). **Честный компромисс:** «есть ли внутри подпапки» узнаётся только при раскрытии, поэтому у нераскрытых ветвей стоит `+` даже если внутри пусто — иначе пришлось бы заранее заглядывать в каждый каталог, то есть вернуть скан. |
| 2026-08-20 | Ядро **B0148** во ВСЕХ ТРЁХ ветвях: Atlas (`bulb_zx_B0148.bit` 1 173 503 Б), MiSTer-48 (`mister48_b0148.bit` 1 161 539 Б), гибрид (1 163 275 Б); прошивка прежняя **v0.15.396**, образ `flash/BOOT_B0148_v396.BIN` 1 883 860 Б | Atlas: LUT **14870 / 17600 = 84.49 %**, тайминг закрыт, 0 ERROR. MiSTer-48: LUT **11189 (63.57 %)**, тайминг закрыт, 0 ERROR. Гибрид: LUT **15822 (89.90 %)**, тайминг закрыт, 0 ERROR. Залито на карту: `0:/BOOT.BIN`, `0:/CORES/ATLAS.BIT.BIN` и **`0:/CORES/MISTER48.BIT.BIN`** (там лежало ядро, отставшее на девять сборок), всё через временные файлы со сверкой ЛИСТИНГОМ каталога; откаты `0:/BOOTV396.BAK`, `0:/CORES/ATLAS147.BAK`. `POST VERSION = 0xB01B0148` | 🥇 **ВЕТВИ MISTER48_CORE И HYBRID_CORE НЕ СИНТЕЗИРОВАЛИСЬ С 14.08, И ПАДАЛИ МОЛЧА.** Связи `.zc_en`, `.zc_turbo`, `.dm_opt`, `.dm_pagein_off` работами по Z-Controller/DivMMC (B0132/B0138/B0143) добавили в общий топ ВНЕ условной компиляции, а таких портов у этих ядер нет: `ERROR: [Synth 8-11365] named port connection does not exist` по 7 ошибок на ветвь. Собирали только Atlas, поэтому шесть дней никто не знал, а на карте лежало ядро MiSTer-48 девятисборочной давности - и любое переключение машины в меню его поднимало. Связи убраны под тот же `ifndef`, под которым живёт всё остальное про карту; в коде оставлено объяснение. **Это ТРЕТИЙ случай мины «правка общего верхнего модуля касается всех машин» за два дня** (первые два - порт `#57` и адреса мыши в конусе джойстика), и первый, который бьёт по СБОРКЕ, а не по поведению. Правило: правку общего топа проверять сборкой ВСЕХ ветвей, а не той, что тестируешь. |
| 2026-08-20 | Прошивка **v0.15.397 → v0.15.404** (ядро прежнее **B0148**), образы `flash/BOOT_B0148_v397..v404.BIN` по 1 883 860 Б | На карте `0:/BOOT.BIN` = v404, резервы `BOOTV397/399/400/402/403.BAK`; `POST VERSION = 0xB01B0148`; сторожа `tools/audit_boxes.py` (все окна на каркасе) и `tools/audit_tv_dialogs.py`; приборные прогоны с хоста (инжект клавиш + чтение канвы оболочки). **ПРИНЯТО ВЛАДЕЛЬЦЕМ** («ну вроде как всё ок») | 🥇 **КАРКАС ОКОН ПРИВЕДЁН К ОДНОМУ ПРАВИЛУ.** Требование владельца: «поведение всего фреймворка должно быть всегда правильным, как в турбовижн, чтобы не надо было каждый раз для каждого меню что-то индивидуальное писать». **Фон под окнами — СТЕК** (`box_push`/`box_pop`) вместо трёх слотов `g_bs[0..2]`, расписанных по договорённости: те же номера брали себе диалоги (`[1]` — выбор машины, набор ПЗУ, редактор чувствительности и ВСЕ окна на `dlg_open(&d, 1, …)`; `[0]` — окна tv_ui, сообщения, прогресс, сортировка), и окно поверх подменю затирало его сохранённый фон. Одним механизмом объяснились ТРИ жалобы: «подменю не стёрлось, осталось артефактом»; «закрываю настройки дискового контроллера — выпадаю из меню» (обходом было ЗАКРЫТЬ меню — в коде стояли два `g_menu_close = 1` с комментарием «слот 1 был занят модальным окном над подменю»); старые обрывки настроек от визарда маппинга (лечили выдачей ему отдельного слота). Добавлено САМОИСЦЕЛЕНИЕ: в навигаторе без меню и окон стек обязан быть пуст, непустой чинится и попадает в счётчик (`g_bst_leak`, `g_bst_over`, `g_bst_under`). **Escape из окна = на один уровень назад**, включая ВЛОЖЕННОЕ подменю (Options → Disk controllers): условие — признак каркаса (`g_modal_seq`, счётчик показов в `dn_win_draw`), СПИСКИ команд убраны (в v398 список был, и это была та же неединообразность). **Все пункты-выборы ведут себя как RAM size** (стрелки, звёздочка, Enter) — правило в движке, 38 выборов; 17 диапазонов намеренно ЖИВЫЕ (владелец: «положение на экране, затемнение должны быть вживую»). **Tab по СЕКЦИЯМ** (просьба владельца): границы из разметки окна — подпись-заголовок, смена типа, другая радиогруппа; в радиосекцию Tab встаёт на ВЫБРАННУЮ кнопку (как Win32/Qt), `Enter` = кнопка по умолчанию откуда угодно, `End`/`Home`. Разбор традиций: TurboVision (кластер = одна остановка) и современные движки (ARIA composite widget + roving tabindex, Win32 WS_GROUP) согласны; **регресс приехал с новым декларативным каркасом** — `TV_Dialog` объявлял своей группой КАЖДУЮ галочку (`2000+n`) и КАЖДОЕ поле (`4000+n`), а рукописные `Dlg`-окна были правы изначально (`FOC_RADIO` = одна остановка). Окно копирования — ПОСЛЕДНЕЕ исключение: не сохраняло фон и закрывалось полной перерисовкой канвы, отсюда «окно исчезло, а прогрессбар бежал» ЧЕРЕЗ РАЗ (между перерисовкой и открытием прогресса на экране нет ни одного окна); причина исключения устарела с v0.15.231 (буфер накрывает всю канву). Имя машины в шапке теперь несёт РЕАЛЬНЫЙ объём ОЗУ. 💣 **Мина, оплаченная незагружающейся платой: буфер мейлбокса `0x0F900000` ОБЩИЙ с файловой службой прошивки.** `dow` образа шёл 12 минут, команда записи ждала свободного интерфейса ещё 34 попытки (владелец работал в меню), и прошивка успела прочитать в тот же буфер набор ПЗУ — на карту лёг образ правильного размера с испорченными первыми 65536 байтами (начало `f3 c3 48 01` = `DI : JP`, код Z80), при `done=1` и полном `n`. BootROM образ не принял: плата не грузится И не отдаёт доступ к памяти по JTAG (ядра `Running`, `mrd` не работает даже по SLCR; `rst -por` на Zynq-7000 недоступен) — вылечилось только кардридером. Заливщик `tools/put_retry.tcl` переписан: сверка буфера по точкам (включая НАЧАЛО) перед КАЖДОЙ попыткой + чтение файла с карты ОБРАТНО (cmd 12) после записи. Опровергнуто по дороге: «кончилось место» (свободно 48 ГБ), «зависла прошивка» (это мой же JTAG-`stop` без `con`), «виноват новый стек фонов» (все счётчики на плате нулевые). Отдельно найдено и НЕ лечено без разрешения владельца: `fsck` показывает дефект каталога `/NES/Hacks` («записи за концом каталога»), к загрузке не относится. |
| 2026-08-21 | Прошивка **v0.15.405 → v0.15.412** (ядро прежнее **B0148**) | На карте `0:/BOOT.BIN` = v411 (v412 собрана, ждёт заливки), резервы `BOOTV410.BAK`, `BOOTV409.BAK`; сторожа `audit_boxes.py`, `audit_dialogs.py`, `audit_tv_dialogs.py` — все проходят | 🏁 **ЗАПИСЬ НА КАРТУ ДОКАЗАНА НА ЖЕЛЕЗЕ (шаг 1 плана владельца).** Проверку выполнила САМА МАШИНА: инжектом по JTAG в неё загружена программа Z80 (`tools/../zcwrite.asm`, 191 Б, собрана pasmo), которая проходит настоящий вход в карту (CMD0, затем CMD55+ACMD41 до готовности) и выдаёт CMD24 — запись блока в сектор 8 через порты Z-Controller `#77`/`#57`. Приборы совпали по всей цепочке: `R1 = 0x00` на CMD24, счётчик команд карты 13 → 21, счётчик записей карты 0 → 1, прошивка обслужила ровно одну запись без ошибок (`g_dm_c_wr = 1`, `g_dm_c_werr = 0`). **Доказательство по файлу:** образ прочитан с карты обратно (cmd 12) и сверён с эталоном ПОСЕКТОРНО — изменился ТОЛЬКО сектор 8, в нём подпись `Z80-WROTE-SEC08.` и 496 байт заполнителя `0x5A`, остальные 127 секторов не тронуты. Тестовый образ был ПОДПИСАН посекторно намеренно: на однородной заливке «прочитал верно» не отличить от «прочитал старое». 🥇 **Дефект моей же v397, найденный по дороге: опция записи существовала ТОЛЬКО как переменная** (`opt_dmwrite = 1`, ни пункта меню, ни ключа ini) — то есть выключить запись было нечем, а компилятор свернул её в константу (в символах elf её нет вовсе). На плате был ВКЛЮЧЁН непроверенный путь записи. Заведена настоящая опция, умолчание OFF. 🥇 **Первый прогон программы дал ЛОЖНЫЙ УСПЕХ:** все ответы карты были `0x00`, и наивная проверка «не 0xFF» его бы приняла — у машины был выключен Z-Controller, и чтение порта `#57` провалилось в КОНУС ДЖОЙСТИКА Kempston (`a[5]=0`), а тот отдаёт нули. Живая иллюстрация к необходимости опции `KEMPSTON DECODE`. 🥇 **Мина в моём инструменте: `mrd -bin -file` считает СЛОВА, а не байты** — дамп ini оказался в четыре раза длиннее файла, и за его концом в буфере лежали строки с `=`; я чуть не записал владельцу конфиг, частично собранный из мусора. Поймано до записи: обрезка по полю `n`, сохранение структуры файла (`#`, `[browser]` — парсер прошивки их пропускает, строка 9127), сверка числа ключей (263 → 264). **По просьбам владельца в этих же версиях:** разрешение записи РАЗДЕЛЕНО по контроллерам и живёт ВНУТРИ окна своего контроллера (галочка «Allow writes», у дисковода ещё и горячая `W`), а в меню осталось только видимое СОСТОЯНИЕ справа (`OFF` / `R/O` / `NO IMG` / `HDF R/O` / `DIR R/O` / `IMG R/W`) — механизм каркасный (`st_txt` у любого пункта меню), метка-галочка слева убрана как дублирующая состояние; состояние подключено также к `Machine` (машина и её объём ОЗУ), `Play` (PLAYING/PAUSED) и `Tape` (LOADING), для чего отрисовка строки меню переделана: правый край делится, треугольник подменю и подпись клавиши больше не вытесняют состояние; в окнах карты и винчестера в подписи и фильтре появились `.HDF` и `.IMG` (принимать HDF прошивка умела с v397, врал именно интерфейс); разделители в меню дисковых контроллеров убраны — «невидимая логика в интерфейсе не считается». **Карта убрана:** удалены 24 файла (мои временные + 21 устаревшая резервная прошивка, ~40 МБ) и 19 испытательных образов HDF (~1.28 ГБ); `OLEG32.HDF` сохранён — он настроен у машины Пентагон (`pent1024.idefile`). **Открыто:** независимость записи двух транспортов карты требует гейта в RTL (одна модель карты, активный транспорт прошивке не сообщается) и пересборки всех трёх ветвей; запись в NEMO-IDE отсутствует в ФАБРИКЕ (запись машины в регистр данных только двигает указатель, `sbuf` пишет только ARM) и в прошивке (обслуживаются `0xEC`, `0x20/0x21`, `0x90`, прочее — честный отказ ATA). |
| 2026-08-21 | Ядро **B0149** (Atlas/MiSTer-48/гибрид) + прошивка **v0.15.413 → v0.15.416**, образ `flash/BOOT_B0149_v416.BIN` 1 844 500 Б | На карте `0:/BOOT.BIN` = v416, откат `BOOTV414.BAK`; `0:/CORES/ATLAS.BIT.BIN` = B0149 (1 117 600 Б), откат `ATLAS148.BAK`; MiSTer-48 на карте ещё B0148 (bin B0149 готов локально). POST VERSION = 0xB01B0149, FIFO_OVERFLOW=0, строка `v0.15.416` в памяти прошивки. LUT Atlas 84.54 %, MiSTer-48 63.57 %, гибрид 89.88 %, тайминг закрыт, 0 ERROR, нет 8-9873 на модулях | **WRITE TRACK** больше не заглушка: команда 0xF идёт тем же путём, что запись секторов, с флагом `format` (нули с первого сектора до конца дорожки). 🥇 При возобновлении сессии найдено: ARM отбрасывал эти сектора, потому что запись в файл требовала `g_push_lba == lba_w` (LBA только что читали). FORMAT не читает сектор заранее — каталог остался бы цел, а команда бы «успешно» закончилась. Сторож чужого хвоста уже был (накладка только `[cpu_min..cpu_max]` на свежее чтение файла); запрет снят в v416. Файл образа не удаляется и не усекается. Окно BDI из F9 — поле пути на каждую букву + дерево; Enter на кнопке дерева открывает дерево. |
| 2026-08-21 | Прошивка **v0.15.423** (ядро прежнее **B0149**), образ `flash/BOOT_B0149_v423.BIN` 1 844 500 Б | На карте `0:/BOOT.BIN` = v423, откат `BOOTV422.BAK`; `POST VERSION = 0xB01B0149`, `FIFO_OVERFLOW=0`, строка `v0.15.423` @ `0x189184` | 🥇 **`.mkdir` 36 с после очереди 422: ACK раз за цикл ПОСЛЕ `gs_service`.** esxDOS пишет сектор, ждёт WRACK, пишет следующий — в FPGA пачка не копится, очередь бесполезна. Насос держат, пока карта просит, плюс 20 мс после последнего запроса (`dmmc_drain` до GS и в `bg_pump`). Порог сброса очереди на SD 5 мс → 100 мс: иначе `f_write` попадал между секторами кластера. **ВЛАДЕЛЕЦ 21.08 ВЕЧЕР: всё равно долго.** Не закрыто. Продолжение — HANDOVER §0.0 (сначала прибор, не следующая догадка). |
| 2026-08-22 | Прошивки **v0.15.424 → v0.15.427**, ядро **B0150** (три ветви в сборке; `divmmc_card.v` + версии) | Стенд `tb_divmmc_card.sv` (RTL против C-эталона через DPI, режимы SPEC и FAST): 1 056 996 обменов, 1 043 787 сверенных байт, **0 расхождений**; `divmmc_card_host_test.c`: 0 отказов; новый бенч `arm/esx_loop_bench.c`: **SPEC = 12 807 чтений/сектор, FAST = 7** | 🥇 **`.mkdir` 35 с — ПРИЧИНА В САМОМ esxDOS, НАЙДЕНА ПРИБОРОМ, ЛЕЧЕНИЕ — ОПЦИЯ КАРТЫ.** Задача владельца: «все виртуальные диски максимально быстро во всех режимах». Ход: сначала факты — кластер образа `DIVMMC.IMG` **1 сектор** (BPB через мейлбокс; MBR → раздел с 2048) — гипотезы «кластер шире очереди 96» и «десятки нулей на кластер» отпали; разность за один `.mkdir`: записей **+264**, чтений **+23**; кольцо провалов: ритм «FS 20 023 мкс каждые 134 мс» (linger насоса + круг GS), 264 × 134 = 35,4 с. **v424** (poke карты внутри расчёта звука) и **v425** (linger убран; приборы `g_dm_gap_*` пауза esxDOS между секторами, `g_dm_where` кто обслужил, `g_dm_drain_max`) — 35 с без изменений: средняя пауза 128,7 мс при минимуме 4,1; drain 288 из 310, poke 22. **v426** (гистограмма пауз, poke на каждом сэмпле) — снова 35 с, но гистограмма ответила: **263 из 310 пауз в окне 128–256 мс, между 8 и 128 — ничего** = фиксированный таймаут esxDOS, не наша реакция. **Дизассемблер `ESXMMC.ROM` (esxDOS 0.8.9):** запись `1E6D`, ожидание занятости `1EC2: CALL 1E55 / OR A / JR Z`, где `1E55` = `LD BC,#0032 / IN A,(#EB) / CP #FF / RET NZ / DJNZ / DEC C / JR NZ` — «первый байт ≠ FF, иначе 12 800 чтений». По спеке SD после занятости идёт только `0xFF` → цикл ВСЕГДА до таймаута: 12 800 × 36 тактов = **132 мс/сектор**; `.mkdir` обнуляет **256 секторов подряд** (LBA 24865… сплошным блоком) → 35 с; файл = 2–3 сектора = 0,4 с — «быстро». Наводка владельца «файл быстро, mkdir медленно» была ключом. На настоящем DivMMC с 0.8.9 — тот же таймаут. **Лечение (B0150):** `DMMC_CTL[15] = cfg_fast` → в `S_BUSY` четвёртый байт занятости **`0x01`** вместо `0x00` (esxDOS выходит на 5-м чтении; KOE «ждать ≠0» и NedoOS «ждать ≠FF» принимают). Отход от буквы спеки → **опция** в окне DivMMC «Fast write ack (esxDOS; off = strict SD spec)», `opt_dmfast`, ini `dmfast`, умолчание ВКЛ, применение через `apply_cardwr` (карта заново). 🥇 **Стенд поймал мою ошибку до железа:** `nxt_byte` — байт СЛЕДУЮЩЕГО обмена, `0x01` уходил пятым; исправлено (`wcnt == 2`), первую сборку Atlas перезапустил. **Мины среды:** `xsc` 2023.1 не линкует системный `libm` (`.relr.dyn`) — DPI собирать системным gcc в `xsim.dir/work/xsc/dpi.so`; `xelab -svlog tb` трактует топ как ФАЙЛ; хост-тесту карты нужен `divmmc_fs.c`, бенчу — нет. **Открыто:** заливка B0150+v427, `.mkdir` владельцем, проверка FATALL/WDC/TR-DOS с байтом `0x01`. |
| 2026-08-22 | Ядро **B0150** во ВСЕХ ТРЁХ ветвях: Atlas (`bulb_zx_B0150.bit.bin` 1 165 664 Б), MiSTer-48 (`mister48_b0150.bit.bin` 1 117 600 Б), гибрид (`hybrid_b0150.bit.bin` 1 207 296 Б); прошивка **v0.15.427**, образ `flash/BOOT_B0150_v427.BIN` 1 892 564 Б | Atlas LUT **14877 / 17600 = 84.53 %**, MiSTer-48 **11189 (63.57 %)**, гибрид **15872 (90.18 %)**; у всех тайминг закрыт, 0 ERROR, ни одной настоящей `8-9873` (две строки в логе Atlas — комментарии из `build.tcl`). На карте `0:/BOOT.BIN` = v427, `0:/CORES/ATLAS.BIT.BIN` = B0150 (размеры сверены листингом до/после), откаты `BOOTV426.BAK`, `CORES/ATLAS149.BAK`; `POST VERSION = 0xB01B0150`, `g_dm_ctl = 0x8005` (бит15 FAST включён). Стенд `tb_divmmc_card.sv` после добавления CMD24-FAST и **CMD25 (два блока + стоп) в обоих режимах**: 1 059 118 обменов, 1 043 835 сверенных байт, **0 расхождений с эталоном** | Содержимое B0150 (все ветви): (1) `WRITE TRACK` у `wd1793.sv` подключён к механизму `format` — форматирование дискеты (B0149, теперь и в MiSTer-48/гибриде); (2) `divmmc_card.v`: `cfg_fast = ctl[15]`, четвёртый байт занятости после записи `0x01` (см. запись выше). 🥇 Стенд поймал по дороге ещё одну особенность: после стоп-токена CMD25 первым уходит байт `0xFF` из конвейера `nxt_byte`, и лишь потом занятость — так вели себя и RTL, и эталон до B0150, путь просто не был покрыт; для NedoOS («ждать не-FF до busy») это штатно. Зафиксировано проверкой в стенде. **Открыто:** `.mkdir` владельцем на v427; `MISTER48.BIT.BIN` на карте заливается (`M48NEW.BIN` → переставить); гибрид на карте не живёт (в меню его нет), файл в `artifacts/`. |
| 2026-08-22 | Прошивки **v0.15.428 → v0.15.429** (ядро прежнее **B0150**), образы `flash/BOOT_B0150_v428.BIN` 1 810 644 Б, `v429` | На карте `0:/BOOT.BIN` = v428 → v429, откаты `BOOTV427.BAK`, `BOOTV426.BAK`; `POST VERSION = 0xB01B0150`; образ `0:/DIVMMC.IMG` починен командой 13, резерв до правки `0:/DIVMMC_PRE428.BAK` (полные 50 331 648 Б - поле `n` у cmd 6 COPY показывает ЧАСТЬ, размер сверять листингом) | 🏁 **`.mkdir` ВЛАДЕЛЕЦ: 2–3 с вместо 35 (v427, B0150 FAST).** Прибор подтвердил числом: гистограмма пауз esxDOS между секторами переехала из окна 128–256 мс (263/310) в окно 2–4 мс (257/310); записей ровно 264, ошибок 0. **cmd 13 WRITE-AT** (v428): запись `g_fs_len` байт из FS_BUF в файл `p1` по смещению из `p2` (десятичная строка), без CREATE, без удлинения за EOF — точечная правка больших файлов с хоста, раньше только кардридером. 🥇 **Образ `DIVMMC.IMG` был дефектным от `mkfs.fat`:** корень — один кластер (512 Б = 16 записей), а `FAT[2] = 0x0` («свободен») вместо признака конца цепочки. Метка + 15 каталогов заполнили корень на `T3`; для `T4`/`T5` esxDOS выделил и обнулил кластеры, а корень расширял, читая `FAT[2]=0` как «следующий кластер = 0» → писал записи в LBA 3560 = предпоследний сектор ВТОРОЙ копии FAT (текст `T4 `/`T5 ` найден в FAT2 дампом). `.ls` их показывал (читал оттуда же), в корне на карте их не было, FAT2 подпорчена. **Не связано с FAST** (`T4` создавался в SPEC). Починка cmd 13 в безопасном порядке: новый кластер корня 21146 = копия LBA 3560 (записи T4/T5), `FAT[21146]=EOC` в обеих копиях, LBA 3560 = копия сектора FAT1 (нули), последним `FAT[2]=21146` в обеих копиях. После: цепочка корня `[2, 21146]` с EOC, расхождений FAT1/FAT2 0, `.ls` показывает T4/T5 из настоящего корня, `.mkdir /TMP/T7` быстрый. **v429:** галочка «Fast write ack» в окне DivMMC добавлена ПОСЛЕ блока FS (обход фокуса в TV_Dialog идёт по порядку добавления, не по координатам — владелец увидел перескок), окно H 20→22 с пустой строкой над кнопками. 🥇 **Мина прибора:** адреса символов после КАЖДОЙ сборки прошивки сдвигаются — снимок по адресам v427 на плате с v428 дал мусор (`0xF2555555`, счётчики 4 млрд); перечитывать `arm-none-eabi-nm` перед каждым замером. **Открыто:** FATALL «Copy disk on FAT-device» с `.SCL` в A: вешает машину (см. HANDOVER §0.0); шаг 3 (Z-Controller запись файл→карта) не подтверждён; шаги 4–5 (FORMAT, выключатель FAST в обе стороны) не пройдены. |
| 2026-08-22 | Прошивка **v0.15.430** (ядро прежнее **B0150**), образ `flash/BOOT_B0150_v430.BIN` 1 810 644 Б | На карте `0:/BOOT.BIN` = v430, откат `BOOTV429.BAK`; образ `0:/DIVMMC.IMG` откачен из `DIVMMC_PRE428.BAK` и починен заново (цепочка корня `[2, 21146]`, FAT1=FAT2), испорченный сохранён как `0:/DIVMMC_BAD.BAK` (разбор) | 🥇 **Z-Controller: путь образа, режим и скорость НЕ переживали перезагрузку** (владелец: «сохранился режим включён, но не образ»). Три машинных поля `zcfile`/`zcmode`/`zcturbo` ЧИТАЛИСЬ из ini как `<тег>.zc*`, но не ПИСАЛИСЬ: `zcmode` уходил мёртвым глобальным ключом, `zcfile`/`zcturbo` не писались вовсе; окно ZC клало `zcmode` только в `opt_zcmode`, не в профиль. Теперь пишутся рядом с `dmfile=`, `zcmode` кладётся в `g_mp[m]`, чтение `zcturbo` добавлено. У DivMMC тот же путь проверен — режим в профиль кладётся (`apply_divmmc`), дефекта нет. **FATALL «Copy disk on FAT-device → New TRD» переписал корень образа** (в корне остались только его `FATALL.TRD`/`FATALL.!B`/`777.SCL`, `FAT[0]=0xA0F`) — см. HANDOVER §0.0; откат + повторная починка cmd 13, потерян только `/TMP/T7`. Запись через Z-Controller при этом РАБОТАЕТ — владелец положил два файла руками (**шаг 3 подтверждён**). Воспроизведение: `mkfs.fat 4.2 -F32` на 48 МБ ставит `FAT[2]=EOC` — исходный `FAT[2]=0` образа не от mkfs, источник не установлен. 🏁 **ФОРМАТИРОВАНИЕ ДИСКЕТЫ ПРИНЯТО ВЛАДЕЛЬЦЕМ (шаг 4):** `FORMAT "test"` на `0:/DISKS/FMTTEST.TRD` — «прошло успешно, размер файла 640 КБ». Сверено байтами (файл прочитан с карты cmd 12): служебный сектор тип 0x16, файлов 0, **свободно 2544**, метка `test`, первый свободный трк/сек (1,0); каталог (дорожка 0, секторы 1–8) — **0 ненулевых байт**; дорожки 1..159 — **0 ненулевых из 651 264**. То есть WRITE TRACK (B0149/B0150) обнулил дорожки, а не только сменил метку. 🏁 **ШАГ 5 ПРИНЯТ — ВЫКЛЮЧАТЕЛЬ РАБОТАЕТ В ОБЕ СТОРОНЫ:** с галочкой OFF `.mkdir T6` снова ~35 с, с ON `.mkdir T8` снова 2–3 с (владелец: «всё как и планируется»). Гистограмма за оба прогона в одном снимке — **двугорбая**: 263 паузы в окне 128–256 мс (T6) и 257 в окне 2–4 мс (T8), записей 528 = 2 × 264. Ускорение даёт именно байт 0x01, а не что-то попутное. **Все пять шагов проверки закрыты владельцем.** Открыто: зависание FATALL на потрековом чтении `.SCL`; `DIVMMC_BAD.BAK` на карте до разбора. |
| 2026-08-28 | Ядро **B0151** — только ветвь Atlas (`artifacts/ZX_CPLANE/bulb_zx_B0151.bit` 1 211 211 Б, `.bit.bin` 1 211 104 Б, sha256 5225d130…); на карте `0:/CORES/ATLAS151.BIN` (размер сверен листингом), загружено по PCAP (временно), `VERSION=B01B0151`; `ATLAS.BIT.BIN` на карте = B0150 | 🥇 **Q-флаг Zilog для SCF/CCF** в форке `sources/t80_bulb/T80.vhd` (бэкап `.b0150.bak`): XF/YF = A \| (F & ~Q), Q поднимают все места, где флаги вычисляются (коммит ALU, SCF/CCF/CPL, IN r,(C), LD A,I/R, блочные), `POP AF`/`EX AF,AF'` — нет; перенос ep4spectrum `a949930`. Причина: z80full (RAXOFT) на плате давал **2/152 — 001 SCF (CRC 45FC79B5, ожид. D841BD8A), 002 CCF (A206B5E3 / 3FBB71DC)**; стенд `sim/timing/t80` до правки $01/$29, после — $29/$29, CCF F=$29 → $38 (Zilog), IM1/IM2/NMI 13/19/11 без изменений. Сборка: LUT **14875 (84.52 %)**, FF 12359, BRAM 58.5/60; тайминг закрыт **WNS +0.342 / WHS +0.010**, все констрейнты met; T80 привязан к `t80_bulb/T80.vhd` (ровно один), `8-9873` нет, `has no load` 100 (как B0150). MiSTer-48 и гибрид не пересобирались — они читают `mister_t80`, Q там нет (отдельная задача). **НЕ ЗАКОММИЧЕНО.** Приёмка: z80full на B0151 (см. журнал волта) |
| 2026-08-31 | Ядро **B0152 → B0153 → B0154** (только ветвь Atlas); прошивка **v0.15.431** собрана, НЕ залита | **Процессор: z80full 1.0 152/152, z80ccf 1.0 152/152, z80full 1.2a 160/160, z80memptr 1.2a «all tests passed»** (владелец на плате). **Фазы 48K: три эталонных числа сошлись** — порог stime 14335, данные плавающей шины 14340..14343, CONTP занят с 14339 (измерено в xsim на ЖИВЫХ исходниках, `/tmp/ula1/live/logs/`). Сборка Atlas: LUT **14996 / 17600 = 85.20 %**, FF 12379, BRAM 58.5/60, DSP 13; тайминг закрыт (**все констрейнты met**, WHS +0.013, WPWS +0.538, 0 отказавших точек), 0 ERROR, ни одной настоящей `8-9873`, прочитан ровно один `t80_bulb/T80.vhd`. На карте `0:/CORES/ATLAS154.BIN` 1 171 360 Б (размер сверен ЛИСТИНГОМ до переименования), загружено по PCAP: `VERSION = B01B0154`. Откат на карте `ATLAS153.BIN`; `ATLAS151/152` удалены | **B0152:** Q-флаг доведён по z80ccf (SET/RES не ставят Q, LDI/LDD/LDIR/LDDR и CPI/CPD ставят). **B0153:** флаги ПРЕРВАННОЙ блочной команды — лишний M-цикл повтора на 5 T ставит YF←PC.13, XF←PC.11 у всех, а INxR/OTxR вдобавок пересчитывают HF/PF от B и ставят MEMPTR=PC+1 (David Banks 2018); закрыло 089/090/102/103 в z80full 1.2a. **B0154 — ФАЗЫ:** (1) плавающая шина отдаётся на такт позже (`video.v`, ещё один регистр на пути `q`) — READP из ulatest3 на живом 48K даёт данные на 14340..14343, у нас были 14339..14342; (2) окно контеншена ПОРТОВ — тоже на такт позже (`main.v`, `vduC` через два триггера `ne7M0`) — CONTP даёт занятость с 14339, у нас было 14338. 🥇 **Порог stime задаёт НЕ выборка, а окно контеншена, и у памяти с портами окна РАЗНЫЕ:** у памяти строб падает на T1, у портов IORQ только на T2, поэтому сдвиг окна портов на такт НЕ шевелит порог stime (проверено: 14335 в обоих положениях), а сдвиг общего окна `cn` или всего растра ломает его сразу (14336). Ни одна одиночная ручка во все три эталона не попадает — только эти две вместе. Старая фаза портов возвращается битом27 `MACHINE_CFG` (диагностический, в меню не выведен — эталоны здесь друг другу не противоречат; A/B с хоста поком 0xBC). Плюс экономия логики в T80: `bq` 3 бита, MEMPTR прерванной INxR/OTxR через уже имеющийся вычитатель `PC-1` вместо второго 16-битного инкрементора. **Стенды до платы:** `sim/timing/t80` (SCF/CCF $29/$29/$81/$38, IM1/IM2/NMI 13/19/11 без изменений), `/tmp/blkfix` (12 проверок блочных, FAIL=0), `/tmp/ula1` (5 прогонов фаз). MiSTer-48 и гибрид НЕ пересобирались — они читают `mister_t80`, ни Q, ни блочных флагов там нет (отдельная задача); фазы `video.v`/`main.v` их тоже не касаются, у них свои ядра. **НЕ ЗАКОММИЧЕНО.** Открыто: растр/бумага (приёмка SHOCK часть 2), 8 отказов Timing Tests 48K (3, 15, 20, 32 — длительности команд; 36, 37 — контеншен), прошивка v0.15.431 собрана и ждёт заливки, снег (гейт «только 48K» по MiSTer, фаза hc, защёлкнутые MREQ/RFSH) |
| 2026-09-01 | Ядра **B0155**, **B0156**, **B0157** (только ветвь Atlas) и прошивки **v0.15.432**, **v0.15.433** — собраны параллельными агентами, строк в этом журнале не было; строка написана 02.09 по факту | B0155 `.bit` 1 132 483 Б / `.bit.bin` 1 132 352 Б; B0156 `.bit` 1 130 115 Б / `.bit.bin` 1 129 984 Б; B0157 — **четыре РАЗНЫХ битстрима под одним номером** (см. ниже). Полных отчётов сборки и приёмки по B0155/B0156 нет | B0156 добавлял в навигатор пять live-ручек таймингов, но **не работал**: `ULA_TUNE` делил индекс `7'h45` / адрес `0x114` с `QUIESCE` (меню ничего не крутило и могло задевать безопасную перезагрузку PL), слово управления не доводилось через `control_plane` до ядра, а fallback бита27 был перевёрнут. B0157 перенёс тюнер на `0x1C0`/`0x1C4` с отдельным frame-atomic CDC и 11 ручек. 🥇 **ГЛАВНАЯ МИНА ЭТОГО ДНЯ: под номером B0157 существуют ЧЕТЫРЕ разных битстрима** — ранняя лаборатория (15:29), стандартный артефакт (16:59), `NO_SNOW`+INTACK (17:17) и отдельный клон Потапова (17:31), — и по `VERSION` они неразличимы, поэтому ни один снятый кадр нельзя приписать ядру. Копии разведены 02.09 по уникальным именам с хешами в `artifacts/ZX_CPLANE/AMBIG_B0157/`. Правило на будущее: **уникальный `BUILD_VERSION` и строка в этом журнале — до заливки, а не после.** |
| 2026-09-02 | Ядро-**ЭТАЛОН B0900** — клон `ep4spectrum` Потапова (`research/17-ep4potapov`), серия 09xx = чужое ядро, НЕ наша линия сборок. `bulb_zx_potapov.bit` 1 022 843 Б, `b0900.bit.bin` 1 022 720 Б (sha256 `c51005696554980e`) | LUT **11707 / 17600 = 66.52 %**; **тайминг закрыт: WNS +0.147, WHS +0.037**; 0 ERROR; подмены модуля больше нет | Его T80se с его флагами, его `video.v` (растр 28 МГц, задержки 9 px / 3 px, фаза 4), его память и ПЗУ, наша обвязка (HDMI-захват, звук, PS/2). Вопрос, на который отвечает этот битстрим (задание владельца): проходит ли ЕГО ядро на НАШЕМ железе `stime`/`btime`/`ulatest3` и рисует ли SHOCK верно — если да, дефект в нашем Atlas и появляется цель для сравнения; если нет, дефект в общей части (захват кадра, геометрия, `paper_h`), и ULA копали напрасно. 🥇 **Две мины в его сборке, найденные при пересборке:** (1) `build_potapov_full.tcl` **вообще не проверял тайминг** — писал битстрим не глядя, и hold-нарушение **WHS = −0.318 нс** ушло бы в «эталон» (у другого агента в журнале стоял только `WNS +0.531`); теперь скрипт пишет отчёты, печатает оба числа и дожимает hold через `phys_opt_design -directive AggressiveExplore` + повторный роут. (2) Топ `bulbulator_zx_ddr_top.v` лежал и в `source/`, и в `build/` — молчаливая подмена по имени модуля (`Synth 8-9873`), побеждал прочитанный позже; копия из `source/` теперь исключается из чтения по имени. |
| 2026-09-02 | Ядро **B0158** (только ветвь Atlas) — ВОЗВРАТ К ИЗМЕРЕННОМУ. Правки в дереве, сборка на момент записи не запущена | Приёмка стендом `/tmp/ula1` по живому коду: три эталонных числа обязаны вернуться к принятым 31.08 значениям (порог `stime` 14335, данные плавающей шины 14340..14343, первый занятый такт CONTP 14339) | 🥇 **Три эталонных числа, потерянные в B0157, потеряла ОДНА строка.** Умолчание источника прерывания было прибито к `2'd1` (Late, сырой `vduI` без переопроса) вместо «следовать опции машины» (`ula_late ? 1 : 0`). Шкала тестов Бобровского привязана **К ПРЕРЫВАНИЮ**, поэтому прерывание на такт раньше читается как «всё на такт позже»: измерено стендом по живому коду — `stime` 14335 → **14336**, плавающая шина 14340..14343 → **14341..14344**, окно контеншена памяти +1 такт. Побочно от этого **опция машины `ULA timing` перестала на что-либо влиять** — ядро всегда было Late, а настройка `EARLY (TYPE 1)` не делала ничего. Прочее в B0158: окно контеншена ПОРТОВ вернулось на такт позже (наша C2, приёмка `CONTP = 14339`), **бит27 `MACHINE_CFG` снова живой** (в B0157 вход `io_cont_early` остался, топ его подавал, а в логике он не использовался нигде — диагностический A/B был мёртв), задержки бумаги и бордюра вернулись в **НОЛЬ** (9 px / 3 px / фаза 4 — числа с ЧУЖОЙ платы; в блоке B0154 стоит прямое предупреждение мерить перекос выходных путей своим стендом, а не копировать; приёмки на нашей плате у них нет, поэтому они стали положениями ручки `pic_lab`). **Оставлены** гейты `m1` на Kempston/ULA/AY/SAA — порты не должны отвечать при `!M1 && !IORQ`, то есть в цикле подтверждения прерывания, иначе портится вектор IM2. Бэкапы: `main.v.b0157_lab.bak`, `video.v.b0157_lab.bak`. |
| 2026-09-02 | Прошивка **v0.15.437** (ядро B0159), образ `flash/BOOT_B0159_v437.BIN` 1 806 036 Б — **СОБРАНА, НА КАРТУ НЕ ПИСАЛАСЬ** (запас) | loader.elf | Главный цикл: `if(!g_tape_on) fs_service(); else fs_snapshot_only_service();` — при играющей ленте обслуживается ТОЛЬКО команда 14 (снимок кадра, чистый memcpy без FatFs), остальное ждёт конца ленты как раньше. Тело cmd 14 вынесено в `fs_frame_snapshot()`. Причина: SHOCK — многочастная лента, пока она играет, мейлбокс молчит и кадры снять нельзя. Бэкап исходника `loader_main.c.pre_v437.bak` | не на плате |
| 2026-09-02 | Прошивка **v0.15.436** (ядро **B0159**), образ `flash/BOOT_B0159_v436.BIN` 1 806 036 Б — на карте `0:/BOOT.BIN` (откат `BOOTV435.BAK`) | loader.elf | **cmd 14 FRAME SNAPSHOT: инвалидация L2 (`Xil_L2CacheInvalidateRange`) перед копией и `Xil_L2CacheFlushRange` после.** ARM читает буферы кадра через L2, а `Xil_DCacheInvalidateRange` трогает только L1: после первого снимка строки кадра оседали в L2, и все дальнейшие снимки отдавали один старый кадр (esh1 при идущем SHOCK). Тот же эффект видит и JTAG-зонд через ядро. Добавлен `#include "xil_cache_l.h"`. Бэкап исходника `loader_main.c.pre_v436.bak` | записано и сверено put_retry; перезагрузка — по слову владельца |
| 2026-09-02 | Прошивка **v0.15.435** (ядро **B0159**), образ `flash/BOOT_B0159_v435.BIN` 1 806 036 Б — на карте `0:/BOOT.BIN`, тёплая перезагрузка `QUIESCED_WARM_SD_REBOOT_OK`, оболочка показывает `v0.15.435 / b0159`; откаты `BOOTV434.BAK` (B0159+v434), `BOOTV433.BAK` | `cmd 14` на плате: `done=1 err=0 n=3`, три копии на статичном экране совпали байт-в-байт | 🥇 **Команда мейлбокса 14 FRAME SNAPSHOT** — ARM копирует три буфера кадра (`fb_bufmgr3`: `0x0FF00000/0x0FF10000/0x0FF20000`) в `FS_BUF` с тем же шагом за ~3 мс (инвалидация кеша до, сброс после). Причина: кадр по JTAG читался ~15 с и был СМЕСЬЮ сотен кадров — тройной буфер вращает роли каждый кадр; всё, что дрейфует от кадра к кадру, выглядело как пространственная периодика (ложный «период 96 строк» у CONTINT). `HALT` (CONTROL bit0) не годится: морозит процессор, ULA рисует дальше с последним бордюром. Также в v0.15.434: `Pan X/Y` двигает окно вывода на машинах, где фабрика `paper_h` игнорирует (все, кроме Пентагона). |
| 2026-09-03 | Ядро **B0163** (`sources/build/bulbulator_zx_loader.bit` 1 168 803 Б) — ЧИСТЫЙ ОТКАТ четырёх непроверенных правок B0162 | LUT **15158 / 17600 = 86.13 %**, BRAM 58.5 / 60, тайминг **закрыт**: WNS **+0.310 нс**, WHS **+0.019 нс**, TNS/THS 0, 0 ERROR, ни одного настоящего `8-9873`. На карту НЕ залито. | 🥇 **B0162 ломал приёмку и демку SHOCK, и это измерено стендом на живых исходниках.** Числа: READP уехал на такт (14341..14344 вместо эталонных 14340..14343), CONTP укоротился (14339..14340 вместо 14339..14344). Причины — `int_sel_req` прибит к `2'd2` (зеркало мины B0157, где его прибили к `2'd1`) и окно контеншена сдвинуто на 3 T (`h_cn = hUla + 2; cn = h_cn[3:1] < 6`). Третья правка — снятие 8-пиксельной квантовки бордюра у 48K (`borderFine` на `!model`) — ПРЯМО против эталона: у Потапова (`ep4spectrum/source/video.v:590-600`) это пройдено и описано словами «a real 48K cannot do that: its ULA takes the border once per 8-pixel group», лечится ФАЗОЙ группы (`BORD_PHASE=5`, `BORD_DELAY=2`, снято btime на живой машине). Четвёртая — гейт `rfsh` на контеншене памяти — без приёмки. **Приборный итог на демке SHOCK ч.2** (стенд, образ из `SHOCK_PART2_BORDER.SNA`, монитор BORDER): у B0162 из 121 записи бордюра на кадр только 55 попадали в гашение, 53 уезжали в бумагу; после отката — **117-118 из 121 в гашении, 4 видимых**, что совпадает с эталоном ZEsarUX (113-115 смен, 0-3 строки-исключения). ⚠ Побочно у B0163 МЁРТВЫ ручки лаборатории `ula_tune` для бордюра/бумаги (`b_phase`, `b_delay`, `pap_delay`, `ula_tune2[5]`) — их конвейер чужая сессия удалила, в логе это видно как 100 предупреждений `8-7129 has no load` на битах `ula_tune` модуля `video`. Вернуть в B0164 вместе с точным окном гашения 48K (`hBlank = hUla >= 316 && hUla < 412`: правый бордюр 268..315 = 48 px, левый 412..447 + 0..11 = 48 px — как у настоящей машины и у ZEsarUX) и добивкой строки захвата цветом бордюра (машина даёт 352 px, `CAP_W` просит 384). |
| 2026-09-03 | Ядро **B0164** (`artifacts/ZX_CPLANE/bulb_zx_B0164.bit.bin` 1 158 912 Б, образ `flash/BOOT_B0164.BIN` 1 803 860 Б) | LUT **15206 / 17600 = 86.40 %**, тайминг закрыт: WNS **+0.026 нс** (тесно), WHS +0.012, TNS/THS 0, 0 ERROR. Залито и проверено на плате. | Три правки: (1) хвост строки захвата добивается цветом бордюра вместо чёрного — жёсткий шов на `x=352` был у 249 строк из 302, стало 10; (2) снят выдуманный проброс записи процессора прямо в выборку ULA (`cpu_scr_wr`), которого нет ни в одном бэкапе и нет у настоящей ULA; (3) фаза 8-px группы защёлки бордюра выведена живой ручкой `ULA_TUNE2` бит8 = включить, биты 11:9 = фаза. ⚠ **Ручка сделана НЕВЕРНО и это выяснилось позже (вторым агентом, 07.09):** `border_upd` ДОБАВЛЕН к разрешению записи рядом с `attrOutputLoad`, а не заменяет его, поэтому старая точка защёлки на фазе 4 продолжает срабатывать всегда. Следствие: свип восьми фаз 03.09 на живой плате давал одну и ту же гистограмму (`x = 5,13,21,29,37`) НЕ потому, что фаза не лечит, а потому что ручка ничего не заменяла. Вывод «фазу вычеркнуть» СНЯТ, вопрос открыт заново. |
| 2026-09-07 | Ядро **B0165** (`artifacts/ZX_CPLANE/bulb_zx_B0165.bit.bin` 1 166 432 Б, образ `flash/BOOT_B0165.BIN` 1 811 412 Б) + прошивка v0.15.437 | Собрано и залито (плата отвечает `VERSION = 0xB01B0165`). | Две правки: (1) **окно гашения 48K приведено к машинному** — `hBlank = hUla >= 316 && hUla < 412`, то есть 96 тактов гашения и 352 видимых пикселя (48 левый бордюр + 256 бумага + 48 правый), плюс симметричная добивка захвата по 16 px с каждой стороны → в буфере 384 получается ровно 64/256/64; прежнее окно `320..416` было по ширине верным, но на 4 счёта мимо. (2) 🥇 **Импульс /INT больше не растягивается контеншеном.** Ресемплер `irq <= vduI` тактировался `pc3M5`, а он гейтится `contend`: пока процессор стоял в контеншене, снятие /INT откладывалось и импульс жил **46..48 T вместо 32**. Теперь фронт прихода по-прежнему берётся на `pc3M5`/`nc3M5` (сохраняя приёмочные `stime` 14335, READP 14340..14343, CONTP 14339..14344), а снятие — на свободных `pe3M5`/`ne3M5`. |
| 2026-09-08 | Ядро **B0169** (`sources/build/bulbulator_zx_loader.bit.bin` 1 168 224 Б, образ `flash` -> `0:/BOOT.BIN` 1 813 204 Б, откат `BOOT168.BAK`; на карте `0:/CORES/ATLAS.BIT.BIN`, откат `ATLAS168.BIN`) | Тайминг **закрыт** (`All user specified timing constraints are met`), 0 ERROR, настоящих `8-9873` нет. Залито и проверено на плате: `VERSION = 0xB01B0169`. | 🥇 **ПРАВЫЙ КРАЙ БУМАГИ: бордюрная ветка гейтится ОКНОМ ПОКАЗА бумаги, а не флагом `videoEnable`.** Жалоба владельца: «правый край бумаги не полностью прорисовывается, будто бордюр на него наложился». Причина — регрессия B0168: добавленный там принудительный взвод защёлки (`border_start`) срабатывал по `videoEnable`, а этот флаг обновляется только в окне `h_addr[3]=1` и падает на `h_addr` 264, тогда как сдвигатель домалывает последний байт бумаги до 268. Итог — последние 4 пикселя бумаги в КАЖДОЙ строке красились цветом бордюра. Числа: стенд `tb_pap` (xsim, живой `video.v`) до правки **252 px**, после **256 px**, у Пентагона 256 в обоих случаях; на плате честный кадр (cmd 14) против ZEsarUX — **188 строк бумаги из 188 совпали пиксель в пиксель по всем 256 столбцам, расхождений ноль** (до правки в каждой строке промахивались три последних столбца). Окно взято у эталонов: MiSTer `rtl/ula.sv:185` (`hc_next<12 | hc_next>267 | vc>=192`), Sizif `cpld/rtl/video.sv:184,264-267`. `dataOutputLoad` намеренно оставлен на `videoEnable` — там разница недостижима. **Что этой сборкой НЕ починено и измерено отдельно:** верхняя бордюрная полоса esh2_48 стоит на 8 px правее эталона (края 41/73/105 вместо 33/65/97). Полный построчный диф кадра с эталоном: расходятся **20 строк из 304, и это ровно верхняя полоса**; бумага и нижняя полоса совпадают. Вычеркнуты измерениями: фаза защёлки (свип всех восьми на плате), положение INT (свип −12..+4 px: на −5 верхняя встаёт на 33, но нижняя уезжает на +24 — совместить нельзя), фаза контеншена портов (бит27 MACHINE_CFG, эффекта нет), длины команд (стенд: `ED 71/41/79` = 12 T, `D3 FE` = 11, `NOP` = 4, `JR taken` = 12, `LD BC,nn` = 10 — точное совпадение с числами Потапова с живого 48K), момент записи в порт (`IORQ`+`WR` на T2/TW/T3 своего цикла), приём прерывания (трасса: цикл подтверждения 7 T + два стековых по 3 T = **IM1 13 T**, эталон). **Остаётся один механизм:** между верхней и нижней полосой лежит вся бумага, и наш кадр набирает там на 4 такта меньше настоящей машины — поэтому к нижней полосе ошибка стирается, а на бордюрных строках (контеншена нет) видна. Это та самая ось «СКОЛЬКО тактов стоит контендед-доступ», которую Потапов отметил как никем не сверенную с железом. |
| 2026-09-08 | Ядро **B0170** (`/tmp/b0170.bit.bin` 1 170 272 Б; на карте `0:/CORES/ATLAS.BIT.BIN`, откат `ATLAS169.BIN`) | Тайминг закрыт, 0 ERROR, настоящих `8-9873` нет. Залито и проверено: `VERSION=0xB01B0170`, `MACHINE_CFG=0x0001C102` (бит27 снят — раннее окно теперь ПО УМОЛЧАНИЮ). | 🥇 **УМОЛЧАНИЕ ОКНА КОНТЕНШЕНА ПОРТОВ ВЕРНУЛОСЬ В НОЛЬ, И ЭТО УБРАЛО СДВИГ ВЕРХНЕЙ ПОЛОСЫ КВАДРАТОВ В esh1/esh2.** Жалоба владельца: «сдвиг верхнего бордюра вправо». **Найдено бисектом по ядрам на карте, а не теорией** — подсказка владельца «раньше esh1 и esh2 шли правильно» оказалась ключом: B0153 даёт ОДНУ пару переходов (правильно), B0154 — ДВЕ, разошедшиеся на 8 px; владелец подтвердил глазом, что на B0153 esh1 идёт правильно. Виновата правка B0154 `io_cont_tap` 0 → 2 (окно портов на такт позже ради приёмочного CONTP 14339). Механизм: бордюрные строки контеншена не имеют, но общий заряд за кадр меняется, вход в HALT уезжает, а выход из HALT квантован по 4 такта — весь код после него прыгает на 8 px. **Числа:** A/B битом 27 на живой плате, три цикла — позднее окно 11 правильных строк + 10 сдвинутых, раннее 21 правильная и НИ ОДНОЙ сдвинутой (число строк сохраняется); esh2 честным кадром против ZEsarUX — позднее окно **20 расходящихся строк из 304**, раннее **0 из 304, совпадение 100 %**. **Внешнее подтверждение:** у Потапова (`vertohod/ep4spectrum`, `source/video.v:542-545`) `io_base = 0` на ВСЕХ машинах, а прежние 32 counts на 48K/128K он называет ротацией окна ввода-вывода и убрал как дефект. **Цена, записанная честно:** CONTP становится 14338 вместо принятого 14339 (стенд, зонд MODE 1, NT=1). Прежняя фаза осталась переключателем — `MACHINE_CFG` бит27. **Вычеркнуто измерениями по дороге (не искать там):** заряд контеншена памяти и порта — канонический 6,5,4,3,2,1,0,0 (8 прогонов на карту, по одному доступу в кадре); длины всех команд провалившихся тестов; момент записи в порт (T2/TW/T3); приём прерывания IM1 = 13 T; квантование выхода из HALT = 4 T; btime расходится с эталоном на 1 px; сдвиг прерывания демку НЕ двигает (съедается квантованием HALT); сдвиг растра и фаза защёлки двигают ВСЮ картинку. ⚠ **Осталось:** чёрная чёрточка 8×1 px в левом верхнем квадрате esh2 (строка 54, x 57..64) — это «dash» Потапова, у него не решён; FUSE и ZEsarUX её показывают, живой 48K нет. |
| 2026-09-08 | Ядро **B0171** (не заливалось как рабочее) | Тайминг закрыт. | Возвращена раздельная задержка путей бордюра и бумаги (была в B0157, удалена в B0158 без приёмки). ⚠ ДЕФЕКТ ПРАВКИ, пойман прибором сразу: селектор «бумага/бордюр» взят по окну ЗАГРУЗКИ сдвигателя (h_addr 12..267) вместо окна ПОКАЗА (13..268) — последний столбец бумаги в каждой строке отдавался бордюру. Числа: 21 расходящаяся строка с эталоном, ВСЕ расхождения на одном столбце 303. |
| 2026-09-08 | Ядро **B0172** | Тайминг закрыт, LUT 85.9 %. | Селектор исправлен на окно показа; пара ручек сведена к ОДНОЙ (`bord_early` = на сколько пикселей раньше закрывается защёлка, компенсация автоматическая). Контрольная точка прошла: при нуле 0 расходящихся строк. ⚠ Ненулевые значения двигали всю картинку (232 строки) — задерживались цвет и гашение, а синхросигналы нет. |
| 2026-09-08 | Ядро **B0173** (на карте `ATLAS173.BIN`, был в `BOOT173.BAK`) | Тайминг закрыт. | hsync/vsync добавлены в тот же конвейер задержки. Диагностика показала главное: картинка НЕ сдвигается (лучшее совмещение dx=0, dy=0), меняются ~2 % пикселей — то есть ручка делает именно то, что должна. Но полосы при этом расщеплялись обратно: задерживать надо было ТОЛЬКО бордюр, а сдвинулась защёлка, не растр. Ручка оставлена, умолчание 0. |
| 2026-09-09 | Ядро **B0174** (`/tmp/b0174.bit.bin` 1 207 104 Б; на карте `0:/CORES/ATLAS.BIT.BIN` и `0:/BOOT.BIN`, откаты `ATLAS173.BIN`, `BOOT173.BAK`) | 0 ERROR, тайминг закрыт, настоящих `8-9873` нет. Залито и проверено: `VERSION=0xB01B0174`. | 🥇 **ЧЁРТОЧКА УБРАНА — МЫ ТОЧНЕЕ FUSE И ZEsarUX.** Правка в ОДНО условие: к защёлке порта бордюра добавлен `contend`, то есть значение берётся на первом НЕОСТАНОВЛЕННОМ такте цикла записи (s+d), а не на первом такте цикла (s). **Причина, найденная разбором первоисточников:** цикл ввода-вывода занимает [s, s+3+d], где d — штраф контеншена; у настоящей машины положение цвета = КОНЕЦ КОМАНДЫ МИНУС ТРИ = s+d (правило WoS «48K reference»), а FUSE/ZEsarUX/Spectrusty применяют запись ДО начисления штрафа (в FUSE это соседние строки `periph.c:368-373`). Такт **14335** — единственный в строке, где одновременно красится последняя 8-пиксельная группа бордюра и начисляется максимальный штраф 6; запись, попавшая на него, у эмулятора ложится вплотную слева к бумаге, у железа уезжает на 6 тактов внутрь бумаги. **Проверка на плате, три числа:** (1) строка 54, столбцы 57..64 = `4,4,4,4,4,4,4,4` (красный, чёрточки нет); (2) края квадратов 33/65/97/129 не тронуты; (3) расхождений с ZEsarUX ровно ОДНА строка и ровно 8 пикселей — сама чёрточка, которую эталон показывает, а мы больше нет. Контроль на esh1: 21 строка, одна пара (33,353) — как на B0153. **Побочно из разбора кристалла** (полный вентильный нетлист emu-russia/ula + книга Chris Smith): выходная защёлка настоящей ULA стоит на фазе **C[2:0]==5**, у нас 4 — отдельный пункт, отдельная сборка. |
| 2026-09-09 | Ядро **B0175** (`sources/build/bulbulator_zx_loader.bit` 1 168 207 Б, `.bit.bin` 1 168 096 Б; на карте `0:/CORES/ATL175T.BIN`, загружено PCAP-ом, `VERSION=0xB01B0175`) + прошивка **v0.15.438** (`arm/loader.elf`, собрана, НЕ залита) | LUT **15164 / 17600 = 86.16 %**, тайминг закрыт: **WNS +0.415 нс**, TNS 0, 0 нарушений, 0 ERROR, настоящих `8-9873` нет. На карту как боевое ядро НЕ ставилось (`ATLAS.BIT.BIN` и `BOOT.BIN` = B0174). | 🥇 **TIMING TESTS 48K ТЕПЕРЬ ГОНЯЮТСЯ НА СТЕНДЕ, И СЧЁТ ПОДНЯТ С 50/74 ДО 64/74.** Настоящий тест на живом RTL в xsim (образ памяти + точка входа + остановка машины после сбора результата; `sim/timing/ports/`, `mkimg.py`, `ttcheck.py`, `ttsweep.sh`). Три правки: **(1) джойстик Kempston стал ОПЦИЕЙ** (`MACHINE_CFG` бит28, умолчание 0 = интерфейса нет — решение владельца; конус `a[5]=0` отдавал `0x00` вместо плавающей шины на ПОЛОВИНЕ портов, измерено: из 1659 чтений за кадр 831 забирал джойстик). В прошивке v0.15.438 добавлен пункт меню «Kempston joystick» (переменная, профиль машины, ini-ключ `kempston`, три подменю). **(2) плавающая шина на такт раньше** (ступени задержки считаются от `fb_lat`, нулевая комбинационная; прежняя фаза — ручка). Тесты 35/36/37 встали на эталон ТОЧНО, все три: 54/237/23300, 49/237/23337, 124/236/23321. **(3) 🥇 прерывание без переопроса тактом процессора** (`vduI`, зарегистрированный МАСТЕР-тактом, вместо `irq <= vduI` по `pc3M5`). Переопрос стоил РОВНО 4 такта на выходе из HALT: сигнал активен с T=0, ближайшая граница сетки NOP на T=1, опоздавший на такт `irq` её промахивал и брал следующую. Разложение цепочки монитором TMON: подтверждение INT 7, обработчик F5F5 24, пусковая C0F3 59, тело DDDD 253 при эталонных 247..249; обработчик ровно 35 T и пусковая ровно 194 T — то есть промах весь в первом звене. Закрыт весь класс «сдвиг t0». ⚠ Заодно РАЗВЯЗАНЫ две разные вещи: вариация Ferranti Early/Late — это сдвиг РАСТРА (`ulaShift`), а переопрос прерывания к ней отношения не имеет; раньше опция `ULA timing` дёргала оба. **Что осталось:** пять ЗАНЯТЫХ тестов (2, 3, 17, 18, 27) расходятся на 1..2 — фаза доступа ULA к памяти на 2 такта позже эталона (доказано посписочным сравнением штрафов монитором CMON: заряды совпадают один в один, времена на +3, и модель со сдвигом окна +2 даёт ровно наши числа). Правится в B0176. **Гочи:** `run.sh` стенда пишет ошибки сборки в отдельный лог и после падения прогон идёт на СТАРОМ образе — проверять код возврата; тройки теста зависят от ФАЗЫ вызывающего кода по модулю 4 такта, поэтому длину харнеса менять только кратно четырём; порядок полубайтов в буфере кадра — НИЗКИЙ первым. |
| 2026-09-09 | Ядро **B0176** — **ЗАБРАКОВАНО НА ПЛАТЕ**, файл с карты удалён | Собралось чисто, тайминг закрыт, тесты молчали. | ❌ **СЛОМАЛО КАРТИНКУ: СИМВОЛЫ УДВОИЛИСЬ.** Стробы загрузки сдвигателя переведены на сдвинутую фазу доступа, а `dataOutputLoad` (фаза 4) остался — он стал брать байт УЖЕ СЛЕДУЮЩЕЙ колонки. Кадром прочитано: вместо «© 1982 Sinclair Research Ltd» шло «9922SSnnllii eeeerrhhLLdd». 🥇 **Тесты таймингов такую поломку НЕ ВИДЯТ ВООБЩЕ** — отсюда сторож `scrdiff.py` (кадр против эталона `/tmp/ref_basic_screen.bin`). Номер сожжён намеренно, чтобы в истории осталось, что сборка была и была плохой. |
| 2026-09-09 | Ядро **B0177** (на карте `0:/CORES/ATL177T.BIN`, PCAP, `VERSION=0xB01B0177`) | Тайминг закрыт **WNS +0.217 нс**, 0 ERROR, настоящих `8-9873` нет (две строки `8-9873` в логе — это комментарии `build.tcl`). | Промежуточные регистры `fetHoldD`/`fetHoldA`: читаем РАНЬШЕ, а в сдвигатель перекладываем в ПРЕЖНИЙ момент. Картинка починена — кадр совпал с эталоном **бит-в-бит, все три буфера**; стенд не изменился (7 из 8, тот же единственный «нож»). ❌ **Но сломалось ЗЕРКАЛО ЭКРАНА** (прибор чтения текста по JTAG): адрес `a` уехал на фазу выборки, а строб `scr_we` остался на прежней — в зеркале обнулилась каждая вторая колонка, заголовок ленты читался как «T i i g 4 k» вместо «Timing 48k». 🥇 **Зеркало (0x40008000) и кадр в DDR — ДВА РАЗНЫХ ПУТИ, `scrdiff.py` этого не видит.** Заведён второй прибор `fbocr.py` — чтение текста прямо из КАДРА; сетка знаков вымерена: **x0 = 65, y0 = 54**. ❌ **И сломались демки** (нашёл владелец, esh1/esh2): верхняя полоса вместо ровных 40 строк на `33,65,97,129,161,193` расщепилась на 21 строку `25,57,…` и 19 `41,73,…` — дрожание 16 px. |
| 2026-09-09 | Ядро **B0178** (на карте `0:/CORES/ATL178T.BIN`, PCAP, `VERSION=0xB01B0178`) | Тайминг закрыт, 0 ERROR. | Строб зеркала переведён на фазу выборки — зеркало починено, текст читается. Все ТРИ проверки прошли: кадр бит-в-бит, текст через зеркало, текст из кадра. Демки по-прежнему расщеплены — правка по существу та же, что в B0177. Полезен тем, что фаза стала **ручкой** (`ula_tune[29:26]`): при нуле поведение точно как у B0175, и это позволило мерить обе фазы на живой плате БЕЗ пересборки и без сброса машины. |
| 2026-09-09 | Ядро **B0179** | — | 🥇 **У ОКНА ЗАНЯТОСТИ ШИНЫ ДЛЯ ПАМЯТИ ТЕПЕРЬ СВОЯ ФАЗА, У ВВОДА-ВЫВОДА ПРЕЖНЯЯ.** По общему окну живут ДВЕ разные вещи: контеншен ПАМЯТИ (его требуют Timing Tests) и контеншен ВВОДА-ВЫВОДА, по которому **с B0174 защёлкивается бордюр**; B0176/B0177 двигали оба разом. `cn` остался прежним, добавлено `cn_mem` со своей фазой (умолчание 4 счёта = 2 такта), питает ТОЛЬКО `vduC_mem` в `main.v`; выборка, адрес и плавающая шина возвращены на прежнюю фазу, промежуточные регистры выброшены, `scr_we` вернулся на прежний строб. **Стендом доказано попутно: Timing Tests СЛЕПЫ к сдвигу прерывания** (тесты 2,3,17,18,27 дают одни и те же R/loop/sp при INT +0 и +2 такта) — значит ручка INT свободна; но полосу она не сводит (свип девяти положений: группы едут вместе). Первый прогон: тест 3 занятый совпал ТОЧНО — R=50, loop=405, sp=23316. |
| 2026-09-10 | Ядро **B0180** (на плату НЕ собиралось) | Стенд собирается чисто. | 🥇 **ОЖИВЛЁН `ula_tune2` (0x1C4) В ВЕРХНЕМ МОДУЛЕ** — до сих пор вход висел и ВСЕ 32 бита ручек были мертвы на плате (CDC + защёлка по кадру, как у `pent_int`). Добавлена своя фаза штрафа для ВЫБОРКИ КОМАНДЫ (`ula_tune2[20]` = ручка задана, `[19:16]` = смещение). ⚠ **Гипотеза, ради которой она делалась, ОПРОВЕРГНУТА этой же ручкой:** фаза выборки КАК У ДАННЫХ → 9 верных из 14, 1 такт → 4, 3 такта → 1 (отклонения до dR=+114). Окно должно быть ОДНО. Ручка оставлена как ПРИБОР. **Две мины, найденные по дороге:** (1) 🥇 `run.sh` стенда пересобирался ТОЛЬКО если снимка нет вообще — после любой правки RTL молча гонял СТАРЫЙ образ, поэтому **все прогоны стенда после B0177 на самом деле были B0177**; признак — ручка, доходящая до симулятора, не меняет ни одного числа даже на крайних значениях; починено сторожем по времени файлов. (2) 🥇 `contend` комбинационно питает `pc3M5`, тактирующий процессор: выход процессора, заведённый обратно напрямую, замыкает кольцо, и xsim падает невнятным «Failed to compile generated C file …xsim_5.c» БЕЗ HDL-сообщений — заводить только через регистр (`m1_d`). |
| 2026-09-10 | Ядро **B0181** (`/tmp/b0181.bit.bin` 1 132 928 Б; **БОЕВОЕ**: `0:/CORES/ATLAS.BIT.BIN` и `0:/BOOT.BIN` с прошивкой v0.15.438; откаты `ATLAS179.BIN`, `BOOT179.BAK`) | 0 ERROR, тайминг закрыт **WNS +0.204 нс**, LUT **14995 / 17600 = 85.20 %**, настоящих `8-9873` нет. Проверено ТЁПЛОЙ ПЕРЕЗАГРУЗКОЙ С КАРТЫ: `v0.15.438 / b0181`. | 🥇 **УМОЛЧАНИЕ ФАЗЫ ОКНА ПАМЯТИ ВЕРНУЛОСЬ В НОЛЬ — И ЭТО ИЗМЕРЕНО, А НЕ ВЫБРАНО.** Полный прогон 74 тестов на ЧЕСТНОЙ сборке: **фаза 0 → 64 верных, настоящих расхождений 6** (тесты 2, 3, 17, 18, 22, 27 занятые); фаза 4 → 59 из 71, настоящих 9 (1, 9, 11, 15, 23, 24, 33 и 35 обе части). То есть сдвиг на 2 такта, введённый в B0176 и доживший до боевого B0179, **тестам не помог, а навредил**: чинит четыре теста, ломает восемь. Прежнее «7 из 7 при сдвиге» снято на СТАРОМ образе. Плата подтверждала лишь половину картины: A/B ручкой действительно чинил 2, 3, 17, 27, но ломал восемь других, и испорченный стенд этого показать не мог. **Картинка не пострадала:** при фазе 0 окно памяти тождественно окну ввода-вывода. Проверено всеми ЧЕТЫРЬМЯ сторожами: кадр бит-в-бит с эталоном, текст через зеркало, текст прямо из кадра, верхняя полоса esh2 — **40 однородных строк** на `33, 65, 97, 129, 161, 193`. **Найден дефект модели (записан, не исправлен):** занятые ПОРТЫ штрафуются по правилам ПАМЯТИ — признак `memC` читает шину адреса, а во время цикла ввода-вывода там адрес порта; доказано тестом 35, тело которого целиком в незанятой памяти, но результат зависит от фазы окна памяти. |
| 2026-09-15 | Ядро **B0188** (`artifacts/ZX_CPLANE/B0188.bit`; карта `0:/CORES/ATL188T.BIN` 1 167 936 Б) | 0 ERROR, setup WNS +0.141 нс, hold WHS +0.036 нс, все ограничения выполнены. | **ГЕОМЕТРИЯ ЗАХВАТА 48K.** B0186 захватывал 336 настоящих пикселей и ДОБИВАЛ строку до 384, РАЗМНОЖАЯ крайний пиксель по 24 раза с каждой стороны — отсюда первый столбик квадратов esh2_48 шириной 47 px вместо 32 и бумага на x=47..302. Дефект в ЗАХВАТЕ, поэтому TIMING48 его не видел. B0187 (352 настоящих + по 16 чёрных столбцов) владельцем отвергнут. B0188: родное окно 48K `hUla 397..447 + 0..332` = 384 настоящих пикселя, бумага x=64..319, гашение 333..396; размножение краёв убрано, короткие строки добиваются ЧЁРНЫМ. CPU/ULA/INT/контеншен не тронуты (стенд: равенство с B0186 на 2 121 678 мастер-тактах). TIMING48 на плате 100 % Pass. |
| 2026-09-16 | Ядро **B0189** (`artifacts/ZX_CPLANE/B0189.bit`; карта `0:/CORES/ATL189T.BIN` 1 164 640 Б) | 0 ERROR, все тайминговые ограничения выполнены. | 🥇 **ШОК ч.2 ЛОМАЛО УСКОРЕНИЕ ЗАГРУЗКИ, А НЕ ULA.** Демка вызывает `USR 62CE` МЕЖДУ блоками ленты, меряет там длительность кадра и выбирает ветку 48K/128K. Записанная пауза непомечена (`tape_sync_rom=0`), а разрешение варпа висело на `tape_streaming`, который непомеченное пропускает → процессор шёл 8×, детектор уходил в 128K-ветку: 228-тактовый цикл бордюра на 224-тактовом растре = 8 px сползания на строку плюс шов слева x24. Правка (только верхний модуль): `sync_standard_context` помнит класс блока через его паузу, `cpuwarp_tape_allowed` гасит ТОЛЬКО ускорение процессора, лента продолжает идти. `video.v`/`main.v`/`fb_capture_rr.v` совпадают с B0188 по SHA256. Стенд: 84 проверки политики PASS + интеграция с настоящим `tape_player` (пауза 45 T: старый FAST 90 мастер-тактов, новый 715; хеш дескрипторов тот же). **Приёмка на плате: FAST 8×, все три буфера кадра чистые** — 0 неоднородных строк сверху/слева/справа/снизу, 8 цветов, чёрных столбцов нет. Гоча стенда: xsim возвращает 0 даже при `$fatal` — сторож требует явной строки PASS. |
| 2026-09-16 | Ядро **B0190** — **БОЕВОЕ** (`artifacts/ZX_CPLANE/B0190.bit`; карта `0:/CORES/ATLAS.BIT.BIN` 1 165 760 Б и `0:/BOOT.BIN` 1 810 708 Б с прошивкой v0.15.438; откаты `ATLAS181.BIN`, `BOOT181.BAK`, `BOOTB181.BAK`, на диске `flash/BOOT_B0181_v438.BIN`) | 0 ERROR, все тайминговые ограничения выполнены, LUT **15053 / 17600 = 85.53 %**, настоящих `8-9873` нет. Проверено ТЁПЛОЙ ПЕРЕЗАГРУЗКОЙ С КАРТЫ: `POST VERSION = 0xB01B0190`, кадр живой, оболочка показывает `v0.15.438 / b0190`. | **ОКНО 128K ПО ТОЙ ЖЕ ФОРМУЛЕ + ПЕРЕВОД В БОЕВОЕ.** B0188 убрал размножение краёв, но окно 128K осталось широким (`326..438`, 112 тактов гашения) — в строке 456 тактов это 344 настоящих пикселя из 384, то есть на 128K вылезли бы чёрные поля по 20 точек (ровно то, что владелец отверг на B0187). B0190: `model ? (hUla >= 333 && hUla < 405)` — гашение 72 такта, 384 настоящих пикселя, бордюры 64/64. Пентагон (`332..396`) не тронут. Проверено на плате: чёрных боковых столбцов 0. 🥇 **Почему пришлось менять И `BOOT.BIN`:** `apply_machine` грузит ядро с карты ТОЛЬКО при смене ИМЕНИ ядра (`if(tgt && cicmp(tgt, g_cur_core) != 0)`), а у 48K/128K/Пентагона имя одно — `ATLAS`; холодный старт поднимает битстрим из `BOOT.BIN` и PCAP на старте не делает. Менять надо ОБА файла: иначе либо холодный старт остаётся на старом ядре, либо поход в MiSTer/NES и обратно молча вернёт старый `ATLAS.BIT.BIN`. **ОТКРЫТО:** на 128K вместе с ядром приехал `irqBeg` 6 → 8 (правка B0184 под 48K, на 128K не проверялась) — прибор `0:/test/Timing_Tests-128k_v1.0.tap`, откат в одну строку `model ? 6 : 4`. |
| 2026-09-16 | Ядро **B0191** (`artifacts/ZX_CPLANE/B0191.bit`, bin 1 210 240 Б; карта `0:/CORES/ATL191T.BIN`) | 0 ERROR, все тайминговые ограничения выполнены, LUT **15047 / 17600 = 85.49 %**. | 🥇 **У 128K СВОЁ ПОЛОЖЕНИЕ ПРЕРЫВАНИЯ.** Правка B0184 (`irqBeg` 2/6 → 4/8) делалась по прибору 48K и на 128K не проверялась — и уехала вместе с ядром. Измерено на плате прибором `0:/test/Timing_Tests-128k_v1.0.tap`: при `irqBeg` 8 тест 4 занятый даёт `R=6 loop=174 sp=23305` против эталона `R=4 loop=173 sp=23301` — машина успевает на ЦЕЛУЮ итерацию больше, то есть прерывание приходит позже. A/B со старым ядром с карты (`ATLAS181.BIN`, у него 128K на 6) — тест 4 проходит, и весь набор 1..34 тоже. B0191: `irqBeg = model ? 9'd6 : 9'd4` — 48K остаётся на 4 (TIMING48 100 %), 128K возвращён на 6. Остальное от B0190 без изменений. 🥇 **Ручкой это проверить нельзя:** `video.v:46` `tune_en = ula_tune[31] && !model && !pentagon` — лаборатория прерывания закрыта на 128K и Пентагоне по построению, только A/B ядрами. Гочи прибора 128K: он требует режим **48 BASIC** (иначе `** MUST RUN IN 48k MODE **`), а после теста 34 печатает `9 STOP statement, 1350:1` — это ШТАТНЫЙ конец: строки пронумерованы по тестам (1010 = тест 1), значит 1350 = тест 35, и тесты портов 35/36/37 в набор для 128K не включены. |
| 2026-09-18 | Ядро **B0196** (`artifacts/ZX_CPLANE/B0196.bit`) | 0 ERROR, все тайминговые ограничения выполнены, LUT **15007 / 17600 = 85.27 %** (у B0195 было 15047), настоящих `8-9873` нет. Карта: `0:/CORES/ATLAS.BIT.BIN` 1 172 096 Б и `0:/BOOT.BIN` 1 817 044 Б (прошивка v0.15.440); откаты `ATLAS195.BIN`, `BOOT195.BAK`. Проверено ТЁПЛОЙ ПЕРЕЗАГРУЗКОЙ С КАРТЫ: `POST VERSION = 0xB01B0196`, кадр живой, переполнений FIFO нет. | 🥇 **ВЕРХНЯЯ КРОМКА: СНИМОК АДРЕСА СТРОКИ НЕ ЗНАЛ, ИЗ КАКОГО КАДРА ЕГО БАЗА.** Остаток после B0194/B0195 (владелец: «полоса шириной в один спектрумовский пиксель, только на мерцающих демках, кропом не лечится»). Механизм такт за такт на `clk`: на такте `fk_d` (K+2) `frame_base` и `base_epoch` ещё СТАРЫЕ, и именно из старой базы считается `addr0_q` (блок снимка работает каждый такт, без разрешения); на K+3 база и метка уже НОВЫЕ, а `addr0_q` лежит посчитанный по старой. На K+3 обе строки негодны по метке (`!have0`), читатель стоит в `RD_IDLE` — в гашении ему делать нечего — и срабатывает В ТОТ ЖЕ ТАКТ: `ar_addr <= addr0_q` (адрес в буфере ПРОШЛОГО кадра), а метка `tgt_epoch <= base_epoch` (НОВАЯ). Сторож `row0_q == want0` проверял свежесть номера строки, но не свежесть базы кадра, поэтому первая исходная строка картинки приезжала из прошлого кадра **с честной меткой «свежая»** — проверка метки на пиксельной стороне (B0195) пропустить её не могла в принципе. Правка (`fb_line_disp.v`, ~15 строк): метка кадра `fbe_q` кладётся РЯДОМ со снимком адреса, пуск чтения разрешён только при `base_fresh = (fbe_q == base_epoch)`. Цена — один такт простоя раз в кадр, внутри гашения. Метка однобитная намеренно: 32-битное сравнение баз в конус `RD_IDLE → ar_addr` класть нельзя (история тайминга B0124). Заодно выведен прибор: **`0x1C8 DISP_DIAG` = {отложенных пусков[31:16], недогрузок[15:0]}**, оба насыщаются на `0xFFFF` (`ld_underrun` висел дангling-проводом с B0124; попутно убрана и вторая мина — счётчик недогрузок присваивался из ДВУХ always-блоков). **Машина не тронута:** `atlas_core/video.v` и `atlas_core/main.v` идентичны B0195 по diff, значит приёмка таймингов 48K и 128K и тонкий бордюр Пентагона остаются в силе по построению. Почему диагноз сходится со всеми наблюдениями владельца: только сверху (перезакачка по смене метки достаётся первой строке, остальные читаются много позже), только на мерцающих демках (иначе `disp_base` от кадра к кадру не меняется и подмены не видно), кропом не лечится (промах привязан к «первой строке, какая бы ни была»), и в снимке кадра отсутствует (дефект в читателе, а снимок отдаёт готовый буфер). Прибор приёмки: `/tmp/dispdiag.py` — на 50 Гц ждём порядка 50–100 отложенных пусков в секунду и НОЛЬ недогрузок. | **ПРИНЯТО ВЛАДЕЛЬЦЕМ НА ПЛАТЕ 18.09: «сейчас хорошо, нет того дефекта на мерцающих вещах, что видел ранее» — верхняя кромка закрыта (4 строки → 2 → 1 → 0).** **ПРИЁМКА ПРИБОРОМ (0x1C8, 5 с на живой плате): отложенных пусков +253 = 51/с при 50 Гц, то есть РОВНО ОДИН НА КАДР — щель срабатывала на каждом кадре без исключения; недогрузок 0/с, значит вторая гипотеза («читатель не успевает донести строку») закрыта.** |
| 2026-09-23 | Прошивка **v0.15.441** (ядро B0196 без изменений) | собрано, `0:/BOOT.BIN`, откат `BOOT440.BAK` | **Смена машины в меню внутри одного ядра (48K/128K/Пентагон = ATLAS) не применяла периферию новой машины.** NEMO-IDE, GS и мышь живут в своих регистрах (NEMO_CTL/GS_CTL/KM_CTL), `MACHINE_CFG` их не несёт, PCAP при такой смене нет — устройства оставались от прежней машины. `apply_machine` теперь зовёт `apply_ide(); apply_gs(); apply_kmouse();` (без `apply_divmmc`: он сбрасывает машину). Попутно найдено: провалы Timing Tests 48K 35/36/37 = включённый NEMO-IDE у машины 48K (`zx48.ide=1`): неполная дешифрация оригинала (A1=A2=0) забирает четверть портов, тест читает плавающую шину через порты. Подтверждено владельцем: IDE выкл — проходит, вкл — валится. | на плате: загрузка, смена машины применяет её профиль |
| 2026-09-23 | Прошивка **v0.15.442** | собрано, `0:/BOOT.BIN`, откат `BOOT441.BAK` | Диалог Copy/Move: после выбора каталога деревом фокус сразу на **OK** (раньше оставался на кнопке дерева, до OK — несколько Tab). Отмена в дереве фокус не трогает. | **проверено на плате** по канве: F5 → Tab → Enter → выбор → фокус на OK |
| 2026-09-23 | Прошивка **v0.15.443** | собрано, `0:/BOOT.BIN`, откат `BOOT442.BAK` | (1) **TAP/TZX SPEED: только NORMAL / FAST 8x** (владелец: «все хорошо грузится на 8х»); старое 2 (4x) из ini/KVM молча = FAST 8x (`cur_fmode`, разбор ini). (2) **Новая опция Tape → «Load via (128K)»** (`opt_items[92]`, ini `tape128=`): как автостарт входит в загрузку на 128K/Пентагоне. `128 MENU` — как было (Enter на Tape Loader); `USR 0` — 48 BASIC с незапертой страничностью (`#7FFD=#10`), для 128K-демок, которым нужен LOAD из 48 BASIC; `48 LOCK` — как пункт «48 BASIC» живого 128K (`#7FFD=#30`), для 48K-софта, который пишет в #7FFD. Вход инжектом PC=0, а не навигацией по меню ПЗУ (у пентагоновских BIOS меню разные). На 48K опция не влияет. Сторож индексов меню дополнен 91 и 92. | **проверено на плате** (ZX 128K, ttst48_my.tap): USR 0 → `MACH_DBG` 7FFD=0x10 rompage=1, 48 LOCK → 7FFD=0x30 rompage=1, программа грузится и идёт; меню Tape показывает FAST 8x и новый пункт. Timing Tests 48K на v0.15.442: 3 из 3 «All Tests Complete 100% Pass». |
| 2026-09-23 | Прошивка **v0.15.444** | собрано, `0:/BOOT.BIN`, откат `BOOT443.BAK` | Имя машины в меню: **PENTAGON (Atlas)** вместо зашитого «PENTAGON 1024K (Atlas)» (владелец: имя врало при RAM size 128K/512K). Живой объём по-прежнему в шапке навигатора (`machine_type`: «PENT 128K»). Ключи ini `pent1024.*` не тронуты. | **проверено на плате**: меню показывает PENTAGON (Atlas), шапка — PENT 128K |
| 2026-09-24 | Ядро **B0198** (`artifacts/ZX_CPLANE/B0198.bit`) + прошивка **v0.15.445** | 0 ERROR, тайминг закрыт (clk_pix setup 0.124 нс против 0.044 у B0196, fclk100 0.412 против 0.333), LUT **15348 / 17600 = 87.20 %** (+341), BRAM 58.5/60 без изменений, настоящих 8-9873 нет. На карте `0:/BOOT.BIN` 1 816 916 Б и `0:/CORES/ATLAS.BIT.BIN` 1 171 968 Б; откаты `BOOT444.BAK`, `ATLAS196.BIN`. | 🥇 **СМЕШЕНИЕ КАДРОВ НА ВЫВОДЕ (Display → Frame blend: OFF / AUTO / ON, умолчание AUTO).** Среднее кадров машины N и N-1 на HDMI - эмуляция послесвечения ЭЛТ для демок, которые каждый кадр переключают экран 5/7 (Eklhaft SP2, gigascreen): на ЖК они мерцали с 25 Гц. (1) `fb_bufmgr5.v` вместо `fb_bufmgr3.v`: пять буферов, вывод получает пару СОСЕДНИХ кадров машины, писатель не трогает ни одну из четырёх ролей (disp, dprev, ready, older) - при 50.02 против 50.00 Гц пара не рвётся. (2) `fb_line_disp.v`: при включённом смешении к строке дочитывается та же строка кадра N-1 во второй буфер, метка `buf_hasp`; смешение на той же ступени конвейера - задержка пикселя не изменилась. При OFF запросы AXI, адреса и вывод ровно прежние. (3) AUTO в `control_plane.v`: 6 переключений экрана за последние 8 кадров, один признак на оба конца; вход `scr_sel_i` (ZX: 7FFD[3], NES: 0). (4) Регистр `0x1CC FRAME_BLEND`; снимок кадра cmd 14 копирует 5 буферов, если 0x1CC отвечает (у старых ядер DEADBEEF). | **ПРИНЯТО:** стенды `sim/tb_bufmgr5.v` (400 тыс. тактов, 884 совпадения событий, испорченные версии валит) и `sim/tb_line_disp_blend.v` (OFF = старый читатель пиксель в пиксель, задержка 2 такта в обоих режимах, ON = точное среднее, переключение на лету без половинчатых строк, недогрузок 0) - PASS. На плате: Timing Tests 48K **3/3 «All Tests Complete 100% Pass»**, Timing Tests 128K **68/68 Pass**, приборы 0x1C8 (недогрузок 0), E2 со смешением - владелец: «работает хорошо, мне нравится». NES с новой оболочкой собирается, тайминг закрыт (8-9873 только старые из nes_core/compat.v). Rage на Пентагоне на B0198 - владелец: «все хорошо». |
| 2026-09-24 | Прошивка **v0.15.446** (ядро B0198 без изменений) | `0:/BOOT.BIN` 1 816 916 Б, откат `BOOT445.BAK` | **«48 LOCK» на Пентагоне теперь запирает.** У Пентагона 1024 бит 5 `#7FFD` запирает страничность только в стандартном режиме (`#EFF7` бит2 = 1), а после сброса машина в режиме 1024, и бит 5 там - номер банка; одной записи `#7FFD=#30` было мало. Теперь автостарт кладёт в `#5B00` программу из 17 байт (`OUT (#EFF7),4`, затем `OUT (#7FFD),#30`, `JP 0`), как это делает настоящая машина. На 128K путь прежний. | **проверено прибором `tools/lock_test.tcl`** (программа пытается `OUT (#7FFD),#17`): 128K - 48 LOCK `#30` держит (2 из 2), USR 0 `#10→#17` (2 из 2); Пентагон - 48 LOCK `EFF7=04`, `#30` держит (2 из 2), USR 0 `EFF7=00`, `#10→#17`. Лента грузится, экран «0 OK». |
| 2026-09-24 | Ядро **B0199** (`artifacts/ZX_CPLANE/B0199.bit`) + прошивка **v0.15.447** | тайминг закрыт, LUT 15377 / 17600 = 87.37 %, настоящих 8-9873 нет; на карте откаты `ATLAS198.BIN`, `BOOT446.BAK` | 🥇 **ДЛИНА INT ПЕНТАГОНА — ОПЦИЯ МАШИНЫ** «Pentagon INT length»: 36 T (умолчание; Fuse, ZEsarUX, Потапов) / 32 T (Sizif-512, MiSTer, Unreal, ZX-Evo, TS-Conf) / 44 T (minfo на живой плате, RC-цепочка). В ядро через `PENT_INT[14:9]` (`video.v` `pentIrqW`; 0 = 36 T для старой прошивки), ini-ключ `pint_w`. Заодно новый прибор **PENTTEST** (`tools/penttest/`, `0:/test/Pentagon/penttest.tap`). | **ПРИНЯТО:** PENTTEST намерил ровно выставленное — 36/32/44, каждый раз 9 passed, 0 failed. |
| 2026-09-24 | Ядро **B0200** (`artifacts/ZX_CPLANE/B0200.bit`) + прошивка **v0.15.448** | тайминг закрыт, LUT 15368 / 17600 = 87.32 %, настоящих 8-9873 нет, предупреждений по новым сигналам нет; `0:/BOOT.BIN` 1 851 092 Б, `0:/CORES/ATLAS.BIT.BIN` 1 206 112 Б; откаты `ATLAS199.BIN`, `BOOT447.BAK` | 🥇 **ЧТЕНИЕ ПОРТА #FF У ПЕНТАГОНА — ОПЦИЯ МАШИНЫ (#103)** «Port #FF read»: #FF (умолчание, как MiSTer) / ATTRIBUTE (как Sizif-512 `video.sv:283-289`: на бумаге последний выбранный атрибут, вне её #FF). `video.v` выход `qattr` (регистр `attrBus`, сброс в #FF вне `dataEnable`), `main.v` вход `ff_attr` — только младший байт #FF и только Пентагон; Beta Disk под TR-DOS стоит в мультиплексоре раньше, SAA1099 на #FF только пишет. `MACHINE_CFG` **бит29** (бит28 уже у Kempston), ini-ключ `port_ff`. PENTTEST v2 различает оба режима. | **ПРИНЯТО:** PENTTEST v2 на Пентагоне: #FF → «always #FF», ATTRIBUTE → «attributes 1791» (22 % из 8000 чтений, сходится с долей окна выборки при разной длине веток цикла), ни одного значения вне атрибутов экрана; оба раза 9/9 PASS. Timing Tests 48K на B0200 — «All Tests Complete 100% Pass», Fail 0. Timing Tests 128K не гонялись (правка гейтится `pentagon`). |
