Alex-Electron/ZX_BulbuLator/research/14-color-osd/images/player-step13.jpg

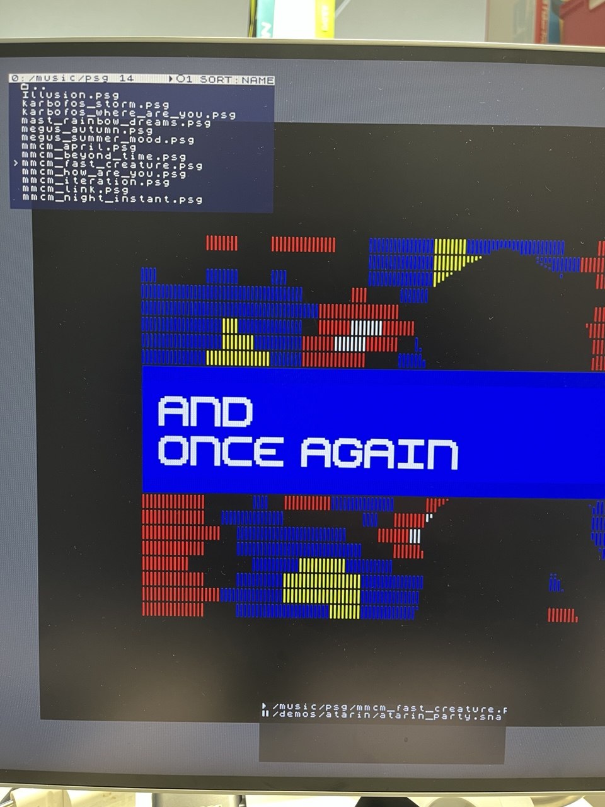
research/14-color-osd/images/player-step13.jpg
