Alex-Electron/ZX_BulbuLator/research/01-board-bringup-blink/README.ru.md

# Шаг 1 — Запуск платы: мигание светодиода с автосинхронизацией

Languages: [English](README.md) · **Русский**

Первое, что нужно сделать с новой платой EBAZ4205 (Zynq-7010), — это проверить сразу три вещи: плата включается, канал JTAG доходит до PL, и битстрим действительно запускается. В этом шаге для этого используется самый простой проект, в котором практически невозможно что-то испортить: счетчик на собственном внутреннем генераторе чипа, управляющий двумя светодиодами в противофазе.

Никакого кода PS, никакого внешнего тактового сигнала, никакого DDR. Если два светодиода мигают поочерёдно — значит, плата и весь инструментарий для записи в флэш работают нормально.

## Необходимые условия

### Режим загрузки: SD-карта

Плату нужно настроить на загрузку с SD-карты. Это важно, потому что PL программируется через JTAG при включённом PS, а чистая загрузка с SD-карты оставляет PS в исправном состоянии.

EBAZ4205 выбирает источник загрузки с помощью одного перемычки-резистора на 0 Ом рядом с контактами MIO. По умолчанию он загружается с NAND. Чтобы загрузиться с SD:

* Припаяй разъем MicroSD, если он не установлен (многие платы поставляются без него).
* Перемести резистор выбора загрузки в положение **SD**. На этой плате это
  **R2577** (перемещен из положения NAND, R2584). Это переводит перемычку загрузки MIO[5:4]
  в положение SD.

Обозначения резисторов зависят от версии платы (в зависимости от партии могут встречаться R2577, R2584 или R2585), поэтому сверь надписи на печатной плате с твоей моделью. Принцип тот же: один резистор на 0 Ом, положение «NAND» или «SD».

Зелёный светодиод питания на плате загорается при подаче напряжения 5 В.

### JTAG-программатор

Тебе понадобится JTAG-программатор, с которым может взаимодействовать Vivado. Подойдет любой кабель, совместимый с Vivado — адаптер Digilent или Xilinx, кабель на базе FTDI или, как я использую здесь, Raspberry Pi Pico с прошивкой xvc-pico через XVC. Это всего лишь один из вариантов.

Если выберешь вариант с Pico, используй прошивку с патчем «soft edges» (медленная скорость нарастания сигнала + ток вывода 2 мА); без него плотные битстримы завершаются ошибкой BAD_PACKET. Тогда стек будет выглядеть так: `xvcd-pico` (сервер XVC на порту :2542) → `hw_server` (:3121) → `vivado_lab` — именно это запускает скрипт `jtag_flash.sh`. С любым другим кабелем ты можешь пропустить это и просто использовать Vivado Hardware Manager напрямую.

## Как это работает

`blink.v` создаёт экземпляр `STARTUPE2` и подключается к его выходу `CFGMCLK` — внутреннему генератору конфигурации (примерно 50–65 МГц). На этом тактовом сигнале работает 27-битный счётчик; 24-й бит управляет `led0`, а его инверсия — `led1`. Два светодиода мигают в противофазе с частотой около 1–2 Гц.

Поскольку тактовый сигнал поступает изнутри микросхемы, эта схема не зависит ни от каких внешних факторов. В этом и весь смысл: она отделяет вопрос «можем ли мы настроить и запустить PL» от всех остальных переменных.

| Сигнал | Вывод | Сеть на шилде |
|---|-----|---|
| led0 | D18 | Светодиод (противофаза A) |
| led1 | H18 | Светодиод (противофаза B) |

Это те же самые светодиоды на шилде, что и в демонстрации HDMI (`led_lock` / `led_heart`).

## Сборка

Vivado 2023.1, компонент `xc7z010clg400-1`:

```
vivado -mode batch -source build_blink_z010.tcl
```

В результате получается файл `blink_z010.bit` размером примерно 2 083 856 байт. Этот размер соответствует фиксированной длине конфигурации микроконтроллера 7010, так что он также служит проверкой на то, что сборка была выполнена именно для этого устройства.

Здесь прилагается готовый файл `blink_z010.bit`.

## Прошивка

Когда плата загружается с SD-карты, а Pico подключен:

```
bash jtag_flash.sh /path/to/blink_z010.bit
```

Скрипт при необходимости перезапускает стек `xvcd-pico` + `hw_server`, открывает целевое устройство XVC, находит `xc7z010` и записывает на него данные. Успешный результат выглядит так:

```
End of startup status: HIGH
PROGRAMMED=1
```

## Ожидаемый результат

D18 и H18 чередуются с частотой примерно 1–2 Гц: один горит, пока другой гаснет, и так несколько раз в секунду. Это подтверждает наличие питания, работоспособность цепочки JTAG, правильную настройку PL и работу тактового генератора — всё это является основой для всех последующих шагов.

## Примечание к следующему шагу

Это мигание специально работает от внутреннего генератора. Проекты, которым нужен тактовый сигнал PS (в HDMI-демо пиксельный такт синхронизируется по FCLK0), не зажгутся при простой загрузке с SD-карты, потому что FSBL оставляет частоту FCLK0 на уровне 50 МГц, а демо ожидает 100 МГц. Повышение частоты FCLK0 до 100 МГц через JTAG с помощью `ps7_init` — это отдельный этап запуска.
