Alex-Electron/ZX_BulbuLator/research/15-pentagon/sim/timing/border/RESULT.md

# Бордюр и `OUT (#FE)`: где ложится полоса относительно записи и бумаги (xsim, шаг 0 — только измерения)

Дата: 28.08.2026. Каталог: `research/15-pentagon/sim/timing/border/`. RTL под `sources/` и `cores/` не тронут,
плата не трогалась, git-операций не было. Стенд — копия харнеса целой машины (`../harness/tb_zx.sv`) плюс монитор
бордюра; программа Z80 генерируется байтами (ассемблер не нужен). Полные таблицы всех прогонов — `TABLES.md`
(генерируется `make_tables.sh` из `logs/`), сырые логи — `logs/run_*.log`.

| файл | что это |
|---|---|
| `bm_monitor.sv`, `make_tb.py` → `tb_border.sv` | монитор бордюра, вставляемый в копию харнеса перед `endmodule` (харнес не правится) |
| `run_border.sh` | сборка/запуск (список файлов = `harness/run.sh` = `build.tcl` цели Atlas), `--wd=<имя>` для параллельных прогонов |
| `gen_prog.py` | программа Z80 для заданного паддинга `k` (описание ниже) |
| `sweep.sh`, `run_batch.sh`, `run_batch2.sh`, `batch1.txt`, `batch2.txt` | свипы по `k` (16 параллельных xsim) |
| `parse.py`, `make_tables.sh` → `TABLES.md` | разбор логов в таблицы |
| `sergey/tb_bpix.v`, `sergey/run_bpix.sh`, `sergey/logs/` | стенд на НЕТРОНУТОМ `/tmp/ep4/video.v` (Потапов) с воспроизведённой сеткой процессора — для сравнения |

## 0. Программа, единицы, определения

**Программа** (`gen_prog.py <out.bin> <k>`, ORG 0x8000 — неконтендящееся ОЗУ, банк 2): `DI; LD SP,7FF0h; XOR A; OUT (FE),A`;
атрибуты 0x5800..0x5AFF = 0x28 (бумага 5 = cyan, чернила 0, битмап нули → вся бумага cyan); `LD A,81h; LD I,A; IM 2; EI;
loop: HALT; JR loop`. Таблица IM2 по 0x8100 (257 байт 0x84) → вектор 0x8484. ISR: `XOR A; OUT (FE),A` (запись №1, чёрный);
паддинг ровно `k` T (NOP'ы + один остаток `LD A,I`=9 / `INC HL`=6 / `LD A,n`=7); `LD A,7; OUT (FE),A` (запись №2, белый);
`LD A,2; INC HL; OUT (FE),A` (запись №3, красный, фронт записи ровно через 24 T после белого); хвост, доводящий длину ISR
до кратного 4 T (иначе фаза HALT-цикла гуляла бы от кадра к кадру); `EI; RETI`.

**Единицы и точки отсчёта** (стенд `tb_border`, все события на posedge мастера 56.667 МГц, значения — «старые», действовавшие до фронта):

| величина | определение |
|---|---|
| `E_int` | первый фронт мастера, на котором `dut.Video.irq` = 0 (сырой /INT ULA) |
| `E_wr` | первый фронт, на котором `iorq=0 & wr=0 & a[0]=0` (запись в окно `#FE`) |
| **T_pc** | число импульсов `dut.pc3M5` в полуинтервале `[E_int, E_wr)` — такты, которые реально прошёл T80 (импульс, выставивший `iorq&wr`, входит) |
| T_pe | то же по `pe3M5` (такты «без контеншена»); `T_pe − T_pc` = удержание процессора |
| **hc(wr)** | `Video.hc` пикселя, начавшегося на том же фронте `ne7M0`, что и `E_wr` (запись всегда видна на `ce=10`, т. е. через 2 такта мастера после `pe3M5` на `ce=8` — внутри этого пикселя) |
| **колонка** | `Video.hc` (старое) пикселя, который ПЕРВЫМ несёт новый цвет на выходах `{i,r,g,b}` модуля `main`; строка — `Video.vc` |
| Δpx | колонка − hc(wr) (с учётом перехода строки, 448/456 px) |
| кол−бумага | колонка минус первая колонка бумаги той же строки |
| E1 | первый импульс `pc3M5`, на котором T80 видит `cpu_irq=0` (у нас = `pc3M5` №2 после `E_int`, см. ниже); n = T_pc − 2 — номер такта от E1 |

**Геометрия стенда** (измерено по переходам чёрный→cyan на выходе): 48K и 128K — бумага колонки **12..267**, строки 0..191;
Пентагон (`paper_h=2`, `paper_v=60` как в прошивке) — колонки **14..269**, строки **60..251**. Сырой /INT (`E_int`): 48K строка 248
`hc=1 ce=11`; 128K строка 248 `hc=5 ce=11`; Пентагон строка `pent_int_v` `hc=325 ce=11`. `cpu_irq` (пересэмпл на `pc3M5`,
`main.v:190`) виден ровно через 1 T: `hc=3 / 7 / 327`.

**Хронология ISR в тактах T_pc от `E_int`** (48K и Пентагон; у 128K на 1 больше из-за другой фазы HALT): запись №1 при
T_pc = **35** = 1 (пересэмпл /INT) + 3 (фаза HALT-цикла) + 19 (приём IM2) + 4 (`XOR A`) + 8 (`OUT`: M1 4 + чтение n 3 + T1 цикла IO);
первый M1 обработчика — импульс №23. Запись №2: **T_pc = k + 53** (128K: k + 54); запись №3: +24 T без контеншена.
`IORQ&WR` у T80pa выставляются на `CEN_p` при `TState=1` (`T80pa.vhd:162-165`), то есть в начале T2 цикла IO — то же, что `T2Write=1`
у Сергея; держатся 2 T (WREND через 5 px после `E_wr`: `ce=10` → `ce=2` пикселя hc+5).

## 1. 48K (model=0): свипы `k` в четырёх местах кадра

Полные таблицы — `TABLES.md`. Здесь — записи №2 (белый) и №3 (красный), кадр после установления фазы (см. §3).

### 1.1 Верхний бордюр, строка 258 (k = 2240..2263, 24 значения подряд)

Запись №2 (T_pc = k+53); №3 — то же +24 T и +48 px, ложится в ту же схему (см. `TABLES.md`).

| k | T_pc от /INT | запись строка/hc | hc mod 8 | виден строка/кол | Δpx | кол mod 8 |
|---|---|---|---|---|---|---|
| 2240 | 2293 | 258/107 | 3 | 258/108 | **1** | 4 |
| 2241 | 2294 | 258/109 | 5 | 258/116 | 7 | 4 |
| 2242 | 2295 | 258/111 | 7 | 258/116 | 5 | 4 |
| 2243 | 2296 | 258/113 | 1 | 258/116 | 3 | 4 |
| 2244 | 2297 | 258/115 | 3 | 258/116 | **1** | 4 |
| 2245 | 2298 | 258/117 | 5 | 258/124 | 7 | 4 |
| 2246 | 2299 | 258/119 | 7 | 258/124 | 5 | 4 |
| 2247 | 2300 | 258/121 | 1 | 258/124 | 3 | 4 |
| 2248 | 2301 | 258/123 | 3 | 258/124 | **1** | 4 |
| … 2249..2263 | k+53 | 258/(2·T_pc−4475) | период 4 | ступени 132, 140, 148, 156 | 7,5,3,1 | 4 |

Все 24 значения: колонка = ближайшее число ≡ 4 (mod 8), строго большее hc(wr); Δpx ∈ {1,3,5,7}, никакого другого значения.

### 1.2 Слева от бумаги, конец строки 311 → начало строки 0 (k = 14267..14298)

| k | T_pc | n = T_pc−2 | запись строка/hc | виден строка/кол | кол−бумага | примечание |
|---|---|---|---|---|---|---|
| 14267..14270 | 14318..14321 | 14316..14319 | 311/413..419 | 311/420 | — | группа 420 |
| 14271..14274 | 14322..14325 | 14320..14323 | 311/421..427 | 311/428 | — | группа 428 |
| 14275..14278 | 14326..14329 | 14324..14327 | 311/429..435 | 311/436 | — | |
| 14279..14282 | 14330..14333 | 14328..14331 | 311/437..443 | 311/444 | — | последняя группа строки 311 |
| 14281 (кадр 0) | **14334** | 14332 | 311/445 | **0/4** | **−8** | |
| 14282 (кадр 0) | **14335** | 14333 | 311/447 | **0/4** | **−8** | |
| 14283 | **14336** | 14334 | 0/1 | **0/4** | **−8** | |
| 14284 | **14337** | 14335 | 0/3 | **0/4** | **−8** | Δpx = 1 |
| 14285..14288 | 14338..14341 | 14336..14339 | 0/5..11 | — (бумага) | (0) | следующая группа = колонка 12 = первый пиксель бумаги, белого не видно; красный виден на 268 (конец бумаги) |
| 14289.. | ≥14342 | | 0/13.. | — (бумага) | | |

То есть **запись с T_pc ∈ [14334..14337] от сырого /INT (n ∈ [14332..14335] от E1) — последняя, которая ещё видна в бордюре (колонка 4,
на 8 px левее бумаги); с T_pc = 14338 (n = 14336) полоса уходит под бумагу** (её левый край совпал бы с колонкой 12).

Контеншен IO: записи №3 этих же `k`, попадающие на строку 0 (бумага) при hc = 49..79: `T_pe − T_pc` = 6,5,4,3,2,1,0,0 — все записи
с T_pe 14361..14366 удержаны до 14367 и ложатся на один и тот же hc = 63; свободные такты T_pe ≡ 7, 0 (mod 8) (14367, 14368, 14375, 14376).
Это порт `#FE` из НЕконтендящегося ОЗУ (случай N:1,C:3 в терминах FUSE); сам узор — предмет стенда контеншена, здесь зафиксирован попутно.

### 1.3 Справа от бумаги, строка 0 (k = 14412..14427)

| k | T_pc | запись hc | виден кол | Δpx | кол−бумага |
|---|---|---|---|---|---|
| 14412 | 14465 | 259 (бумага) | 268 | 9 | 256 = первый пиксель правого бордюра |
| 14413..14416 | 14466..14469 | 261..267 (бумага) | 268 | 7,5,3,1 | 256 |
| 14417..14420 | 14470..14473 | 269..275 | 276 | 7,5,3,1 | 264 |
| 14421..14424 | 14474..14477 | 277..283 | 284 | 7,5,3,1 | 272 |
| 14425..14427 | 14478..14480 | 285..289 | 292 | 7,5,3 | 280 |

Та же сетка ≡ 4 (mod 8) — правый край бумаги (268) сам лежит на ней.

### 1.4 Нижний бордюр, строка 195 (k = 58013..58036)

24 значения подряд: T_pc = k+53, запись hc = 101..147 (нечётные), виден 108, 116, 124, …, 148 — Δpx = 7,5,3,1 повторяется шесть раз, все колонки ≡ 4 (mod 8).
Ничем не отличается от верхнего бордюра (§1.1) при том же hc mod 8.

## 2. Пентагон (model=1, pentagon=1)

### 2.1 Бордюр, строка 280 (k = 9000..9009, PINTV=239)

| k | T_pc | запись hc | виден кол | Δpx |
|---|---|---|---|---|
| 9000 | 9053 | 63 | 64 | 1 |
| 9001 | 9054 | 65 | 66 | 1 |
| 9002 | 9055 | 67 | 68 | 1 |
| 9003 | 9056 | 69 | 70 | 1 |
| … 9009 | 9062 | 81 | 82 | 1 |

Запись №3 (+24 T): hc 111..129 → виден 112..130, Δpx = 1. **Каждый такт даёт свою колонку (2 px на T), задержка всегда 1 px** — попиксельная ветка `borderFine` работает.

### 2.2 У левого края бумаги, строка 60 (k = 17928..17937, PINTV=299 — как в прошивке, 81 строка от /INT до бумаги)

Сырой /INT: строка 299 hc=325 ce=11; `cpu_irq` через 1 T (hc=327); бумага строки 60 начинается на колонке 14 (переход чёрный→cyan).

| k | T_pc от /INT | n = T_pc−2 | запись строка/hc | виден строка/кол | Δpx | кол−бумага |
|---|---|---|---|---|---|---|
| 17928 | 17981 | 17979 | 59/447 | 60/0 | 1 | −14 |
| 17929 | 17982 | 17980 | 60/1 | 60/2 | 1 | −12 |
| 17930 | 17983 | 17981 | 60/3 | 60/4 | 1 | −10 |
| 17931 | 17984 | 17982 | 60/5 | 60/6 | 1 | −8 |
| 17932 | 17985 | 17983 | 60/7 | 60/8 | 1 | −6 |
| 17933 | 17986 | 17984 | 60/9 | 60/10 | 1 | −4 |
| 17934 | 17987 | 17985 | 60/11 | 60/12 | 1 | **−2** |
| 17935 | 17988 | 17986 | 60/13 | — (кол. 14 = первый пиксель бумаги) | (1) | (0) |
| 17936 | 17989 | 17987 | 60/15 | — (бумага) | | |
| 17937 | 17990 | 17988 | 60/17 | — (бумага) | | |

Запись №3 (+24 T) у всех десяти ложится в бумагу (hc 47..65) и видна на колонке 270 = первый пиксель правого бордюра.
Итог для Пентагона: **2 px на такт, задержка 1 px, последняя видимая в бордюре запись — n = 17985 (T_pc = 17987), на 2 px левее бумаги;
n = 17986 легла бы ровно на первый пиксель бумаги.**

## 3. Джиттер: одно и то же `k` в 11 кадрах подряд (RUNUS = 220 мс)

| k | кадры | T_pc записи №2 / №3 | колонка №2 / №3 | разных значений |
|---|---|---|---|---|
| 2241 (верхний бордюр) | 0..10 | 2294 / 2318 во всех | 258/116 / 258/164 во всех | **1** |
| 14284 (край бумаги, №3 в бумаге под контеншеном IO) | 1 | 14337 / 14361 (удержание 6 T, hc 63) | 0/4 / 0/268 | |
| | 2..11 | **14335 / 14359** (удержание 0, hc 47) | 0/4 / 0/268 | 1 после первого кадра |

Аппаратного джиттера нет: при отсутствии контеншена все 11 кадров тождественны. Единственное различие — **детерминированная
перестройка фазы HALT**: если запись ISR удержана контеншеном IO на число тактов, не кратное 4 (здесь 6 T), длина ISR в реальном
времени меняется, и следующий HALT-цикл оказывается сдвинут на 2 T относительно /INT; в новом положении удержание равно 0,
и дальше всё стоит. Это свойство программы (HALT-цикл 4 T + кадр, кратный 4), а не растра; в таблицах §1.2 такие `k` имеют две строки (кадр 0/1 и 1/2).
Проверка стабильности по кадрам в `parse.py` не нашла ни одного `k`, где записи №2/№3 расходились бы после установления фазы.

## 4. Выводы (1)–(5)

**(1) Разрешение отклика.** 48K и 128K: полоса встаёт ТОЛЬКО на колонки ≡ 4 (mod 8) — ступени по 8 px = 4 T; четыре подряд
идущих такта записи дают одну и ту же колонку. Пентагон: каждая T своя колонка (2 px на T), ступеней нет.

**(2) Фаза ступени.** Перескок на следующую группу происходит между hc(wr) mod 8 = 3 и 5, т. е. запись, чей пиксель имеет
hc ≡ 3 (mod 8), видна уже со следующего пикселя (Δpx = 1), а запись на hc ≡ 5 ждёт 7 px. В тактах: 48K — T_pc ≡ 1 (mod 4) от сырого /INT
даёт Δpx = 1 (последний такт группы), T_pc ≡ 2 — первый такт следующей группы (Δpx = 7); от E1 (n = T_pc − 2): n ≡ 3 → Δ1, n ≡ 0 → Δ7.
128K: T_pc ≡ 3 (mod 4) → Δ1 (k=2241: 2295 → hc 35 → 36), т. е. в 128K сетка групп сдвинута на 2 T относительно сырого /INT по сравнению с 48K
(/INT там на hc=5, а не 1). Для программы `gen_prog.py`: 48K k ≡ 0 (mod 4) → Δ1; 128K k ≡ 1 (mod 4) → Δ1.

**(3) Джиттер** — нет (см. §3).

**(4) Задержка.** От пикселя, начавшегося на фронте записи (`iorq&wr` видны на его `ce=10`), до первого пикселя нового цвета:
48K/128K — **1, 3, 5 или 7 px** (0.5..3.5 T) в зависимости от фазы; Пентагон — **всегда 1 px**. `WR` держится 2 T = 4 px (снимается
на `ce=2` пикселя hc+5), поэтому при Δpx = 1 или 3 цвет на экране меняется **до снятия `WR`** (на 4 или 2 px раньше), при 5 — в момент
снятия, при 7 — через 2 px после. Цепочка внутри: `border` защёлкивается на первом `pe7M0` того же пикселя (`ce=12`, монитор видит
новое значение на `ce=14` — строки `BM LATCH`), `attrOutput` берёт его на ближайшем `ne7M0` с `hCount[2:0]==4`, выход `r/g/b` комбинационный.

**(5) Соответствие RTL.** `main.v:227` — защёлка `{speaker,mic,border} <= q[4:0]` по `pe7M0` при `!ioFE && !wr` (первый `pe7M0`
после выставления записи — середина того же пикселя); `video.v:190` `attrOutputLoad = h_addr[2:0]==4` — раз в 8 px, поэтому колонка
≡ 4 (mod 8); `video.v:226` `borderFine` (Пентагон) — каждый такт `ce` в бордюрных клетках, поэтому 1 px. Бумага: первая клетка
грузится в сдвигатель тем же стробом на `h_addr = 12` (`dataOutputLoad`, `video.v:186`), поэтому **сетка групп бордюра совпадает с левым
краем бумаги (12) и с правым (268)** — это измерено (§1.2, §1.3). Замер 13.08 «бумага 4 px, бордюр 1 px, разница 3 px» согласуется:
байт бумаги берётся на `h_addr[3:0]==9/13` (`dataInputLoad`) и выходит на 12/20, а цвет бордюра берётся в самом пикселе записи и выходит
на той же сетке — разница в том, ГДЕ взяты входы, а не в сетке выхода.

## 5. Сравнение с моделью Сергея (`/tmp/ep4/video.v`, не правился)

Числа Сергея взяты из `../reference/REFERENCE_SERGEY.md` и дополнены своим стендом `sergey/tb_bpix.v` на его `video.v`:
процессора у него в xsim нет (нужны Altera-примитивы), поэтому сетка процессора воспроизведена по `clocks.v` платы —
`counter` идёт по negedge 28 МГц, `CLKEN_VID` регистрируется из `counter[0]==1`, `CLKEN_CPU` (SPEED=0) из `counter[2:0]==6`,
то есть фронт процессора лежит между двумя шагами `hcounter`, на `hcounter[1:0]==3` (проверено и для фаз 0, 1, 2 — вывод не меняется).
`T80se #(.T2Write(1))` выставляет `IORQ_n/WR_n` на фронте с `TState=1`, `ula_port` регистрирует `BORDER_OUT` на следующем такте 28 МГц →
`BORDER_IN` видео меняется через 2 такта после фронта процессора. E1 в обоих стендах — первый фронт процессора, на котором /INT уже низкий.

### 5.1 Что напечатал его `video.v` (`sergey/logs/bpix_*.log`)

| машина | сырой nIRQ | E1 | бумага видна (строка 0) | n ∈ … → полоса на 8 px левее бумаги | n → под бумагой | задержка WR→видно |
|---|---|---|---|---|---|---|
| 48K | стр. 248 `hcounter=6` | стр. 248 `hcounter=7` | `hcounter=26`, px 13 | **14333..14336** (px 5) | ≥ 14337 | 3, 7, 11, 15 count = 1.5, 3.5, 5.5, 7.5 px |
| 128K | стр. 248 `hcounter=10` | стр. 248 `hcounter=11` | `hcounter=26`, px 13 | **14360..14363** (px 5) | ≥ 14364 | те же |
| Пентагон | стр. 239 `hcounter=630` | стр. 239 `hcounter=631` | `hcounter=8`, px 4 | n=17985 → px 1 (бумага−3); **17986 → px 3 (бумага−1)** | ≥ 17987 | 7 count = 3.5 px всегда |

(48K, фаза фронта процессора 0/1/2 вместо 3: граница 14336/14337 та же.)

### 5.2 Наша машина в тех же координатах (n = T_pc − 2 от E1)

| машина | сырой /INT | E1 | бумага видна | n → полоса на 8 px левее бумаги | n → под бумагой | задержка |
|---|---|---|---|---|---|---|
| 48K | стр. 248 hc=1 | стр. 248 hc=5 (`pc3M5` №2) | кол. 12 | **14332..14335** (кол. 4) | ≥ 14336 | 1, 3, 5, 7 px |
| 128K | стр. 248 hc=5 | стр. 248 hc=9 | кол. 12 | **…14361** (кол. 4; измерено 14361 → 4, 14362 → бумага) | ≥ 14362 | 1, 3, 5, 7 px |
| Пентагон (PINTV=299) | стр. 299 hc=325 | стр. 299 hc=329 | стр. 60, кол. 14 | n=17985 → кол. 12 (бумага−2); n=17986 → кол. 14 = бумага+0 (не видна) | ≥ 17986 | 1 px |

От E1 до первого видимого пикселя бумаги: 48K — у нас 28679 px = **14339.5 T**, у Сергея 57363 count = **14340.75 T**;
128K — 28731 px = **14365.5 T** против 57471 count = **14367.75 T**; Пентагон — 35973 px = **17986.5 T** против 71953 count = **17988.25 T**.

### 5.3 Оценка смещения полосы (наша машина относительно модели Сергея, одна и та же программа)

| машина | до квантования | после квантования по группам |
|---|---|---|
| 48K | наша бумага на **1.25 T** раньше относительно E1, наш путь бордюра на 0.5 px короче → полоса ложится на **+1 T = +2 px правее** относительно бумаги | граница групп у нас на **1 T раньше** (14335/14336 против 14336/14337): для n ≡ 0 (mod 4) наша полоса встаёт на **8 px правее** (под бумагу там, где у него ещё бордюр), для остальных трёх фаз — в ту же группу (0 px) |
| 128K | **+2 T = +4 px** правее | граница на **2 T раньше** (14361/14362 против 14363/14364): для двух из четырёх фаз полоса на **8 px правее**, для двух — та же группа |
| Пентагон | бумага на 1.75 T раньше относительно E1, но его путь бордюра длиннее на 2.5 px (3.5 против 1) → полоса на **+1 px правее** (при n=17986 у него бумага−1, у нас бумага−0) | квантования нет; **+1 px** |

Направление во всех трёх случаях одно: **у нас полоса ложится ПРАВЕЕ (позже) относительно бумаги, чем у Сергея** — на 1 T (48K),
2 T (128K), 1 px (Пентагон). Механизм — не задержка бордюрного пути (она у нас даже короче: 1..7 px против 1.5..7.5 у него для Синклера,
1 против 3.5 у Пентагона), а положение /INT относительно растра: наш E1 стоит раньше первого пикселя бумаги на 14339.5 T против
14340.75 T. Что из этого «правильно» — вопрос к эталонам растра (стенд `intgeo`), здесь только измерено.

Оговорка к сравнению: положение фронта процессора относительно `hcounter` у Сергея восстановлено по `clocks.v`, а не измерено на его
полном дизайне (`tb_top.v` в xsim не собирается); чувствительность проверена — все четыре фазы дают ту же границу 14336/14337 для 48K.

## 6. Что не измерено / оговорки

- 48K с `ULALATE=1` (Type 2/Late, `int_sel=1`, обход пересэмпла /INT) не гонялся — прошивка держит Type 1; по коду это сдвинуло бы E1 на 1 T раньше (ещё дальше от модели Сергея).
- Свип 128K короче (8 + 8 значений `k`); у левого края бумаги измерены T_pc 14363 (кол. 4) и 14364 (бумага), нижняя граница группы (14360) не измерена, а выведена из шага 4 T.
- Пентагон у левого края бумаги мерился при PINTV=299 (как в прошивке: 81 строка от /INT до бумаги); при умолчании харнеса PINTV=239 и `paper_v=60` между /INT и бумагой 141 строка, и группа k=17928..17937 легла в бордюр строки 0 (в `TABLES.md` оставлена как контроль попиксельного отклика).
- Смещения T_pc = k+53/k+54 — свойство ЭТОЙ программы (фаза HALT 3 T); у другой программы фаза 0..3 T другая, поэтому в выводах всё привязано к hc(wr) mod 8 и к n от E1, а не к `k`.
- Снег выключен (`SNOWOFF=1`), DDR без задержки, дисковод/GS/NEMO/мышь выключены — как в харнесе.
- Лог `logs/stale/run_..._k2240..._RUNUS=40000...log` — прогон старой версии `gen_prog.py` (без выравнивающего хвоста), в таблицы не входит.
- Бюджет: 76 мс машины ≈ 95 с при 16 параллельных xsim (≈ 230 с в первой волне, когда параллельно шли чужие прогоны); 220 мс ≈ 180 с. Всего 150 прогонов, `wd/` ≈ 150 копий снапшота по 12 МБ — удалять можно.
