Alex-Electron/ZX_BulbuLator/research/15-pentagon/sim/timing/contention/RESULT.md

# Контеншен памяти и портов: наша форма против опубликованной (шаг 0, только измерения)

Дата: 28.08.2026. Инструмент: xsim 2023.1, стенд целой машины Atlas `sim/timing/harness/tb_zx.sv`
(здесь — его копия `gen/tb_cont.sv` = тот же файл с `` `include "cont_instr.svh" `` перед `endmodule`;
харнес не правился). RTL под `sources/` и `cores/` не тронут, плата не трогалась, git-операций не было.

Каталог: `research/15-pentagon/sim/timing/contention/`.

| файл | что это |
|---|---|
| `cont_instr.svh` | приборы контеншена и сборка обработчика IM2 (см. шапку файла: плюс-аргументы) |
| `run.sh` | сборка (`--build`) и запуск, `--wd=<имя>` для параллельных прогонов |
| `wave1.sh` … `wave4.sh` | все прогоны этого отчёта (запускались параллельно, каждый в своём `wd/<имя>`) |
| `make_result.py` | собирает этот `RESULT.md` из фрагментов `RESULT_*.md` и разбора логов |
| `prog/im2sweep.asm` | каркас Z80: IM2, таблица 0x8100 = 0x83, `HALT`-цикл по 0x8360, компенсация фазы по 0x8370 |
| `prog/contrun.asm` | копия `contrun.hex` Сергея Потапова (`/tmp/ep4/simulation/modelsim/`): `LD A,(6100)/LD A,(6101)/LD (6102),A/4×NOP/JP 6000` в 0x6000 |
| `prog/contrun_rd.asm`, `prog/contrun_out.asm` | плотные циклы `LD A,(HL)/INC L/DJNZ` и `OUT (#FE),A/XOR 5/JP` в 0x6000 |
| `fuse_model.py` | опубликованная модель (узор, окно, четыре случая портов, плотные циклы) |
| `analyze.py` | разбор логов `logs/run_*.log`, сверка каждого доступа с моделью, таблицы этого отчёта |
| `logs/` | все логи; в каждом последняя строка `wall: N s` |

## 0. Единицы и якорь

| единица | определение |
|---|---|
| **k** | номер импульса `pe3M5` (шаг T80 «если бы не контеншен»), считая от детекции спада `Video.irq` (сырой /INT ULA); k=1 — первый импульс после спада |
| **потерянный такт** | posedge `clock` с `pe3M5=1` и `dut.contend=0` (то есть `pc3M5` погашен контеншеном; `cpu_hold`/`mem_wait` исключены явно) |
| **hUla** | координата `video.v` в момент импульса (`= hCount = hc+1`); окно `cn = dataEnable && (hUla[3]\|\|hUla[2])` |
| **kacc** | k импульса, начавшего T1 цикла подтверждения прерывания (`!m1 && !iorq`) |
| **t** | `t = k − 2` — такты от прерывания в единицах Fuse/FAQ |

Откуда `t = k − 2`. Спад `Video.irq` приходится на `ne7M0` с нечётным `hc` (48K: `hCount=2`, `hc=1`), а `pe3M5`
стоит на чётных `hc`, то есть /INT падает в СЕРЕДИНЕ такта k=0..1. На импульсе k=1 `irq <= vduI` (регистр
`main.v:180`), на импульсе k=2 T80 видит `INT_n=0` и, если это конец команды, начинает цикл подтверждения:
**самое раннее kacc = 2**. Измерено на 48K: kacc ∈ {2,3,4,5} (решётка `HALT` 4 T), минимум 2
(`SWEEP DONE ... kacc min/max` в логах; прогон без компенсации фазы дал 2,5,4,3; все свипы 48K шли при kacc=2).
На 128K решётка `HALT` во всех прогонах встала на kacc=4, минимум напрямую не измерен; якорь 2 взят по тому же
механизму (спад /INT у 128K тоже на нечётном hc: `hCount=6`, середина такта) и подтверждается тем, что при нём
край окна ложится ровно на опубликованные 14361 (при kacc_min=3 получилось бы 14360). У Fuse
прерывание принимается командой, кончившейся на t=0, и первая команда обработчика IM2 стоит на t=19; у нас
первая команда обработчика (M1 по 0x8383) начинается на k = kacc + 19 (`kentry` в строках `ISR`). Значит
момент «t=0» Fuse — это наш импульс k=2, и `t = k − 2`. Это соответствие через ПРИЁМ прерывания процессором,
как его видит программа (`EI; HALT`), а не через пиксели.

Такт с индексом k «начинается» на импульсе k и «заканчивается» на импульсе k+1. Потерянный импульс k+1
удлиняет такт k. Так «задержка перед тактом, начавшимся на t» (формулировка Fuse) у нас = число подряд
погашенных импульсов после импульса начала этого такта.

## 1. Где это живёт в RTL

| что | где | как |
|---|---|---|
| флаг «предыдущий такт был без MREQ и без обращения к #FE» | `main.v:149` `always @(posedge clock) if(pc3M5) mreqt23iorqtw3 <= mreq & ioFE;` (`mreq` активен нулём, `ioFE = !(!iorq && !a[0])`, `main.v:707`) | флаг = 1 на T1 любого цикла (после M1 — потому что MREQ рефреша снят в середине T4, `T80pa.vhd:190-192`; после чтения/записи — снят в середине T3, `T80pa.vhd:202-207`), = 0 на T2/T3 цикла памяти, = 0 на TW/T3 цикла ввода-вывода к порту с A0=0 |
| фаза `cpuck` | `main.v:152` `if(ne7M0) cpuck <= !(cpuck && contend);` | свободный тоггл на 7 МГц; при `contend=0` принудительно 1 (держится всё удержание), после снятия снова тоггл |
| гейт | `main.v:154` `contend = (pentagon \| warp_nc) ? 1 : !(vduC && cpuck && mreqt23iorqtw3 && (memC \|\| !ioFE))` | у Пентагона всегда 1 |
| разрешения процессора | `main.v:165-166` `pc3M5 = pe3M5 & contend & ~cpu_hold`, `nc3M5 = ne3M5 & contend & ~cpu_hold` | гасятся ОБЕ фазы; T80pa (`T80pa.vhd:153-208`) на погашенном `CEN_n` не выставляет MREQ/RD, поэтому на шине во время удержания MREQ ещё НЕ активен (в логе `LOST ... mreq=1`) |
| окно ULA по пикселям | `video.v:339` `assign cn = dataEnable && (hUla[3] \|\| hUla[2]);`, `dataEnable <= de` на `ce` (`video.v:135`), `de = h_rel < 256 && v_rel < 192` (`:134`; у Синклера `h_paper_start = 0`, `video.v:68`) | 12 из 16 пикселей группы, 16 групп на строку, строки 0..191 |
| контендуемый адрес | `memory.v:421-424` `addr01 = !a[15] && a[14]`, `cn = addr01 \|\| (model && addr11 && ramPage[0])` | 0x4000-0x7FFF; у 128K ещё 0xC000-0xFFFF при нечётном банке. Для портов проверяется ТОТ ЖЕ провод по адресу порта |
| порт #FE | `main.v:707` `ioFE = !(!iorq && !a[0])` | старший байт адреса порта в гейт не входит иначе как через `memC` |

Итого правило нашего гейта, выписанное по тактам (это выведено из кода и подтверждено измерениями ниже):
такт удерживается (пока `vduC=1`), если адрес на шине контендуемый (`memC`) ИЛИ идёт обращение к порту
с A0=0 (`!ioFE`), И на предыдущем такте не было ни активного MREQ, ни обращения к #FE. Это ровно
таблица FAQ: у цикла памяти платит T1; у порта с чётным адресом — T2 (`C:3`), T1 платит только если
старший байт контендуемый (`C:1`); у порта с нечётным адресом и контендуемым старшим байтом платит каждый
такт (`C:1 ×4`); у порта с нечётным адресом и обычным старшим байтом — никто (`N:4`).

## 2. Прямой прибор: форма окна независимо от программы

Программа: `harness/prog/marker_5000.bin` по 0x5000 (банк 5, контендуемое ОЗУ): `EI; HALT` в цикле, то есть
процессор непрерывно делает M1 по 4 T по контендуемому адресу. Прибор печатает строку растра по пикселям
(`cn` = `dut.Video.cn` на каждом `ne7M0`, индекс = `hc`) и по тактам (на каждом `pe3M5`: `vduC`,
`vduC && cpuck`, `contend==0`; индекс = номер `pe3M5` в строке, `pe3M5` стоят на чётных `hc`, индекс i ↔ hc = 2i).
Логи: `logs/run_MACHINE=48_PROG=..-marker_5000.bin_ORG=5000_FRAMESTAT=1_QUIET=1_WINLINE={0,100,191}_RUNUS=45000.log`,
то же для `MACHINE=128 WINLINE=0` и `MACHINE=PENT WINLINE=100`.

48K, строка 0 (строки 100 и 191 — байт в байт те же строки, только k другой):

```
по пикселям (индекс = hc, 448 px):
  cn    : ...############....############....############....############....############....############....############....############....############....############....############....############....############....############....############....############...(дальше 0 до конца строки)
  paper : ............PPPP…(256 px)…PPPP....…  бумага на выходе r/g/b с hc=12 по hc=267
по тактам (индекс = номер pe3M5 в строке, 224 T):
  vduC        : ..######..######..######..######..######..######..######..######..######..######..######..######..######..######..######..######................(96 свободных)
  contend==0  : ....####....####....####....####....####....####....####....####....####....####....####....####....####....####....####....####................
```

| измерение | 48K | 128K | Пентагон |
|---|---|---|---|
| `cn` по пикселям в группе 16 px (индекс `hc`) | hc 3..14 = 12 px из 16 | то же | то же (сигнал есть, в гейт не входит) |
| `cn` первый / последний пиксель строки (hc) | 3 / 254 | 3 / 254 | 3 / 254 |
| `vduC` на импульсах `pe3M5` в группе 8 T | индексы 2..7 = **6 из 8** (hc 4,6,8,10,12,14; hUla 5..15) | то же | то же |
| занято `vduC` за строку | **96 T из 224** (16 групп × 6) | 96 из 228 | 96 из 224 (не действует) |
| строки с `vduC` | 0..191 | 0..191 | — |
| первый импульс `pe3M5` с `vduC=1` после /INT: k (t = k−2) | **14338 (t 14336)**, hUla 5, vCount 0 | **14364 (t 14362)**, hUla 5, vCount 0 | 64 (vCount 240; окно есть, гейт выключен) |
| то же, строка 100 / 191 | 36738 / 57122 (= 14338 + 224·n) | — | 40384 |
| первый пиксель `cn=1` после /INT, px от спада (`ne7M0`) | 28675 (hCount 4, vCount 0) | — | 127 (vCount 240) |
| первый пиксель бумаги на видеовыходе (r=g=b=0 при !blank), px | 28684 (hCount 13, vCount 0) = **+9 px** после начала `cn` | — | 138 (paper_h=2: +2 px) |
| потеряно за кадр при `HALT` в 0x5000 (кадр 2, установившийся) | **12288 = 192 × 64** (`pe3M5` 69888, `pc3M5` 57600) | 13246 в кадре 1 (кадр 2 не уместился в 45 мс; ожидание 12288) | **0** (71680 / 71680) |
| потерянные такты `HALT`-цикла в группе 8 T | индексы 4..7: 4 из 8 (M1 по 4 T садится в фазу «T1 на hc 6» и платит 4) | то же | нет |

Как читать «+1» у 14338/14364: импульс k завершает такт k−1. Импульс 14338 (t=14336) — первый погашаемый,
он удлиняет такт, начавшийся на t=14335. По Fuse задержка 6 назначается такту, НАЧАВШЕМУСЯ на 14335. То есть
наше окно на импульсах стоит ровно там, где нужно, чтобы цикл с T1 на t=14335 получил 6, на 14336 — 5 и т. д.
(проверено программой в разделе 3). У 128K соответственно 14361.

Пиксель против окна: у нас бумага выходит на видеовыход на 9 px позже первого пикселя `cn` (hc 3 → hc 12).
У Сергея (`REFERENCE_SERGEY.md` §7.2) `CONTENTION` и `picture` поднимаются на одном count'е, а бумага дальше идёт
через 9 пиксельных стадий (`pap_tap = 9`) — тоже +9 px к выходу. Сопоставление «пиксель ↔ INT» в тактах — предмет
стенда intgeo, здесь только зафиксировано.

Гистограмма потерь по фазе `hUla[3:1]` за 45 мс `HALT` в 0x5000 (48K): фазы 0,1 (hUla 0..3) — 0 и 0; фазы 2..7 —
459, 900, 7171, 7457, 7539, 7548. Потери только внутри окна `hUla[3]||hUla[2]`; неравномерность — свойство
4-тактного цикла `HALT`, не окна.

### Сводка по всем свипам

| машина | команда | цель | доступов | совпало с моделью | расхождений | t мин..макс |
|---|---|---|---|---|---|---|
| 128K | OUTC | порт 7FFD (7FFD=00) | 90 | 90 | 0 | 14363..14631 |
| 128K | OUTC | порт FFFD (7FFD=00) | 54 | 54 | 0 | 14363..14580 |
| 128K | OUTC | порт FFFD (7FFD=01) | 54 | 54 | 0 | 14363..14623 |
| 128K | OUTFE | порт 02FE (7FFD=00) | 90 | 90 | 0 | 14363..14589 |
| 128K | RD | адрес 4000 (7FFD=00) | 216 | 216 | 0 | 14360..14783 |
| 128K | RD | адрес C000 (7FFD=00) | 0 | 0 | 0 | -..- |
| 128K | RD | адрес C000 (7FFD=01) | 90 | 90 | 0 | 14360..14563 |
| 48K | INCHL | адрес 4000 | 72 | 72 | 0 | 14332..14571 |
| 48K | INC | порт 7FFD | 90 | 90 | 0 | 14335..14609 |
| 48K | INFE | порт 02FE | 90 | 90 | 0 | 14335..14563 |
| 48K | OUTC | порт 40FE | 72 | 72 | 0 | 14335..14576 |
| 48K | OUTC | порт 7FFD | 90 | 90 | 0 | 14335..14609 |
| 48K | OUTC | порт FFFD | 54 | 54 | 0 | 14335..14552 |
| 48K | OUTFE | порт 02FE | 90 | 90 | 0 | 14335..14563 |
| 48K | RD | адрес 4000 | 234 | 234 | 0 | 14332..14753 |
| 48K | RD | адрес 4000 | 90 | 90 | 0 | 57116..57515 |
| 48K | WR | адрес 4000 | 180 | 180 | 0 | 14332..14646 |

## 3. (a)/(b) Таблицы «смещение T от INT → задержка» по командам

Метод. Программа `prog/im2sweep.asm` в НЕконтендуемом ОЗУ 0x8000 (банк 2): `IM 2`, `EI; HALT`. Обработчик по
0x8383 собирает стенд (`build_handler`): `JP` → паддинг PADT тактов (циклы `LD B,n/DJNZ` + `NOP/INC DE/LD E,n/LD R,A`,
всё в 0x83xx) → `LD A,AVAL; LD BC,PORT` → измеряемая команда по 0x8400 → ещё 8 блоков `LD A,AVAL; паддинг с остатком
j mod 8 (0,9,6,7,4,13,10,11 T); команда` → `NOP EI RET`. После задержки контеншена фаза выравнивается, поэтому блок j
попадает в фазу j+const — за один кадр снимаются все 8 фаз узора, а PADT растёт на 1 с каждым прерыванием и даёт
соседние t с шагом 1. Решётка `HALT` (4 T) удерживается: на `RET` стенд дописывает по 0x8370 компенсацию, чтобы путь
«приём INT → следующий HALT» был кратен 4 (kacc одинаков во всех кадрах свипа, `SWEEP DONE ... kacc min/max`).
Прибор (`ACCLOG=1`): каждый интервал шины с контендуемым адресом или циклом ввода-вывода — k импульса, начавшего его T1,
hUla/vCount в этот момент, длина в `pe3M5`, число погашенных импульсов и их k. Сверка: `fuse_model.expect_access`
(правила из задания) при t = k − 2. Полные таблицы всех доступов — `python3 analyze.py` в каталоге; здесь — зоны краёв
(начало окна, конец окна первой строки, начало следующей строки, строки 191/192) и сводка по фазам.

### 128K OUTC порт 7FFD (7FFD=00)

Лог: `run_MACHINE=128_PROG=prog-im2sweep.bin_ORG=8000_ISR=1_CHAIN=8_ACCLOG=1_QUIET=1_INSTR=OUTC_PORT=7FFD_PADT=14307_SWEEP=10_RUNUS=240000.log`; 90 доступов к цели, совпали с моделью: 90, расхождений: 0; диапазон t: 14363..14631; SWEEP DONE: 10 прерываний, 101 доступов; kacc min/max=4/4; потеряно всего 579 (в бумаге 579)

| t (T от INT) | k | hUla | vCount | потеряно (RTL) | ожидание (Fuse) | длина интервала RTL / ожид. | совп. | потерянные k |
|---|---|---|---|---|---|---|---|---|
| 14363 | 14365 | 7 | 0 | 10 | 10 | 14 / 14 | да | 14366 14367 14368 14369 14372 14373 14374 14375 14376 14377 |
| 14364 | 14366 | 9 | 0 | 9 | 9 | 13 / 13 | да | 14367 14368 14369 14372 14373 14374 14375 14376 14377 |
| 14365 | 14367 | 11 | 0 | 8 | 8 | 12 / 12 | да | 14368 14369 14372 14373 14374 14375 14376 14377 |
| 14366 | 14368 | 13 | 0 | 7 | 7 | 11 / 11 | да | 14369 14372 14373 14374 14375 14376 14377 |
| 14367 | 14369 | 15 | 0 | 6 | 6 | 10 / 10 | да | 14372 14373 14374 14375 14376 14377 |
| 14368 | 14370 | 17 | 0 | 12 | 12 | 16 / 16 | да | 14372 14373 14374 14375 14376 14377 14380 14381 14382 14383 14384 14385 |
| 14369 | 14371 | 19 | 0 | 12 | 12 | 16 / 16 | да | 14372 14373 14374 14375 14376 14377 14380 14381 14382 14383 14384 14385 |
| 14370 | 14372 | 21 | 0 | 11 | 11 | 15 / 15 | да | 14373 14374 14375 14376 14377 14380 14381 14382 14383 14384 14385 |
| 14371 | 14373 | 23 | 0 | 10 | 10 | 14 / 14 | да | 14374 14375 14376 14377 14380 14381 14382 14383 14384 14385 |
| 14372 | 14374 | 25 | 0 | 9 | 9 | 13 / 13 | да | 14375 14376 14377 14380 14381 14382 14383 14384 14385 |
| 14587 | 14589 | 455 | 0 | 6 | 6 | 10 / 10 | да | 14592 14593 14594 14595 14596 14597 |
| 14595 | 14597 | 15 | 1 | 6 | 6 | 10 / 10 | да | 14600 14601 14602 14603 14604 14605 |

Потери по фазе начала T1 (t − 14361) mod 8 внутри окна (RTL/модель, все встреченные пары): 0: 12/12, 1: 11/11, 2: 6/6/10/10, 3: 9/9, 4: 8/8, 5: 7/7, 6: 6/6/10/10, 7: 12/12

### 128K OUTC порт FFFD (7FFD=00)

Лог: `run_MACHINE=128_PROG=prog-im2sweep.bin_ORG=8000_ISR=1_CHAIN=8_ACCLOG=1_QUIET=1_INSTR=OUTC_PORT=FFFD_P7FFD=00_PADT=14307_SWEEP=6_RUNUS=160000.log`; 54 доступов к цели, совпали с моделью: 54, расхождений: 0; диапазон t: 14363..14580; SWEEP DONE: 6 прерываний, 61 доступов; kacc min/max=4/4; потеряно всего 12 (в бумаге 12)

| t (T от INT) | k | hUla | vCount | потеряно (RTL) | ожидание (Fuse) | длина интервала RTL / ожид. | совп. | потерянные k |
|---|---|---|---|---|---|---|---|---|
| 14363 | 14365 | 7 | 0 | 0 | 0 | 4 / 4 | да |  |
| 14364 | 14366 | 9 | 0 | 0 | 0 | 4 / 4 | да |  |
| 14365 | 14367 | 11 | 0 | 0 | 0 | 4 / 4 | да |  |
| 14366 | 14368 | 13 | 0 | 0 | 0 | 4 / 4 | да |  |
| 14367 | 14369 | 15 | 0 | 0 | 0 | 4 / 4 | да |  |
| 14368 | 14370 | 17 | 0 | 0 | 0 | 4 / 4 | да |  |
| 14485 | 14487 | 251 | 0 | 0 | 0 | 4 / 4 | да |  |
| 14486 | 14488 | 253 | 0 | 0 | 0 | 4 / 4 | да |  |
| 14487 | 14489 | 255 | 0 | 0 | 0 | 4 / 4 | да |  |
| 14488 | 14490 | 257 | 0 | 0 | 0 | 4 / 4 | да |  |
| 14489 | 14491 | 259 | 0 | 0 | 0 | 4 / 4 | да |  |

Потери по фазе начала T1 (t − 14361) mod 8 внутри окна (RTL/модель, все встреченные пары): 0: 0/0, 1: 0/0, 2: 0/0, 3: 0/0, 4: 0/0, 5: 0/0, 6: 0/0, 7: 0/0

### 128K OUTC порт FFFD (7FFD=01)

Лог: `run_MACHINE=128_PROG=prog-im2sweep.bin_ORG=8000_ISR=1_CHAIN=8_ACCLOG=1_QUIET=1_INSTR=OUTC_PORT=FFFD_P7FFD=01_PADT=14307_SWEEP=6_RUNUS=160000.log`; 54 доступов к цели, совпали с моделью: 54, расхождений: 0; диапазон t: 14363..14623; SWEEP DONE: 6 прерываний, 61 доступов; kacc min/max=4/4; потеряно всего 345 (в бумаге 345)

| t (T от INT) | k | hUla | vCount | потеряно (RTL) | ожидание (Fuse) | длина интервала RTL / ожид. | совп. | потерянные k |
|---|---|---|---|---|---|---|---|---|
| 14363 | 14365 | 7 | 0 | 10 | 10 | 14 / 14 | да | 14366 14367 14368 14369 14372 14373 14374 14375 14376 14377 |
| 14364 | 14366 | 9 | 0 | 9 | 9 | 13 / 13 | да | 14367 14368 14369 14372 14373 14374 14375 14376 14377 |
| 14365 | 14367 | 11 | 0 | 8 | 8 | 12 / 12 | да | 14368 14369 14372 14373 14374 14375 14376 14377 |
| 14366 | 14368 | 13 | 0 | 7 | 7 | 11 / 11 | да | 14369 14372 14373 14374 14375 14376 14377 |
| 14367 | 14369 | 15 | 0 | 6 | 6 | 10 / 10 | да | 14372 14373 14374 14375 14376 14377 |
| 14368 | 14370 | 17 | 0 | 12 | 12 | 16 / 16 | да | 14372 14373 14374 14375 14376 14377 14380 14381 14382 14383 14384 14385 |
| 14587 | 14589 | 455 | 0 | 6 | 6 | 10 / 10 | да | 14592 14593 14594 14595 14596 14597 |

Потери по фазе начала T1 (t − 14361) mod 8 внутри окна (RTL/модель, все встреченные пары): 0: 12/12, 2: 10/10, 3: 9/9, 4: 8/8, 5: 7/7, 6: 6/6/10/10, 7: 12/12

### 128K OUTFE порт 02FE (7FFD=00)

Лог: `run_MACHINE=128_PROG=prog-im2sweep.bin_ORG=8000_ISR=1_CHAIN=8_ACCLOG=1_QUIET=1_INSTR=OUTFE_PADT=14308_SWEEP=10_RUNUS=240000.log`; 90 доступов к цели, совпали с моделью: 90, расхождений: 0; диапазон t: 14363..14589; SWEEP DONE: 10 прерываний, 101 доступов; kacc min/max=4/4; потеряно всего 172 (в бумаге 172)

| t (T от INT) | k | hUla | vCount | потеряно (RTL) | ожидание (Fuse) | длина интервала RTL / ожид. | совп. | потерянные k |
|---|---|---|---|---|---|---|---|---|
| 14363 | 14365 | 7 | 0 | 3 | 3 | 7 / 7 | да | 14367 14368 14369 |
| 14364 | 14366 | 9 | 0 | 2 | 2 | 6 / 6 | да | 14368 14369 |
| 14365 | 14367 | 11 | 0 | 1 | 1 | 5 / 5 | да | 14369 |
| 14366 | 14368 | 13 | 0 | 0 | 0 | 4 / 4 | да |  |
| 14367 | 14369 | 15 | 0 | 0 | 0 | 4 / 4 | да |  |
| 14368 | 14370 | 17 | 0 | 6 | 6 | 10 / 10 | да | 14372 14373 14374 14375 14376 14377 |
| 14369 | 14371 | 19 | 0 | 5 | 5 | 9 / 9 | да | 14373 14374 14375 14376 14377 |
| 14370 | 14372 | 21 | 0 | 4 | 4 | 8 / 8 | да | 14374 14375 14376 14377 |
| 14371 | 14373 | 23 | 0 | 3 | 3 | 7 / 7 | да | 14375 14376 14377 |
| 14372 | 14374 | 25 | 0 | 2 | 2 | 6 / 6 | да | 14376 14377 |
| 14493 | 14495 | 267 | 0 | 0 | 0 | 4 / 4 | да |  |
| 14589 | 14591 | 3 | 1 | 5 | 5 | 9 / 9 | да | 14593 14594 14595 14596 14597 |

Потери по фазе начала T1 (t − 14361) mod 8 внутри окна (RTL/модель, все встреченные пары): 0: 5/5, 1: 4/4, 2: 3/3, 3: 2/2, 4: 1/1/5/5, 5: 0/0, 6: 0/0, 7: 6/6

### 128K RD адрес 4000 (7FFD=00)

Лог: `run_MACHINE=128_PROG=prog-im2sweep.bin_ORG=8000_ISR=1_CHAIN=8_ACCLOG=1_QUIET=1_INSTR=RD_HLV=4000_PADT=14308_SWEEP=12_PADT2=14436_SWEEP2=6_PADT3=14536_SWEEP3=6_RUNUS=520000.log`; 216 доступов к цели, совпали с моделью: 216, расхождений: 0; диапазон t: 14360..14783; SWEEP DONE: 24 прерываний, 241 доступов; kacc min/max=4/4; потеряно всего 385 (в бумаге 385)

| t (T от INT) | k | hUla | vCount | потеряно (RTL) | ожидание (Fuse) | длина интервала RTL / ожид. | совп. | потерянные k |
|---|---|---|---|---|---|---|---|---|
| 14360 | 14362 | 1 | 0 | 0 | 0 | 3 / 3 | да |  |
| 14361 | 14363 | 3 | 0 | 6 | 6 | 9 / 9 | да | 14364 14365 14366 14367 14368 14369 |
| 14362 | 14364 | 5 | 0 | 5 | 5 | 8 / 8 | да | 14365 14366 14367 14368 14369 |
| 14363 | 14365 | 7 | 0 | 4 | 4 | 7 / 7 | да | 14366 14367 14368 14369 |
| 14364 | 14366 | 9 | 0 | 3 | 3 | 6 / 6 | да | 14367 14368 14369 |
| 14365 | 14367 | 11 | 0 | 2 | 2 | 5 / 5 | да | 14368 14369 |
| 14366 | 14368 | 13 | 0 | 1 | 1 | 4 / 4 | да | 14369 |
| 14367 | 14369 | 15 | 0 | 0 | 0 | 3 / 3 | да |  |
| 14368 | 14370 | 17 | 0 | 0 | 0 | 3 / 3 | да |  |
| 14369 | 14371 | 19 | 0 | 6 | 6 | 9 / 9 | да | 14372 14373 14374 14375 14376 14377 |
| 14370 | 14372 | 21 | 0 | 5 | 5 | 8 / 8 | да | 14373 14374 14375 14376 14377 |
| 14371 | 14373 | 23 | 0 | 4 | 4 | 7 / 7 | да | 14374 14375 14376 14377 |
| 14374 | 14376 | 29 | 0 | 1 | 1 | 4 / 4 | да | 14377 |
| 14488 | 14490 | 257 | 0 | 0 | 0 | 3 / 3 | да |  |
| 14489 | 14491 | 259 | 0 | 0 | 0 | 3 / 3 | да |  |
| 14490 | 14492 | 261 | 0 | 0 | 0 | 3 / 3 | да |  |
| 14491 | 14493 | 263 | 0 | 0 | 0 | 3 / 3 | да |  |
| 14492 | 14494 | 265 | 0 | 0 | 0 | 3 / 3 | да |  |
| 14493 | 14495 | 267 | 0 | 0 | 0 | 3 / 3 | да |  |
| 14585 | 14587 | 451 | 0 | 0 | 0 | 3 / 3 | да |  |
| 14586 | 14588 | 453 | 0 | 0 | 0 | 3 / 3 | да |  |
| 14587 | 14589 | 455 | 0 | 0 | 0 | 3 / 3 | да |  |
| 14588 | 14590 | 1 | 1 | 0 | 0 | 3 / 3 | да |  |
| 14589 | 14591 | 3 | 1 | 6 | 6 | 9 / 9 | да | 14592 14593 14594 14595 14596 14597 |
| 14590 | 14592 | 5 | 1 | 5 | 5 | 8 / 8 | да | 14593 14594 14595 14596 14597 |
| 14591 | 14593 | 7 | 1 | 4 | 4 | 7 / 7 | да | 14594 14595 14596 14597 |
| 14592 | 14594 | 9 | 1 | 3 | 3 | 6 / 6 | да | 14595 14596 14597 |
| 14593 | 14595 | 11 | 1 | 2 | 2 | 5 / 5 | да | 14596 14597 |

Потери по фазе начала T1 (t − 14361) mod 8 внутри окна (RTL/модель, все встреченные пары): 0: 2/2/6/6, 1: 1/1/5/5, 2: 0/0/4/4, 3: 0/0/3/3, 4: 2/2/6/6, 5: 1/1/5/5, 6: 0/0/4/4, 7: 0/0/3/3

### 128K RD адрес C000 (7FFD=00)

Лог: `run_MACHINE=128_PROG=prog-im2sweep.bin_ORG=8000_ISR=1_CHAIN=8_ACCLOG=1_QUIET=1_INSTR=RD_HLV=C000_P7FFD=00_PADT=14308_SWEEP=4_RUNUS=120000.log`; 0 доступов к цели, совпали с моделью: 0, расхождений: 0; диапазон t: -..-; SWEEP DONE: 4 прерываний, 5 доступов; kacc min/max=4/4; потеряно всего 12 (в бумаге 12)

### 128K RD адрес C000 (7FFD=01)

Лог: `run_MACHINE=128_PROG=prog-im2sweep.bin_ORG=8000_ISR=1_CHAIN=8_ACCLOG=1_QUIET=1_INSTR=RD_HLV=C000_P7FFD=01_PADT=14308_SWEEP=10_RUNUS=240000.log`; 90 доступов к цели, совпали с моделью: 90, расхождений: 0; диапазон t: 14360..14563; SWEEP DONE: 10 прерываний, 101 доступов; kacc min/max=4/4; потеряно всего 197 (в бумаге 197)

| t (T от INT) | k | hUla | vCount | потеряно (RTL) | ожидание (Fuse) | длина интервала RTL / ожид. | совп. | потерянные k |
|---|---|---|---|---|---|---|---|---|
| 14360 | 14362 | 1 | 0 | 0 | 0 | 3 / 3 | да |  |
| 14361 | 14363 | 3 | 0 | 6 | 6 | 9 / 9 | да | 14364 14365 14366 14367 14368 14369 |
| 14362 | 14364 | 5 | 0 | 5 | 5 | 8 / 8 | да | 14365 14366 14367 14368 14369 |
| 14363 | 14365 | 7 | 0 | 4 | 4 | 7 / 7 | да | 14366 14367 14368 14369 |
| 14364 | 14366 | 9 | 0 | 3 | 3 | 6 / 6 | да | 14367 14368 14369 |
| 14365 | 14367 | 11 | 0 | 2 | 2 | 5 / 5 | да | 14368 14369 |
| 14366 | 14368 | 13 | 0 | 1 | 1 | 4 / 4 | да | 14369 |
| 14367 | 14369 | 15 | 0 | 0 | 0 | 3 / 3 | да |  |
| 14368 | 14370 | 17 | 0 | 0 | 0 | 3 / 3 | да |  |
| 14369 | 14371 | 19 | 0 | 6 | 6 | 9 / 9 | да | 14372 14373 14374 14375 14376 14377 |
| 14374 | 14376 | 29 | 0 | 1 | 1 | 4 / 4 | да | 14377 |

Потери по фазе начала T1 (t − 14361) mod 8 внутри окна (RTL/модель, все встреченные пары): 0: 6/6, 1: 5/5, 2: 4/4, 3: 3/3, 4: 2/2, 5: 1/1, 6: 0/0, 7: 0/0

### 48K INCHL адрес 4000

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

| t (T от INT) | k | hUla | vCount | потеряно (RTL) | ожидание (Fuse) | длина интервала RTL / ожид. | совп. | потерянные k |
|---|---|---|---|---|---|---|---|---|
| 14335 | 14337 | 3 | 0 | 5 | 5 | 9 / 9 | да | 14339 14340 14341 14342 14343 |
| 14336 | 14338 | 5 | 0 | 4 | 4 | 8 / 8 | да | 14340 14341 14342 14343 |
| 14337 | 14339 | 7 | 0 | 3 | 3 | 7 / 7 | да | 14341 14342 14343 |
| 14338 | 14340 | 9 | 0 | 2 | 2 | 6 / 6 | да | 14342 14343 |
| 14339 | 14341 | 11 | 0 | 1 | 1 | 5 / 5 | да | 14343 |
| 14340 | 14342 | 13 | 0 | 0 | 0 | 4 / 4 | да |  |
| 14341 | 14343 | 15 | 0 | 0 | 0 | 4 / 4 | да |  |
| 14342 | 14344 | 17 | 0 | 6 | 6 | 10 / 10 | да | 14346 14347 14348 14349 14350 14351 |
| 14343 | 14345 | 19 | 0 | 5 | 5 | 9 / 9 | да | 14347 14348 14349 14350 14351 |
| 14344 | 14346 | 21 | 0 | 4 | 4 | 8 / 8 | да | 14348 14349 14350 14351 |
| 14467 | 14469 | 267 | 0 | 0 | 0 | 4 / 4 | да |  |
| 14555 | 14557 | 443 | 0 | 0 | 0 | 4 / 4 | да |  |
| 14563 | 14565 | 11 | 1 | 1 | 1 | 5 / 5 | да | 14567 |

Потери по фазе начала T1 (t − 14335) mod 8 внутри окна (RTL/модель, все встреченные пары): 0: 5/5, 1: 4/4, 2: 3/3, 3: 2/2, 4: 1/1, 5: 0/0, 6: 0/0, 7: 6/6

### 48K OUTC порт 40FE

Лог: `run_MACHINE=48_PROG=prog-im2sweep.bin_ORG=8000_ISR=1_CHAIN=8_ACCLOG=1_QUIET=1_INSTR=OUTC_PORT=40FE_PADT=14281_SWEEP=8_RUNUS=200000.log`; 72 доступов к цели, совпали с моделью: 72, расхождений: 0; диапазон t: 14335..14576; SWEEP DONE: 8 прерываний, 81 доступов; kacc min/max=2/2; потеряно всего 249 (в бумаге 249)

| t (T от INT) | k | hUla | vCount | потеряно (RTL) | ожидание (Fuse) | длина интервала RTL / ожид. | совп. | потерянные k |
|---|---|---|---|---|---|---|---|---|
| 14335 | 14337 | 3 | 0 | 6 | 6 | 10 / 10 | да | 14338 14339 14340 14341 14342 14343 |
| 14336 | 14338 | 5 | 0 | 5 | 5 | 9 / 9 | да | 14339 14340 14341 14342 14343 |
| 14337 | 14339 | 7 | 0 | 4 | 4 | 8 / 8 | да | 14340 14341 14342 14343 |
| 14338 | 14340 | 9 | 0 | 3 | 3 | 7 / 7 | да | 14341 14342 14343 |
| 14339 | 14341 | 11 | 0 | 2 | 2 | 6 / 6 | да | 14342 14343 |
| 14340 | 14342 | 13 | 0 | 1 | 1 | 5 / 5 | да | 14343 |
| 14341 | 14343 | 15 | 0 | 0 | 0 | 4 / 4 | да |  |
| 14342 | 14344 | 17 | 0 | 6 | 6 | 10 / 10 | да | 14346 14347 14348 14349 14350 14351 |
| 14462 | 14464 | 257 | 0 | 0 | 0 | 4 / 4 | да |  |

Потери по фазе начала T1 (t − 14335) mod 8 внутри окна (RTL/модель, все встреченные пары): 0: 6/6, 1: 5/5, 2: 4/4, 3: 3/3, 4: 2/2, 5: 1/1, 6: 0/0, 7: 0/0/6/6

### 48K OUTC порт 7FFD

Лог: `run_MACHINE=48_PROG=prog-im2sweep.bin_ORG=8000_ISR=1_CHAIN=8_ACCLOG=1_QUIET=1_INSTR=OUTC_PORT=7FFD_PADT=14281_SWEEP=10_RUNUS=240000.log`; 90 доступов к цели, совпали с моделью: 90, расхождений: 0; диапазон t: 14335..14609; SWEEP DONE: 10 прерываний, 101 доступов; kacc min/max=2/2; потеряно всего 623 (в бумаге 623)

| t (T от INT) | k | hUla | vCount | потеряно (RTL) | ожидание (Fuse) | длина интервала RTL / ожид. | совп. | потерянные k |
|---|---|---|---|---|---|---|---|---|
| 14335 | 14337 | 3 | 0 | 12 | 12 | 16 / 16 | да | 14338 14339 14340 14341 14342 14343 14346 14347 14348 14349 14350 14351 |
| 14336 | 14338 | 5 | 0 | 11 | 11 | 15 / 15 | да | 14339 14340 14341 14342 14343 14346 14347 14348 14349 14350 14351 |
| 14337 | 14339 | 7 | 0 | 10 | 10 | 14 / 14 | да | 14340 14341 14342 14343 14346 14347 14348 14349 14350 14351 |
| 14338 | 14340 | 9 | 0 | 9 | 9 | 13 / 13 | да | 14341 14342 14343 14346 14347 14348 14349 14350 14351 |
| 14339 | 14341 | 11 | 0 | 8 | 8 | 12 / 12 | да | 14342 14343 14346 14347 14348 14349 14350 14351 |
| 14340 | 14342 | 13 | 0 | 7 | 7 | 11 / 11 | да | 14343 14346 14347 14348 14349 14350 14351 |
| 14341 | 14343 | 15 | 0 | 6 | 6 | 10 / 10 | да | 14346 14347 14348 14349 14350 14351 |
| 14342 | 14344 | 17 | 0 | 12 | 12 | 16 / 16 | да | 14346 14347 14348 14349 14350 14351 14354 14355 14356 14357 14358 14359 |
| 14343 | 14345 | 19 | 0 | 12 | 12 | 16 / 16 | да | 14346 14347 14348 14349 14350 14351 14354 14355 14356 14357 14358 14359 |
| 14344 | 14346 | 21 | 0 | 11 | 11 | 15 / 15 | да | 14347 14348 14349 14350 14351 14354 14355 14356 14357 14358 14359 |
| 14561 | 14563 | 7 | 1 | 10 | 10 | 14 / 14 | да | 14564 14565 14566 14567 14570 14571 14572 14573 14574 14575 |
| 14569 | 14571 | 23 | 1 | 10 | 10 | 14 / 14 | да | 14572 14573 14574 14575 14578 14579 14580 14581 14582 14583 |

Потери по фазе начала T1 (t − 14335) mod 8 внутри окна (RTL/модель, все встреченные пары): 0: 12/12, 1: 11/11, 2: 10/10, 3: 9/9, 4: 8/8, 5: 7/7, 6: 6/6, 7: 12/12

### 48K OUTC порт FFFD

Лог: `run_MACHINE=48_PROG=prog-im2sweep.bin_ORG=8000_ISR=1_CHAIN=8_ACCLOG=1_QUIET=1_INSTR=OUTC_PORT=FFFD_PADT=14281_SWEEP=6_RUNUS=160000.log`; 54 доступов к цели, совпали с моделью: 54, расхождений: 0; диапазон t: 14335..14552; SWEEP DONE: 6 прерываний, 61 доступов; kacc min/max=2/2; потеряно всего 12 (в бумаге 12)

| t (T от INT) | k | hUla | vCount | потеряно (RTL) | ожидание (Fuse) | длина интервала RTL / ожид. | совп. | потерянные k |
|---|---|---|---|---|---|---|---|---|
| 14335 | 14337 | 3 | 0 | 0 | 0 | 4 / 4 | да |  |
| 14336 | 14338 | 5 | 0 | 0 | 0 | 4 / 4 | да |  |
| 14337 | 14339 | 7 | 0 | 0 | 0 | 4 / 4 | да |  |
| 14338 | 14340 | 9 | 0 | 0 | 0 | 4 / 4 | да |  |
| 14339 | 14341 | 11 | 0 | 0 | 0 | 4 / 4 | да |  |
| 14340 | 14342 | 13 | 0 | 0 | 0 | 4 / 4 | да |  |
| 14456 | 14458 | 245 | 0 | 0 | 0 | 4 / 4 | да |  |
| 14457 | 14459 | 247 | 0 | 0 | 0 | 4 / 4 | да |  |
| 14458 | 14460 | 249 | 0 | 0 | 0 | 4 / 4 | да |  |
| 14459 | 14461 | 251 | 0 | 0 | 0 | 4 / 4 | да |  |
| 14460 | 14462 | 253 | 0 | 0 | 0 | 4 / 4 | да |  |
| 14461 | 14463 | 255 | 0 | 0 | 0 | 4 / 4 | да |  |

Потери по фазе начала T1 (t − 14335) mod 8 внутри окна (RTL/модель, все встреченные пары): 0: 0/0, 1: 0/0, 2: 0/0, 3: 0/0, 4: 0/0, 5: 0/0, 6: 0/0, 7: 0/0

### 48K OUTFE порт 02FE

Лог: `run_MACHINE=48_PROG=prog-im2sweep.bin_ORG=8000_ISR=1_CHAIN=8_ACCLOG=1_QUIET=1_INSTR=OUTFE_PADT=14282_SWEEP=10_RUNUS=240000.log`; 90 доступов к цели, совпали с моделью: 90, расхождений: 0; диапазон t: 14335..14563; SWEEP DONE: 10 прерываний, 101 доступов; kacc min/max=2/2; потеряно всего 154 (в бумаге 154)

| t (T от INT) | k | hUla | vCount | потеряно (RTL) | ожидание (Fuse) | длина интервала RTL / ожид. | совп. | потерянные k |
|---|---|---|---|---|---|---|---|---|
| 14335 | 14337 | 3 | 0 | 5 | 5 | 9 / 9 | да | 14339 14340 14341 14342 14343 |
| 14336 | 14338 | 5 | 0 | 4 | 4 | 8 / 8 | да | 14340 14341 14342 14343 |
| 14337 | 14339 | 7 | 0 | 3 | 3 | 7 / 7 | да | 14341 14342 14343 |
| 14338 | 14340 | 9 | 0 | 2 | 2 | 6 / 6 | да | 14342 14343 |
| 14339 | 14341 | 11 | 0 | 1 | 1 | 5 / 5 | да | 14343 |
| 14340 | 14342 | 13 | 0 | 0 | 0 | 4 / 4 | да |  |
| 14341 | 14343 | 15 | 0 | 0 | 0 | 4 / 4 | да |  |
| 14342 | 14344 | 17 | 0 | 6 | 6 | 10 / 10 | да | 14346 14347 14348 14349 14350 14351 |
| 14343 | 14345 | 19 | 0 | 5 | 5 | 9 / 9 | да | 14347 14348 14349 14350 14351 |
| 14344 | 14346 | 21 | 0 | 4 | 4 | 8 / 8 | да | 14348 14349 14350 14351 |
| 14467 | 14469 | 267 | 0 | 0 | 0 | 4 / 4 | да |  |
| 14555 | 14557 | 443 | 0 | 0 | 0 | 4 / 4 | да |  |
| 14563 | 14565 | 11 | 1 | 1 | 1 | 5 / 5 | да | 14567 |

Потери по фазе начала T1 (t − 14335) mod 8 внутри окна (RTL/модель, все встреченные пары): 0: 5/5, 1: 4/4, 2: 3/3, 3: 2/2, 4: 1/1, 5: 0/0, 6: 0/0, 7: 6/6

### 48K RD адрес 4000

Лог: `run_MACHINE=48_PROG=prog-im2sweep.bin_ORG=8000_ISR=1_CHAIN=8_ACCLOG=1_QUIET=1_INSTR=RD_PADT=14282_SWEEP=12_PADT2=14410_SWEEP2=8_PADT3=14506_SWEEP3=6_RUNUS=560000.log`; 234 доступов к цели, совпали с моделью: 234, расхождений: 0; диапазон t: 14332..14753; SWEEP DONE: 26 прерываний, 261 доступов; kacc min/max=2/2; потеряно всего 401 (в бумаге 401)

| t (T от INT) | k | hUla | vCount | потеряно (RTL) | ожидание (Fuse) | длина интервала RTL / ожид. | совп. | потерянные k |
|---|---|---|---|---|---|---|---|---|
| 14332 | 14334 | 445 | 311 | 0 | 0 | 3 / 3 | да |  |
| 14333 | 14335 | 447 | 311 | 0 | 0 | 3 / 3 | да |  |
| 14334 | 14336 | 1 | 0 | 0 | 0 | 3 / 3 | да |  |
| 14335 | 14337 | 3 | 0 | 6 | 6 | 9 / 9 | да | 14338 14339 14340 14341 14342 14343 |
| 14336 | 14338 | 5 | 0 | 5 | 5 | 8 / 8 | да | 14339 14340 14341 14342 14343 |
| 14337 | 14339 | 7 | 0 | 4 | 4 | 7 / 7 | да | 14340 14341 14342 14343 |
| 14338 | 14340 | 9 | 0 | 3 | 3 | 6 / 6 | да | 14341 14342 14343 |
| 14339 | 14341 | 11 | 0 | 2 | 2 | 5 / 5 | да | 14342 14343 |
| 14340 | 14342 | 13 | 0 | 1 | 1 | 4 / 4 | да | 14343 |
| 14341 | 14343 | 15 | 0 | 0 | 0 | 3 / 3 | да |  |
| 14342 | 14344 | 17 | 0 | 0 | 0 | 3 / 3 | да |  |
| 14343 | 14345 | 19 | 0 | 6 | 6 | 9 / 9 | да | 14346 14347 14348 14349 14350 14351 |
| 14346 | 14348 | 25 | 0 | 3 | 3 | 6 / 6 | да | 14349 14350 14351 |
| 14347 | 14349 | 27 | 0 | 2 | 2 | 5 / 5 | да | 14350 14351 |
| 14348 | 14350 | 29 | 0 | 1 | 1 | 4 / 4 | да | 14351 |
| 14455 | 14457 | 243 | 0 | 6 | 6 | 9 / 9 | да | 14458 14459 14460 14461 14462 14463 |
| 14460 | 14462 | 253 | 0 | 1 | 1 | 4 / 4 | да | 14463 |
| 14461 | 14463 | 255 | 0 | 0 | 0 | 3 / 3 | да |  |
| 14462 | 14464 | 257 | 0 | 0 | 0 | 3 / 3 | да |  |
| 14463 | 14465 | 259 | 0 | 0 | 0 | 3 / 3 | да |  |
| 14464 | 14466 | 261 | 0 | 0 | 0 | 3 / 3 | да |  |
| 14465 | 14467 | 263 | 0 | 0 | 0 | 3 / 3 | да |  |
| 14466 | 14468 | 265 | 0 | 0 | 0 | 3 / 3 | да |  |
| 14467 | 14469 | 267 | 0 | 0 | 0 | 3 / 3 | да |  |
| 14556 | 14558 | 445 | 0 | 0 | 0 | 3 / 3 | да |  |
| 14557 | 14559 | 447 | 0 | 0 | 0 | 3 / 3 | да |  |
| 14558 | 14560 | 1 | 1 | 0 | 0 | 3 / 3 | да |  |
| 14559 | 14561 | 3 | 1 | 6 | 6 | 9 / 9 | да | 14562 14563 14564 14565 14566 14567 |
| 14560 | 14562 | 5 | 1 | 5 | 5 | 8 / 8 | да | 14563 14564 14565 14566 14567 |
| 14561 | 14563 | 7 | 1 | 4 | 4 | 7 / 7 | да | 14564 14565 14566 14567 |
| 14562 | 14564 | 9 | 1 | 3 | 3 | 6 / 6 | да | 14565 14566 14567 |
| 14563 | 14565 | 11 | 1 | 2 | 2 | 5 / 5 | да | 14566 14567 |
| 14570 | 14572 | 25 | 1 | 3 | 3 | 6 / 6 | да | 14573 14574 14575 |

Потери по фазе начала T1 (t − 14335) mod 8 внутри окна (RTL/модель, все встреченные пары): 0: 6/6, 1: 5/5, 2: 4/4, 3: 3/3, 4: 2/2, 5: 1/1, 6: 0/0, 7: 0/0

### 48K RD адрес 4000

Лог: `run_MACHINE=48_PROG=prog-im2sweep.bin_ORG=8000_ISR=1_CHAIN=8_ACCLOG=1_QUIET=1_INSTR=RD_PADT=57066_SWEEP=6_PADT2=57290_SWEEP2=4_RUNUS=240000.log`; 90 доступов к цели, совпали с моделью: 90, расхождений: 0; диапазон t: 57116..57515; SWEEP DONE: 10 прерываний, 101 доступов; kacc min/max=2/2; потеряно всего 123 (в бумаге 123)

| t (T от INT) | k | hUla | vCount | потеряно (RTL) | ожидание (Fuse) | длина интервала RTL / ожид. | совп. | потерянные k |
|---|---|---|---|---|---|---|---|---|
| 57116 | 57118 | 445 | 190 | 0 | 0 | 3 / 3 | да |  |
| 57117 | 57119 | 447 | 190 | 0 | 0 | 3 / 3 | да |  |
| 57118 | 57120 | 1 | 191 | 0 | 0 | 3 / 3 | да |  |
| 57119 | 57121 | 3 | 191 | 6 | 6 | 9 / 9 | да | 57122 57123 57124 57125 57126 57127 |
| 57120 | 57122 | 5 | 191 | 5 | 5 | 8 / 8 | да | 57123 57124 57125 57126 57127 |
| 57121 | 57123 | 7 | 191 | 4 | 4 | 7 / 7 | да | 57124 57125 57126 57127 |
| 57340 | 57342 | 445 | 191 | 0 | 0 | 3 / 3 | да |  |
| 57341 | 57343 | 447 | 191 | 0 | 0 | 3 / 3 | да |  |
| 57342 | 57344 | 1 | 192 | 0 | 0 | 3 / 3 | да |  |
| 57343 | 57345 | 3 | 192 | 0 | 0 | 3 / 3 | да |  |

Потери по фазе начала T1 (t − 14335) mod 8 внутри окна (RTL/модель, все встреченные пары): 0: 6/6, 1: 5/5, 2: 4/4, 3: 3/3, 4: 2/2, 5: 1/1

### 48K WR адрес 4000

Лог: `run_MACHINE=48_PROG=prog-im2sweep.bin_ORG=8000_ISR=1_CHAIN=8_ACCLOG=1_QUIET=1_INSTR=WR_PADT=14282_SWEEP=12_PADT2=14410_SWEEP2=8_RUNUS=440000.log`; 180 доступов к цели, совпали с моделью: 180, расхождений: 0; диапазон t: 14332..14646; SWEEP DONE: 20 прерываний, 201 доступов; kacc min/max=2/2; потеряно всего 290 (в бумаге 290)

| t (T от INT) | k | hUla | vCount | потеряно (RTL) | ожидание (Fuse) | длина интервала RTL / ожид. | совп. | потерянные k |
|---|---|---|---|---|---|---|---|---|
| 14332 | 14334 | 445 | 311 | 0 | 0 | 3 / 3 | да |  |
| 14333 | 14335 | 447 | 311 | 0 | 0 | 3 / 3 | да |  |
| 14334 | 14336 | 1 | 0 | 0 | 0 | 3 / 3 | да |  |
| 14335 | 14337 | 3 | 0 | 6 | 6 | 9 / 9 | да | 14338 14339 14340 14341 14342 14343 |
| 14336 | 14338 | 5 | 0 | 5 | 5 | 8 / 8 | да | 14339 14340 14341 14342 14343 |
| 14337 | 14339 | 7 | 0 | 4 | 4 | 7 / 7 | да | 14340 14341 14342 14343 |
| 14338 | 14340 | 9 | 0 | 3 | 3 | 6 / 6 | да | 14341 14342 14343 |
| 14339 | 14341 | 11 | 0 | 2 | 2 | 5 / 5 | да | 14342 14343 |
| 14340 | 14342 | 13 | 0 | 1 | 1 | 4 / 4 | да | 14343 |
| 14341 | 14343 | 15 | 0 | 0 | 0 | 3 / 3 | да |  |
| 14342 | 14344 | 17 | 0 | 0 | 0 | 3 / 3 | да |  |
| 14343 | 14345 | 19 | 0 | 6 | 6 | 9 / 9 | да | 14346 14347 14348 14349 14350 14351 |
| 14346 | 14348 | 25 | 0 | 3 | 3 | 6 / 6 | да | 14349 14350 14351 |
| 14347 | 14349 | 27 | 0 | 2 | 2 | 5 / 5 | да | 14350 14351 |
| 14348 | 14350 | 29 | 0 | 1 | 1 | 4 / 4 | да | 14351 |
| 14455 | 14457 | 243 | 0 | 6 | 6 | 9 / 9 | да | 14458 14459 14460 14461 14462 14463 |
| 14460 | 14462 | 253 | 0 | 1 | 1 | 4 / 4 | да | 14463 |
| 14461 | 14463 | 255 | 0 | 0 | 0 | 3 / 3 | да |  |
| 14462 | 14464 | 257 | 0 | 0 | 0 | 3 / 3 | да |  |
| 14463 | 14465 | 259 | 0 | 0 | 0 | 3 / 3 | да |  |
| 14464 | 14466 | 261 | 0 | 0 | 0 | 3 / 3 | да |  |
| 14465 | 14467 | 263 | 0 | 0 | 0 | 3 / 3 | да |  |
| 14466 | 14468 | 265 | 0 | 0 | 0 | 3 / 3 | да |  |
| 14467 | 14469 | 267 | 0 | 0 | 0 | 3 / 3 | да |  |
| 14557 | 14559 | 447 | 0 | 0 | 0 | 3 / 3 | да |  |
| 14558 | 14560 | 1 | 1 | 0 | 0 | 3 / 3 | да |  |
| 14559 | 14561 | 3 | 1 | 6 | 6 | 9 / 9 | да | 14562 14563 14564 14565 14566 14567 |
| 14560 | 14562 | 5 | 1 | 5 | 5 | 8 / 8 | да | 14563 14564 14565 14566 14567 |
| 14561 | 14563 | 7 | 1 | 4 | 4 | 7 / 7 | да | 14564 14565 14566 14567 |
| 14562 | 14564 | 9 | 1 | 3 | 3 | 6 / 6 | да | 14565 14566 14567 |
| 14563 | 14565 | 11 | 1 | 2 | 2 | 5 / 5 | да | 14566 14567 |

Потери по фазе начала T1 (t − 14335) mod 8 внутри окна (RTL/модель, все встреченные пары): 0: 6/6, 1: 5/5, 2: 4/4, 3: 3/3, 4: 2/2, 5: 1/1, 6: 0/0, 7: 0/0

## 4. (c) Плотные циклы целиком в контендуемом ОЗУ 0x6000: начисление по циклам

Программа копирует тело цикла в 0x6000 и уходит туда навсегда (`DI`), стенд считает по кадрам `pe3M5`,
`pc3M5`, потерянные такты и число M1 (`FRAMESTAT=1`, харнесный счётчик `n_m1` = фронты `!m1 && !mreq`).
Модель — `fuse_model.py` (`run_loop` / `run_contrun_rd`): тот же поток команд, каждому циклу из таблицы
Fuse (`pc:4`, `pc+1:3`, `nn:3`, `pc+1:1×5`, `IO N:1,C:3`) задержка узора начисляется ОДИН раз в его начале.
Кадр 1 в обоих столбцах загрязнён стартом (`LDIR` в 0x6000, у RTL — ещё сброс 5 мкс), поэтому сравниваются
кадры 2..4. Логи: `logs/run_MACHINE={48,128}_PROG=prog-contrun*.bin_ORG=8000_FRAMESTAT=1_QUIET=1_RUNUS=*.log`.

| цикл (все команды в 0x6000) | машина | RTL: потеряно за кадр, кадры 2..4 | RTL: M1 за кадр | модель: потеряно | модель: M1 | T на итерацию RTL / модель / без контеншена |
|---|---|---|---|---|---|---|
| `contrun` Сергея: `LD A,(6100)` `LD A,(6101)` `LD (6102),A` `NOP×4` `JP 6000` (8 M1, 65 T) | 48K | **13902 / 13900 / 13902** | 6890 / 6890 / 6892 | **13902 / 13900 / 13902** | 6890 / 6892 / 6890 | 81.15 / 81.15 / 65 |
| то же | 128K | 14019 / 14017 / 14014 | 7002 / 7001 / 7001 | 14017 / 14015 / 14015 | 7001 / 7004 / 7002 | 81.02 / 81.02 / 65 |
| `contrun_rd`: `LD HL,4000` `LD B,0` ; `LD A,(HL)` `INC L` `DJNZ` ×256 ; `JP 6000` (24 T на внутреннюю итерацию) | 48K | 14039 / 14046 (кадры 2, 3) | 6983 / 6983 | 14046 / 14042 / 14041 | 6983 / 6983 / 6983 | 30.14 / 30.14 / 24 |
| `contrun_out`: `LD A,2` ; `OUT (#FE),A` `XOR 5` `JP 6002` (28 T) | 48K | 13979 / 13976 / 13979 | 5990 / 5991 / 5990 | 13978 / 13979 / 13976 | 5990 / 5991 / 5990 | 35.00 / 35.00 / 28 |

Числа кадров 2..4 у `contrun` 48K совпадают с моделью **до такта** (13902/13900/13902 против 13902/13900/13902,
разница только в том, на какой кадр приходится граница итерации); у 128K и `contrun_rd` расхождение
2..7 T на 14000 (0.05 %) — граничные эффекты кадра при разной стартовой фазе, не систематика.
Расхождения «в несколько процентов», которые означали бы начисление на каждый такт внутри окна или потерю
MREQ-терма, нет.

Что это значит про механику начисления (по коду `main.v:149-154` и по логам `LOST`/`ACC`):
- платит **один такт на цикл** — T1, пока `mreqt23iorqtw3=1` (MREQ на предыдущем такте не было); на T2/T3
  чтения и записи флаг = 0, потому что T80pa выставляет MREQ в середине T1 и он виден на импульсе конца T1;
- внутренние такты (`pc+1:1 ×5` у DJNZ, `hl:1` у `INC (HL)`) платят КАЖДЫЙ — у них MREQ нет и флаг стоит,
  а адрес на шине контендуемый; это и есть правило Fuse для 48K/128K (`contend_read_no_mreq`);
- удержание длится, пока `vduC=1`: это и даёт узор 6,5,4,3,2,1,0,0 по фазе начала такта;
- MREQ-терм есть: чтение/запись после начисления идут без остановок (в логе `ACC` длина интервала
  ровно 3 + задержка).

Ложный след, снятый по ходу: первая версия `contrun_out.asm` дала 2688 потерянных за кадр против 13978 по
модели (в 5 раз меньше) — переход `jp inner` был собран под `org 8000h` и после первого прохода уводил цикл в
исходную копию в 0x8000, где платил только цикл ввода-вывода (14 T на строку). Это гоча №7 харнеса (программа
обязана быть собрана под свой ORG); в теле теперь абсолютный `jp 6002h`. Диагностический прогон
`logs/run_MACHINE=48_PROG=prog-contrun_out.bin_ORG=8000_ACCLOG=1_CONTLOG=1_...` был снят ещё на старой
версии: в нём 3013 интервалов ввода-вывода (порты 02FE/07FE) и всего 18 интервалов памяти по 0x6000-0x6008 (по одному на байт: `LDIR` и первый проход) — цикл действительно жил в 0x8000.

## 5. (d) Фаза `cpuck`, чётность растра, нечётная остановка процессора

`cpuck` (`main.v:152`) — свободный тоггл на `ne7M0` (два раза за такт), при `contend=0` принудительно 1.
Механика по коду и по логам (`WINLINE`, строка `vduC&&cpuck`): в свободном ходу `cpuck=0` на импульсах
`pe3M5` и 1 на серединах тактов; удержание начинается на СЕРЕДИНЕ такта (там `cpuck=1`: гасится `nc3M5`,
T80pa не выставляет MREQ — отсюда `mreq=1` в строках `LOST`), с этого момента `cpuck` держится в 1, гасятся
`pe3M5`; окно `vduC` падает на середине такта (hc нечётный), там `contend=1` → `cpuck <= 0` → на следующем
импульсе снова 0. То есть после любого удержания фаза возвращается в одно и то же состояние.

| эксперимент (48K, `HALT` в 0x5000, строка 100) | потеряно за кадр 1 / 2 | `vduC` на импульсах | `contend==0` на импульсах | первый `vduC=1` / первый `contend=0` на строке 100, k |
|---|---|---|---|---|
| умолчание (`cpuck=0` с момента 0, `hc=0`) | 13154 / **12288** | `..######` ×16 | `....####` ×16 | 36738 / 36740 |
| `CPUCKINIT=1` ДО сброса (первый вариант) | 0 / 0 при `pc3M5` 56734 / 57600 — **не измерение**: `mreq=X` в сбросе → флаг X → `contend=X` → `cpuck=X` навсегда; прибор считал X не потерей, а T80 такты терял | (X) | (X) | — |
| `CPUCKINIT=1` ПОСЛЕ сброса (принудительно на hc=62, `contend=1`, до первого окна) | 13154 / **12288** | `..######` ×16 | `....####` ×16 | 36738 / 36740 |
| `HCINIT=1` (растр стартует с hc=1: чётность `hc` относительно `pe3M5` перевёрнута) | **12288** / — | `.######.` ×16 (импульсы на нечётных hc, hUla 4..14) | `...####.` ×16 | 36738 (hUla 4) / 36740 |
| `MWPULSE=24` (`mem_wait=1` на 24 такта мастера = 3 px = 1.5 T, раз за кадр) | 13154 / 12287 | `..######` ×16 | `....####` ×16 | 36738 / 36740 |

Выводы (измерено, не выведено):
- начальное значение `cpuck` на форму окна не влияет — после первого удержания фаза одна и та же
  (первый вариант с X — артефакт стенда: в железе флаг всегда 0/1; оставлен в таблице как предупреждение,
  что `cpuck` нельзя трогать, пока T80 в сбросе);
- `mem_wait` нечётной длины `cpuck` не трогает вовсе (тоггл идёт на `ne7M0` независимо от `cpu_hold`), форма
  окна и потери за кадр не меняются (12287 против 12288 — один импульс ушёл под `mem_wait`, а не в контеншен);
- перевёрнутая чётность растра сдвигает окно на импульсах на ОДИН импульс относительно начала строки, но
  относительно детекции /INT — те же k (36738/36740), потому что /INT и окно принадлежат одному счётчику
  растра и сдвигаются вместе. Меняется другое — момент, когда прерывание защёлкивается для T80:

Минимум kacc при разных фазах решётки `HALT` (фаза меняется длиной сброса RESETUS: 1 мкс = 3.5 T; `NOCOMP=1`, первый /INT):

| RESETUS, мкс | чётность hc | kacc первого прерывания |
|---|---|---|
| 6 | обычная (hc=0) | 3 |
| 7 | обычная (hc=0) | 3 |
| 8 | обычная (hc=0) | 3 |
| 9 | обычная (hc=0) | 3 |
| 6 | перевёрнутая (hc=1) | 2 |
| 7 | перевёрнутая (hc=1) | 2 |
| 8 | перевёрнутая (hc=1) | 2 |
| 9 | перевёрнутая (hc=1) | 2 |

Длина сброса фазу решётки НЕ сдвинула (все четыре значения дали одну фазу: T80 выходит из сброса в одной и той же фазе своей решётки относительно растра), но сравнение при РАВНОЙ фазе показательно: обычная чётность → kacc = 3/3/3/3, перевёрнутая → kacc = 2/2/2/2. При перевёрнутой чётности спад /INT совпадает с импульсом `pe3M5`, `irq` (`main.v:180`) защёлкивается на этом же импульсе и T80 принимает прерывание на импульс раньше: минимум kacc = 1 против 2. Окно на импульсах при этом осталось на тех же k (36738), то есть относительно программы, синхронизированной по /INT, контеншен встал бы на ОДИН ТАКТ ПОЗЖЕ (первый такт с задержкой t = 14336). В стенде по умолчанию (и, по коду, в железе) чётность обычная, и цифры разделов 3-4 сняты для неё.
- В железе чётность фиксирована конфигурацией (`hc` без сброса стартует с 0 из битстрима, `ce` — с 1 в
  `clock_zx.v`, стенд копирует оба), сброс машины `hc` не трогает — то есть половина такта между растром и
  решёткой T80 в железе такая же, как в стенде. Это утверждение по коду, на плате не проверялось.

## 6. Пентагон

`MACHINE=PENT`, `HALT` в 0x5000 (контендуемый адрес у Синклера), 45 мс: `pe3M5 = pc3M5 = 71680` в обоих полных
кадрах, потеряно 0, `contend` не падал ни разу (`WINLINE` строки 100: `contend==0` пуст при живом `vduC`
6 из 8). Гейт `main.v:154` отключён константой `pentagon`; окно ULA при этом продолжает вычисляться.
Лог: `logs/run_MACHINE=PENT_PROG=..-marker_5000.bin_ORG=5000_FRAMESTAT=1_QUIET=1_WINLINE=100_RUNUS=45000.log`.

## 7. Итог: наша форма против опубликованной

| что | опубликовано (Sinclair FAQ / Fuse) | у нас (измерено) | вердикт |
|---|---|---|---|
| первый такт с задержкой, 48K | t = 14335 (задержка 6) | цикл с T1 на t = 14335 (k = 14337) получает 6; на 14334 — 0 | **совпадает** |
| первый такт с задержкой, 128K | t = 14361 | T1 на 14361 → 6; 14360 → 0 | **совпадает** |
| узор по фазе (t − 14335) mod 8 | 6,5,4,3,2,1,0,0 | 6,5,4,3,2,1,0,0 для чтения и записи (все 8 фаз, строки 0, 1, 100 (по k), 191) | **совпадает** |
| длина окна в строке | 128 T из 224 (128K: из 228), 16 групп | 96 гашеных импульсов на строку в 16 группах по 6, последняя группа кончается на t = 14462 (48K), доступ на 14463 и дальше — 0 | **совпадает** |
| строки | 0..191 (192 строки) | `vduC` только на vCount 0..191; при `HALT` в 0x5000 потери ровно 192 × 64 = 12288 T/кадр | **совпадает** |
| контендуемые адреса | 0x4000-0x7FFF; 128K + 0xC000-0xFFFF при банке 1/3/5/7 | `memory.v:424`; 128K: `LD A,(HL)` по 0xC000 с банком 1 — задержки по узору, с банком 0 — ни одной | **совпадает** |
| `LD A,(HL)` / `LD (HL),A` | pc:4, hl:3 (задержка на T1 hl:3) | интервал шины 3 + задержка, задержка по узору от t начала T1 | **совпадает** |
| `INC (HL)` | hl:3, hl:1, hl:3 — три начисления | сумма трёх задержек ровно по модели во всех 72 доступах | **совпадает** |
| порт, старший байт обычный, A0=0 (`OUT (#FE),A`, `IN A,(#FE)`, порт 02FE) | N:1, C:3 | T1 свободен, задержка узора на T2 (`lost` = d(t+1)), интервал 4 + d | **совпадает** |
| порт, старший байт обычный, A0=1 (`OUT (C),A`, BC=FFFD, 48K и 128K с банком 0) | N:4 | 0 потерь во всех доступах (54 и 18) | **совпадает** |
| порт, старший контендуемый, A0=0 (`OUT (C),A`, BC=40FE) | C:1, C:3 | d(t) + d(t+d+1), интервал 4 + сумма | **совпадает** |
| порт, старший контендуемый, A0=1 (`OUT (C),A` / `IN A,(C)`, BC=7FFD; 128K FFFD с банком 1) | C:1, C:1, C:1, C:1 | четыре начисления подряд, каждое по узору от начала своего такта (12/11/10/9/8/7/6/12 по фазам 0..7) | **совпадает** |
| начисление за цикл | один раз на цикл памяти/ввода-вывода (плюс каждый внутренний такт по адресу) | плотные циклы целиком в 0x6000: потери за кадр совпадают с моделью до единиц T (13902 против 13902; 13979 против 13978; 14046 против 14046) | **совпадает** |
| Пентагон | контеншена нет | 0 потерянных тактов, `contend` не падает | **совпадает** |

Что при этом устроено НЕ так, как в описании, но даёт тот же счёт тактов (важно для того, кто будет читать
волны или сравнивать с плавающей шиной/снегом): у нас удлиняется не «пауза перед T1», а сам T1 — процессор
стоит с адресом на шине и ещё НЕ выставленным MREQ (T80pa выставляет его на середине T1, а эта середина
погашена вместе с `nc3M5`). Импульсы окна на строке стоят на t = 14336..14341 (+8n) — на один такт «позже»
таблицы Fuse (14335..14340), и ровно на столько же раньше начисляется наш гейт (по концу T1, а не по началу).
Для процессора это неразличимо: все таблицы выше сняты именно с процессора.

Что в этом отчёте НЕ измерено:
- положение первого ПИКСЕЛЯ относительно /INT в тактах (14336 у 48K) — только зафиксировано, что бумага на
  видеовыходе появляется на 9 px позже первого пикселя `cn` (hc 3 → hc 12), а `cn` — на 28675 px после спада
  /INT; это стенд intgeo/border;
- плавающая шина (`IN` с портов вида #FF во время окна) и снег — не в задании;
- 128K по строкам 100/191/192 (снят только край 14361, конец окна 14489 и начало строки 1 = 14589 по
  цепочке; строк 191/192 у 128K не снимали) — по коду окно то же (`video.v:339`, `vCount 0..191`), на 48K
  строка 191 проверена, строка 192 (t ≥ 57343) — 0 потерь во всех доступах;
- поведение при `snow_off=0` (в прошивке снег включён) и при `warp_nc=1` (гейт отключён по коду);
- ULA Type 2/Late (`ula_late=1`) и `ula_tune` — в стенде 0.

## 8. Оговорки и ложные следы

1. `CPUCKINIT` до сброса отравляет стенд X (см. §5) — не факт о железе, а правило для стенда.
2. Первая версия `contrun_out.asm` жила в 0x8000 из-за метки (гоча №7 харнеса), см. §4.
3. Первая версия компенсации фазы `HALT` держала (pad + lost) mod 4 постоянным, но константная часть обработчика
   не кратна 4 — решётка уезжала на 3 такта за кадр (kacc 2 → 5 → 4 → 3); теперь остаток берётся от
   измеренного пути «kacc → M1 команды RET» + 30 (RET, JP, JP).
4. Строки `ACC` до первого /INT (`kacc=-1`) исключены из сверки: там k считается от старта симуляции, а
   растр в стенде стартует с hc=vc=0 в момент 0, то есть строка 0 окна активна с первых микросекунд —
   стартовый `OUT (C),A` в 7FFD программы получает 12 T законной задержки, модель же по t=87 ждёт 0.
5. Во время всей работы на ThinkPad шли чужие xsim (17-20 процессов, load 18-30), поэтому кадр стоил 40-70 с
   вместо 14; для сравнения длительностей прогонов этот отчёт не годится.
6. Якорь t = k − 2 для 128K — по механизму, а не по прямому замеру минимума kacc (см. §0); для 48K измерен.
7. Числа Сергея (`reference/REFERENCE_SERGEY.md`) — про его `video.v` без процессора; прямого сопоставления
   «наш процессор против его процессора» здесь нет, только сопоставление обоих с таблицей FAQ/Fuse.
