Alex-Electron/ZX_BulbuLator/research/15-pentagon/sim/timing/intgeo/RESULT.md

# Геометрия прерывания: INT → первый пиксель бумаги, ширина и фаза /INT, программа-крест

Каталог: `research/15-pentagon/sim/timing/intgeo/` (ThinkPad). Дата: 2026-08-28. Шаг 0 — только измерения:
RTL под `sources/` и `cores/` не тронут, плата не трогалась, git-операций не было. Прибор — xsim 2023.1,
стенд-наследник `tb_intgeo.sv` = копия харнеса `../harness/tb_zx.sv` + один блок измерений (см. §9).
Все числа ниже взяты из логов `logs/run_*.log` (по 5 прерываний и 5 кадров на прогон, 110 мс машины).

## 1. Определения (одни и те же во всех таблицах)

| термин | что это |
|---|---|
| **posedge** | фронт мастера 56.6667 МГц; 16 posedge = 1 T, 8 posedge = 1 px (7 МГц). Значения регистров читаются ДО их обновления на этом фронте — ровно так их читает и T80 |
| **спад vduI** («сырой /INT ULA», `Video.irq`, `main.v:261`) | posedge, на котором регистры `hCount/vCount` приняли значение, делающее `irqActive=1` (`video.v:310-315`) = первый posedge, где `Video.irq` читается 0, минус один такт. Он приходится на такт **сразу после** `ce`-фронта видео (`hCount <= hc+1` обновляется тактом позже `hc`) |
| **спад cpu_irq** | то же для провода `cpu_irq` (`main.v:185-187`): при `ula_late=0` это регистр `irq <= vduI` на `pc3M5` (`main.v:180`); при `ula_late=1` (`int_sel=1`) это сам `vduI` |
| **событие A** («T80 видит INT») | первый posedge с `dut.pc3M5=1`, на котором `cpu_irq` читается 0. T80 читает `INT_n` на `CEN` напрямую, без синхронизатора (`t80_bulb/T80.vhd:1166`); этот posedge — первый, на котором прерывание может быть принято (если он же завершает команду). Это «T = 0 после INT» в смысле Fuse и тестов Бобровского |
| **событие B** («первый пиксель байта 0x4000») | первый в кадре posedge с `ne7M0=1`, на котором `dataOutputLoad=1` (`video.v:186`): `dataOutput <= dataInput`, и со следующего такта бит 7 этого байта стоит на выходе `r/g/b` (`dataSelect = dataOutput[7]`, `video.v:302,345-347`). В логе печатаются адрес последней выборки `Video.a` и байт: во всех прогонах `Video.a = 0000` (= Z80 `0x4000`), байт `A5` — маркер, записанный программой. Координаты B: `h_rel = 12, v_rel = 0` (загрузка сдвигателя на `h_addr[2:0]==4`, бумага выводится с `hUla = 12`, как и сказано в `video.v:278-279`) |
| **T** | 16 posedge; дроби `.5` означают, что событие лежит на середине T (posedge с `ne3M5`), `.438/.938` — что спад vduI стоит тактом позже `ce` |
| **pc3M5 в (A,B]** | число импульсов `dut.pc3M5` строго после A и до B включительно = целое число T процессора между событиями. В измеренных интервалах контеншена нет (HALT в банке 2, INT вне строк бумаги), поэтому `pc3M5 = pe3M5` |
| **px_in_frame** | число `ne7M0` от начала кадра (posedge с `ne7M0 && hc==0 && vc==0`, определение харнеса) |
| **φ** | фаза HALT: T80 под HALT делает M1 каждые 4 T, прерывание принимается на ближайшей границе команды, φ ∈ {0,1,2,3} T после A. За 5 кадров прогона встретились все четыре значения (обработчик сдвигает фазу каждый кадр) |

## 2. Итоговая таблица

«Опубликовано»: 48K/128K — 14336/14362 из задания (Fuse, техописание); ширина INT 32/36 T. Пентагон —
17988 T — константа эмуляторов (80 строк × 224 + 68), воспроизведена по памяти, документа под рукой нет; из файлов
под рукой: MiSTer `cores/zx-mister/rtl/ula.sv:169-173` (INT на `vc_next==239 && hc_next==326`, 72 тика 7 МГц = 36 T;
по геометрии его же RTL INT → бумага = 17987 T, см. §3.4) и таблица Sizif в комментарии `ep4/video.v:998-1002`
(INT line 239, pos 161 T, len 32 T). Ширина 32 T в столбце «опубликовано» — из таблицы Sizif. «Сергей» — из `../reference/REFERENCE_SERGEY.md`
(§2 `tb_intgeo`: 57346/57455/71953 count = 14336.5/14363.75/17988.25 T от спада `nIRQ` до `picture`; §7.2 ширина).
Пентагон у нас — конфигурация прошивки `PINTV=299 PAPERV=60 PAPERH=2` (она же даёт числа, тождественные
`PINTV=239 PAPERV=0`, см. §3.3).

| величина | опубликовано | Сергей | наш 48K | наш 128K | наш PENT | Δ (наш − опубл.) 48K / 128K / PENT |
|---|---|---|---|---|---|---|
| (a) A → B, «как видит процессор» (`cpu_irq` через ресемплер `pc3M5`, `ula_late=0`), T = posedge/16 | 14336 / 14362 / 17988 | 14336 (целая часть его 14336.5) / 14363 / 17988 | **14339.5** | **14365.5** | **17986.5** | **+3.5 / +3.5 / −1.5** |
| (a) то же, целых `pc3M5` в (A,B] (= `pe3M5`) | | | 14339 | 14365 | 17986 | +3 / +3 / −2 |
| (a) спад vduI → B, «по собственному фронту видео» (как `tb_intgeo` Сергея), px/2 | — | 14336.5 / 14363.75 / 17988.25 | 14341.5 (28683 px) | 14367.5 (28735 px) | 17988.5 (35977 px) | vs Сергей: +5.0 / +3.75 / +0.25 |
| (a) то же в posedge/16 | | | 14341.44 (229463) | 14367.44 (229879) | 17988.44 (287815) | |
| (a) спад cpu_irq → B | | | 14340.5 | 14366.5 | 17987.5 | |
| (b) ширина /INT: сырой vduI, px (ne7M0) / T | 64 px = 32 T / 72 = 36 / (32 T) | 128 count = 32 T / 144 = 36 / 128 = 32 | **64 px = 32 T** | **72 px = 36 T** | **72 px = 36 T** | 0 / 0 / **+4 T** |
| (b) ширина как видит процессор: выборок `pc3M5` с `INT_n=0` подряд | 32 / 36 / 32 | | **32** | **36** | **36** | 0 / 0 / +4 |
| (c) спад vduI → ближайший `pc3M5` / `nc3M5`, posedge | — | у него фронт «на такте выборки», дрожание | 15 / 7 | 15 / 7 | 15 / 7 | стабильно во всех кадрах и прогонах |
| (c) спад cpu_irq (регистр `irq`) → ближайший `pc3M5` / `nc3M5`, posedge | — | | 16 / 8 | 16 / 8 | 16 / 8 | спад РОВНО на фронте `pc3M5`; T80 читает старое значение, берёт на следующем — детерминированно, всегда ровно +1 T |
| (c) спад vduI → A, posedge (T) | | | 31 (1.94) | 31 (1.94) | 31 (1.94) | = 2 T от `ce`-фронта видео |
| (d) кадр, T (`pe3M5`) / строк / строка, T | 69888 / 312 / 224; 70908 / 311 / 228; 71680 / 320 / 224 | то же (`tb_geo2`) | **69888 / 312 / 224** | **70908 / 311 / 228** | **71680 / 320 / 224** | 0 (подтверждает харнес, все 5 кадров) |
| (e) A → защёлка бордюра `OUT (#FE)` первой командой IM2-обработчика из HALT, T | — | 29 T до IORQ&WR (IM2, HALT; фаза одна) | **27.25 + φ** (IORQ&WR: 27 + φ) | 27.25 + φ | 27.25 + φ | у Сергея 29 = наши 27 + φ при φ = 2 |
| (e) координата защёлки: строка / `hc` (`hCount = hc+1`) | | | 248 / **59 + 2φ** | 248 / **63 + 2φ** | INT-строка (299) / **383 + 2φ** | |

## 3. (a) INT → первый пиксель бумаги, по машинам

### 3.1 48K (`model=0`), `ula_late=0`, кадры 2..6 (5 измерений, все одинаковы)

| от чего | до чего | posedge | = T | px (`ne7M0`) | `pc3M5` | `pe3M5` |
|---|---|---|---|---|---|---|
| спад vduI: строка 248, `px_in_frame = 111104 = 248×448 + 0`, `hCount = 2` (`hc = 1`) | событие A: `px_in_frame = 111108`, `hCount = 5` | 31 | 1.938 | 4 | — | — |
| спад cpu_irq (регистр `irq`, тактом позже `pc3M5`, на котором vduI впервые низок) | A | 16 | 1.000 | | 1 | 1 |
| **A** | **B: строка 0, `px_in_frame = 11`, `hCount = 12` (`hc = 11`), `h_rel = 12`, байт `A5` с `Video.a = 0000`; B на posedge с `ne3M5`** | **229432** | **14339.500** | 28679 | **14339** | 14339 |
| спад vduI | B | 229463 | 14341.438 | 28683 | 14341 | 14341 |
| спад cpu_irq | B | 229448 | 14340.500 | | | |

Разложение: 64 строки × 448 px = 28672 px = 14336 T; плюс 11 px от начала строки 0 до B, минус 0 px
(INT на px 0 строки 248) = 28683 px. Иными словами, **у нас сырой /INT стоит в начале строки, а первый
пиксель бумаги — на 11-м пикселе строки**, и разница 11.5 px ≈ 5.7 T целиком уходит в число; ресемплер
`irq` на `pc3M5` съедает из них 1.94 T (2 T от `ce`), итог +3.5 T к 14336.

### 3.2 128K (`model=1`, `pentagon=0`), `ula_late=0`

| от чего | до чего | posedge | = T | px | `pc3M5` |
|---|---|---|---|---|---|
| спад vduI: строка 248, `px_in_frame = 113092 = 248×456 + 4`, `hCount = 6` | A: `px_in_frame = 113096`, `hCount = 9` | 31 | 1.938 | 4 | |
| спад cpu_irq | A | 16 | 1.000 | | 1 |
| **A** | **B: строка 0, `hCount = 12` (`hc = 11`), `h_rel = 12`, байт `A5` с `Video.a = 0000`** | **229848** | **14365.500** | 28731 | **14365** |
| спад vduI | B | 229879 | 14367.438 | 28735 | 14367 |

Разложение: 63 строки × 456 = 28728 px − 4 + 11 = 28735 px.

### 3.3 Пентагон (`model=1`, `pentagon=1`), `pent_int_h = 326`, четыре конфигурации ручек

`pent_int_v`/`paper_v`/`paper_h` — живые ручки от ARM; в RTL-топе умолчания 239/24/64, в прошивке
`loader_main.c:1799-1811` — 299/60/2, харнес по умолчанию берёт 239/60/2 (смесь). Спад vduI во всех
случаях на `hCount = 326` (`hc = 325`), `px_in_frame = pent_int_v × 448 + 324`; A через 31 posedge
(`hCount = 329`); B всегда на `h_rel = 12, v_rel = 0`, то есть `hc = paper_h + 11`, строка `paper_v`.

| `PINTV / PAPERV / PAPERH` | кто так ставит | B: строка / `hCount` | A → B, T (posedge) | `pc3M5` в (A,B] | спад vduI → B, px / T | геометрия: (320 − PINTV + PAPERV) строк × 448 − 324 + PAPERH + 11, px |
|---|---|---|---|---|---|---|
| **299 / 60 / 2** | **прошивка** (`opt_pintv=299`, владелец 12.08) | 60 / 14 | **17986.5** (287784) | **17986** | **35977 = 17988.5** | 81 × 448 − 311 = 35977 ✓ |
| **239 / 0 / 2** | эталон RTL `video.v:9` при бумаге с нуля | 0 / 14 | **17986.5** (287784) | 17986 | 35977 = 17988.5 | 81 × 448 − 311 = 35977 ✓ |
| 239 / 60 / 2 | **умолчание харнеса** (смесь) | 60 / 14 | 31426.5 | 31426 | 62857 = 31428.5 | 141 × 448 − 311 = 62857 ✓ |
| 239 / 24 / 64 | умолчания RTL-топа (до прошивки) | 24 / 76 | 23393.5 | 23393 | 46791 = 23395.5 | 105 × 448 − 249 = 46791 ✓ |

Вывод по Пентагону: **пары (299, бумага с 60) и (239, бумага с 0) — одна и та же машина**, 17988.5 T
по фронту видео и 17986.5 T как видит процессор, против 17988 опубликованных и 17988.25 у Сергея.
Умолчание харнеса `PINTV=239` при `PAPERV=60` (взято из задания шага) не соответствует ни прошивке, ни
эталону: /INT там приходит на 12 строк раньше конца бумаги (бумага 60..251, INT на 239), и INT → бумага
получается 31426 T — на 60 строк длиннее. **Для любых замеров Пентагона в этом стенде задавать
`PINTV=299` (при `PAPERV=60`) или `PAPERV=0` (при `PINTV=239`).** Длины кадра/строки от этого не
зависят (везде 1 146 880 / 143 360 / 71 680 / 320 — совпадает с харнесом).

### 3.4 Ориентир: геометрия MiSTer `ula.sv` (ВЫЧИСЛЕНО из RTL, не измерено)

Наш `video.v` унаследовал раскладку MiSTer (`cores/zx-mister/rtl/ula.sv`; копия в дереве старше живого апстрима,
см. правило проекта). Там /INT ставится регистром на `ce_7mn`-фронте (`ula.sv:169-170`): 48K `vc_next==248 &&
hc_next==4`, 128K `hc_next==8`, Пентагон `vc_next==239 && hc_next==326`; сдвигатель грузится на `hc_next[2:0]==4`
при `VidEN` (`ula.sv:175-177`), бумага показывается с `hc_next` 12 (`ula.sv:185`). Правило счёта то же, что у
нашего `R2B`: ce-фронты строго после момента установки /INT до фронта загрузки первого байта включительно.

| машина | MiSTer: строк × px + (11 − hc установки) | = px | = T | наш спад vduI → B, px (§3.1-3.3) | Δ наш − MiSTer |
|---|---|---|---|---|---|
| 48K | 64 × 448 + (11 − 3) | 28680 | 14340.0 | 28683 | +3 px = +1.5 T |
| 128K | 63 × 456 + (11 − 7) | 28732 | 14366.0 | 28735 | +3 px = +1.5 T |
| Пентагон (INT 239/326, бумага с 0/0 или 60/2) | 81 × 448 + (11 − 325) | 35974 | 17987.0 | 35977 | +3 px = +1.5 T |

Разница одна на все три машины, 3 px, и раскладывается так: 1 px у всех — у нас /INT считается от регистра
`hCount`, который обновляется тактом мастера ПОЗЖЕ ce-фронта (`video.v:75-76,310-314`), поэтому спад лежит ПЕРЕД
ce-фронтом с тем же номером, а у MiSTer `INT` — регистр на самом ce-фронте; ещё 2 px у Синклеров — `irqBeg` = 2 / 6
против `hc_next` 4 / 8 у MiSTer; ещё 2 px у Пентагона — `paper_h` = 2 (положение /INT 326 совпадает). Как MiSTer подаёт этот /INT процессору (`nINT = ~INT`, без
ресемплера, `ula.sv:82`) и в какой фазе там стоит такт T80 — здесь не считалось.

## 4. (b) Длительность импульса /INT

| машина | `irqWidth` (`video.v:58`), px | vduI низок: posedge / px / T | выборок `pc3M5` с `INT_n = 0` подряд (T процессора) | опубликовано | Сергей (`int_len`, `ep4/video.v:1241`) |
|---|---|---|---|---|---|
| 48K | 64 | 512 / 64 / 32.00 | 32 | 32 T | 128 count = 32 T |
| 128K | 72 | 576 / 72 / 36.00 | 36 | 36 T | 144 count = 36 T |
| Пентагон | 72 | 576 / 72 / 36.00 | 36 | 32 T (таблица Sizif в его комментарии) | 128 count = 32 T («32 на Sinclair-машинах, 36 на 228-тактных») |

Как видит процессор — ровно столько же T, сколько px/2: ресемплер сдвигает импульс на 1 T целиком, не
меняя ширины. **Расхождение по Пентагону (36 против 32 T) — не решать здесь:** `video.v:37-39` пишет,
что 72 такта сверены с MiSTer ula.sv / ZX-Uno / Speccy2010; у Сергея и в таблице Sizif — 32 T. Источник наших 72
подтверждается по копии в дереве: `cores/zx-mister/rtl/ula.sv:172` — `INTCnt` у Пентагона (`!mZX`, `m128`) считает
до 71, то есть 72 тика 7 МГц = 36 T. Эталоны расходятся между собой (MiSTer 36 T, Sizif/ep4 32 T) — по правилу
проекта это кандидат в опцию машины с записью, когда её трогать, а не в молчаливую правку. На живом
Пентагоне не мерилось. Для софта это заметно только программам, которые ждут снятия /INT (редкость).

## 5. (c) Фаза фронта /INT относительно такта выборки процессора

Стабильно во **всех** кадрах всех прогонов (по 5 прерываний в каждом из 10 прогонов, ни одного отклонения):

| путь | спад → ближайший `pc3M5`, posedge | спад → ближайший `nc3M5` | спад → A | что это значит |
|---|---|---|---|---|
| vduI (сырой) — 48K, 128K, PENT (все конфигурации) | 15 | 7 | 31 = 1.938 T | `hCount` меняется тактом позже `ce`-фронта; для `irqBeg` = 2 / 6 / 326 этот `ce`-фронт — фаза `pe3M5` (`ce = 8`); до следующего `pc3M5` 15 тактов |
| `cpu_irq` = регистр `irq` (`ula_late=0`) | 16 | 8 | 16 = 1 T | регистр переключается **ровно на posedge с `pc3M5`**; T80 на том же posedge читает ещё 1 и принимает на следующем `pc3M5`. Не гонка: обычный синхронный путь регистр → регистр с полным периодом мастера (17.6 нс) |
| `cpu_irq` = vduI (`ULALATE=1`, `int_sel=1`) | 15 | 7 | 15 = 0.938 T | без ресемплера: A наступает на 1 T раньше, чем при `ula_late=0` |
| vduI при `HCINIT=1` (гипотетическая противоположная чётность `hc`, см. ниже) | 7 | 15 | 23 = 1.438 T | A на пол-T раньше относительно видео; A → B = 14340.0 (B ложится на `pe3M5`) |

Про «фронт ровно на такте выборки, дрожание между двумя положениями» (Сергей): у нас vduI сформирован в
том же домене `clock` (комментарий `main.v:176-177` верен), поэтому дрожать нечему — во всех кадрах фронт
приходится на одно и то же место, и T80 берёт его детерминированно. Это доказано пятью одинаковыми кадрами
в каждом прогоне, но только для RTL: на плате это же гарантирует закрытый тайминг.

**Чётность `hc` относительно `pe3M5` — глобальная фаза машины.** `hc` шагает на каждом `ne7M0` (`ce = 0`
и `ce = 8`), а T80 — только на `ce = 8`; значит, чёт/нечет `hc` в момент `pe3M5` определяется только
начальными значениями (`hc = 0`, `ce = 1` при конфигурации ПЛИС; у `hc` нет сброса). Стенд повторяет их
и даёт: `ce`-фронт с чётным `hCount` = фаза `pe3M5`, поэтому B (`hCount = 12`) ложится на `ne3M5` и
A → B выходит с половинкой (14339.5). При `HCINIT=1` (нечётная чётность) A → B = 14340.0, спад vduI →
B = те же 14341.44. Смена фазы `ce` варпом (`clock_zx.v:55-66`, переход только при `ce == 0`) на чётность
не влияет по построению (за 16 тактов `ce` `hc` делает 2, 4 или 8 шагов — всегда чётное), но переходный
период сам не проверялся.

### 5.1 `ULALATE=1` (`int_sel=1`, обход ресемплера; `video.v:95` одновременно сдвигает `hUla` на 2 px)

| машина | A: `hCount` | B: `hCount` (`h_rel` = 12) | A → B, T | Δ к `ula_late=0` | спад vduI → B, T |
|---|---|---|---|---|---|
| 48K | 3 (было 5) | 14 (было 12) | **14341.5** (14339.5) | **+2.0** | 14342.44 (+1.0) |
| 128K | 7 (было 9) | 14 (было 12) | **14367.5** (14365.5) | **+2.0** | 14368.44 (+1.0) |

Ручка `ula_late` двигает два конца сразу: прерывание к процессору на 1 T раньше **и** растр (бумагу,
контеншен) на 1 T позже — итого INT → бумага длиннее на 2 T, а не на 1, как «Late» у Fuse (там 14337
против 14336). В сторону 14336 эта ручка не ведёт ни в одном положении. Для Пентагона топ её подавляет
(`bulbulator_zx_ddr_top.v:1437`: `ula_late_sp = ~pentagon_s[1] & ula_late_s[1]`, комментарий «never Pentagon»),
поэтому в стенде для PENT не гонялась — на плате это положение ручки недостижимо.

## 6. (d) Длина кадра и строки — подтверждено (кадры 2..5 каждого прогона, все одинаковы)

| машина | кадр: posedge / px / `pe3M5` / `pc3M5` | строк | строка: posedge / px / T | период спадов vduI, `pe3M5` |
|---|---|---|---|---|
| 48K | 1 118 208 / 139 776 / **69 888** / 69 888 | 312 | 3584 / 448 / **224** | 69 888 |
| 128K | 1 134 528 / 141 816 / **70 908** / 70 908 | 311 | 3648 / 456 / **228** | 70 908 |
| Пентагон (любые ручки) | 1 146 880 / 143 360 / **71 680** / 71 680 | 320 | 3584 / 448 / **224** | 71 680 |

Совпадает с харнесом и с опубликованным. В кадре 1 `pc3M5` меньше `pe3M5` на 7-8 (в него попал сброс).

## 7. (e) Программа-крест `prog/cross.asm`

Программа (ORG 8000h, весь код в банке 2 без контеншена): `DI`, бордюр 2, `(0x4000) = 0xA5`,
`(0x5800) = 0x38`, таблица IM2 0x9000..0x9100 = 0x91 → вектор 0x9191, обработчик скопирован по 0x9191,
`LD I,90h`, `IM 2` (или `IM 1` — `cross_im1.bin`, тогда стенду даётся `ISRPATCH=9191`: `JP 9191h` по
0x0038 страниц ПЗУ 0 и 1), `A = 5`, `EI`, `HALT` в цикле. Обработчик: **первая команда `OUT (#FE),A`**
(11 T: IORQ&WR с начала T2 цикла M3, см. `../t80/RESULT.md` §3), `XOR 7` (5 ↔ 2), `EI`, `RETI`.
Бордюр 2 → 5 → 2 … меняется каждый кадр; в логе видны все четыре фазы HALT.

Цепочка после A (одинакова у всех трёх машин; φ ∈ {0,1,2,3} T — фаза HALT):

| событие | от A, T | комментарий |
|---|---|---|
| спад M1 цикла подтверждения INT (вычислено: M1 обработчика − 19) | 0 + φ | граница команды HALT |
| спад IORQ (при низком M1) в цикле подтверждения | 2.5 + φ | |
| спад MREQ в M1 первой команды обработчика (сам M1 — на 0.5 T раньше) | 19.5 + φ | IM 2 = 19 T приёма ✓ (`t80/RESULT.md` §2); IM 1 (48K, `cross_im1`): 13.5 + φ, адрес 0038 |
| спад IORQ&WR команды `OUT (#FE),A` | 27.0 + φ | 19 + 4 (M1) + 3 (операнд) + 1 (T1 M3) = 27 ✓; IM 1 через `JP 9191h` в патче ПЗУ: 31 + φ (13 + 10 + 8) |
| **защёлка бордюра** (`main.v:230`: `pe7M0 & !ioFE & !wr`) | **27.25 + φ** | первый `pe7M0` через 4 posedge после начала T2; IM 1 + JP: 31.25 + φ |

Координаты защёлки бордюра (для стенда бордюра; `hc` — «старое» значение, `hCount = hc + 1`):

| машина | строка | `hc` при φ = 0 / 1 / 2 / 3 | `px_in_frame` | от спада vduI, T | от спада vduI, px |
|---|---|---|---|---|---|
| 48K, IM 2 | 248 | **59 / 61 / 63 / 65** | 111162 + 2φ | 29.19 + φ | 58 + 2φ |
| 48K, IM 1 + `JP` в ПЗУ | 248 | 67 / 69 / 71 / 73 | 111170 + 2φ | 33.19 + φ | 66 + 2φ |
| 48K, IM 2, `ULALATE=1` | 248 | 57 / 59 / 61 / 63 | 111160 + 2φ | 28.19 + φ | 56 + 2φ |
| 128K, IM 2 | 248 | **63 / 65 / 67 / 69** | 113150 + 2φ | 29.19 + φ | 58 + 2φ |
| 128K, IM 2, `ULALATE=1` | 248 | 61 / 63 / 65 / 67 | 113148 + 2φ | 28.19 + φ | 56 + 2φ |
| Пентагон, IM 2 (`PINTV` = 299 или 239) | строка INT | **383 / 385 / 387 / 389** | `PINTV`×448 + 382 + 2φ | 29.19 + φ | 58 + 2φ |

Число Сергея «IM 2 из HALT: 29 T от INT до IORQ&WR» (`tb_intack`, одна фаза) равно нашим 27 + φ при
φ = 2; разница IM2 − IM1 = 6 T и равенство HALT/NOP у нас воспроизводятся так же (`t80/RESULT.md`).

## 8. Откуда +3.5 T у 48K/128K и −1.5 T у Пентагона (арифметика, не рецепт)

Опубликованное 14336 = 64 строки × 224 T ровно: у настоящего 48K /INT стоит в строке на той же
горизонтальной позиции, где через 64 строки выходит первый пиксель бумаги. У нас:

| слагаемое | 48K | 128K | Пентагон (299/60 или 239/0) |
|---|---|---|---|
| строк от INT-строки до строки 0 бумаги × px в строке | 64 × 448 = 28672 px = 14336 T | 63 × 456 = 28728 px = 14364 T | 81 × 448 = 36288 px = 18144 T |
| − позиция спада vduI в строке, px | − 0 | − 4 | − 324 |
| + позиция B в строке 0 бумаги, px (`hc` = 11 при `paper_h` = 0; 13 при 2) | + 11 | + 11 | + 13 |
| = спад vduI → B, px (T) | 28683 (14341.5) | 28735 (14367.5) | 35977 (17988.5) |
| спад vduI → A: `ce`-фронт + 1 такт → регистр `irq` на следующем `pc3M5` → чтение на следующем | 31 posedge = 1.94 T | 1.94 | 1.94 |
| **A → B** | **14339.5** | **14365.5** | **17986.5** |
| опубликовано | 14336 | 14362 | 17988 |
| **Δ** | **+3.5** | **+3.5** | **−1.5** |

У Синклеров лишние 3.5 T = 11.5 px от начала строки до первого пикселя минус 2 T ресемплера; у
Пентагона владелец уже подобрал `INT H = 326` так, что число сошлось с точностью до тех же 1.5 T
(17988.5 по видео → 17986.5 для процессора). Как это делить между положением /INT, окном бумаги и
контеншеном — **вопрос следующих стендов** (контеншен и бордюр меряются отдельно; опубликованные 14335
для контеншена здесь не проверялись). Замечу только, что `pent_int_h` — живая ручка и умолчание топа
`0x00EF0146` = 239/326 совпадает с прошивкой по H.

## 9. Стенд-наследник: что добавлено и как запускать

`tb_intgeo.sv` генерируется скриптом `make_tb.py` из копии `tb_zx.orig.sv` (= `../harness/tb_zx.sv` на
28.08, харнес не менялся) — так видно ровно, что добавлено (каждая вставка помечена `// intgeo`):

| вставка | зачем |
|---|---|
| `module tb_intgeo` | своё имя снапшота, чтобы не мешать харнесу |
| плюс-аргумент `HCINIT=<n>` | начальное `hc/hCount` (0 = как в железе и харнесе); `1` — противоположная чётность `hc` относительно `pe3M5` (§5) |
| плюс-аргумент `ISRPATCH=<hex>` | `JP <hex>` по 0x0038 страниц ПЗУ 0 и 1 — обработчик IM 1 без своего ПЗУ |
| блок «ГЕОМЕТРИЯ ПРЕРЫВАНИЯ» в конце файла | свои счётчики `g_*` в одном `always`, события A/B/спады, цепочка ACK → M1 → IORQ&WR → защёлка бордюра; печать строк `INTGEO …`; во время сброса B не ловится |

Запуск: `./run.sh --build MACHINE=48 PROG=prog/cross_im2.bin ORG=8000 RUNUS=110000` (список исходников
— копия `harness/run.sh`; `gen/wd1793_xsim.sv` берётся готовый из харнеса). Параллельно — `--wd=<имя>`
(гоча харнеса №6). Все десять прогонов — `launch_all.sh` (≈ 3-5 мин wall при 10 параллельных; в логах
`wall:` 188-316 с). Программы: `prog/prog_build.sh` → `cross_im2.bin`, `cross_im1.bin` (pasmo, 61 байт).
Логи: `logs/run_MACHINE=…log` (10 файлов), сводка кадров в каждом.

Проверки в каждом прогоне: 5 спадов vduI = 5 спадов `cpu_irq` = 5 подтверждений INT; `x`-контроль 0/0;
байт первой выборки `A5` с `Video.a = 0000` (маркер программы) — то есть B действительно байт 0x4000.

## 10. Не измерено / оговорки

1. Положение узора контеншена и плавающей шины относительно /INT (опубликованные 14335 и т. п.) — не
   здесь; интервалы A → B у всех прогонов свободны от контеншена (`pc3M5 = pe3M5`), поэтому числа §3 —
   про геометрию, не про потери T.
2. Опубликованное значение для Пентагона (17988 = 80 × 224 + 68) — константа эмуляторов по памяти, не из документа
   под рукой; из файлов под рукой есть геометрия MiSTer (17987 T по вычислению из `ula.sv`, §3.4) и таблица Sizif
   (INT line 239 / pos 161 T в `ep4/video.v:998-1002`); число Сергея 17988.25 — измерено его стендом (`../reference/`).
3. Ширина /INT Пентагона 36 T против 32 T у Сергея/Sizif — зафиксировано как расхождение эталонов. Источник
   наших 72 px подтверждён по вендоренной копии MiSTer (`cores/zx-mister/rtl/ula.sv:172`); по ЖИВОМУ апстриму
   MiSTer, ZX-Uno и Speccy2010 не перепроверялся.
4. `ULALATE=1` для Пентагона не гонялся (топ его подавляет).
5. Чётность `hc` относительно `pe3M5` в железе принята равной стендовой (оба стартуют с `hc = 0`,
   `ce = 1`); переходный период смены расписания варпом на чётность не проверялся.
6. Все числа — RTL в xsim; на плате они верны в той мере, в какой закрыт тайминг (STA), что здесь не
   проверялось.
7. Умолчание харнеса `PINTV=239` при `PAPERV=60` — смесь двух систем (§3.3); в самом харнесе ничего не
   менялось, но его README стоит дополнить этим замечанием (правка харнеса — не в моём объёме).

## 11. Повторная сверка отчёта (28.08.2026, вторая проходка)

Все числа §2-§7 перечитаны из десяти логов `logs/run_*.log` (по каждому: строки `INTGEO RAWFALL/A/RAWLOW/CPULOW`
кадра 2, `INTGEO B/A2B/R2B/C2B` кадра 3, `INTGEO M1H/IOWR/BORDER` кадров 2-5, сводка «последний кадр /
прерываний / x-контроль»); расхождений с таблицами нет, у всех прогонов 5 спадов vduI = 5 спадов `cpu_irq` = 5
подтверждений INT, x-контроль 0/0. Ссылки на строки RTL перепроверены по живым файлам: `video.v` 58 (`irqWidth`),
75-81 (`hCount`/`hc`, `vCount`/`vc`), 95-103 (`ulaShift`/`hUla`), 162-163 (`videoEnable`), 173-174 (`dataInputLoad`),
186-188 (`dataOutputLoad`), 262-263 (адрес), 302 и 345-347 (`dataSelect` → `r/g/b`), 310-315 (`irqActive`);
`main.v` 165-166 (`pc3M5`/`nc3M5`), 178-187 (ресемплер `irq`, `int_sel`, `cpu_irq`), 230 (защёлка бордюра),
261 (`.irq(vduI)`); `t80_bulb/T80.vhd:1166` (`INT_n` читается напрямую, сигнала-синхронизатора в файле нет);
`bulbulator_zx_ddr_top.v:1437`; `arm/loader_main.c:1799-1811` (`opt_pintv=299, opt_pinth=326, opt_paper_h=2,
opt_paper_v=60`). `tb_intgeo.sv` пересобран `make_tb.py` из `tb_zx.orig.sv` (= `../harness/tb_zx.sv`, `diff` пуст):
39577 байт, 7 вставок `// intgeo` — совпадает с тем, что компилировалось в `xsim.dir/tb_intgeo` (11:01).
Определение B перепроверено по `video.v`: при `paper_h = 0` защёлка `videoEnable` на `h_rel[3]` в конце предыдущей
строки берёт `dataEnable = 0`, поэтому строб `h_rel = 4` первой строки бумаги сдвигатель НЕ грузит (там выводится
бордюр), первая загрузка — `h_rel = 12` байтом с адреса `a = 0` (`addrLoad` на `h_addr = 8`, `dataInputLoad` на 9);
это и есть напечатанное в логах `hCount=12, Video.a=0000, байт=a5`.

Что при сверке добавлено: §3.4 (геометрия MiSTer, вычислена из `ula.sv`, не измерена), ссылки на строки-источники
в §2, §4, §5.1, §10. Числа измерений не менялись.
