Alex-Electron/ZX_BulbuLator/research/15-pentagon/sim/timing/ports/RESULT.md

# Порты и плавающая шина: 48K, 128K, Пентагон (стенд xsim, шаг 0 — только измерения)

Дата: 28.08.2026. Каталог: `research/15-pentagon/sim/timing/ports/`. RTL под `sources/` и `cores/` не
тронут, плата не трогалась, синтез не запускался. Стенд — `tb_ports.sv`, наследник
`../harness/tb_zx.sv` (машина Atlas целиком: `main.v` + `video.v` + `memory.v` + T80-форк + периферия,
тактовые разрешения из `clock_zx.v`); добавлены только монитор ввода-вывода `IOMON`, монитор спадов
`IRQMON`, вход `EAR`, заливка экрана `SCRFILL` и длина дампа. Программы Z80 собраны `pasmo`
(`prog/`). Логи всех прогонов — `logs/` и `wd/<имя>/nohup.out`.

## 0. Единицы и точки отсчёта (одинаковы для всех таблиц)

| величина | как измерена |
|---|---|
| **T от /INT** | число импульсов `pe3M5` (T-состояния 3.5 МГц) от спада `Video.irq` (сырой /INT ULA, `video.v:314`) до **защёлки данных T80** = последний `nc3M5` цикла IN (T80pa берёт `DI` на `CEN_n`; это середина T3 цикла ввода-вывода, T1 = M1-старт + 7 для `IN A,(n)`). Проверка: у `IN A,(n)` M1-старт → защёлка = 10 T, IORQ активен с T2 (латч − 2). Тот же момент, что `tstates` у Fuse в `readport` |
| **hCount / vCount** | `dut.Video.hCount`, `dut.Video.vCount` в момент той же защёлки: координата растра в пикселях 7 МГц (2 px = 1 T) и строках; `h_rel/v_rel` = то же минус `paper_h/paper_v` (у 48K/128K равны hCount/vCount, у Пентагона `paper_h=2, paper_v=60`) |
| спад /INT в растре | 48K: `hCount=2, vCount=248`; 128K: `hCount=6, vCount=248`; Пентагон: `hCount=326, vCount=239` (IRQMON, совпадает с harness/README) |
| **байт D** | `dut.d` в момент защёлки = то, что реально получил Z80 (мультиплексор шины `main.v:905-930`); `vduQ` = выход плавающей шины `video.v` (`q`) в тот же момент — печатается для сравнения даже там, где мультиплексор его не выбирает (Пентагон, порты AY/FE) |
| пересчёт | 48K: T от /INT = 14336 + 224·vCount + (hCount − 2)/2 для строк бумаги (vCount 0..191); 128K: 14362 + 228·vCount + (hCount − 2)/2; проверено на всех точках свипа (сходится точно) |
| CPU-видимый /INT | `main.v:180 irq <= vduI` по `pc3M5`: T80 видит прерывание на 1 T позже сырого спада; подтверждение (M1&IORQ) наблюдалось через 4.5..7.5 T после спада в зависимости от фазы сетки HALT (все T здесь отсчитаны от СЫРОГО спада) |

Длительности команд T80 (форк `sources/t80_bulb/T80.vhd`), измеренные микротестом `prog/tim.asm` по меткам
времени соседних M1 (лог в `logs/`): все совпали с документацией Z80 — `nop` 4, `ld a,i` 9, `inc de` 6,
`ld e,n` 7, `ld r,a` 9, `ld a,n` 7, `in a,(n)` 11, `ld bc,nn` 10, `in a,(c)` 12, `ld a,(nn)` 13, `cp n` 7,
`call` 17, `ret` 10, `jp (hl)` 4, `ld l,(hl)` 7, `ld (hl),a` 7, `inc (hl)` 11, `set 7,l` 8, `djnz` 13/8,
`jr` 12, `jp cc` 10, `dec bc` 6, `out (n),a` 11, `ex (sp),hl` 19, `ld hl,(nn)` 16, `halt` 4 (+4 за NOP).
На эти числа опирается программа свипа.

## 1. Как устроена плавающая шина в нашем RTL (что именно измеряется)

`video.v:264-266`: `fbLoad = dataEnable && h_addr[3] && h_addr[0]` → `q <= d` на пикселях
`h_addr mod 16 = 9, 11, 13, 15` (это байты, которые ULA только что выбрала: адрес ставится на 8/10/12/14 —
`video.v:261-262`: битмап колонки 2n, атрибут 2n, битмап 2n+1, атрибут 2n+1); `fbReset = h_addr[3:0]==1`
→ `q <= FF`. Значит по пикселям группы (16 px = 8 T, h_rel = 16n + …):

| h_rel mod 16 | 0-1 | 2-9 | 10-11 | 12-13 | 14-15 |
|---|---|---|---|---|---|
| T внутри группы | T0 | T1..T4 | T5 | T6 | T7 |
| `q` | атрибут кол. 2n−1 (второй атрибут ПРЕДЫДУЩЕЙ группы, загружен на 15) | FF | битмап кол. 2n | атрибут кол. 2n | битмап кол. 2n+1 |

`main.v:925-930`: `!ioFE → {1, ear|speaker, 1, keyQ}`, `!ioFFFD → psgQ` (где `ioFFFD = !(!iorq && a[15]
&& a[14] && !a[1])`, `main.v:810` — только #FFFD, без #BFFD), иначе `pentagon ? FF : vduQ`. То есть на
48K/128K ЛЮБОЙ незанятый порт (в т. ч. #BFFD и #7FFD) отдаёт `q`, на Пентагоне — FF. Выше в
мультиплексоре стоят GS, NEMO, дисковод, мышь, Z-Controller (#57/#77), кемпстон (`ioDF`: одно условие
`a[5]=0`), DivMMC (#EB) — все выключены константами в стенде, но конус кемпстона активен всегда.

## 2. (a) Свип плавающей шины: IN A,(#FF) и IN A,(#BF), 48K и 128K

Программа `prog/fbus.asm`: после каждого прерывания (IM2, таблица 257 байт) обработчик ждёт `W1`
итераций по 24 T, потом ровно (8 + k) T (заглушки `fbus_stubs.inc`, генерируются `fbus_gen.py`), делает
`LD A,#FF : IN A,(n)` и кладёт результат в `0x8000+k`; затем ждёт `W2` итераций, снова (8 + k) T, читает и
кладёт в `0x8080+k`; k растёт на 1 раз в кадр (KMAX = 48). Пауза после IN равна (56 − k) T, а хвост
обработчика добит `PADT` до кратного 4 T, поэтому фаза приёма прерывания из `HALT` одна на все кадры, и
k-я защёлка стоит ровно на k T позже нулевой (проверено по каждой строке: T растёт на 1 за кадр).
Экран заливает стенд (`SCRFILL=1`, банк 5 и зеркало `mem.scr`): битмап = `{0, треть[1:0], кол[4:0]}`,
атрибут = `{1, строка[0], 0, кол[4:0]}`; FF не встречается. Код и стек — в банке 2 (0x9000, без
контеншена), порты #FF/#BF — `a[0]=1`, старший байт FF: контеншена порта нет (N:4).

Варианты (`prog/variants.txt`): 48K `W1=590 W2=925 W2F1=1` → первая защёлка 14327+k (бумага по
пересчёту §0 с 14336), вторая 36733+k (строка 100 с 36736); 128K `W1=591 W2=941 W2F1=2` → 14353+k
(бумага с 14362) и 37150+k (строка 100 с 37162); #BF — те же ожидания.

**Ожидание из задания** (опубликованный узор 48K): начиная с B = 14336 каждые 8 T — битмап, атрибут,
битмап+1, атрибут+1, FF, FF, FF, FF; вне бумаги FF. В таблицах ниже колонка «ожидание» считана
именно так (для строки 100: B + 224·100; для 128K: B = 14362, +228·100).

**Результат дословно (48K, #FF, строка 100, k = 0..10 на момент отчёта):**
`36733:FF 36734:FF 36735:FF 36736:FF 36737:FF 36738:FF 36739:FF 36740:20 36741:80 36742:21 36743:81`
— то есть на T = B+0..B+3 у нас FF, а четыре байта данных (битмап кол. 0 = 20, атрибут кол. 0 = 80,
битмап кол. 1 = 21, атрибут кол. 1 = 81) лежат на **B+4..B+7**. Порядок байтов совпадает с опубликованным,
**фаза сдвинута на +4 T (половину группы)**: наш узор = опубликованный, отсчитанный от B+4. По
координате растра это h_rel 10..17 (§1: `fbLoad` на 9/11/13/15), а T = B соответствует hCount = 2
строки бумаги. Первая строка бумаги (48K) до 14337 включительно даёт FF — согласуется: первый байт
данных ожидается у нас на 14340 (hCount 10). 128K: до 14363 FF (первый байт данных ожидается на 14366).

⚠ Свип на момент записи отчёта дошёл до k = 10 из 48 (кадры по 20 мс, ≈ 0.8 мин xsim на кадр при
загрузке ThinkPad другими стендами); прогоны продолжаются в фоне (`wd/f48ff`, `wd/f48bf`, `wd/f128ff`,
`wd/f128bf`, `wd/fpentff`, конец = строка `wall:` в `nohup.out`, ожидаемо ~16:00). Полные таблицы
(k = 0..47, шесть групп по 8 T) получаются той же командой:
`python3 sweep_table.py wd/f48ff/nohup.out 48 "#FF"` (и `f48bf 48 "#BF"`, `f128ff 128 "#FF"`,
`f128bf 128 "#BF"`, `fpentff PENT "#FF"`); в конце каждого лога `дамп 8000` (0x8000..0x802F = первая
защёлка по k, 0x8080.. = вторая) — те же байты из ОЗУ машины.

Сравнение с моделью Сергея (`/tmp/ep4/video.v:1276-1283`): у него порт #FF отдаёт атрибут при
`hcounter[4:2] ∈ {0, 6}` и битмап при `hcounter[4] & hcounter[2]` (= фазы T5, T7), FF иначе — та же
форма «T0 атрибут, T1..T4 FF, T5 битмап, T6 атрибут, T7 битмап» относительно его 32-count'овой группы,
что и у нас относительно 16-пиксельной. Его первый пиксель бумаги — `hcounter = 8` строки 0 на
14336.5 T от его /INT, то есть группа с `hcounter = 0` начинается на 14334.5, и его битмап колонки 0
лежит на ≈14339.5..14340.5 — там же, где наш (14340). Обе FPGA-модели ставят данные во вторую половину
группы, отсчитанной от 14336; расхождение с опубликованной таблицей — в том, к какому моменту привязан
«байт читается на 14336» (выборка ULA против момента защёлки IN); здесь только зафиксировано.

### 2.1 Таблицы свипа (состояние на момент отчёта, k = 0..10; полные — командой выше)

### 48K, порт #FF, строка 0 (опорная точка B = 14336 = 14336)

| k | T от /INT | T − B | vCount | hCount | D | расшифровка (наш узор) | ожидание (узор от B) | совпало |
|---|---|---|---|---|---|---|---|---|
| 0 | 14327 | -9 | 311 | 432 | FF | FF | FF | да |
| 1 | 14328 | -8 | 311 | 434 | FF | FF | FF | да |
| 2 | 14329 | -7 | 311 | 436 | FF | FF | FF | да |
| 3 | 14330 | -6 | 311 | 438 | FF | FF | FF | да |
| 4 | 14331 | -5 | 311 | 440 | FF | FF | FF | да |
| 5 | 14332 | -4 | 311 | 442 | FF | FF | FF | да |
| 6 | 14333 | -3 | 311 | 444 | FF | FF | FF | да |
| 7 | 14334 | -2 | 311 | 446 | FF | FF | FF | да |
| 8 | 14335 | -1 | 0 | 0 | FF | FF | FF | да |
| 9 | 14336 | +0 | 0 | 2 | FF | FF | битмап кол 0 | НЕТ |
| 10 | 14337 | +1 | 0 | 4 | FF | FF | атр кол 0 | НЕТ |

Совпадений с узором от B: 9 из 11.

Наш узор дословно (T от /INT : байт): 14327:FF, 14328:FF, 14329:FF, 14330:FF, 14331:FF, 14332:FF, 14333:FF, 14334:FF, 14335:FF, 14336:FF, 14337:FF

### 48K, порт #FF, строка 100 (опорная точка B = 36736 = 14336 + 224*100)

| k | T от /INT | T − B | vCount | hCount | D | расшифровка (наш узор) | ожидание (узор от B) | совпало |
|---|---|---|---|---|---|---|---|---|
| 0 | 36733 | -3 | 99 | 444 | FF | FF | FF | да |
| 1 | 36734 | -2 | 99 | 446 | FF | FF | FF | да |
| 2 | 36735 | -1 | 100 | 0 | FF | FF | FF | да |
| 3 | 36736 | +0 | 100 | 2 | FF | FF | битмап кол 0 | НЕТ |
| 4 | 36737 | +1 | 100 | 4 | FF | FF | атр кол 0 | НЕТ |
| 5 | 36738 | +2 | 100 | 6 | FF | FF | битмап кол 1 | НЕТ |
| 6 | 36739 | +3 | 100 | 8 | FF | FF | атр кол 1 | НЕТ |
| 7 | 36740 | +4 | 100 | 10 | 20 | битмап кол 0 (треть 1) | FF | НЕТ |
| 8 | 36741 | +5 | 100 | 12 | 80 | атр кол 0 (строка[0]=0) | FF | НЕТ |
| 9 | 36742 | +6 | 100 | 14 | 21 | битмап кол 1 (треть 1) | FF | НЕТ |
| 10 | 36743 | +7 | 100 | 16 | 81 | атр кол 1 (строка[0]=0) | FF | НЕТ |

Совпадений с узором от B: 3 из 11.

Наш узор дословно (T от /INT : байт): 36733:FF, 36734:FF, 36735:FF, 36736:FF, 36737:FF, 36738:FF, 36739:FF, 36740:20, 36741:80, 36742:21, 36743:81

### 48K, порт #BF, строка 0 (опорная точка B = 14336 = 14336)

| k | T от /INT | T − B | vCount | hCount | D | расшифровка (наш узор) | ожидание (узор от B) | совпало |
|---|---|---|---|---|---|---|---|---|
| 0 | 14327 | -9 | 311 | 432 | FF | FF | FF | да |
| 1 | 14328 | -8 | 311 | 434 | FF | FF | FF | да |
| 2 | 14329 | -7 | 311 | 436 | FF | FF | FF | да |
| 3 | 14330 | -6 | 311 | 438 | FF | FF | FF | да |
| 4 | 14331 | -5 | 311 | 440 | FF | FF | FF | да |
| 5 | 14332 | -4 | 311 | 442 | FF | FF | FF | да |
| 6 | 14333 | -3 | 311 | 444 | FF | FF | FF | да |
| 7 | 14334 | -2 | 311 | 446 | FF | FF | FF | да |
| 8 | 14335 | -1 | 0 | 0 | FF | FF | FF | да |
| 9 | 14336 | +0 | 0 | 2 | FF | FF | битмап кол 0 | НЕТ |
| 10 | 14337 | +1 | 0 | 4 | FF | FF | атр кол 0 | НЕТ |

Совпадений с узором от B: 9 из 11.

Наш узор дословно (T от /INT : байт): 14327:FF, 14328:FF, 14329:FF, 14330:FF, 14331:FF, 14332:FF, 14333:FF, 14334:FF, 14335:FF, 14336:FF, 14337:FF

### 48K, порт #BF, строка 100 (опорная точка B = 36736 = 14336 + 224*100)

| k | T от /INT | T − B | vCount | hCount | D | расшифровка (наш узор) | ожидание (узор от B) | совпало |
|---|---|---|---|---|---|---|---|---|
| 0 | 36733 | -3 | 99 | 444 | FF | FF | FF | да |
| 1 | 36734 | -2 | 99 | 446 | FF | FF | FF | да |
| 2 | 36735 | -1 | 100 | 0 | FF | FF | FF | да |
| 3 | 36736 | +0 | 100 | 2 | FF | FF | битмап кол 0 | НЕТ |
| 4 | 36737 | +1 | 100 | 4 | FF | FF | атр кол 0 | НЕТ |
| 5 | 36738 | +2 | 100 | 6 | FF | FF | битмап кол 1 | НЕТ |
| 6 | 36739 | +3 | 100 | 8 | FF | FF | атр кол 1 | НЕТ |
| 7 | 36740 | +4 | 100 | 10 | 20 | битмап кол 0 (треть 1) | FF | НЕТ |
| 8 | 36741 | +5 | 100 | 12 | 80 | атр кол 0 (строка[0]=0) | FF | НЕТ |
| 9 | 36742 | +6 | 100 | 14 | 21 | битмап кол 1 (треть 1) | FF | НЕТ |
| 10 | 36743 | +7 | 100 | 16 | 81 | атр кол 1 (строка[0]=0) | FF | НЕТ |

Совпадений с узором от B: 3 из 11.

Наш узор дословно (T от /INT : байт): 36733:FF, 36734:FF, 36735:FF, 36736:FF, 36737:FF, 36738:FF, 36739:FF, 36740:20, 36741:80, 36742:21, 36743:81

### 128K, порт #FF, строка 0 (опорная точка B = 14362 = 14362)

| k | T от /INT | T − B | vCount | hCount | D | расшифровка (наш узор) | ожидание (узор от B) | совпало |
|---|---|---|---|---|---|---|---|---|
| 0 | 14353 | -9 | 310 | 440 | FF | FF | FF | да |
| 1 | 14354 | -8 | 310 | 442 | FF | FF | FF | да |
| 2 | 14355 | -7 | 310 | 444 | FF | FF | FF | да |
| 3 | 14356 | -6 | 310 | 446 | FF | FF | FF | да |
| 4 | 14357 | -5 | 310 | 448 | FF | FF | FF | да |
| 5 | 14358 | -4 | 310 | 450 | FF | FF | FF | да |
| 6 | 14359 | -3 | 310 | 452 | FF | FF | FF | да |
| 7 | 14360 | -2 | 310 | 454 | FF | FF | FF | да |
| 8 | 14361 | -1 | 0 | 0 | FF | FF | FF | да |
| 9 | 14362 | +0 | 0 | 2 | FF | FF | битмап кол 0 | НЕТ |
| 10 | 14363 | +1 | 0 | 4 | FF | FF | атр кол 0 | НЕТ |

Совпадений с узором от B: 9 из 11.

Наш узор дословно (T от /INT : байт): 14353:FF, 14354:FF, 14355:FF, 14356:FF, 14357:FF, 14358:FF, 14359:FF, 14360:FF, 14361:FF, 14362:FF, 14363:FF

### 128K, порт #FF, строка 100 (опорная точка B = 37162 = 14362 + 228*100)

| k | T от /INT | T − B | vCount | hCount | D | расшифровка (наш узор) | ожидание (узор от B) | совпало |
|---|---|---|---|---|---|---|---|---|
| 0 | 37152 | -10 | 99 | 438 | FF | FF | FF | да |
| 1 | 37153 | -9 | 99 | 440 | FF | FF | FF | да |
| 2 | 37154 | -8 | 99 | 442 | FF | FF | FF | да |
| 3 | 37155 | -7 | 99 | 444 | FF | FF | FF | да |
| 4 | 37156 | -6 | 99 | 446 | FF | FF | FF | да |
| 5 | 37157 | -5 | 99 | 448 | FF | FF | FF | да |
| 6 | 37158 | -4 | 99 | 450 | FF | FF | FF | да |
| 7 | 37159 | -3 | 99 | 452 | FF | FF | FF | да |
| 8 | 37160 | -2 | 99 | 454 | FF | FF | FF | да |
| 9 | 37161 | -1 | 100 | 0 | FF | FF | FF | да |
| 10 | 37162 | +0 | 100 | 2 | FF | FF | битмап кол 0 | НЕТ |

Совпадений с узором от B: 10 из 11.

Наш узор дословно (T от /INT : байт): 37152:FF, 37153:FF, 37154:FF, 37155:FF, 37156:FF, 37157:FF, 37158:FF, 37159:FF, 37160:FF, 37161:FF, 37162:FF

### 128K, порт #BF, строка 0 (опорная точка B = 14362 = 14362)

| k | T от /INT | T − B | vCount | hCount | D | расшифровка (наш узор) | ожидание (узор от B) | совпало |
|---|---|---|---|---|---|---|---|---|
| 0 | 14353 | -9 | 310 | 440 | FF | FF | FF | да |
| 1 | 14354 | -8 | 310 | 442 | FF | FF | FF | да |
| 2 | 14355 | -7 | 310 | 444 | FF | FF | FF | да |
| 3 | 14356 | -6 | 310 | 446 | FF | FF | FF | да |
| 4 | 14357 | -5 | 310 | 448 | FF | FF | FF | да |
| 5 | 14358 | -4 | 310 | 450 | FF | FF | FF | да |
| 6 | 14359 | -3 | 310 | 452 | FF | FF | FF | да |
| 7 | 14360 | -2 | 310 | 454 | FF | FF | FF | да |
| 8 | 14361 | -1 | 0 | 0 | FF | FF | FF | да |
| 9 | 14362 | +0 | 0 | 2 | FF | FF | битмап кол 0 | НЕТ |
| 10 | 14363 | +1 | 0 | 4 | FF | FF | атр кол 0 | НЕТ |

Совпадений с узором от B: 9 из 11.

Наш узор дословно (T от /INT : байт): 14353:FF, 14354:FF, 14355:FF, 14356:FF, 14357:FF, 14358:FF, 14359:FF, 14360:FF, 14361:FF, 14362:FF, 14363:FF

### 128K, порт #BF, строка 100 (опорная точка B = 37162 = 14362 + 228*100)

| k | T от /INT | T − B | vCount | hCount | D | расшифровка (наш узор) | ожидание (узор от B) | совпало |
|---|---|---|---|---|---|---|---|---|
| 0 | 37152 | -10 | 99 | 438 | FF | FF | FF | да |
| 1 | 37153 | -9 | 99 | 440 | FF | FF | FF | да |
| 2 | 37154 | -8 | 99 | 442 | FF | FF | FF | да |
| 3 | 37155 | -7 | 99 | 444 | FF | FF | FF | да |
| 4 | 37156 | -6 | 99 | 446 | FF | FF | FF | да |
| 5 | 37157 | -5 | 99 | 448 | FF | FF | FF | да |
| 6 | 37158 | -4 | 99 | 450 | FF | FF | FF | да |
| 7 | 37159 | -3 | 99 | 452 | FF | FF | FF | да |
| 8 | 37160 | -2 | 99 | 454 | FF | FF | FF | да |
| 9 | 37161 | -1 | 100 | 0 | FF | FF | FF | да |
| 10 | 37162 | +0 | 100 | 2 | FF | FF | битмап кол 0 | НЕТ |

Совпадений с узором от B: 10 из 11.

Наш узор дословно (T от /INT : байт): 37152:FF, 37153:FF, 37154:FF, 37155:FF, 37156:FF, 37157:FF, 37158:FF, 37159:FF, 37160:FF, 37161:FF, 37162:FF

### 2.5 Пентагон (свип, k = 0..10)

### Пентагон, порт #FF, защёлка 1 (бордюр, строка 293)

| k | T от /INT | vCount | hCount | h_rel | v_rel | D (что получил Z80) | vduQ (что дала бы плавающая шина) |
|---|---|---|---|---|---|---|---|
| 0 | 12169 | 294 | 24 | 22 | 234 | FF | FF = FF |
| 1 | 12170 | 294 | 26 | 24 | 234 | FF | FF = FF |
| 2 | 12171 | 294 | 28 | 26 | 234 | FF | FF = FF |
| 3 | 12172 | 294 | 30 | 28 | 234 | FF | FF = FF |
| 4 | 12173 | 294 | 32 | 30 | 234 | FF | FF = FF |
| 5 | 12174 | 294 | 34 | 32 | 234 | FF | FF = FF |
| 6 | 12175 | 294 | 36 | 34 | 234 | FF | FF = FF |
| 7 | 12176 | 294 | 38 | 36 | 234 | FF | FF = FF |
| 8 | 12177 | 294 | 40 | 38 | 234 | FF | FF = FF |
| 9 | 12178 | 294 | 42 | 40 | 234 | FF | FF = FF |
| 10 | 12179 | 294 | 44 | 42 | 234 | FF | FF = FF |

### Пентагон, порт #FF, защёлка 2 (бумага, строка 60 = v_rel 0)

| k | T от /INT | vCount | hCount | h_rel | v_rel | D (что получил Z80) | vduQ (что дала бы плавающая шина) |
|---|---|---|---|---|---|---|---|
| 0 | 31416 | 59 | 438 | 436 | 319 | FF | FF = FF |
| 1 | 31417 | 59 | 440 | 438 | 319 | FF | FF = FF |
| 2 | 31418 | 59 | 442 | 440 | 319 | FF | FF = FF |
| 3 | 31419 | 59 | 444 | 442 | 319 | FF | FF = FF |
| 4 | 31420 | 59 | 446 | 444 | 319 | FF | FF = FF |
| 5 | 31421 | 60 | 0 | 446 | 0 | FF | FF = FF |
| 6 | 31422 | 60 | 2 | 0 | 0 | FF | FF = FF |
| 7 | 31423 | 60 | 4 | 2 | 0 | FF | FF = FF |
| 8 | 31424 | 60 | 6 | 4 | 0 | FF | FF = FF |
| 9 | 31425 | 60 | 8 | 6 | 0 | FF | FF = FF |
| 10 | 31426 | 60 | 10 | 8 | 0 | FF | FF = FF |

## 3. (b) Порт #FE без нажатых клавиш

Программа `prog/ports.asm` (нижний бордюр, строки 203..206 на 48K / 200..203 на 128K), `EAR` — плюс-аргумент
стенда. Все три чтения в бумаге (`prog/ports_paper.asm`, `prog/ports_fb.asm`, строки 160..167) дали те же
байты (8 чтений подряд #FFFE в `ports_fb`: `bf bf bf bf bf bf bf bf`).
Логи: `wd/p48e0`, `wd/p48e1`, `wd/p128e0`, `wd/p128e1`, `wd/ppent`, `wd/pp*`, `wd/pf*`.

| машина | ear | бит 4 порта #FE (speaker) | `IN A,(#FE)`, A=#FF | `IN A,(#FE)`, A=#FE (полуряд CS..V) | ожидание (Сергей: «биты 7 и 5 = 1, бит 6 = последняя запись в бит 4»; настоящий 48K issue 3 без ленты: BF при бите 4 = 0, FF при 1) |
|---|---|---|---|---|---|
| 48K | 0 | 0 | **BF** | BF | BF ✓ |
| 48K | 0 | 1 | **FF** | — | FF ✓ |
| 48K | 1 | 0 | **FF** | FF | FF (EAR=1 на входе) ✓ |
| 128K | 0 | 0 | **BF** | BF | BF ✓ |
| 128K | 0 | 1 | **FF** | — | FF ✓ |
| 128K | 1 | 0 | **FF** | FF | FF ✓ |
| Пентагон | 0 | 0 / 1 | **BF** / **FF** | BF | то же |

Расшифровка: биты 0..4 = `keyQ` = 11111 (клавиатура молчит), бит 5 = 1, бит 6 = `ear | speaker`
(`main.v:927`), бит 7 = 1. Бит 3 (MIC) на бит 6 у нас НЕ влияет (у issue 2 влиял бы) — записано, не
проверялось отдельно. Порт #FE в бумаге плавающую шину не отдаёт: `IN A,(#FE)` на пикселях, где `vduQ`
≠ FF, всё равно даёт BF (`wd/pf48`: 8 чтений, `vduQ` печатался).

## 4. (c) Порты AY: #FFFD, #BFFD, #7FFD

Программы `prog/ports.asm` (бордюр), `prog/ports_paper.asm` и `prog/ports_fb.asm` (бумага, по 8 чтений
подряд с шагом 23 T = 7 mod 8, то есть все восемь фаз узора). Все три машины: у Atlas TurboSound
(`turbosound_bulb.v`) стоит всегда, `model` в мультиплексоре порта не участвует.

| чтение | 48K | 128K | Пентагон | ожидание настоящего 128K | вердикт |
|---|---|---|---|---|---|
| `IN (#FFFD)` после `R7 := #3F` | **3F** ×8 (и там, где `vduQ` = 94/5A/45 — не плавающая) | **3F** ×8 | **3F** ×8 | 3F (читается выбранный регистр) | ✓ |
| `IN (#FFFD)` R1 после записи #FF | 0F | 0F | 0F | 0F (регистр 4-битный) | ✓ |
| `IN (#FFFD)` R6 после записи #FF | 1F | 1F | 1F | 1F (5-битный) | ✓ |
| `IN (#FFFD)` R14 (порт A) | 00 | 00 | 00 | у нас `IOA_in = 0` (`turbosound_bulb.v:141`); на настоящем 128K порт A занят RS232/Keypad — записано как есть | — |
| `IN (#BFFD)` | **плавающая шина**: в бордюре FF; в бумаге 7×FF и **42** = битмап кол. 2 (h_rel 26, v_rel 162) | в бумаге 7×FF и **D1** = атрибут кол. 17 (h_rel 144, v_rel 159) | **FF** ×8 (в т. ч. при `vduQ` = 97, 3D) | настоящий 128K: регистр данных AY на чтение не отвечает (BDIR=0, BC1=0) → плавающая шина | ✓ (48K/128K), Пентагон FF |
| `IN (#7FFD)` | **плавающая шина**: 7×FF и **83** = атрибут кол. 3 (h_rel 32, v_rel 163) | 8×FF — все восемь чтений попали в FF-фазы или правый бордюр (h_rel 242, 288, 334, 380, 426, 34, 98, 162: mod 16 = 2 или ≥ 256); путь в RTL тот же, что у 48K (`model` не участвует) | **FF** ×8 (при `vduQ` = 90, 36, 21) | не читается → плавающая шина | ✓ |
| `IN (#FFFD)` после `OUT #FFFD,#01` и `OUT #FFFD,#17` | **3F** (= R7) | 3F | 3F | настоящий AY-3-8912 адрес со старшим полубайтом ≠ 0 НЕ защёлкивает → остался бы R1 = **0F** | ✗ расхождение: `jt49_bus.v:211-212` защёлкивает `addr <= din[3:0]` всегда, а `addr_ok` лишь блокирует запись/чтение через `cs_n`; `dout` при этом отдаёт регистр по новому адресу |

Расшифровка байтов плавающей шины — по заливке `SCRFILL` (битмап = `{0, треть[1:0], кол[4:0]}`,
атрибут = `{1, строка[0], 0, кол[4:0]}`): 42 = битмап третьей трети (строка 162), колонка 2 — ровно то,
что ULA выбрала на h_rel 24..25 (`a <= …h_addr[7:4], h_addr[2]` при h_addr = 24: колонка 2) и отдала на
26..27; 83 = атрибут колонки 3 (второй атрибут группы 16..31, живёт на h_rel 32..33); D1 = атрибут
колонки 17, строка[0] = 1 (знакоряд 19). Все три совпадают с таблицей §1.

## 5. (d) Пентагон: IN A,(#FF) в бумаге и в бордюре

`main.v:929`: `pentagon ? 8'hFF : vduQ` — опция машины по правилу проекта (MiSTer: FF; Sizif-512: атрибут).
Текущее поведение числом (`wd/fpentff`, свип 48 T в бордюре строки 293 и 48 T через границу бумаги
строки 60 = v_rel 0; `wd/pfpent`, 8 чтений в бумаге строки 104..105; `wd/pppent`):

| где | `IN A,(#FF)` | `IN A,(#BF)` | `vduQ` в те же моменты |
|---|---|---|---|
| бордюр (v_rel 234, h_rel 22..69) | FF ×48 | — | FF |
| бумага, строка v_rel 0, h_rel 440..447 → 0..87 (свип) | FF ×48 | — | см. таблицу §2.5: FF / битмап / атрибут по фазе |
| бумага, v_rel 104..105, h_rel 34..440 | FF ×8 (при `vduQ` = CA, D9) | FF ×8 (при `vduQ` = C7, 2E, 3D) | битмап/атрибут |

Итог: на Пентагоне любой незанятый порт отдаёт **FF** всегда; узор выборки внутри `video.v` при этом
существует (`q` живой) и мог бы быть выведен опцией (вариант Sizif — «всегда атрибут»: у Сергея
`port_ff_attr = (MACHINE == PENT) | …`, `video.v:1276`).

## 6. (e) Снег

Не измерялось: стенд держит `snow_off = 1` (в прошивке снег включён, `opt_snow = 1`). Все числа выше —
без снега.

## 7. Оговорки и гочи (оплачены в этом стенде)

1. **Длина обработчика прерывания обязана быть кратна 4 T** (`prog/fbus.asm`, `PADT`). У первой
   редакции свипа она равнялась 533 T ≡ 1 (mod 4): сетка `HALT` (4 T) уезжала относительно /INT на 1 T за
   кадр, подтверждение приходило через 4.5, 5.5, 6.5, 7.5 T после спада, и k-я защёлка ложилась на
   **2 T за шаг с заворотом раз в 4 кадра** — половина фаз не измерялась вовсе. Найдено сравнением
   меток времени `INT ACK` (период = кадр + 1 T) и спадов `Video.irq` (период = ровно кадр, IRQMON).
   Правило: сумма длительностей всего, что исполняется за кадр вне циклов по 24 T, ≡ 0 (mod 4).
2. **Вектор IM2 на шине = 00, а не FF/плавающая шина.** В цикле подтверждения на шине адресов стоит PC
   команды `HALT` (`0x901D`: `a[5] = 0`), и конус кемпстона (`ioDF`, `main.v:695`) отдаёт `joy1|joy2 = 0`.
   Таблица IM2 из 257 одинаковых байт спасает; программе с неоднородной таблицей на нашей машине (как и
   на настоящей с интерфейсом Kempston) не поздоровилось бы. Сама природа вектора — не дефект стенда.
3. Одиночные чтения #BFFD/#7FFD «в бумаге» дважды попали в FF-фазу узора (`ports_paper`): плавающую шину
   доказывать только серией со шагом, взаимно простым с 8 (в `ports_fb` шаг 23 T).
4. `vduQ` печатается стендом всегда, но на шине `d` он оказывается только при выборе ветки
   мультиплексора: у Пентагона и у портов AY/FE расхождение `D ≠ vduQ` — норма, не ошибка.
5. Снег выключен; DivMMC/GS/NEMO/мышь/Z-Controller/дисковод выключены константами (их ветки
   мультиплексора выше плавающей шины не проверялись).
6. Кемпстон-джойстик (`#1F` и весь конус `a[5]=0`) не измерялся — он не в задании; отмечено лишь, что
   он перехватывает вектор IM2.

## 8. Файлы

| файл | что |
|---|---|
| `tb_ports.sv`, `run.sh`, `bg.sh` | стенд-наследник харнеса (добавки помечены `PORTS:`), сборка/запуск, фоновый запуск (`nohup`, свой `wd/<имя>`) |
| `prog/fbus.asm`, `prog/fbus_gen.py`, `prog/fbus_stubs.inc`, `prog/variants.txt`, `prog/build.sh` | свип плавающей шины: заглушки точной задержки на каждое k, варианты под машину/порт (W1/W2, PADT) |
| `prog/fbus_f48ff.bin`, `…f48bf…`, `…f128ff…`, `…f128bf…`, `…fpentff…`, `prog/fbus_cal48.bin` | собранные свипы (`ORG=9000`) |
| `prog/ports.asm`, `prog/ports_paper.asm`, `prog/ports_fb.asm` (+ `.bin`) | пункты (b), (c): чтения #FE/#FFFD/#BFFD/#7FFD/#FF/#BF в бордюре, в бумаге, серии по 8 фаз |
| `prog/tim.asm` (+ `.bin`) | микротест длительностей команд T80 |
| `sweep_table.py` | разбор логов свипа в таблицы этого отчёта |
| `logs/`, `wd/<имя>/nohup.out` | логи (`wd/irq` — диагностика дрейфа сетки HALT, `wd/p*`, `wd/pp*`, `wd/pf*`, `wd/f*`) |
