Alex-Electron/ZX_BulbuLator/research/15-pentagon/sim/timing/t80/RESULT.md

# Стенд процессора: наш T80 (T80pa + форк `t80_bulb/T80.vhd`) отдельно от машины

Каталог: `~/bulb-v13/research/15-pentagon/sim/timing/t80/` (ThinkPad). Дата: 2026-08-28. Шаг 0 — только измерения,
RTL не правился.

## Что стоит на стенде

- Объект: модуль `cpu` из `sources/build/zx/src/cpu.v` (обёртка над `T80pa`, `Mode=0`, внутри `IOWait=1`,
  `WAIT_n='1'`, `BUSRQ_n='1'`), набор VHDL **по правилу сборки** `build.tcl:20-46`:
  `zx/src/T80/{T80_Pack,T80_Reg,T80_MCode,T80_ALU,T80pa}.vhd` + **наш форк** `sources/t80_bulb/T80.vhd`
  (апстримный `zx/src/T80/T80.vhd` не читается).
- Тактование как в машине: мастер `clock` 56.667 МГц (период 17.647 нс), счётчик `ce` и разрешения
  воспроизведены из `sources/clock_zx.v:65-70` (ветка «normal»), регистрируются на **negedge** мастера:
  `ce==0` → `ne3M5`+`ne7M0`; `ce==4` → `pe7M0`; `ce==8` → `pe3M5`+`ne7M0`; `ce==12` → `pe7M0`.
  Процессору отданы `pe = pe3M5`, `ne = ne3M5` (то есть `contend=1`, `cpu_hold=0`: без контеншена и без
  тактов ожидания памяти — стенд процессора, а не машины).
- Единицы. **1 T = один импульс `pe3M5` = 16 мастер-тактов (282.4 нс).** «T начинается на pe» — posedge
  мастера при `pe3M5=1`; «середина T» — следующий posedge при `ne3M5=1` (через 8 мастер-тактов).
  Все наблюдения сняты на negedge мастера: там уже видны выходы процессора после posedge, а разрешения
  ещё показывают то значение, что действовало на этом posedge.
- Память: поведенческая 64 КБ, чтение комбинационное (`d = mem[a]`), запись по posedge при `MREQ&WR`.
  Порты: `IN` отдаёт либо константу, либо **счётчик мастер-тактов** (тогда по значению в A видно, на каком
  именно posedge процессор взял байт); в цикле подтверждения прерывания (`M1&IORQ`) на шину подаётся
  байт вектора. `OUT` защёлкивается по posedge при `IORQ&WR` (так же, как бордюр в `main.v`).
- Файлы: `tb_cpu.sv` (стенд), `prog_qflag.asm`, `prog_int.asm`, `prog_bus.asm`, `prog_dur.asm` (программы,
  pasmo), `bin2hex.py`, `run.sh` (сборка+прогон, `./run.sh HIER` включает иерархические зонды
  `dut.Cpu.TState/MCycle/DI_Reg`), `run.log` — полный протокол прогона, из которого взяты все числа ниже.
- Гоча xsim: `cpu.v` без `timescale` — нужен `xelab -timescale 1ns/1ps`; `%s` со строкой не-ASCII в
  `$display` печатает мусор (подписи тестов сделаны ASCII).

## 1. Q-флаг: SCF/CCF и недокументированные биты X (3) и Y (5)

Повторены случаи A и B стенда Сергея `tb_qflag.v` (вход через `POP AF` — «флаги не вычислялись»,
Q=0 у Zilog), плюс наши дополнительные. Результат — байт F после команды, снятый через `PUSH AF / POP BC /
LD A,C / OUT (n),A`.

| Случай | Подготовка | Команда | Zilog (Q-модель) | «XY только из A» (NEC-подобно) | **Наш T80** |
|---|---|---|---|---|---|
| A  | F=$28 A=$00 через POP AF | SCF | $29 | $01 | **$01** |
| B  | F=$00 A=$28 через POP AF | SCF | $29 | $29 | **$29** |
| A' | F=$28 A=$00 через POP AF | CCF | $29 | $01 | **$01** |
| B' | F=$00 A=$28 через POP AF | CCF | $29 | $29 | **$29** |
| D  | F=$29 A=$00 через POP AF | CCF | $38 | $10 | **$10** |
| C0 | A=0, B=$28, `CP B` (F до SCF) | — | $BB | — | **$BB** |
| C  | A=0, B=$28, `CP B`, затем | SCF | $81 (Q=F ⇒ (Q^F)\|A = A) | $81 | **$81** |

Вердикт по критерию `tb_qflag` (A и B оба $29 ⇒ Zilog): **NOT Zilog — X и Y после SCF/CCF берутся только
из A.** Это ровно то, что записано в `t80_bulb/T80.vhd:588-602`: `F(Flag_Y) <= ACC(5); F(Flag_X) <= ACC(3)`
и для CCF, и для SCF, регистра Q в ядре нет. Случай C ничего не различает (у Zilog при Q=F результат тоже
равен A) — приведён, чтобы показать, что модель «F|A без Q» у нас тоже не реализована: было бы $A9.
Ожидание из задания ($01/$29) **подтверждено измерением**.

## 2. Стоимость приёма прерывания

Метод (как в `tb_intack.v`, но в наших единицах): программа `DI; LD SP; LD A,$80; LD I,A; IM 1|2; EI; NOP…`
(слайд NOP) либо `HALT`; линия опускается сразу после спада M1 опорной команды (NOP по `$0014` или 3-я
итерация под HALT) и держится до M1 обработчика. Считаются спады `M1_n` (они всегда падают на pe) и число T
между ними. Цикл подтверждения INT опознаётся как M1, во время которого активен `IORQ`.

| Режим | Ожидание | От спада M1 опорной команды до спада M1 обработчика, T | Из них опорная команда, T | **Стоимость приёма (спад M1 цикла подтверждения → спад M1 первой команды обработчика), T** | Эталон Z80 |
|---|---|---|---|---|---|
| IM 1 | NOP-слайд | 17 | 4 | **13** | 13 |
| IM 1 | HALT | 17 | 4 | **13** | 13 |
| IM 2 | NOP-слайд | 23 | 4 | **19** | 19 |
| IM 2 | HALT | 23 | 4 | **19** | 19 |
| NMI  | NOP-слайд | 15 | 4 | **11** | 11 |
| NMI  | HALT | 15 | 4 | **11** | 11 |

Под HALT наш T80 продолжает выдавать M1 каждые 4 T по адресу PC (байт **после** HALT) — стоимость приёма из
HALT та же, что из NOP (как у настоящего Z80). Форк B0128 (NMI = 11, не 13) измерением подтверждён.

### 2б. На каком фронте и в каком T T80 читает `INT_n`

Опорный NOP по `$0014`: его спад M1 = posedge #0 (pe, начало T1); posedge #16 = pe начала T2, #32 — T3,
#48 — T4, **#64 — pe конца T4 = начала T1 следующей команды** (на нём T80 решает, принимать ли прерывание:
`T80.vhd:1166`, `INT_n` берётся напрямую, без синхронизатора). Линия опускалась на negedge после posedge
#off, то есть впервые видна процессору на posedge #(off+1).

| off (negedge после posedge #) | Первый posedge, где `irq_n=0` | Принято по опорному NOP? | M1 между опорой и обработчиком |
|---|---|---|---|
| 44, 47, 48, 55, 56, 60, 62 | ≤ #63 | да | 1 (только цикл подтверждения) |
| **63** | **#64 (сам pe конца T4)** | **да** | 1 |
| **64** | #65 | **нет — по следующему NOP** | 2 (лишний NOP + подтверждение) |
| 65, 66 | #66, #67 | нет | 1 (после следующего NOP) |

**Вывод: `irq` выбирается на pe (pc3M5 в машине), на том самом posedge, который завершает последний T
команды (= начинает T1 следующей), комбинационно; достаточно, чтобы линия была низкой на этом одном
posedge.** Опускание внутри T4 (off 48…63) ещё успевает — у настоящего Z80 `/INT` читается на фронте
последнего такта команды, то есть на 1 T раньше. Следствие для стенда INT-геометрии: в `main.v:177`
`irq <= vduI` перерегистрируется на `pc3M5`, значит для пути «Type 1/Early» `vduI` должен быть низким на pe
**за один T до** этого решающего pe (это следует из кода, на данном стенде не измерялось: `main.v` в стенд не
входит); путь `int_sel==1` (`ula_late`) отдаёт `vduI` напрямую и решающий pe у него тот же, что измерен здесь.

NMI (тот же метод, линия `nmi_n`):

| off | Первый posedge с `nmi_n=0` | Принято по опорному NOP? |
|---|---|---|
| 60, 62 | ≤ #63 | да |
| **63** | **#64** | **нет** — по следующему NOP |
| 64, 65, 66 | #65… | нет |

NMI детектируется по фронту на **каждом** мастер-такте (`T80.vhd:1099`, `OldNMI_n`, без CEN) в защёлку
`NMI_s`, а решение читает уже защёлку — поэтому NMI обязан упасть **хотя бы на один мастер-такт раньше**
решающего pe (виден на posedge ≤ #63), а не на самом pe как INT. Разница INT/NMI = 1 мастер-такт (17.6 нс),
не T.

## 3. Циклы записи: LD (HL),A, OUT (n),A, OUT (C),A

Трасса `prog_bus`, столбец «TS» — внутренний `TState` T80 (у него в I/O-цикле такт ожидания реализован
**повтором TState=1**, а не отдельным TW: внешняя нумерация в таблице — по шине, как у Z80).

### Память — `LD (HL),A`, цикл M2 (7 T всей команды, 3 T цикла)

| Момент (шина) | Фронт | `A` | `MREQ` | `WR` | `RD` | `D` (наш `q`) |
|---|---|---|---|---|---|---|
| начало T1 | pe | =HL уже валиден | 1 | 1 | 1 | старое |
| середина T1 | ne | | **↓0** | 1 | 1 | старое |
| начало T2 | pe | | 0 | 1 | 1 | **валиден** (`DO<=BusB` на pe конца T1) |
| середина T2 | ne | | 0 | **↓0** | 1 | валиден |
| начало T3 | pe | | 0 | 0 | 1 | валиден |
| середина T3 | ne | | **↑1** | **↑1** | 1 | держится до конца цикла |

`MREQ` активен 32 мастер-такта (2 T: сер. T1 → сер. T3), `WR` — 16 (1 T: сер. T2 → сер. T3). Настоящий Z80:
`/MREQ` T1↓ → T3↓, `/WR` T2↓ → T3↓, данные с конца T1 — **совпадает по всем фронтам.** Команда `LD (nn),A`
(M4) — та же картина, записанный байт ($AA) в памяти проверен.

### Порт — `OUT (n),A` (M3) и `OUT (C),A` (M2 после `ED`), 4 T цикла

| Момент (шина) | Фронт | `A` | `IORQ` | `WR` | `q` |
|---|---|---|---|---|---|
| начало T1 | pe | порт валиден ($55FE / $7FFD) | 1 | 1 | старое |
| середина T1 | ne | | 1 | 1 | старое |
| **начало T2** | **pe** | | **↓0** | **↓0** | **валиден (одновременно с IORQ)** |
| T2, TW (авто-ожидание), начало T3 | | | 0 | 0 | валиден |
| **середина T3** | **ne** | | **↑1** | **↑1** | держится |

`IORQ`/`WR` активны 40 мастер-тактов = 2.5 T (pe начала T2 → ne середины T3). Настоящий Z80: `/IORQ`,`/WR`
T2↑ → T3↓ при одном автоматическом TW — **совпадает.** Внутри T80: `T80pa.vhd:161-164` ставит `IORQ_n`,
`WR_n` на `CEN_p` при `TState=1`, снимает на `CEN_n` при `TState=3`; для памяти `WR_n` ставится на `CEN_n`
при `TState=2` (`T80pa.vhd:196`), снимается там же при `TState=3`.

Точка защёлкивания бордюра в `main.v:224` (`if(pe7M0) if(!ioFE && !wr) border <= q`): за время активного
`IORQ&WR` проходит **5 импульсов `pe7M0`**; первый — через **4 мастер-такта (¼ T) после pe начала T2**
(см. строки `** pe7M0 with IORQ&WR active` в `run.log`), то есть бордюр меняется на первом же из них.
Дальнейшие 4 повторяют тот же байт.

### Эквивалент `T2Write`

В нашей версии T80 (`t80_bulb/T80.vhd:85-95`) generic `T2Write` **отсутствует** — есть только `Mode`,
`IOWait`, `Flag_*`; `T80pa.vhd` (`Mode` единственный generic) формирует `WR_n` сам, как показано выше.
У `T80se` Сергея (`/tmp/ep4/T80/T80se.v:104,196-208`): `T2Write=0` → `WR_n` активен с **границы T2/T3**
(на весь T3), `T2Write=1` → с **границы T1/T2** (весь T2 и T3). Наш T80pa для памяти даёт `WR_n` с **середины
T2** — ровно между этими двумя вариантами и ровно как настоящий Z80 (T2↓). Для портов наш вариант совпадает с
`T2Write=1` по моменту включения (граница T1/T2) и снимается на полтакта раньше (сер. T3, а не граница T3/T4).
То есть: **наш T80pa ≠ ни `T2Write=0`, ни `T2Write=1` буквально; по фронтам шины он ближе к `T2Write(1)`
(тот, что использует Сергей), сдвинут на полтакта позже для памяти.**

## 4. Когда защёлкивается байт при `IN`

Измерено двумя способами: (а) шина в I/O-цикле несла счётчик мастер-тактов, и значение, попавшее в A,
указало posedge; (б) зонд `dut.Cpu.DI_Reg` (защёлка `T80pa.vhd:168-170`: `CEN_n and TState=3`).

| Команда | Цикл | `IORQ`,`RD` ↓ | Байт взят с шины | `IORQ`,`RD` ↑ | Совпадение (а)/(б) |
|---|---|---|---|---|---|
| `IN A,(n)` | M3, 4 T | pe начала T2 | **ne середины T3** (posedge при `ne3M5=1`, 4-й T цикла) | тот же posedge (неблокирующе — во время него `IORQ` ещё 0) | да ($80 = счётчик на этом posedge) |
| `IN A,(C)` | M2 после `ED`, 4 T | pe начала T2 | **ne середины T3** | тот же posedge | да ($10) |

Настоящий Z80 читает шину на спаде T3 — **совпадает.** Подтверждение для `main.v:83,709`
(`tape_sample_strobe = tape_sample & nc3M5`, «T80 latches DI here»): защёлка действительно на **`nc3M5`
(ne)**, но за один `IN #FE` строб срабатывает **три раза** — на ne середины T2, ne середины TW и ne середины T3
(`IORQ` низок на всех трёх) — и с защёлкой T80 совпадает только **третий**. Потребитель в
`bulbulator_zx_ddr_top.v:1653-1660` перезаписывает кандидата на каждом стробе и фиксирует его по спаду
`tape_sample`, то есть берёт последний — с процессором согласован. Любой другой потребитель строба должен
делать так же (или брать бит по спаду `IORQ`), одиночный «первый строб» опередит процессор на 1 T.

Чтение памяти (операнд, `LD A,(HL)`): `MREQ`,`RD` ↓ на ne середины T1, байт в `DI_Reg` на ne середины T3,
`MREQ`,`RD` ↑ там же. Опкод в M1: `RD`,`MREQ` ↓ ne сер. T1, опкод берётся **на pe начала T3** (`DInst`
напрямую, `T80.vhd:455`), `RD` ↑ там же; регенерация `RFSH` низок 2 T (начало T3 → начало T1 следующего
цикла), `MREQ` регенерации низок сер. T3 → сер. T4. Всё как у Z80.

## 5. Длительности команд (число pe между спадами M1)

| Команда | Эталон Z80, T | **У нас, T** |
|---|---|---|
| NOP | 4 | **4** |
| DI | 4 | 4 |
| LD A,(HL) | 7 | **7** |
| LD (HL),A | 7 | **7** |
| OUT (n),A | 11 | **11** |
| IN A,(n) | 11 | **11** |
| OUT (C),A | 12 (4+8) | **12** (4+8) |
| IN A,(C) | 12 (4+8) | **12** (4+8) |
| JP nn | 10 | **10** |
| DJNZ (переход / без) | 13 / 8 | **13 / 8** |
| LDIR (итерация / последняя) | 21 / 16 | **21 / 16** (4+17 / 4+12) |
| HALT (каждая итерация) | 4 | **4** |
| LD SP,nn; LD HL,nn; LD DE,nn; LD BC,nn | 10 | 10 |
| LD A,n; LD B,n | 7 | 7 |
| INC A; SCF | 4 | 4 |
| LD A,(nn); LD (nn),A | 13 | 13 |
| PUSH HL / POP HL | 11 / 10 | 11 / 10 |
| CALL nn / RET | 17 / 10 | 17 / 10 |
| LD IX,nn | 14 | 14 |
| LD (IX+d),A; LD A,(IX+d) | 19 | 19 |
| JR cc (без перехода / с переходом) | 7 / 12 | 7 / 12 |
| EX (SP),HL | 19 | 19 |
| ADD A,(HL) | 7 | 7 |

Ни одного расхождения по длительностям. Спад M1 всегда попадает на pe (стенд проверяет это на каждом спаде).

## Что не измерено / оговорки

- Стенд без контеншена и без `mem_wait`: поведение при гашении `pc3M5`/`nc3M5` (сколько T реально снимает
  ULA и совпадает ли это с узором 6,5,4,3,2,1,0,0) — предмет стенда машины, не процессора.
- Путь `irq <= vduI` на `pc3M5` из `main.v:177` в стенд не входит: «+1 T» для Early описан по коду, не
  измерен.
- `WAIT_n` не подавался (в машине он тоже привязан к '1'), поэтому вставка внешних ожиданий не проверялась.
- Момент появления данных `q` в записи в память (начало T2) сверен только с типовой диаграммой Z80 (данные
  валидны к T2), без пикосекундного сравнения — на стенде шаг наблюдения полтакта (8 мастер-тактов).
