Alex-Electron/ZX_BulbuLator/research/15-pentagon/docs/ISSUES_AUDIT.ru.md

# Сверка трекера с кодом — 2026-09-18

В трекере 93 открытых пункта и 10 закрытых, последнее закрытие — 9 июля. За два месяца сделано
много, но в трекере это не отражено. Ниже сверка: каждый вердикт проверен по коду прошивки и
ядра, а не по памяти.

## Сделано, можно закрывать

| Пункт | Чем закрыт |
|---|---|
| #5 Быстрая загрузка TAP/TZX | SMART LOAD (стандартная лента 48K запускается как снэпшот) плюс разгон 8× для остального |
| #8 Свой набор ПЗУ для Спектрума | ПЗУ грузится с карты, 4 страницы, выбор набора опцией машины |
| #9 Джойстик Kempston | есть; отдельно разобран конус портов этого интерфейса |
| #35 / #77 Ядро NES | играет чисто; #77 дублирует #35 |
| #43 Ядро Пентагон 128/256/1024 | Пентагон 1024 на плате: страничность, ПЗУ, дискета, тонкий бордюр |
| #51 Виртуальные накопители (зонтик) | закрыт своими частями: #52 и #53 |
| #52 TR-DOS / Beta Disk (.trd/.scl, WD1793) | чтение и **запись**, буква привода спрашивается при вставке |
| #53 DivIDE / esxDOS (.hdf, 8-битный IDE) | NEMO-IDE читает `.hdf` байт в байт; DivMMC/esxDOS монтирует `.img/.vhd/.mmc` и режим «папка» |
| #57 Маппер ввода с профилями на машину | визард захвата кнопок, ключи `<тег>.joymap1/2`, живая карта грузится на смене машины |
| #59 Кроп бордюра по сторонам, на машину | сделано в v0.15.440; заодно разведены кроп и панорама |
| #65 Быстрая загрузка ленты | ловушка плюс разгон; вторая часть SHOCK принята на 8× |
| #83 General Sound | играет музыку: свой Z80, память, 4-канальный ЦАП, пик-метр |
| #86 FORMAT в TR-DOS не форматирует | Write Track реализован (v0.15.416) |
| #101 Опознание ядра дескриптором | ядро опознаётся по имени из слова в битстриме, а не по номеру версии |
| #104 Запись на карту обрывается, отчитываясь успехом | причина установлена: кончилось место на карте, служба отчиталась успехом, записав обрезок. Правило записи — временный файл, сверка размера **листингом каталога**, потом переименование |

## Сделано частично

| Пункт | Что есть и чего нет |
|---|---|
| #18 Сохранение и загрузка состояния машины | загрузка `.z80`/`.sna` есть, сохранения нет |
| #41 Надёжность клавиатуры (зонтик) | кадр собирает фабрика, префиксы свёрнуты, есть свой регистр диагностики. Открытыми остаются #37 (редкие пропуски) и #38 (авторестарт по ошибке чётности) |
| #44 Очередь событий клавиатуры | очередь есть в фабрике, но развязка интерфейса от сырого регистра не сделана |
| #63 Масштабирование вывода | целочисленное увеличение на каждую машину есть; полноэкранного и вертикального режимов нет |
| #82 Веб-пульт платы | в прошивке реализован, не работает по причине вне прошивки: Ethernet платы висит на выводах ПЛИС, нужен битстрим с GEM0 на ногах PHY |
| #96 Пентагон до идеала | геометрия кадра и тонкий бордюр закрыты; приёмка таймингов не прогонялась, порт `#FF` (#103) ждёт опции |
| #100 Точка ловушки и режимы разгона переключателями | политика разгона разведена по смыслу (проигрывание отдельно, ускорение отдельно), но наружу переключателями не выведена |
| #105 Автотесты числами | стенды в симуляторе и матрица по фазам входа есть, приборы снимают числа с экрана машины; автоматического сторожа регрессий нет |

## Открыто, работы не начиналось

- **Машины**: #34/#54/#55 C64, #67 ATM Turbo, #66 общий режим разгона, #97 мастер-клок 56 МГц,
  #102 раздельные битстримы, #103 порт `#FF` Пентагона опцией.
- **Периферия**: #7 настоящая шина ZX-Bus, #12 внешний ЦАП, #13/#14 джойстики Денди и Sega,
  #33 вход ленты с разъёма, #84 ULAplus, #85 два джойстика Interface 2, #106 запись в образ IDE,
  #6 CP/M.
- **Звук**: #87 каркас чиптюн-движка и всё, что на него опирается — #47 трекеры Vortex,
  #88 дампы регистров, #89 TurboSound в плеере, #90…#92 редкие трекеры и `.ay`, #93 музыка SAA,
  #94 YM2203, #95 ZX-цифра, #48 консольные форматы, #49 MIDI, #50 форматы без потерь,
  #10 MOD, #11 SID, #45 окно плеера с анализатором, #46 расширение форматов, #62 перемотка,
  #99 микшер без насыщения.
- **Навигатор**: #22…#32 функции в стиле DOS Navigator (быстрый поиск, фильтр, дерево,
  рекурсивный поиск, информация о файле, атрибуты, режимы панелей, история путей, две панели,
  редактор, просмотрщик), #56 избранное и недавние, #58 правка образов дискет внутри навигатора,
  #79/#80 файловый менеджер и запуск через браузер, #78 поток бордюра, #81 автономная сеть,
  #4 картинка-подсказка с раскладкой.
- **Лента и мгновенная загрузка (дальние планы)**: #68…#76.
- **Прочее**: #60 заморозка кадра на паузе, #61 индикатор времени на WAV/MP3, #98 одновременные
  источники в клавиатурной матрице.

## Что предлагается сделать в трекере

1. Закрыть 16 пунктов из первой таблицы, вписав в каждый доказательство: номер ядра или версию
   прошивки и чем проверено на плате.
2. Пунктам из второй таблицы поправить заголовок под остаток работы, чтобы «частично» не читалось
   как «не начато».
3. #77 закрыть как дубль #35.
4. #43 закрыть вместе с публикацией шага 15 — это его зонтик.
