Alex-Electron/ZX_BulbuLator/research/15-pentagon/sources/loader_main.c

#include <stdint.h>
#include "xil_cache.h"   /* Xil_DCacheEnable / Xil_ICacheEnable */
#include "xil_mmu.h"     /* Xil_SetTlbAttributes + NORM_NONCACHE (carve the fabric-shared DMA window) */
#include "ff.h"          /* FatFs (xilffs) - BSP provides xsdps + ChaN FatFs */
#include "mp3dec.h"      /* shared minimp3 source: MP3 as music (player) AND as cassette (edge-detect) */
#include "xtime_l.h"     /* XTime / COUNTS_PER_SECOND - long-name marquee timing */
#include "xscugic.h"     /* Step 14.3b: GIC + private timer drive the 1 ms audio-consumer interrupt */
#include "xscutimer.h"
#include "xil_exception.h"

static const char* machine_name(void);
static const char* machine_type(void);

/* universal music player (player.c): machine-agnostic ARM soft-synth -> HDMI audio FIFO */
int  player_play_psg(const char* path);
int  player_play_wav(const char* path);   /* Step 14.3: stream a .wav (PCM) as music */
int  player_play_mp3(const char* path);   /* Step 14.3: stream an .mp3 (minimp3) as music */
int  player_fmt(void);                    /* 0=PSG 1=WAV 2=MP3 */
unsigned player_src_sr(void);             /* source sample rate (Hz), 0 for PSG */
unsigned player_src_ch(void);             /* source channels */
unsigned player_bitrate_kbps(void);       /* stream bitrate for the player info line */
void player_pump(void);
void player_isr_tick(void);               /* Step 14.3b: audio consumer (1 ms timer ISR feeds the fabric FIFO) */
void player_audio_irq(int ok);            /* tell the player whether the ISR is live (else it polls inline) */
int  player_active(void);
void player_stop(void);
void player_pause_toggle(void);   /* Space: pause/resume transport */
int  player_paused(void);         /* 1 = paused */
void player_suspend(void);          /* launch-suspend: pause + release the mux to the machine (position kept) */
void player_resume_suspended(void); /* re-engage the mux + fade back in from the held position */
int  player_suspended(void);        /* 1 = launch-suspended */
int  player_take_ended(void);     /* consume-once: 1 if the track just reached EOF (auto-advance) */
unsigned player_elapsed_s(void);  /* seconds played so far */
unsigned player_total_s(void);    /* total track duration (pre-scanned, ZXTune method) */
unsigned player_progress(void);   /* 0..100 playback progress */
// loader_main.c - BulbuLator OSD app (Step 13): snapshot loader (.z80/.sna) + F5 SD file browser +
// options + the universal music player (player.c) with a non-blocking pause and an independent status banner.
// Vitis standalone app: the BSP gives xsdps + FatFs; the OSD/keyboard code is the same GP0 MMIO as
// osd.c. F12 = title overlay, F1 = help, F5 = SD browser, Up/Down scroll, Enter enters a folder
// (".." goes up), Esc closes.
//
// D-cache ON (Step 13 foundation). The cache used to be OFF to dodge an "invalidate-length" SD
// corruption - but the real cause was our OWN unaligned f_read/f_write buffers, not the driver:
// modern xsdps already does all ADMA2 cache maintenance (invalidate/flush + descriptor flush) when
// IsCacheCoherent==0, and Xilinx 32-byte-aligns FatFs's own win/buf. FatFs streams multi-sector I/O
// straight into the CALLER's buffer, so any unaligned caller buffer loses a few bytes on an
// invalidate. Fix = enable D-cache (A9 ~10x faster -> real-time audio synth works) + 32-byte-align
// every DMA buffer (snapbuf/cfgbuf/g_buf/o). Plus a 1 MB-aligned NON-CACHEABLE window at the top of
// DDR (NC_BASE) for future fabric-shared buffers (colour-OSD framebuffer, image preview, SW-emu) -
// same coherency class as SD DMA, solved once, machine-agnostic. See vault STEP_13_14_PLAN.md.

#define GP0        0x40000000u
#define OSD_CTRL   (*(volatile uint32_t*)(GP0+0x48))
#define OSD_ADDR   (*(volatile uint32_t*)(GP0+0x4C))
#define OSD_DATA   (*(volatile uint32_t*)(GP0+0x50))
#define BAN_CTRL   (*(volatile uint32_t*)(GP0+0x84))  /* bit0 = banner panel enable (independent of OSD) */
#define BAN_ADDR   (*(volatile uint32_t*)(GP0+0x88))  /* banner LUTRAM word ptr (auto-inc on DATA write) */
#define BAN_DATA   (*(volatile uint32_t*)(GP0+0x8C))  /* 32 packed 1bpp banner px -> ban_buf[ptr], ptr++ */
#define BAN_POS    (*(volatile uint32_t*)(GP0+0x90))  /* banner window {Y0[26:16],X0[10:0]} */
#define OSD_OP     (*(volatile uint32_t*)(GP0+0x6C))  /* OSD panel opacity alpha 0..255 */
#define OSD_POS    (*(volatile uint32_t*)(GP0+0x70))  /* OSD panel position {Y0[26:16],X0[10:0]} */
#define VOL_REG    (*(volatile uint32_t*)(GP0+0x74))  /* HDMI volume gain 0..255 (PCM * vol / 256) */
#define KBD_DATA   (*(volatile uint32_t*)(GP0+0x54))  /* [9]=release_flag(1=break) [8]=empty [7:0]=code; read pops */
#define KBD_STATUS (*(volatile uint32_t*)(GP0+0x58))  /* bit0 = FIFO empty */
#define KBD_HB     (*(volatile uint32_t*)(GP0+0x5C))  /* any write = deadman heartbeat */
#define KBD_TX     (*(volatile uint32_t*)(GP0+0xB0))  /* Step 15: W byte -> PS/2 host TX (LEDs/typematic/resend) */
#define KBD_TXSTAT (*(volatile uint32_t*)(GP0+0xB4))  /* Step 15: R bit0=busy, bit1=last device-ACK */
#define KBD_DIAG   (*(volatile uint32_t*)(GP0+0xB8))  /* Step 15: R {resend_cnt[31:16], parity_err_cnt[15:0]} */
#define MACHINE_CFG (*(volatile uint32_t*)(GP0+0xBC))  /* Step 15: W bit0 = Pentagon timing (CDC'd to the core) */
#define PENT_INT    (*(volatile uint32_t*)(GP0+0xC4))  /* Step 15: W {v[24:16], hc[8:0]} = Pentium INT position tuner */
#define PAPER_H     (*(volatile uint32_t*)(GP0+0xC8))  /* live paper h start (left border) */
#define PAPER_V     (*(volatile uint32_t*)(GP0+0xCC))  /* live paper v start (top border) */
#define SCR_POS     (*(volatile uint32_t*)(GP0+0xD0))  /* live whole-frame HDMI position: {vmargin[15:0], hmargin[15:0]} (fb_line_disp) */
#define MACHINE_ID (*(volatile uint32_t*)(GP0+0x60))  /* loaded-core identity ([15:0]=code) */
/* Step 14: DDR-backed TRUE-COLOUR OSD (ARGB8888 canvas read by osd_ddr_rd over HP1; OSD_CTRL bit1=EN) */
#define OSD_DDR_BASE (*(volatile uint32_t*)(GP0+0x94))  /* DDR byte address of the ARGB canvas */
#define DDR_OSD_POS  (*(volatile uint32_t*)(GP0+0x98))  /* DDR OSD canvas position {Y0[26:16],X0[10:0]} - independent of the 1bpp OSD_POS (0x70) */
/* Step 14.2 tape station (machine-agnostic PULSE loader) */
#define TAPE_CTRL   (*(volatile uint32_t*)(GP0+0x9C))  /* bit0 run, bit1 ear_mux, bit2 mute */
#define TAPE_FIFO   (*(volatile uint32_t*)(GP0+0xA0))  /* push {level[31], duration[23:0] in T-states} */
#define TAPE_STATUS (*(volatile uint32_t*)(GP0+0xA4))  /* bit0 = FIFO full, bit1 = playing */
#define AUDIO_CTRL  (*(volatile uint32_t*)(GP0+0x78))  /* bit0: 1=player mux->HDMI, 0=fabric/machine. Also owned by player.c; we drive it only while a tape loads (player is stopped then) */
#define TAPE_HZ 3546900u   /* ZX128 T-state rate -> tape time in seconds = T_states / TAPE_HZ */
#define VZ_X 24         /* visualiser field (spectrum); reused for the load % (no spectrum during a load) */
#define VZ_Y 43
#define VZ_W 76
#define VZ_H 16
#define OSDC_ADDR 0x0F800000u   /* in the non-cacheable DDR window (NC_BASE+1MB): ARM writes are coherent, no flush */
#define OSDC_W    640   /* Step 14.4: DOS 80x25 canvas (VGA 8x16 font) */
#define OSDC_H    400
#include "vga866.h"             /* Step 14.4: CP866 VGA 8x16 font (ASCII+box-drawing+Cyrillic), Terminus OFL */
/* Step 12.1 snapshot-inject control plane (same registers the Step-7 injector uses) */
#define IJ_CTRL   (*(volatile uint32_t*)(GP0+0x04))  /* bit0 = HALT */
#define IJ_STAT   (*(volatile uint32_t*)(GP0+0x08))  /* bit0 HALT_ACK, bit1 RAM_BUSY */
#define IJ_RAMA   (*(volatile uint32_t*)(GP0+0x10))  /* RAM byte address (auto-inc) */
#define IJ_RAMD   (*(volatile uint32_t*)(GP0+0x14))  /* RAM data byte */
#define IJ_7FFD   (*(volatile uint32_t*)(GP0+0x3C))  /* 128K paging port */
#define IJ_FE     (*(volatile uint32_t*)(GP0+0x40))  /* border */
#define IJ_COMMIT (*(volatile uint32_t*)(GP0+0x44))  /* bit0 PORT_COMMIT, bit1 DIR_COMMIT */
#define IJ_DIR0   0x20u                               /* 0x20..0x38 = DIR0..DIR6 (T80 vector) */
#define OSD_W     256
#define OSD_H     128
#define OSD_WPR   (OSD_W/32)          /* 8 words per row */
#define OSD_WORDS (OSD_WPR*OSD_H)     /* 1024 words (256x128/32) */
#define BAN_W     256
#define BAN_H     64
#define BAN_WPR   (BAN_W/32)          /* 8 words per row, same packing as OSD */
#define BAN_WORDS (BAN_WPR*BAN_H)     /* 512 words (256x64/32) */

/* Non-cacheable DDR window for fabric-shared / DMA buffers (future colour-OSD framebuffer, image
   preview, SW-emu shared framebuffer). 1 MB-aligned at the top of the 256 MB DDR; lscript.ld caps
   ps7_ddr_0 below NC_BASE so the linker never places anything here. Marked NORM_NONCACHE at boot so
   ARM writes are coherent with the PL with no per-frame flush (the MiSTer write-combining pattern). */
#define NC_BASE  0x0F700000u   /* start of the reserved non-cacheable window (1 MB-aligned)       */
#define NC_MB    9u            /* size in 1 MB sections: 0x0F700000..0x0FFFFFFF = top 9 MB of DDR */

/* PS/2 set-2 scancodes for the keys the ARM owns (none of these are in the ZX matrix) */
#define SC_F1   0x05u
#define SC_F5   0x03u
#define SC_F12  0x07u
#define SC_ESC  0x76u
#define SC_UP    0x75u   /* PS/2 set-2: cursor up (E0-prefix stripped by ARM) / numpad 8 */
#define SC_DOWN  0x72u   /* cursor down / numpad 2 */
#define SC_ENTER 0x5Au
#define SC_SPACE 0x29u   /* PS/2 set-2 Space: player pause/resume (while OSD open) */
#define SC_F2    0x06u   /* PS/2 set-2 F2: cycle the music play mode (FOLDER / REPEAT-1 / REPEAT-ALL) */
#define SC_F3    0x04u   /* PS/2 set-2 F3: cycle the browser sort mode (only while browsing) */
#define SC_F4    0x0Cu   /* Ctrl+F4 = sort by extension (DN sort hotkey) */
#define SC_F9    0x01u   /* PS/2 set-2 F9: open/close the options (settings) menu */
#define SC_LEFT  0x6Bu   /* cursor left  (E0 prefix stripped by ARM) / numpad 4 */
#define SC_RIGHT 0x74u   /* cursor right (E0 prefix stripped by ARM) / numpad 6 */
#define SC_PGUP  0x7Du   /* Page Up   (E0 7D, prefix stripped) / numpad 9 - page scroll in the browser */
#define SC_PGDN  0x7Au   /* Page Down (E0 7A, prefix stripped) / numpad 3 */
#define SC_BACKSPACE 0x66u /* PS/2 set-2 Backspace: stop the player */
#define SC_F10   0x09u   /* Step 13.1 Pause bring-up fallback (not in the ZX matrix) */
#define SC_F8    0x0Au   /* Step 14: toggle the DDR-RGB true-colour OSD window (OSD_CTRL bit1) */
#define SC_F6    0x0Bu   /* F6: rename / move */
#define SC_F7    0x83u   /* F7: make directory (mkdir) */
#define SC_INS   0x70u   /* Insert (E0 70, prefix stripped): tag/untag current entry (= Space) */
#define SC_F11   0x78u   /* hard reset (fabric-decoded); ARM taps it to mark the loaded app STOPPED */
#define SC_KPPLUS  0x79u /* numpad + : volume up   (conflict-free; ZX has no numpad) */
#define SC_KPMINUS 0x7Bu /* numpad - : volume down */
#define SC_KPMUL   0x7Cu /* numpad * : Shift = invert selection */
#define SC_HOME    0x6Cu /* Home (E0 6C, prefix stripped) */
#define SC_END     0x69u /* End (E0 69, prefix stripped) */

/* ZX Spectrum 8x8 system font, chars 32..127, extracted from rom128.hex @ 0x7D00 */
static const uint8_t zxfont[96][8] = {
  {0x00,0x00,0x00,0x00,0x00,0x00,0x00,0x00}, // ' '
  {0x00,0x10,0x10,0x10,0x10,0x00,0x10,0x00}, // '!'
  {0x00,0x24,0x24,0x00,0x00,0x00,0x00,0x00}, // '"'
  {0x00,0x24,0x7E,0x24,0x24,0x7E,0x24,0x00}, // '#'
  {0x00,0x08,0x3E,0x28,0x3E,0x0A,0x3E,0x08}, // '$'
  {0x00,0x62,0x64,0x08,0x10,0x26,0x46,0x00}, // '%'
  {0x00,0x10,0x28,0x10,0x2A,0x44,0x3A,0x00}, // '&'
  {0x00,0x08,0x10,0x00,0x00,0x00,0x00,0x00}, // '''
  {0x00,0x04,0x08,0x08,0x08,0x08,0x04,0x00}, // '('
  {0x00,0x20,0x10,0x10,0x10,0x10,0x20,0x00}, // ')'
  {0x00,0x00,0x14,0x08,0x3E,0x08,0x14,0x00}, // '*'
  {0x00,0x00,0x08,0x08,0x3E,0x08,0x08,0x00}, // '+'
  {0x00,0x00,0x00,0x00,0x00,0x08,0x08,0x10}, // ','
  {0x00,0x00,0x00,0x00,0x3E,0x00,0x00,0x00}, // '-'
  {0x00,0x00,0x00,0x00,0x00,0x18,0x18,0x00}, // '.'
  {0x00,0x00,0x02,0x04,0x08,0x10,0x20,0x00}, // '/'
  {0x00,0x3C,0x46,0x4A,0x52,0x62,0x3C,0x00}, // '0'
  {0x00,0x18,0x28,0x08,0x08,0x08,0x3E,0x00}, // '1'
  {0x00,0x3C,0x42,0x02,0x3C,0x40,0x7E,0x00}, // '2'
  {0x00,0x3C,0x42,0x0C,0x02,0x42,0x3C,0x00}, // '3'
  {0x00,0x08,0x18,0x28,0x48,0x7E,0x08,0x00}, // '4'
  {0x00,0x7E,0x40,0x7C,0x02,0x42,0x3C,0x00}, // '5'
  {0x00,0x3C,0x40,0x7C,0x42,0x42,0x3C,0x00}, // '6'
  {0x00,0x7E,0x02,0x04,0x08,0x10,0x10,0x00}, // '7'
  {0x00,0x3C,0x42,0x3C,0x42,0x42,0x3C,0x00}, // '8'
  {0x00,0x3C,0x42,0x42,0x3E,0x02,0x3C,0x00}, // '9'
  {0x00,0x00,0x00,0x10,0x00,0x00,0x10,0x00}, // ':'
  {0x00,0x00,0x10,0x00,0x00,0x10,0x10,0x20}, // ';'
  {0x00,0x00,0x04,0x08,0x10,0x08,0x04,0x00}, // '<'
  {0x00,0x00,0x00,0x3E,0x00,0x3E,0x00,0x00}, // '='
  {0x00,0x00,0x10,0x08,0x04,0x08,0x10,0x00}, // '>'
  {0x00,0x3C,0x42,0x04,0x08,0x00,0x08,0x00}, // '?'
  {0x00,0x3C,0x4A,0x56,0x5E,0x40,0x3C,0x00}, // '@'
  {0x00,0x3C,0x42,0x42,0x7E,0x42,0x42,0x00}, // 'A'
  {0x00,0x7C,0x42,0x7C,0x42,0x42,0x7C,0x00}, // 'B'
  {0x00,0x3C,0x42,0x40,0x40,0x42,0x3C,0x00}, // 'C'
  {0x00,0x78,0x44,0x42,0x42,0x44,0x78,0x00}, // 'D'
  {0x00,0x7E,0x40,0x7C,0x40,0x40,0x7E,0x00}, // 'E'
  {0x00,0x7E,0x40,0x7C,0x40,0x40,0x40,0x00}, // 'F'
  {0x00,0x3C,0x42,0x40,0x4E,0x42,0x3C,0x00}, // 'G'
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
};

static uint32_t osdbuf[OSD_WORDS];
static uint32_t* g_buf    = osdbuf;     /* setpix/draw_* target (OSD panel by default; banner switches it) */
static int       g_bufwpr = OSD_WPR;
static int       g_bufh   = OSD_H;

static int g_inv = 0;   /* 1 = clear pixels instead of set (inverse text on a solid bar) */
static void setpix(int x,int y){
    if(x<0||x>=g_bufwpr*32||y<0||y>=g_bufh) return;
    if(g_inv) g_buf[y*g_bufwpr + (x>>5)] &= ~(1u << (x & 31));
    else      g_buf[y*g_bufwpr + (x>>5)] |=  (1u << (x & 31));
}
static void draw_char(int x,int y,int scale,char c){
    if(c<32 || (unsigned char)c>127) return;
    const uint8_t* g = zxfont[(int)c - 32];
    for(int gy=0; gy<8; gy++)
        for(int gx=0; gx<8; gx++)
            if(g[gy] & (0x80u>>gx))
                for(int dy=0; dy<scale; dy++)
                    for(int dx=0; dx<scale; dx++)
                        setpix(x+gx*scale+dx, y+gy*scale+dy);
}
static void draw_text(int x,int y,int scale,const char* s){
    for(; *s; s++){ draw_char(x,y,scale,*s); x += 8*scale; }
}
static void draw_text_scrolled(int x, int y, int scale, const char* s, int scroll_chars) {
    for(int i = 0; i < scroll_chars && *s; i++) s++;
    draw_text(x, y, scale, s);
}
static int slen(const char* s){ int n=0; while(s[n]) n++; return n; }
static const uint8_t folder_glyph[8] = {0x00,0x70,0xFE,0x82,0x82,0x82,0xFE,0x00};  /* 8x8 folder icon */
static const uint8_t lbr_glyph[8]    = {0x00,0xE0,0x80,0x80,0x80,0x80,0xE0,0x00};  /* '[' flush to cell left edge */
/* ---- player title-bar icons (8x8) ---- */
static const uint8_t play_glyph[8]   = {0x00,0x40,0x60,0x70,0x70,0x60,0x40,0x00};  /* > playing */
static const uint8_t pause_glyph[8]  = {0x00,0x66,0x66,0x66,0x66,0x66,0x66,0x00};  /* || paused */
static const uint8_t stop_glyph[8]   = {0x00,0x00,0x7E,0x7E,0x7E,0x7E,0x00,0x00};  /* [] stopped (after F11 reset) */
static const uint8_t pend_glyph[8]   = {0x00,0x42,0x62,0x72,0x72,0x62,0x42,0x00};  /* >| FOLDER (play through, stop) */
static const uint8_t loop_glyph[8]   = {0x3C,0x42,0x81,0x81,0x81,0x42,0x3C,0x00};  /* O REPEAT (all / +'1' for one) */
static void draw_glyph(int x,int y,const uint8_t g[8]){
    for(int gy=0;gy<8;gy++) for(int gx=0;gx<8;gx++) if(g[gy]&(0x80u>>gx)) setpix(x+gx,y+gy);
}

/* ============ Step 14: DDR TRUE-COLOUR OSD canvas (ARGB8888) draw layer ============
   Flat CW*CH uint32_t ARGB array in the non-cacheable DDR window; osd_ddr_rd reads it over HP1
   (2 px / 64-bit word) and the fabric alpha-composites it over video. Alpha byte 0 => transparent
   (video shows through). Reuses the ZX 8x8 font for text. Full per-pixel FFFFFF colour. */
static volatile uint32_t* const g_osdc = (volatile uint32_t*)OSDC_ADDR;
#define ARGB(a,r,g,b) (((uint32_t)(a)<<24)|((uint32_t)(r)<<16)|((uint32_t)(g)<<8)|(uint32_t)(b))
static void osdc_clear(uint32_t c){ for(int i=0;i<OSDC_W*OSDC_H;i++) g_osdc[i]=c; }
static void osdc_rect(int x,int y,int w,int h,uint32_t c){
    for(int r=y;r<y+h;r++){ if(r<0||r>=OSDC_H) continue;
        for(int q=x;q<x+w;q++){ if(q<0||q>=OSDC_W) continue; g_osdc[r*OSDC_W+q]=c; } }
}
static void osdc_frame(int x,int y,int w,int h,int t,uint32_t c){
    osdc_rect(x,y,w,t,c); osdc_rect(x,y+h-t,w,t,c); osdc_rect(x,y,t,h,c); osdc_rect(x+w-t,y,t,h,c);
}
static void osdc_char(int x,int y,int sc,uint32_t fg,uint32_t bg,char ch){
    if(ch<32||(unsigned char)ch>127) return;
    const uint8_t* g=zxfont[(int)ch-32];
    for(int gy=0;gy<8;gy++) for(int gx=0;gx<8;gx++){
        uint32_t px=(g[gy]&(0x80u>>gx))?fg:bg;
        if((px>>24)==0) continue;                       /* transparent pixel -> leave canvas as-is */
        for(int dy=0;dy<sc;dy++) for(int dx=0;dx<sc;dx++){
            int qx=x+gx*sc+dx, qy=y+gy*sc+dy;
            if(qx>=0&&qx<OSDC_W&&qy>=0&&qy<OSDC_H) g_osdc[qy*OSDC_W+qx]=px;
        }
    }
}
static void osdc_text(int x,int y,int sc,uint32_t fg,uint32_t bg,const char* s){
    for(;*s;s++){ osdc_char(x,y,sc,fg,bg,*s); x+=8*sc; }
}
static void osdc_textn(int x,int y,int sc,uint32_t fg,uint32_t bg,const char* s,int maxc){  /* clipped to maxc chars */
    for(int i=0;*s&&i<maxc;s++,i++){ osdc_char(x,y,sc,fg,bg,*s); x+=8*sc; }
}
static void osdc_glyph(int x,int y,const uint8_t g[8],uint32_t c){   /* 8x8 mono glyph in colour c (transparent bg) */
    for(int gy=0;gy<8;gy++) for(int gx=0;gx<8;gx++) if(g[gy]&(0x80u>>gx)){
        int qx=x+gx,qy=y+gy; if(qx>=0&&qx<OSDC_W&&qy>=0&&qy<OSDC_H) g_osdc[qy*OSDC_W+qx]=c; }
}
static void osdc_text_scrolled(int x,int y,int sc,uint32_t fg,uint32_t bg,const char* s,int scroll,int maxc){
    for(int i=0;i<scroll && *s;i++) s++;        /* marquee: skip `scroll` chars, then show maxc */
    osdc_textn(x,y,sc,fg,bg,s,maxc);
}
/* Blit an ARGB8888 sprite into the canvas (opaque copy; alpha-key overlay comes with the sprite pack). */
static void osdc_blit(int dx,int dy,int sw,int sh,const uint32_t* src){
    for(int y=0;y<sh;y++){ int qy=dy+y; if(qy<0||qy>=OSDC_H) continue;
        for(int x=0;x<sw;x++){ int qx=dx+x; if(qx<0||qx>=OSDC_W) continue;
            g_osdc[qy*OSDC_W+qx]=src[y*sw+x]; } }
}
/* ============ Step 14.4: DOS Navigator-style OSD (640x400 = 80x25 @ VGA 8x16) ============
   Authentic CP437/CP866 pseudographics + Cyrillic via the Terminus VGA 8x16 font (vga866.h).
   Cells are 8x16, canvas 80x25. Panel backgrounds ~90% opaque (video faintly shows), text opaque.
   Colours ARGB8888. Filenames arrive as CP866 bytes (FatFs FF_CODE_PAGE=866) -> direct glyph index. */
#define DN_COLS 80
#define DN_ROWS 25
/* Canonical DOS 16-colour palette (indices 0-15), opaque ARGB. */
static const uint32_t DOS[16] = {
  0xFF000000u,0xFF0000AAu,0xFF00AA00u,0xFF00AAAAu,0xFFAA0000u,0xFFAA00AAu,0xFFAA5500u,0xFFAAAAAAu,
  0xFF555555u,0xFF5555FFu,0xFF55FF55u,0xFF55FFFFu,0xFFFF5555u,0xFFFF55FFu,0xFFFFFF55u,0xFFFFFFFFu };
static uint32_t g_dn_alpha = 0xCCu;   /* OSD background opacity (0x00..0xFF; adjustable via F9); text stays opaque */
#define FG(i) (DOS[(i)])                                      /* text/lines: 100% opaque */
#define BG(i) ((g_dn_alpha<<24)|(DOS[(i)]&0x00FFFFFFu))       /* background: adjustable alpha (DOS rule: bg = dark 0-7) */
#define DN_SHADOW 0x80000000u                                 /* window drop-shadow: black ~50% */
/* DN element colours = authentic DOS Navigator 1.51 default scheme (dark-gray-on-black, blink OFF,
   traced from the sources): dkgray panels, ltgray files, white dirs, black-on-cyan cursor, yellow
   headers, ltgray chrome + red hotkeys. bg carries the adjustable alpha (g_dn_alpha); text/lines
   opaque. This is ONE skin - retheme here (the ARGB engine takes any colours). */
#define DNK_PANEL_BG BG(8)     /* dark-gray file panel */
#define DNK_FRAME    FG(15)    /* white double frame (active window) */
#define DNK_SEP      FG(15)    /* white column separators / divider */
#define DNK_HEADER   FG(14)    /* yellow column headers */
#define DNK_DIR      FG(15)    /* white directories */
#define DNK_FILE     FG(7)     /* light-gray plain files */
#define DNK_SNAP     FG(11)    /* light-cyan ZX snapshots .z80/.sna (runnable, like DN exe) */
#define DNK_TAPE     FG(10)    /* light-green tape .tap/.tzx (loadable, like DN archive) */
#define DNK_MUSIC    FG(13)    /* light-magenta music .psg/.mp3/.wav */
#define DNK_CUR_BG   BG(3)     /* cyan cursor bar */
#define DNK_CUR_FG   FG(0)     /* black text on the cursor bar */
#define DNK_MENU_BG  BG(7)     /* light-gray top menu + status bar */
#define DNK_MENU_FG  FG(0)     /* black chrome text */
#define DNK_HOTKEY   FG(4)     /* red hot-key letter / F-number */
#define DNK_STATUS   FG(11)    /* accent: button pointers, progress, markers */
/* Modal dialogs are OPAQUE (DN text-mode windows never show the screen through them). FG(i)==DOS[i]
   is already 0xFF-alpha, so using FG() as a background forces full opacity - unlike BG(), which bakes
   in the adjustable OSD alpha (that translucency is only for the always-on browser panel). */
#define DNK_DLG_BG   FG(7)     /* opaque light-gray dialog body (DN gray dialog) */
#define DNK_DLG_FG   FG(0)     /* black body text */
#define DNK_DLG_FRAME FG(15)   /* white active-window frame (DN 0x7F) */
#define DNK_BTN_FACE FG(2)     /* green button face (DN 0x2x) */
#define DNK_BTN_TXT  FG(0)     /* black button label */
#define DNK_BTN_DEF  FG(11)    /* cyan: default/focused button label + ►◄ pointers (DN 0x2B) */
#define DNK_BTN_SHAD FG(8)     /* dark-gray button drop-shadow half-blocks */
#define DNK_FLD_BG   FG(0)     /* opaque BLACK input field (DN input line) */
#define DNK_FLD_FG   FG(15)    /* white field text */
enum { BX_H=0xCD,BX_V=0xBA,BX_TL=0xC9,BX_TR=0xBB,BX_BL=0xC8,BX_BR=0xBC,BX_LT=0xCC,BX_RT=0xB9,BX_TT=0xCB,BX_BT=0xCA,
       SL_H=0xC4,SL_V=0xB3,SL_TL=0xDA,SL_TR=0xBF,SL_BL=0xC0,SL_BR=0xD9, SH_L=0xB0,SH_M=0xB1,SH_D=0xB2,BLK_=0xDB };
static void dn_putc(int cx,int cy,unsigned code,uint32_t fg,uint32_t bg){
    if(cx<0||cy<0||cx>=DN_COLS||cy>=DN_ROWS) return;
    const unsigned char* g=vga866[code&0xFFu];
    for(int r=0;r<16;r++){ unsigned char bits=g[r]; int qy=cy*16+r;
        for(int c=0;c<8;c++) g_osdc[qy*OSDC_W + cx*8+c] = (bits&(0x80u>>c))?fg:bg; }
}
static void dn_puts(int cx,int cy,const char* s,uint32_t fg,uint32_t bg){
    for(; *s && cx<DN_COLS; s++,cx++) dn_putc(cx,cy,(unsigned char)*s,fg,bg); }
static void dn_putsn(int cx,int cy,const char* s,int maxc,uint32_t fg,uint32_t bg){
    for(int i=0;*s&&i<maxc&&cx<DN_COLS;s++,i++,cx++) dn_putc(cx,cy,(unsigned char)*s,fg,bg); }
static void dn_fill(int cx,int cy,int cw,int chh,uint32_t bg){
    for(int y=0;y<chh;y++) for(int x=0;x<cw;x++) dn_putc(cx+x,cy+y,' ',bg,bg); }
static void dn_hpx(int x0,int x1,int y,uint32_t c){ if(y<0||y>=OSDC_H)return; for(int x=x0;x<=x1;x++) if(x>=0&&x<OSDC_W) g_osdc[y*OSDC_W+x]=c; }
static void dn_vpx(int x,int y0,int y1,uint32_t c){ if(x<0||x>=OSDC_W)return; for(int y=y0;y<=y1;y++) if(y>=0&&y<OSDC_H) g_osdc[y*OSDC_W+x]=c; }
/* Frame as cell-aligned pixel lines. Double = two lines with a gap -> an unmistakably-double DOS frame
   (Terminus's ═/║ glyphs are 2px-adjacent and read as a single thick line at OSD scale). */
static void dn_box(int cx,int cy,int cw,int chh,uint32_t fg,uint32_t bg,int dbl){
    for(int x=0;x<cw;x++){ dn_putc(cx+x,cy,' ',bg,bg); dn_putc(cx+x,cy+chh-1,' ',bg,bg); }
    for(int y=0;y<chh;y++){ dn_putc(cx,cy+y,' ',bg,bg); dn_putc(cx+cw-1,cy+y,' ',bg,bg); }
    int ox0=cx*8+2, oy0=cy*16+5, ox1=(cx+cw)*8-3, oy1=(cy+chh)*16-6;   /* outer line */
    dn_hpx(ox0,ox1,oy0,fg); dn_hpx(ox0,ox1,oy1,fg); dn_vpx(ox0,oy0,oy1,fg); dn_vpx(ox1,oy0,oy1,fg);
    if(dbl){ int ix0=ox0+3,iy0=oy0+3,ix1=ox1-3,iy1=oy1-3;               /* inner line -> double */
        dn_hpx(ix0,ix1,iy0,fg); dn_hpx(ix0,ix1,iy1,fg); dn_vpx(ix0,iy0,iy1,fg); dn_vpx(ix1,iy0,iy1,fg); } }
static void dn_bar(int cx,int cy,int w,int frac_pm,uint32_t fg,uint32_t bg){   /* frac_pm 0..1000 */
    int f=w*frac_pm/1000; if(f>w)f=w; if(f<0)f=0;
    for(int i=0;i<w;i++) dn_putc(cx+i,cy, i<f?BLK_:SH_L, fg,bg); }
static void dn_dim_cell(int cx,int cy){                /* darken one 8x16 cell in place: TRANSLUCENT shadow - content shows through, halved brightness */
    if(cx<0||cy<0||cx>=DN_COLS||cy>=DN_ROWS) return;
    for(int r=0;r<16;r++){ int qy=cy*16+r; for(int c=0;c<8;c++){ int qx=cx*8+c;
        uint32_t p=g_osdc[qy*OSDC_W+qx]; g_osdc[qy*OSDC_W+qx]=(p&0xFF000000u)|((p>>1)&0x007F7F7Fu); } } }
static void dn_shadow(int cx,int cy,int cw,int chh){   /* DN translucent drop shadow: dims the backdrop 2 cells right + 1 down */
    for(int y=1;y<=chh;y++){ dn_dim_cell(cx+cw,cy+y); dn_dim_cell(cx+cw+1,cy+y); }
    for(int x=2;x<cw;x++) dn_dim_cell(cx+x,cy+chh); }
/* Turbo-Vision dialog button: [Label] with a 1-cell drop shadow (raised look); the default button is
   flanked by cyan pointers (>[OK]<), as in DN's Image 5. Returns the button width in cells. */
/* Solid triangle pointers for the default/focused button (font 0x10/0x11 render as thin arrows, so
   we draw real filled triangles - the same shape as the play marker). Apex points at the label. */
static const uint8_t GLYPH_TRI_R[16] = {0,0,0x80,0xC0,0xE0,0xF0,0xF8,0xFC,0xFC,0xF8,0xF0,0xE0,0xC0,0x80,0,0};
static const uint8_t GLYPH_TRI_L[16] = {0,0,0x01,0x03,0x07,0x0F,0x1F,0x3F,0x3F,0x1F,0x0F,0x07,0x03,0x01,0,0};
static void dn_put_glyph(int cx,int cy,const uint8_t* g,uint32_t fg,uint32_t bg);   /* fwd (defined with the DN row helpers) */
/* DOS Navigator button: GREEN face, black label; the default/focused button gets a cyan label
   flanked by ◣◢ solid-triangle pointers. A dark-gray drop shadow (▄ right edge, ▀ below) gives the
   raised look. `def` = draw as default/focused. Fully opaque (green face never shows the game). */
static int dn_button(int cx,int cy,const char* lab,int def,int minface){
    int len  = slen((char*)lab);
    int face = len + 4;                                    /* 2-cell pad each side (holds the ►◄ slots) */
    if (face < minface) face = minface;                    /* uniform minimum -> all buttons the same width */
    /* width is INDEPENDENT of `def`: the pointer slots are always reserved, so focus never shifts layout */

    uint32_t bg  = DNK_BTN_FACE;                           /* opaque green face */
    uint32_t txt = def ? DNK_BTN_DEF : DNK_BTN_TXT;        /* default/focused => cyan label, else black */

    for (int i = 0; i < face; i++) dn_putc(cx + i, cy, ' ', txt, bg);   /* green face */

    int lx = cx + (face - len) / 2;
    dn_puts(lx, cy, lab, txt, bg);                         /* label centred */
    if (def) {                                             /* markers at the button EDGES (fixed cols, independent of label width) */
        dn_put_glyph(cx,            cy, GLYPH_TRI_R, DNK_BTN_DEF, bg);   /* ► on the first cell */
        dn_put_glyph(cx + face - 1, cy, GLYPH_TRI_L, DNK_BTN_DEF, bg);   /* ◄ on the last cell */
    }

    dn_putc(cx + face, cy, 0xDC, DNK_BTN_SHAD, DNK_DLG_BG);         /* ▄ right shadow edge */
    for (int i = 1; i <= face; i++) dn_putc(cx + i, cy + 1, 0xDF, DNK_BTN_SHAD, DNK_DLG_BG);   /* ▀ shadow below */
    return face + 1;                                       /* total cells incl. the shadow column */
}
/* TCluster-style widgets: radio "( )/(•)" and checkbox "[ ]/[X]". foc = highlighted (cursor), dis = greyed. */
static void dn_radio(int cx,int cy,const char* lab,int sel,int foc,int dis){
    uint32_t fg=dis?FG(8):(foc?DNK_CUR_FG:DNK_DLG_FG), bg=foc?FG(3):DNK_DLG_BG;   /* modal cursor = opaque cyan (FG3, not translucent BG3) */
    dn_putc(cx,cy,'(',fg,bg); dn_putc(cx+1,cy, sel?'*':' ', fg, bg); dn_putc(cx+2,cy,')',fg,bg); dn_putc(cx+3,cy,' ',fg,bg);
    dn_puts(cx+4,cy,lab,fg,bg);
}
static void dn_check(int cx,int cy,const char* lab,int on,int foc,int dis){
    uint32_t fg=dis?FG(8):(foc?DNK_CUR_FG:DNK_DLG_FG), bg=foc?FG(3):DNK_DLG_BG;   /* modal cursor = opaque cyan (FG3, not translucent BG3) */
    dn_putc(cx,cy,'[',fg,bg); dn_putc(cx+1,cy, on?'X':' ', fg, bg); dn_putc(cx+2,cy,']',fg,bg); dn_putc(cx+3,cy,' ',fg,bg);
    dn_puts(cx+4,cy,lab,fg,bg);
}
/* one-shot self-test screen: proves the 640x400 canvas + CP866 font (ASCII/Cyrillic/box/shades). */
/* Palette check: all 16 DOS colours as labelled swatches (opaque + ~80% over video) to catch a wrong
   colour / R-B swap / alpha wash. Owner reads the row whose bar doesn't match its NAME. */
static void dn_palette_test(void){
    static const char* const nm[16]={"Black","Blue","Green","Cyan","Red","Magenta","Brown","LightGray",
        "DarkGray","BrightBlue","BrightGreen","BrightCyan","BrightRed","BrightMagenta","Yellow","White"};
    static const char* const hx[16]={"000000","0000AA","00AA00","00AAAA","AA0000","AA00AA","AA5500","AAAAAA",
        "555555","5555FF","55FF55","55FFFF","FF5555","FF55FF","FFFF55","FFFFFF"};
    dn_fill(0,0,DN_COLS,DN_ROWS,FG(8));                            /* opaque mid-grey so black & white swatches show */
    dn_box(0,0,DN_COLS,DN_ROWS,FG(15),FG(8),1);
    dn_puts(3,0," DOS 16-COLOUR PALETTE CHECK ",FG(15),FG(8));
    dn_puts(30,1,"opaque",FG(15),FG(8)); dn_puts(44,1,"~80% over video",FG(15),FG(8));
    for(int i=0;i<16;i++){
        int y=2+i; char lab[48]; int p=0;
        if(i<10){lab[p++]=(char)('0'+i);} else {lab[p++]='1';lab[p++]=(char)('0'+(i-10));}
        lab[p++]=' '; for(const char* n=nm[i]; *n; n++) lab[p++]=*n;
        while(p<18) lab[p++]=' '; lab[p++]='#'; for(const char* h=hx[i]; *h; h++) lab[p++]=*h; lab[p]=0;
        dn_puts(2,y,lab,FG(15),FG(8));
        dn_fill(30,y,12,1,FG(i));                                 /* opaque: pure colour */
        dn_fill(44,y,12,1,BG(i));                                 /* ~80% alpha over the video */
    }
    dn_puts(2,19,"Compare each bar to its NAME - tell me any row whose colour is WRONG.",FG(14),FG(8));
}
/* DN mockup rendered with the flexible true-colour DNK_* theme (exact HEX from the owner's Image 3):
   gray panels, silver files, white dirs, yellow headers, teal cursor bar, bright-cyan status. */
static void dn_test(void){
    dn_fill(0,0,DN_COLS,1,DNK_MENU_BG);                                  /* top menu bar */
    dn_putc(1,0,'F',DNK_HOTKEY,DNK_MENU_BG); dn_puts(2,0,"ile",DNK_MENU_FG,DNK_MENU_BG);
    dn_putc(8,0,'C',DNK_HOTKEY,DNK_MENU_BG); dn_puts(9,0,"ommands",DNK_MENU_FG,DNK_MENU_BG);
    dn_putc(18,0,'O',DNK_HOTKEY,DNK_MENU_BG); dn_puts(19,0,"ptions",DNK_MENU_FG,DNK_MENU_BG);
    dn_putc(27,0,'H',DNK_HOTKEY,DNK_MENU_BG); dn_puts(28,0,"elp",DNK_MENU_FG,DNK_MENU_BG);
    dn_fill(0,1,DN_COLS,DN_ROWS-2,DNK_PANEL_BG);                         /* file panel */
    dn_box(0,1,DN_COLS,DN_ROWS-2,DNK_FRAME,DNK_PANEL_BG,1);
    dn_puts(3,1," 0:/loadtest/TurboLoad ",DNK_DIR,DNK_PANEL_BG);
    dn_puts(2,2,"Name",DNK_HEADER,DNK_PANEL_BG); dn_puts(42,2,"Ext",DNK_HEADER,DNK_PANEL_BG); dn_puts(50,2,"Size",DNK_HEADER,DNK_PANEL_BG); dn_puts(64,2,"Date",DNK_HEADER,DNK_PANEL_BG);
    dn_puts(2,4,"..",DNK_DIR,DNK_PANEL_BG);
    dn_puts(2,5,"speedLoad",DNK_DIR,DNK_PANEL_BG);
    dn_fill(1,6,DN_COLS-2,1,DNK_CUR_BG);                                 /* cursor bar */
    dn_puts(2,6,"AlterEgo",DNK_CUR_FG,DNK_CUR_BG); dn_puts(42,6,"wav",DNK_CUR_FG,DNK_CUR_BG); dn_puts(50,6,"128.4K",DNK_CUR_FG,DNK_CUR_BG); dn_puts(64,6,"03.07.26",DNK_CUR_FG,DNK_CUR_BG);
    dn_puts(2,7,"ManicMiner",DNK_FILE,DNK_PANEL_BG); dn_puts(42,7,"tap",DNK_FILE,DNK_PANEL_BG); dn_puts(50,7,"44.0K",DNK_FILE,DNK_PANEL_BG); dn_puts(64,7,"15.05.85",DNK_FILE,DNK_PANEL_BG);
    dn_puts(2,8,"aliens",DNK_FILE,DNK_PANEL_BG); dn_puts(42,8,"mp3",DNK_FILE,DNK_PANEL_BG); dn_puts(50,8,"2.1M",DNK_FILE,DNK_PANEL_BG); dn_puts(64,8,"03.07.26",DNK_FILE,DNK_PANEL_BG);
    { char ru[40]; int p=0; for(unsigned c=0x80;c<0xA0;c++) ru[p++]=(char)c; ru[p]=0; dn_puts(2,10,"Cyr:",DNK_HEADER,DNK_PANEL_BG); dn_puts(7,10,ru,DNK_FILE,DNK_PANEL_BG); }
    { char bx[40]; int p=0; for(unsigned c=0xB0;c<0xD0;c++) bx[p++]=(char)c; bx[p]=0; dn_puts(2,11,"Box:",DNK_HEADER,DNK_PANEL_BG); dn_puts(7,11,bx,DNK_FILE,DNK_PANEL_BG); }
    dn_puts(2,13,"Progress:",DNK_FILE,DNK_PANEL_BG); dn_bar(12,13,40,600,DNK_STATUS,DNK_PANEL_BG); dn_puts(54,13,"60%",DNK_DIR,DNK_PANEL_BG);
    dn_puts(2,DN_ROWS-3,"14 files, 1 dir",DNK_STATUS,DNK_PANEL_BG);
    dn_fill(48,14,27,8,DNK_DLG_BG); dn_box(48,14,27,8,DNK_DLG_FG,DNK_DLG_BG,0); dn_shadow(48,14,27,8);   /* dialog */
    dn_puts(55,14," Settings ",DNK_DLG_FG,DNK_DLG_BG);                    /* title centred in the border */
    dn_puts(50,16,"[X] ULA snow",DNK_DLG_FG,DNK_DLG_BG);
    dn_puts(50,17,"(o) 720p50  ( ) 720p60",DNK_DLG_FG,DNK_DLG_BG);
    dn_button(51,19,"OK",1,8); dn_button(61,19,"Cancel",0,8);            /* TV buttons: default = cyan triangle pointers + shadow */
    dn_fill(0,DN_ROWS-1,DN_COLS,1,DNK_PANEL_BG);                         /* key bar on the panel bg */
    { int x=1; const char* it[6][2]={{"1","Help"},{"3","Sort"},{"4","Info"},{"5","Load"},{"9","Opts"},{"12","Quit"}};
      for(int i=0;i<6;i++){ dn_puts(x,DN_ROWS-1,it[i][0],DNK_DIR,DNK_PANEL_BG); x+=slen((char*)it[i][0]);
                            dn_puts(x,DN_ROWS-1,it[i][1],DNK_STATUS,DNK_PANEL_BG); x+=slen((char*)it[i][1])+2; } }
}
static void osd_clear(void){ for(int i=0;i<OSD_WORDS;i++) osdbuf[i]=0; }
static void osd_blit(void){ OSD_ADDR=0; for(int i=0;i<OSD_WORDS;i++) OSD_DATA=osdbuf[i]; }
static void draw_text_c(int y,int scale,const char* s){     /* horizontally centred line */
    int x0 = (OSD_W - slen(s)*8*scale)/2; if(x0<0) x0=0;
    draw_text(x0,y,scale,s);
}
/* Solid inverse title bar across the top row (y 0..7), shared by every menu/header. Callers draw
   their title text in g_inv mode so it reads as the bg colour on the highlighted bar. New menus get
   a consistent title with zero per-menu drawing code. */
static void titlebar(void){ for(int y=0;y<8;y++) for(int w=0;w<OSD_WPR;w++) osdbuf[y*OSD_WPR+w]=0xFFFFFFFFu; }
static void draw_title(const char* s){   titlebar(); g_inv=1; draw_text(2,0,1,s); g_inv=0; }
static void draw_title_c(const char* s){ titlebar(); int x0=(OSD_W-slen(s)*8)/2; if(x0<0)x0=0; g_inv=1; draw_text(x0,0,1,s); g_inv=0; }
static int browser_on;   /* tentative decl (defined with the other view flags below); needed by the early status helpers */
static void dn_status_msg(const char* s){   /* centred transient on the DN status row (22); the next status tick / list redraw repaints */
    if(!s) return;
    dn_fill(1,22,DN_COLS-2,1,DNK_PANEL_BG);
    int l=slen(s), x=(DN_COLS-l)/2; if(x<1) x=1;
    dn_puts(x,22,s,DNK_HEADER,DNK_PANEL_BG);
}
static void browser_status(const char* s){   /* transient feedback (MOUNT/READ/F2 mode): DN status row when the browser is up, else legacy 1bpp title bar */
    if(browser_on){ dn_status_msg(s); return; }
    titlebar(); g_inv=1; draw_text(OSD_W - slen(s)*8, 0, 1, s); g_inv=0; osd_blit();
}

/* Title screen (shown when the OSD opens with F12): just the name, centred, scale 2. */
/* Firmware build tag shown on the F12 splash (bump per milestone). The PL core VERSION
   (0x4000_0000) is shown live too, so the splash states exactly which firmware + bitstream run. */
#define BULB_FW "v0.15.19"
static char hexnib(uint32_t v){ return (v<10) ? ('0'+v) : ('A'+v-10); }
/* Single source of truth for the version line ("v0.13 core 0xB01B0013"): the ARM firmware tag
   BULB_FW + the live PL core VERSION read from register 0x00. Used by BOTH the F12 splash
   (show_header) and the F1 help page (show_help), so the two can never drift apart. */
static void version_str(char* out){                   /* firmware version vX.Y.Z only - the core ID never changes build-to-build, so it's dropped */
    int p=0; const char* fw = BULB_FW;
    while(*fw) out[p++]=*fw++;
    out[p]=0;
}
static void show_header(void){
    osd_clear();
    draw_text_c(14, 2, "ZX BulbuLator");
    char v[40]; version_str(v);
    draw_text_c(46, 1, v);
    osd_blit();
}
/* F1 help page: inverse title bar + grouped key map (GLOBAL / FILE BROWSER / ZX KEYS). */
static void show_help(void){
    osd_clear();
    char v[40]; version_str(v);                              /* "v0.13 core 0xB01B0013" */
    titlebar(); g_inv=1;                                     /* inverse title bar: HELP (left) + version/build (right), like the other OSD views */
    draw_text(2, 0, 1, "HELP");
    draw_text(OSD_W - slen(v)*8, 0, 1, v);
    g_inv=0;
    draw_text(2, 10, 1, "# GLOBAL: F5 BROWSER F9 OPTS");
    draw_text(2, 18, 1, "  F1 HELP  F12/ESC CLOSE");
    draw_text(2, 30, 1, "# MUSIC (in browser):");
    draw_text(2, 38, 1, "  ENTER/SPACE = PLAY/PAUSE");
    draw_text(2, 46, 1, "  ESC STOP   UP/DN PREV/NEXT");
    draw_text(2, 54, 1, "  F2 PLAY MODE   F3 SORT");
    draw_text(2, 66, 1, "# ZX KEYS:");
    draw_text(2, 74, 1, "  SHIFT CAPS   CTRL SYMBOL");
    draw_text(2, 82, 1, "  ALT  CS+SS (EXTEND)");
    draw_text(2, 90, 1, "  CTRL+ALT+DEL - SOFT RESET");
    draw_text(2, 98, 1, "  CTRL+ALT+INS - NMI");
    draw_text(2,106, 1, "  F11 - HARD RESET (WIPE RAM)");
    osd_blit();
}

static int osd_on = 0, browser_on = 0, opt_on = 0;
static int osd_view = 0;   /* single view state: 0=none 1=header 2=help 3=browser 4=options */
static int kb_alt   = 0;   /* Alt held (for Alt+F3) - mirror of g_kd[0x11] */
static int g_kb_shift = 0; /* Shift held (upper-case + symbols for text entry) - mirror of g_kd[0x12|0x59] */
static void open_osd(void){ show_header(); OSD_CTRL = (OSD_CTRL | 1u) & ~2u; osd_on = 1; browser_on = 0; opt_on = 0; osd_view = 1; }
static void close_osd(void){ OSD_CTRL &= ~3u; osd_on = 0; browser_on = 0; opt_on = 0; osd_view = 0; }  /* DN-only build: clear both OSD layers */

/* ---- F5 SD file browser (read-only) with directory navigation, into the 256x128 OSD panel ---- */
#define MAXFILES 256
#define BROWS    18                       /* file rows visible in the DN 80x25 panel */
#define NAMELEN  96                 /* store the full long name (panel shows VISCH; marquee reveals the rest) */
static char  flist[MAXFILES][NAMELEN+1];
static uint8_t fisdir[MAXFILES];
static uint8_t fhidden[MAXFILES];   /* 1 = hidden/system/dotfile (shown only when opt_showhidden; marked in the list) */
static uint8_t fsel[MAXFILES];      /* 1 = tagged (Space, DN group-select) -> group copy/delete/move */
static void menubar_draw(int cur);
static void draw_topstatus(void);   /* top-right: machine status + volume + version */
static void mkdir_path(const char* path);   /* create missing folders in a "0:/a/b/c" path */
static uint64_t count_tree(char* path);      /* total bytes under a folder (progress denominator) */
static int copy_move_run(char* src, char* dst, int isdir, uint64_t total, int removesrc, const char* title);
static int  selcount(void);                  /* # of tagged (Space) entries, excl ".." */
static void group_copy_move(int removesrc, const char* title);   /* group copy/move to a folder */
static int  copy_move_dialog(char* dst, int dstsz, int* removesrc, int* checkfree, const char* deftitle);  /* shared DN Copy/Move dialog */

/* Copy/Move conflict-resolution mode + options (issue #19): set by the shared dialog, read by copy_file_pg. */
enum { CPM_OVERWRITE=0, CPM_APPEND, CPM_RESUME, CPM_SKIP, CPM_REFRESH, CPM_ASK };
static int g_copy_mode   = CPM_OVERWRITE;   /* radio: how to resolve an existing target */
static int g_copy_verify = 0;               /* checkbox: byte-for-byte read-back after a full copy */
static int g_copy_askall = -1;              /* Ask mode: latched "for all" action (-1 = ask each conflict) */
static int g_copy_defmode = CPM_ASK;        /* dialog's remembered default radio (starts on Ask) */
static void open_help(void);
static void run_menu_system(void);
static uint32_t fsz[MAXFILES];          /* file size in bytes (0 for dirs / "..") */
static uint32_t fdt[MAXFILES];          /* (FAT date<<16)|time, for chronological sort */
static int   fcount = 0, bcursor = 0, btop = 0, sd_mounted = 0;
static int   sortmode = 0;              /* 0=NAME 1=DATE 2=SIZE 3=EXT */
static int   g_sort_desc = 0;           /* 0=ascending (default), 1=descending; Alt+F3 toggles, F3 (mode change) resets to asc */
static int   g_menu_open = 0;           /* a modal dropdown is on screen: suppress list/marquee redraws beneath it */
static int   g_suppress_browser_draw = 0;  /* a modal/progress window owns the screen: auto-advance may start the next
                                              track but must NOT touch the file list or move the browser cursor */
static int   g_list_dirty = 0;          /* the list was re-sorted under an open menu: redraw it once on menu exit */
static int   g_alpha_dirty = 0;         /* the canvas alpha changed under an open menu: FULL repaint needed */
static int   opt_scroll     = 1;        /* long-name marquee speed: 0=slow 1=med 2=fast */
static int   opt_foldermark = 0;        /* folder tag style: 0=[brackets] 1=icon 2=trailing-slash */
static int   opt_scrdelay    = 1;        /* marquee START delay: 0=0ms 1=300ms 2=500ms 3=1000ms */
static int   opt_dim         = 80;       /* OSD panel dimming/opacity %% (5%% steps) */
static int   opt_vol         = 100;      /* HDMI output volume %% (5%% steps); 100 = unity */
static int   g_mute          = 0;        /* KP* global mute: 1 = whole audio mix silenced (music + machine + tape); runtime-only, not saved */
static int   opt_defmachine  = 0;        /* Step 15: default machine to boot (index into CH_MACHINE / MACHINE_TAG); boot + live switch wired when the proven Pentagon core is imported */
static int   opt_pintv       = 239;      /* Step 15: Pentagon INT line (runtime tuner; reference default 239) */
static int   opt_pinth       = 326;      /* Step 15: Pentagon INT start hc (runtime tuner; reference default 326) */
static int   opt_paper_h     = 64;       /* live: h offset for paper start (left border width for wider Pentium look) */
static int   opt_paper_v     = 24;       /* live: v offset for paper start (top border height for logo position) */
static int   opt_scr_x       = 256;      /* live: whole-frame H position on HDMI (fb_line_disp HMARGIN); moves border+paper together */
static int   opt_scr_y       = 58;       /* live: whole-frame V position on HDMI (fb_line_disp VMARGIN) */
static int   opt_x           = 320;      /* navigator (DN canvas) left X0 in 1280x720 (0..640, step 8) */
static int   opt_y           = 160;      /* navigator top Y0 (0..320, step 8) */
static int   opt_pl_x        = 504;      /* player window left X0 (0..1024, step 8); default centres the 275-wide window */
static int   opt_pl_y        = 256;      /* player window top  Y0 (0..592,  step 8); default leaves room for the playlist below */
static int   opt_playmode    = 0;        /* music auto-play mode: 0=FOLDER(play to end, stop) 1=FILE(one track, stop)
                                            2=FOLDER LOOP 3=FILE LOOP 4=RANDOM(shuffle in folder) */
static const char* const CH_PLAY[] = {"FOLDER","FILE","FOLDER LOOP","FILE LOOP","RANDOM"};   /* shared by F2 / menu / status */
#define N_PLAYMODES 5
static int   playing_idx     = -1;       /* flist index of the currently-playing track (-1 = none) */
static char  play_dir[80]    = "";       /* folder (curpath) where the current playback started (auto-advance scope) */
static int   opt_pausemusic  = 0;        /* 0=NO (game runs in background, audio muted by FIFO mux) 1=YES (HALT when music plays over a game) */
static int   opt_launchsnd   = 0;        /* launch a program while music plays: 0=MACHINE (suspend music, machine audible, resume via menu/cursor) 1=MUSIC (keep music, machine muted) */
static int   opt_bootnav     = 1;        /* show the navigator at boot: 1=YES (default) 0=NO (boot to the machine; F12 opens the navigator) */
static int   halt_src = 0;               /* HALT bitmask: bit0=manual Pause, bit1=auto music-halt, bit2=SD-op freeze; machine halted while nonzero */
static int   opt_tapesound   = 1;        /* Step 14.2: 1=YES hear the tape loading sound, 0=NO real-time load but muted */
static int   opt_tapemute    = 0;        /* 1=mute the MACHINE audio (the ZX ULA reproduces EAR on its own beeper) while a tape loads; independent of Tape Sound */
static void  apply_tapemute(void);       /* fwd: the tape-start path calls this before its definition */
static int   opt_showhidden  = 0;        /* 0=hide hidden/system + dotfiles (macOS .DS_Store/._* junk), 1=show all */
static int   opt_timemode    = 0;        /* upper-window time: 0=remaining (-M:SS), 1=elapsed (M:SS) */
static int   opt_mp3tape     = 0;        /* 1=always treat .mp3 as tape (for turbo digitised collections; bypasses fragile pilot detect), 0=auto-detect */
int          opt_preload     = 0;        /* 0=NO (stream from SD, instant start) 1=YES (preload whole file to DDR, prevents SD-stalls) */
/* MP3/WAV tape reader: only the comparator hysteresis is user-tunable (exposed as "MP3 SENS" in F9).
   Interpolation is always on (required for turbo). The POWADCR F6 tuner + its 13 dead params were
   removed 2026-07-03 once the real fix (the interp formula) landed - they tuned nothing. */
static int tune_hys_mp3 = 1024;      /* Schmitt hysteresis for MP3 tape (lower = more sensitive) */
static void update_banner(void);     /* fwd */
static void render_browser(void);    /* fwd */
static const char* const CH_NOYES[] = {"NO","YES"};
static const char* const CH_LAUNCH[]= {"MACHINE","MUSIC"};
/* Step 15 scaffold: the machine list. ZX 128K runs today; the Pentagon rows are placeholders until the
   proven Pentagon core is imported (then opt_defmachine drives the boot machine + a live switch). CH_MACHINE
   = display labels; MACHINE_TAG = stable ini keys (index reordering must not break saved configs). */
static const char* const CH_MACHINE[]  = {"ZX 128K", "PENTAGON 1024K"};
static const char* const MACHINE_TAG[] = {"zx128",   "pent1024"};
#define N_MACHINES 2
static const char* const CH_012[] = {"0","1","2"};
/* ---- pause/now-playing BANNER state (independent overlay) ---- */
static char  g_app_path[180] = "";       /* full SD path of the last-loaded snapshot (game/demo) */
static int   g_app_stopped   = 0;        /* 1 = the loaded app was hard-reset (F11): keep the name, show STOP */
static char  g_music_path[180] = ""; /* full path of the currently-playing track */
static void  update_banner(void);        /* fwd (defined after the pause section) */
static void  apply_music_halt(void);     /* fwd (HALT coordination) */
static void  resume_music(void);         /* fwd: resume a paused/suspended track (menu / cursor) */
static void  apply_halt(void);           /* fwd (single owner of IJ_CTRL HALT bit) */
static void  sdop_freeze_begin(void);    /* fwd: freeze the machine (tape in lock-step) around a blocking SD op */
static void  sdop_freeze_end(void);
static void  music_halt_changed(void);   /* fwd (F9 PAUSE-MUS onchange) */
static int   scroll_started  = 0;        /* 0 = still in the pre-scroll start delay for this name */
static char  curpath[80] = "0:/";
static FATFS g_fs;
/* SD robustness: EBAZ4205 has NO routed card-detect, so presence can't be cheaply polled. Instead
   any FatFs error drops the volume (sd_unmount) and F5 remounts - so a yanked card can no longer
   wedge the non-blocking OSD loop in a stuck SD op. EJECT SD (F9) unmounts cleanly before removal. */
static void sd_unmount(void){ f_mount(0, "0:/", 0); sd_mounted = 0; }
#define VISCH 30                     /* chars visible in the 256px panel from x=12 */
static int   sel_scroll = 0;         /* marquee offset of the selected (long) name */
static XTime last_scroll = 0;
static XTime last_probe  = 0;   /* throttle the no-card-detect remount poll (EBAZ has no CD line) */

static void itoa_u(int v, char* o){ char t[8]; int q=0; if(!v){o[0]='0';o[1]=0;return;}
    while(v&&q<7){t[q++]='0'+v%10;v/=10;} int p=0; while(q)o[p++]=t[--q]; o[p]=0; }
static int  is_root(void){ return curpath[0]=='0'&&curpath[1]==':'&&curpath[2]=='/'&&curpath[3]==0; }

static int cicmp(const char* a, const char* b){      /* case-insensitive string compare */
    for(;;){
        int x=(unsigned char)*a++, y=(unsigned char)*b++;
        if(x>='A'&&x<='Z') x+=32;
        if(y>='A'&&y<='Z') y+=32;
        if(x!=y) return x-y;
        if(!x) return 0;
    }
}
static const char* fext(const char* s){               /* suffix after the last '.', or "" */
    const char* e=""; for(const char* p=s; *p; p++) if(*p=='.') e=p+1; return e;
}
/* "less" = a should appear before b. Folders always above files (both directions); then the active
   sort key ASCENDING by default (name/ext A->Z, date oldest first, size smallest first). g_sort_desc
   (Alt+F3) flips the direction. Tie-break always by name. */
static int ent_less(int a, int b){
    if(fisdir[a]!=fisdir[b]) return fisdir[a] > fisdir[b];    /* folders always on top */
    int c=0;                                                 /* ascending comparison: <0 => a before b */
    switch(sortmode){
        case 1: c = (fdt[a]<fdt[b])?-1:(fdt[a]>fdt[b])?1:0; break;      /* DATE (asc = oldest first) */
        case 2: c = (fsz[a]<fsz[b])?-1:(fsz[a]>fsz[b])?1:0; break;      /* SIZE (asc = smallest first) */
        case 3: c = cicmp(fext(flist[a]), fext(flist[b])); break;      /* EXT */
        default: break;                                                /* NAME */
    }
    if(c==0) c = cicmp(flist[a], flist[b]);                  /* tie-break by name */
    return g_sort_desc ? (c > 0) : (c < 0);
}
static void swap_ent(int i, int j){
    char tmp[NAMELEN+1]; for(int k=0;k<=NAMELEN;k++){ tmp[k]=flist[i][k]; flist[i][k]=flist[j][k]; flist[j][k]=tmp[k]; }
    uint8_t  d=fisdir[i]; fisdir[i]=fisdir[j]; fisdir[j]=d;
    uint8_t  h=fhidden[i];fhidden[i]=fhidden[j];fhidden[j]=h;
    uint8_t  g=fsel[i];   fsel[i]=fsel[j];       fsel[j]=g;
    uint32_t s=fsz[i];    fsz[i]=fsz[j];       fsz[j]=s;
    uint32_t t=fdt[i];    fdt[i]=fdt[j];       fdt[j]=t;
}
static void sort_entries(void){                        /* insertion sort; keep ".." pinned at row 0 */
    int base = is_root() ? 0 : 1;
    for(int i=base+1; i<fcount; i++)
        for(int j=i; j>base && ent_less(j, j-1); j--) swap_ent(j, j-1);
}
/* Filename part of a full path (after the last '/'). */
static const char* base_name(const char* path){
    const char* b = path; for(const char* p=path; *p; p++) if(*p=='/') b = p+1; return b;
}
/* sort_entries()/sd_scan physically reorder flist[], so the raw playing_idx no longer points at the
   playing track. Re-find it by name in the current folder. Only meaningful while the playing folder
   is the one on screen (curpath==play_dir); otherwise the autoadvance folder-scope guard handles it. */
static void remap_playing_idx(void){
    if(playing_idx < 0 || !player_active()) return;
    if(cicmp(curpath, play_dir) != 0) return;          /* not the playing folder: index is unused (guarded) */
    const char* nm = base_name(g_music_path);
    for(int i=0;i<fcount;i++) if(!fisdir[i] && cicmp(flist[i], nm)==0){ playing_idx = i; return; }
    playing_idx = -1;                                  /* the playing file vanished from this listing */
}

static void sd_scan(void){               /* mount once + read curpath into flist[] */
    fcount = 0;   /* keep bcursor/btop: only a directory change resets the cursor, so a re-open (F5) lands where you were */
    for(int i=0;i<MAXFILES;i++) fsel[i]=0;   /* a fresh listing invalidates the old tags (indices change) */
    if(!sd_mounted){
        browser_status("MOUNT");                  /* instant status: mount can take ~1s on a flaky/absent card */
        if(f_mount(&g_fs, "0:/", 1) != FR_OK){ sd_unmount(); return; }
        sd_mounted = 1;
    }
    browser_status("READ");
    if(!is_root()){                       /* synthetic ".." to go up */
        flist[0][0]='.'; flist[0][1]='.'; flist[0][2]=0; fisdir[0]=1; fhidden[0]=0;
        fsz[0]=0; fdt[0]=0; fcount=1;
    }
    DIR dir; FILINFO fno; FRESULT rr=FR_OK;
    if(f_opendir(&dir, curpath) != FR_OK){           /* stale mount (card swapped) or gone: try ONE fresh remount */
        sd_unmount();
        if(f_mount(&g_fs,"0:/",1)!=FR_OK){ sd_unmount(); return; }   sd_mounted=1;
        if(f_opendir(&dir, curpath) != FR_OK){ sd_unmount(); return; }   /* really gone -> NO CARD */
    }
    int _kbscan=0;
    while(fcount < MAXFILES && (rr=f_readdir(&dir, &fno)) == FR_OK && fno.fname[0]){
        if((_kbscan++ & 63)==0) KBD_HB=1;                     /* Step 15: pet the deadman during a big dir walk so the OSD key gate never drops mid-scan */
        if(!opt_showhidden){                                  /* hide hidden/system + dotfiles (macOS .DS_Store, ._x, .Trashes, .Spotlight junk) */
            if(fno.fattrib & (AM_HID|AM_SYS)) continue;
            if(fno.fname[0]=='.') continue;
        }
        int n=0; for(; fno.fname[n] && n<NAMELEN; n++) flist[fcount][n]=fno.fname[n];
        flist[fcount][n]=0;
        fisdir[fcount] = (fno.fattrib & AM_DIR) ? 1 : 0;
        fhidden[fcount]= ((fno.fattrib & (AM_HID|AM_SYS)) || fno.fname[0]=='.') ? 1 : 0;
        fsz[fcount]    = (uint32_t)fno.fsize;
        fdt[fcount]    = ((uint32_t)fno.fdate << 16) | fno.ftime;
        fcount++;
    }
    f_closedir(&dir);
    if(rr != FR_OK){ sd_unmount(); return; }   /* error mid-enumeration -> card gone, don't show a partial list */
    sort_entries();
    remap_playing_idx();                                   /* keep playing_idx on the playing track after the re-sort */
    if(bcursor>=fcount) bcursor = fcount ? fcount-1 : 0;   /* keep the remembered cursor in range if the dir shrank */
    if(btop>bcursor) btop=bcursor;
    if(bcursor>=btop+BROWS) btop=bcursor-(BROWS-1);
    if(btop<0) btop=0;
}
static const char* sort_label(void){
    switch(sortmode){ case 1: return "DATE"; case 2: return "SIZE"; case 3: return "EXT"; default: return "NAME"; }
}
static void draw_vline(int x,int y0,int y1){ for(int y=y0;y<y1;y++) setpix(x,y); }
/* (BROWS is defined up near MAXFILES) */
__attribute__((unused)) static void render_browser_1bpp(void){
    osd_clear();
    if(!sd_mounted){ draw_title_c("SD: NO CARD / NOT FAT"); osd_blit(); return; }
    char t[40]; int p=0; for(int i=0; curpath[i] && p<13; i++) t[p++]=curpath[i];   /* path (left) */
    t[p++]=' '; char cnt[8]; itoa_u(fcount, cnt); for(int i=0; cnt[i]; i++) t[p++]=cnt[i]; t[p]=0;
    const char* sm = sort_label();                          /* current sort value: NAME/DATE/SIZE/EXT */
    char sl[20]; int q=0; const char* pfx="SORT:";          /* compact (F3 hotkey is in F1 help) so the play icons fit too */
    for(int i=0; pfx[i]; i++) sl[q++]=pfx[i];
    for(int i=0; sm[i]; i++) sl[q++]=sm[i];
    sl[q]=0;
    titlebar(); g_inv=1;                                    /* inverse title bar: path+count (left); play icons + SORT label (right) */
    draw_text(2,0,1,t);
    int rx = OSD_W - q*8;                                   /* SORT label, right-aligned (always visible) */
    draw_text(rx, 0, 1, sl);
    if(player_active()){                                    /* playback indicator = ICONS just left of the SORT label: state + mode */
        int iw = 8 + 8 + (opt_playmode==1 ? 8 : 0);         /* state glyph + mode glyph (+ '1' for REPEAT-1) */
        int ix = rx - iw - 6;
        draw_glyph(ix, 0, player_paused()?pause_glyph:play_glyph); ix+=8;
        if(opt_playmode==0) draw_glyph(ix,0,pend_glyph);                                       /* FOLDER: play-through */
        else { draw_glyph(ix,0,loop_glyph); ix+=8; if(opt_playmode==1) draw_char(ix,0,1,'1'); } /* REPEAT-1 / REPEAT-ALL */
    }
    g_inv=0;
    for(int row=0; row<BROWS; row++){
        int idx = btop+row; if(idx>=fcount) break;
        int y = 8 + row*8;
        draw_char(2, y, 1, idx==bcursor ? '>' : ' ');
        int so = (idx==bcursor && sel_scroll <= slen(flist[idx])) ? sel_scroll : 0;
        int nx = 12;
        if(fisdir[idx]){                                       /* opening mark ALWAYS (fixed nx, no jump) */
            if(opt_foldermark==0){ draw_glyph(13,y,lbr_glyph); nx=18; }       /* [brackets] flush-left */
            else if(opt_foldermark==1){ draw_glyph(12,y,folder_glyph); nx=22; } /* folder icon */
        }
        draw_text(nx, y, 1, flist[idx] + so);
        if(fisdir[idx] && so==0){
            int ex = nx + slen(flist[idx])*8;
            if(opt_foldermark==0) draw_char(ex,y,1,']');
            else if(opt_foldermark==2) draw_char(ex,y,1,'/');
        }
    }
    if(fcount > BROWS){                            /* scroll indicator down the right edge */
        int ty0 = 8, tyh = OSD_H - ty0;            /* track spans the list rows (y 8..127) */
        int th  = tyh * BROWS / fcount; if(th < 4) th = 4;
        int tt  = ty0 + (tyh - th) * btop / (fcount - BROWS);
        for(int y=ty0; y<OSD_H; y+=2) setpix(OSD_W-1, y);                /* dotted track */
        draw_vline(OSD_W-2, tt, tt+th); draw_vline(OSD_W-1, tt, tt+th);  /* solid thumb */
    }
    osd_blit();
}
/* ============ Step 14.4: file browser one-to-one in DOS Navigator style (colour DDR canvas) ============
   OUR file list (flist/fisdir/fsz/fdt) drawn with DN's visual language: double-frame active panel,
   path in the top border (white-on-cyan), yellow column headers with the active-sort column
   highlighted, per-type file colours, cyan cursor bar, scrollbar, DN key bar. Columns are OURS -
   Name / Ext / Size / Date - matching the four F3 sort modes. Supersedes the 1bpp render_browser. */
#define DNB_NAME  2     /* every column gets 1 space of padding each side -> content never touches frame/separators */
#define DNB_NAMEW 47    /* name cols 2..48; col 49 = trailing space before SEP1@50 (col 1 = leading space) */
#define DNB_SEP1  50    /* ext cell narrowed 1 -> exactly 1 space before the right-aligned ext (3-char z80/tap/wav...) */
#define DNB_EXT   51    /* ext cell: header left here; DATA right-aligned to DNB_EXTE for a clean 1-space right gutter */
#define DNB_EXTE  54    /* ext data right edge -> col 55 stays a space before SEP2 (3- and 4-char ext both get 1 gutter) */
#define DNB_SEP2  56
#define DNB_SIZE  58    /* space(57) | size right-aligned within 58..64 | space(65) */
#define DNB_SIZEE 64    /* size right edge -> col 65 stays a space before SEP3 */
#define DNB_SEP3  66
#define DNB_DATE  68    /* space(67) | date 68..77 (DD.MM.YYYY) | space(78) before the scrollbar */
#define DNB_SCR   79    /* scrollbar sits ON the right frame column, always shown (DN-style) */
#define DNB_LIST0 3
static void fmt_size_dn(uint32_t b, char* o){
    if(b>=1048576u){ uint32_t m10=(b*10u+524288u)/1048576u; itoa_u((int)(m10/10u),o); int n=slen(o); o[n++]='.'; o[n++]=(char)('0'+(m10%10u)); o[n++]='M'; o[n]=0; }
    else if(b>=1024u){ uint32_t k=(b+512u)/1024u; itoa_u((int)k,o); int n=slen(o); o[n++]='K'; o[n]=0; }
    else itoa_u((int)b,o);
}
static void fmt_date_dn(uint32_t dt, char* o){    /* DD.MM.YYYY (full year) */
    uint32_t d=dt>>16; if(d==0u){ o[0]=0; return; }
    int day=(int)(d&31u), mon=(int)((d>>5)&15u), yr=1980+(int)((d>>9)&127u);
    o[0]=(char)('0'+day/10); o[1]=(char)('0'+day%10); o[2]='.';
    o[3]=(char)('0'+mon/10); o[4]=(char)('0'+mon%10); o[5]='.';
    o[6]=(char)('0'+yr/1000); o[7]=(char)('0'+(yr/100)%10); o[8]=(char)('0'+(yr/10)%10); o[9]=(char)('0'+yr%10); o[10]=0;
}
static uint32_t dn_type_fg(int idx){
    if(fisdir[idx]) return DNK_DIR;
    const char* e=fext(flist[idx]);
    if(cicmp(e,"z80")==0||cicmp(e,"sna")==0) return DNK_SNAP;
    if(cicmp(e,"tap")==0||cicmp(e,"tzx")==0) return DNK_TAPE;
    if(cicmp(e,"psg")==0||cicmp(e,"wav")==0||cicmp(e,"mp3")==0) return DNK_MUSIC;
    return DNK_FILE;
}
/* proper transport glyphs (drawn as custom 8x16 bitmaps, not font chars): ► filled play triangle, ‖ two-bar pause */
static const uint8_t GLYPH_PLAY[16]  = {0,0,0x80,0xC0,0xE0,0xF0,0xF8,0xFC,0xFC,0xF8,0xF0,0xE0,0xC0,0x80,0,0};
static const uint8_t GLYPH_PAUSE[16] = {0,0,0x66,0x66,0x66,0x66,0x66,0x66,0x66,0x66,0x66,0x66,0x66,0x66,0,0};
static void dn_put_glyph(int cx,int cy,const uint8_t* g,uint32_t fg,uint32_t bg){   /* like dn_putc but from a custom 8x16 bitmap */
    if(cx<0||cy<0||cx>=DN_COLS||cy>=DN_ROWS) return;
    for(int r=0;r<16;r++){ unsigned char bits=g[r]; int qy=cy*16+r;
        for(int c=0;c<8;c++) g_osdc[qy*OSDC_W + cx*8+c] = (bits&(0x80u>>c))?fg:bg; }
}
/* Play-mode indicator glyphs (custom 8x16). The 5 modes = {folder,file}x{once,loop} + random, shown
   as TWO cells: a SCOPE glyph (list=folder / single-line=file) + a BEHAVIOUR glyph (arrow=play-once /
   loop=repeat); RANDOM is a single shuffle-cross glyph. Drawn in the status bar after the track name. */
static const uint8_t G_M_LIST [16] = {0,0,0,0x7E,0,0,0,0x7E,0,0,0,0x7E,0,0,0,0};      /* ≡ three lines = folder/list */
static const uint8_t G_M_ONE  [16] = {0,0,0,0,0,0,0,0x7E,0x7E,0,0,0,0,0,0,0};          /* ─ single line = one file    */
static const uint8_t G_M_ARROW[16] = {0,0,0,0,0,0x08,0x0C,0x0E,0xFF,0x0E,0x0C,0x08,0,0,0,0}; /* → play once/sequential */
static const uint8_t G_M_LOOP [16] = {0,0,0,0x3C,0x66,0xC3,0xC3,0xC3,0xC3,0x66,0x3C,0,0,0,0,0}; /* ○ clean ring = loop/repeat */
static const uint8_t G_M_SHUF [16] = {0,0,0,0xC3,0x66,0x3C,0x18,0x18,0x3C,0x66,0xC3,0,0,0,0,0};    /* ⤬ shuffle/random */
static void dn_draw_playmode(int cx,int cy,uint32_t fg,uint32_t bg){   /* 2 cells (random = 1, right cell blanked) */
    dn_putc(cx,cy,' ',fg,bg); dn_putc(cx+1,cy,' ',fg,bg);
    const uint8_t* scope; const uint8_t* beh;
    switch(opt_playmode){
        case 0: scope=G_M_LIST; beh=G_M_ARROW; break;   /* FOLDER      */
        case 1: scope=G_M_ONE;  beh=G_M_ARROW; break;   /* FILE        */
        case 2: scope=G_M_LIST; beh=G_M_LOOP;  break;   /* FOLDER LOOP */
        case 3: scope=G_M_ONE;  beh=G_M_LOOP;  break;   /* FILE LOOP   */
        default: dn_put_glyph(cx,cy,G_M_SHUF,fg,bg); return;   /* RANDOM (single glyph) */
    }
    dn_put_glyph(cx,cy,scope,fg,bg);
    dn_put_glyph(cx+1,cy,beh,fg,bg);
}
/* Is this row on the current playback path? -> the playing track (in its folder), OR any ancestor
   folder that (at any nesting level) contains the playing track. Used to show the > marker. */
static int on_play_path(int idx){
    if(!player_active() || idx<0 || idx>=fcount) return 0;
    if(!fisdir[idx]) return idx==playing_idx && cicmp(curpath,play_dir)==0;    /* the track itself, only in its folder */
    if(flist[idx][0]=='.' && flist[idx][1]=='.' && flist[idx][2]==0) return 0; /* ".." never marked */
    char fp[100]; int p=0;                                                    /* this folder's canonical full path */
    for(int i=0; curpath[i] && p<80; i++) fp[p++]=curpath[i];
    if(p>0 && fp[p-1]!='/') fp[p++]='/';
    for(int i=0; flist[idx][i] && p<98; i++) fp[p++]=flist[idx][i];
    fp[p]=0;
    for(int i=0;i<p;i++){ char a=fp[i], b=play_dir[i]; if(!b) return 0;        /* fp must be a prefix of play_dir (case-insensitive) */
        if(a>='A'&&a<='Z') a=(char)(a+32); if(b>='A'&&b<='Z') b=(char)(b+32); if(a!=b) return 0; }
    return play_dir[p]==0 || play_dir[p]=='/';                                 /* ...ending on a path boundary -> ancestor-or-equal */
}
static void dn_draw_file_row(int idx){          /* draw/refresh ONE file row in place (for fast partial redraw) */
    if(idx<btop || idx>=btop+BROWS || idx>=fcount) return;
    int y=DNB_LIST0+(idx-btop), cur=(idx==bcursor);
    uint32_t bg=cur?DNK_CUR_BG:DNK_PANEL_BG;
    uint32_t fg=fsel[idx] ? FG(14) : (cur?DNK_CUR_FG:dn_type_fg(idx));   /* tagged = yellow (DN group-select) */
    dn_fill(1,y,DNB_SCR-1,1,bg);                 /* erase row bg up to (not over) the scrollbar column */
    const char* src=flist[idx]; const char* e=fext(src); int nl=slen(src);
    int base=(!fisdir[idx] && *e) ? (int)(e-src)-1 : nl; if(base<0) base=0;      /* base-name length (before .ext) */
    int so=(idx==bcursor && sel_scroll>0 && sel_scroll<base) ? sel_scroll : 0;  /* marquee offset - cursor row only */
    int shown=base-so; if(shown>DNB_NAMEW) shown=DNB_NAMEW; if(shown<0) shown=0;
    char nm[64]; int k=0; for(; k<shown && k<63; k++) nm[k]=src[so+k]; nm[k]=0;
    dn_puts(DNB_NAME,y,nm,fg,bg);
    if(!fisdir[idx] && *e){ char ex[6]; int j=0; for(; e[j] && j<4; j++) ex[j]=e[j]; ex[j]=0;
        int exx=DNB_EXTE-j+1; if(exx<DNB_EXT) exx=DNB_EXT; dn_puts(exx,y,ex,fg,bg); }   /* right-aligned: 1-space gutter for any ext length */
    if(fisdir[idx]) dn_puts(DNB_SIZE,y,"<DIR>",fg,bg);
    else { char sz[12]; fmt_size_dn(fsz[idx],sz); int sl2=slen(sz); int sx=DNB_SIZEE-sl2+1; if(sx<DNB_SIZE) sx=DNB_SIZE; dn_puts(sx,y,sz,fg,bg); }
    { char dt[12]; fmt_date_dn(fdt[idx],dt); if(dt[0]) dn_puts(DNB_DATE,y,dt,fg,bg); }
    if(fhidden[idx]) dn_putc(DNB_SEP1-1,y, 0xB0, cur?DNK_CUR_FG:DNK_STATUS, bg);   /* hidden/system marker (░ light shade) at the end of the name */
    dn_putc(DNB_SEP1,y,SL_V,cur?DNK_CUR_FG:DNK_SEP,bg); dn_putc(DNB_SEP2,y,SL_V,cur?DNK_CUR_FG:DNK_SEP,bg); dn_putc(DNB_SEP3,y,SL_V,cur?DNK_CUR_FG:DNK_SEP,bg);
    if(on_play_path(idx)) dn_put_glyph(1,y, player_paused()?GLYPH_PAUSE:GLYPH_PLAY, DNK_STATUS,bg);   /* marker on the track + every ancestor folder of the play path */
}
static int g_status_scroll=0, g_status_started=0; static XTime g_status_last=0;   /* status-bar full-path marquee state */
static void fmt_mmss(unsigned s, char* o){       /* seconds -> "M:SS" / "MM:SS" */
    unsigned m=s/60u, ss=s%60u; if(m>99u)m=99u; int p=0;
    if(m>=10u) o[p++]=(char)('0'+m/10u);
    o[p++]=(char)('0'+m%10u); o[p++]=':';
    o[p++]=(char)('0'+ss/10u); o[p++]=(char)('0'+ss%10u); o[p]=0;
}
/* row 22 status line: DN playback status while music plays (>/|| + name + M:SS/M:SS + progress bar), else file count + sort */
static void dn_draw_status(void){
    dn_fill(1,22,DN_COLS-2,1,DNK_PANEL_BG);
    if(player_active()){
        dn_put_glyph(2,22, player_paused()?GLYPH_PAUSE:GLYPH_PLAY, DNK_MUSIC, DNK_PANEL_BG);
        { const char* mp=g_music_path; int ml=slen(mp), W=39, so=(ml>W)?g_status_scroll:0;  /* leave col 43 blank -> 1-char gap before the play-mode glyph at 44 */
          if(so>ml-W) so=ml-W; if(so<0) so=0;
          dn_putsn(4,22, mp+so, W, DNK_DIR, DNK_PANEL_BG); }             /* FULL path incl filename; marquee via g_status_scroll if long */
        dn_draw_playmode(44,22, DNK_MUSIC, DNK_PANEL_BG);               /* play-mode glyphs: after the name, before the time */
        { unsigned el=player_elapsed_s(), tot=player_total_s(); if(el>5999u)el=5999u; if(tot>5999u)tot=5999u;
          char t1[8],t2[8],tb[18]; fmt_mmss(el,t1); fmt_mmss(tot,t2);
          int p=0; for(int i=0;t1[i];i++)tb[p++]=t1[i]; tb[p++]='/'; for(int i=0;t2[i];i++)tb[p++]=t2[i]; tb[p]=0;
          dn_puts(47,22,tb,DNK_HEADER,DNK_PANEL_BG); }
        { unsigned pct=player_progress(); if(pct>100u)pct=100u; dn_bar(59,22,DNB_SCR-1-59,pct*10u,DNK_STATUS,DNK_PANEL_BG); }
    } else {
        char inf[40]; int n=0; const char* lbl="Files: "; for(int i=0;lbl[i];i++) inf[n++]=lbl[i]; char c[8]; itoa_u(fcount,c); for(int i=0;c[i];i++) inf[n++]=c[i]; inf[n]=0;
        dn_puts(2,22,inf,DNK_STATUS,DNK_PANEL_BG);
        const char* sm=sort_label(); int tw=6+slen(sm)+2; int sx=DN_COLS-2-tw; if(sx<20) sx=20;
        dn_puts(sx,22,"Sort: ",DNK_FILE,DNK_PANEL_BG); dn_puts(sx+6,22,sm,DNK_HEADER,DNK_PANEL_BG);
        dn_putc(sx+6+slen(sm)+1,22,g_sort_desc?0x1Fu:0x1Eu,DNK_HEADER,DNK_PANEL_BG);
    }
}
static void status_scroll_tick(void){            /* marquee the full track path in the status bar when it doesn't fit */
    if(!player_active()){ if(g_status_scroll){ g_status_scroll=0; g_status_started=0; g_status_last=0; } return; }
    int len=slen(g_music_path); if(len<=39){ if(g_status_scroll){ g_status_scroll=0; dn_draw_status(); } return; }
    XTime now; XTime_GetTime(&now);
    if(!g_status_started){ static const int dly[4]={0,300,500,1000};
        if(g_status_last==0){ g_status_last=now; return; }
        if(now-g_status_last < (COUNTS_PER_SECOND/1000u)*(unsigned)dly[opt_scrdelay]) return;
        g_status_started=1; g_status_last=now; }
    static const int sps[3]={2,3,6};
    if(now-g_status_last < (COUNTS_PER_SECOND/sps[opt_scroll])) return;
    g_status_last=now; g_status_scroll++;
    if(g_status_scroll > (len-40)+2){ g_status_scroll=0; g_status_started=0; g_status_last=now; }
    dn_draw_status();
}
static void dn_draw_list(void){                  /* redraw ONLY the dynamic panel content (headers+rows+scrollbar+info) - chrome (menu/path/frame/keybar) untouched -> no flicker on sort/scroll */
    if(!sd_mounted){ dn_puts(3,3,"SD: NO CARD / NOT FAT",DNK_HEADER,DNK_PANEL_BG); return; }
    dn_fill(1,2,DN_COLS-2,1,DNK_PANEL_BG);       /* clear header row (erase the old active-sort highlight) */
    int hn=(sortmode==0),he=(sortmode==3),hs=(sortmode==2),hd=(sortmode==1);
    dn_puts(DNB_NAME,2,"Name", hn?FG(0):DNK_HEADER, hn?BG(14):DNK_PANEL_BG);
    dn_puts(DNB_EXT+1,2,"Ext" , he?FG(0):DNK_HEADER, he?BG(14):DNK_PANEL_BG);  /* +1 = align header with the right-aligned 3-char data (1-space gutter) */
    dn_puts(DNB_SIZE,2,"Size", hs?FG(0):DNK_HEADER, hs?BG(14):DNK_PANEL_BG);
    dn_puts(DNB_DATE,2,"Date", hd?FG(0):DNK_HEADER, hd?BG(14):DNK_PANEL_BG);
    dn_putc(DNB_SEP1,2,SL_V,DNK_SEP,DNK_PANEL_BG); dn_putc(DNB_SEP2,2,SL_V,DNK_SEP,DNK_PANEL_BG); dn_putc(DNB_SEP3,2,SL_V,DNK_SEP,DNK_PANEL_BG);
    for(int row=0; row<BROWS; row++){ int idx=btop+row, y=DNB_LIST0+row;
        if(idx>=fcount){ dn_fill(1,y,DNB_SCR-1,1,DNK_PANEL_BG); dn_putc(DNB_SEP1,y,SL_V,DNK_SEP,DNK_PANEL_BG); dn_putc(DNB_SEP2,y,SL_V,DNK_SEP,DNK_PANEL_BG); dn_putc(DNB_SEP3,y,SL_V,DNK_SEP,DNK_PANEL_BG); }
        else dn_draw_file_row(idx); }
    /* scrollbar ON the right frame column, logic per Turbo Vision TScrollBar (VIEWS.PAS): arrows +
       (▒ page with a proportional ■ thumb) when there's range, else ▓ disabled fill (no thumb). */
    dn_putc(DNB_SCR,DNB_LIST0,0x1Eu,DNK_FRAME,DNK_PANEL_BG);                          /* up arrow */
    dn_putc(DNB_SCR,DNB_LIST0+BROWS-1,0x1Fu,DNK_FRAME,DNK_PANEL_BG);                  /* down arrow */
    if(fcount>BROWS){
        int sh=BROWS-2;                                                              /* shaft rows between the arrows */
        int ts=sh*BROWS/fcount; if(ts<1)ts=1; if(ts>sh)ts=sh;                         /* proportional thumb size */
        int tp=(sh-ts)*btop/(fcount-BROWS); if(tp<0)tp=0; if(tp>sh-ts)tp=sh-ts;       /* thumb position */
        for(int r=0;r<sh;r++) dn_putc(DNB_SCR,DNB_LIST0+1+r,0xDBu,(r>=tp&&r<tp+ts)?DNK_FRAME:DNK_FILE,DNK_PANEL_BG);  /* SOLID full block: white thumb over lt-gray track (no dither zebra) */
    } else for(int r=0;r<BROWS-2;r++) dn_putc(DNB_SCR,DNB_LIST0+1+r,0xDBu,DNK_FILE,DNK_PANEL_BG);  /* list fits: shaft/track ALWAYS drawn (lt-gray), just no thumb */
    for(int x=1;x<DN_COLS-1;x++) dn_putc(x,21,SL_H,DNK_SEP,DNK_PANEL_BG);
    dn_putc(DNB_SEP1,21,0xC1,DNK_SEP,DNK_PANEL_BG); dn_putc(DNB_SEP2,21,0xC1,DNK_SEP,DNK_PANEL_BG); dn_putc(DNB_SEP3,21,0xC1,DNK_SEP,DNK_PANEL_BG);
    dn_draw_status();                                        /* row 22: music status while playing, else file count + sort */
}
static void sort_changed(void){   /* SORT changed from a menu value-item: re-sort live (F3 parity, else the list goes stale) */
    if(!sd_mounted || !fcount) return;
    sort_entries(); remap_playing_idx();
    bcursor=0; btop=0; sel_scroll=0; last_scroll=0; scroll_started=0;
    if(browser_on && !g_menu_open) dn_draw_list();
    else g_list_dirty=1;              /* under an open dropdown: repaint once the menu closes */
}
/* ---- DN status line (bottom row): always-present active-key hints, DN-style (hotkey red, label gray).
   Context-sensitive: the browser shows its keys, a modal dialog swaps in its own, then restores. ---- */
static void dn_keybar(const char* const items[][2], int n){
    dn_fill(0,DN_ROWS-1,DN_COLS,1,DNK_MENU_BG);
    int iw[16], total=0;                                  /* item widths: key + space + label */
    for(int i=0;i<n && i<16;i++){ iw[i]=slen(items[i][0])+1+slen(items[i][1]); total+=iw[i]; }
    int gaps=n+1, base=(DN_COLS-total)/gaps; if(base<1) base=1;   /* spread the slack across n+1 gaps (edges + between) */
    int extra=(DN_COLS-total)-base*gaps; if(extra<0) extra=0;
    int x=0;
    for(int i=0;i<n && i<16;i++){
        x += base + (i<extra?1:0);                        /* sprinkle the remainder into the first gaps */
        dn_puts(x, DN_ROWS-1, items[i][0], DNK_HOTKEY,  DNK_MENU_BG);
        dn_puts(x+slen(items[i][0])+1, DN_ROWS-1, items[i][1], DNK_MENU_FG, DNK_MENU_BG);
        x += iw[i];
    }
}
static int g_kbar_mod = 0;   /* which F-key hint bar is shown now: 0=normal, 1=Ctrl, 2=Alt */
static void dn_keybar_browser(void){
    static const char* const it[8][2]={{"F1","Help"},{"F5","Copy"},{"F6","Ren"},{"F7","Dir"},{"F8","Del"},{"F9","Menu"},{"F12","Hide"},{"Esc","Back"}};
    dn_keybar(it,8); g_kbar_mod=0;
}
/* DN dynamic F-key bar: while Ctrl / Alt is held, show the modified commands (sort fields / reverse). */
static void dn_keybar_browser_mode(int mod){
    if(mod==1){ static const char* const it[4][2]={{"Ctrl+F3","Sort Name"},{"Ctrl+F4","Sort Ext"},{"Ctrl+F5","Sort Size"},{"Ctrl+F6","Sort Date"}}; dn_keybar(it,4); }
    else dn_keybar_browser();
}
static void render_browser_dn(void){
    /* No full clear: the menu row, panel and key bar below cover the whole 640x400 canvas (no transparent flash). */
    menubar_draw(-1);                                         /* top menu bar - data-driven Menubar draw */
    dn_fill(0,1,DN_COLS,DN_ROWS-2,DNK_PANEL_BG);              /* file panel */
    dn_box(0,1,DN_COLS,DN_ROWS-2,DNK_FRAME,DNK_PANEL_BG,1);   /* double frame = active window */
    { char t[52]; int n=0; for(const char* p=curpath; *p && n<48; p++) t[n++]=*p; t[n]=0;   /* path in top border */
      int px=(DN_COLS-(n+2))/2; if(px<2) px=2;
      dn_putc(px,1,' ',DNK_CUR_FG,DNK_CUR_BG); dn_puts(px+1,1,t,DNK_CUR_FG,DNK_CUR_BG); dn_putc(px+1+n,1,' ',DNK_CUR_FG,DNK_CUR_BG); }
    dn_draw_list();                                          /* dynamic panel content (headers + files + scrollbar + info) */
    dn_keybar_browser();                                     /* bottom status line: always-present key hints */
}
static void render_browser(void){ render_browser_dn(); }   /* single entry point - all call sites now draw DN */
static void open_browser(void){
    sel_scroll=0; last_scroll=0; scroll_started=0; opt_on=0;
    OSD_CTRL=(OSD_CTRL|2u)&~1u; osd_on=1; browser_on=1; osd_view=3;   /* DN browser on the colour layer (bit1); drop the 1bpp plane */
    render_browser();        /* INSTANT window before any SD I/O - a keypress always shows something */
    sdop_freeze_begin();     /* a blocking scan mid-tape-load would underrun the pulse FIFO */
    sd_scan();               /* may block ~1s; shows MOUNT/READ on the title bar */
    sdop_freeze_end();
    render_browser();        /* final listing */
}
static void browser_move(int d){
    if(fcount==0) return;
    int old_cur=bcursor, old_top=btop;
    bcursor += d;
    if(bcursor<0) bcursor=0;
    if(bcursor>=fcount) bcursor=fcount-1;
    if(bcursor<btop) btop=bcursor;
    if(bcursor>=btop+BROWS) btop=bcursor-(BROWS-1);
    sel_scroll=0; last_scroll=0; scroll_started=0;   /* fresh selection: unscrolled, re-arm start delay */
    if(btop==old_top){ dn_draw_file_row(old_cur); dn_draw_file_row(bcursor); }  /* no scroll: repaint only the 2 changed rows */
    else dn_draw_list();                                                        /* scrolled: redraw only the list area (chrome stays -> no flicker) */
}
static void browser_scroll_tick(void){    /* marquee the selected long name - redraws ONLY the cursor row (no window flicker) */
    if(fcount==0 || bcursor>=fcount) return;
    const char* src=flist[bcursor]; const char* e=fext(src); int nl=slen(src);
    int base=(!fisdir[bcursor] && *e) ? (int)(e-src)-1 : nl; if(base<0) base=0;   /* base-name length in the Name column */
    if(base <= DNB_NAMEW){ if(sel_scroll){ sel_scroll=0; dn_draw_file_row(bcursor); } return; }  /* fits: never marquee */
    XTime now; XTime_GetTime(&now);
    if(!scroll_started){                  /* hold the name still for the configured delay first */
        static const int dly_ms[4] = {0,300,500,1000};
        if(last_scroll==0){ last_scroll = now; return; }                 /* stamp the selection time */
        if(now - last_scroll < (COUNTS_PER_SECOND/1000u)*(unsigned)dly_ms[opt_scrdelay]) return;
        scroll_started = 1; last_scroll = now;
    }
    static const int sps[3] = {2,3,6};                 /* marquee steps/sec for slow/med/fast */
    if(now - last_scroll < (COUNTS_PER_SECOND / sps[opt_scroll])) return;
    last_scroll = now;
    sel_scroll++;
    if(sel_scroll > (base - DNB_NAMEW) + 2){ sel_scroll = 0; scroll_started = 0; last_scroll = now; } /* tail pause -> re-delay */
    dn_draw_file_row(bcursor);            /* ONE row only */
}
/* ====== Step 12.1: .z80 / .sna snapshot loader =====================================
   Enter on a snapshot -> read it off the card, parse it, inject RAM + ports + the Z80
   registers into the Atlas core over the Step-7 control plane (HALT, RAM_ADDR/DATA,
   7FFD/FE, the 212-bit T80 DIR vector), then resume. The running machine is replaced
   (a deliberate load). Covers .z80 v1/v2/v3 (48K+128K) and .sna 48K/128K. */
/* 32-byte (A9 cache-line) aligned: FatFs streams multi-sector f_read straight into this buffer, so
   with D-cache ON it MUST be cache-line aligned or the invalidate clips a few bytes (the old bug). */
static uint8_t snapbuf[160*1024] __attribute__((aligned(32)));   /* whole snapshot file (128K .sna ~131 KB) */
static uint8_t pagebuf[16384];      /* one decompressed .z80 page */
static uint8_t ram48[49152];        /* decompressed 48K image (v1 / 48K) */

static void wr_bank(int bank, const uint8_t* p){
    IJ_RAMA = (uint32_t)bank << 14;
    for(int i=0;i<16384;i++){ IJ_RAMD = p[i];
        for(volatile uint32_t t=0; (IJ_STAT & 0x2u) && t<1000000u; t++){} }   /* poll RAM_BUSY (bounded: a wedged core must not hang the ARM) */
}
/* Full machine RESET + RAM wipe before inject (Step 12, VERSION 0xB01B0009+): pulse CONTROL bit2
   (RESET+wipe), wait STATUS bit2 to assert then clear. The hardware sweep-wipes all 128 KB and
   cold-resets the Z80 + ALL peripherals (AY/ULA/paging) - reusing the core's F11 cold-reset path -
   so leftover state from the previous program can't corrupt the new one (fixes aeon-over-a-demo)
   and the AY stops squealing. Then HALT + wait HALT_ACK to take the bus. (Per the CDC review:
   wait busy 0->1->0, never treat the first busy==0 as done - the wipe must not race the inject.)
   On an older bitstream (no bit2) this degrades to a brief delay + HALT (no reset). */
static void machine_reset(void){
    IJ_CTRL = 0x4;                                              /* request RESET+wipe (CONTROL bit2) */
    for(volatile uint32_t t=0; t<500000u;  t++) if(  IJ_STAT & 0x4u) break;   /* wait busy asserted */
    for(volatile uint32_t t=0; t<8000000u; t++) if(!(IJ_STAT & 0x4u)) break;  /* wait wipe+reset done */
    IJ_CTRL = 1;                                                /* HALT - take the memory bus */
    for(volatile uint32_t t=0; t<8000000u && !(IJ_STAT & 1u); t++){}   /* wait HALT_ACK (bounded) */
}
/* .z80 RLE: 'ED ED cnt val'; clen==0xFFFF -> 16384 raw bytes. `avail` = source bytes remaining in the
   file from src, so a truncated/malformed page can never read past end-of-file (clamps raw + RLE). */
static void z80_unrle(const uint8_t* src,int clen,int avail,uint8_t* dst){
    if(avail<0) avail=0;
    if(clen==0xFFFF){ int n=(avail<16384)?avail:16384,i=0; for(;i<n;i++) dst[i]=src[i]; for(;i<16384;i++) dst[i]=0; return; }
    if(clen>avail) clen=avail;                       /* never read past the bytes actually in the file */
    int o=0,i=0;
    while(o<16384 && i<clen){
        if(src[i]==0xED && i+3<clen && src[i+1]==0xED){ int c=src[i+2]; uint8_t v=src[i+3]; i+=4; while(c-->0 && o<16384) dst[o++]=v; }
        else dst[o++]=src[i++];
    }
    while(o<16384) dst[o++]=0;
}
typedef struct { uint32_t A,F,Ap,Fp,I,R,SP,PC,BC,DE,HL,IX,BCp,DEp,HLp,IY,IM,IFF1,IFF2,border,p7ffd; } zregs;
static void inject_finish(const zregs* z){
    IJ_7FFD = z->p7ffd; IJ_FE = z->border; IJ_COMMIT = 0x1u;     /* paging + border */
    uint32_t dir[7];                                             /* T80 DIR (IX before the prime set) */
    dir[0]=z->A|(z->F<<8)|(z->Ap<<16)|(z->Fp<<24);
    dir[1]=z->I|(z->R<<8)|(z->SP<<16);
    dir[2]=z->PC|(z->BC<<16);
    dir[3]=z->DE|(z->HL<<16);
    dir[4]=z->IX|(z->BCp<<16);
    dir[5]=z->DEp|(z->HLp<<16);
    dir[6]=z->IY|(z->IM<<16)|(z->IFF1<<18)|(z->IFF2<<19);
    for(int k=0;k<7;k++) *(volatile uint32_t*)(GP0+IJ_DIR0+4u*k)=dir[k];
    IJ_COMMIT = 0x2u;                                            /* DIRSet pulse */
    IJ_CTRL = 0;                                                 /* resume */
}
static void load_z80(const uint8_t* d,int len){
    zregs z = {0};
    z.A=d[0]; z.F=d[1]; z.BC=d[2]|(d[3]<<8); z.HL=d[4]|(d[5]<<8); z.SP=d[8]|(d[9]<<8);
    z.I=d[10]; z.R=(d[11]&0x7F)|((d[12]&1)<<7); z.border=(d[12]>>1)&7;
    z.DE=d[13]|(d[14]<<8); z.BCp=d[15]|(d[16]<<8); z.DEp=d[17]|(d[18]<<8); z.HLp=d[19]|(d[20]<<8);
    z.Ap=d[21]; z.Fp=d[22]; z.IY=d[23]|(d[24]<<8); z.IX=d[25]|(d[26]<<8);
    z.IFF1=d[27]?1:0; z.IFF2=d[28]?1:0; z.IM=d[29]&3;
    uint32_t pc0=d[6]|(d[7]<<8);
    machine_reset();                                             /* full reset + wipe, then HALT */
    if(pc0){                                                     /* --- v1: 48K, one RLE block @30 --- */
        z.PC=pc0; z.p7ffd=0x30;
        if(d[12]&0x20){
            int o=0,i=30;
            while(o<49152 && i<len){
                if(d[i]==0xED && i+3<len && d[i+1]==0xED){ int c=d[i+2]; uint8_t v=d[i+3]; i+=4; while(c-->0 && o<49152) ram48[o++]=v; }
                else ram48[o++]=d[i++];
            }
            while(o<49152) ram48[o++]=0;
        } else { for(int i=0;i<49152 && 30+i<len;i++) ram48[i]=d[30+i]; }
        wr_bank(5,ram48); wr_bank(2,ram48+16384); wr_bank(0,ram48+32768);
    } else {                                                     /* --- v2/v3 --- */
        int extlen=d[30]|(d[31]<<8); z.PC=d[32]|(d[33]<<8);
        int hw=d[34]; int is128=(extlen==23)?(hw>=3):(hw>=4);
        z.p7ffd=is128?(d[35]&0x3F):0x30;
        int off=32+extlen;
        while(off+3<=len){
            int clen=d[off]|(d[off+1]<<8); int pg=d[off+2]; const uint8_t* src=d+off+3;
            int fb=(clen==0xFFFF)?16384:clen;
            z80_unrle(src,clen,len-(off+3),pagebuf);
            int bank=-1;
            if(is128){ if(pg>=3&&pg<=10) bank=pg-3; }
            else { if(pg==5)bank=5; else if(pg==4)bank=2; else if(pg==8)bank=0; }
            if(bank>=0) wr_bank(bank,pagebuf);
            off+=3+fb;
        }
    }
    inject_finish(&z);
}
static void load_sna(const uint8_t* d,int len){
    zregs z = {0};
    z.I=d[0]; z.HLp=d[1]|(d[2]<<8); z.DEp=d[3]|(d[4]<<8); z.BCp=d[5]|(d[6]<<8);
    z.Fp=d[7]; z.Ap=d[8]; z.HL=d[9]|(d[10]<<8); z.DE=d[11]|(d[12]<<8); z.BC=d[13]|(d[14]<<8);
    z.IY=d[15]|(d[16]<<8); z.IX=d[17]|(d[18]<<8);
    z.IFF2=(d[19]&0x04)?1:0; z.IFF1=z.IFF2;
    z.R=d[20]; z.F=d[21]; z.A=d[22]; z.SP=d[23]|(d[24]<<8); z.IM=d[25]&3; z.border=d[26]&7;
    machine_reset();                                             /* full reset + wipe, then HALT */
    const uint8_t* ram=d+27;
    if(len<131000){                                              /* --- 48K .sna (49179) --- */
        wr_bank(5,ram); wr_bank(2,ram+16384); wr_bank(0,ram+32768);
        uint32_t sp=z.SP, pcl=0,pch=0;                           /* PC via the stack trick */
        if(sp>=0x4000 && sp<=0xFFFE){ pcl=ram[sp-0x4000]; pch=ram[sp-0x4000+1]; }
        z.PC=pcl|(pch<<8); z.SP=(sp+2)&0xFFFF; z.p7ffd=0x30;
    } else {                                                     /* --- 128K .sna --- */
        uint32_t pc=ram[49152]|(ram[49153]<<8); uint32_t p7=ram[49154]; int paged=p7&7;
        wr_bank(5,ram); wr_bank(2,ram+16384); wr_bank(paged,ram+32768);
        const uint8_t* ex=d+27+49152+4;                          /* remaining banks, skip 5/2/paged */
        const uint8_t* end=d+len;                                /* never read past EOF: guards paged in {2,5} (147487) + short/malformed files */
        for(int b=0;b<8;b++){ if(b==5||b==2||b==paged) continue; if(ex+16384>end) break; wr_bank(b,ex); ex+=16384; }
        z.PC=pc; z.p7ffd=p7&0x3F;
    }
    inject_finish(&z);
}
static void load_snapshot(void){
    char path[180]; int p=0;                                 /* curpath(<=79) + '/' + NAMELEN(96) + NUL */
    for(int i=0;curpath[i] && p<160;i++) path[p++]=curpath[i];
    if(p && path[p-1]!='/') path[p++]='/';
    for(int i=0;flist[bcursor][i] && p<179;i++) path[p++]=flist[bcursor][i];
    path[p]=0;
    if(!sd_mounted) return;
    FIL f; UINT br=0;
    if(f_open(&f,path,FA_READ)!=FR_OK){ sd_unmount(); return; }      /* card gone -> drop, don't retry */
    if(f_read(&f,snapbuf,sizeof(snapbuf),&br)!=FR_OK){ f_close(&f); sd_unmount(); return; }
    f_close(&f);
    if(br<30) return;
    if(player_active()){                                       /* launching a program while music plays (opt_launchsnd): */
        if(opt_launchsnd==0) player_suspend();                 /*   MACHINE: suspend the music (keep the track+position), release the mux -> the machine is audible; resume from the menu/cursor */
        /* else MUSIC: keep the player -> the audio mux stays on music, the machine runs muted */
    }
    OSD_CTRL&=~3u; osd_on=0; browser_on=0; osd_view=0;              /* hand the screen to the game (hide BOTH OSD layers, incl. the DN browser on bit1) */
    { int i=0; for(; path[i] && i<179; i++) g_app_path[i]=path[i]; g_app_path[i]=0; }  /* banner: loaded app full path */
    g_app_stopped=0;                                            /* freshly loaded snapshot -> running */
    halt_src &= ~2u; apply_music_halt();                        /* fresh app load: run the machine (drop the music-HALT; MUSIC mode + PAUSE-MUS re-asserts it) */
    update_banner();
    if(cicmp(fext(flist[bcursor]),"sna")==0) load_sna(snapbuf,(int)br);
    else load_z80(snapbuf,(int)br);
    apply_halt();                                               /* inject_finish did IJ_CTRL=0; re-assert HALT if a manual pause is still held */
}

/* ---- music auto-play: playable test, play-by-index (cursor follows), auto-advance on EOF ---- */
static int is_music_ext(int idx){
    if(idx<0 || idx>=fcount || fisdir[idx]) return 0;
    const char* e = fext(flist[idx]);
    return cicmp(e,"psg")==0 || cicmp(e,"wav")==0 || cicmp(e,"mp3")==0;   /* music extensions (extend as more decoders land) */
}
static void play_index(int idx){                  /* play flist[idx], move the cursor onto it, remember the folder */
    if(idx<0 || idx>=fcount || fisdir[idx]) return;
    int oc=bcursor, ot=btop, op=playing_idx;       /* old cursor / scroll / previously-playing row, for a partial redraw */
    char path[180]; int p=0;                                 /* curpath(<=79) + '/' + NAMELEN(96) + NUL */
    for(int i=0;curpath[i] && p<160;i++) path[p++]=curpath[i];
    if(p && path[p-1]!='/') path[p++]='/';
    for(int i=0;flist[idx][i] && p<179;i++) path[p++]=flist[idx][i];
    path[p]=0;
    const char* pe = fext(flist[idx]);
    int ok = (cicmp(pe,"wav")==0) ? player_play_wav(path)
           : (cicmp(pe,"mp3")==0) ? player_play_mp3(path)
           :                        player_play_psg(path);   /* dispatch music decoder by extension */
    if(ok){
        playing_idx = idx;
        g_status_scroll=0; g_status_started=0; g_status_last=0;   /* restart the status-path marquee for the new track */
        /* DN: do NOT surface the Winamp window (it drew posbar/time OVER the DN browser). Keep the DN
           browser = the playlist; the playing track shows the > marker. Progress/time -> DN player status (v0.14.3). */
        int j=0; for(; curpath[j] && j<79; j++) play_dir[j]=curpath[j]; play_dir[j]=0;
        { int i=0; for(; path[i] && i<179; i++) g_music_path[i]=path[i]; g_music_path[i]=0; }  /* banner: track path */
        apply_music_halt();                                    /* music started: if PAUSE-MUS=YES + game loaded, assert HALT */
        if(!g_suppress_browser_draw){                          /* modal/progress owns the screen -> don't hijack the cursor */
            bcursor = idx; sel_scroll=0; last_scroll=0;        /* cursor follows the playing track */
            if(bcursor < btop) btop=bcursor;
            if(bcursor >= btop+BROWS) btop=bcursor-BROWS+1;
            if(btop<0) btop=0;
        }
    }
    update_banner();             /* music started/changed -> refresh the banner */
    if(browser_on && !g_suppress_browser_draw){ if(btop==ot){ dn_draw_file_row(op); dn_draw_file_row(oc); dn_draw_file_row(bcursor); dn_draw_status(); } else dn_draw_list(); }  /* clear the old marker + draw the new; no flicker */
}
static uint32_t g_rand = 0x2A3C1D5Bu;             /* LCG state for RANDOM play; stirred with the timer at each pick */
static void player_autoadvance(void){             /* on EOF: pick the next track per opt_playmode */
    if(playing_idx < 0) return;
    if(sd_mounted && cicmp(curpath, play_dir)==0){          /* still in the playback folder */
        int n = -1;
        switch(opt_playmode){
            case 1: break;                                  /* FILE: one track to its end -> stop */
            case 3: n = playing_idx; break;                 /* FILE LOOP: replay the same track */
            case 4: {                                       /* RANDOM: any music file in the folder */
                int cnt=0; for(int i=0;i<fcount;i++) if(is_music_ext(i)) cnt++;
                if(cnt>0){
                    XTime now; XTime_GetTime(&now); g_rand ^= (uint32_t)now;
                    g_rand = g_rand*1664525u + 1013904223u;
                    int pick = (int)((g_rand>>16) % (unsigned)cnt), seen=0;
                    for(int i=0;i<fcount;i++) if(is_music_ext(i)){ if(seen==pick){ n=i; break; } seen++; }
                    if(n==playing_idx && cnt>1){            /* same track again: take the next one instead */
                        n=-1;
                        for(int i=playing_idx+1;i<fcount;i++) if(is_music_ext(i)){ n=i; break; }
                        if(n<0) for(int i=0;i<playing_idx;i++) if(is_music_ext(i)){ n=i; break; }
                    }
                }
                break; }
            default:                                        /* 0 FOLDER / 2 FOLDER LOOP: next in sorted order */
                for(int i=playing_idx+1;i<fcount;i++) if(is_music_ext(i)){ n=i; break; }
                if(n<0 && opt_playmode==2)                  /* FOLDER LOOP: wrap to the first */
                    for(int i=0;i<fcount;i++) if(is_music_ext(i)){ n=i; break; }
                break;
        }
        if(n>=0){ play_index(n); return; }
    }
    playing_idx=-1; g_music_path[0]=0; apply_music_halt(); update_banner();   /* stop (end of folder / FILE mode / browsed away) */
    if(browser_on && !g_suppress_browser_draw){ dn_draw_list(); dn_draw_status(); }   /* clear markers/status (incremental) */
}
/* Auto-advance safely from a pump path (menu/dialog/progress): start the next track without touching
   the file list or the browser cursor (the modal owns the screen). Music stays continuous during ops. */
static void pump_autoadvance(void){
    if(player_take_ended()){
        g_suppress_browser_draw = 1;
        player_autoadvance();
        g_suppress_browser_draw = 0;
    }
}

/* ===================== Step 14.2: tape station (.tap real-time pulse replay) =====================
   Machine-agnostic PULSE loader: parse the .tap, generate the standard ROM pilot/sync/data pulse
   train (in T-states), push {level,dur} into the fabric tape FIFO with backpressure; the fabric
   replays the edges into the core's ear at exact T-state timing (authentic load, any ROM/turbo/
   custom loader). Progress feeds the player window. See STEP_14_TAPE_DESIGN. */
static uint8_t  g_tapbuf[256*1024];        /* whole .tap in DDR .bss (covers virtually all games) */
static uint32_t g_tap_len = 0;
static int      g_tape_on = 0, g_ear_lvl = 0;
static uint32_t g_blk_ptr = 0, g_blk_len = 0, g_blk_data = 0;
static int      g_phase = 0, g_bit_idx = 7, g_half = 0;
static uint32_t g_pilot_left = 0, g_byte_idx = 0, g_tape_done = 0;
static uint64_t g_tape_total_T = 1, g_tape_elapsed_T = 0;   /* whole-tape duration + played, in T-states (smooth exact progress/time) */
static char     g_tape_name[NAMELEN+1] = "";
static int      g_tape_drain = 0;          /* 1 = no more pulses to push; wait for the FIFO to fully replay, THEN release */
static uint32_t g_tape_last_pct = 999;     /* throttle the status redraw to % changes (no tearing) */
static XTime    g_tape_t0 = 0;             /* load start time -> live "time remaining" estimate */
static uint32_t g_tape_last_sec = 0xFFFFFFFFu;  /* throttle the LCD time redraw to per-second */
static uint32_t g_music_last_pct = 0xFFFFFFFFu, g_music_last_sec = 0xFFFFFFFFu;  /* music progress/time throttle */
/* ---- Step 14.2b: format-agnostic SEGMENT model (TAP standard blocks + TZX turbo/pulse/pause blocks) ---- */
#define TAPE_FMT_TAP 0
#define TAPE_FMT_TZX 1
#define TAPE_FMT_WAV 2          /* Step 14.3: .wav digitised cassette -> edge-detect -> PULSE FIFO */
#define TAPE_FMT_MP3 3          /* Step 14.3: .mp3 digitised cassette (minimp3 -> edge-detect -> PULSE) */
static int      g_tape_fmt = TAPE_FMT_TAP;
static uint32_t g_seg_pilot_len=2168, g_seg_sync1=667, g_seg_sync2=735, g_seg_zero=855, g_seg_one=1710, g_seg_pause_T=1750000;
static int      g_seg_has_sync=1, g_seg_used_bits=8;   /* used_bits = valid bits in the LAST data byte */
static uint32_t g_tzx_loop_ptr=0, g_tzx_loop_cnt=0;
/* WAV-tape (Step 14.3): stream a digitised cassette, threshold to an ear level, emit one PULSE per
   edge -> reuses the whole TAP/TZX PULSE FIFO + progress display. g_tapbuf doubles as the SD ring. */
static FIL      g_wtf; static int g_wt_open=0;
static uint32_t g_wt_sr=44100; static int g_wt_ch=1, g_wt_bps=2;
static uint32_t g_wt_total=0, g_wt_read=0;                 /* data-chunk bytes: total + consumed */
static UINT     g_wt_valid=0, g_wt_pos=0; static int g_wt_eof=0;
static int      g_wt_level=0; static uint32_t g_wt_run=0;  /* edge detector: current level + samples since last edge */
#define WT_HYS 2048                                        /* Schmitt hysteresis (s16 scale): ignore noise near zero */
static uint32_t tp_u16(uint32_t o){ return (o+1u<g_tap_len)?(g_tapbuf[o]|((uint32_t)g_tapbuf[o+1]<<8)):0u; }
static uint32_t tp_u24(uint32_t o){ return (o+2u<g_tap_len)?(g_tapbuf[o]|((uint32_t)g_tapbuf[o+1]<<8)|((uint32_t)g_tapbuf[o+2]<<16)):0u; }
static uint32_t tp_u32(uint32_t o){ return (o+3u<g_tap_len)?(g_tapbuf[o]|((uint32_t)g_tapbuf[o+1]<<8)|((uint32_t)g_tapbuf[o+2]<<16)|((uint32_t)g_tapbuf[o+3]<<24)):0u; }
static void tape_close_src(void){ if(g_wt_open){ f_close(&g_wtf); g_wt_open=0; } if(mp3_is_open()) mp3_close(); }  /* close the streaming tape source (WAV file / MP3 decoder) */
/* ---- Step 14.3c: ISR-fed pulse ring (ultrastable tape delivery) ----
   The hardware FIFO holds only 512 pulses (~21 ms at the densest turbo bits) - one bad main-loop
   pass (MP3 decode burst + ring compaction + OSD redraw) could underrun it mid-load. Producers now
   push pulses into this big software ring; the 1 ms audio ISR tops the hardware FIFO up from it, so
   tape delivery survives ANY main-loop stall (same architecture as the music path). */
/* ---- JTAG-readable self-test instrumentation (read/poke live via xsdb mrd/mwr) ----
   g_dbg[0]=ISR ticks (proves the 1ms timer fires)  [1]=ring STARVATIONS (FIFO had room but pulse
   ring was empty = underrun)  [2]=min pulse-ring free (0 => producer overran)  [3]=pulses produced
   [4]=pulses delivered to fabric  [5]=tape_on  [6]=tape_fmt  [7]=source EOF  [8]=played_T>>10
   [9]=total_T>>10  [10]=decode/refill calls  [11]=guard-maxed passes.
   g_autotrig: poke non-zero via JTAG to auto-start the hard-coded test load (no keypress needed). */
volatile uint32_t g_dbg[16] __attribute__((used)) = {0,0,0xFFFFFFFFu,0,0,0,0,0,0,0,0,0,0,0,0,0};
volatile int      g_autotrig __attribute__((used)) = 0;
volatile char     g_autodir[96]  __attribute__((used)) = "0:/loadtest/TurboLoadmp3";  /* JTAG-pokeable self-test target dir */
volatile char     g_autoname[64] __attribute__((used)) = "aliens.mp3";                /* ...and filename (any .wav/.mp3/.tap) */
#define PR_LEN  32768u                 /* power of 2; ~3-11 s of turbo pulses */
#define PR_MASK (PR_LEN-1u)
static volatile uint32_t pr_buf[PR_LEN];
static volatile uint32_t pr_w = 0, pr_r = 0;      /* monotonic producer/consumer indices */
static volatile int g_tape_feed = 0;              /* gate: the ISR may push ring -> TAPE_FIFO */
static volatile int g_tape_primed = 0;            /* ISR waits for a ring cushion before the first feed (no startup starvation) */
static volatile uint64_t g_tape_played_T = 0;     /* T-states DELIVERED to the fabric: drives the progress
                                                     bar/time (the producer runs seconds ahead of replay,
                                                     so counting at production made the bar jerk) */
static uint32_t pr_free(void){ return PR_LEN - (pr_w - pr_r); }
static uint64_t tape_played_T(void){ Xil_ExceptionDisable(); uint64_t v = g_tape_played_T; Xil_ExceptionEnable(); return v; }
/* DN status row (22) during a tape load: name + M:SS/M:SS + progress bar - same layout as the music
   status, tape-green. Replaces the retired Winamp widgets; updates are throttled by the caller. */
static void dn_draw_tape_status(void){
    uint64_t pt = tape_played_T();
    unsigned pct = (unsigned)((pt*100u)/g_tape_total_T); if(pct>100u) pct=100u;
    unsigned el  = (unsigned)(pt/TAPE_HZ), tot = (unsigned)(g_tape_total_T/TAPE_HZ);
    if(el>5999u) el=5999u; if(tot>5999u) tot=5999u;
    dn_fill(1,22,DN_COLS-2,1,DNK_PANEL_BG);
    dn_put_glyph(2,22, GLYPH_PLAY, DNK_TAPE, DNK_PANEL_BG);
    dn_putsn(4,22, g_tape_name, 39, DNK_TAPE, DNK_PANEL_BG);      /* name col 4..42, col 43 gap -> 'T' at 44 (same slot as music's play-mode glyph) */
    dn_putc(44,22, 'T', DNK_TAPE, DNK_PANEL_BG);                 /* T = audio recognised as a CASSETTE (tape "mode" marker) */
    { char t1[8],t2[8],tb[18]; fmt_mmss(el,t1); fmt_mmss(tot,t2);
      int p=0; for(int i=0;t1[i];i++)tb[p++]=t1[i]; tb[p++]='/'; for(int i=0;t2[i];i++)tb[p++]=t2[i]; tb[p]=0;
      dn_puts(47,22,tb,DNK_HEADER,DNK_PANEL_BG); }
    dn_bar(59,22,DNB_SCR-1-59,pct*10u,DNK_TAPE,DNK_PANEL_BG);
}
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
