Alex-Electron/ZX_BulbuLator/(commit log)

2026-06-15 Document the project idea and target the 7010 board
    Expand the README from a stub into a real overview and add docs/:
    - CONCEPT.md: cores, input, sound, storage (incl. physical FDD), video,
    networking, and the features borrowed from MiST/MiSTer/TSConf
    - HARDWARE.md: EBAZ4205 board, 7010 as the primary target from 2026-06-15,
    the HDMI/audio shield, and the Pi Pico XVC flashing setup
    - STATUS.md: current snapshot of what works and what is next
2026-06-15 Add board photo to README; ignore macOS junk files
2026-06-15 research: add Step 1 board bring-up LED blink (sources + bitstream)
2026-06-15 docs: frame the repo as a board-learning lab notebook; note xvc-pico is one JTAG option
2026-06-15 research: add Step 0 setup & wiring guide (power, boot strap, JTAG, software, flashing) + portable flash script
2026-06-15 research/00-setup: accurate boot-mode (R2577 strap, truth table) and J8/J7 pinout with reference images
2026-06-15 research: add Step 2 buttons drive the LEDs (sources + bitstream), pin-keyed button table
2026-06-15 research/02: simplify the button-mapping note (go by pin; board now wired to match)
2026-06-15 research: add Step 3 HDMI colour bars (sources + bitstream + ps7_post_config lesson); enrich Step 0 with R2577 photo, expansion-board pinout/photo, DATA map, article link
2026-06-15 research: add Step 4 HDMI with button-switched patterns (sources + bitstream); make build scripts reference the actual source filenames
2026-06-15 docs: note the EBAZ4205 also exists with a custom-soldered XC7Z020 (more logic, pricier)
2026-06-16 research: add Step 6 - a ZX Spectrum 128 on the EBAZ4205
    A full ZX Spectrum 128 on the Atlas zx core: 720p50 HDMI video + audio
    (AY/TurboSound + beeper + tape sound), the four shield buttons drive the boot
    menu, tape loading through pin J19, and it boots from SD. Ships the board-top
    sources, a prebuilt bitstream, and BOOT.BIN for SD boot; the core builds from
    our fork Alex-Electron/zx (one T80 fix for Vivado's strict VHDL). Display
    verified against ZEsarUX.
    [bulbulator_zx.xdc, bulbulator_zx_top.v, clock_zx.v, hdmi_wrap.sv]
2026-06-16 docs: switch public contact to lavrinovich.alex@gmail.com; link Step 6 from the main README; add a changelog and SD-boot clarification
2026-06-16 research/06: document the Murmulator Tape Load Reader front-end for the J19 tape input (schematic + credit)
2026-06-16 Step 7 — ARM control plane: AXI halt + RAM-write (foundation for SD loading)
    Wake up the idle Cortex-A9: a clean, versioned AXI3 slave on M_AXI_GP0 (axi_ctl) + a 100<->56.7 MHz clock-domain crossing (inject_cdc), integrated into the ZX bitstream. The ARM can halt the Z80 (HALT/HALT_ACK) and stream bytes into Spectrum RAM through a register window — proven live on HDMI (the ARM paints the screen while the CPU is frozen). HALT gates the core's clock-enables at the top, so the Atlas core is untouched; the RAM write reuses the core's own bus while halted, costing zero BRAM (still 60/60). Includes the standalone bare-metal handshake test (built first), the integrated sources, prebuilt bitstre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
2026-06-16 docs(step7): move m2_poke.tcl out of flash/ — it's the runtime demo, not a config helper
2026-06-16 docs(step7): add proof photo — the ARM paints the 128 menu red while the Z80 is halted
2026-06-17 Step 8 — Tear-free video: a DDR double-buffered framebuffer
    The single on-chip framebuffer tore on border-effect demos (read/write pointers drift at 50.02 vs 50.000 Hz). Capture the 51 KB ZX source frame into PS DDR over AXI-HP0, triple-buffer it, and latch the scanout buffer only on the HDMI vblank — no tear seam, including across bank-5/bank-7 shadow-screen flips. On-chip BRAM stays 60/60. Boots from SD (flash/BOOT.BIN) or JTAG/PCAP. Verified on hardware with the ula128 timing test and the Mescaline border demo.
    [async_fifo.v, axi_ctl.v, bulbulator_ddr.xdc, bulbulator_zx_ddr_top.v, clock_zx.v, ddrfb_p1a_regs.v, ddrfb_p1a_top.v, ddrfb_p2a_regs.v]
2026-06-17 docs(step8): Mermaid pipeline + esh2 demo & photo; index Step 8 across READMEs
    Redraw the DDR pipeline as a Mermaid flowchart (repo convention, no more ASCII). Add the esh2 tear-free border demo in demos/ (esh2_128.tap to load from tape + a 128K .z80 snapshot) with its on-screen photo. Link Step 8 from the root README steps list, changelog and status; add the Step 07/08 rows that were missing from research/README; refresh docs/STATUS.md to the Step 6-8 state.
2026-06-17 fix(step8): injected snapshots show static screens + the full bottom border
    Two rendering fixes found bringing up the snapshot tests on hardware.
    1. Static loading screens were missing on injected .z80/.sna (e.g. the ula128 title). The on-chip screen shadow in mem_zx is addressed by inject_cdc with the raw RAM address, which aliased bank 5 and bank 7 to the same half - so streaming the (blank) bank 7 after bank 5 wiped the displayed screen in the shadow. A running demo hid it by repainting every frame. Fix: take the shadow bank bit from addr_lat[15] so bank 5 and 7 land in their own halves.
    2. The bottom ZX border was clipped a few lines: the 288-line capture started at vsync and ran out b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
    [fb_capture_rr.v, fb_display.v, inject_cdc.v]
2026-06-17 docs: Russian README for every step; EN/RU language switcher; main README consistency; drop docs/STATUS.md
    Every README now has a Russian counterpart (README.ru.md). English stays the default; each pair cross-links through a Languages line. The Russian is a full translation in the same dry lab-notebook voice, with code, Mermaid diagrams, paths and identifiers left verbatim. Main README: the intro now says the published build runs on the Atlas zx core (MiST/MiSTer kept as the fallback), matching the rest of the repo; the docs/STATUS.md pointer is gone and docs/STATUS.md removed — status now lives in the README Status section + changelog.
2026-06-18 docs: regenerate the Russian READMEs — natural, readable translation
    The first machine pass read like calque. Re-translated all 11 README.ru.md with a small EN->RU glossary (border->бордюр, shadow screen->теневой экран) and a soft-wrap join, so full sentences are translated rather than hard-wrapped fragments. Code blocks, Mermaid diagrams, paths and identifiers stay verbatim; the EN/RU language switcher is preserved.
2026-06-18 docs: Russian HARDWARE/CONCEPT + cross-step consistency pass
    - docs/HARDWARE.md and docs/CONCEPT.md now have Russian versions (DeepL) with the EN/RU language switcher; the Russian README links the Russian docs.
    - CONCEPT.md leads with the Atlas `zx` core (MiST/MiSTer as fallback), matching the main README.
    - Step 6: the framebuffer note points forward to Step 8 — the single buffer does tear on border demos (~50.02 vs 50.000 Hz), which Step 8's DDR triple buffer fixes; DDR_FRAMEBUFFER_PLAN.md is marked as realized in Step 8.
    - Step 8 RU wording: zadeystvovali ARM rather than razbudili ARM.
    - Main README: a short credit line after the contact details.
2026-06-18 docs: tighten the Step 6 framebuffer note (flow, grammar)
2026-06-18 Step 9: a real PS/2 keyboard + a normalised control-key map
    A PS/2 keyboard on two pins (G19/H20, Murmulator front-end), muxed with the four shield buttons — the Atlas core already shipped ps2.v + keyboard.v, the buttons just faked the key-taps. Control keys follow the de-facto Speccy layout: F11 = hard/cold reset (wipes RAM), Ctrl+Alt+Del = soft reset, Ctrl+Alt+Ins = NMI. A runtime reset must not reset the DDR video pipeline (an AXI-HP master reset mid-burst hangs the bus and freezes the picture), so the hotkey pulses only the core. Ships the integrated top + xdc, the standalone read-test, the bitstream, a ready SD BOOT.BIN (+ build_boot.sh), and EN + RU (DeepL) READMEs; the main README s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
    [bulbulator_ddr.xdc, bulbulator_zx_ddr_top.v, ps2_axi.v, ps2_test.xdc, ps2_test_top.v]
2026-06-18 Step 9: Alt = the Spectrum's Extended-mode key
    Alt folds the Spectrum's two-shift Extended-mode chord onto one key. A small fabric state-machine fires a synthetic Caps+Symbol Shift chord (arming the ROM's E mode), then holds Symbol Shift while Alt is down: hold-Alt+key types the red lower token, tap-Alt+key the green upper token. No edit to the Atlas core; the synthetic scan-codes ride the same keyboard mux, so the reset/NMI combos decode unchanged. Rebuilt the bitstream and the SD BOOT.BIN; README EN + RU (DeepL, humanised) updated, main README Step-9 entries note Alt. Verified on hardware.
    [bulbulator_zx_ddr_top.v]
2026-06-19 docs(ru): adopt 'битстрим' for bitstream across all Russian READMEs
    Replace the calque 'битовый поток' with the established term 'битстрим' (all inflected forms) in every Russian README. This is the project's standing RU-glossary rule, also enforced in the DeepL translation pipeline so future docs stay consistent.
2026-06-22 research: build every step from a clean clone (self-contained, no duplication)
    Each step now builds from a fresh checkout with one command, ./build.sh.
    - get_deps.sh (repo root) fetches the two FPGA cores and the rgb2dvi IP, each
    pinned to an exact commit, into git-ignored cores/ and deps/. .gitignore
    covers cores/, deps/, build/, and the fetched ROM.
    - Steps 6-9 keep only their delta in sources/; assemble.sh gathers each step's
    build tree from the shared cores plus the files it reuses from earlier steps
    into a flat sources/build/. build.tcl uses relative paths only (the old
    absolute build-host paths are gone).
    - Steps 3-4 fetch rgb2dvi via get_deps; their build.sh points Vivado a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
2026-06-22 research: make the flash/boot/standalone tracts reproduce from a clean archive
    The build path was already self-contained; this does the same for everything
    around it, so a plain ZIP of the repo + ./get_deps.sh reproduces every step.
    - All flash/run/boot/standalone scripts and .bif files are now relative: no
    /home/... paths, tools are overridable env vars (VIVADO_LAB/XSDB/HW_SERVER/
    BOOTGEN/XVCD) with standard-install defaults, xsdb loaders source their
    siblings via [info script], and .bif partitions use in-repo basenames.
    - PCAP .bit.bin is generated inline from the committed bitstream, not a missing
    absolute file.
    - vivado-library is fetched from our fork (Alex-Electron/vivado-libr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
    [ddrfb_p2a.xdc, main.c]
2026-06-22 fix(flash): default XVCD_PICO to the Step-0 clone path; name Step 9 build output bulbulator_zx_kbd.bit
    The flash run scripts defaulted XVCD_PICO to a bare 'xvcd-pico' (assumes PATH),
    but Step 0 builds the daemon at $HOME/xvc-pico/daemon/xvcd-pico (not on PATH) -
    so a clean-archive flash failed to bring up the XVC daemon. Match the existing
    01-05 convention. Verified on hardware: ZX-128+DDR configures via PCAP from a
    clean archive (PCFG_DONE=1). Also align Step 9's build output name with the
    bitstream it actually flashes (bulbulator_zx_kbd.bit).
2026-06-22 docs: new ZX BulbuLator splash image; add 128-timing test demos
    splash.jpg: the Spectrum-font title art (Zynq-7010 + EBAZ4205, the 128 boot menu).
    research/08-ddr-framebuffer/tests/: ir_contention128 + scroll2017 (.z80/.tap),
    128-timing test content alongside the existing ula128/AYtest set.
2026-06-22 research: step 10 - OSD overlay + PS/2->ARM keyboard gate
    The ARM now draws an on-screen display over the live picture and takes the
    keyboard while the menu is open (F1 help, F12/Esc close), without halting the
    Z80 - overlay, not halt. An always-tap scancode FIFO, the OSD compositor and a
    MACHINE_ID register are deliberately machine-agnostic, so the same control
    plane fits a future NES/C64 core; the fabric decodes no function key.
    Delta over Step 8/9: the gate top, axi_ctl (OSD + keyboard-FIFO + MACHINE_ID,
    VERSION 0xB01B0006), the new osd_compositor (256x64 1-bpp panel in the grey
    field, barely-dimmed), a re-centred fb_display, and the keyboard-gate CDC
    false-paths. Builds from a clean clo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
2026-06-22 docs: reflect step 10 in the top READMEs + OSD screenshot + social preview
    - README / README.ru: step 10 added to the arc, the step list and the changelog
    (the ARM's OSD over the live picture + the keyboard gate; machine-agnostic on
    purpose). The "on-screen menu comes next" line is now "landed in step 10".
    - research/10: the F1 help-page screenshot over a live game (RetroSouls' Ringo)
    as the hero image, EN + RU.
    - docs/social-preview.jpg: a 1280x640 card for the repo's Social preview setting
    (upload it in Settings > General > Social preview - it can't be set from git).
    - Register tables: the R/W column was rendered as an opaque "Ч/З" in the RU docs;
    switched to the standard R / W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
2026-06-26 research: step 11 - SD file browser + options menu + movable OSD
    The goal of this step: mount a real filesystem off the SD card and put its
    files on the screen.
    - F5 SD file browser - ChaN FatFs on Xilinx xsdps; navigate folders, sort (F3),
    scrollbar, long-name marquee, folder marks; read-only while browsing.
    - F9 data-driven options menu; changes apply live and SAVE writes bulbulator.ini
    to the card (the project's first SD write, FF_FS_READONLY=0).
    - OSD panel you can move and fade from the menu (new AXI regs 0x6C OSD_OP /
    0x70 OSD_POS, bg blend at 0x68; VERSION 0xB01B0008). Panel grown to 256x128.
    - Under the hood: per-line DDR display (fb_line_disp) replaces the whole-frame
    BRAM,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
    [axi_ctl.v, bulbulator_ddr.xdc, bulbulator_zx_ddr_top.v, fb_capture_rr.v, fb_line_disp.v, fb_wr_axi.v, osd_compositor.v]
2026-06-27 research: step 12 - snapshot loader (.z80 / .sna over the control plane)
    F5 Enter now injects the file you land on: the ARM cold-resets + wipes the
    machine (CONTROL bit2 -> the F11 wipe FSM, VERSION 0xB01B0009), streams the RAM
    image in over the AXI back door, injects the full Z80 register set, and resumes
    at the snapshot PC. Covers .z80 v1/v2/v3 and .sna 48K/128K.
    - reset-on-load clears leftover RAM/AY state (fixes the carried-over squeal)
    - SD hardening for the EBAZ's card-detect-less slot (one-strike, EJECT,
    render-first, trimmed xsdps timeouts, forced diskio re-init)
    - F12 splash + F1 help show v0.12 core 0xB01B0009 from one helper
    - docs/LOADER_SPEC.md (+ru): exhaustive .z80/.sna for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
    [axi_ctl.v, bulbulator_ddr.xdc, bulbulator_zx_ddr_top.v, inject_cdc.v, loader_main.c]
2026-06-27 research: step 12 - QA: root README integration (EN+RU) + exec-bits + LOADER_SPEC table fix
    - root README.md/.ru.md: add Step 12 to the narrative, the steps list, and the
    changelog; retire the now-stale "loader is next" lines; link docs/LOADER_SPEC.md.
    - chmod +x the 5 step-12 shell scripts (were committed 100644, so a clean clone's
    ./build.sh and its internal sources/assemble.sh call failed permission-denied).
    - LOADER_SPEC.md/.ru.md: escape the | inside the T80 DIR-vector table code spans
    (the unescaped pipes broke the GitHub table render); RU heading 7 -> 7.1; fix a
    RU column label ("AXI off" was mistranslated).
    - assemble.sh comment + minor RU cleanups.
2026-06-27 research: fix RU mistranslation — "flash" rendered as "Запись в ПЗУ"
    DeepL translated the verb "flash" (flash the bitstream over JTAG / write
    BOOT.BIN to the SD card) as "запись в ПЗУ" (write to ROM) in several Russian
    step READMEs. No ROM is written there, so it was wrong and misleading.
    - steps 01/02/03/05: "## Запись в ПЗУ" -> "## Прошивка"
    - step 12: "## Сборка, запись в ПЗУ, запуск" -> "## Сборка, прошивка, запуск"
    - step 07 inline: "запиши в ПЗУ" -> "прошей"
    Real "ПЗУ" (the 48K / Boot / Multiface / MGT / SamRam ROMs) is left untouched.
    A flash->прошивка rule was added to the l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
2026-06-27 docs: cross-link LOADER_SPEC EN↔RU + point RU pages to the RU spec
    LOADER_SPEC.ru.md had no incoming links and neither spec carried a language
    switcher (the README switcher fixup only fires on a "README.ru.md" line, which
    the spec doesn't contain).
    - LOADER_SPEC.md: add "Languages: English · Русский" switcher -> .ru.md
    - LOADER_SPEC.ru.md: add the symmetric switcher -> .md
    - Russian READMEs (root + step 12) now link to docs/LOADER_SPEC.ru.md so a RU
    reader lands on the RU spec; the English READMEs keep pointing to .md.
2026-06-27 step 13.1 WIP: full pause (Pause key + audio mute on HALT) + HDMI volume in F9 menu
    RTL: mute PCM while cpu_halt_sp (Pause freezes the AY/beeper clock-enables, so
    resume is bit-exact - no save/restore); HDMI volume = signed PCM * ctl_vol/256
    (new AXI reg 0x74) in the clk_audio domain; VERSION 0xB01B0009 -> 0xB01B000A.
    ARM: Pause key (E1 14 77 matcher + F10 fallback, modal PAUSE badge); VOLUME item
    in the F9 options menu (live + saved to bulbulator.ini). Not yet built/tested.
2026-07-01 research: step 13 - audit fixes (CDC syncs, playing_idx remap, .z80 bounds, docs, AYUMI license)
    Post-publish hardening of Step 13, rebuilt and verified on hardware (VERSION 0xB01B0013).
    RTL (top.v + a step-local osd_compositor.v):
    - 2-FF sync ctl_player_en into the clk_audio_r domain before it gates the audio
    FIFO read enable and the source mux (it was an unsynchronised control crossing
    into the FIFO read pointer).
    - 2-FF sync cpu_halt_sp into the pause-fade domain; 3-FF settle-latch on cap_geom.
    - settle-latch on osd_bg/osd_op (multi-bit buses, matching the position path).
    ARM (loader_main.c + player.c):
    - remap playing_idx by name after an F3 sort or re-scan; auto-advance/REPEAT use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
    [axi_ctl.v, bulbulator_zx_ddr_top.v, loader_main.c, osd_compositor.v, player.c]
2026-07-07 research: Step 14 - Support Home/End in text fields (Issue #15) (v0.14.53)
    [loader_main.c]
2026-07-08 research: Step 14 - Colour OSD and the ZX-BulboNavigator (v0.14.92, PL 0xB01B0017)
    A true-colour 80x25 DDR-backed OSD replaces the 1-bpp strip and hosts a full
    DOS Navigator-style operating environment on the idle ARM, over the running
    ZX Spectrum 128K core.
    - Colour OSD: ARGB8888 canvas read by osd_ddr_rd over AXI-HP1, per-pixel alpha
    compositor, CP866 8x16 font, incremental redraw.
    - File browser: Name/Ext/Size/Date, sort hotkeys, mask select, copy/move dialog
    (6 conflict modes), rename/move, mkdir, recursive delete; opaque dialogs.
    - Menu bar + options saved to bulbulator.ini; numeric params on arrows, choices
    on Space/Enter; dedicated MP3-sens editor dialog.
    - Tape station (machin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
    [bulbulator_zx_ddr_top.v, loader_main.c, osd_compositor.v, player.c, tape_player.v]
2026-07-08 research: Step 14 - clean-clone reproducibility (vendor the PS/2 watchdog patch)
    The Atlas core is fetched unpatched (Alex-Electron/zx@407b653 ships ps2.v without
    the watchdog), so a clean clone would build without the "no fuzzy keys" fix. Vendor
    the patched ps2.v into third_party/atlas-zx-ps2-watchdog/ and have the step's
    assemble.sh overlay it onto the fetched core before synthesis. Verified: unpatched
    upstream -> assemble.sh -> patched (md5 958e23d -> ec6f9d) -> bitstream 0xB01B0017.
    A fresh clone now reproduces the exact bitstream on the board. README build note +
    HANDOVER updated.
2026-07-08 docs: add a Ko-fi support button to the README header (EN + RU)
2026-07-08 docs: add a DonationAlerts button next to Ko-fi in the README header (EN + RU)
2026-07-09 Correct core attribution: theexperimentgroup/UnAmiga zx (48K/128K), not Sorgelig/Pentagon
    The bundled ZX core is the multi-board theexperimentgroup / UnAmigaReloaded 'zx' (Alex-Electron/zx <- AtlasFPGA/zx <- UnAmigaReloaded-fpga/zx), 48K/128K only - not a Sorgelig downstream and not Pentagon. Fix LICENSE, THIRD_PARTY.md and README (EN+RU): credit theexperimentgroup/UnAmiga for the core, Sorgelig only for the SAA1099 block, Jose Tejada for JT49, Daniel Wallner for T80. Mark Pentagon as planned (Step 15), to be imported from sorgelig's ula.sv (GPL-2.0).
2026-07-25 research(step15): checkpoint the untracked step-15 working tree
    The whole research/15-pentagon tree had never been committed — weeks of
    Pentagon/tape-loader work plus the new NES machine lived only on disk, with
    no rollback points. This imports the sources so every further step is a real,
    revertable diff.
    Included: HDL sources (Pentagon + NES core wrap/mem/video, shared fb/hdmi/axi),
    ARM control-plane (loader_main.c, nes_rom.c, player, mp3dec), build/flash
    scripts, JTAG diag tcl, docs/specs (roadmap, handovers, tape matrix, joymap
    design), and the currently deployed prebuilt bit/BOOT.BIN/elf for provenance.
    Excluded: research/15-pentagon/artifacts/ — regenerable frame dumps and
    per-bui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
    [axi_ctl.v, bulbulator_ddr.xdc, bulbulator_nes_top.v, bulbulator_zx_ddr_top.v, clock_zx.v, fb_capture_rr.v, fb_line_disp.v, hybrid_zx_core.sv]
2026-07-28 Step 15: Fix option menu submenus shifting and bump version to v0.15.148
    [loader_main.c]
2026-07-28 Step 15: Fix MiSTer 48K loading by removing lazy core-switch check, and add Paper H/V off sliders in 48K/128K submenus
    [loader_main.c]
2026-09-01 research: fix AXI address overlap between ULA_TUNE and QUIESCE
    [axi_ctl.v, bulbulator_ddr.xdc, bulbulator_nes_top.v, bulbulator_zx_ddr_top.v, loader_main.c, main.v, nes_mem_bram.v, nes_wrap.v]
2026-09-01 research(step15): reconstruct missing T80 CPU fixes for Z80 test suite
    [T80.vhd]
2026-09-18 Шаг 15: машины Спектрума доведены до приборной точности, оболочка и готовые ядра
    Одно ядро несёт три машины - Spectrum 48K, Spectrum 128K и Пентагон 1024, - и все
    три приведены к поведению настоящей машины по измерениям, а не по ощущениям.
    Точность машин:
    - родная геометрия кадра: 384 настоящих точки, бордюры 64/64, без размножения краёв
    и без чёрных полей, на 48K и на 128K по одной формуле;
    - положение преры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
2026-09-18 Наборы ПЗУ, раскладка карты памяти и происхождение каждого чужого файла
    Выложены наборы ПЗУ, на которых машина проверялась, и к ним - разбор происхождения.
    Ничего из этого не написано нами, лицензия проекта на них не распространяется, и в
    описи прямо сказано, кто автор, откуда файл взят и что мы в нём меняли. Где авторство
    достоверно установить не удалось, так и написано: додумывать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
2026-09-18 Витрина репозитория и шаг 15: описано то, что сделано, и обозначен шаг 16
    На главной странице шаг 15 до сих пор числился будущей работой, а его собственный
    README описывал замысел двухмесячной давности: состояние v0.14.92, ядро 0017 и
    "Пентагон как timing leg". Теперь и главная, и шаг описывают то, что есть.
    Опись достижений собрана машинно из шести источников - журнала сборок, хэндовера,
    описаний, про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
2026-09-18 Витрина: General Sound и остальное перенесены из планов в работающее
    Раздел "что она должна уметь" читался как список желаний и врал: General Sound
    стоял там же, где нерешённые задачи, и рядом висела ссылка на issue #83 "General
    Sound emulation" - при том что карта играет музыку с августа. Та же беда была у
    дисковода, DivMMC и NES.
    Раздел разделён на "работает на плате сегодня" и "в планах", и в первую половину
    попало тол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
2026-09-18 Из опубликованных файлов убрана телеметрия прогонов, называвшая конкретную модель ИИ
    В трёх исследовательских JSON рядом с содержательным результатом лежала служебная
    часть от прогона агентов: поля model, agentId и отметки времени. В них 114 раз
    называлась конкретная модель - это прямо нарушает правило проекта, по которому
    ИИ кредитуется только обобщённо. Файлы уже были опубликованы, поэ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
2026-09-18 Снимки навигатора с живой платы и правки витрины по итогам сверки
    Шесть снимков сняты чтением холста оболочки прямо из памяти по JTAG, а не
    фотографированием монитора: файловый менеджер, диалог копирования, меню настроек,
    настройки машины, лаборатория таймингов ULA и кассетная станция.
    Сверка витрины с тем, что реально сделано, нашла тридцать расхождений. Исправлено
    главное:
    - я утв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
2026-09-18 Из хэндовера убрана чужая фамилия: правило формулируется без имени
    Строка запрещала использовать чужую личность в git-артефактах и при этом сама
    называла её. Правило проекта исключений для цитат не делает.
2026-09-23 Главная страница: кадр демки с платы, БульбаНавигатор и отчёт о закрытых задачах
    Рядом с фото платы и меню 128 теперь стоят ещё два снимка. Финал демки Rage на
    машине Пентагон снят не с монитора, а прочитан из буфера кадра платы: восемь
    цветных секторов идут и по бумаге, и по бордюру, этим экраном проверяется шаг
    бордюра Пентагона в 2 пикселя. Второй снимок - файловый менеджер оболочки.
    В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
2026-09-23 Шаг 14 снова собирается из чистого клона; локальные файлы в .gitignore
    sources/assemble.sh шага 14 копирует в дерево сборки bulbulator_ddr.xdc,
    fb_capture_rr.v и ps2_tx.v, а в репозитории их не было: они лежали только в моей
    рабочей копии, и чистый клон на этом шаге падал.
    В .gitignore ушли файлы, которые не относятся к опубликованному проекту: исходник
    заставки, рабочие заметки по JTAG, служебный .cbmignore и черновик шага 16 (он
    ещ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
2026-09-23 Шаг 15: прошивка v0.15.444 - периферия при смене машины, NORMAL/FAST 8x, Load via (128K)
    Смена машины в меню теперь применяет NEMO-IDE, General Sound и мышь самой новой
    машины. Раньше они оставались от прежней: 48K, 128K и Пентагон живут на одном ядре,
    ПЛИС при смене не перезагружается, а у этих устройств свои регистры.
    Тот же разбор объяснил провалы Timing Tests 48K в тестах 35-37: у машины 48K был
    включён NEMO-IDE. Как и оригинальна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
2026-09-24 Шаг 15 собирается из чистого клона: права скриптов, fb_wr_axi.v, FSBL, mkboot_zx.sh
    Проверка «клон с GitHub -> get_deps.sh -> build.sh» нашла, что шаг 15 из чистого клона
    не собирается вовсе:
    - у всех скриптов в репозитории не было флага исполняемости, build.sh падал на
    «Permission denied» при вызове assemble.sh. Флаг выставлен всем .sh;
    - assemble.sh брал fb_wr_axi.v из шага 11, а шагу 15 нужна версия с выходом idle_o
    (QUIESCE перед перезагрузкой ядра).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
2026-09-24 Как попробовать и как собрать: инструкции, проверенные на чистом клоне
    На главной появился раздел «Try it» / «Как попробовать»: что нужно из железа, какие
    готовые файлы куда класть на карту, первый запуск и клавиши. Для самостоятельной
    сборки есть research/15-pentagon/BUILDING.md (и русская версия): зависимости, ядро ZX
    и NES, перевод ядра в .bit.bin, прошивка ARM, загрузочный образ, запись на карту
    кардридеро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
2026-09-24 Кадр Rage на главной без чёрных полос сверху и снизу
2026-09-24 tools: создание каталога и удаление файла на карте по JTAG (card_mkdir.tcl, card_rm.tcl)
2026-09-24 Шаг 15: смешение кадров на выводе - ядро B0198, прошивка v0.15.445
    Демки, которые каждый кадр переключают экран 5/7 (тень во второй части Eklhaft SP2,
    gigascreen), на ЭЛТ сливаются в ровную картинку, а на ЖК мерцают с 25 Гц. Пункт
    Display / Frame blend: OFF, AUTO (умолчание: смешивать, только пока машина переключает
    экран почти каждый кадр) или ON. На HDMI выводится среднее двух соседних кадров машины.
    Буферов кадра пять вме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
2026-09-24 Прошивка v0.15.446: «48 LOCK» на Пентагоне запирает страничность, как настоящая машина
    У Пентагона 1024 бит 5 порта #7FFD запирает страничность только в стандартном режиме
    128K (#EFF7 бит 2). После сброса машина в режиме 1024, где тот же бит - старший бит
    номера банка, поэтому одной записи #7FFD=#30 было мало: замок на Пентагоне не работал.
    Автостарт теперь кладёт в буфер принтера программу из 17 байт: сначал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
2026-09-25 Шаг 15: Пентагон сверен с живой машиной - ядро B0200, прошивка v0.15.448, тест PENTTEST
    Для Пентагона появился автоматический прибор, research/15-pentagon/tools/penttest/.
    PENTTEST - самопроверяющаяся лента в духе Timing Tests 48K на замерном коде Яна Бобровского
    (zxtests, GPL/LGPL): длина кадра, EI как префикс, длина INT, вектор IM2, порт #FF, объём ОЗУ
    по страничности и отсутствие контеншена в каждом банке. На B0200 проходит 9 из 9.
    Растровы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
